ZeroUI/Industrial-Quark/Ziro-master/BoM/Motor Modules/Quark/Assembly Steps/Step 4 - Cover Top Lid.JPG

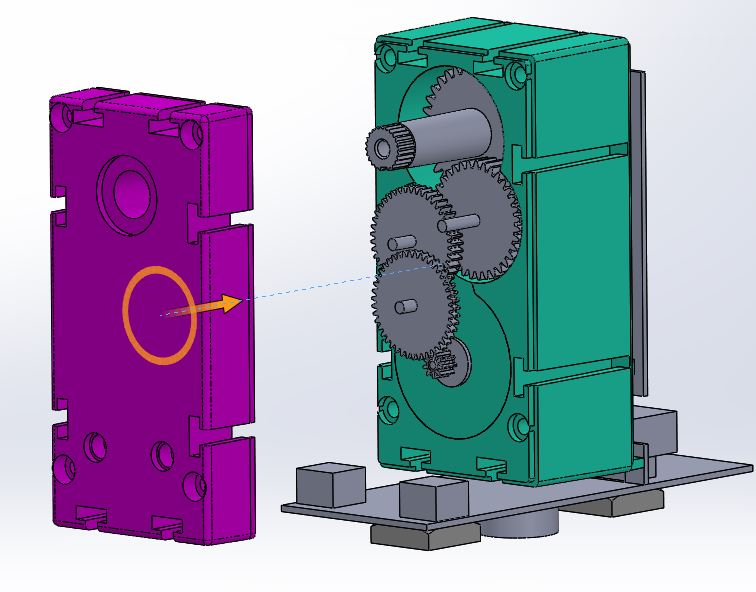
Ziro-master/BoM/Motor Modules/Quark/Assembly Steps/Step 4 - Cover Top Lid.JPG
