ZeroUI/Industrial-Quark/Ziro-master/Electronics/README.md

# Ziro
Contains Firmware and Design files for Ziro
