ZeroUI/Industrial-Quark/Ziro-master/Electronics/V1.0 Bluetooth/Hardware/PCB related req engg/Notes.txt

ADXL335 costs $3.2 analog +/-3G accelerometer
