ZeroUI/Industrial-Quark/Ziro-master/BoM/Glove Modules/Textile Design/3_Pattern Cutout(Size Small).pdf

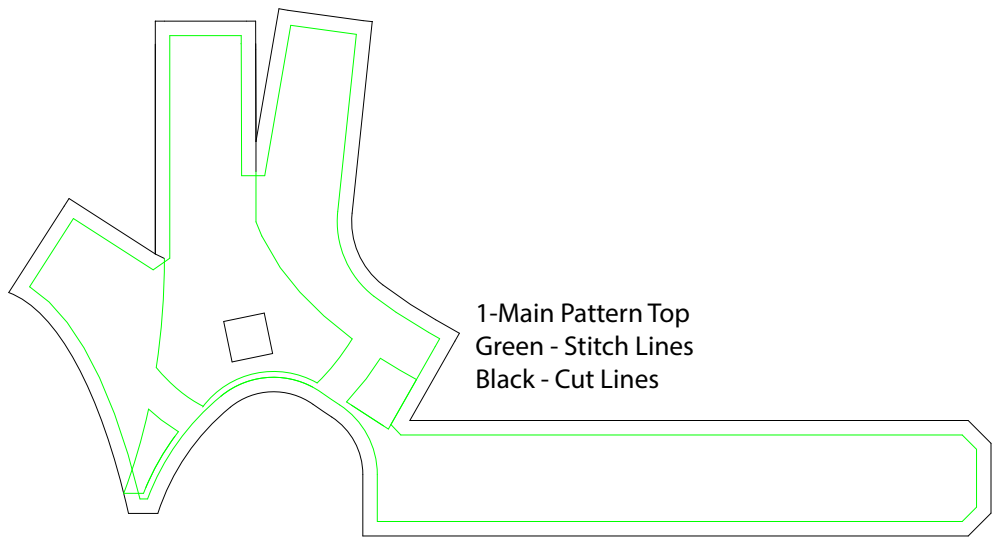
[picture p3: page 1]

1-Main Pattern Top
Green - Stitch Lines
Black - Cut Lines

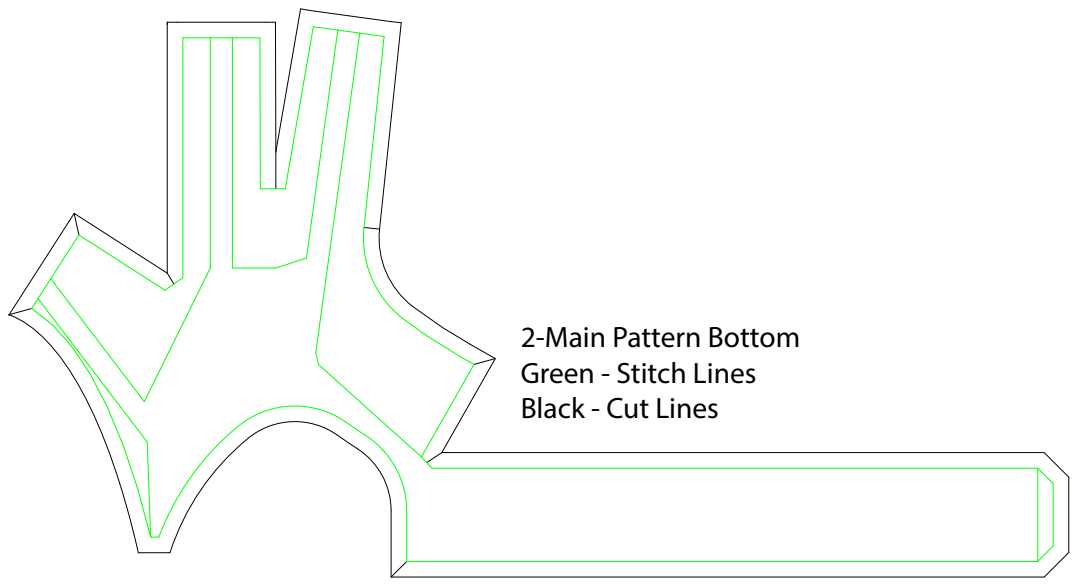
[picture p4: page 2]

2-Main Pattern Bottom
Green - Stitch Lines
Black - Cut Lines

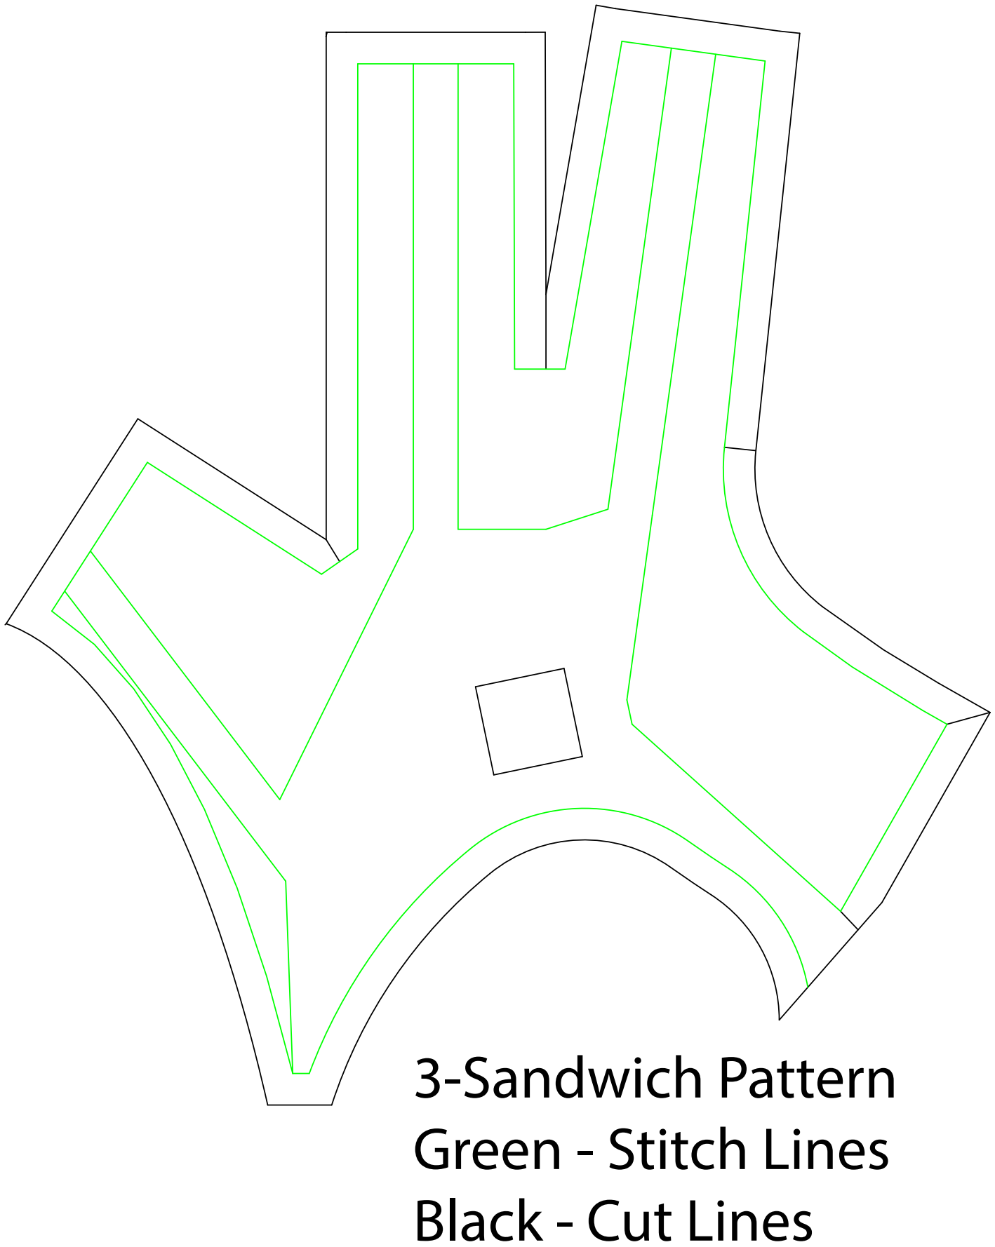
[picture p5: figure]
3-Sandwich Pattern Green - Stitch Lines Black - Cut Lines

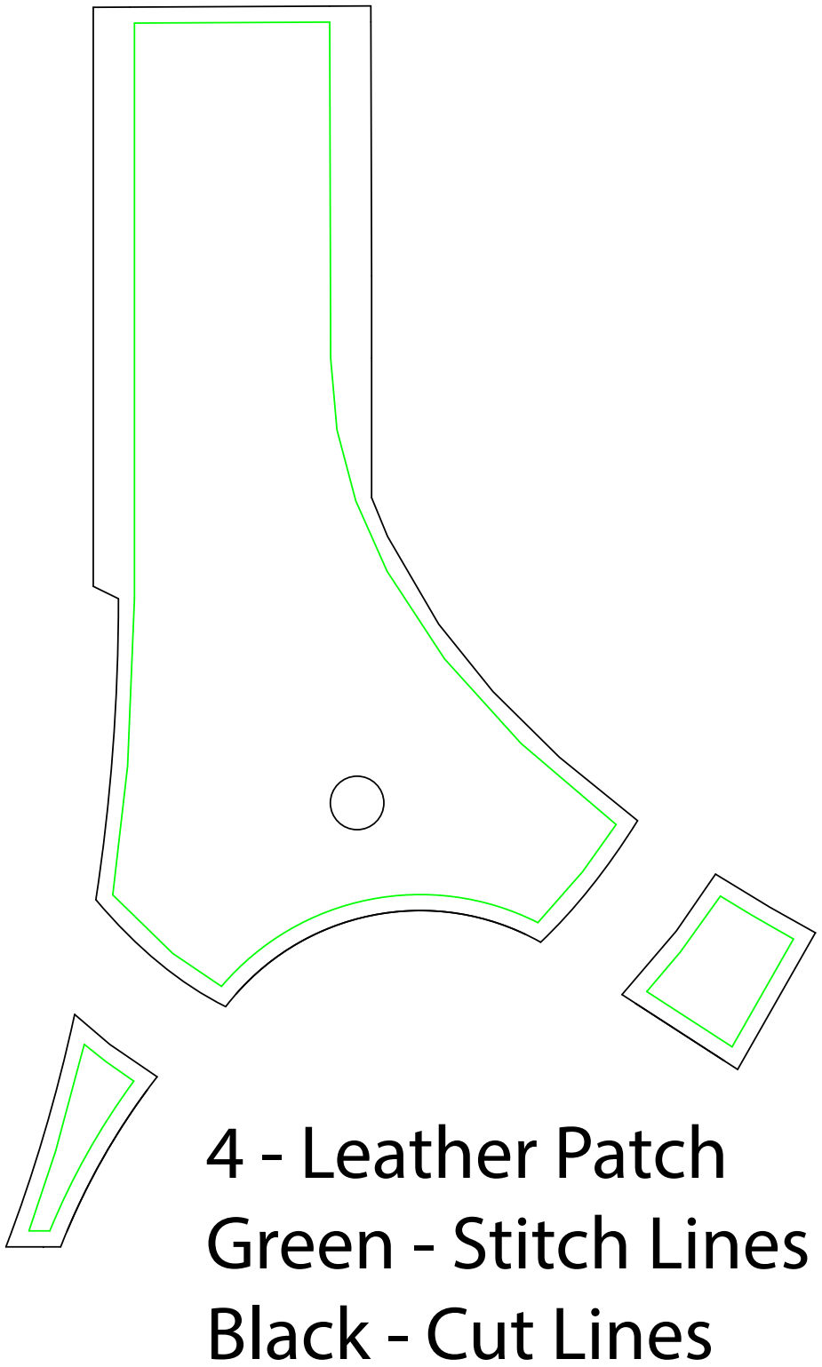
[picture p6: figure]
4 - Leather Patch Green - Stitch Lines Black - Cut Lines

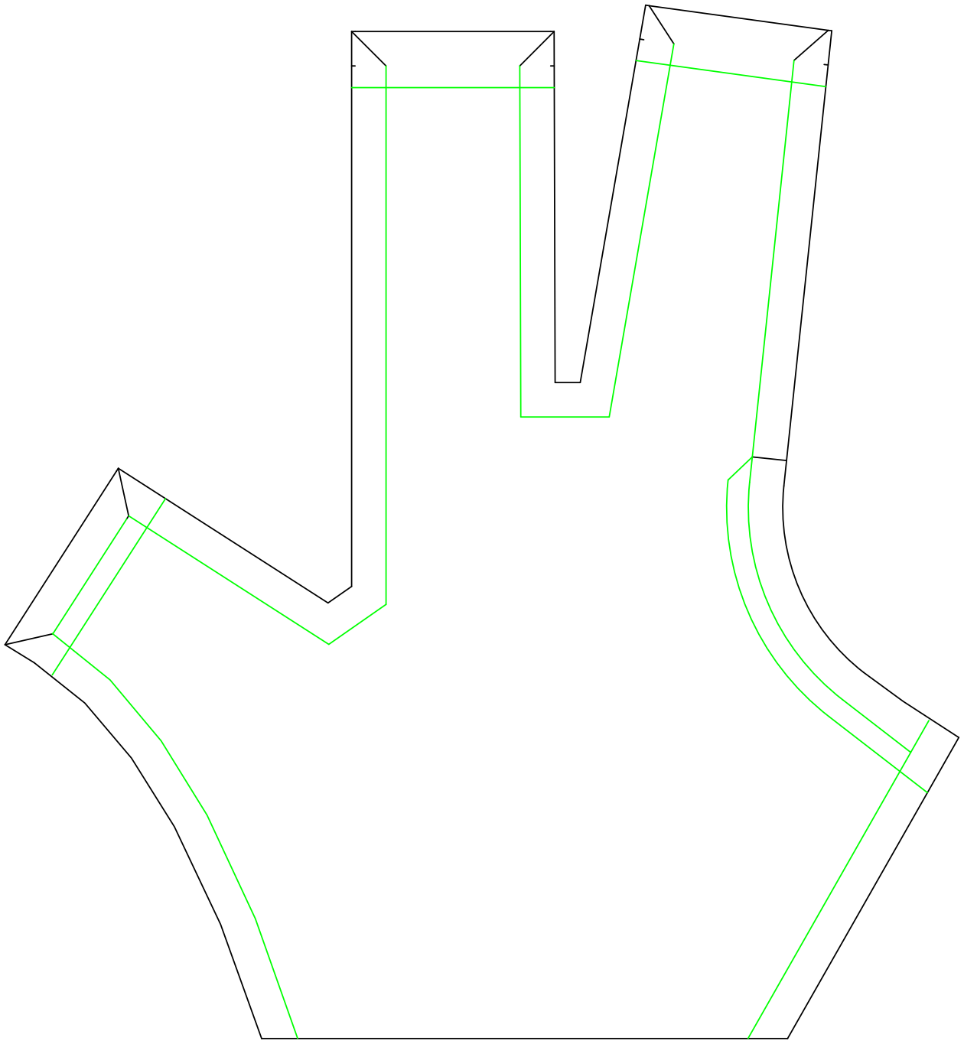
[picture p7: figure]

5- Palm Mesh
Green - Stitch Lines
Black - Cut Lines

6 - Wrist Patch
Green - Stitch Lines
Black - Cut Lines

7_Elastic band For Wrist
Black RIng is the Magnet
2” x 10 “ ELASTIC
