ZeroUI/Industrial-Quark/Ziro-master/Mechanical/Glove Design/Textiles/Small Size Pattern Cutouts.pdf

1-Main Pattern Top
Green - Stitch Lines
Black - Cut Lines


2-Main Pattern Bottom
Green - Stitch Lines
Black - Cut Lines

3-Sandwich Pattern Green - Stitch Lines Black - Cut Lines

4 - Leather Patch Green - Stitch Lines Black - Cut Lines


5- Palm Mesh
Green - Stitch Lines
Black - Cut Lines

6 - Wrist Patch
Green - Stitch Lines
Black - Cut Lines

7_Elastic band For Wrist
Black RIng is the Magnet
2” x 10 “ ELASTIC
