ZeroUI/Industrial-Quark/Ziro-master/Electronics/V1.0 Bluetooth/Hardware/Handimate_Backup/PCB Quote.pdf

PCB Quotation | Quote Number: 4128053

## Pricing and Leadtime:

Qty = Pieces, Not Arrays. Lot charge shown does not include $10 Handling Fee or NRE and ET charges.
Same Day | 1 Day | 2 Day | 3 Day | 4 Day | 5 Day | 10 Day | 15 Day | 20 Day | NRE ET*
Qty 5 Unit | $235.41 | $195.70 | $136.13 | $96.42 | $84.51 | $80.54 | $72.60 | $64.65 | $56.71
Qty 5 Lot | $1,177.05 | $978.50 | $680.65 | $482.10 | $422.55 | $402.70 | $363.00 | $323.25 | $283.55 | $169 | $140
Qty 10 Unit | $119.32 | $99.17 | $68.95 | $48.80 | $42.75 | $40.74 | $36.71 | $32.68 | $28.65
Qty 10 Lot | $1,193.20 | $991.70 | $689.50 | $488.00 | $427.50 | $407.40 | $367.10 | $326.80 | $286.50 | $169 | $140
Qty 50 Unit | $26.44 | $21.94 | $15.20 | $10.70 | $9.35 | $8.90 | $8.00 | $7.10 | $6.20
Qty 50 Lot | $1,322.00 | $1,097.00 | $760.00 | $535.00 | $467.50 | $445.00 | $400.00 | $355.00 | $310.00 | $169 | $140
Qty 150 Unit | $13.56 | $11.20 | $7.66 | $5.29 | $4.58 | $4.35 | $3.87 | $3.40 | $2.93
Qty 150 Lot | $2,034.00 | $1,680.00 | $1,149.00 | $793.50 | $687.00 | $652.50 | $580.50 | $510.00 | $439.50 | $169 | $140

* ET charges shown do not include Hi-Pot test charges unless included in the Comments section below.

## PCB Attributes:

## Comments:

Thank you for the opportunity to provide this quote. Please contact me with any questions.

Standard Advanced Circuits terms and conditions apply for all PCB quotes and orders. When required, we manufacture to MIL-PRF-55110 Revision G, Amendment 3. | 0
Date: | 5/27/2015

### Quoted To: Nikhil Jali Purdue University

Phone: | 765-476-3370 x
Email: | njali@purdue.edu

### Part Number: GloveMod1 Revision: 1 Quote Valid: 30 Days

### Fab Spec: IPC Class 2-A600

Material Type: FR4
Surface Finish: Leaded Solder Layer Count: 2
Board Size: | 2x2
Array Size: | 0x0
# Up Per Array: 0

Tab Route: | No
Score: | Yes

Finished Thickness: 0.062
Copper Wt.(Outer): 1
Soldermask: | 2
Soldermask Color: Green
Silkscreen: | 1
Silkscreen Color: | White
AS9100: | No
ITAR: | No
Trace/Space Min: | 0.012
Smallest Hole: | 0.02
Total # Holes: | 0
Blind Via: | None
Microvia: | None
VIP: | None
Controlled Impedance: No
