ZeroUI/Industrial-Quark/Ziro-master/Electronics/V2.0 Wifi/Hardware/Battery/Kokam_Cell_Requirement_Form_Rev.0.0.pdf

CONFIDENTIAL-KOKAM PROPRIETARY

Please fill in shaded area

## KOKAM CELL REQUIREMENT FORM

### General Customer Information

Date | Project Name
Company Name | Job Title
Contact Name | Cell Phone
Company Location
(Country / City) | E-mail
Final Customer (if any) | Telephone
Website

### Applications

### Select appropriate applications (multiple choices applicable)

Tram | EV, PHEV, HEV | Aviation | UPS | Marine | Defense
Industrial | ESS | Telecom | Medical
A. General Description of Usage
B. Cell Characteristics
- Rated Capacity | | | | Ah
- Energy Density | | | | Wh/kg
- Energy Density | | | | Wh/L
- Impedance | | | | mΩ
- Weight | | | | g
800mAh-1.2Ah Under 30g | Width | Less than 3mm 3.1 3.6 4.2 | 100mA 600mA 1000 | | 50 mm
| Length | | | | mm
| Thickness | | | | mm
| Lower | | | | V
- Voltage | | Nominal | | | | V
| | Upper | | | | V
- Cell Dimension
[Maximum]
- Current
Charge | Cont | A
Peak | A
Discharge | Cont | A
Peak | A
- Required # of Cycles | @ | % DOD

### SUPERIOR LITHIUM POLYMER BATTERY

KOKAM CELL | WWW.KOKAM.COM
16th April 2016 | Ziro ZeroUI | Chief Engineer- Electronics Nikhil Jali

San Jose,
United States

nikhil@zeroui.com

www.ziro.io

This would be used in a wearable application requiring daily recharging for a usable period of atleast 2 years i.e. 1000 charge cycles.

### KOKAM CELL REQUIREMENT FORM

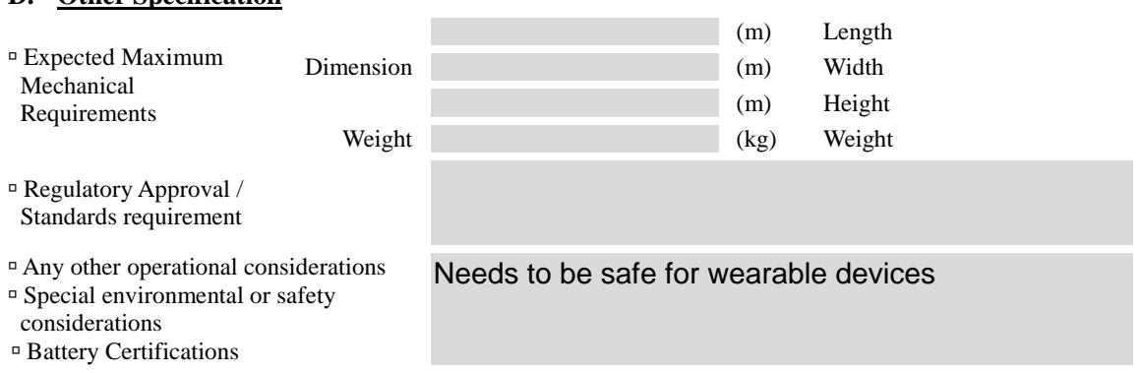
[picture p8: figure]
Expected Maximum Mechanical Requirements; Dimension; (m) Length (m) Width (m) Height; Weight; Regulatory Approval / Standards requirement; Any other operational considerations Special environmental or safety considerations Battery Certifications; Needs to be safe for wearable devices

Corporate Headquarters | Manufacturing Plant
30-78, Gyeongsu-daero, 1220beon-gil,
Jangan-gu, Suwon-si, Gyeonggi-Do
South Korea Zip. 440-851
Tel +82 31 3620 100
Email battery@kokam.com

483-42, Yachon-ri, Gayagok-Myun, Nonsan-Si, Chungnam
South Korea 320-840
Tel | +82 41 740 3800
Email | battery@kokam.com
CONFIDENTIAL-KOKAM PROPRIETARY
C. Environmental Characteristics
- Charging Temperature | | °C
- Discharging Temperature | 353527 | °C
- Storage Temperature | °C
D. Other Specification
E. Expected Amount of Orders Estimate Quantity
(EA)

Desired Delivery Date
(Sample Order) | (Y/M/D)
Estimated Annual Volume | Year 2016 | Year 2017 | Year 2018
| (EA) | (EA) | (EA)
60,000 | June, 2016 10,000 | 50,000 | Unknown
