ZeroUI/Industrial-Quark/Ziro-master/Mechanical/Ziro 2.0/Glove Design/Textiles/Brooks Pattern/3_Sandwich.pdf

3-Sandwich Pattern Green - Stitch Lines Black - Cut Lines
