ZeroUI/Industrial-Quark/Ziro-master/Mechanical/Ziro 2.0/Glove Design/Textiles/Brooks Pattern/4_Leather Patch.pdf

4 - Leather Patch Green - Stitch Lines Black - Cut Lines
