ZeroUI/Industrial-Quark/Ziro-master/Mechanical/Ziro 2.0/Glove Design/Textiles/Brooks Pattern/5_Mesh.pdf

5- Palm Mesh
Green - Stitch Lines
Black - Cut Lines
