ZeroUI/Industrial-Quark/Ziro-master/Mechanical/Ziro 2.0/Glove Design/Textiles/Brooks Pattern/6_Wrist Patches.pdf

6 - Wrist Patch
Green - Stitch Lines
Black - Cut Lines
