ZeroUI/Industrial-Quark/Ziro-master/Mechanical/Ziro 2.0/Glove Design/Textiles/Brooks Pattern/7_Wrist Elastic.pdf

7_Elastic band For Wrist
Black RIng is the Magnet
2” x 10 “ ELASTIC
