ZeroUI/Industrial-Quark/Ziro-master/Electronics/V2.0 Wifi/Documentation/Module Color Schemes.xlsm

 |  |  | LED PWM VALUES
Module # | Color Schemes | [R,G,B] | Red | Green | Blue
- |  | 255, 0, 0 | 1023 | 0 | 0 | This color is used for STOP Command
1 |  | 255, 255, 0 | 1023 | 1023 | 0
2 |  | 0, 176, 80 | 0 | 706.0705882 | 320.9411765 |  | NOTE: Final Color on Modules dependent on Plastic and PWM Frequency set in Quark
3 |  | 241, 39, 212 | 966.8352941 | 156.4588235 | 850.4941176
4 |  | 4, 97, 210 | 16.04705882 | 389.1411765 | 842.4705882
5 |  | 255, 192, 0 | 1023 | 770.2588235 | 0
6 |  | 0, 255, 0 | 0 | 1023 | 0
7 |  | 255, 255, 255 | 1023 | 1023 | 1023
8 |  | 0, 255, 255 | 0 | 1023 | 1023
Change above background colors and hit Recalculate Button
