ZeroUI/Industrial-Quark/Ziro-master/Electronics/V2.0 Wifi/Documentation/Websocket Packet Exchange Format.xlsx

Websocket Object Exchange Format between Glove and Computer
Name of variable | Description | Values | Description of Value | Low Limit | High Limit | Default | Data Type
pType | Indicates the type of packet being sent and lists out the data in it | 0 | Keep alive Packet | 0 | 13 | 0 | int
 |  | 1 | Gesture Map Packet Set
 |  | 2 | Gesture Map Packet Get
 |  | 3 | Sensor Calibration Request
 |  | 4 | Sensor Calibration Get
 |  | 5 | Sensor Calibration Set
 |  | 6 | Motor Command Get
 |  | 7 | Motor Command Set for (Scratch/Blockly)
 |  | 8 | KitID Get
 |  | 9 | KitID Set
 |  | 10 | Sensor Info
 |  | 11 | LED Set
 |  | 12 | Shutdown Modules* |  |  |  |  | *m_M and m_T must both be set to 0
 |  | 13 | Set Sensitivity of Gestures
gMap | Contains the [8 Module x 7 Gesture] Matrix | [8 x 7] Matrix | Motor Modes | 0 | 6 | 0 | int
 |  |  | -1 STOP
 |  |  | 0- Do Nothing
 |  |  | 1- CW Rotation
 |  |  | 2- CCW Rotation
 |  |  | 3- 90 CW Rotation
 |  |  | 4- 90 CCW Rotation
 |  |  | 5- 180 CW Rotation
 |  |  | 6- 180 CCW Rotation
CAL_L | Contains min for flex Sensor to read 0% | [1x7] Array | [Thumb, Index, Middle] | 0 | 999 | 90 | uint16_t
 | Contains min for IMU gestures to read 0% |  | [Front, Back, Left, Right] | 0 | 90 | 5
CAL_H | Contains max for flex Sensor to read 100% | [1x7] Array | [Thumb, Index, Middle] | 0 | 999 | 900 | uint16_t
 | Contains max for IMU gestures to read 100% |  | [Front, Back, Left, Right] | 0 | 90 | 70
m_M | Mode of Motor. [1x8 Motor Groups] | [1x8] Array | See Motor Modes above | 0 | 6 | 0 | int
m_T | Target Speed/Angle of Motor [1x8 Motor Groups] | [1x8] Array | See Motor Modes above | 0 | 6 | 0 | int
kID | Contains Kit ID | String | Contains a 4 character string | - | - | HEX String Assembly Time | String
allInf [all..Inf] | Contains all Gestures, Sensor Values from Glove | [1x9] Array | [0]- Thumb Finger Gesture Value | 0 | 99 | 0* | int
 |  |  | [1]- Index Finger Gesture Value | 0 | 99 | 0*
 |  |  | [2]- Middle Finger Gesture Value | 0 | 99 | 0*
 |  |  | [3]- Front Motion Gesture Value | 0 | 90 | 0*
 |  |  | [4]- Back Motion Gesture Value | 0 | 90 | 0*
 |  |  | [5]- Left Motion Gesture Value | 0 | 90 | 0*
 |  |  | [6]- Right Motion Gesture Value | 0 | 90 | 0*
 |  |  | [7]- Button Press Value | 0 | 1 | 0*
 |  |  | [8]- Battery SoC Value | 0 | 99 | 0*
 |  |  | [9]- Charge Status | 0 | 1 | 0*
 |  |  | [10]- LED Status. 0-OFF 1-GREEN 2-RED | 0 | 2 | 0*
sLED | Used to Set the LED Status Glove: If R>0, *Red*. If G>0, Green, else OFF. Module: Sets duty-cycle of RGB LED | [1x3] Array | [R, G, B] | 0 | 9 | 0 | int
snsty | Used to set the sensitivity of gestures | Int | 0- Not Sensitive 1- Very Sensitive | 0 | 10 | 0 | int
scratchMode | Used to Set/Disable Scratch Mode Analyzed when pType=7 | Int | 0-Scratch Inactive 1-Scratch Active | 0 | 1 | 0 | int
