ZeroUI/Industrial-Quark/Ziro-master/Electronics/V1.0 Bluetooth/Hardware/PCB related req engg/9V charger Interface.xlsx

Vcharge | Vref | R1(desired) | R2 (req) | R1(req) | R2(desired)
9 | 1.25 | 10 | 1.612903226 | 62 | 10
Page 10 of | https://www.sparkfun.com/datasheets/IC/MC34063A.pdf
 |  | Vcharge

 |  | R1
 | Vref-
 |  | R2

 |  | Gnd
