ZeroUI/Industrial-Quark/Ziro-master/Electronics/V1.0 Bluetooth/Hardware/PCB related req engg/Flex Sensor Resistor Divider.xlsx

R1 [kohm] | Vin [V] | Flex Sensor [kohm] | Vout [V]
150 | 3.3 | 9 | 0.1867924528
 |  | 8 | 0.1670886076
 |  | 10 | 0.20625
 |  | 12 | 0.2444444444
 |  | 14 | 0.2817073171
 |  | 16 | 0.3180722892
 |  | 18 | 0.3535714286
 |  | 20 | 0.3882352941
