ZeroUI/Industrial-Quark/Ziro-master/Electronics/V1.0 Bluetooth/Hardware/PCB related req engg/PCB requirements.xlsx

PCB Requirements
Thickness | 0.031-0.062
