ZeroUI/Industrial-Quark/Ziro-master/Electronics/V2.0 Wifi/Documentation/Hand Size Templates.docx

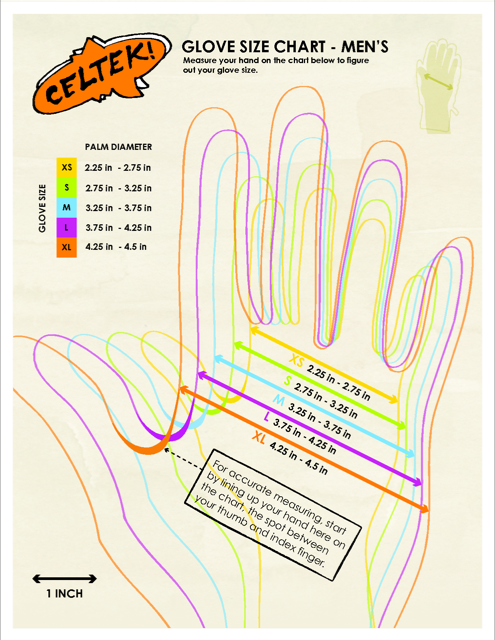
[picture p9: figure]
