ZeroUI/Industrial-Quark/Ziro-master/BoM/Glove Modules/Textile Design/1_Glove Overview.pdf

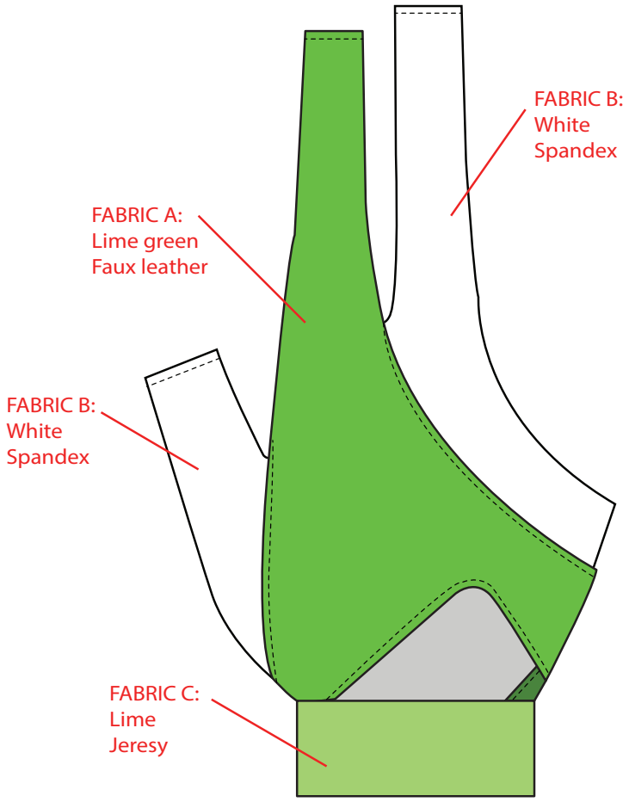
[picture p10: figure]
FABRIC A: Lime green Faux leather; FABRIC B: White Spandex; FABRIC C: Lime Jeresy
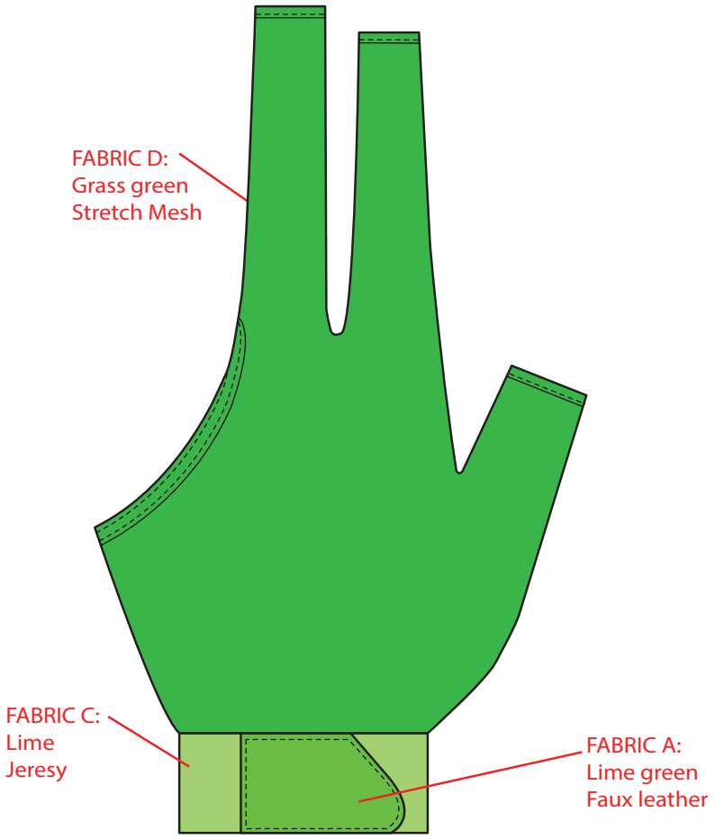
[picture p11: figure]
FABRIC A: Lime green Faux leather; FABRIC C: Lime Jeresy; FABRIC D: Grass green Stretch Mesh

# tech pack _ fabrics

top of hand | palm

# zeroUI
