ZeroUI/Industrial-Quark/Ziro-master/Electronics/V1.0 Bluetooth/Hardware/PCB related req engg/3dpcb.pdf

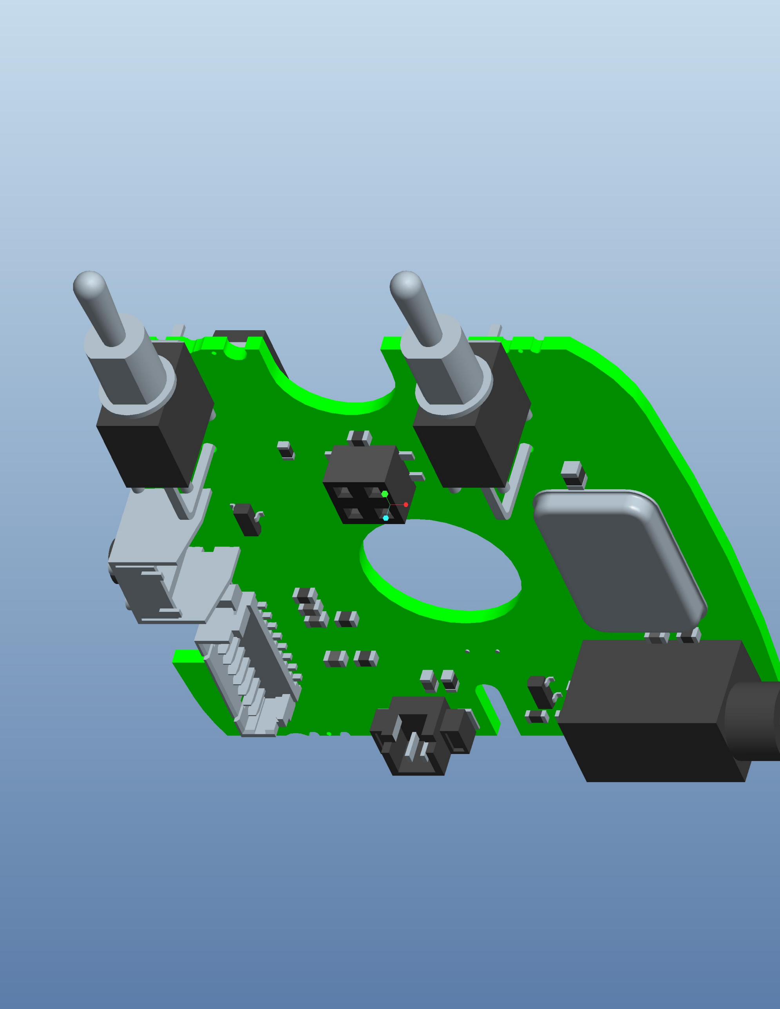
[picture p12: page 1]
