ZeroUI/Industrial-Quark/Ziro-master/Electronics/V1.0 Bluetooth/Hardware/Handimate_Backup/Glove Module/Rendered/3D view.pdf

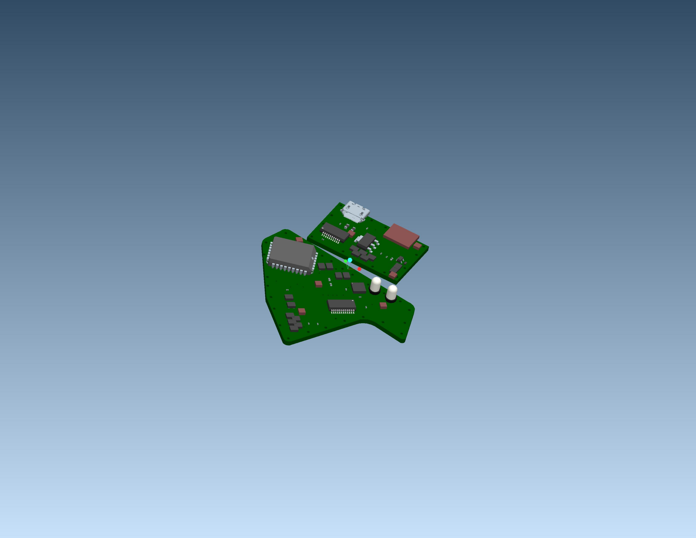
[picture p13: page 1]
