ZeroUI/Industrial-Quark/Ziro-master/BoM/Packaging/E1-PCB/Connector- Magnetic Circular-A.pdf

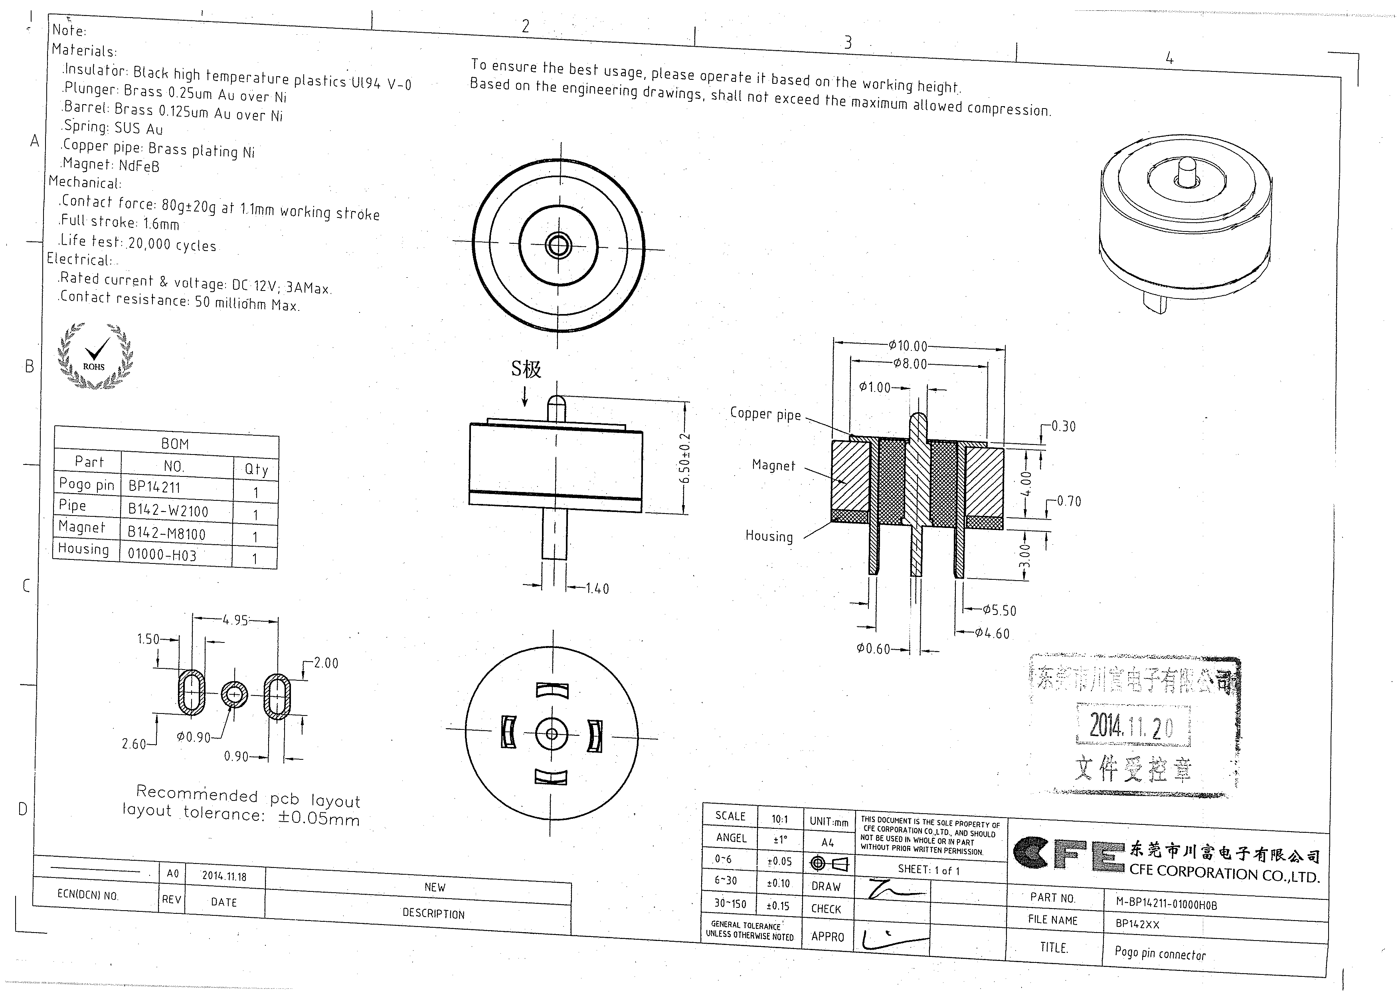
[picture p14: page 1]
