ZeroUI/Industrial-Quark/Ziro-master/BoM/Motor Modules/Quark/E2-PCB/Connector- Magnetic Circular-B.pdf

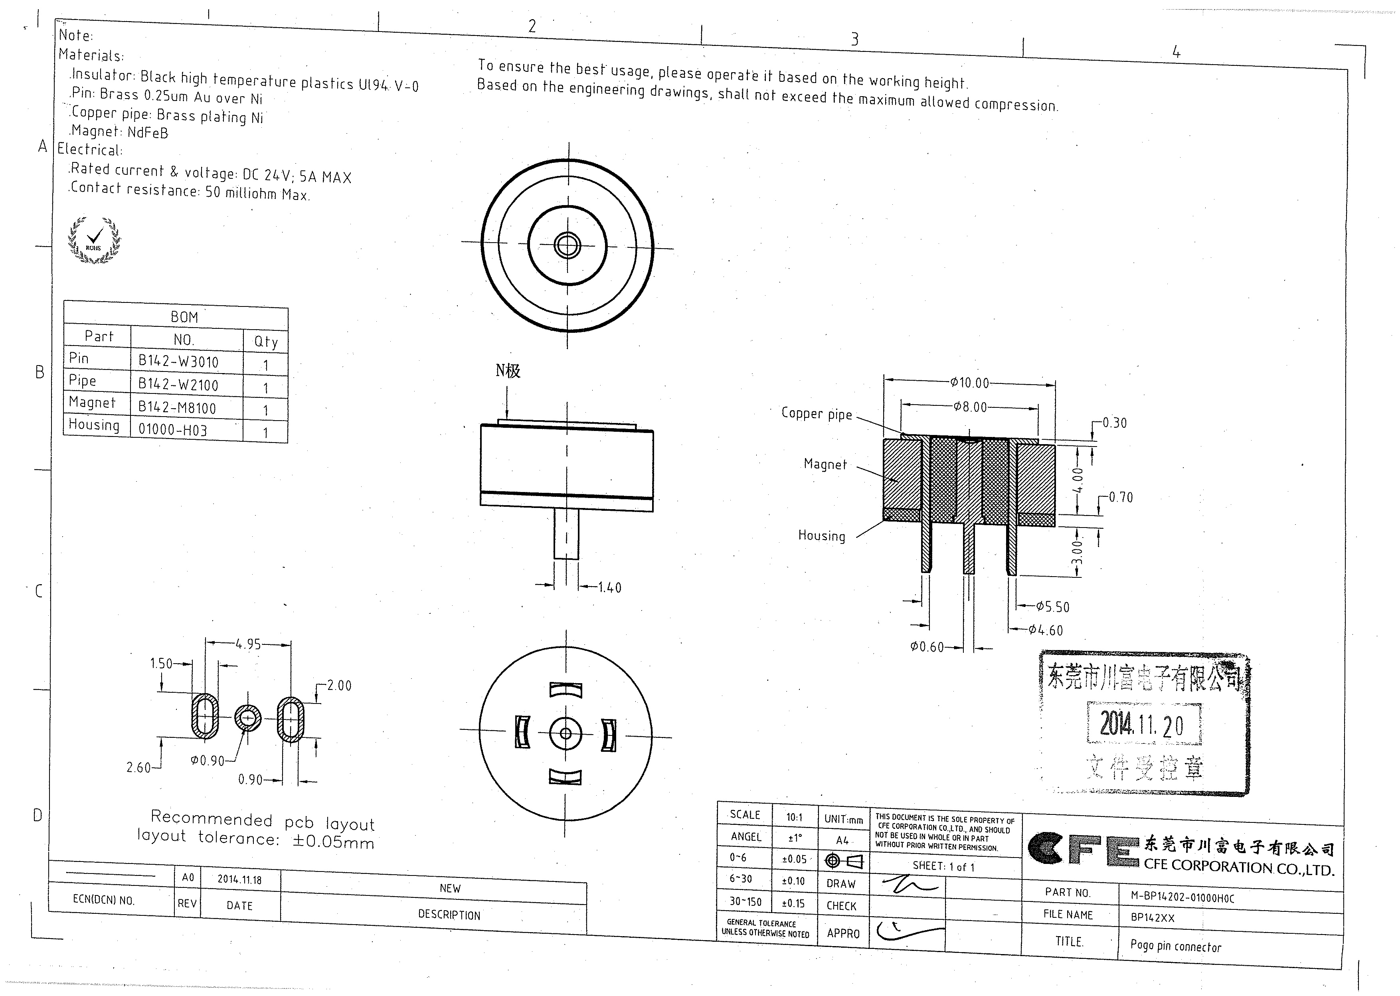
[picture p15: page 1]
