ZeroUI/Industrial-Quark/Ziro-master/Electronics/V2.0 Wifi/Documentation/Gesture Input Sensititivity Analysis.xlsx

Gesture Input | Function | Input a | Output Exponential Algorithm
0 | f(x)=ax^3 + (1-a)*x x=[0,1] | 0 | 0
0.1 |  |  | 0.001
0.2 |  |  | 0.008
0.3 |  |  | 0.027
0.4 |  |  | 0.064
0.5 |  |  | 0.125
0.6 |  |  | 0.216
0.7 |  |  | 0.343
0.8 |  |  | 0.512
0.9 |  |  | 0.729
1 |  |  | 1
