ZeroUI/Industrial-Quark/Ziro-master/BoM/Accessories/Smartphone_Mount.PNG

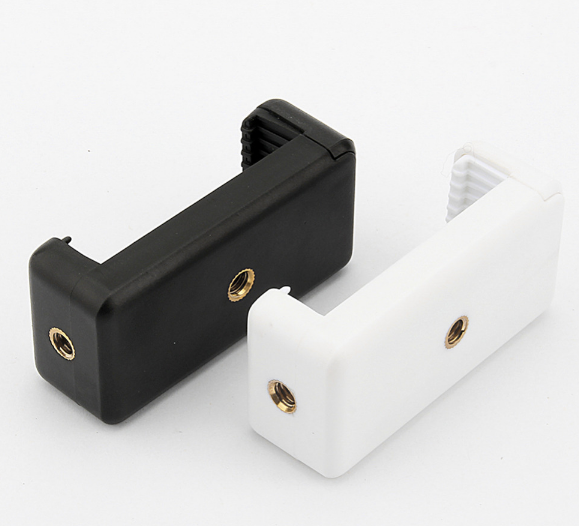
Ziro-master/BoM/Accessories/Smartphone_Mount.PNG
