ZeroUI/Industrial-Quark/Ziro-master/BoM/Accessories/SPM-ADAPT.png

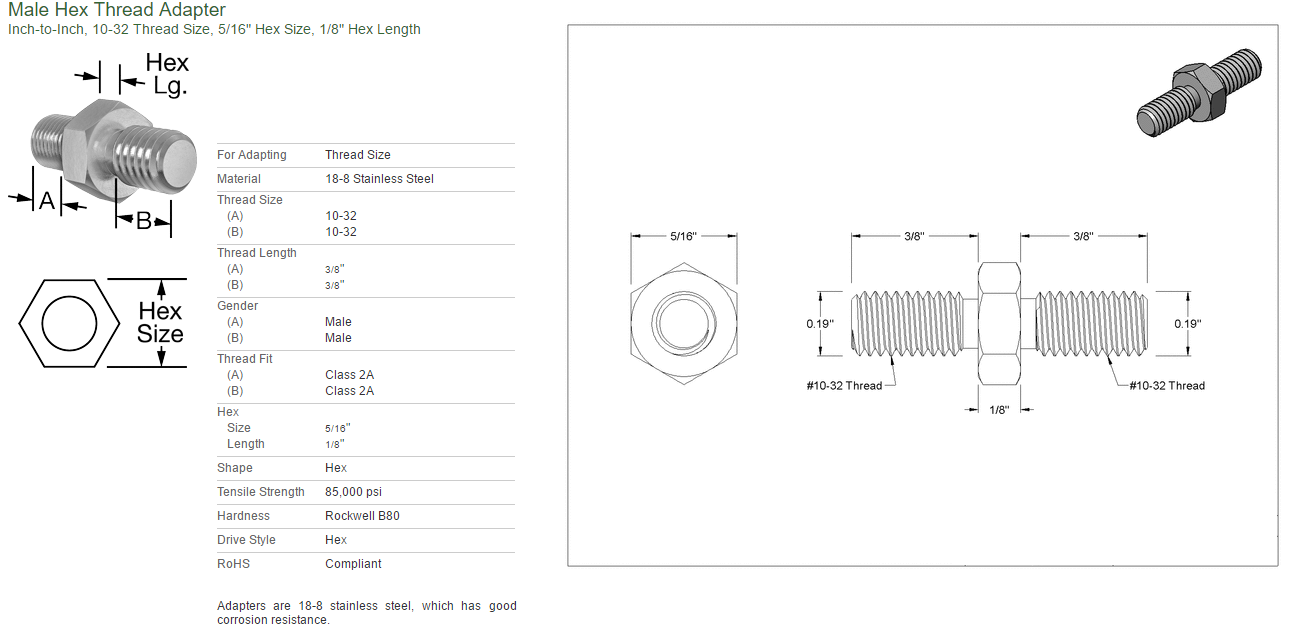
Ziro-master/BoM/Accessories/SPM-ADAPT.png
