ZeroUI/Industrial-Quark/Ziro-master/BoM/Accessories/Ziro_Keychain.png

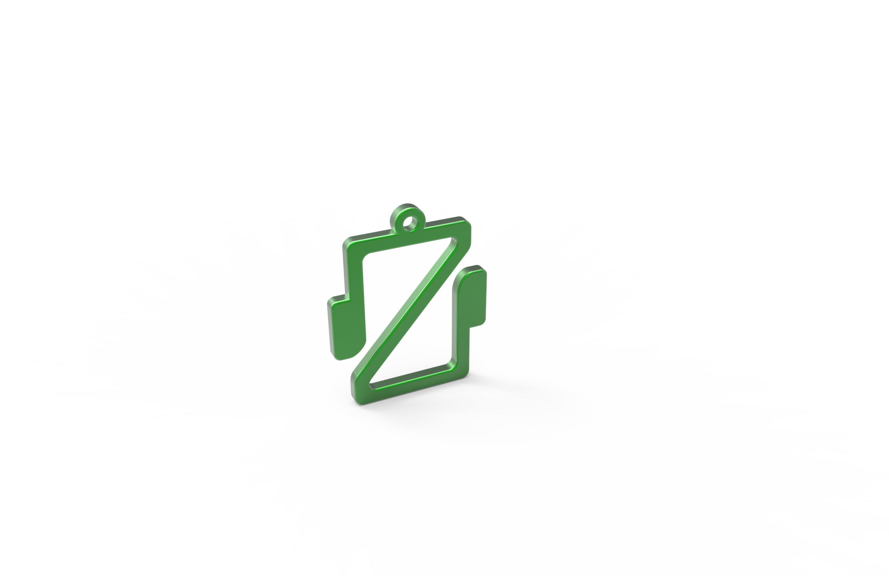
Ziro-master/BoM/Accessories/Ziro_Keychain.png
