ZeroUI/Industrial-Quark/Ziro-master/BoM/Connector Screw/Conector and Knurled Shaft.JPG

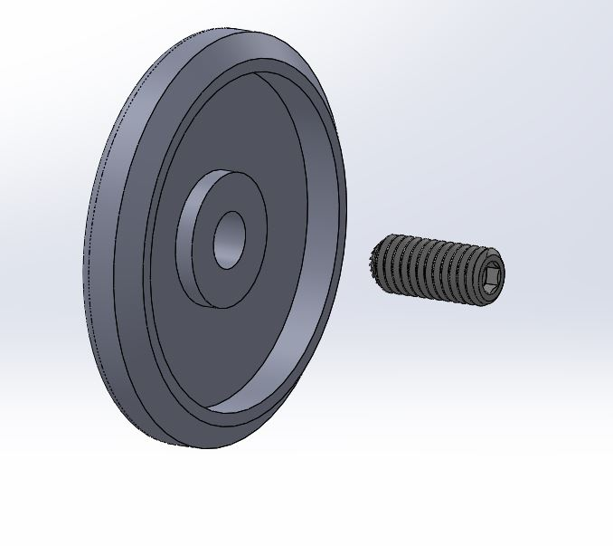
Ziro-master/BoM/Connector Screw/Conector and Knurled Shaft.JPG
