ZeroUI/Industrial-Quark/Ziro-master/BoM/Connector Screw/F1032.png

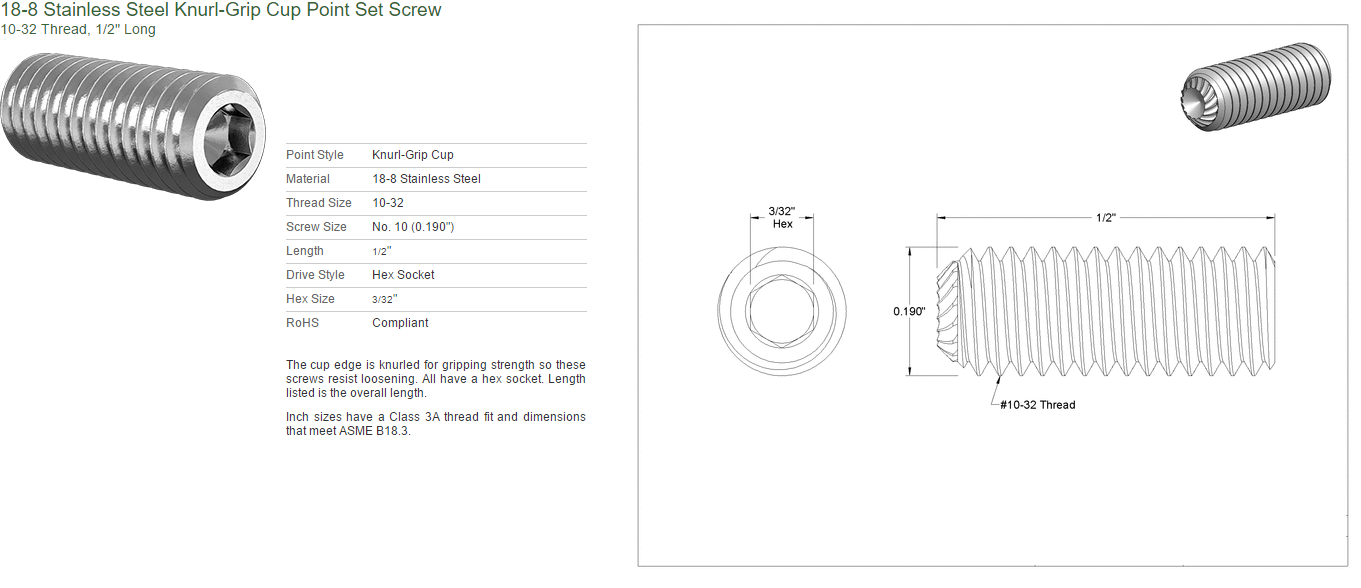
Ziro-master/BoM/Connector Screw/F1032.png
