ZeroUI/Industrial-Quark/Ziro-master/BoM/Motor Modules/Hinge/Hinge and Insert.JPG

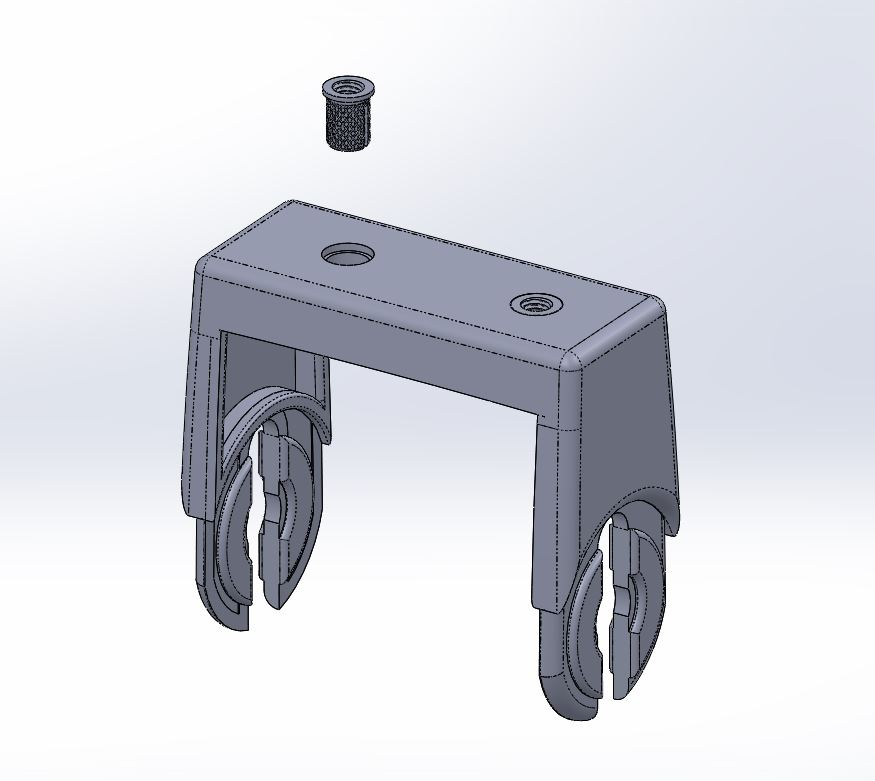
Ziro-master/BoM/Motor Modules/Hinge/Hinge and Insert.JPG
