ZeroUI/Industrial-Quark/Ziro-master/BoM/Motor Modules/Hinge/PR1032.PNG

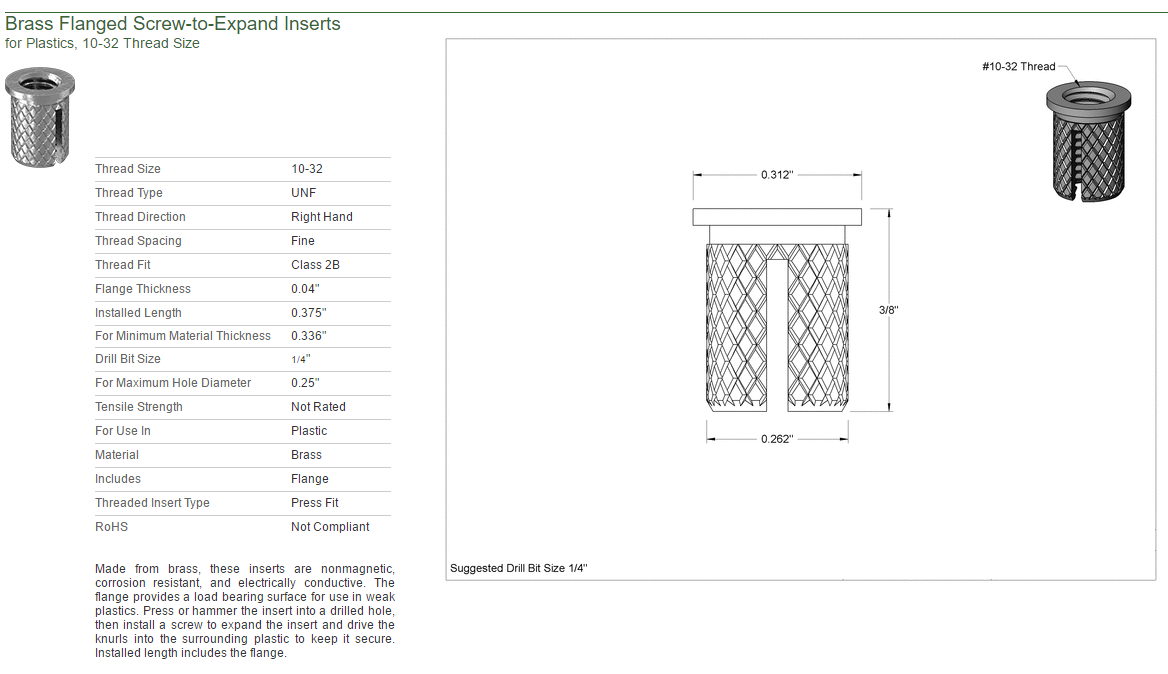
Ziro-master/BoM/Motor Modules/Hinge/PR1032.PNG
