ZeroUI/Industrial-Quark/Ziro-master/BoM/Motor Modules/Quark/SCR-18-8 Socket Head Cap Screw.png

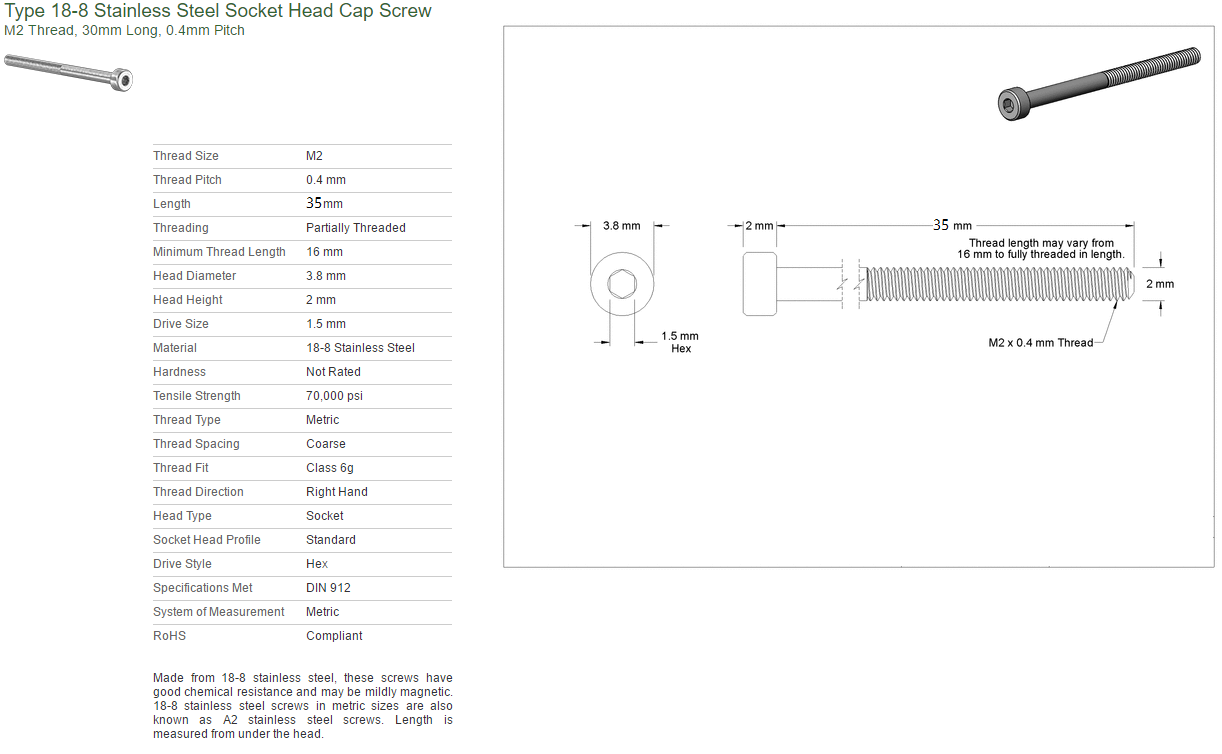
Ziro-master/BoM/Motor Modules/Quark/SCR-18-8 Socket Head Cap Screw.png
