ZeroUI/Industrial-Quark/Ziro-master/BoM/Motor Modules/Rotating Pin Screw/F1032.PNG

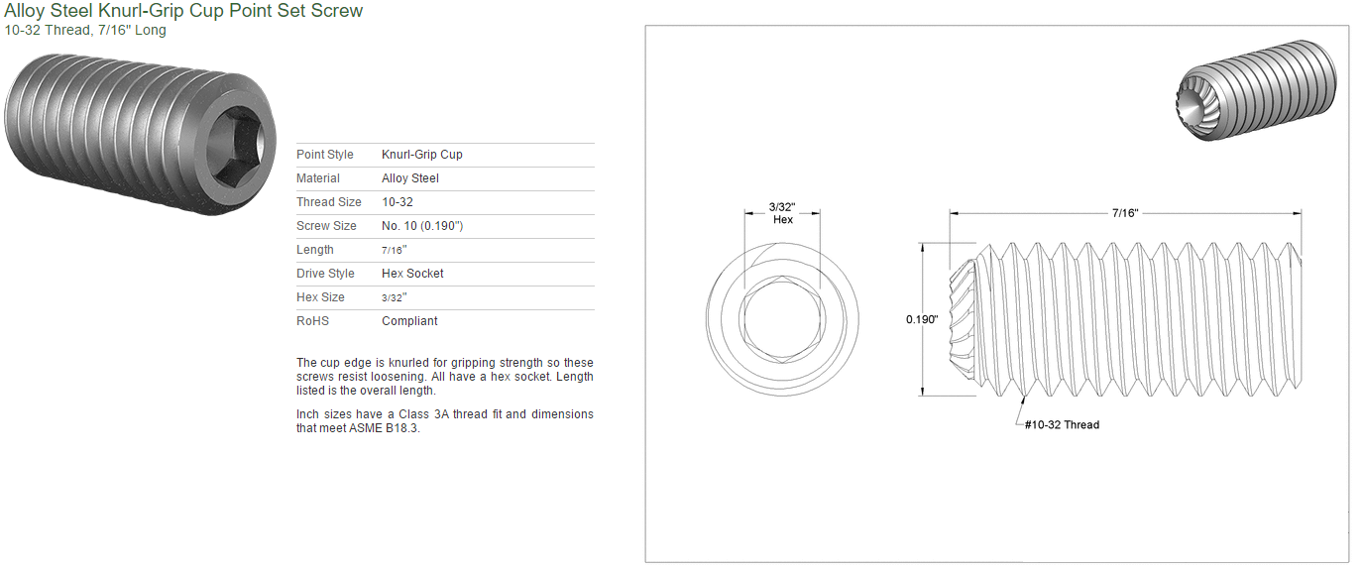
Ziro-master/BoM/Motor Modules/Rotating Pin Screw/F1032.PNG
