ZeroUI/Industrial-Quark/Ziro-master/BoM/Motor Modules/Shell/Brass Square Nut 10-32.png

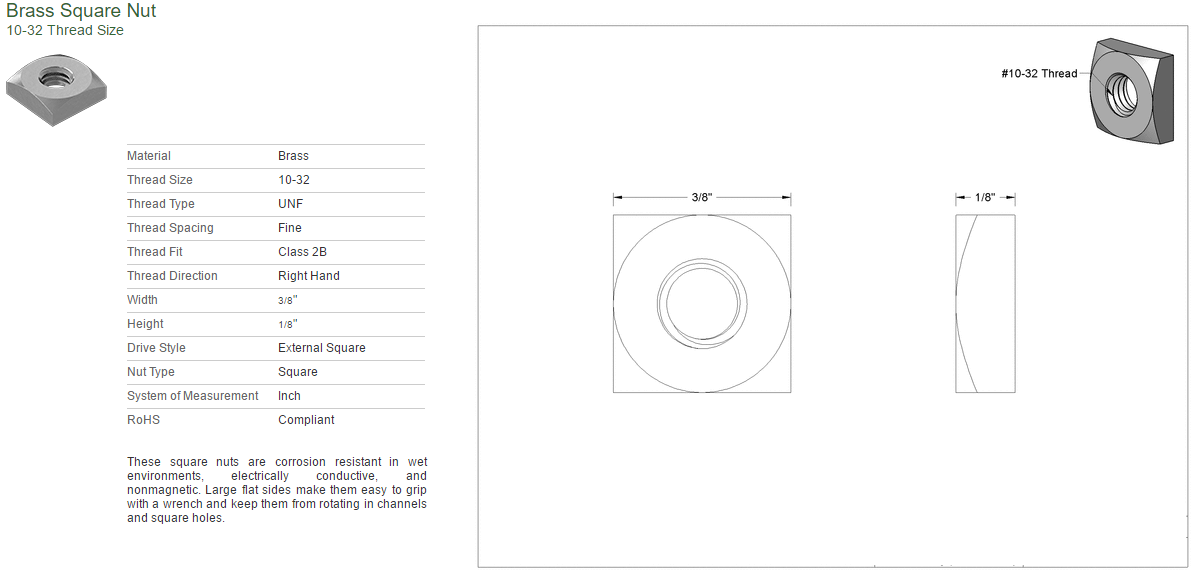
Ziro-master/BoM/Motor Modules/Shell/Brass Square Nut 10-32.png
