ZeroUI/Industrial-Quark/Ziro-master/BoM/Motor Modules/Shell/KNSHFT.png

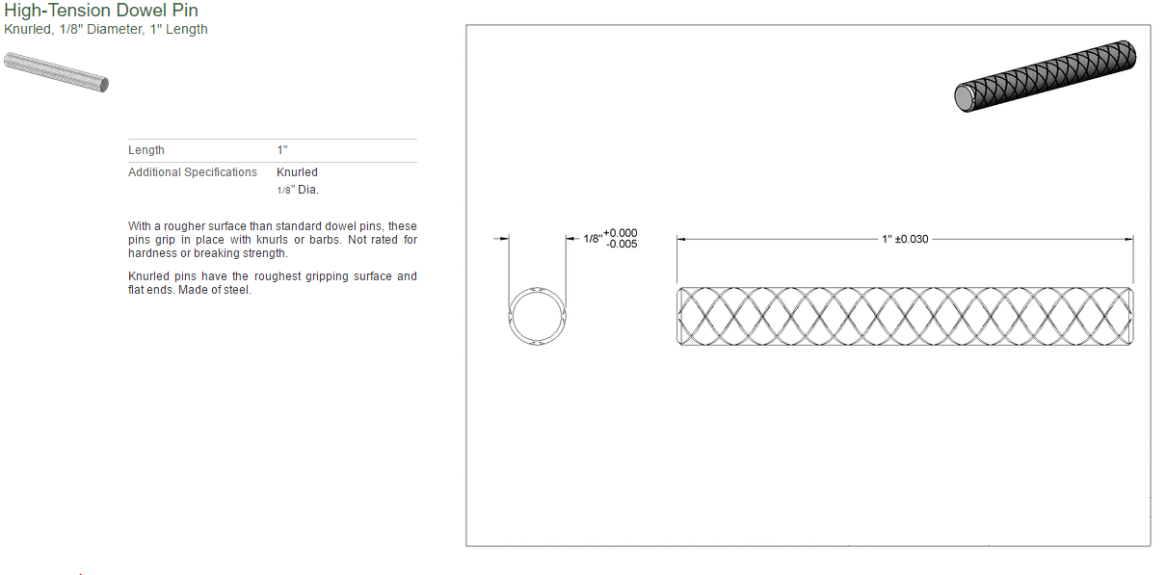
Ziro-master/BoM/Motor Modules/Shell/KNSHFT.png
