ZeroUI/Industrial-Quark/Ziro-master/BoM/Packaging/Box/Box DImensions.png

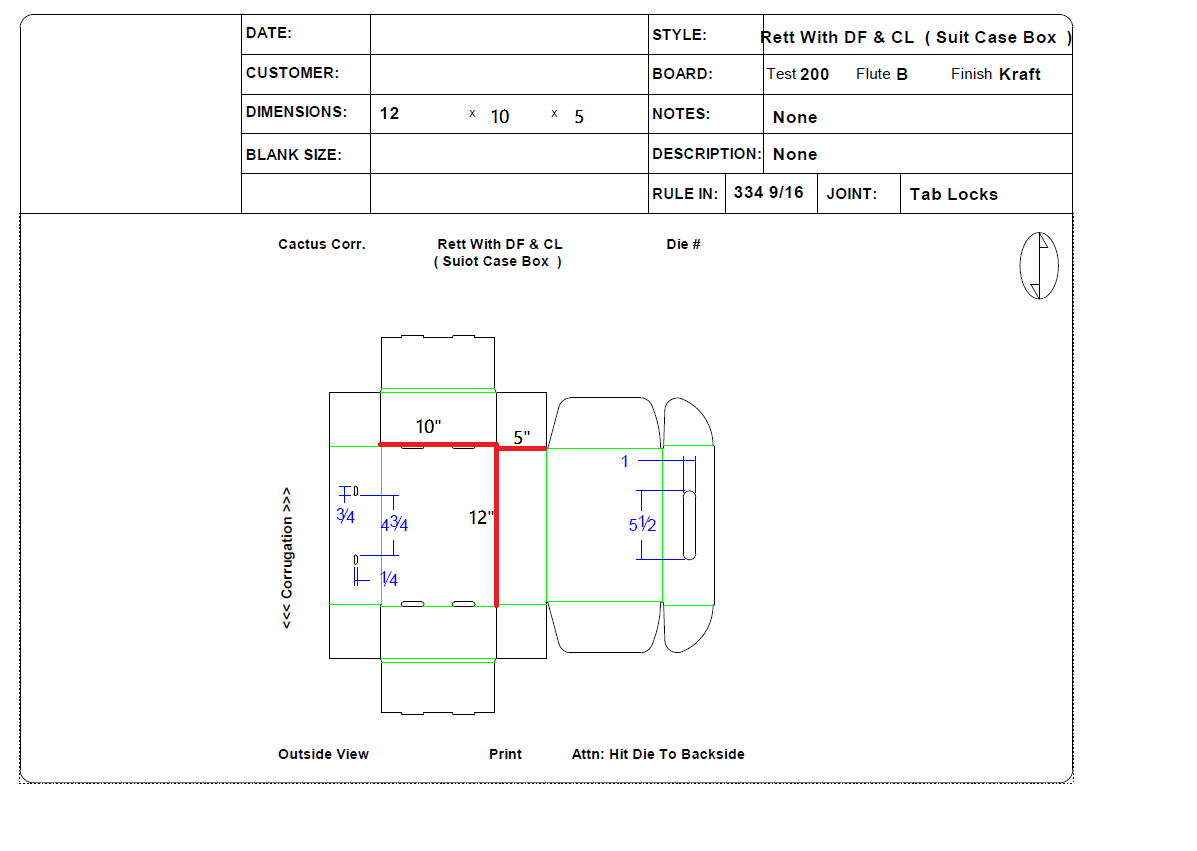
Ziro-master/BoM/Packaging/Box/Box DImensions.png
