ZeroUI/Industrial-Quark/Ziro-master/BoM/Packaging/Box/Foam Inserts/Lower Foam.JPG

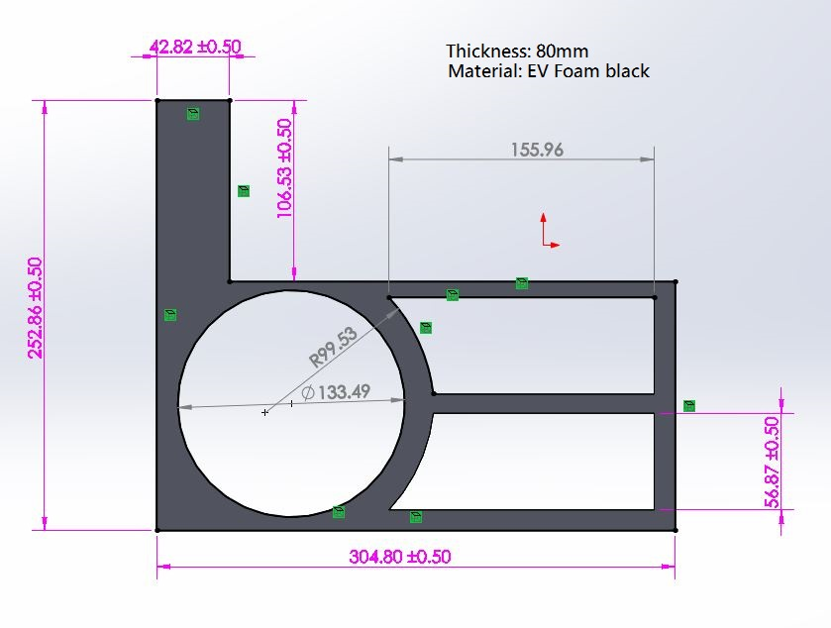
Ziro-master/BoM/Packaging/Box/Foam Inserts/Lower Foam.JPG
