ZeroUI/Industrial-Quark/Ziro-master/BoM/Packaging/Box/Foam Inserts/Upper Foam.JPG

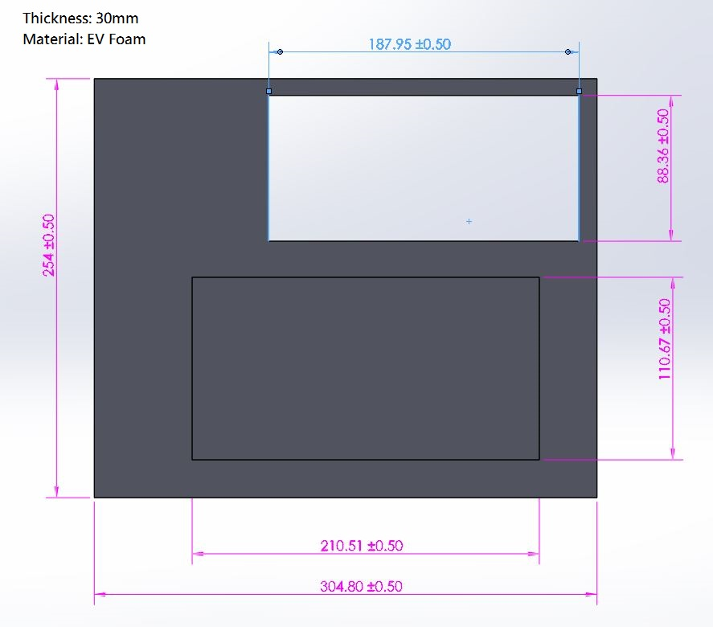
Ziro-master/BoM/Packaging/Box/Foam Inserts/Upper Foam.JPG
