ZeroUI/Industrial-Quark/Ziro-master/BoM/Packaging/Velvet Pouch.PNG

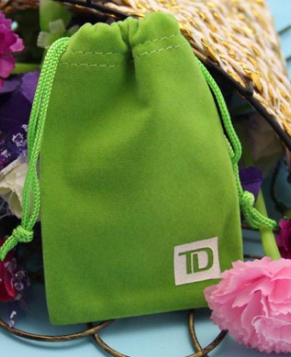
Ziro-master/BoM/Packaging/Velvet Pouch.PNG
