ZeroUI/Industrial-Quark/Ziro-master/BoM/Tile/Pod.JPG

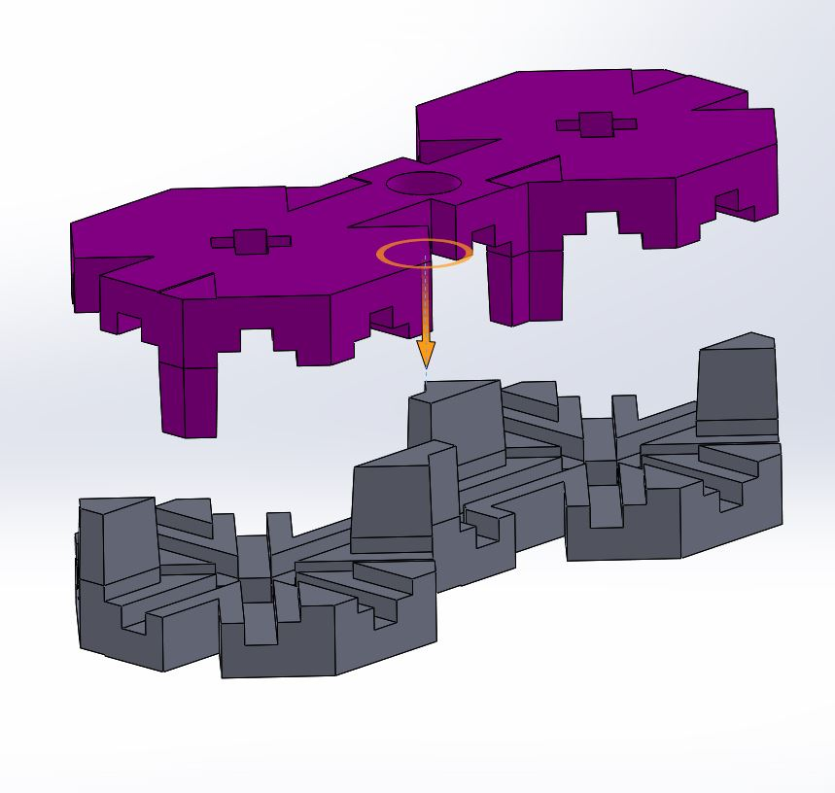
Ziro-master/BoM/Tile/Pod.JPG
