ZeroUI/Industrial-Quark/Ziro-master/BoM/Wheels/Wheel.JPG

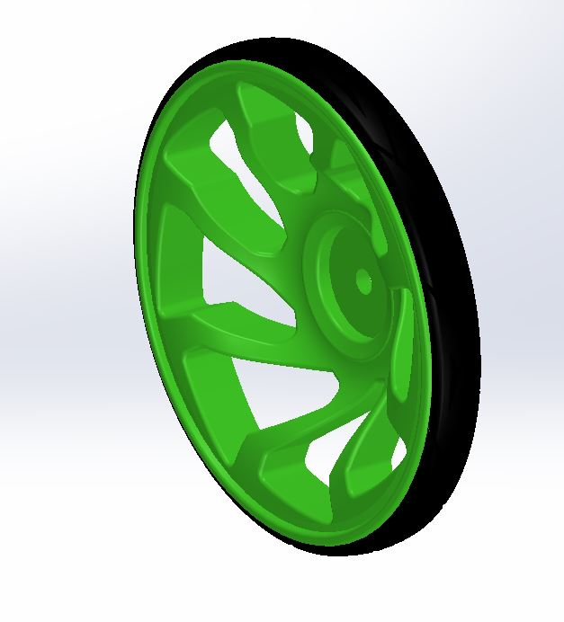
Ziro-master/BoM/Wheels/Wheel.JPG
