ZeroUI/Industrial-Quark/Ziro-master/Electronics/V1.0 Bluetooth/Hardware/Handimate_Backup/Glove Module/eagleUp/eagleUp_Glove Module- V1 Alle_board_bottom.png

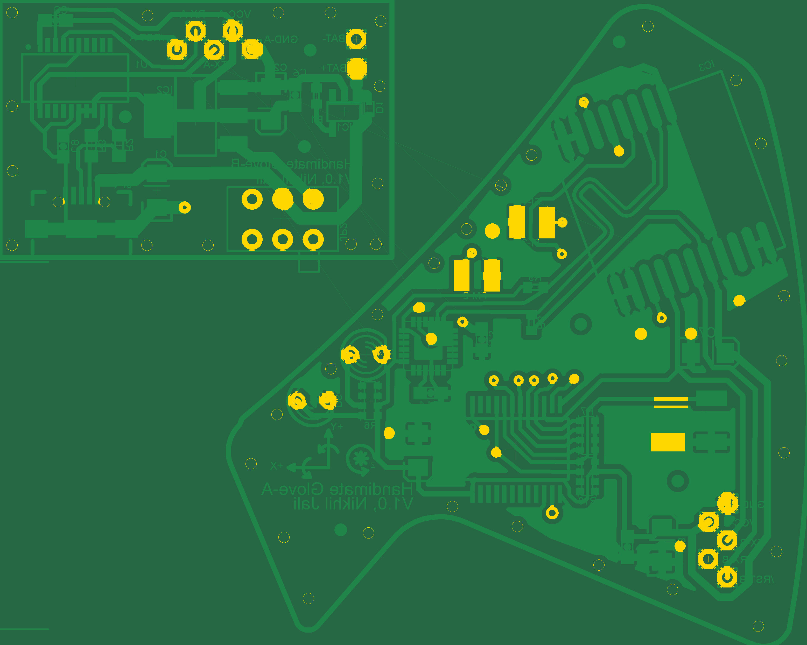
Ziro-master/Electronics/V1.0 Bluetooth/Hardware/Handimate_Backup/Glove Module/eagleUp/eagleUp_Glove Module- V1 Alle_board_bottom.png
