ZeroUI/Industrial-Quark/Ziro-master/Electronics/V1.0 Bluetooth/Hardware/Handimate_Backup/Motor Module/eagleUp/eagleUp_Motor Module V1-side mounting_bottom_silk.png

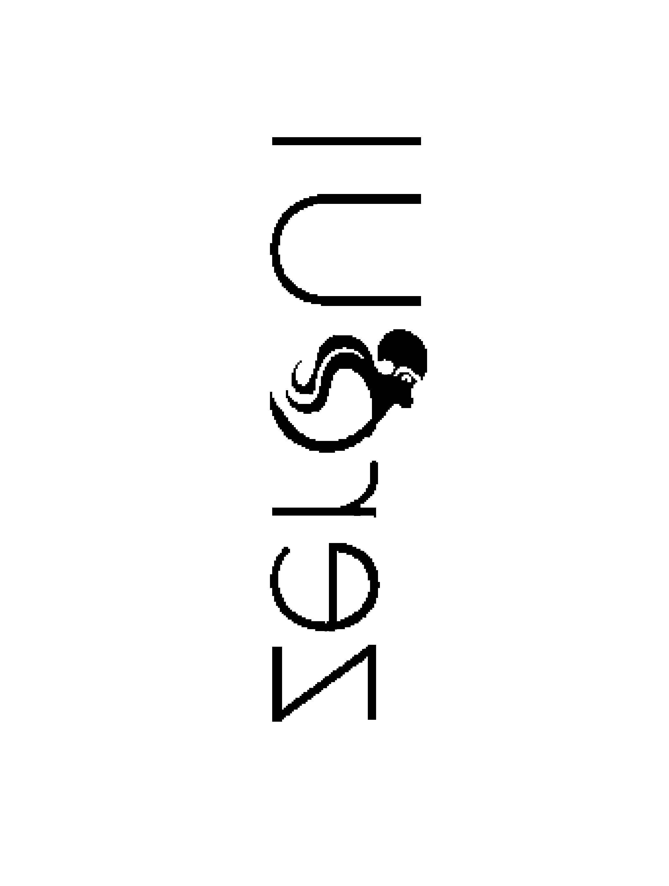
Ziro-master/Electronics/V1.0 Bluetooth/Hardware/Handimate_Backup/Motor Module/eagleUp/eagleUp_Motor Module V1-side mounting_bottom_silk.png
