ZeroUI/Industrial-Quark/Ziro-master/Electronics/V1.0 Bluetooth/Hardware/Handimate_Backup/Skethup/eagleU01.png

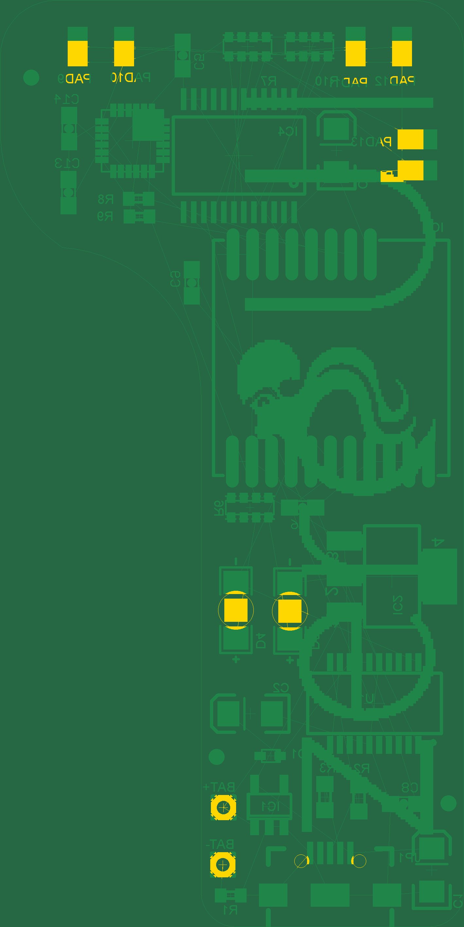
Ziro-master/Electronics/V1.0 Bluetooth/Hardware/Handimate_Backup/Skethup/eagleU01.png
