ZeroUI/Industrial-Quark/Ziro-master/Electronics/V1.0 Bluetooth/Hardware/Pictures of Bluetooth PCB/1A4D2060-61EE-4A69-B8E8-D9E75A81A350.JPG

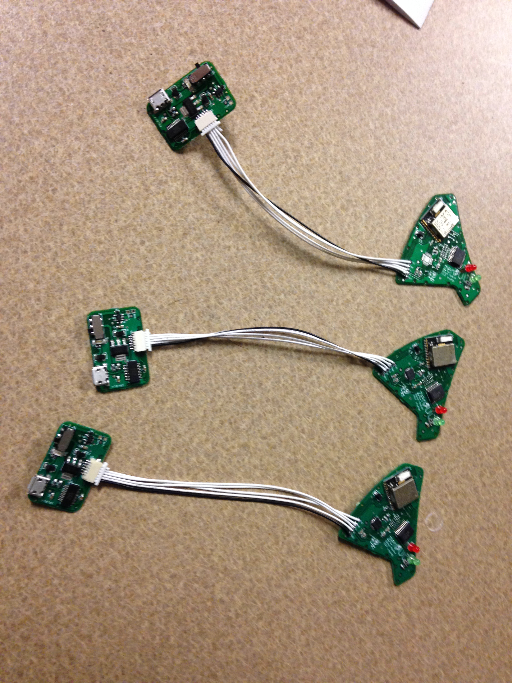
Ziro-master/Electronics/V1.0 Bluetooth/Hardware/Pictures of Bluetooth PCB/1A4D2060-61EE-4A69-B8E8-D9E75A81A350.JPG
