ZeroUI/Industrial-Quark/Ziro-master/Electronics/V1.0 Bluetooth/Hardware/Pictures of Bluetooth PCB/IMG_1973.JPG

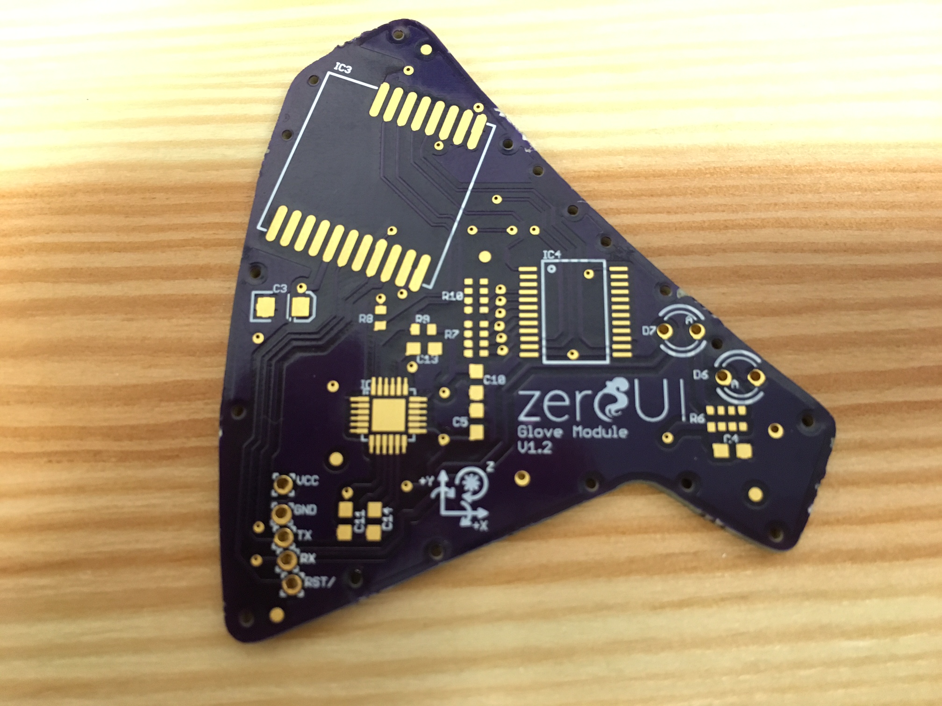
Ziro-master/Electronics/V1.0 Bluetooth/Hardware/Pictures of Bluetooth PCB/IMG_1973.JPG
