ZeroUI/Industrial-Quark/Ziro-master/Electronics/V2.0 Wifi/Documentation/ESP8266 Board Configuration.png

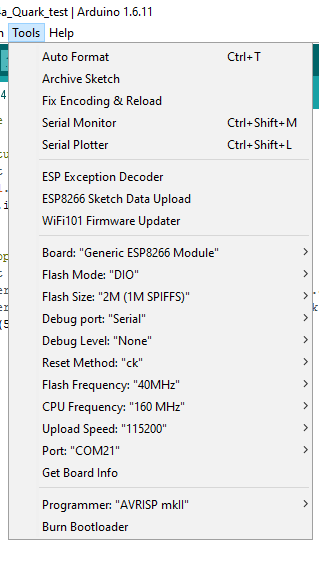
Ziro-master/Electronics/V2.0 Wifi/Documentation/ESP8266 Board Configuration.png
