ZeroUI/Industrial-Quark/Ziro-master/Electronics/V2.0 Wifi/Hardware/Flex Sensor/IMG_2048.JPG

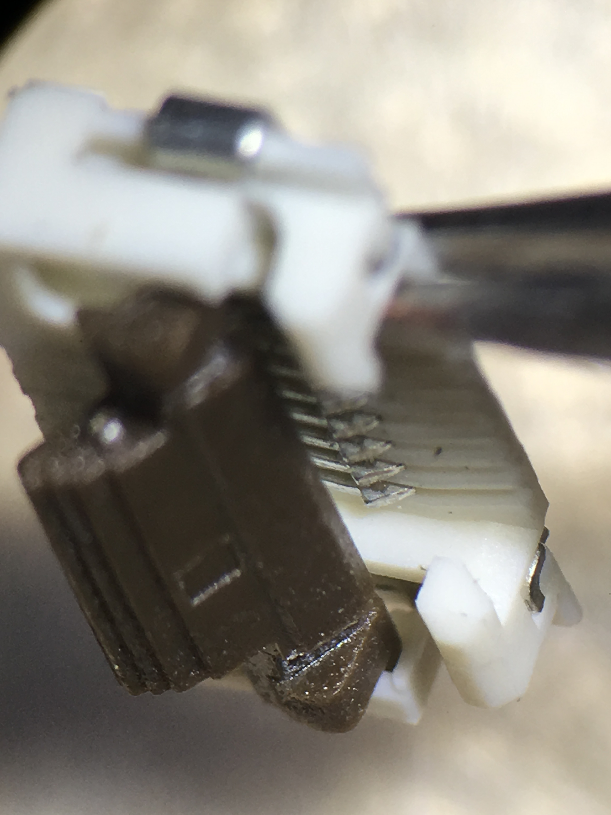
Ziro-master/Electronics/V2.0 Wifi/Hardware/Flex Sensor/IMG_2048.JPG
