ZeroUI/Industrial-Quark/Ziro-master/Electronics/V2.0 Wifi/Hardware/PCB/Module/Motor Dimension.jpg

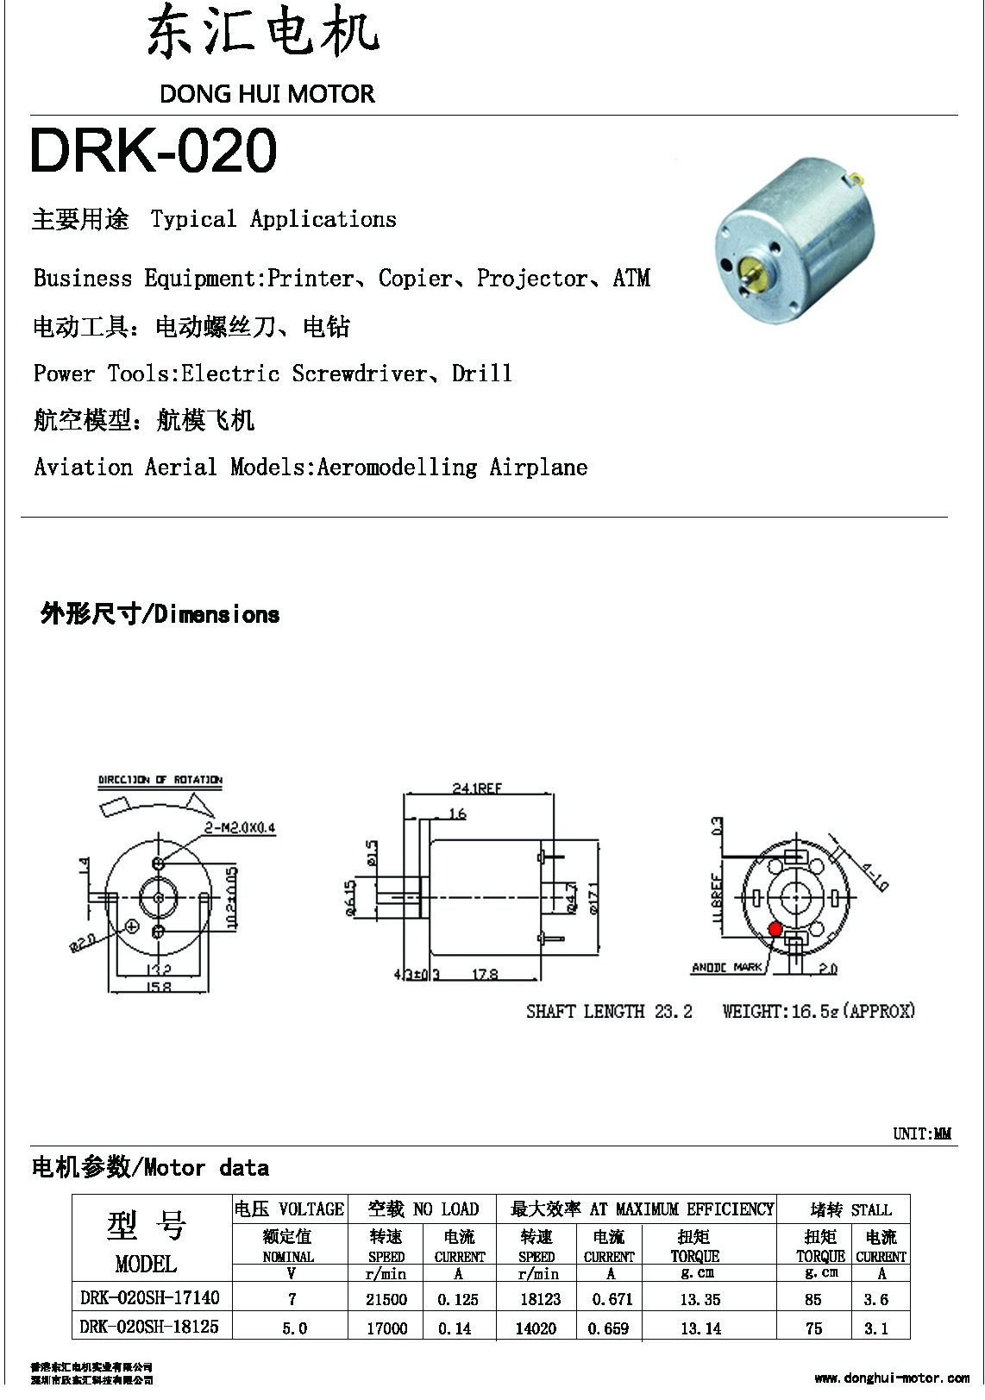
Ziro-master/Electronics/V2.0 Wifi/Hardware/PCB/Module/Motor Dimension.jpg
