ZeroUI/Industrial-Quark/Ziro-master/Electronics/V2.0 Wifi/Hardware/PCB/Production PCB/v0.4 NOD-PCBA/pics20161012_095901.jpg

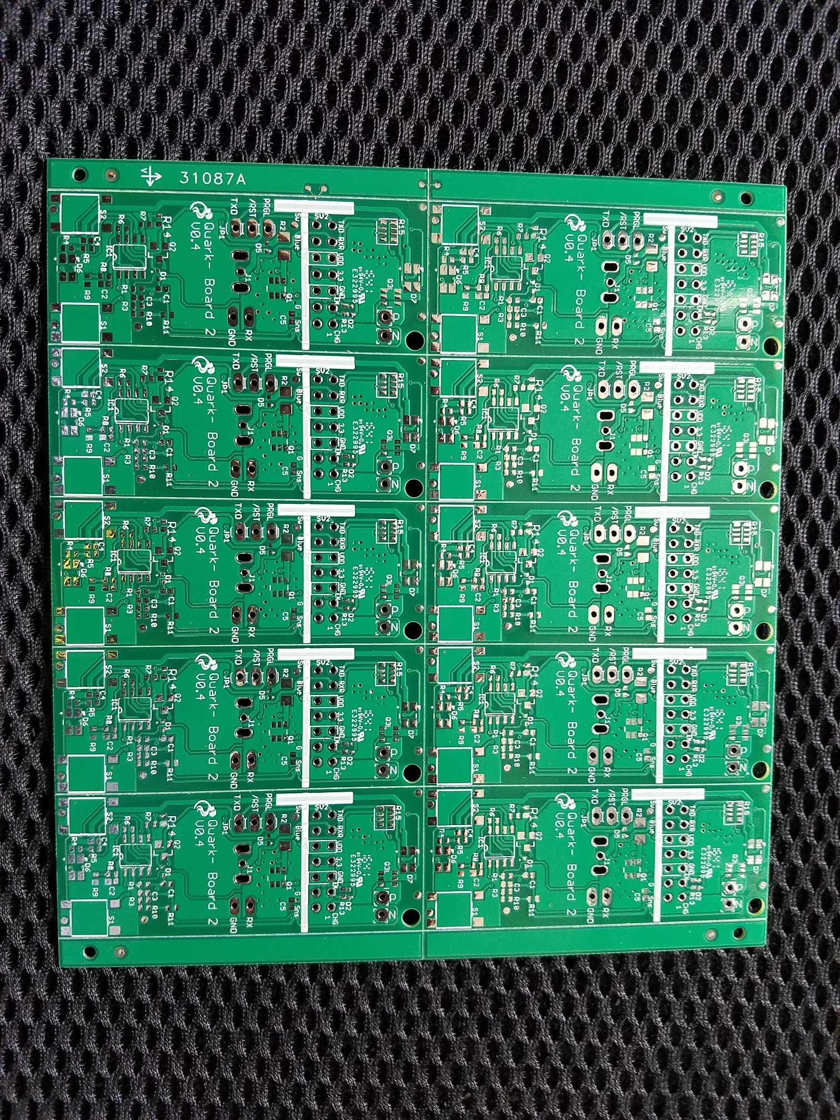
Ziro-master/Electronics/V2.0 Wifi/Hardware/PCB/Production PCB/v0.4 NOD-PCBA/pics20161012_095901.jpg
