ZeroUI/Industrial-Quark/Ziro-master/Electronics/V2.0 Wifi/Hardware/PCB/Thermal Imaging/FLIR0738.jpg

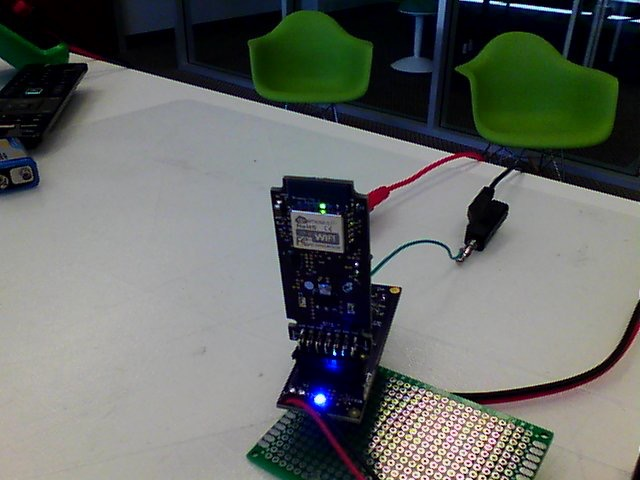
Ziro-master/Electronics/V2.0 Wifi/Hardware/PCB/Thermal Imaging/FLIR0738.jpg
