ZeroUI/Industrial-Quark/Ziro-master/Electronics/V1.0 Bluetooth/Hardware/Component Orders/BOM-1.pdf

Nikhil Jali | njali@purdue.edu
4/19/2015

Items Needed
Item | Use | Qty | Unit Price | Total Cost
Magnification Station | For soldering SMD components | 1 | 20.090 | $20.09
Soldering Tips | Soldering | 1 | 10.490 | $10.49
MPU6050 | Accelerometer | 2 | 10.830 | $21.66
150kohm Resistor | Resistor Array for flex sensor bias | 4 | 0.330 | $1.32
Slide Switch | Switch For Glove | 2 | 0.440 | $0.88
MCP73831 | Battery Mgmt IC | 6 | 0.670 | $4.02
10k Resistor | Resistors for Battery Mgmt IC | 20 | 0.013 | $0.26
Switch | Pushbutton | 5 | 6.130 | $30.65
USB micro | Connector | 6 | 1.060 | $6.36
100nF/0.1uF Capacitor | Capacito | 50 | 0.010 | $0.51
Switch | Pushbutton | 5 | 3.470 | $17.35
M2 Bolt | For holding module PCB | 1 | 4.760 | $4.76
Rfduino | Bluetooth module | 6 | 14.990 | $89.94
3.3V Regulator | Voltage Regulator | 15 | 0.479 | $7.19
10uF Capacitor | Harmonic Filtering | 2 | 11.950 | $23.90
16 Channel Multiplexer | ADC interface to sensors | 2 | 0.950 | $1.90
RGB LED | LED lights | 8 | 0.500 | $4.00
SMD LED - Green 1206 | LED lights | 1 | 4.950 | $4.95
Tall Push button | Button for motor module | 3 | 0.500 | $1.50
StepUp Down Charger | | 10 | 1.950 | $19.50
USB to Serial IC | USB-RS232 | 6 | 4.500 | $27.00
Total | | | | $298.23

Vendor | Part Number | Links
Amazon | | http://www.amazon.com/GadgetZone-Soldering-Illuminated-Magnifying-Adjustable/dp/B00GSEX8K6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
Amazon | | http://www.amazon.com/Baitaihem-12pcs-Solder-Soldering-Station/dp/B00KYVV9DM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
Digikey | 1428-1007-1-ND | http://www.digikey.com/product-detail/en/MPU-6050/1428-1007-1-ND/4038010
Digikey | 4608X-1-224LF-ND | http://www.digikey.com/product-detail/en/4608X-101-224LF/4608X-1-224LF-ND/1060603
Digikey | 401-2002-1-ND | http://www.digikey.com/product-detail/en/JS202011SCQN/401-2002-1-ND/1640098
Digikey | MCP73831T-2ACI/OTCT-ND | http://www.digikey.com/product-detail/en/MCP73831T-2ACI%2FOT/MCP73831T-2ACI%2FOTCT-ND/1979802
Digikey | MCP73831T-2ACI/OTCT-ND | http://www.digikey.com/product-detail/en/MCR01MRTF1002/RHM10.0KCDCT-ND/2796414
Digikey | | http://www.digikey.com/product-detail/en/ELUMEETHQ6C12/CKN9040-ND/806010
Digikey | | http://www.digikey.com/product-detail/en/1051330001/WM9734CT-ND/4037910
Digikey | | http://www.digikey.com/product-detail/en/GRM188R71C104KA01D/490-1532-6-ND/615587
Element14 | | http://www.newark.com/te-connectivity-alcoswitch/tp11cgra204/switch-pushbutton-spst-no-20v/dp/69K7044
McMaster-Carr | 92000A019 | http://www.mcmaster.com/#machine-screws/=x9m6i4
Mouser Electronics | 975-RFD22301 | http://www.mouser.com/ProductDetail/RF-Digital/RFD22301/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
Mouser Electronics | 595-UA78M33CDCYR | http://www.mouser.com/ProductDetail/Texas-Instruments/UA78M33CDCYR/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
Sparkfun | 1124 | https://www.sparkfun.com/products/11244
Sparkfun | CD74HC4067 | https://www.sparkfun.com/products/299
Sparkfun | 10866 | https://www.sparkfun.com/products/10866
Sparkfun | 12622 | https://www.sparkfun.com/products/12622
Sparkfun | 8605 | https://www.sparkfun.com/products/8605
Sparkfun | MC34063A | https://www.sparkfun.com/products/317
Sparkfun | FT232RL | https://www.sparkfun.com/products/650

http://www.amazon.com/GadgetZone-Soldering-Illuminated-Magnifying-Adjustable/dp/B00GSEX8K6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
http://www.digikey.com/product-detail/en/4608X-101-224LF/4608X-1-224LF-ND/1060603
http://www.digikey.com/product-detail/en/JS202011SCQN/401-2002-1-ND/1640098http://www.digikey.com/product-detail/en/MCP73831T-2ACI%2FOT/MCP73831T-2ACI%2FOTCT-ND/1979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
