ZeroUI/Industrial-Quark/Ziro-master/BoM/Packaging/E1-PCB/Charging v0.1 BOM.xlsx

Sub-Assembly | Assembly | Part | Value | Package | Position (mm) |  | Orientation | Part Number | Digikey Pricing | Manufacturer | Manufacturer Part Number | Description
 |  |  |  |  | x | y
Electronics |  | C1 | 0.1uF | 0402-CAP | 66.0362 | 22.0112 | R180 | 1276-1001-1-ND | $0.100000 | SAMSUNG ELECTRO-MECHANICS AMERICA, INC (VA) | CL05B104KO5NNNC | CAP CER 0.1UF 16V X7R 0402
 |  | C2 | 22u, 25V | C1206 | 4.5252 | 15.7500 | R90 | 490-10755-2-ND | $0.078000 | MURATA ELECTRONICS | GRM31CR61E226ME15L | CAP CER 22UF 25V X5R 1206
 |  | C3 | 22u, 35V | PANASONIC_D | 59.2000 | 25.7000 | R180 | 493-9805-2-ND | $0.044560 | NICHICON | UWJ1V220MCL1GB | CAP ALUM 22UF 20% 35V SMD
 |  | C9 | 22u, 35V | PANASONIC_D | 237.3000 | 6.3460 | R90 | 493-9805-2-ND | $0.044560 | NICHICON | UWJ1V220MCL1GB | CAP ALUM 22UF 20% 35V SMD
 |  | C10 | 22u, 35V | PANASONIC_D | 148.5000 | 20.0000 | R270 | 493-9805-2-ND | $0.044560 | NICHICON | UWJ1V220MCL1GB | CAP ALUM 22UF 20% 35V SMD
 |  | C11 | 22u, 35V | PANASONIC_D | 104.0000 | 20.0000 | R270 | 493-9805-2-ND | $0.044560 | NICHICON | UWJ1V220MCL1GB | CAP ALUM 22UF 20% 35V SMD
 |  | C12 | 22u, 35V | PANASONIC_D | 194.0000 | 20.0000 | R270 | 493-9805-2-ND | $0.044560 | NICHICON | UWJ1V220MCL1GB | CAP ALUM 22UF 20% 35V SMD
 |  | D1 | GREEN | LED-1206 | 43.0906 | 24.7444 | R180 | 1516-1170-1-ND | $0.116820 | QT BRIGHTEK (QTB) (VA) | QBLP651-IG | LED GREEN CLEAR 1206 SMD
 |  | D2 | GREEN | LED-1206 | 18.9578 | 19.4612 | R90 | 1516-1170-1-ND | $0.116820 | QT BRIGHTEK (QTB) (VA) | QBLP651-IG | LED GREEN CLEAR 1206 SMD
 |  | D3 | GREEN | LED-1206 | 32.7500 | 4.2800 | R180 | 1516-1170-1-ND | $0.116820 | QT BRIGHTEK (QTB) (VA) | QBLP651-IG | LED GREEN CLEAR 1206 SMD
 |  | D4 | GREEN | LED-1206 | 32.4800 | 26.5700 | R0 | 1516-1170-1-ND | $0.116820 | QT BRIGHTEK (QTB) (VA) | QBLP651-IG | LED GREEN CLEAR 1206 SMD
 |  | D5 | GREEN | LED-1206 | 47.6081 | 10.8276 | R90 | 1516-1170-1-ND | $0.116820 | QT BRIGHTEK (QTB) (VA) | QBLP651-IG | LED GREEN CLEAR 1206 SMD
 |  | D6 | GREEN | LED-1206 | 47.6761 | 19.4477 | R90 | 1516-1170-1-ND | $0.116820 | QT BRIGHTEK (QTB) (VA) | QBLP651-IG | LED GREEN CLEAR 1206 SMD
 |  | D7 | GREEN | LED-1206 | 42.3700 | 7.3200 | R135 | 1516-1170-1-ND | $0.116820 | QT BRIGHTEK (QTB) (VA) | QBLP651-IG | LED GREEN CLEAR 1206 SMD
 |  | D8 | GREEN | LED-1206 | 18.9578 | 10.8570 | R90 | 1516-1170-1-ND | $0.116820 | QT BRIGHTEK (QTB) (VA) | QBLP651-IG | LED GREEN CLEAR 1206 SMD
 |  | D9 | GREEN | LED-1206 | 29.9494 | 18.9532 | R138 | 1516-1170-1-ND | $0.116820 | QT BRIGHTEK (QTB) (VA) | QBLP651-IG | LED GREEN CLEAR 1206 SMD
 |  | D10 | GREEN | LED-1206 | 23.5298 | 6.5278 | R180 | 1516-1170-1-ND | $0.116820 | QT BRIGHTEK (QTB) (VA) | QBLP651-IG | LED GREEN CLEAR 1206 SMD
 |  | D11 | GREEN | LED-1206 | 35.9184 | 13.4668 | R135 | 1516-1170-1-ND | $0.116820 | QT BRIGHTEK (QTB) (VA) | QBLP651-IG | LED GREEN CLEAR 1206 SMD
 |  | D12 | GREEN | LED-1206 | 24.5900 | 23.8300 | R315 | 1516-1170-1-ND | $0.116820 | QT BRIGHTEK (QTB) (VA) | QBLP651-IG | LED GREEN CLEAR 1206 SMD
 |  | IC1 | TS30011 | QFN16G-0.5-3X3MM | 67.0362 | 18.3112 | R90 | TS30013-M050QFNRCT-ND | $0.519750 | SEMTECH CORPORATION (VA) | TS30013-M050QFNR | IC REG BUCK 5V 3A SYNC 16QFN
 |  | J1 | CONN-CIR_MAG | CONN-MAG | 215.7800 | 15.0000 | R90
 |  | J2 | CONN-CIR_MAG | CONN-MAG | 170.7800 | 15.0000 | R90
 |  | J3 | CONN-CIR_MAG | CONN-MAG | 125.7800 | 15.0000 | R90
 |  | J4 | CONN-CIR_MAG | CONN-MAG | 80.7800 | 15.0000 | R90
 |  | J5 | CP-102A-ND | CONN_JACK_THRU | 239.0000 | 14.6503 | R270 | CP-102A-ND | $0.270000 | CUI INC | PJ-102A | CONN JACK POWER 2.0MM PCB
 |  | J6 | Vertical USB-A | USB-A-VERTICAL_MOUNT | 10.5000 | 15.0000 | R90 | ED2987-ND | $0.295800 | ON SHORE TECHNOLOGY INC | USB-A1VSW6 | CONN USB TYPE A VERTICAL WHITE
 |  | L1 | 4.7UH,4.6A | INDUCTOR_47UH | 58.9266 | 17.3112 | R270 | SRU8043-4R7YTR-ND | $0.319200 | BOURNS INC | SRU8043-4R7Y | FIXED IND 4.7UH 4.6A 17 MOHM SMD
 |  | R1 | 15E, 5%, 1206 | R1206 | 43.3700 | 14.9400 | R90 | 311-15ERTR-ND | $0.002890 | Yageo | RC1206JR-0715RL | RES SMD 15 OHM 5% 1/4W 1206
 |  | PCB |  |  |  |  |  | PCB Cost | $0.37500 | NOD-PCBA - Assumed
 | PCB- Assembly |  |  |  |  |  |  |  | $0.10000 | NOD-PCBA - Assumed
