ZeroUI/Industrial-Quark/Ziro-master/Electronics/V2.0 Wifi/Documentation/Ziro v0.2 Electronics Component Freeze.xlsx

Sheet: Pin Connections
Pin Number | Pin Name | Pin Multiplexed Functionality | Pin Description | Ziro Glove | Ziro Module | Misc
1 | Vcc | Vdd | Supply Voltage
2 | IO4 | GPIO4 |  | Mux-S1 | Mux-S1
3 | IO0 | GPIO0 |  | LED-B | LED-B | Needs to be held LOW for Programming- Default High
4 | IO2 | GPIO2; UART1_TXD |  | I2C SDA |  | Needs to be held HIGH for Programming- Default High
5 | IO15 | GPIO15; MIDO; HSPICS;UART0_RTS |  | IMU-INT | Torque_INT | Needs to be held LOW for Programming & Normal Boot- Default Low
6 | GND | GND | Ground
7 | IO13 | GPIO13; HSPI_MOSI;UART0_CTS |  | LED-G | LED-G
8 | IO5 | GPIO5 |  | Mux-S0 | Mux-S0
9 | URXD | UART0_RXD; GPIO3 |  | ----------Prog---------- | ----------Prog----------
10 | GND | GND | Ground
11 | UTXD | UART0_TXD; GPIO1 |  | ----------Prog---------- | ----------Prog----------
12 | RST | Reset Module | Hold High through 4.7kOhm. Low to Reset
13 | TOUT | VDD3P3; TOUT | 10-Bit ADC | MUX-Input ADC | MUX-Input ADC
14 | EN | Chip Enable
15 | IO16 | GPIO16; DeepSleep | Deep sleep wakeup, by connecting to RST pin | Soft Latch | Soft Latch
16 | IO12 | GPIO12; HSPI_MISO |  | LED-R | LED-R
17 | IO14 | GPIO14; HSPI_CLK |  | I2C SCL
18 | GND | GND
MUX Requirement
Glove | 3 Flex | 1 Battery
Motor | 1 Battery | 1 Current Load | 1 Angle Sensor

Sheet: MOdule Current Sensor
ADC Count | Current (A) | ADC Count
10 | 0.05 | 10
20 | 0.10 | 20
32 | 0.15 | 32
43 | 0.20 | 43
54 | 0.25 | 54
65 | 0.30 | 65
76 | 0.35 | 76
87 | 0.40 | 87
98 | 0.45 | 98
109 | 0.50 | 109
121 | 0.55 | 121
135 | 0.60 | 135
146 | 0.65 | 146
156 | 0.70 | 156
167 | 0.75 | 167
179 | 0.80 | 179
190 | 0.85 | 190
200 | 0.90 | 200
210 | 0.95 | 210
222 | 1.00 | 222
233 | 1.05 | 233
244 | 1.10 | 244
256 | 1.15 | 256
267 | 1.20 | 267
278 | 1.25 | 278
290 | 1.30 | 290
300 | 1.35 | 300
311 | 1.40 | 311
321 | 1.45 | 321
333 | 1.50 | 333
344 | 1.55 | 344
355 | 1.60 | 355
366 | 1.65 | 366
378 | 1.70 | 378
392 | 1.75 | 392
403 | 1.80 | 403
413 | 1.85 | 413
424 | 1.90 | 424
436 | 1.95 | 436
447 | 2.00 | 447
458 | 2.05 | 458
468 | 2.10 | 468
480 | 2.15 | 480
490 | 2.20 | 490
501 | 2.25 | 501
512 | 2.30 | 512
523 | 2.35 | 523
534 | 2.40 | 534
546 | 2.45 | 546
556 | 2.50 | 556
567 | 2.55 | 567
578 | 2.60 | 578
590 | 2.65 | 590
600 | 2.70 | 600
611 | 2.75 | 611
623 | 2.80 | 623
634 | 2.85 | 634
648 | 2.90 | 648
658 | 2.95 | 658
669 | 3.00 | 669

Sheet: Angle Sensor Testing
ADC | Angle
150 | 90
296 | 0
440 | -90

Sheet: Module Connector
SV1- Board 1 | SV2 - Board 2 | Function
1 | 2 | Vdd
2 | 1 | Vdd
3 | 4 | Rx
4 | 3 | Tx
5 | 6 | GND
6 | 5 | GND
7 | 8 | 3V3
8 | 7 | L-Red
9 | 10 | CHG_ON
10 | 9 | L-Blue
11 | 12 | SW_INT
12 | 11 | PWR_EN
13 | 14 | Vbat-sns
14 | 13 | L-Green

Sheet: CHarging
Charging Method | USB-Step Up |  |  |  |  | Magnetic
 | Item | Cost | Qty | Total |  | Item | Cost | Qty | Total
Power SUpply | 5V, 4Amp | $2.00 | 1 | $2.00 |  | 12V 1.5A | $2.00 | 1 | $2.00
Connectors | Micro USB | $0.18 | 4 | $0.72 |  | Magnetic | $1.65 | 4 | $6.60
Peripherals | Step Up IC Regulator, TPS6734I | $2.03 | 4 | $8.12 |  |  |  |  | $0.00
 | Inductor, 18uH, 1.5A | $0.18 | 4 | $0.72 |  |  |  |  | $0.00
 | Diode, 500mA | $0.08 | 4 | $0.32 |  |  |  |  | $0.00
 | Capacitor 1nF | $0.01 | 4 | $0.04 |  |  |  |  | $0.00
 | Capacitor 33uF | $0.01 | 4 | $0.04 |  |  |  |  | $0.00
BMS | NA | Same | Same |  |  | NA | Same | Same
 |  |  | Total | $11.96 |  |  |  | Total | $8.60
 |  |  |  |  | Difference | -$3.36
Battery Mgmt System for Modules BQ2057WSNR
 |  |  |  |  | BQ2057WSNR (http://www.ti.com/lit/ds/symlink/bq2057c.pdf)
Sense Resistor Calculation
Sense Voltage Fixed [V] | Charging Current [A] | Sense Resistor [Ohm]
0.125 | 0.25 | 0.5
Thermistor Details |  |  |  |  |  |  |  |  |  | Safe Divider Ratios
Part Number | Resistance at 25degC | B- Constant at 25-50degC | B- Constant at 25-85degC | B- Constant at 25-100degC | Operating Current [mA] | Rated Power [mW] |  |  |  | 0.3-0.6
NCP15XV103p03RC | 10000 | 3900 | 3930 | 3944 | 0.31 | 100
Thermal Temperature Cut-off Resistances
Cold Temp Cut-off [degC] | Cold Resistance [Ohm] |  | Hot Temp Cut-off [degC] | Hot Resistance [Ohm]
10 | 21834.77366 |  | 60 | 2757.423708
BQ2057 Programmable Resistors for Cold/Hot Cut-Off for NTC
For Both UnderTemp/OverTemp Protection |  |  | For Only OverTemp Protection |  | Ratio Calculator Generator
RT1 [Ohm] | RT2 [Ohm] |  | RT1-Up [Ohm] |  |  |  | Over/UnderTemp Protection Resistors RT1 RT2 |  | Parallel Resistance of Therm and RT2 [Ohm] | Divider Ratio
5259.965588 | 12354.06207 |  | 6433.988652 |  |  |  | 5300 | 12400 | 1692.337366 | 0.2420274191
 |  |  |  |  | Define Temperature [degC] | Resultant Thermistor Resistance [Ohm]
 |  |  |  |  | 70 | 1959.80991
Parallel Resistance of Thermistor and RT2 |  |  |  |  |  |  | Only OverTemp Protection RT1 - |  |  | Divider Ratio
@Cold Temp Cutoff [Ohms] | @Hot Temp Cutoff [Ohms] |  |  |  |  |  | 6400 |  |  | 0.2344323532
7889.948382 | 2254.270966
 |  |  |  |  |  |  | Over/UnderTemp Protection Resistors RT1 RT2 |  | Parallel Resistance of Therm and RT2 [Ohm] | Divider Ratio
Divider Ratio @Cold Temp | Divider Ratio @Hot Temp |  | Divider Ratio with only RT1 for OverTemp |  |  |  | 3000 | 3000 | 1185.414328 | 0.2832250847
0.6 | 0.3 |  | 0.3
State | Divider Ratio
Fault | >0.6
Normal | 0.3-0.6
Fault | <0.3

Sheet: Glove Component Freeze
Module Components
Sl No | Component Name | Description | Manufacturer | Manufacturing Number | Digikey Number | Unit Price | Qty | Total | Ordering Link | Unit Price per 1k | Unit Price Per 5k | Unit Price per 10k | Unit Price Per Max
1 | WT8266 | Wireless Communication Chip | Wireless Tag | WT8266-S1 | NA | $3.00 | 1 | $3.00 | http://www.wireless-tag.com/index.php/Product/dis/33.html
2 | LD1117 | 3.3V Power Regulator | Diodes Incorporated | AZ1117CH-3.3TRG1 | AZ1117CH-3.3TRG1DITR-ND | $0.38 | 1 | $0.38 | http://www.digikey.com/product-detail/en/diodes-incorporated/AZ1117CH-3.3TRG1/AZ1117CH-3.3TRG1DITR-ND/4470985 | $0.095 | $0.119 | $0.110 | $0.094/125k
3 | 330E Ohm | 3 Resistor Array for RGB LEDs | Panasonic Electronic | EXB-38V331JV | Y9331CT-ND | $0.12 | 1 | $0.12 | http://www.digikey.com/product-detail/en/panasonic-electronic-components/EXB-38V331JV/Y9331TR-ND/256525 | $0.012 | $0.083 | $0.071 | $0.05763/200k
4 | 510k Ohm | 4 Resistory Array for Flex Sensors | Vishay Dale | CRA06S083510KJTA | CRA6S8510KTR-ND | $0.10 | 1 | $0.10 | http://www.digikey.com/product-detail/en/vishay-dale/CRA06S083510KJTA/CRA6S8510KTR-ND/1285483 | $0.015 | $0.010 | $0.009 | $0.00771/125k
5 | Diode | 1A Diode for Reverse Polarity Protection | Fairchild Semiconductors | S1A | S1AFSCT-ND | $0.24 | 1 | $0.24 | http://www.digikey.com/product-detail/en/fairchild-semiconductor/S1A/S1AFSTR-ND/965462 | $0.047 | $0.036 | $0.030 | $0.02327/187k
6 | Mux | 16 Channel Mux for Flex Sensor | Texas Instruments | CD74HC4067M96 | 296-29408-2-ND | $0.77 | 1 | $0.77 | http://www.digikey.com/product-detail/en/texas-instruments/CD74HC4067M96/296-29408-1-ND/2741760 | $0.330 | $0.277 | $0.260 | $0.250
8 | LED _RGB | For Indication | KingBright | APFA3010SEEZGQBDC | 754-1649-2-ND | $1.61 | 1 | $1.61 | http://www.digikey.com/product-detail/en/kingbright/APFA3010SEEZGQBDC/754-1649-2-ND/2514732 | $0.476 | $0.465 | $0.448
9 | MPU6050 | Accelerometer | Invense | MPU-6050 | 1428-1007-2-ND | $7.23 | 1 | $7.23 | http://www.digikey.com/product-detail/en/invensense/MPU-6050/1428-1007-2-ND/4038009 |  | $3.490 | $3.288
10 | MCP73831 | Battery Management | MicroChip Technologu | MCP73831T-2ACI/OT | MCP73831T-2ACI/OTTR-ND | $0.56 | 1 | $0.56 | http://www.digikey.com/product-detail/en/microchip-technology/MCP73831T-2ACI%2FOT/MCP73831T-2ACI%2FOTTR-ND/964301 | $0.42/3k
11 | 2200pF Capacitor | IMU Interface | Murata Electronics | GRM155R71H222JA01J | 490-1459-2-ND | $0.10 | 1 | $0.10 | https://www.digikey.com/product-detail/en/murata-electronics-north-america/GRM155R71H222JA01J/490-6359-2-ND/2610934 | $0.004 | $0.003 | $0.003 | $0.00179/100k
12 | 0.1uF Capacitor | Harmonic Filtering | Murata Electronics | GRM188R71C104KA01D | 490-1532-6-ND | $0.10 | 3 | $0.30 | http://www.digikey.com/product-detail/en/murata-electronics-north-america/GRM188R71C104KA01D/490-1532-2-ND/587060 | $0.005 | $0.004 | $0.003 | $0.00215/100k
13 | 10000pF Capacitor | IMU Interface | Murata Electronics | GRM155R71H103KA88D | 490-4516-2-ND | $0.10 | 1 | $0.10 | http://www.digikey.com/product-detail/en/murata-electronics-north-america/GRM155R71H103KA88D/490-4516-2-ND/1033252 | $0.003 |  | $0.002 | $0.00138/100k
14 | 10uF | Harmonic Filtering | Murata Electronics | GRM21BR61C106KE15L | 490-3886-2-ND | $0.20 | 2 | $0.40 | http://www.digikey.com/product-detail/en/murata-electronics-north-america/GRM21BR61C106KE15L/490-3886-2-ND/965900 | $0.042 | $0.033 | $0.030 | $0.02228/150k
15 | 100uF Capacitor | ESP8266 Power Supply | Murata Electronics | GRM31CD80J107ME39L | 490-10525-2-ND | $0.55 | 1 | $0.55 | http://www.digikey.com/product-detail/en/murata-electronics-north-america/GRM31CD80J107ME39L/490-10525-1-ND/5026461 | $0.176 | $0.117 | $0.110 | $0.09788/100k
 |  |  |  |  |  |  |  | $0.00
 |  |  |  |  |  |  |  | $0.00
Tentative |  |  |  |  |  |  |  | $0.00
NA | FPC Connector | Connecting Flex Sensors | Amphenol FCI | SFW6R-3STE1LF | 609-1891-2-ND | $0.66 | 1 | $0.66 | http://www.digikey.com/product-detail/en/omron-electronics-inc-emc-div/XF3M(1)-0415-1B/OR1210CT-ND/4695933 | $0.34 | $0.28 | $0.25 | $0.24505/50k
NA | FPC Connector | Connecting Flex Sensors | Hirose Electric Co Ltd | FH12-5S-1SH(55) | HFB105TR-ND | $1.30 | 1 | $1.30 | http://www.digikey.com/product-detail/en/hirose-electric-co-ltd/FH12-5S-1SH(55)/HFB105TR-ND/1110358 | $0.70 | $0.58 | $0.53 | $0.52/14k
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
 |  |  |  |  |  |  |  | $0.00
 |  |  |  |  |  |  |  | $0.00
 |  |  |  |  |  |  |  | $0.00
 |  |  |  |  |  |  |  | $0.00
 |  |  |  |  |  |  |  | $0.00
 |  |  |  |  |  |  |  | $0.00
 |  |  |  |  |  |  |  | $0.00
 |  |  |  |  |  |  |  | $0.00
 |  |  |  |  |  |  |  | $0.00

Sheet: Module Component Freeze
Module Components
Sl No | Component Name | Description | Manufacturer | Manufacturing Number | Digikey Number | Unit Price | Qty | Total | Ordering Link | Unit Price per 1k | Unit Price Per 5k | Unit Price per 10k | Unit Price Per Max
1 | WT8266 | Wireless Communication Chip | Wireless Tag | WT8266-S1 | NA | $3.00 | 1 | $3.00 | http://www.wireless-tag.com/index.php/Product/dis/33.html
2 | DRV8839 | Motor Driver with built-in protection | Texas Instruments | DRV8839DSSR | 296-35701-2-ND | $1.53 | 4 | $6.12 | http://www.digikey.com/product-detail/en/texas-instruments/DRV8839DSSR/296-35701-2-ND/3911198 | $0.560
3 | GP2S60 | Encoder Photointerrupter transistor | Sharp MicroElectronics | GP2S60B | 425-2670-2-ND | $0.79 | 1 | $0.79 | http://www.digikey.com/product-detail/en/sharp-microelectronics/GP2S60B/425-2670-2-ND/857215 | $0.290 | $0.250 | $0.230
4 | LD1117 | 3.3V Power Regulator | STMicroelectronics | LD1117S33CTR | 497-1241-2-ND | $0.37 | 1 | $0.37 | http://www.digikey.com/product-detail/en/stmicroelectronics/LD1117S33CTR/497-1241-2-ND/585765 | $0.270 | $0.119 | $0.110 | $0.094/125k
5 | Diode | 1A Diode for Reverse Polarity Protection | Fairchild Semiconductors | S1A | S1AFSCT-ND | $0.24 | 1 | $0.24 | http://www.digikey.com/product-detail/en/fairchild-semiconductor/S1A/S1AFSTR-ND/965462 | $0.047 | $0.036 | $0.030 | $0.02327/187k
6 | LM358 | Op-Amp for Signal Conditioning | STMicroelectronics | LM358DT | 497-1591-2-ND | $0.38 | 1 | $0.38 | http://www.digikey.com/product-detail/en/stmicroelectronics/LM358DT/497-1591-2-ND/591693 | $0.093 | $0.076 | $0.070 | $0.05625/125k
7 | Battery Strap | 9V Battery Connector | Keystone Electronics | 232 | 36-232-ND | $0.60 | 1 | $0.60 | http://www.digikey.com/product-detail/en/keystone-electronics/232/36-232-ND/303804 | $0.254 | $0.219
8 | RGB LED-Bottom | Bottom Facing RGB LED | Sun LED | XZMDKCBDDG45S-9 | 1497-1257-2-ND | $1.46 | 1 | $1.46 | http://www.digikey.com/product-detail/en/sunled/XZMDKCBDDG45S-9/1497-1257-2-ND/4902045 | $0.430 | $0.420 | $0.404 | $0.38808/50k
9 | RGB LED-Top | Top Facing RGB LED | Sun LED | XZM2CRKM2DGFBB45SCCB | 1497-1225-2-ND | $1.19 | 1 | $1.19 | http://www.digikey.com/product-detail/en/sunled/XZM2CRKM2DGFBB45SCCB/1497-1225-2-ND/5001325 | $0.352 | $0.344 | $0.331 | $0.318/50k
10 | IRLTS2242TRPBF | Power Control FETs, P-Channel FETs | Infineon Technologies | IRLTS2242TRPBF | IRLTS2242TRPBFCT-ND | $0.48 | 1 | $0.48 | http://www.digikey.com/product-detail/en/infineon-technologies-americas-corp/IRLTS2242TRPBF/IRLTS2242TRPBFTR-ND/3193500 | $0.150 | $0.126 | $0.117 | $0.09963/150k
11 | NPN 40V 0.2A | Transistor for Power Control | ON Semiconductor | MMBT3904LT3G | MMBT3904LT3GOSTR-ND | $0.12 | 2 | $0.24 | https://www.digikey.com/product-detail/en/on-semiconductor/MMBT3904LT3G/MMBT3904LT3GOSTR-ND/919602 | $0.023 |  | $0.014 | $0.00958/250k
12 | 0.02E Ohm | Motor Current Sense Resistor (1%) | Panasonic Electronic | ERJ-8CWFR020V | P0.02BVTR-ND | $0.69 | 1 | $0.69 | http://www.digikey.com/product-detail/en/panasonic-electronic-components/ERJ-8CWFR020V/P0.02BVTR-ND/4927004 | $0.123 | $0.094 | $0.092 | $0.08654/125k
13
14 | 1k Ohm |  | TE Connectivity AMP | CRG0402J1K0 | A106129TR-ND | $0.10 | 3 | $0.30 | https://www.digikey.com/product-detail/en/te-connectivity-amp-connectors/CRG0402J1K0/A106129TR-ND/2389662 | $0.002 | $0.002 | $0.001 | $0.00074/100k
15 | 10k Ohm |  | TE Connectivity AMP | CRG0402J10K/10 | A106045TR-ND | $0.10 | 3 | $0.30 | https://www.digikey.com/product-detail/en/te-connectivity-amp-connectors/CRG0402J10K%2F10/A106045TR-ND/2380703 | $0.002 | $0.001 | $0.001 | $0.00074/100k
16 | 68k Ohm |  | Yageo | RC0402JR-0768KL | 311-68KJRTR-ND | $0.10 | 3 | $0.30 | https://www.digikey.com/product-detail/en/yageo/RC0402JR-0768KL/311-68KJRTR-ND/726503 | $0.002 | $0.002 | $0.001 | $0.00095/100k
 | 100k Ohm |  | Yageo | RC0402JR-07100KL | 311-100KJRTR-ND | $0.10 | 3 | $0.30 | https://www.digikey.com/product-detail/en/yageo/RC0402JR-07100KL/311-100KJRTR-ND/726416 | $0.002 | $0.002 | $0.001 | $0.00095/100k
 | 1M Ohm |  | Yageo | RC0402JR-071ML | 311-1.0MJRTR-ND | $0.10 | 3 | $0.30 | https://www.digikey.com/product-detail/en/yageo/RC0402JR-071ML/311-1.0MJRTR-ND/726409 | $0.002 | $0.002 | $0.001 | $0.00095/100k
18 | 330E Ohm | 3 Resistor Array for RGB LEDs | Panasonic Electronic | EXB-38V331JV | Y9331CT-ND | $0.12 | 10 | $1.20 | http://www.digikey.com/product-detail/en/panasonic-electronic-components/EXB-38V331JV/Y9331TR-ND/256525 | $0.012 | $0.007 | $0.006 | $0.00508/125k
19 | 10k Ohm Potentiometer | Continuous Rotation Pot | Panasonic Electronic | EVW-AE4001B14 | P12426TR-ND | $1.50 | 10 | $15.00 | http://www.digikey.com/product-detail/en/panasonic-electronic-components/EVW-AE4001B14/P12426TR-ND/637161 | $0.750 | $0.675 | $0.642 | $0.61/125k
20 | 0.1uF Capacitor | Harmonic Filtering, ESP8266 Power Supply | Murata Electronics | GRM188R71C104KA01D | 490-1532-6-ND | $0.10 | 3 | $0.30 | http://www.digikey.com/product-detail/en/murata-electronics-north-america/GRM188R71C104KA01D/490-1532-2-ND/587060 | $0.005 | $0.004 | $0.003 | $0.00215/100k
21 | 10uF | Harmonic Filtering | Murata Electronics | GRM219R60J106KE19D | 490-3340-2-ND | $0.15 | 2 | $0.30 | http://www.digikey.com/product-detail/en/murata-electronics-north-america/GRM219R60J106KE19D/490-3340-2-ND/702604 | $0.029 | $0.023 | $0.200 | $0.01431/100k
22 | 470uF Capacitor | Motor Feed, Power On Functionality | Nichicon | UWT1C471MNL1GS | 493-2181-2-ND | $0.60 | 2 | $1.20 | http://www.digikey.com/product-detail/en/nichicon/UWT1C471MNL1GS/493-2181-2-ND/589922 | $0.159 | $0.140 | $0.129 | $0.12168/50k
 |  |  |  |  |  |  |  | $0.00
 |  |  |  |  |  |  |  | $0.00
 |  |  |  |  |  |  |  | $0.00
 |  |  |  |  |  |  |  | $0.00
 |  |  |  |  |  |  |  | $0.00
 |  |  |  |  |  |  |  | $0.00
 |  |  |  |  |  |  |  | $0.00
 |  |  |  |  |  |  |  | $0.00
 |  |  |  |  |  |  |  | $0.00
 |  |  |  |  |  |  |  | $0.00
 |  |  |  |  |  |  |  | $0.00
 |  |  |  |  |  |  |  | $0.00
 |  |  |  |  |  |  |  | $0.00
 |  |  |  |  |  |  |  | $0.00
 |  |  |  |  |  |  |  | $0.00
 |  |  |  |  |  |  |  | $0.00
 |  |  |  |  |  |  |  | $0.00
 |  |  |  |  |  |  |  | $0.00
 |  |  |  |  |  |  |  | $0.00
 |  |  |  |  |  |  |  | $0.00
 |  |  |  |  |  |  |  | $0.00
 |  |  |  |  |  |  |  | $0.00
 |  |  |  |  |  |  |  | $0.00
 |  |  |  |  |  |  |  | $0.00
 |  |  |  |  |  |  |  | $0.00
 |  |  |  |  |  |  |  | $0.00
 |  |  |  |  |  |  |  | $0.00
 |  |  |  |  |  |  |  | $0.00
 |  |  |  |  |  |  |  | $0.00
 |  |  |  |  |  |  |  | $0.00
 |  |  |  |  |  |  |  | $0.00
 |  |  |  |  |  |  |  | $0.00
 |  |  |  |  |  |  |  | $0.00
 |  |  |  |  |  |  |  | $0.00
 |  |  |  |  |  |  |  | $0.00
 |  |  |  |  |  |  |  | $0.00
 |  |  |  |  |  |  |  | $0.00
 |  |  |  |  |  |  |  | $0.00
 |  |  |  |  |  |  |  | $0.00
 |  |  |  |  |  |  |  | $0.00
 |  |  |  |  |  |  |  | $0.00
 |  |  |  |  |  |  |  | $0.00
 |  |  |  |  |  |  |  | $0.00
 |  |  |  |  |  |  |  | $0.00
 |  |  |  |  |  |  |  | $0.00
 |  |  |  |  |  |  |  | $0.00
 |  |  |  |  |  |  |  | $0.00
 |  |  |  |  |  |  |  | $0.00
 |  |  |  |  |  |  |  | $0.00
 |  |  |  |  |  |  |  | $0.00
 |  |  |  |  |  |  |  | $0.00
 |  |  |  |  |  |  |  | $0.00
 |  |  |  |  |  |  |  | $0.00
 |  |  |  |  |  |  |  | $0.00
 |  |  |  |  |  |  |  | $0.00
 |  |  |  |  |  |  |  | $0.00
 |  |  |  |  |  |  |  | $0.00
 |  |  |  |  |  |  |  | $0.00
 |  |  |  |  |  |  |  | $0.00
 |  |  |  |  |  |  |  | $0.00
 |  |  |  |  |  |  |  | $0.00
 |  |  |  |  |  |  |  | $0.00
 |  |  |  |  |  |  |  | $0.00
 |  |  |  |  |  |  |  | $0.00
 |  |  |  |  |  |  |  | $0.00
 |  |  |  |  |  |  |  | $0.00
 |  |  |  |  |  |  |  | $0.00
 |  |  |  |  |  |  |  | $0.00
 |  |  |  |  |  |  |  | $0.00
 |  |  |  |  |  |  |  | $0.00
 |  |  |  |  |  |  |  | $0.00
 |  |  |  |  |  |  |  | $0.00
 |  |  |  |  |  |  |  | $0.00
 |  |  |  |  |  |  |  | $0.00
 |  |  |  |  |  |  |  | $0.00
 |  |  |  |  |  |  |  | $0.00
 |  |  |  |  |  |  |  | $0.00
 |  |  |  |  |  |  |  | $0.00
 |  |  |  |  |  |  |  | $0.00
 |  |  |  |  |  |  |  | $0.00
 |  |  |  |  |  |  |  | $0.00
 |  |  |  |  |  |  |  | $0.00
 |  |  |  |  |  |  |  | $0.00
 |  |  |  |  |  |  |  | $0.00
 |  |  |  |  |  |  |  | $0.00
 |  |  |  |  |  |  |  | $0.00
 |  |  |  |  |  |  |  | $0.00
 |  |  |  |  |  |  |  | $0.00
 |  |  |  |  |  |  |  | $0.00
 |  |  |  |  |  |  |  | $0.00
 |  |  |  |  |  |  |  | $0.00
 |  |  |  |  |  |  |  | $0.00
 |  |  |  |  |  |  |  | $0.00
 |  |  |  |  |  |  |  | $0.00
 |  |  |  |  |  |  |  | $0.00
 |  |  |  |  |  |  |  | $0.00
 |  |  |  |  |  |  |  | $0.00
 |  |  |  |  |  |  |  | $0.00
 |  |  |  |  |  |  |  | $0.00
 |  |  |  |  |  |  |  | $0.00
 |  |  |  |  |  |  |  | $0.00
 |  |  |  |  |  |  |  | $0.00
 |  |  |  |  |  |  |  | $0.00
 |  |  |  |  |  |  |  | $0.00
 |  |  |  |  |  |  |  | $0.00
 |  |  |  |  |  |  |  | $0.00
 |  |  |  |  |  |  |  | $0.00
 |  |  |  |  |  |  |  | $0.00
 |  |  |  |  |  |  |  | $0.00
 |  |  |  |  |  |  |  | $0.00
 |  |  |  |  |  |  |  | $0.00
 |  |  |  |  |  |  |  | $0.00
 |  |  |  |  |  |  |  | $0.00
 |  |  |  |  |  |  |  | $0.00
 |  |  |  |  |  |  |  | $0.00
 |  |  |  |  |  |  |  | $0.00
 |  |  |  |  |  |  |  | $0.00
 |  |  |  |  |  |  |  | $0.00
 |  |  |  |  |  |  |  | $0.00

Sheet: flex sensor calc
Flex Sensor Min [kOhm] | Flex Sensor Max [kOhm] | Supply Voltage [V] | Pull Up Resistor [kOhm] | Min Voltage [V] | Max Voltage [V] | Current Draw [mA] | Pull Down Resistor [kOhm] | Min Voltage [V] | Max Voltage [V] | Current Draw [mA]
15 | 200 | 3.3 | 500 | 0.09611650485 | 0.9428571429 | 0.00640776699 | 7.68 | 1.117460317 | 0.1220338983 | 0.1455026455
 |  |  |  | Difference | 0.846740638 |  |  | Difference | 0.9954264192

Sheet: Soft Latch
Vbatt(High) | Vbatt(Low) | I_b(max) | I_b(min)

Sheet: LED
Bottom Facing LED |  |  |  | Top Facing LED
Pin | MDK/CBD/DG | Wavelength | Color | Pin | DG/CBD/ME | Wavelength | Color
1 | MDK | 630 | Red | 1 | ME | 630 | Red
2 | CA | - | - | 2 | CA | - | -
3 | CBD | 475 | Blue | 3 | CBD | 475 | Blue
4 | DG | 520 | Green | 4 | DG | 520 | Green
CA 2 |  |  | 1 Red | Blue 3 |  |  | 4 Green
Blue 3 |  |  | 4 Green | CA 2 |  |  | 1 Red
 | Bottom |  |  |  | Top

Sheet: Module Sensor
CURRENT SENSING | Current Sense Resistor [Ohm] | Max Current [A] | Max ADC Voltage [V] | Required Gain |  | Opamp-R1 [kOhm] | Non-Inverting Gain | Opamp-Rf Calculation [kOhm] |  | Opamp-R1 [kOhm] | Opamp-Rf [kOhm] | Non-Inverting Gain
 | 0.02 | 5 | 1 | 10 |  | 3 | 10 | 27 |  | 3 | 30 | 11
 |  | Test Current [A] | Gain | Output Voltage | ESP8266 Count |  | Resistor Divider R1 | Resistor Divider R2 | Voltage out
 |  | 1.5 | 11 | 0.33 |  |  | 30 | 3 | 0.3
Battery Voltage Sensing | Max Battery Voltage [V] | Max ADC Voltage [V] | Required Gain |  |  | Resistor Divider R1 | Resistor Divider R2 | Gain
 | 10 | 1 | 0.1 |  |  | 30 | 3 | 0.09090909091
Angle Sensing | Pot Max Resistance [kOhm] | Supply Voltage [V] | ADC Max Read [V] | Gain Required |  | Resistor Divider R1 [kOhm] | Resistor R2 Calculated [kOhm] | Resistor R2 Used [kOhm] | Total Resistance [kOhm] | Total Current [mA] | Power Dissipation [mW]
 | 10 | 3.3 | 1 | 0.303030303 |  | 20 | 66.66666667 | 68 | 28.71794872 | 0.1149107143 | 0.3792053571
 |  | ----------------Vdd------------- | R1 | R3 | ----------Gnd-------
 |  |  |  | R2 || Rpot=10k
Angle Sensing | Pot Max Resistance [kOhm] | Supply Voltage [V] | ADC Max Read [V] | Gain Required |  |  | Resistor R1 Calculated [kOhm] | Resistor R1 Used [kOhm] | Total Resistance [kOhm] | Total Current [mA] | Power Dissipation [mW] | Max Voltage [V]
 | 10 | 3.3 | 1 | 0.303030303 |  |  | 23 | 30 | 40 | 0.0825 | 0.27225 | 0.825
 |  | ---------------Vdd------------- | R1 | Rpot | -----------Gnd-----
Power On Functionality | Resistor [kOhm] | Capacitor [uF] | Supply Voltage [V] | Transistor Bias Voltage Vbe=[V] | Off Time [msec]
 | 500 | 47 | 7 | 0.8 | 2851.98014
Expected cycles | Test RPM | Hours of Play per day | Factor of Safety | Application Life (days)
1000000 | 50 | 2 | 1.2 | 138.8888889
