ZeroUI/Industrial-Quark/Ziro-master/Electronics/V1.0 Bluetooth/Hardware/Component Orders/AC BOM-Assembly.xls

Part | Description | Device | Ordering Info
 |  |  | Vendor | Part Number | Link | MFG | MFG PN
C1, C2, C3 | CAP, 10uF-25V-10%(EIA3216) | 10UF-16V-10%(TANT) | Sparkfun | 1124 | https://www.sparkfun.com/products/11244 | Sparkfun | 1124
C4, C5, C6, C8, C9, C10, C14 | CAP 0.1UF-25V-10%(0603) | 0.1UF-25V-10%(0603) | Digikey | 490-1532-6-ND | http://www.digikey.com/product-detail/en/GRM188R71C104KA01D/490-1532-6-ND/615587 | Murata Electronics North America | GRM188R71C104KA01D
C11 | CAP 10NF-25V-5%(0603) | 0.1UF-25V-5%(0603) | Digikey | 490-7213-2-ND | http://www.digikey.com/product-detail/en/GRM188R71H103KA01J/490-7213-2-ND/2612525 | Murata Electronics North America | GRM188R71H103KA01J
C13 | CAP 2.2NF-50V-5%(0603) | 0.1UF-25V-5%(0603) | Digikey | 490-1459-1-ND | http://www.digikey.com/product-detail/en/GRM1885C1H222JA01D/490-1459-1-ND/587663 | Murata Electronics North America | GRM1885C1H222JA01D
D1 | DIODE-SOD523 | PMEG3005EB | Digikey | 568-7397-6-ND | http://www.digikey.com/product-detail/en/PMEG3005EB,115/568-7397-6-ND/2697626 | NXP Semiconductors | PMEG3005EB,115
D2 | LED, SMD1206, Green | LED1206-BOTTOM | Sparkfun | 12622 | https://www.sparkfun.com/products/12622 | Sparkfun | 12622
D6 | LED, 3mm thro hole, Green | LED3MM | Digikey | P607-ND | http://www.digikey.com/product-detail/en/LN38GCPX/P607-ND/644227 | Panasonic Electronic Components (http://digikey.com/Suppliers/us/Panasonic-Electronic-Components.page?lang=en) | LN38GCPX
D7 | LED, 3mm thro hole, Red | LED3MM | Digikey | P563-ND | http://www.digikey.com/product-detail/en/LN28RPX/P563-ND/410780 | Panasonic Electronic Components (http://digikey.com/Suppliers/us/Panasonic-Electronic-Components.page?lang=en) | LN28RPX
IC1 | SOT23-5 | MCP73831 | Digikey | MCP73831T-2ACI/OTCT-ND | http://www.digikey.com/product-detail/en/MCP73831T-2ACI%2FOT/MCP73831T-2ACI%2FOTCT-ND/1979802 | Microchip Technology | MCP73831T-2ACI/OT
IC2 | SOT223 | AZ1117CH-3.3TRG1 | Digikey | AZ1117CH-3.3TRG1DICT-ND | http://www.digikey.com/product-detail/en/AZ1117CH-3.3TRG1/AZ1117CH-3.3TRG1DICT-ND/4505206 | Diodes Incorporated | AZ1117CH-3.3TRG1
IC3 |  | RF22301 | Mouser Electronics | 975-RFD22301 | http://www.mouser.com/ProductDetail/RF-Digital/RFD22301/ | RF Digital Wireless | RFD22301
IC4 | SSOP24 | MUX-74HC4067SMD | Sparkfun | CD74HC4067 | https://www.sparkfun.com/products/299 | Sparkfun | CD74HC4067
IC5 | QFN24-4x4 | MPU-6050 | Digikey | 1428-1007-1-ND | http://www.digikey.com/product-detail/en/MPU-6050/1428-1007-1-ND/4038010 | InvenSense | MPU-6050
JP3 | USB-MICRO-MOLEX-105017-0001 | UCB-MICRO-5pin | Digikey | 609-4616-1-ND | http://www.digikey.com/product-detail/en/10118193-0001LF/609-4616-1-ND/2785380 | FCI | 10118193-0001LF
R1, R4, R8, R9 | RES 10K, 0402, 2% | R-EU_R0402 | Digikey | RHM10.0KCDCT-ND | http://www.digikey.com/product-detail/en/MCR01MRTF1002/RHM10.0KCDCT-ND/2796414 | Rohm Semiconductor | MCR01MRTF1002
R2, R3 | RES 27E, 0603, 2% | R-EU_R0603 | Digikey | 1276-4517-1-ND | http://www.digikey.com/product-detail/en/RC1608F270CS/1276-4517-1-ND/3967489 | Samsung Electro-Mechanics America, Inc | RC1608F270CS
R6 | 4 RES Array, 330E, 1206, 2% | RESISTOR-ARRAY0603-ARV | Digikey | Y9331CT-ND | http://www.digikey.com/product-detail/en/EXB-38V331JV/Y9331CT-ND/256586 | Panasonic Electronic Components | EXB-38V331JV
R7, R10 | 4 RES Array, 150K, 0603, 2% | RESISTOR-ARRAY0603-ARV | Digikey | Y4154CT-ND | http://www.digikey.com/product-detail/en/EXB-V8V154JV/Y4154CT-ND/155185 | Panasonic Electronic Components | EXB-V8V154JV
S1 | SPDT | SWITCH-SLIDE | Digikey | 401-2000-ND | http://www.digikey.com/product-detail/en/JS202011AQN/401-2000-ND/1640096 | C&K Components | JS202011AQN
U1 | SSOP20_L | FT231XS | Digikey | 768-1129-1-ND | http://www.digikey.com/product-detail/en/FT231XS-R/768-1129-1-ND/3029151 | FTDI, Future Technology Devices International Ltd | FT231XS-R
X1 | SM06B-SRSS-TB | SM06B-SRSS-TB | Sparkfun | PRT-10210 | https://www.sparkfun.com/products/10210 | Sparkfun | PRT-10210
