ZeroUI/Industrial-Quark/Ziro-master/Electronics/V1.0 Bluetooth/Hardware/Component Orders/BOM-1.xlsx

Nikhil Jali | njali@purdue.edu
2015-04-19
Items Needed
Item | Use | Qty | Unit Price | Total Cost | Vendor | Part Number | Links
Magnification Station | For soldering SMD components | 1 | 20.090 | $20.09 | Amazon |  | http://www.amazon.com/GadgetZone-Soldering-Illuminated-Magnifying-Adjustable/dp/B00GSEX8K6?s=industrial
Soldering Tips | Soldering | 1 | 10.490 | $10.49 | Amazon |  | http://www.amazon.com/Baitaihem-12pcs-Solder-Soldering-Station/dp/B00KYVV9DM?s=industrial
MPU6050 | Accelerometer | 2 | 10.830 | $21.66 | Digikey | 1428-1007-1-ND | http://www.digikey.com/product-detail/en/MPU-6050/1428-1007-1-ND/4038010
150kohm Resistor | Resistor Array for flex sensor bias | 4 | 0.330 | $1.32 | Digikey | 4608X-1-224LF-ND | http://www.digikey.com/product-detail/en/4608X-101-224LF/4608X-1-224LF-ND/1060603
Slide Switch | Switch For Glove | 2 | 0.440 | $0.88 | Digikey | 401-2002-1-ND | http://www.digikey.com/product-detail/en/JS202011SCQN/401-2002-1-ND/1640098 | Slide Switch | Glove Power On/Off | 3 | 0.950 | $2.85 | Sparkfun | COM-10860 | https://www.sparkfun.com/products/10860
MCP73831 | Battery Mgmt IC | 6 | 0.670 | $4.02 | Digikey | MCP73831T-2ACI/OTCT-ND | http://www.digikey.com/product-detail/en/MCP73831T-2ACI%2FOT/MCP73831T-2ACI%2FOTCT-ND/1979802
10k Resistor | Resistors for Battery Mgmt IC | 20 | 0.013 | $0.26 | Digikey | MCP73831T-2ACI/OTCT-ND | http://www.digikey.com/product-detail/en/MCR01MRTF1002/RHM10.0KCDCT-ND/2796414
Switch | Pushbutton | 5 | 6.130 | $30.65 | Digikey |  | http://www.digikey.com/product-detail/en/ELUMEETHQ6C12/CKN9040-ND/806010
USB micro | Connector | 6 | 1.060 | $6.36 | Digikey |  | http://www.digikey.com/product-detail/en/1051330001/WM9734CT-ND/4037910 | USB Micro Connector | USB connector | 6 | 0.433 | $2.60 | Digikey | 609-4616-1-ND | http://www.digikey.com/product-detail/en/10118193-0001LF/609-4616-1-ND/2785380
100nF/0.1uF Capacitor | Capacitor | 50 | 0.010 | $0.51 | Digikey |  | http://www.digikey.com/product-detail/en/GRM188R71C104KA01D/490-1532-6-ND/615587
Switch | Pushbutton | 5 | 3.470 | $17.35 | Element14 |  | http://www.newark.com/te-connectivity-alcoswitch/tp11cgra204/switch-pushbutton-spst-no-20v/dp/69K7044
M2 Bolt | For holding module PCB | 1 | 4.760 | $4.76 | McMaster-Carr | 92000A019 | http://www.mcmaster.com/#machine-screws/=x9m6i4
Rfduino | Bluetooth module | 6 | 14.990 | $89.94 | Mouser Electronics | 975-RFD22301 | http://www.mouser.com/ProductDetail/RF-Digital/RFD22301/
3.3V Regulator | Voltage Regulator | 15 | 0.479 | $7.18 | Mouser Electronics | 595-UA78M33CDCYR | http://www.mouser.com/ProductDetail/Texas-Instruments/UA78M33CDCYR/
10uF Capacitor | Harmonic Filtering | 2 | 11.950 | $23.90 | Sparkfun | 1124 | https://www.sparkfun.com/products/11244
16 Channel Multiplexer | ADC interface to sensors | 2 | 0.950 | $1.90 | Sparkfun | CD74HC4067 | https://www.sparkfun.com/products/299
RGB LED | LED lights | 8 | 0.500 | $4.00 | Sparkfun | 10866 | https://www.sparkfun.com/products/10866
SMD LED - Green 1206 | LED lights | 1 | 4.950 | $4.95 | Sparkfun | 12622 | https://www.sparkfun.com/products/12622
Tall Push button | Button for motor module | 3 | 0.500 | $1.50 | Sparkfun | 8605 | https://www.sparkfun.com/products/8605
StepUp Down Charger |  | 10 | 1.950 | $19.50 | Sparkfun | MC34063A | https://www.sparkfun.com/products/317
USB to Serial IC | USB-RS232 | 6 | 4.500 | $27.00 | Sparkfun | FT232RL | https://www.sparkfun.com/products/650 | FT231XS-R | USB-RS232 Converter | 6 | 2.120 | $12.72 | Digikey | 768-1129-1-ND | http://www.digikey.com/product-detail/en/FT231XS-R/768-1129-1-ND/3029151
Total |  |  |  | $298.23
