ZeroUI/Industrial-Quark/Ziro-master/Electronics/V1.0 Bluetooth/Hardware/Component Orders/BOM-2.xlsx

Nikhil Jali | njali@purdue.edu
2015-05-25
Items Needed
Item | Use | Qty | Unit Price | Total Cost | Vendor | Part Number | Links
Slide Switch | Glove Power On/Off | 3 | 0.950 | $2.85 | Sparkfun | COM-10860 | https://www.sparkfun.com/products/10860
FT231XS-R | USB-RS232 Converter | 6 | 2.120 | $12.72 | Digikey | 768-1129-1-ND | http://www.digikey.com/product-detail/en/FT231XS-R/768-1129-1-ND/3029151
330E Resistor | for LED interface | 3 | 0.120 | $0.36 | Digikey | Y9331CT-ND | http://www.digikey.com/product-detail/en/EXB-38V331JV/Y9331CT-ND/256586
27ohm Resistor | for USB interface | 10 | 0.130 | $1.30 | Digikey | 1276-4517-1-ND | http://www.digikey.com/product-detail/en/RC1608F270CS/1276-4517-1-ND/3967489
150k Resistor Array | for LED interface | 4 | 0.200 | $0.80 | Digikey | Y4154CT-ND | http://www.digikey.com/product-detail/en/EXB-V8V154JV/Y4154CT-ND/155185
Diode | for USB interface | 6 | 0.510 | $3.06 | Digikey | 568-7397-6-ND | http://www.digikey.com/product-detail/en/PMEG3005EB,115/568-7397-6-ND/2697626
2200pF Capacitor | I2C interface | 4 | 0.120 | $0.48 | Digikey | 490-1459-1-ND | http://www.digikey.com/product-detail/en/GRM1885C1H222JA01D/490-1459-1-ND/587663
USB Micro Connector | USB connector | 6 | 0.433 | $2.60 | Digikey | 609-4616-1-ND | http://www.digikey.com/product-detail/en/10118193-0001LF/609-4616-1-ND/2785380
Total |  |  |  | $24.17
