ZeroUI/Industrial-Quark/Ziro-master/Electronics/V1.0 Bluetooth/Hardware/Component Orders/BOM-3.xlsx

Nikhil Jali | njali@purdue.edu
2015-05-25
Items Needed
Item | Use | Qty | Unit Price | Total Cost | Vendor | Part Number | Links
3.3V Regulator | Voltage Regulation | 10 | 0.310 | $3.10 | Digikey | AZ1117CH-3.3TRG1DICT-ND | http://www.digikey.com/product-detail/en/AZ1117CH-3.3TRG1/AZ1117CH-3.3TRG1DICT-ND/4505206
Diode | for USB interface | 25 | 0.296 | $7.40 | Digikey | 568-7397-6-ND | http://www.digikey.com/product-detail/en/PMEG3005EB,115/568-7397-6-ND/2697626
75ohm Resistor Array | for LED interface | 4 | 0.150 | $0.60 | Digikey | Y10750CT-ND | http://www.digikey.com/product-detail/en/EXB-N8V750JX/Y10750CT-ND/671793
Switch | For Glove | 4 | 0.390 | $1.56 | Digikey | 401-2000-ND | http://www.digikey.com/product-detail/en/JS202011AQN/401-2000-ND/1640096
Total |  |  |  | $12.66
