ZeroUI/Industrial-Quark/Ziro-master/Electronics/V1.0 Bluetooth/Hardware/Component Orders/BOM-4.xlsx

Nikhil Jali | njali@purdue.edu
2015-05-25
FT231XS-R | USB-RS232 Converter | 15 | 2.120 | $31.80 | Digikey | 768-1129-1-ND | http://www.digikey.com/product-detail/en/FT231XS-R/768-1129-1-ND/3029151
2200pF Capacitor | I2C interface | 20 | 0.120 | $2.40 | Digikey | 490-1459-1-ND | http://www.digikey.com/product-detail/en/GRM1885C1H222JA01D/490-1459-1-ND/587663
USB Micro Connector | USB connector | 10 | 0.433 | $4.33 | Digikey | 609-4616-1-ND | http://www.digikey.com/product-detail/en/10118193-0001LF/609-4616-1-ND/2785380
100nF/0.1uF Capacitor | Capacito | 50 | 0.010 | $0.51 | Digikey | 490-1532-6-ND | http://www.digikey.com/product-detail/en/GRM188R71C104KA01D/490-1532-6-ND/615587
75ohm Resistor Array | for LED interface | 10 | 0.150 | $1.50 | Digikey | Y9820CT-ND | http://www.digikey.com/product-detail/en/EXB-38V820JV/Y9820CT-ND/256579
10uF Capacitor | Harmonic Filtering | 2 | 11.950 | $23.90 | Sparkfun | 1124 | https://www.sparkfun.com/products/11244
3.3V Regulator | Voltage Regulation | 15 | 0.310 | $4.65 | Digikey | AZ1117CH-3.3TRG1DICT-ND | http://www.digikey.com/product-detail/en/AZ1117CH-3.3TRG1/AZ1117CH-3.3TRG1DICT-ND/4505206
Diode | for USB interface | 25 | 0.296 | $7.40 | Digikey | 568-7397-6-ND | http://www.digikey.com/product-detail/en/PMEG3005EB,115/568-7397-6-ND/2697626
330E Resistor | for LED interface | 20 | 0.120 | $2.40 | Digikey | Y9331CT-ND | http://www.digikey.com/product-detail/en/EXB-38V331JV/Y9331CT-ND/256586
