ZeroUI/Industrial-Quark/Ziro-master/Electronics/V1.0 Bluetooth/Hardware/Component Orders/BOM-5.xlsx

Nikhil Jali | njali@purdue.edu
2015-05-25
Items Needed
Item | Use | Qty | Unit Price | Total Cost | Vendor | Part Number | Links
LiPo Battery | Glove PCB | 2 | 32.680 | $65.36 | Amazon | ZX-6000 | http://www.amazon.com/Exell-Battery-Microsoft-LifeChat-X808059-003/dp/B00TUCDI6W
6pin wires | Module/Glove Interface | 20 | 1.500 | $30.00 | Sparkfun | PRT-10361 | https://www.sparkfun.com/products/10361
6pin Connector | Module/Glove Interface | 20 | 0.950 | $19.00 | Sparkfun | PRT-10210 | https://www.sparkfun.com/products/10210
27ohm Resistor | for USB interface | 80 | 0.130 | $10.40 | Digikey | 1276-4517-1-ND | http://www.digikey.com/product-detail/en/RC1608F270CS/1276-4517-1-ND/3967489
MPU6050 | Accelerometer | 2 | 10.830 | $21.66 | Digikey | 1428-1007-1-ND | http://www.digikey.com/product-detail/en/MPU-6050/1428-1007-1-ND/4038010
Rfduino | Bluetooth module | 6 | 14.990 | $89.94 | Mouser Electronics | 975-RFD22301 | http://www.mouser.com/ProductDetail/RF-Digital/RFD22301/
Total |  |  |  | $124.76
