ZeroUI/Industrial-Quark/Ziro-master/Electronics/V1.0 Bluetooth/Hardware/Component Orders/BOM-6 (RFduino_MPU) - Copy.xlsx

Nikhil Jali | njali@purdue.edu
2015-05-25
Items Needed
Item | Use | Qty | Unit Price | Total Cost | Vendor | Part Number | Links
27ohm Resistor | for USB interface | 20 | 0.130 | $2.60 | Digikey | 1276-4517-1-ND | http://www.digikey.com/product-detail/en/RC1608F270CS/1276-4517-1-ND/3967489
MPU6050 | Accelerometer | 3 | 12.950 | $38.85 | Sparkfun | 1428-1007-1-ND | https://www.sparkfun.com/products/10937
Rfduino | Bluetooth module | 3 | 14.990 | $44.97 | Mouser Electronics | 975-RFD22301 | http://www.mouser.com/ProductDetail/RF-Digital/RFD22301/
Total |  |  |  | $86.42
