ZeroUI/Industrial-Quark/Ziro-master/Electronics/V1.0 Bluetooth/Hardware/Component Orders/BOM-7.xlsx

Nikhil Jali | njali@purdue.edu
2015-06-22
Items Needed
Item | Use | Qty | Unit Price | Total Cost | Vendor | Part Number | Links
6 pin connector | For Glove Module | 6 | 0.950 | $5.70 | Sparkfun | PRT-10210 | https://www.sparkfun.com/products/10210
6 pin wire jumper assemble | For Glove MOdule | 6 | 1.500 | $9.00 | Sparkfun | PRT-10361 | https://www.sparkfun.com/products/10361
Analog Multiplexer | For Glove Module | 3 | 0.950 | $2.85 | Sparkfun | PRT-00299 | https://www.sparkfun.com/products/299
MPU6050 | For Glove Module | 2 | 12.950 | $25.90 | Sparkfun | PRT-10937 | https://www.sparkfun.com/products/10937
150kohm Resistor | Resistor Array for flex sensor bias | 4 | 0.330 | $1.32 | Digikey | 4608X-1-224LF-ND | http://www.digikey.com/product-detail/en/4608X-101-224LF/4608X-1-224LF-ND/1060603
Total |  |  |  | $43.45
 |  |  |  |  |  |  | https://www.sparkfun.com/products/10361
