ZeroUI/Industrial-Quark/Ziro-master/Electronics/V1.0 Bluetooth/Hardware/Component Orders/Main-BOM.xlsx

Sheet: Glove Module
Handimate BOM
Glove Module
Item | Use | Qty | Unit Price | Total Cost | Vendor | Part Number | Links | Unit Cost for 500pieces | Sub-Cost
PCB |  | 1 |  | $0.00 | Advanced Circuits |  | www.4pcb.com
Rfduino | Bluetooth Module | 1 | 14.99 | $14.99 | Mouser Electronics | 975-RFD22301 | http://www.mouser.com/ProductDetail/RF-Digital/RFD22301/ | $12.7900 | $12.7900
MPU6050 | Accelerometer | 1 | 10.830 | $10.83 | Digikey | 1428-1007-1-ND | http://www.digikey.com/product-detail/en/MPU-6050/1428-1007-1-ND/4038010 | $5.6990 | $5.6990
150k Resistor Array | for LED interface | 2 | 0.200 | $0.40 | Digikey | Y4154CT-ND | http://www.digikey.com/product-detail/en/EXB-V8V154JV/Y4154CT-ND/155185 | $0.0317 | $0.0634
MCP73831 | Battery Mgmt IC | 1 | 0.670 | $0.67 | Digikey | MCP73831T-2ACI/ | http://www.digikey.com/product-detail/en/MCP73831T-2ACI%2FOT/MCP73831T-2ACI%2FOTCT-ND/1979802 | $0.4200 | $0.4200
100nF/0.1uF Capacitor | Capacitor | 8 | 0.010 | $0.08 | Digikey | 490-1532-6-ND | http://www.digikey.com/product-detail/en/GRM188R71C104KA01D/490-1532-6-ND/615587 | $0.0060 | $0.0480
10uF Capacitor | Harmonic Filtering | 5 | 0.150 | $0.75 | Digikey | 490-3340-1-ND | http://www.digikey.com/product-detail/en/GRM219R60J106KE19D/490-3340-1-ND/702881 | $0.0352 | $0.1759
16 Channel Multiplexer | ADC interface to sensors | 1 | 0.95 | $0.95 | Sparkfun | CD74HC4067 | https://www.sparkfun.com/products/299 | $0.8600 | $0.8600
FT231XS-R | USB-RS232 Converter | 1 | 2.12 | $2.12 | Digikey | 768-1129-1-ND | http://www.digikey.com/product-detail/en/FT231XS-R/768-1129-1-ND/3029151 | $1.6000 | $1.6000
27ohm Resistor | for USB interface | 2 | 0.13 | $0.26 | Digikey | 1276-4517-1-ND | http://www.digikey.com/product-detail/en/RC1608F270CS/1276-4517-1-ND/3967489 | $0.0029 | $0.0057
2200pF Capacitor | I2C interface | 1 | 0.120 | $0.12 | Digikey | 490-1459-1-ND | http://www.digikey.com/product-detail/en/GRM1885C1H222JA01D/490-1459-1-ND/587663 | $0.0281 | $0.0281
USB Micro Connector | USB connector | 1 | 0.460 | $0.46 | Digikey | 609-4616-1-ND | http://www.digikey.com/product-detail/en/10118193-0001LF/609-4616-1-ND/2785380 | $0.2599 | $0.2599
Slide Switch | Glove Power On/Off | 1 | 0.950 | $0.95 | Sparkfun | COM-10860 | https://www.sparkfun.com/products/10860 | $0.8600 | $0.8600
330E Resistor | for LED interface | 2 | 0.120 | $0.24 | Digikey | Y9331CT-ND | http://www.digikey.com/product-detail/en/EXB-38V331JV/Y9331CT-ND/256586 | $0.0187 | $0.0374
3.3V Regulator | Voltage Regulation | 1 | 0.450 | $0.45 | Digikey | AZ1117CH-3.3TRIG | http://www.digikey.com/product-detail/en/AZ1117CH-3.3TRG1/AZ1117CH-3.3TRG1DICT-ND/4505206 | $0.1235 | $0.1235
Diode | for USB interface | 1 | 0.296 | $0.30 | Digikey | 568-7397-6-ND | http://www.digikey.com/product-detail/en/PMEG3005EB,115/568-7397-6-ND/2697626 | $0.1399 | $0.1399
Switch | Power Turn-On | 1 | 0.410 | $0.41 | Digikey | 401-2000-ND | http://www.digikey.com/product-detail/en/JS202011AQN/401-2000-ND/1640096 | $0.2723 | $0.2723
Red LED | Gesture Indication | 1 | 0.410 | $0.41 | Digikey | 516-1291-ND | http://www.digikey.com/product-detail/en/HLMP-1301/516-1291-ND/637555 | $0.1380 | $0.1380
Green LED | Power Indication | 1 | 0.540 | $0.42 | Digikey | 516-1293-ND | http://www.digikey.com/product-detail/en/HLMP-1503/516-1293-ND/637557 | $0.1476 | $0.1476
 |  |  | Total | $34.81 |  |  |  | Total per unit for 500 pieces | $23.6687

Sheet: Motor Module
Motor Module
Item | Use | Qty | Unit Price | Total Cost | Vendor | Part Number | Links | Unit cost for 500pieces | Sub-total for 500pieces
PCB |  | 1 |  | $0.00 | Advanced Circuits |  | www.4pcb.com | 0 | 0
100nF/0.1uF Capacitor | Capacitor | 5 | 0.019 | $0.10 | Digikey | 490-1532-6-ND | http://www.digikey.com/product-detail/en/GRM188R71C104KA01D/490-1532-6-ND/615587 | 0.006 | 0.03
10uF Capacitor | Harmonic Filtering | 3 | 0.150 | $0.45 | Digikey | 490-3340-1-ND | http://www.digikey.com/product-detail/en/GRM219R60J106KE19D/490-3340-1-ND/702881 | 0.03518 | 0.10554
FT231XS-R | USB-RS232 Converter | 1 | 2.12 | $2.12 | Digikey | 768-1129-1-ND | http://www.digikey.com/product-detail/en/FT231XS-R/768-1129-1-ND/3029151 | 1.6 | 1.6
27ohm Resistor | for USB interface | 2 | 0.1 | $0.20 | Digikey | 1276-4517-1-ND | http://www.digikey.com/product-detail/en/RC1608F270CS/1276-4517-1-ND/3967489 | 0.00286 | 0.00572
USB Micro Connector | USB connector | 1 | 0.460 | $0.46 | Digikey | 609-4616-1-ND | http://www.digikey.com/product-detail/en/10118193-0001LF/609-4616-1-ND/2785380 | 0.25988 | 0.25988
Switch | Pushbutton | 1 | 6.130 | $6.13 | Digikey | CKN9040-ND | http://www.digikey.com/product-detail/en/ELUMEETHQ6C12/CKN9040-ND/806010 | 4.6736 | 4.6736
Rfduino | Bluetooth Module | 1 | 14.99 | $14.99 | Mouser Electronics | 975-RFD22301 | http://www.mouser.com/ProductDetail/RF-Digital/RFD22301/ | 12.79 | 12.79
RGB LED | LED lights | 1 | 0.500 | $0.50 | Sparkfun | 10866 | https://www.sparkfun.com/products/10866 | 0.45 | 0.45
330E Resistor | for LED interface | 1 | 0.120 | $0.12 | Digikey | Y9331CT-ND | http://www.digikey.com/product-detail/en/EXB-38V331JV/Y9331CT-ND/256586 | 0.01872 | 0.01872
Diode | for USB interface | 1 | 0.296 | $0.30 | Digikey | 568-7397-6-ND | http://www.digikey.com/product-detail/en/PMEG3005EB,115/568-7397-6-ND/2697626 | $0.1399 | $0.1399
3.3V Regulator | Voltage Regulation | 1 | 0.450 | $0.45 | Digikey | AZ1117CH-3.3TRIG | http://www.digikey.com/product-detail/en/AZ1117CH-3.3TRG1/AZ1117CH-3.3TRG1DICT-ND/4505206 | $0.1235 | $0.1235
 |  |  | Total | $24.45 |  |  |  | Sub-Total for 500 Components | 19.93346
 |  | Cost for 4 Modules |  | $97.78 |  |  |  | Cost for 4 Modules | 79.73384
