ZeroUI/Industrial-Quark/Ziro-master/Electronics/V2.0 Wifi/Hardware/PCB/Component Library/seeed/Seeed-OPL-for-customer-20151021.xlsx

OPL list
Seeed SKU | MPN | Description | Category | Package | Manufacturer | Datasheet | Price（$）/pcs | Pieces/set | Solder points Qty | Assem.Cost/pcs（$） | Image URL | Distributor-URL
306010055 | FC-135 | SMD Crystal ABS07-32.768KHZ-7pF-20ppm-70K; | Crystal Oscillator | 2P-L3.2*W1.5mm | Xinhunjing | http://www.seeedstudio.com/wiki/images/7/78/306010055.pdf | 0.350 | 5 | 4 | 0.40 |  | http://www.seeedstudio.com/depot/OPLopen-parts-library-catalog-c-136_138/#306010055
306010005 | 49S | DIP Crystal 25MHz-20pF-20ppm;HC49US | Crystal Oscillator | HC49US | Xinhunjing | http://www.seeedstudio.com/wiki/images/5/5e/306010005.pdf | 0.150 | 10 | 2 | 0.20 |  | http://www.seeedstudio.com/depot/OPLopen-parts-library-catalog-c-136_138/#306010005
306010037 | 49S/18PF | DIP Crystal 16MHz-18pF-30ppm-50R; | Crystal Oscillator | HC49/US | Xinhunjing | http://www.seeedstudio.com/wiki/images/5/57/306010037.pdf | 0.150 | 10 | 2 | 0.20 |  | http://www.seeedstudio.com/depot/OPLopen-parts-library-catalog-c-136_138/#306010037
306010054 | X053201602002 | SMD 16MHz-8pF-20ppm-40R | Crystal Oscillator | 2P-SMD-5.0X3.2 | JINGPENGYUAN | http://www.seeedstudio.com/wiki/images/9/9f/0500290P1.pdf | 0.350 | 5 | 2 | 0.20 |  | http://www.seeedstudio.com/depot/OPLopen-parts-library-catalog-c-136_138/#0500290P1
306010047 | 5032/2P | SMD Crystal 12Mhz-20pF-20ppm-40R; | Crystal Oscillator | 2P-L5.0*W3.2mm | Xinhunjing | http://www.seeedstudio.com/wiki/images/c/c7/306010047.pdf | 0.450 | 5 | 2 | 0.20 |  | http://www.seeedstudio.com/depot/OPLopen-parts-library-catalog-c-136_138/#306010047
306010004 | 5032/4P | SMD Crystal 8MHz-20pF-20ppm; | Crystal Oscillator | 2P-L5.0*W3.2mm | Xinhunjing | http://www.seeedstudio.com/wiki/images/9/91/306010004.pdf | 0.450 | 5 | 2 | 0.20 |  | http://www.seeedstudio.com/depot/OPLopen-parts-library-catalog-c-136_138/#306010004
306010033 | 49S8M | DIP Crystal 8MHz-20pF-20ppm-60R; | Crystal Oscillator | HC49S | Xinhunjing | http://www.seeedstudio.com/wiki/images/c/ca/306010033.pdf | 0.150 | 10 | 2 | 0.20 |  | http://www.seeedstudio.com/depot/OPLopen-parts-library-catalog-c-136_138/#306010033
305030028 | 2N7002,215 | SMD MOSFET N-CH 60V-300mA Logic Level FET; | Transistor | SOT-23 | NXP | http://www.seeedstudio.com/wiki/images/c/c6/305030028.pdf | 0.050 | 30 | 3 | 0.30 |  | http://www.seeedstudio.com/depot/OPLopen-parts-library-catalog-c-136_138/#305030028
305030015 | CJ2302 | SMD MOSFET N-CH 20V 2.1A | Transistor | SOT23 | JCET | http://www.seeedstudio.com/wiki/images/e/e7/0440200P1.pdf | 0.100 | 10 | 3 | 0.30 |  | http://www.seeedstudio.com/depot/OPLopen-parts-library-catalog-c-136_138/#0440200P1
305030018 | Si2343CDS | SMD MOSFET P-CH 30V-5.9A | Transistor | SOT-23 | Vishay Siliconix |  | 0.700 | 5 | 3 | 0.30 |  | http://www.seeedstudio.com/depot/OPLopen-parts-library-catalog-c-136_138/#305030018
305030014 | CJ2305 | SMD MOSFET P-CH -8V -4.1A | Transistor | SOT-23 | JCET | http://www.seeedstudio.com/wiki/images/a/ac/0440210P1.pdf | 0.100 | 10 | 3 | 0.30 |  | http://www.seeedstudio.com/depot/OPLopen-parts-library-catalog-c-136_138/#0440210P1
305010018 | S9013 | SMD Transistors NPN 25V-500mA | Transistor | SOT-23 | JCET | http://www.seeedstudio.com/wiki/images/6/67/0400000P1.pdf | 0.040 | 50 | 3 | 0.30 |  | http://www.seeedstudio.com/depot/OPLopen-parts-library-catalog-c-136_138/#0400000P1
305020006 | S8550 | SMD Transistors PNP 25V-500mA | Transistor | SOT-23 |  | http://www.seeedstudio.com/wiki/images/e/e5/0410030P1.pdf | 0.040 | 50 | 3 | 0.30 |  | http://www.seeedstudio.com/depot/OPLopen-parts-library-catalog-c-136_138/#0410030P1
305010017 | S8050 | SMD Transistors NPN 25V-500mW; | Transistor | SOT-23 | JCET | http://www.seeedstudio.com/wiki/images/b/ba/305010017.pdf | 0.040 | 50 | 3 | 0.30 |  | http://www.seeedstudio.com/depot/OPLopen-parts-library-catalog-c-136_138/#305010017
305010022 | S9014J6 | SMD Transistor NPN 50V-100mA; | Transistor | SOT-23 | Changjiang | http://www.seeedstudio.com/wiki/images/2/2c/305010022.pdf | 0.050 | 30 | 3 | 0.30 |  | http://www.seeedstudio.com/depot/OPLopen-parts-library-catalog-c-136_138/#305010022
312010004 | KS-12065D03YA | DIP Buzzer 3V,30mA, 2700±300Hz | Audio product | 2P-7.6-D12*H6.5mm | Guangjixing | http://www.seeedstudio.com/wiki/images/c/cb/312020003.pdf | 0.500 | 5 | 2 | 0.20 |  | http://www.seeedstudio.com/depot/OPLopen-parts-library-catalog-c-136_138/#312010004
302020027 | TAJD477M006RNJ | SMD CAP Tantalum 470uF-6.3V;D | Capacitor | AVX-D | AVX |  | 0.500 | 5 | 2 | 0.20 |  | http://www.seeedstudio.com/depot/OPLopen-parts-library-catalog-c-136_138/#302020027
302030031 |  | DIP CAP Aluminum 100uF-16V | Capacitor | Radial-D5.0*H7.0mm | JWCO | http://www.seeedstudio.com/wiki/images/1/14/302030031.pdf | 0.030 | 50 | 2 | 0.20 |  | http://www.seeedstudio.com/depot/OPLopen-parts-library-catalog-c-136_138/#302030031
302020025 | TAJC107K010RNJ | SMD CAP Tantalum 100uF-10V 10% | Capacitor | AVX-C | AVX | http://www.seeedstudio.com/wiki/images/a/ae/0130170P1.pdf | 0.200 | 10 | 2 | 0.20 |  | http://www.seeedstudio.com/depot/OPLopen-parts-library-catalog-c-136_138/#0130170P1
302020022 | TAJC476K016RNJ | SMD CAP Tantalum 47uF-16V | Capacitor | AVX-C | AVX | http://www.seeedstudio.com/wiki/images/c/c7/302020022.pdf | 0.200 | 10 | 2 | 0.20 |  | http://www.seeedstudio.com/depot/OPLopen-parts-library-catalog-c-136_138/#302020022
302020020 | TAJB476K010RNJ | SMD CAP Tantalum 47uF-10V 10% | Capacitor | AVX-B | AVX | http://www.seeedstudio.com/wiki/images/f/fb/0130180P1.pdf | 0.200 | 10 | 2 | 0.20 |  | http://www.seeedstudio.com/depot/OPLopen-parts-library-catalog-c-136_138/#0130180P1
302020005 | TAJC476K006RNJ | SMD CAP Tantalum 47uF-6.3V | Capacitor | AVX-A | AVX |  | 0.150 | 20 | 2 | 0.20 |  | http://www.seeedstudio.com/depot/OPLopen-parts-library-catalog-c-136_138/#302020005
302020026 | TAJC226K025RNJ | SMD CAP Tantalum 22uF-25V 10% 2312 | Capacitor | AVX-C | AVX | http://www.seeedstudio.com/wiki/images/f/fd/0130360P1.pdf | 0.370 | 10 | 2 | 0.20 |  | http://www.seeedstudio.com/depot/OPLopen-parts-library-catalog-c-136_138/#0130360P1
302020021 | TAJB226K010RNJ | SMD CAP Tantalum 22uF-10V 10% | Capacitor | AVX-B | AVX | http://www.seeedstudio.com/wiki/images/8/82/0130240P1.pdf | 0.130 | 20 | 2 | 0.20 |  | http://www.seeedstudio.com/depot/OPLopen-parts-library-catalog-c-136_138/#0130240P1
302010171 | CC0805MKX5R5BB226 | SMD CAP Ceramic 22uF-6.3V-20%-X5R; | Capacitor | 0805 | YAGEO |  | 0.050 | 50 | 2 | 0.20 |  | http://www.seeedstudio.com/depot/OPLopen-parts-library-catalog-c-136_138/#302010171
302010181 | CC1206KKX5R8BB106 | SMD CAP Ceramic 10uF-25V-10%-X5R | Capacitor | 1206 | YAGEO |  | 0.130 | 20 | 2 | 0.20 |  | http://www.seeedstudio.com/depot/OPLopen-parts-library-catalog-c-136_138/#302010181
302010178 | CC0805KKX5R8BB106 | SMD CAP Ceramic 10uF-25V-10%-X5R | Capacitor | 0805 | YAGEO | http://www.seeedstudio.com/wiki/images/2/20/0100080P1.pdf | 0.050 | 50 | 2 | 0.20 |  | http://www.seeedstudio.com/depot/OPLopen-parts-library-catalog-c-136_138/#0100080P1
302020019 | TAJB106K016RNJ | SMD CAP Tantalum 10uF-16V 10% | Capacitor | AVX-B | AVX | http://www.seeedstudio.com/wiki/images/f/f6/0130120P1.pdf | 0.150 | 20 | 2 | 0.20 |  | http://www.seeedstudio.com/depot/OPLopen-parts-library-catalog-c-136_138/#0130120P1
302020002 | TAJA106K016RNJ | SMD CAP Tantalum 10uF-16V 10% | Capacitor | AVX-A | AVX | http://www.seeedstudio.com/wiki/images/1/1b/0130050P1.pdf | 0.130 | 20 | 2 | 0.20 |  | http://www.seeedstudio.com/depot/OPLopen-parts-library-catalog-c-136_138/#0130050P1
302020011 | TAJA106K010RNJ | SMD CAP Tantalum 10uF-10V 10% | Capacitor | AVX-A | AVX | http://www.seeedstudio.com/wiki/images/5/59/0130040P1.pdf (http://www.seeedstudio.com/wiki/images/0/0d/302010146.pdf) | 0.130 | 20 | 2 | 0.20 |  | http://www.seeedstudio.com/depot/OPLopen-parts-library-catalog-c-136_138/#0130040P1
302010243 | CC1206KKX5R9BB475 | SMD CAP Ceramic 4.7uF-50V-10%-X5R; | Capacitor | 1206 | YAGEO |  | 0.250 | 10 | 2 | 0.20 |  | http://www.seeedstudio.com/depot/OPLopen-parts-library-catalog-c-136_138/#302010243
302010146 | CC0805KKX5R8BB475 | SMD CAP Ceramic 4.7uF-25V-10%-X5R;0805 | Capacitor | C0805 | YAGEO | http://www.seeedstudio.com/wiki/images/0/0d/302010146.pdf | 0.040 | 50 | 2 | 0.20 |  | http://www.seeedstudio.com/depot/OPLopen-parts-library-catalog-c-136_138/#302010146
302010111 | CC0603KRX5R6BB475 | SMD CAP Ceramic 4.7uF-10V-10%-X5R; | Capacitor | 0603 | YAGEO |  | 0.040 | 50 | 2 | 0.20 |  | http://www.seeedstudio.com/depot/OPLopen-parts-library-catalog-c-136_138/#302010111
302010019 | CC0402MRX5R5BB475 | SMD CAP Ceramic 4.7uF-6.3V-20%-X5R | Capacitor | 0402 | YAGEO |  | 0.200 | 10 | 2 | 0.20 |  | http://www.seeedstudio.com/depot/OPLopen-parts-library-catalog-c-136_138/#302010019
302010148 | CC0805KKX7R8BB225 | SMD CAP Ceramic 2.2uF-25V-10%-X7R;0805 | Capacitor | C0805 | YAGEO | http://www.seeedstudio.com/wiki/images/a/ac/302010056.pdf | 0.050 | 50 | 2 | 0.20 |  | http://www.seeedstudio.com/depot/OPLopen-parts-library-catalog-c-136_138/#302010148
302010179 | CC0805KKX7R8BB105 | SMD CAP Ceramic 1uF-25V-10%-X7R | Capacitor | 0805 | YAGEO | http://www.seeedstudio.com/wiki/images/8/89/0100440P1.pdf (http://www.seeedstudio.com/wiki/images/a/ac/302010056.pdf) | 0.030 | 50 | 2 | 0.20 |  | http://www.seeedstudio.com/depot/OPLopen-parts-library-catalog-c-136_138/#0100440P1
302010139 | CC0603KRX7R8BB105 | SMD CAP Ceramic 1uF-25V-10%-X7R | Capacitor | 0603 | YAGEO | http://www.seeedstudio.com/wiki/images/a/af/0100340P1.pdf (http://www.seeedstudio.com/wiki/File:302010056.pdf) | 0.015 | 100 | 2 | 0.20 |  | http://www.seeedstudio.com/depot/OPLopen-parts-library-catalog-c-136_138/#0100340P1
302010040 | CC0402KRX5R6BB105 | SMD CAP Ceramic 1uF-10V-10%-X5R | Capacitor | 0402 | YAGEO |  | 0.015 | 100 | 2 | 0.20 |  | http://www.seeedstudio.com/depot/OPLopen-parts-library-catalog-c-136_138/#302010040
302010073 | CC0603KRX7R8BB224 | SMD CAP Ceramic 220nF-25V-10%-X7R;0603 | Capacitor | 0603 | YAGEO | http://www.seeedstudio.com/wiki/images/a/ac/302010056.pdf | 0.015 | 100 | 2 | 0.20 |  | http://www.seeedstudio.com/depot/OPLopen-parts-library-catalog-c-136_138/#302010073
302010165 | CC0805KRX7R9BB104 | SMD CAP Ceramic 100nF-50V-10%-X7R; | Capacitor | 0805 | YAGEO | http://www.seeedstudio.com/wiki/File:302010056.pdf (http://www.seeedstudio.com/wiki/images/a/ac/302010056.pdf) | 0.015 | 100 | 2 | 0.20 |  | http://www.seeedstudio.com/depot/OPLopen-parts-library-catalog-c-136_138/#302010165
302010138 | CC0603KRX7R9BB104 | SMD CAP Ceramic 100nF-50V-10%-X7R | Capacitor | 0603 | YAGEO | http://www.seeedstudio.com/wiki/images/3/35/0100020P1.pdf | 0.015 | 100 | 2 | 0.20 |  | http://www.seeedstudio.com/depot/OPLopen-parts-library-catalog-c-136_138/#0100020P1
302010024 | CC0402KRX7R8BB104 | SMD CAP Ceramic 100nF-25V-10%-X7R | Capacitor | 0402 | YAGEO | http://www.seeedstudio.com/wiki/images/a/ac/302010056.pdf | 0.015 | 100 | 2 | 0.20 |  | http://www.seeedstudio.com/depot/OPLopen-parts-library-catalog-c-136_138/#302010024
302010002 | CC0402KRX7R8BB473 | SMD CAP Ceramic 47nF-25V-10%-X7R; | Capacitor | 0402 | YAGEO |  | 0.010 | 100 | 2 | 0.20 |  | http://www.seeedstudio.com/depot/OPLopen-parts-library-catalog-c-136_138/#302010002
302010088 | CC0603KRX7R9BB333 | SMD CAP Ceramic 33nF-50V-10%-X7R;0603 | Capacitor | 0603 | YAGEO | http://www.seeedstudio.com/wiki/images/a/ac/302010056.pdf | 0.015 | 100 | 2 | 0.20 |  | http://www.seeedstudio.com/depot/OPLopen-parts-library-catalog-c-136_138/#302010088
302010095 | CC0603KRX7R9BB223 | SMD CAP Ceramic 22nF-50V-10%-X7R;0603 | Capacitor | C0603 | YAGEO | http://www.seeedstudio.com/wiki/images/a/ac/302010056.pdf | 0.010 | 100 | 2 | 0.20 |  | http://www.seeedstudio.com/depot/OPLopen-parts-library-catalog-c-136_138/#302010095
302010202 |  | DIP CAP Ceramic Disc 10nF-50V-Y5V | Capacitor | Radial-Disc-2.5-D4.0mm |  |  | 0.015 | 100 | 2 | 0.20 |  | http://www.seeedstudio.com/depot/OPLopen-parts-library-catalog-c-136_138/#302010202
302010140 | CC0603KRX7R9BB103 | SMD CAP Ceramic 10nF-50V-10%-X7R | Capacitor | 0603 | YAGEO | http://www.seeedstudio.com/wiki/images/e/eb/0100350P1.pdf (http://www.seeedstudio.com/wiki/images/f/f0/302010067.pdf%20302010094) | 0.010 | 100 | 2 | 0.20 |  | http://www.seeedstudio.com/depot/OPLopen-parts-library-catalog-c-136_138/#0100350P1
302010006 | CC0402KRX7R9BB103 | SMD CAP Ceramic 10nF-50V-10%-X7R | Capacitor | 0402 | YAGEO | http://www.seeedstudio.com/wiki/images/f/f0/302010067.pdf | 0.010 | 100 | 2 | 0.20 |  | http://www.seeedstudio.com/depot/OPLopen-parts-library-catalog-c-136_138/#302010006
302010144 | CC0603KRX7R9BB472 | SMD CAP Ceramic 4.7nF-50V-10%-X7R | Capacitor | 0603 | YAGEO | http://www.seeedstudio.com/wiki/images/f/fd/0130360P1.pdf | 0.010 | 100 | 2 | 0.20 |  | http://www.seeedstudio.com/depot/OPLopen-parts-library-catalog-c-136_138/#0100850P1
302010056 | CC0603KRX7R9BB222 | SMD CAP Ceramic 2.2nF-50V-10%-X7R | Capacitor | 0603 | YAGEO | http://www.seeedstudio.com/wiki/images/a/ac/302010056.pdf | 0.010 | 100 | 2 | 0.20 |  | http://www.seeedstudio.com/depot/OPLopen-parts-library-catalog-c-136_138/#302010056
302010141 | CC0603KRX7R9BB102 | SMD CAP Ceramic 1nF-50V-10%-X7R | Capacitor | 0603 | YAGEO | http://www.seeedstudio.com/wiki/images/c/cf/0100370P1.pdf | 0.010 | 100 | 2 | 0.20 |  | http://www.seeedstudio.com/depot/OPLopen-parts-library-catalog-c-136_138/#0100370P1
302010005 | CC0402KRX7R9BB102 | SMD CAP Ceramic 1nF-50V-10%-X7R; | Capacitor | 0402 | YAGEO |  | 0.050 | 50 | 2 | 0.20 |  | http://www.seeedstudio.com/depot/OPLopen-parts-library-catalog-c-136_138/#302010005
302010094 | CC0603JRNPO9BN221 | SMD CAP Ceramic 220pF-50V-5%-NPO; | Capacitor | C0603 | YAGEO | http://www.seeedstudio.com/wiki/images/f/f0/302010067.pdf 302010094 (http://www.seeedstudio.com/wiki/File:302010067.pdf) | 0.020 | 100 | 2 | 0.20 |  | http://www.seeedstudio.com/depot/OPLopen-parts-library-catalog-c-136_138/#302010094
302010013 | CC0402JRNPO9BN221 | SMD CAP Ceramic 220pF-50V-5%-NPO | Capacitor | 0402 | YAGEO | http://www.seeedstudio.com/wiki/images/f/f0/302010067.pdf | 0.030 | 50 | 2 | 0.20 |  | http://www.seeedstudio.com/depot/OPLopen-parts-library-catalog-c-136_138/#302010013
302010076 | CC0603JRNPO9BN101 | SMD CAP Ceramic 100pF-50V-5%-NPO;0603 | Capacitor | 0603 | YAGEO | http://www.seeedstudio.com/wiki/images/f/f0/302010067.pdf | 0.010 | 100 | 2 | 0.20 |  | http://www.seeedstudio.com/depot/OPLopen-parts-library-catalog-c-136_138/#302010076
302010126 | CC0603JRNPO9BN390 | SMD CAP Ceramic 39pF-50V-5%-NPO;0603 | Capacitor | C0603 | YAGEO | http://www.seeedstudio.com/wiki/images/f/f0/302010067.pdf (http://www.seeedstudio.com/wiki/images/0/03/0100230P1.pdf) | 0.010 | 100 | 2 | 0.20 |  | http://www.seeedstudio.com/depot/OPLopen-parts-library-catalog-c-136_138/#302010126
302010150 | CC0805JRNPO9BN270 | SMD CAP Ceramic 27pF-50V-5%-NPO | Capacitor | 0805 | YAGEO | http://www.seeedstudio.com/wiki/images/b/be/320020004.png | 0.030 | 50 | 2 | 0.20 |  | http://www.seeedstudio.com/depot/OPLopen-parts-library-catalog-c-136_138/#302010150
302010142 | CC0603JRNPO9BN270 | SMD CAP Ceramic 27pF-50V-5%-NPO | Capacitor | 0603 | YAGEO | http://www.seeedstudio.com/wiki/images/0/01/0100410P1.pdf (http://www.seeedstudio.com/wiki/images/b/be/320020004.png) | 0.010 | 100 | 2 | 0.20 |  | http://www.seeedstudio.com/depot/OPLopen-parts-library-catalog-c-136_138/#0100410P1
302010027 | CC0402JRNPO9BN270 | SMD CAP Ceramic 27pF-50V-5%-NPO | Capacitor | 0402 | YAGEO | http://www.seeedstudio.com/wiki/images/b/be/320020004.png | 0.010 | 100 | 2 | 0.20 |  | http://www.seeedstudio.com/depot/OPLopen-parts-library-catalog-c-136_138/#302010027
302010143 | CC0603JRNPO9BN220 | SMD CAP Ceramic 22pF-50V-5%-NPO | Capacitor | 0603 | YAGEO | http://www.seeedstudio.com/wiki/images/7/73/0100620P1.pdf | 0.010 | 100 | 2 | 0.20 |  | http://www.seeedstudio.com/depot/OPLopen-parts-library-catalog-c-136_138/#0100620P1
302010018 | CC0402JRNPO9BN220 | SMD CAP Ceramic 22pF-50V-5%-NPO | Capacitor | 0402 | YAGEO | http://www.seeedstudio.com/wiki/File:302010067.pdf (http://www.seeedstudio.com/wiki/images/b/be/320020004.png) | 0.010 | 100 | 2 | 0.20 |  | http://www.seeedstudio.com/depot/OPLopen-parts-library-catalog-c-136_138/#302010018
302010162 | CC0805JRNPO9BN180 | SMD CAP Ceramic 18pF-50V-5%-NPO | Capacitor | 0805 | YAGEO |  | 0.010 | 100 | 2 | 0.20 |  | http://www.seeedstudio.com/depot/OPLopen-parts-library-catalog-c-136_138/#302010162
302010016 | CC0402JRNPO9BN180 | SMD CAP Ceramic 18pF-50V-5%-NPO | Capacitor | 0402 | YAGEO |  | 0.010 | 100 | 2 | 0.20 |  | http://www.seeedstudio.com/depot/OPLopen-parts-library-catalog-c-136_138/#302010016
302010083 | CC0603JRNPO9BN180 | SMD CAP Ceramic 18pF-50V-5%-NPO; | Capacitor | 0603 | YAGEO | http://www.seeedstudio.com/wiki/images/7/77/320020027.png | 0.010 | 100 | 2 | 0.20 |  | http://www.seeedstudio.com/depot/OPLopen-parts-library-catalog-c-136_138/#302010083
302010082 | CC0603JRNPO9BN150 | SMD CAP Ceramic 15pF-50V-5%-NPO;0603 | Capacitor | 0603 | YAGEO | http://www.seeedstudio.com/wiki/images/f/f0/302010067.pdf (http://www.seeedstudio.com/wiki/images/e/ef/320020003.png) | 0.010 | 100 | 2 | 0.20 |  | http://www.seeedstudio.com/depot/OPLopen-parts-library-catalog-c-136_138/#302010082
302010067 | CC0603JRNPO9BN120 | SMD CAP Ceramic 12pF-50V-5%-NP0 | Capacitor | 0603 | YAGEO | http://www.seeedstudio.com/wiki/images/f/f0/302010067.pdf | 0.010 | 100 | 2 | 0.20 |  | http://www.seeedstudio.com/depot/OPLopen-parts-library-catalog-c-136_138/#302010067
302010097 | CC0603JRNPO9BN100 | SMD CAP Ceramic 10pF-50V-5%-NPO | Capacitor | 0603 | YAGEO | http://www.seeedstudio.com/wiki/images/b/be/320020004.png | 0.010 | 100 | 2 | 0.20 |  | http://www.seeedstudio.com/depot/OPLopen-parts-library-catalog-c-136_138/#302010097
302010001 | CC0402JRNPO9BN100 | SMD CAP Ceramic 10pF-50V-5%-NPO | Capacitor | 0402 | YAGEO |  | 0.010 | 100 | 2 | 0.20 |  | http://www.seeedstudio.com/depot/OPLopen-parts-library-catalog-c-136_138/#302010001
302010223 | CC0402CRNPO9BN2R2 | SMD CAP Ceramic 2.2pF-50V-0.25PF-NPO | Capacitor | 0402 | YAGEO | http://www.seeedstudio.com/wiki/images/b/be/320020004.png | 0.010 | 100 | 2 | 0.20 |  | http://www.seeedstudio.com/depot/OPLopen-parts-library-catalog-c-136_138/#302010223
302010102 | CC0603CRNPO9BN2R2 | SMD CAP Ceramic 2.2pF-50V-0.25pF-NPO | Capacitor | 0603 | YAGEO |  | 0.010 | 100 | 2 | 0.20 |  | http://www.seeedstudio.com/depot/OPLopen-parts-library-catalog-c-136_138/#302010102
302010046 | GRM1555C1H1R8BA01D | SMD CAP Ceramic 1.8pF-50V-0.1pF-NPO | Capacitor | 0402 | Murata |  | 0.010 | 100 | 2 | 0.20 |  | http://www.seeedstudio.com/depot/OPLopen-parts-library-catalog-c-136_138/#302010046
320020037 | P125-1102A0BS116A3 | DIP White Male Header VERT; | Connector | 1*2P-2.54-2.54-11.6/3.0mm | YXCON | http://www.seeedstudio.com/wiki/images/b/be/320020004.png (http://www.seeedstudio.com/wiki/images/c/cb/320020019.png) | 0.100 | 20 | 2 | 0.20 |  | http://www.seeedstudio.com/depot/OPLopen-parts-library-catalog-c-136_138/#320020037
320020015 | P125-1102A0BS116A2 | DIP Blue Male Header VERT | Connector | 1*2P-2.54-2.54-11.6/3.0mm | YXCON | http://www.seeedstudio.com/wiki/images/b/be/320020004.png | 0.100 | 20 | 2 | 0.20 |  | http://www.seeedstudio.com/depot/OPLopen-parts-library-catalog-c-136_138/#320020015
320020016 | P125-1102A0BS116A1 | DIP Black Male Header VERT | Connector | 1*2P-2.54-2.54-11.6/3.0mm | YXCON | http://www.seeedstudio.com/wiki/images/b/be/320020004.png | 0.100 | 20 | 2 | 0.20 |  | http://www.seeedstudio.com/depot/OPLopen-parts-library-catalog-c-136_138/#320020016
320020079 |  | DIP-Black-Male-Header-VERT-3P | Connector | 1X3P-2.54-2.54-11.6/3.0 | YXCON | http://www.seeedstudio.com/wiki/images/0/02/3460810P1.pdf (http://www.seeedstudio.com/wiki/images/b/be/320020004.png) | 0.100 | 20 | 3 | 0.30 |  | http://www.seeedstudio.com/depot/OPLopen-parts-library-catalog-c-136_138/#3460810P1
320020038 | P125-1103A0BS116A1 | DIP White Male Header VERT; | Connector | 1*3P-2.54-2.54-11.6/3.0mm | YXCON | http://www.seeedstudio.com/wiki/images/b/be/320020004.png | 0.120 | 20 | 3 | 0.30 |  | http://www.seeedstudio.com/depot/OPLopen-parts-library-catalog-c-136_138/#320020038
320020061 | P125-1103A0BR138A1 | DIP Black Male Header R/A; | Connector | 1*3P-2.54-2.54-6.0mm-90D-1 | YXCON |  | 0.120 | 20 | 3 | 0.30 |  | http://www.seeedstudio.com/depot/OPLopen-parts-library-catalog-c-136_138/#320020061
320020077 | P125-12A1BS116A1 | DIP Black Male Header | Connector | 2X3P-2.54-2.54-11.6/3.0 | YXCON | http://www.seeedstudio.com/wiki/images/7/72/3460180P1.pdf (http://www.seeedstudio.com/wiki/images/8/8b/320020018.png) | 0.060 | 20 | 6 | 0.60 |  | http://www.seeedstudio.com/depot/OPLopen-parts-library-catalog-c-136_138/#3460180P1
320020027 | P125-1203A0BS116A2 | DIP Yellow Male Header VERT; | Connector | 2*3P-2.54-2.54-11.6/3.0mm | YXCON | http://www.seeedstudio.com/wiki/images/7/77/320020027.png | 0.100 | 20 | 6 | 0.60 |  | http://www.seeedstudio.com/depot/OPLopen-parts-library-catalog-c-136_138/#320020027
320020003 | P125-1203A0BS116A1 | DIP Blue Male Header VERT; | Connector | 2*3P-2.54-2.54-11.6/3.0mm | YXCON | http://www.seeedstudio.com/wiki/images/e/ef/320020003.png (http://www.seeedstudio.com/wiki/images/2/25/320020010.pdf) | 0.150 | 20 | 6 | 0.60 |  | http://www.seeedstudio.com/depot/OPLopen-parts-library-catalog-c-136_138/#320020003
320020017 | P125-1104A0BS116A1 | DIP Black Male Header VERT | Connector | 1*4P-2.54-2.54-11.6/3.0mm | YXCON | http://www.seeedstudio.com/wiki/images/f/fb/320020089.png | 0.100 | 20 | 4 | 0.40 |  | http://www.seeedstudio.com/depot/OPLopen-parts-library-catalog-c-136_138/#320020017
320020005 | P125-1106A0BS116A1 | DIP Blue Male Header VERT | Connector | 1*6P-2.54-2.54-11.6/3.0mm | YXCON | http://www.seeedstudio.com/wiki/images/b/be/320020004.png | 0.100 | 20 | 6 | 0.60 |  | http://www.seeedstudio.com/depot/OPLopen-parts-library-catalog-c-136_138/#320020005
320020078 | P125-1106A1BS116A1 | DIP Black Male Header | Connector | 1X6P-2.54-2.54-11.6/3.0mm | YXCON | http://www.seeedstudio.com/wiki/images/2/2d/3460650P1.pdf | 0.100 | 20 | 6 | 0.60 |  | http://www.seeedstudio.com/depot/OPLopen-parts-library-catalog-c-136_138/#3460650P1
320020022 | P125-1106A0BS116A2 | DIP White Male Header VERT; | Connector | 1*6P-2.54-2.54-11.6/3.0mm | YXCON | http://www.seeedstudio.com/wiki/images/b/be/320020004.png (http://www.seeedstudio.com/wiki/images/0/0d/320030039.pdf) | 0.100 | 20 | 6 | 0.60 |  | http://www.seeedstudio.com/depot/OPLopen-parts-library-catalog-c-136_138/#320020022
320020024 | P125-1106B0BA2 | SMD Blue Male Header R/A; | Connector | 1*6P-2.54-2.54-9.3/6.0mm-2 | YXCON | http://www.seeedstudio.com/wiki/images/e/ef/320120007.pdf | 0.100 | 20 | 6 | 0.60 |  | http://www.seeedstudio.com/depot/OPLopen-parts-library-catalog-c-136_138/#320020024
320020031 | P125-1106B0BA1 | SMD Black Male Header R/A; | Connector | 1*6P-2.54-2.54-9.3/6.0mm-2 | YXCON | http://www.seeedstudio.com/wiki/images/d/d3/320030100.png | 0.100 | 20 | 6 | 0.60 |  | http://www.seeedstudio.com/depot/OPLopen-parts-library-catalog-c-136_138/#320020031
320020019 | P125-1106A0BR138A1 | DIP Black Short Male Header R/A; | Connector | 1X6P-2.54-2.54-6.0mm-90D-1 | YXCON | http://www.seeedstudio.com/wiki/images/c/cb/320020019.png (http://www.seeedstudio.com/wiki/images/a/a7/320030035.png) | 0.100 | 20 | 6 | 0.60 |  | http://www.seeedstudio.com/depot/OPLopen-parts-library-catalog-c-136_138/#320020019
320020070 | P125-1106A0BR138A2 | DIP Black Male Header R/A; | Connector | 1*6P-2.54-2.54-6.0mm-90D-2 | YXCON | http://www.seeedstudio.com/wiki/images/1/11/320030011.png | 0.100 | 20 | 6 | 0.60 |  | http://www.seeedstudio.com/depot/OPLopen-parts-library-catalog-c-136_138/#320020070
320020004 | P125-1108A0BS116A1 | DIP Blue Male Header VERT | Connector | 1*8P-2.54-2.54-11.6/3.0mm | YXCON | http://www.seeedstudio.com/wiki/images/b/be/320020004.png (http://www.seeedstudio.com/wiki/images/0/0d/320030039.pdf) | 0.100 | 20 | 8 | 0.80 |  | http://www.seeedstudio.com/depot/OPLopen-parts-library-catalog-c-136_138/#320020004
320020021 | P125-1108A0BS116A2 | DIP White Male Header VERT; | Connector | 1*8P-2.54-2.54-11.6/3.0mm | YXCON | http://www.seeedstudio.com/wiki/images/b/be/320020004.png | 0.100 | 20 | 8 | 0.80 |  | http://www.seeedstudio.com/depot/OPLopen-parts-library-catalog-c-136_138/#320020021
320020080 | P125-1108A1BS116A1 | DIP-Black-Male-Header-VERT-8P | Connector | 1X8P-2.54-2.54-11.6/3.0 | YXCON | http://www.seeedstudio.com/wiki/images/b/b5/3461050P1.pdf (http://www.seeedstudio.com/wiki/images/0/0d/320030039.pdf) | 0.100 | 20 | 8 | 0.80 |  | http://www.seeedstudio.com/depot/OPLopen-parts-library-catalog-c-136_138/#3461050P1
320020023 | P125-1108B0BA2 | SMD Blue Male Header R/A; | Connector | 1*8P-2.54-2.54-9.3/6.0mm-2 | YXCON | http://www.seeedstudio.com/wiki/images/0/0d/320030039.pdf | 0.120 | 20 | 8 | 0.80 |  | http://www.seeedstudio.com/depot/OPLopen-parts-library-catalog-c-136_138/#320020023
320020018 | P220-1110A0BS087A1 | DIP White Male Header VERT; | Connector | 1*10P-2.0-2.0-8.7/2.8mm | YXCON | http://www.seeedstudio.com/wiki/images/8/8b/320020018.png (http://www.seeedstudio.com/wiki/images/0/0d/320030039.pdf) | 0.200 | 10 | 10 | 1.00 |  | http://www.seeedstudio.com/depot/OPLopen-parts-library-catalog-c-136_138/#320020018
320020074 | P125-1110A0BR138A1 | DIP Black Male Header R/A; | Connector | 1*10P-2.54-2.54-6.0mm-90D-1 | YXCON | http://www.seeedstudio.com/wiki/images/e/e3/3460540P1.pdf | 0.120 | 20 | 10 | 1.00 |  | http://www.seeedstudio.com/depot/OPLopen-parts-library-catalog-c-136_138/#320020074
320020010 |  | DIP Black Male Header VERT; | Connector | 1*40P-2.54-2.54-11.6/3.0mm | YXCON | http://www.seeedstudio.com/wiki/images/2/25/320020010.pdf | 0.200 | 5 | 40 | 4.00 |  | http://www.seeedstudio.com/depot/OPLopen-parts-library-catalog-c-136_138/#320020010
320020089 | P220-1140A0BS087A1 | DIP White Male Header VERT; | Connector | 1*40P-2.0-2.0-8.7-2.8mm | YXCON | http://www.seeedstudio.com/wiki/images/f/fb/320020089.png | 0.250 | 5 | 40 | 4.00 |  | http://www.seeedstudio.com/depot/OPLopen-parts-library-catalog-c-136_138/#320020089
320020032 | P125-1140B0BA1 | SMD Black Male Header R/A; | Connector | 1*40P-2.0-2.0-4.0mm-2 | YXCON | http://www.seeedstudio.com/wiki/images/8/87/320030014.png | 0.400 | 5 | 40 | 4.00 |  | http://www.seeedstudio.com/depot/OPLopen-parts-library-catalog-c-136_138/#320020032
320020013 | P125-1140A0BR138A2 | DIP Black Short Male Header R/A; | Connector | 1*40P-2.54-2.54-6.0mm-90D-1 | YXCON |  | 0.400 | 5 | 40 | 4.00 |  | http://www.seeedstudio.com/depot/OPLopen-parts-library-catalog-c-136_138/#320020013
320030023 | F185-1102A1BSYA1 | DIP Black Female Header VERT; | Connector | 1*2P-2.54-8.5mm | YXCON | http://www.seeedstudio.com/wiki/images/0/0d/320030039.pdf | 0.150 | 10 | 2 | 0.20 |  | http://www.seeedstudio.com/depot/OPLopen-parts-library-catalog-c-136_138/#320030023
320120007 | GSL009-5.0-02P-12 | DIP Female Blue; | Connector | 2P-5.0 | SENGER | http://www.seeedstudio.com/wiki/images/e/ef/320120007.pdf (http://www.seeedstudio.com/wiki/images/0/0d/320030039.pdf) | 0.500 | 10 | 2 | 0.20 |  | http://www.seeedstudio.com/depot/OPLopen-parts-library-catalog-c-136_138/#320120007
320030100 | F185-1103A1BRYA1 | DIP Black Female Header; | Connector | 1*3P-2.54-8.5-90D | YXCON | http://www.seeedstudio.com/wiki/images/d/d3/320030100.png | 0.100 | 20 | 3 | 0.30 |  | http://www.seeedstudio.com/depot/OPLopen-parts-library-catalog-c-136_138/#320030100
320030035 | F185-1203A1BMYA1 | SMD Blue Female Header VERT | Connector | 2*3P-2.54-8.5mm | YXCON | http://www.seeedstudio.com/wiki/images/a/a7/320030035.png | 0.270 | 10 | 6 | 0.60 |  | http://www.seeedstudio.com/depot/OPLopen-parts-library-catalog-c-136_138/#320030035
320030011 | F185-1203A1BSYA1 | DIP Black Female Header VERT | Connector | 2*3P-2.54-8.5mm | YXCON | http://www.seeedstudio.com/wiki/images/1/11/320030011.png (http://www.seeedstudio.com/wiki/images/2/2d/320030013.png) | 0.200 | 10 | 6 | 0.60 |  | http://www.seeedstudio.com/depot/OPLopen-parts-library-catalog-c-136_138/#320030011
320030017 | F185-1104A1BSYA1 | DIP Black Female Header VERT | Connector | 1*4P-2.54-8.5mm | YXCON | http://www.seeedstudio.com/wiki/images/0/0d/320030039.pdf (http://www.seeedstudio.com/wiki/images/c/c9/320030076.png) | 0.150 | 10 | 4 | 0.40 |  | http://www.seeedstudio.com/depot/OPLopen-parts-library-catalog-c-136_138/#320030017
320030066 |  | DIP Long Blue Female Header | Connector | 2X3P-2.54-8.5+1.5-12.3 | YXCON | http://www.seeedstudio.com/wiki/images/0/01/3461240P1.pdf (http://www.seeedstudio.com/wiki/images/7/70/320030001.pdf) | 0.250 | 10 | 6 | 0.60 |  | http://www.seeedstudio.com/depot/OPLopen-parts-library-catalog-c-136_138/#3461240P1
320030019 | F185-1106A1BSYA3 | DIP Yellow Female Header VERT; | Connector | 1*6P-2.54-8.5mm | YXCON | http://www.seeedstudio.com/wiki/images/0/0d/320030039.pdf | 0.200 | 10 | 6 | 0.60 |  | http://www.seeedstudio.com/depot/OPLopen-parts-library-catalog-c-136_138/#320030019
320030012 | F185-1106A1BSYA2 | DIP Long Black Female Header VERT | Connector | 1*6P-2.54-8.5mm | YXCON | http://www.seeedstudio.com/wiki/images/0/0d/320030039.pdf (http://www.seeedstudio.com/wiki/images/f/f2/3460170P1.pdf) | 0.250 | 10 | 6 | 0.60 |  | http://www.seeedstudio.com/depot/OPLopen-parts-library-catalog-c-136_138/#320030012
320030004 | F185-1106A1BSYA1 | DIP Blue Female Header VERT | Connector | 1*6P-2.54-8.5mm | YXCON | http://www.seeedstudio.com/wiki/images/0/0d/320030039.pdf (http://www.seeedstudio.com/wiki/images/c/c5/320030020.png) | 0.200 | 10 | 6 | 0.60 |  | http://www.seeedstudio.com/depot/OPLopen-parts-library-catalog-c-136_138/#320030004
320030063 | F185-1106A1BSYA4 | DIP White Female Header | Connector | 1X6P-2.54-8.5 | YXCON | http://www.seeedstudio.com/wiki/images/e/e3/3460540P1.pdf | 0.200 | 10 | 6 | 0.60 |  | http://www.seeedstudio.com/depot/OPLopen-parts-library-catalog-c-136_138/#3460540P1
320030060 | F185-1106A1BSYC1 | DIP-Black-Female-Header-VERT(6P) | Connector | 1X6P-2.54-8.5 | YXCON | http://www.seeedstudio.com/wiki/images/b/b1/3460270P1.pdf (http://www.seeedstudio.com/wiki/images/6/6e/320030009.png) | 0.120 | 20 | 6 | 0.60 |  | http://www.seeedstudio.com/depot/OPLopen-parts-library-catalog-c-136_138/#3460270P1
320030067 |  | DIP Long Blue Female Header | Connector | 1X6P-2.54-8.5+2.5-12.3 | YXCON | http://www.seeedstudio.com/wiki/images/0/0d/3461250P1.pdf | 0.200 | 10 | 6 | 0.60 |  | http://www.seeedstudio.com/depot/OPLopen-parts-library-catalog-c-136_138/#3461250P1
320030014 | F185-1106A1BRYA1 | DIP Black Female Header R/A; | Connector | 1*6P-2.54-8.5mm-90D | YXCON | http://www.seeedstudio.com/wiki/images/8/87/320030014.png (http://www.seeedstudio.com/wiki/images/e/ee/3460440P1.pdf) | 0.150 | 10 | 6 | 0.60 |  | http://www.seeedstudio.com/depot/OPLopen-parts-library-catalog-c-136_138/#320030014
320030068 |  | DIP Long Blue Female Header | Connector | 1X8P-2.54-8.5+2.5-12.3 | YXCON | http://www.seeedstudio.com/wiki/images/4/49/3461260P1.pdf (http://www.seeedstudio.com/wiki/images/5/5d/320070002%26320070007.pdf) | 0.250 | 10 | 8 | 0.80 |  | http://www.seeedstudio.com/depot/OPLopen-parts-library-catalog-c-136_138/#3461260P1
320030065 | F185-1108A1BSYC1 | DIP Yellow Female Header | Connector | 1X8P-2.54-8.5 | YXCON | http://www.seeedstudio.com/wiki/images/1/18/3460590P1.pdf (http://www.seeedstudio.com/wiki/images/5/5d/320070002%26320070007.pdf) | 0.200 | 10 | 8 | 0.80 |  | http://www.seeedstudio.com/depot/OPLopen-parts-library-catalog-c-136_138/#3460590P1
320030003 | F185-1108A1BSYA1 | DIP Blue Female Header VERT | Connector | 1*8P-2.54-8.5mm | YXCON | http://www.seeedstudio.com/wiki/images/0/0d/320030039.pdf (http://www.seeedstudio.com/wiki/images/d/d3/320170000.pdf) | 0.250 | 10 | 8 | 0.80 |  | http://www.seeedstudio.com/depot/OPLopen-parts-library-catalog-c-136_138/#320030003
320030064 | F185-1108A1BSYC1 | DIP White Female Header | Connector | 1X8P-2.54-8.5 | YXCON | http://www.seeedstudio.com/wiki/images/f/f1/3460550P1.pdf (http://www.seeedstudio.com/wiki/images/b/b6/320110017.pdf) | 0.240 | 10 | 8 | 0.80 |  | http://www.seeedstudio.com/depot/OPLopen-parts-library-catalog-c-136_138/#3460550P1
320030061 | F185-1108A1BSYC1 | DIP-Black-Female-Header-VERT(8P) | Connector | 1X8P-2.54-8.5 | YXCON | http://www.seeedstudio.com/wiki/images/2/27/3460290P1.pdf | 0.200 | 10 | 8 | 0.80 |  | http://www.seeedstudio.com/depot/OPLopen-parts-library-catalog-c-136_138/#3460290P1
320030013 | F185-2108A1BSYA1 | DIP Long Black Female Header VERT | Connector | 1*8P-2.54-(8.5+1.5)mm-10.5 | YXCON | http://www.seeedstudio.com/wiki/images/2/2d/320030013.png | 0.300 | 10 | 8 | 0.80 |  | http://www.seeedstudio.com/depot/OPLopen-parts-library-catalog-c-136_138/#320030013
320030076 | F185-AA08A2BRYA1 | DIP Black Female Header R/A; | Connector | 1*8P-2.54-8.5mm-90D | YXCON | http://www.seeedstudio.com/wiki/images/c/c9/320030076.png (http://www.seeedstudio.com/wiki/images/6/62/320090002.pdf) | 0.200 | 10 | 8 | 0.80 |  | http://www.seeedstudio.com/depot/OPLopen-parts-library-catalog-c-136_138/#320030076
320030001 | F185-2110A0ASYA1 | DIP Long Blue Female Header; | Connector | 1*10P-2.54-8.5+2.5-12.3mm | YAGEO | http://www.seeedstudio.com/wiki/images/7/70/320030001.pdf | 0.280 | 10 | 10 | 1.00 |  | http://www.seeedstudio.com/depot/OPLopen-parts-library-catalog-c-136_138/#320030001
320030039 | F185-1110A1BSYA1 | DIP Long Black Female Header VERT; | Connector | 1*10P-2.54-8.5mm | YAGEO | http://www.seeedstudio.com/wiki/images/0/0d/320030039.pdf | 0.360 | 10 | 10 | 1.00 |  | http://www.seeedstudio.com/depot/OPLopen-parts-library-catalog-c-136_138/#320030039
320030059 | F185-1110A1BSYC1 | DIP Yellow Female Header VERT | Connector | 1*10P-2.54-8.5mm | YXCON | http://www.seeedstudio.com/wiki/images/f/f2/3460170P1.pdf | 0.250 | 10 | 10 | 1.00 |  | http://www.seeedstudio.com/depot/OPLopen-parts-library-catalog-c-136_138/#320030059
320030020 | F243-1110A1BSUA2 | DIP White Female Header VERT; | Connector | 1*10P-2.0-4.3mm | YXCON | http://www.seeedstudio.com/wiki/images/c/c5/320030020.png | 0.270 | 10 | 10 | 1.00 |  | http://www.seeedstudio.com/depot/OPLopen-parts-library-catalog-c-136_138/#320030020
320030062 | F243-1110A1BSUC1 | DIP Blue Female Header | Connector | 1X10P-2.0-4.3 | YXCON | http://www.seeedstudio.com/wiki/images/2/27/3460510P1.pdf | 0.250 | 10 | 10 | 1.00 |  | http://www.seeedstudio.com/depot/OPLopen-parts-library-catalog-c-136_138/#3460510P1
320030009 | F243-1110A1BSUA1 | DIP Black Female Header VERT; | Connector | 1*10P-2.0-4.3mm | YXCON | http://www.seeedstudio.com/wiki/images/6/6e/320030009.png | 0.300 | 10 | 10 | 1.00 |  | http://www.seeedstudio.com/depot/OPLopen-parts-library-catalog-c-136_138/#320030009
320030053 | F185-1110A1BRYA1 | DIP Black Female Header R/A | Connector | 1*10P-2.54-8.5mm-90D | YXCON |  | 0.200 | 10 | 10 | 1.00 |  | http://www.seeedstudio.com/depot/OPLopen-parts-library-catalog-c-136_138/#320030053
320190003 |  | CONN JUMPER SHORTING | Connector | 2P-2.54 | TAIFENG | http://www.seeedstudio.com/wiki/images/e/ee/3460440P1.pdf | 0.030 | 50 | 0 | 0.00 |  | http://www.seeedstudio.com/depot/OPLopen-parts-library-catalog-c-136_138/#3460440P1
320070014 |  | DIP IC Socket; | Connector | 2*8P-2.54mm | NSTECH | http://www.seeedstudio.com/wiki/images/5/5d/320070002%26320070007.pdf | 0.100 | 20 | 16 | 1.60 |  | http://www.seeedstudio.com/depot/OPLopen-parts-library-catalog-c-136_138/#320070014
320070007 |  | DIP IC Socket; | Connector | 2*9P-2.54mm | NSTECH | http://www.seeedstudio.com/wiki/images/5/5d/320070002%26320070007.pdf | 0.150 | 10 | 18 | 1.80 |  | http://www.seeedstudio.com/depot/OPLopen-parts-library-catalog-c-136_138/#320070007
320170000 |  | SMD Battery Cell Holder Plastic | Connector | CR1220-15.06*13.00*H4.1mm |  | http://www.seeedstudio.com/wiki/images/d/d3/320170000.pdf | 0.350 | 10 | 4 | 0.40 |  | http://www.seeedstudio.com/depot/OPLopen-parts-library-catalog-c-136_138/#320170000
320110017 |  | SMD Male DB9 Connector; | Connector | DSUB9+2P-2.77-90D-MALE | Baisite | http://www.seeedstudio.com/wiki/images/b/b6/320110017.pdf | 0.200 | 10 | 11 | 1.10 |  | http://www.seeedstudio.com/depot/OPLopen-parts-library-catalog-c-136_138/#320110017
320090000 | ST-TF-003A | Micro SD Card Socket | Connector | 9P-SMD-W/-RING | SUNTECH | http://www.seeedstudio.com/wiki/images/3/3e/3300060P1.PDF | 0.500 | 10 | 13 | 1.30 |  | http://www.seeedstudio.com/depot/OPLopen-parts-library-catalog-c-136_138/#3300060P1
320090008 |  | Micro SD Card Holder; | Connector | TF-01 | BEST | http://www.seeedstudio.com/wiki/images/2/22/320090008.pdf | 0.260 | 10 | 10 | 1.00 |  | http://www.seeedstudio.com/depot/OPLopen-parts-library-catalog-c-136_138/#320090008
320090002 | VSHO-TF08-5501 | SMD SD Card Holder; | Connector | 8P-SMD-COVER | VSHOTECH | http://www.seeedstudio.com/wiki/images/6/62/320090002.pdf | 0.250 | 10 | 8 | 0.80 |  | http://www.seeedstudio.com/depot/OPLopen-parts-library-catalog-c-136_138/#320090002
320170003 |  | DIP Battery Cell Holder; | Connector | Metal CR2032-D20*H6.3mm | KEYUE |  | 0.060 | 20 | 4 | 0.40 |  | http://www.seeedstudio.com/depot/OPLopen-parts-library-catalog-c-136_138/#320170003
320010007 | ST-USB-003A | DIP USB A TYPE Famale; | Connector | 4P-2.0-90D | suntech |  | 0.250 | 10 | 4 | 0.40 |  | http://www.seeedstudio.com/depot/OPLopen-parts-library-catalog-c-136_138/#320010007
320010000 | ST-USB-001G | SMD Micro USB-B-without POST-W/P; | Connector | 5+4-0.65-L7.4*W5.0*H2.35mm | SUNTECH |  | 0.300 | 10 | 8 | 0.80 |  | http://www.seeedstudio.com/depot/OPLopen-parts-library-catalog-c-136_138/#320010000
320010014 | ST-USB-013A | CONN RECEPT MINI USB2.0 5POS 4 legs shielded | Connector | MINI-B-5P-SMD | SUNTECH | http://www.seeedstudio.com/wiki/images/6/68/3400030P1.pdf | 0.200 | 10 | 9 | 0.90 |  | http://www.seeedstudio.com/depot/OPLopen-parts-library-catalog-c-136_138/#3400030P1
320110031 |  | Screw Terminal | Connector | 2P-5.0 | GOOSVN | http://www.seeedstudio.com/wiki/images/e/ee/3470110P1.pdf (http://www.seeedstudio.com/wiki/images/c/c0/320140010.pdf) | 0.200 | 10 | 2 | 0.20 |  | http://www.seeedstudio.com/depot/OPLopen-parts-library-catalog-c-136_138/#3470110P1
320110028 |  | Screw Terminal | Connector | 2P-3.5 | GOOSVN | http://www.seeedstudio.com/wiki/images/4/49/3470070P1.pdf | 0.200 | 10 | 2 | 0.20 |  | http://www.seeedstudio.com/depot/OPLopen-parts-library-catalog-c-136_138/#3470070P1
320110029 |  | Screw Terminal | Connector | 3P-5.0 | GOOSVN | http://www.seeedstudio.com/wiki/images/f/f0/3470080P1.pdf | 0.250 | 10 | 3 | 0.30 |  | http://www.seeedstudio.com/depot/OPLopen-parts-library-catalog-c-136_138/#3470080P1
320120003 | DC-005 | CONN DC POWER JACK 2.1MM | Connector | PW-3P-2.1 | BEST | http://www.seeedstudio.com/wiki/images/1/15/3410020P1.pdf | 0.150 | 10 | 3 | 0.30 |  | http://www.seeedstudio.com/depot/OPLopen-parts-library-catalog-c-136_138/#3410020P1
320120002 |  | Jack DC-044-A | Connector | PW-3P-2.1 | BEST | http://www.seeedstudio.com/wiki/images/c/c0/3410010P1.pdf (http://www.seeedstudio.com/wiki/images/5/5a/304090041.pdf) | 0.200 | 10 | 3 | 0.30 |  | http://www.seeedstudio.com/depot/OPLopen-parts-library-catalog-c-136_138/#3410010P1
320110027 |  | CONN HEADER PH SIDE 2POS 2MM | Connector | 2P-2.0-90D |  | http://www.seeedstudio.com/wiki/images/e/e8/3410070P1.pdf (http://www.seeedstudio.com/wiki/images/5/5d/304090059.pdf) | 0.030 | 50 | 2 | 0.20 |  | http://www.seeedstudio.com/depot/OPLopen-parts-library-catalog-c-136_138/#3410070P1
320110026 |  | CONN HEADER PH SIDE 2POS 2MM SMD | Connector | 2P-SMD-2.0-90D |  | http://www.seeedstudio.com/wiki/images/f/f3/3410050P1.pdf (http://www.seeedstudio.com/wiki/images/5/56/304090057.pdf) | 0.100 | 20 | 2 | 0.20 |  | http://www.seeedstudio.com/depot/OPLopen-parts-library-catalog-c-136_138/#3410050P1
320110030 | 1125S-SMT-4P | SMD Grove | Connector | 4P-SMD-2.0 | TAIFENG | http://www.seeedstudio.com/wiki/images/d/d5/3470090P1.pdf | 0.150 | 10 | 4 | 0.40 |  | http://www.seeedstudio.com/depot/OPLopen-parts-library-catalog-c-136_138/#3470090P1
320110032 | 1125R-SMT-4P | SMD Grove | Connector | 4P-SMD-2.0-90D | TAIFENG | http://www.seeedstudio.com/wiki/images/e/e0/3470120P1.pdf (http://www.seeedstudio.com/wiki/images/d/d1/304090040.pdf) | 0.150 | 10 | 4 | 0.40 |  | http://www.seeedstudio.com/depot/OPLopen-parts-library-catalog-c-136_138/#3470120P1
320110034 | 1125R-4P | DIP Grove | Connector | 4P-2.0-90D | TAIFENG | http://www.seeedstudio.com/wiki/images/4/40/3470140P1.pdf (http://www.seeedstudio.com/wiki/images/8/87/304090038.pdf) | 0.050 | 30 | 4 | 0.40 |  | http://www.seeedstudio.com/depot/OPLopen-parts-library-catalog-c-136_138/#3470140P1
320110033 | 1125S-4P | DIP Grove | Connector | 4P-2.0 | TAIFENG | http://www.seeedstudio.com/wiki/images/6/69/3470130P1.pdf (http://www.seeedstudio.com/wiki/images/5/53/304090039.pdf) | 0.050 | 30 | 4 | 0.40 |  | http://www.seeedstudio.com/depot/OPLopen-parts-library-catalog-c-136_138/#3470130P1
320110048 |  | CONN RECPT ULTRA-MINI COAX SMD | Connector | U-FL | I-PEX | http://www.seeedstudio.com/wiki/images/e/ee/3450020P1.pdf | 0.500 | 10 | 4 | 0.40 |  | http://www.seeedstudio.com/depot/OPLopen-parts-library-catalog-c-136_138/#3450020P1
320100001 | ST-SIM-004B | SMD SIM Holder | Connector | 6P-L16.4*W16.3*H1.8mm | suntech | http://www.seeedstudio.com/wiki/images/9/9b/304090071.pdf | 0.270 | 10 | 6 | 0.60 |  | http://www.seeedstudio.com/depot/OPLopen-parts-library-catalog-c-136_138/#320100001
320010029 | VSHO-21-3301 | SMD TF+SIM-VSHO-21-3301; | Connector | 16P-L17.4*W16.5*H2.7mm | KQWI | http://www.seeedstudio.com/wiki/images/3/3a/304090065.pdf | 0.700 | 5 | 16 | 1.60 |  | http://www.seeedstudio.com/depot/OPLopen-parts-library-catalog-c-136_138/#320010029
320990008 | ST-HD-010G | Bare HDMI Male Connector; | Connector | White-3P | SUNTECH |  | 0.400 | 5 | 3 | 0.30 |  | http://www.seeedstudio.com/depot/OPLopen-parts-library-catalog-c-136_138/#320990008
320140010 | RJ45-MJ6-BX11-RVS1T073 | RJ45-MJ6-BX11-RVS1T073 | Connector | 6P-18.15*22.5*11.35 | HELING | http://www.seeedstudio.com/wiki/images/c/c0/320140010.pdf (http://www.seeedstudio.com/wiki/images/a/a0/304090075.pdf) | 1.500 | 2 | 6 | 0.60 |  | http://www.seeedstudio.com/depot/OPLopen-parts-library-catalog-c-136_138/#320140010
320140004 | MJ88-BX11-RVSL2 | DIP RJ45 JACK;8P-R/A-With LED | Connector | 8P-R/A | Heling Electronic | http://www.seeedstudio.com/wiki/images/f/f7/3420050P1.pdf | 1.000 | 3 | 14 | 1.40 |  | http://www.seeedstudio.com/depot/OPLopen-parts-library-catalog-c-136_138/#3420050P1
304090042 | 19-217-R6C-AL1M2VY-3T | LED-SMD Red Diffused | LED | 0603 | Everlight | http://www.seeedstudio.com/wiki/images/e/ef/0330020P1.pdf (http://www.seeedstudio.com/wiki/images/1/15/304090054.pdf) | 0.030 | 50 | 2 | 0.20 |  | http://www.seeedstudio.com/depot/OPLopen-parts-library-catalog-c-136_138/#0330020P1
304090046 | 17-215SURC/S530-A2/TR8 | SMD LED Clear-Red; | LED | 0805 | Everlight | http://www.seeedstudio.com/wiki/images/1/13/304090046.pdf (http://www.seeedstudio.com/wiki/images/7/72/304090016.pdf) | 0.050 | 25 | 2 | 0.20 |  | http://www.seeedstudio.com/depot/OPLopen-parts-library-catalog-c-136_138/#304090046
304090041 |  | DIP LED Red-Red; | LED | Radial-2P-2.54-3mm | Chengguangxing | http://www.seeedstudio.com/wiki/images/5/5a/304090041.pdf (http://www.seeedstudio.com/wiki/File:304090051.pdf) | 0.035 | 50 | 2 | 0.20 |  | http://www.seeedstudio.com/depot/OPLopen-parts-library-catalog-c-136_138/#304090041
304090059 | UR502DC | DIP LED Vaporous-Red-Red | LED | Radial-2P-2.54-5mm | Chengguangxing | http://www.seeedstudio.com/wiki/images/5/5d/304090059.pdf | 0.050 | 30 | 2 | 0.20 |  | http://www.seeedstudio.com/depot/OPLopen-parts-library-catalog-c-136_138/#304090059
304090057 | 17-215SYGC/S530-E2/TR8 | SMD LED Clear-Green | LED | 0805 | Everlight | http://www.seeedstudio.com/wiki/images/5/56/304090057.pdf (http://www.seeedstudio.com/wiki/images/0/05/304090053.pdf) | 0.060 | 25 | 2 | 0.20 |  | http://www.seeedstudio.com/depot/OPLopen-parts-library-catalog-c-136_138/#304090057
304090043 | 19-217-G7C-AN1P2-3T | SMD LED Clear-Green | LED | 0603 | Everlight | http://www.seeedstudio.com/wiki/images/f/f9/0330010P1.pdf | 0.030 | 50 | 2 | 0.20 |  | http://www.seeedstudio.com/depot/OPLopen-parts-library-catalog-c-136_138/#0330010P1
304090040 |  | DIP LED Green-Green; | LED | Radial-2P-2.54-3.0mm | Chengguangxing | http://www.seeedstudio.com/wiki/images/d/d1/304090040.pdf | 0.040 | 50 | 3 | 0.30 |  | http://www.seeedstudio.com/depot/OPLopen-parts-library-catalog-c-136_138/#304090040
304090038 | G502DC | DIP LED Green-Green | LED | Radial-2P-2.54-5mm | Chengguangxing | http://www.seeedstudio.com/wiki/images/8/87/304090038.pdf (http://www.seeedstudio.com/wiki/images/4/4d/304060001.pdf) | 0.050 | 30 | 4 | 0.40 |  | http://www.seeedstudio.com/depot/OPLopen-parts-library-catalog-c-136_138/#304090038
304090039 | 17-215UYC/S530-A3/TR8 | SMD LED Clear-Yellow | LED | 0805 | Everlight | http://www.seeedstudio.com/wiki/images/5/53/304090039.pdf (http://www.seeedstudio.com/wiki/images/0/06/304060003.pdf) | 0.065 | 25 | 2 | 0.20 |  | http://www.seeedstudio.com/depot/OPLopen-parts-library-catalog-c-136_138/#304090039
304090044 | 19-217-Y5C-AM1N1VY-3T | SMD LED Clear-Yellow | LED | 0603 | Everlight | http://www.seeedstudio.com/wiki/File:0330050P1.PDF | 0.040 | 50 | 2 | 0.20 |  | http://www.seeedstudio.com/depot/OPLopen-parts-library-catalog-c-136_138/#0330050P1
304090071 | ADL-0603W | SMD LED Yellow-White | LED | 0603 | Chengguangxing | http://www.seeedstudio.com/wiki/images/9/9b/304090071.pdf | 0.100 | 25 | 2 | 0.20 |  | http://www.seeedstudio.com/depot/OPLopen-parts-library-catalog-c-136_138/#304090071
304090065 | CZXR-80RGB03-A | DIP LED RGB Common Anode;Radial-4P-2.0-8mm | LED | Radial-4P-2.0-8mm | Chengguangxing | http://www.seeedstudio.com/wiki/images/3/3a/304090065.pdf (http://www.seeedstudio.com/wiki/images/0/08/304050003.pdf) | 0.350 | 10 | 4 | 0.40 |  | http://www.seeedstudio.com/depot/OPLopen-parts-library-catalog-c-136_138/#304090065
304090045 | 19-217-BHC-ZL1M2RY-3T | SMD LED Clear-Blue | LED | 0603 | Everlight | http://www.seeedstudio.com/wiki/images/1/1b/0330060P1.pdf (http://www.seeedstudio.com/wiki/images/2/20/304020016.pdf) | 0.040 | 50 | 2 | 0.20 |  | http://www.seeedstudio.com/depot/OPLopen-parts-library-catalog-c-136_138/#0330060P1
304090075 | BL-HB337A-AV-TRB | SMD LED Clear-Blue | LED | 0402 | Bright | http://www.seeedstudio.com/wiki/images/a/a0/304090075.pdf (http://www.seeedstudio.com/wiki/images/e/ed/304020028.pdf) | 0.060 | 25 | 2 | 0.20 |  | http://www.seeedstudio.com/depot/OPLopen-parts-library-catalog-c-136_138/#304090075
304090062 | 504BW | DIP LED Blue-Blue | LED | Radial-2P-2.54-5mm |  | http://www.seeedstudio.com/wiki/images/b/ba/304020034.pdf | 0.068 | 30 | 2 | 0.20 |  | http://www.seeedstudio.com/depot/OPLopen-parts-library-catalog-c-136_138/#304090062
304090054 | 504BC | DIP LED Transparent-Blue; | LED | Radial-2P-2.54-5mm | Chengguangxing | http://www.seeedstudio.com/wiki/images/1/15/304090054.pdf | 0.068 | 30 | 2 | 0.20 |  | http://www.seeedstudio.com/depot/OPLopen-parts-library-catalog-c-136_138/#304090054
304090016 | 16-219A/T2D-AR2T1QY/3T | SMD LED Yellow-Diffused-Pure White | LED | 0402 | Everlight | http://www.seeedstudio.com/wiki/images/7/72/304090016.pdf (http://www.seeedstudio.com/wiki/File:0310130P1.pdf) | 0.100 | 25 | 2 | 0.20 |  | http://www.seeedstudio.com/depot/OPLopen-parts-library-catalog-c-136_138/#304090016
304090051 | UO504WC | DIP LED Transparent-Orange; | LED | Radial-2P-2.54-5mm | Chengguangxing | http://www.seeedstudio.com/wiki/File:304090051.pdf | 0.068 | 30 | 2 | 0.20 |  | http://www.seeedstudio.com/depot/OPLopen-parts-library-catalog-c-136_138/#304090051
304090058 | 504WC | DIP LED Transparent-White; | LED | Radial-2P-2.54-5mm | Chengguangxing | http://www.seeedstudio.com/wiki/images/5/55/304090058.pdf | 0.068 | 30 | 2 | 0.20 |  | http://www.seeedstudio.com/depot/OPLopen-parts-library-catalog-c-136_138/#304090058
304090053 | 30SVC4A | DIP LED Clear-Purple; | LED | Radial-2P-2.54-3mm | Chengguangxing | http://www.seeedstudio.com/wiki/images/0/05/304090053.pdf | 0.068 | 30 | 2 | 0.20 |  | http://www.seeedstudio.com/depot/OPLopen-parts-library-catalog-c-136_138/#304090053
304090056 | FZR50RGB00T-C | DIP LED RGB Common Anode; | LED | Radial-4P-2.0-5.0mm | CHENGGUANGXING |  | 0.350 | 10 | 2 | 0.20 |  | http://www.seeedstudio.com/depot/OPLopen-parts-library-catalog-c-136_138/#304090056
304090049 | 5050RGB | SMD RGB Hi-Light | Diode | 6P-L5.0*W5.0*H1.5mm | CHENGGUANGXING | http://www.seeedstudio.com/wiki/images/3/30/307010013.pdf | 0.280 | 10 | 6 | 0.60 |  | http://www.seeedstudio.com/depot/OPLopen-parts-library-catalog-c-136_138/#304090049
304060001 | CESD5V0D1 | SMD Diode ESD 6.2V-250mW; | Diode | SOD-123 | JCET | http://www.seeedstudio.com/wiki/images/4/4d/304060001.pdf (http://www.seeedstudio.com/wiki/images/f/ff/307010010.pdf) | 0.050 | 50 | 2 | 0.20 |  | http://www.seeedstudio.com/depot/OPLopen-parts-library-catalog-c-136_138/#304060001
304060003 | CESD3V3AP | SMD Diode ESD 3.3V-225mW; | Diode | SOT-23 | JCET | http://www.seeedstudio.com/wiki/images/0/06/304060003.pdf | 0.080 | 25 | 2 | 0.20 |  | http://www.seeedstudio.com/depot/OPLopen-parts-library-catalog-c-136_138/#304060003
304010008 | 1N4004 | DIP Diode 400V-1A;DO-41 | Diode | DO-41 | MIC |  | 0.015 | 100 | 2 | 0.20 |  | http://www.seeedstudio.com/depot/OPLopen-parts-library-catalog-c-136_138/#304010008
304040011 | LL4148ST | SMD Diode Switching 75V-200mA;LL-34 | Diode | LL-34 | ST | http://www.seeedstudio.com/wiki/images/7/7f/1030060P1.pdf | 0.010 | 100 | 2 | 0.20 |  | http://www.seeedstudio.com/depot/OPLopen-parts-library-catalog-c-136_138/#304040011
304050003 | CESD5V0AP | SMD Diode TVS 5V-225mW | Diode | SOT-23 | JCET | http://www.seeedstudio.com/wiki/images/0/08/304050003.pdf | 0.070 | 25 | 3 | 0.30 |  | http://www.seeedstudio.com/depot/OPLopen-parts-library-catalog-c-136_138/#304050003
304020016 | BAT54C-215 | SMD Diode Schottky 30V-200mA | Diode | SOT-23 | NXP | http://www.seeedstudio.com/wiki/images/2/20/304020016.pdf (http://www.seeedstudio.com/wiki/images/f/f7/310010010.pdf) | 0.020 | 50 | 3 | 0.30 |  | http://www.seeedstudio.com/depot/OPLopen-parts-library-catalog-c-136_138/#304020016
304020028 | MBR0520LT1G | SMD Diode Schottky 20V-500mA | Diode | SOD-123 | ON Semiconductor | http://www.seeedstudio.com/wiki/images/e/ed/304020028.pdf | 0.080 | 25 | 2 | 0.20 |  | http://www.seeedstudio.com/depot/OPLopen-parts-library-catalog-c-136_138/#304020028
304020034 | B5819W | SMD Diode Schottky 20V-1A;SOD-123 | Diode | SOD-123 | Micro Commercial Components | http://www.seeedstudio.com/wiki/images/b/ba/304020034.pdf (http://www.seeedstudio.com/wiki/images/4/42/310010023.pdf) | 0.060 | 25 | 2 | 0.20 |  | http://www.seeedstudio.com/depot/OPLopen-parts-library-catalog-c-136_138/#304020034
304020027 | 1N5819 | SMD Diode Schottky 40V-1A | Diode | DO-214AC |  | http://www.seeedstudio.com/wiki/images/4/45/0300070P1.pdf (http://www.seeedstudio.com/wiki/images/c/c1/310010053.pdf) | 0.030 | 50 | 2 | 0.20 |  | http://www.seeedstudio.com/depot/OPLopen-parts-library-catalog-c-136_138/#0300070P1
304020021 | SS54B | SMD Diode Schottky 28V-5A | Diode | SMB | JCET | http://www.seeedstudio.com/wiki/File:0310130P1.pdf (http://www.seeedstudio.com/wiki/images/0/0b/310030121.pdf) | 0.250 | 10 | 2 | 0.20 |  | http://www.seeedstudio.com/depot/OPLopen-parts-library-catalog-c-136_138/#0310130P1
304010013 | 1N4007 | DIODE GEN PURPOSE 1KV 1A | Diode | DO-214AC | JCET | http://www.seeedstudio.com/wiki/images/2/24/0300040P1.PDF (http://www.seeedstudio.com/wiki/images/6/69/310030009.pdf) | 0.020 | 100 | 2 | 0.20 |  | http://www.seeedstudio.com/depot/OPLopen-parts-library-catalog-c-136_138/#0300040P1
304040016 | 1N4148 | SMD Diode Switch 1N4148; | Diode | LL-34 | JCET | http://www.seeedstudio.com/wiki/images/6/67/0300060P1.pdf | 0.015 | 100 | 2 | 0.20 |  | http://www.seeedstudio.com/depot/OPLopen-parts-library-catalog-c-136_138/#0300060P1
304020032 | SS0520-7-F | SMD Diode Schottky 20V-500mA; | Diode | SOD-123 |  | http://www.seeedstudio.com/wiki/images/b/bb/0390030P1.pdf | 0.130 | 20 | 2 | 0.20 |  | http://www.seeedstudio.com/depot/OPLopen-parts-library-catalog-c-136_138/#0390030P1
307010001 | KT8-1000SMD1206 | SMD PPTC 1000mA-8V | Fuse | 1206 | TIANRUI | http://www.seeedstudio.com/wiki/images/0/0c/0900020P1.pdf (http://www.seeedstudio.com/wiki/images/d/d3/1310480P1.pdf) | 0.160 | 20 | 2 | 0.20 |  | http://www.seeedstudio.com/depot/OPLopen-parts-library-catalog-c-136_138/#0900020P1
307010013 | KT13-0750SMD | SMD PPTC 750mA-13.2V | Fuse | 1206 | Bourns | http://www.seeedstudio.com/wiki/images/3/30/307010013.pdf (http://www.seeedstudio.com/wiki/images/a/a7/310030006.pdf) | 0.250 | 10 | 2 | 0.20 |  | http://www.seeedstudio.com/depot/OPLopen-parts-library-catalog-c-136_138/#307010013
307010010 | SMD1210R075SF | SMD PPTC 750mA-6V | Fuse | 1210 | Darong | http://www.seeedstudio.com/wiki/images/f/ff/307010010.pdf (http://www.seeedstudio.com/wiki/images/4/4f/310030148.pdf) | 0.150 | 20 | 2 | 0.20 |  | http://www.seeedstudio.com/depot/OPLopen-parts-library-catalog-c-136_138/#307010010
307010007 |  | SMD PPTC-500mA-15V | Fuse | 1812 | TIANRUI | http://www.seeedstudio.com/wiki/images/d/df/0900390P1.pdf | 0.120 | 20 | 2 | 0.20 |  | http://www.seeedstudio.com/depot/OPLopen-parts-library-catalog-c-136_138/#0900390P1
307010002 |  | PPTC-500mA | Fuse | 1206 | TIANRUI | http://www.seeedstudio.com/wiki/images/5/51/0900030P1.pdf (http://www.seeedstudio.com/wiki/images/9/99/1310170P1.pdf) | 0.120 | 20 | 2 | 0.20 |  | http://www.seeedstudio.com/depot/OPLopen-parts-library-catalog-c-136_138/#0900030P1
310010049 | ATMEGA328P-AU | IC MCU 8Bit 32KB ISP flash 20MHz 1.8v-5.5v | IC | 32-TQFP | Atmel | http://www.seeedstudio.com/wiki/images/7/7f/1030060P1.pdf | 2.500 | 1 | 32 | 3.20 |  | http://www.seeedstudio.com/depot/OPLopen-parts-library-catalog-c-136_138/#1030060P1
310010051 | ATMEGA328P-PU | IC MCU 8Bit 32KB ISP flash 20MHz 1.8v-5.5v | IC | 28-DIP | Atmel | http://www.seeedstudio.com/wiki/images/0/0e/1030050P1.pdf | 3.000 | 1 | 28 | 2.80 |  | http://www.seeedstudio.com/depot/OPLopen-parts-library-catalog-c-136_138/#1030050P1
310010010 | ATMEGA32U4-AU | IC MCU 8Bit 32KB ISP flash&USB controller 16MHz 2.7v-5.5v | IC | TQFP-44 | Atmel | http://www.seeedstudio.com/wiki/images/f/f7/310010010.pdf (http://www.seeedstudio.com/wiki/File:1320040P1.pdf) | 5.400 | 1 | 10 | 1.00 |  | http://www.seeedstudio.com/depot/OPLopen-parts-library-catalog-c-136_138/#310010010
310010006 | ATMEGA2560-16AU | IC MCU 8Bit 256kB ISP Flash 4kB EEPROM 86 I/O Pin 16MHz 4.5v-5.5v | IC | TQFP-100 | Atmel | http://www.seeedstudio.com/wiki/images/e/e3/310010006.pdf | 12.000 | 1 | 25 | 2.50 |  | http://www.seeedstudio.com/depot/OPLopen-parts-library-catalog-c-136_138/#310010006
310010023 | ATMEGA8A-AU | IC MCU 8Bit 8KB ISP Flash 512B EEPROM 1KB SRAM 16MHz 2.7v-5.5v | IC | TQFP-32 | Atmel | http://www.seeedstudio.com/wiki/images/4/42/310010023.pdf (http://www.seeedstudio.com/wiki/images/a/ae/310050019.pdf) | 1.800 | 2 | 8 | 0.80 |  | http://www.seeedstudio.com/depot/OPLopen-parts-library-catalog-c-136_138/#310010023
310010053 | LPC11U35FHI33/501 | ARM MCU 32Bit Cortex-M0 64KB Flash 12KB SRAM 3.3v | IC | HVQFN-32 | NXP | http://www.seeedstudio.com/wiki/images/c/c1/310010053.pdf (http://www.seeedstudio.com/wiki/images/0/04/310050042.pdf) | 5.000 | 1 | 10 | 1.00 |  | http://www.seeedstudio.com/depot/OPLopen-parts-library-catalog-c-136_138/#310010053
310030121 | MP1496DJ | SMD PMIC;DC-DC;Vin 4.5-16V;Adj;2A;500K;N-Sync;Buck;1-Ch | IC | TSOT23-8 | Monolithic Power Systems | http://www.seeedstudio.com/wiki/images/0/0b/310030121.pdf (http://www.seeedstudio.com/wiki/images/9/93/310040002.pdf) | 0.500 | 5 | 8 | 0.80 |  | http://www.seeedstudio.com/depot/OPLopen-parts-library-catalog-c-136_138/#310030121
310030009 | XC6206P302MR | SMD PMIC;LDO;Vin 6V;3.0V;200mA;Without En;1-Ch | IC | SOT-23 | Torex | http://www.seeedstudio.com/wiki/images/6/69/310030009.pdf (http://www.seeedstudio.com/wiki/images/4/4d/310040021.pdf) | 0.150 | 10 | 3 | 0.30 |  | http://www.seeedstudio.com/depot/OPLopen-parts-library-catalog-c-136_138/#310030009
310030014 | XC6206P252MR-G | SMD PMIC;LDO;Vin 6V;2.5V;200mA;Without En;1-Ch | IC | SOT-23 | Torex | http://www.seeedstudio.com/wiki/images/6/69/310030009.pdf | 0.150 | 10 | 3 | 0.30 |  | http://www.seeedstudio.com/depot/OPLopen-parts-library-catalog-c-136_138/#310030014
310030099 | XC6206P332MR-G | SMD PMIC;LDO;Vin 6V;3.3V;200mA;Without En;1-Ch | IC | SOT-23 | TOREX | http://www.seeedstudio.com/wiki/images/7/71/1300260P1.pdf | 0.120 | 20 | 3 | 0.30 |  | http://www.seeedstudio.com/depot/OPLopen-parts-library-catalog-c-136_138/#1300260P1
310030046 | XC6204B332MR | SMD PMIC;LDO;Vin 10V;3.3V;150mA;With En;1-Ch | IC | SOT-25 | Torex Semiconductor Ltd | http://www.seeedstudio.com/wiki/images/d/d3/1310480P1.pdf | 0.160 | 10 | 5 | 0.50 |  | http://www.seeedstudio.com/depot/OPLopen-parts-library-catalog-c-136_138/#131048001
310030006 | LM317EMP | SMD PMIC;LDO;Vin 40V;Adj;1A;Without En;1-Ch | IC | SOT-223 | TI | http://www.seeedstudio.com/wiki/images/a/a7/310030006.pdf (http://www.seeedstudio.com/wiki/images/e/e3/310020002.pdf) | 1.000 | 2 | 5 | 0.50 |  | http://www.seeedstudio.com/depot/OPLopen-parts-library-catalog-c-136_138/#310030006
310030148 | ETA3406S2F-T | SMD PMIC;DC-DC;Vin 2.6-6V;Adj;1.2A;1.5M;Sync;Buck;1-Ch | IC | SOT23-5 | ETA solution | http://www.seeedstudio.com/wiki/images/4/4f/310030148.pdf (http://www.seeedstudio.com/wiki/images/f/f4/310020016.pdf) | 0.150 | 10 | 5 | 0.50 |  | http://www.seeedstudio.com/depot/OPLopen-parts-library-catalog-c-136_138/#310030148
310030104 | AIC1896GG | SMD PMIC;DC-DC;Vin 2.5-10V;Adj;200mA;1.4M;Boost;1-Ch | IC | SOT23-6 | AIC | http://www.seeedstudio.com/wiki/images/c/ca/310020015.pdf | 0.500 | 3 | 3 | 0.30 |  | http://www.seeedstudio.com/depot/OPLopen-parts-library-catalog-c-136_138/#310030104
310030096 | CJT1117-5.0 | SMD PMIC; LDO;Vin 7V;5V;1A;Without En;1-Ch | IC | SOT-223 | JCET | http://www.seeedstudio.com/wiki/images/9/99/1310170P1.pdf (http://www.seeedstudio.com/wiki/images/1/15/310070024.pdf) | 0.150 | 10 | 4 | 0.40 |  | http://www.seeedstudio.com/depot/OPLopen-parts-library-catalog-c-136_138/#1310170P1
310030097 | CJT1117-3.3 | SMD PMIC; LDO;Vin 5V;3.3V;1A;Without En;1-Ch | IC | SOT-223 | JCET | http://www.seeedstudio.com/wiki/images/a/a5/1310190P1.pdf (http://www.seeedstudio.com/wiki/images/c/ca/310070025.pdf) | 0.150 | 10 | 4 | 0.40 |  | http://www.seeedstudio.com/depot/OPLopen-parts-library-catalog-c-136_138/#1310190P1
310030095 | CJA1117B-3.3 | SMD PMIC; LDO;Vin 5.3V;3.3V;1A;Without En;1-Ch | IC | SOT-89 | JCET | http://www.seeedstudio.com/wiki/images/b/b9/1310120P1.pdf (http://www.seeedstudio.com/wiki/images/4/46/1720010P1.pdf) | 0.150 | 10 | 4 | 0.40 |  | http://www.seeedstudio.com/depot/OPLopen-parts-library-catalog-c-136_138/#1310120P1
310030101 | CN3065 | SMD PMIC;Liner;Li-Ion/Pol;Charge;4.2V;1-cell | IC | 8-DFN | CONSONANCE | http://www.seeedstudio.com/wiki/File:1320040P1.pdf | 0.700 | 3 | 16 | 1.60 |  | http://www.seeedstudio.com/depot/OPLopen-parts-library-catalog-c-136_138/#1320040P1
310030100 | CJ78M05 | SMD PMIC;LDO;Vin 25V;5V;0.5A;Without En;1-Ch | IC | TO-252 | JCET | http://www.seeedstudio.com/wiki/images/a/a7/1300040P1.pdf (http://www.seeedstudio.com/wiki/images/1/1d/310110008.pdf) | 0.150 | 10 | 3 | 0.30 |  | http://www.seeedstudio.com/depot/OPLopen-parts-library-catalog-c-136_138/#1300040P1
310050019 | SN74LVC1G125DCKR | SMD IC Logic | IC | SC-70-5 | TI | http://www.seeedstudio.com/wiki/images/a/ae/310050019.pdf (http://www.seeedstudio.com/wiki/images/8/81/303010016.pdf) | 0.100 | 20 | 2 | 0.20 |  | http://www.seeedstudio.com/depot/OPLopen-parts-library-catalog-c-136_138/#310050019
310050042 | 74VHC125MTCX | SMD IC Logic; | IC | TSSOP-14 | Fairchild | http://www.seeedstudio.com/wiki/images/0/04/310050042.pdf | 0.200 | 10 | 5 | 0.50 |  | http://www.seeedstudio.com/depot/OPLopen-parts-library-catalog-c-136_138/#310050042
310040002 | TM1636 | DIP IC Driver; | IC | DIP-18 | TITAN | http://www.seeedstudio.com/wiki/images/9/93/310040002.pdf | 0.250 | 10 | 18 | 1.80 |  | http://www.seeedstudio.com/depot/OPLopen-parts-library-catalog-c-136_138/#310040002
310040021 | RT9167A-33PB | SMD IC Driver; | IC | SOT23-5 | RichTek | http://www.seeedstudio.com/wiki/images/4/4d/310040021.pdf (http://www.seeedstudio.com/wiki/images/2/23/308020000.pdf) | 0.250 | 10 | 4 | 0.40 |  | http://www.seeedstudio.com/depot/OPLopen-parts-library-catalog-c-136_138/#310040021
310040018 | L298P | SMD IC Driver; | IC | PowerSO-20 | ST | http://www.seeedstudio.com/wiki/images/6/66/310040018.pdf (http://www.seeedstudio.com/wiki/images/d/d4/315030000.pdf) | 5.000 | 1 | 10 | 1.00 |  | http://www.seeedstudio.com/depot/OPLopen-parts-library-catalog-c-136_138/#310040018
310020019 | LMV324IDR | SMD IC Amplifier; IC OPAMP GP R-R 1MHZ QUAD | IC | 14-SOIC | Texas Instruments | http://www.seeedstudio.com/wiki/images/4/44/1100030P1.pdf | 0.220 | 10 | 14 | 1.40 |  | http://www.seeedstudio.com/depot/OPLopen-parts-library-catalog-c-136_138/#1100030P1
310020021 | LM358DR | SMD IC Amplifier;IC OPAMP GP 700KHZ DUAL | IC | 8-SOIC | Texas Instruments | http://www.seeedstudio.com/wiki/images/1/1a/1110010P1.pdf (http://www.seeedstudio.com/wiki/images/0/06/301010000.pdf) | 0.100 | 20 | 8 | 0.80 |  | http://www.seeedstudio.com/depot/OPLopen-parts-library-catalog-c-136_138/#1110010P1
310020002 | LMV358ID | SMD IC Amplifier;DUAL, 1MHz, 2.7 V ~ 5.5 V,140uA | IC | SOIC-8 | TI | http://www.seeedstudio.com/wiki/images/e/e3/310020002.pdf (http://www.seeedstudio.com/wiki/images/0/06/301010000.pdf) | 0.200 | 10 | 3 | 0.30 |  | http://www.seeedstudio.com/depot/OPLopen-parts-library-catalog-c-136_138/#310020002
310020016 | LM293D | SMD IC Amplifier; DAUL diff COMPARATOR, 2-36V | IC | SOIC-8 | TI | http://www.seeedstudio.com/wiki/images/f/f4/310020016.pdf (http://www.seeedstudio.com/wiki/images/2/28/301010113.pdf) | 0.150 | 10 | 3 | 0.30 |  | http://www.seeedstudio.com/depot/OPLopen-parts-library-catalog-c-136_138/#310020016
310020015 | LM2904DR | SMD IC Amplifier;OPAMP GP 700KHZ,1mA,3 V ~ 26 V, ±1.5 V ~ 13 V | IC | SOIC-8 | TI | http://www.seeedstudio.com/wiki/images/c/ca/310020015.pdf (http://www.seeedstudio.com/wiki/images/2/28/301010113.pdf) | 0.150 | 10 | 3 | 0.30 |  | http://www.seeedstudio.com/depot/OPLopen-parts-library-catalog-c-136_138/#310020015
310070024 | MCP2551-I/SN | SMD IC Interface | IC | 8-SOIC | Microchip | http://www.seeedstudio.com/wiki/images/1/15/310070024.pdf (http://www.seeedstudio.com/wiki/images/6/67/301010405.pdf) | 0.800 | 3 | 3 | 0.30 |  | http://www.seeedstudio.com/depot/OPLopen-parts-library-catalog-c-136_138/#310070024
310070025 | MCP2515T-I/SO | SMD IC Interface; | IC | 18-SOIC | Microchip | http://www.seeedstudio.com/wiki/images/c/ca/310070025.pdf (http://www.seeedstudio.com/wiki/images/2/28/301010113.pdf) | 1.000 | 3 | 6 | 0.60 |  | http://www.seeedstudio.com/depot/OPLopen-parts-library-catalog-c-136_138/#310070025
310070022 | FT232RL | IC USB FS SERIAL UART | IC | 28-SSOP | FTDI | http://www.seeedstudio.com/wiki/images/4/46/1720010P1.pdf | 3.500 | 1 | 28 | 2.80 |  | http://www.seeedstudio.com/depot/OPLopen-parts-library-catalog-c-136_138/#1720010P1
310110010 | DS1307ZN | IC RTC SERIAL 512K IND | IC | 8-SOIC | Maxim Integrated | http://www.seeedstudio.com/wiki/images/3/38/1900100P1.pdf (http://www.seeedstudio.com/wiki/images/6/63/PYu-RC0805_51_RoHS_L_v5.pdf) | 1.300 | 2 | 8 | 0.80 |  | http://www.seeedstudio.com/depot/OPLopen-parts-library-catalog-c-136_138/#1900100P1
310110008 | DS1337S+ | SMD IC Clock/Timing | IC | SOIC-8 | Maxim Integrated | http://www.seeedstudio.com/wiki/images/1/1d/310110008.pdf | 1.000 | 3 | 8 | 0.80 |  | http://www.seeedstudio.com/depot/OPLopen-parts-library-catalog-c-136_138/#310110008
303010016 | CSAB0630-100M | SMD Inductor 10uH-20%;SMD-2P-L6.0*W6.0*H3.0mm | Inductor | SMD-2P-L6.0*W6.0*H3.0mm | CODACA | http://www.seeedstudio.com/wiki/images/8/81/303010016.pdf (http://www.seeedstudio.com/wiki/images/6/63/PYu-RC0805_51_RoHS_L_v5.pdf) | 0.500 | 5 | 2 | 0.20 |  | http://www.seeedstudio.com/depot/OPLopen-parts-library-catalog-c-136_138/#303010016
303010015 | SPD3D16-4R7M | SMD Power Inductor 4.7uH-20%-750mA | Inductor | SMD-2P-3.9X3.9X2.0H | CODACA | http://www.seeedstudio.com/wiki/images/5/5d/0210410P1.PDF (http://www.seeedstudio.com/wiki/images/2/28/301010113.pdf) | 0.400 | 5 | 2 | 0.20 |  | http://www.seeedstudio.com/depot/OPLopen-parts-library-catalog-c-136_138/#0210410P1
303030001 | BLM18AG121SN1D | SMD FERRITE CHIP 120 OHM 500MA | Inductor | 0603 | Murata | http://www.seeedstudio.com/wiki/images/e/ea/0900120P1.pdf | 0.015 | 100 | 2 | 0.20 |  | http://www.seeedstudio.com/depot/OPLopen-parts-library-catalog-c-136_138/#0900120P1
308020000 | LY190-128064 | OLED-128*64;27P-0.6-L26.7*W19.26*H1.3mm | Display | 128*64;27P-0.6-L26.7*W19.26*H1.3mm | Liyuan | http://www.seeedstudio.com/wiki/images/2/23/308020000.pdf | 5.000 | 1 | 0 | 0.00 |  | http://www.seeedstudio.com/depot/OPLopen-parts-library-catalog-c-136_138/#308020000
315030000 | HLS8L-DC5V-S-C | DIP Power Relay 5V-7A; | Relay | 5P-L19.0*W15.0*H15.0mm | HELISHUN | http://www.seeedstudio.com/wiki/images/d/d4/315030000.pdf (http://www.seeedstudio.com/wiki/images/6/63/PYu-RC0805_51_RoHS_L_v5.pdf) | 0.500 | 5 | 8 | 0.80 |  | http://www.seeedstudio.com/depot/OPLopen-parts-library-catalog-c-136_138/#315030000
301010292 | RC0603JR-070RL | SMD RES 0R-5%-1/10W | Resistor | 0603 | YAGEO | http://www.seeedstudio.com/wiki/images/0/01/0010070P1.pdf | 0.010 | 100 | 2 | 0.20 |  | http://www.seeedstudio.com/depot/OPLopen-parts-library-catalog-c-136_138/#0010070P1
301010000 | RC0402JR-070RL | SMD RES 0R-5%-1/16W | Resistor | 0402 | YAGEO | http://www.seeedstudio.com/wiki/images/0/06/301010000.pdf | 0.010 | 100 | 2 | 0.20 |  | http://www.seeedstudio.com/depot/OPLopen-parts-library-catalog-c-136_138/#301010000
301010076 | RC0402JR-071R5L | SMD RES 1.5R-5%-1/16W | Resistor | 0402 | YAGEO | http://www.seeedstudio.com/wiki/images/0/06/301010000.pdf (http://www.seeedstudio.com/wiki/images/6/63/PYu-RC0805_51_RoHS_L_v5.pdf) | 0.010 | 100 | 2 | 0.20 |  | http://www.seeedstudio.com/depot/OPLopen-parts-library-catalog-c-136_138/#301010076
301010096 | RC0603JR-0710RL | SMD RES 10R-5%-1/10W | Resistor | 0603 | YAGEO | http://www.seeedstudio.com/wiki/images/2/28/301010113.pdf (http://www.seeedstudio.com/wiki/images/6/63/PYu-RC0805_51_RoHS_L_v5.pdf) | 0.030 | 50 | 2 | 0.20 |  | http://www.seeedstudio.com/depot/OPLopen-parts-library-catalog-c-136_138/#301010096
301010185 | RC0603FR-0710RL | SMD RES 10R-1%-1/10W | Resistor | 0603 | YAGEO | http://www.seeedstudio.com/wiki/images/2/28/301010113.pdf | 0.010 | 100 | 2 | 0.20 |  | http://www.seeedstudio.com/depot/OPLopen-parts-library-catalog-c-136_138/#301010185
301010405 | RC1206JR-0713RL | SMD RES 13R-5%-1/4W | Resistor | 1206 | YAGEO | http://www.seeedstudio.com/wiki/images/6/67/301010405.pdf | 0.015 | 100 | 2 | 0.20 |  | http://www.seeedstudio.com/depot/OPLopen-parts-library-catalog-c-136_138/#301010405
301010231 | RC0603JR-0715RL | SMD RES 15R-5%-1/10W;0603 | Resistor | 0603 | YAGEO | http://www.seeedstudio.com/wiki/images/2/28/301010113.pdf (http://www.seeedstudio.com/wiki/images/6/63/PYu-RC0805_51_RoHS_L_v5.pdf) | 0.010 | 100 | 2 | 0.20 |  | http://www.seeedstudio.com/depot/OPLopen-parts-library-catalog-c-136_138/#301010231
301010289 | RC0603JR-0722RL | SMD RES 22R-5%-1/10W | Resistor | 0603 | YAGEO | http://www.seeedstudio.com/wiki/images/9/99/0010010P1.pdf | 0.010 | 100 | 2 | 0.20 |  | http://www.seeedstudio.com/depot/OPLopen-parts-library-catalog-c-136_138/#0010010P1
301010329 | RC0805JR-0722RL | SMD RES 22R-5%-1/8W | Resistor | 0805 | YAGEO | http://www.seeedstudio.com/wiki/images/6/63/PYu-RC0805_51_RoHS_L_v5.pdf | 0.010 | 100 | 2 | 0.20 |  | http://www.seeedstudio.com/depot/OPLopen-parts-library-catalog-c-136_138/#301010329
301010296 | RC0603FR-0749R9L | SMD RES 49.9R-1%-1/10W | Resistor | 0603 | YAGEO | http://www.seeedstudio.com/wiki/images/5/56/001057001.pdf (http://www.seeedstudio.com/wiki/images/2/28/301010113.pdf) | 0.010 | 100 | 2 | 0.20 |  | http://www.seeedstudio.com/depot/OPLopen-parts-library-catalog-c-136_138/#0010570P1
301010326 | RC0805JR-0768RL | SMD RES 68R-5%-1/8W | Resistor | 0805 | YAGEO | http://www.seeedstudio.com/wiki/images/6/63/PYu-RC0805_51_RoHS_L_v5.pdf (http://www.seeedstudio.com/wiki/images/2/28/301010113.pdf) | 0.010 | 100 | 2 | 0.20 |  | http://www.seeedstudio.com/depot/OPLopen-parts-library-catalog-c-136_138/#301010326
301010085 | RC0603JR-0768RL | SMD RES 68R-5%-1/10W | Resistor | 0603 | YAGEO | http://www.seeedstudio.com/wiki/images/2/28/301010113.pdf (http://www.seeedstudio.com/wiki/images/6/63/PYu-RC0805_51_RoHS_L_v5.pdf) | 0.025 | 50 | 2 | 0.20 |  | http://www.seeedstudio.com/depot/OPLopen-parts-library-catalog-c-136_138/#301010085
301010294 | RC0603JR-0775RL | SMD RES 75R-5%-1/10W | Resistor | 0603 | YAGEO | http://www.seeedstudio.com/wiki/images/f/f2/001022001.pdf | 0.010 | 100 | 2 | 0.20 |  | http://www.seeedstudio.com/depot/OPLopen-parts-library-catalog-c-136_138/#0010220P1
301010412 | RC1206JR-07100RL | SMD RES 100R-5%-1/4W | Resistor | 1206 | YAGEO | http://www.seeedstudio.com/wiki/images/f/f8/0030110P1.pdf (http://www.seeedstudio.com/wiki/images/0/06/301010000.pdf) | 0.010 | 100 | 2 | 0.20 |  | http://www.seeedstudio.com/depot/OPLopen-parts-library-catalog-c-136_138/#0030110P1
301010319 | RC0805JR-07100RL | SMD RES 100R-5%-1/8W | Resistor | 0805 | YAGEO | http://www.seeedstudio.com/wiki/images/6/63/PYu-RC0805_51_RoHS_L_v5.pdf (http://www.seeedstudio.com/wiki/images/3/38/301030012.pdf) | 0.010 | 100 | 2 | 0.20 |  | http://www.seeedstudio.com/depot/OPLopen-parts-library-catalog-c-136_138/#301010319
301010090 | RC0603JR-07100RL | SMD RES 100R-5%-1/10W | Resistor | 0603 | YAGEO | http://www.seeedstudio.com/wiki/images/a/a6/301040009.pdf | 0.010 | 100 | 2 | 0.20 |  | http://www.seeedstudio.com/depot/OPLopen-parts-library-catalog-c-136_138/#301010090
301010028 | RC0402JR-07100RL | SMD RES 100R-5%-1/16W | Resistor | 0402 | YAGEO | http://www.seeedstudio.com/wiki/images/0/06/301010000.pdf (http://www.seeedstudio.com/wiki/images/2/28/301010113.pdf) | 0.010 | 100 | 2 | 0.20 |  | http://www.seeedstudio.com/depot/OPLopen-parts-library-catalog-c-136_138/#301010028
301010351 | RC0805JR-07120RL | SMD RES 120R-5%-1/8W | Resistor | 0805 | YAGEO | http://www.seeedstudio.com/wiki/images/6/63/PYu-RC0805_51_RoHS_L_v5.pdf (http://www.seeedstudio.com/wiki/images/2/28/301010113.pdf) | 0.010 | 100 | 2 | 0.20 |  | http://www.seeedstudio.com/depot/OPLopen-parts-library-catalog-c-136_138/#301010351
301010315 | RC0805JR-07220RL | SMD RES 220R-5%-1/8W | Resistor | 0805 | YAGEO | http://www.seeedstudio.com/wiki/images/6/63/PYu-RC0805_51_RoHS_L_v5.pdf | 0.010 | 100 | 2 | 0.20 |  | http://www.seeedstudio.com/depot/OPLopen-parts-library-catalog-c-136_138/#301010315
301010163 | RC0603JR-07220RL | SMD RES 220R-5%-1/10W | Resistor | 0603 | YAGEO | http://www.seeedstudio.com/wiki/images/2/28/301010113.pdf | 0.010 | 100 | 2 | 0.20 |  | http://www.seeedstudio.com/depot/OPLopen-parts-library-catalog-c-136_138/#301010163
301010300 | RC0603FR-07330RL | SMD RES 330R-1%-1/10W | Resistor | 0603 | YAGEO | http://www.seeedstudio.com/wiki/images/0/03/001133001.pdf (http://www.seeedstudio.com/wiki/images/6/63/PYu-RC0805_51_RoHS_L_v5.pdf) | 0.010 | 100 | 2 | 0.20 |  | http://www.seeedstudio.com/depot/OPLopen-parts-library-catalog-c-136_138/#0011330P1
301010320 | RC0805JR-07390RL | SMD RES 390R-5%-1/8W | Resistor | 0805 | YAGEO | http://www.seeedstudio.com/wiki/images/6/63/PYu-RC0805_51_RoHS_L_v5.pdf (http://www.seeedstudio.com/wiki/images/2/28/301010113.pdf) | 0.010 | 100 | 2 | 0.20 |  | http://www.seeedstudio.com/depot/OPLopen-parts-library-catalog-c-136_138/#301010320
301010297 | RC0603JR-07390RL | SMD RES 390R-5%-1/10W | Resistor | 0603 | YAGEO | http://www.seeedstudio.com/wiki/images/2/23/001060001.pdf (http://www.seeedstudio.com/wiki/images/6/63/PYu-RC0805_51_RoHS_L_v5.pdf) | 0.010 | 100 | 2 | 0.20 |  | http://www.seeedstudio.com/depot/OPLopen-parts-library-catalog-c-136_138/#0010600P1
301010088 | RC0603JR-07470RL | SMD RES 470R-5%-1/10W;0603 | Resistor | 0603 | YAGEO | http://www.seeedstudio.com/wiki/images/6/63/PYu-RC0805_51_RoHS_L_v5.pdf | 0.010 | 100 | 2 | 0.20 |  | http://www.seeedstudio.com/depot/OPLopen-parts-library-catalog-c-136_138/#301010088
301010157 | RC0603JR-07510RL | SMD RES 510R-5%-1/10W | Resistor | 0603 | YAGEO | http://www.seeedstudio.com/wiki/images/2/28/301010113.pdf | 0.025 | 50 | 2 | 0.20 |  | http://www.seeedstudio.com/depot/OPLopen-parts-library-catalog-c-136_138/#301010157
301010210 | RC0603JR-07620RL | SMD RES 620R-5%-1/10W | Resistor | 0603 | YAGEO | http://www.seeedstudio.com/wiki/images/2/28/301010113.pdf (http://www.seeedstudio.com/wiki/images/6/63/PYu-RC0805_51_RoHS_L_v5.pdf) | 0.025 | 50 | 2 | 0.20 |  | http://www.seeedstudio.com/depot/OPLopen-parts-library-catalog-c-136_138/#301010210
301010311 | RC0805JR-071KL | SMD RES 1K-5%-1/8W | Resistor | 0805 | YAGEO | http://www.seeedstudio.com/wiki/images/6/63/PYu-RC0805_51_RoHS_L_v5.pdf (http://www.seeedstudio.com/wiki/images/2/28/301010113.pdf) | 0.010 | 100 | 2 | 0.20 |  | http://www.seeedstudio.com/depot/OPLopen-parts-library-catalog-c-136_138/#301010311
301010298 | RC0603FR-071KL | SMD RES 1K-1%-1/10W | Resistor | 0603 | YAGEO | http://www.seeedstudio.com/wiki/images/c/c7/001109001.pdf (http://www.seeedstudio.com/wiki/images/0/06/301010000.pdf) | 0.010 | 100 | 2 | 0.20 |  | http://www.seeedstudio.com/depot/OPLopen-parts-library-catalog-c-136_138/#0011090P1
301010006 | RC0402JR-071KL | SMD RES 1K-5%-1/16W | Resistor | 0402 | YAGEO | http://www.seeedstudio.com/wiki/images/0/06/301010000.pdf | 0.010 | 100 | 2 | 0.20 |  | http://www.seeedstudio.com/depot/OPLopen-parts-library-catalog-c-136_138/#301010006
301030012 | Chip Array Series 1%,5% | SMD RES Array 1k-4R | Resistor | 1206-8 | Royalohm | http://www.seeedstudio.com/wiki/images/3/38/301030012.pdf | 0.020 | 100 | 2 | 0.20 |  | http://www.seeedstudio.com/depot/OPLopen-parts-library-catalog-c-136_138/#301030012
301040014 | SX3362P | DIP VR Top Adj 1K-3362P | Resistor | 3P-L7.0*W7.0*H5.0mm | BEST | http://www.seeedstudio.com/wiki/images/a/a6/301040009.pdf (http://www.seeedstudio.com/wiki/images/6/63/PYu-RC0805_51_RoHS_L_v5.pdf) | 0.400 | 5 | 3 | 0.30 |  | http://www.seeedstudio.com/depot/OPLopen-parts-library-catalog-c-136_138/#301040014
301010115 | RC0603JR-071K1L | SMD RES 1.1K-5%-1/10W | Resistor | 0603 | YAGEO | http://www.seeedstudio.com/wiki/images/2/28/301010113.pdf | 0.025 | 50 | 2 | 0.20 |  | http://www.seeedstudio.com/depot/OPLopen-parts-library-catalog-c-136_138/#301010115
301010206 | RC0603FR-071K2L | SMD RES 1.2K-1%-1/10W | Resistor | 0603 | YAGEO | http://www.seeedstudio.com/wiki/images/2/28/301010113.pdf | 0.010 | 100 | 2 | 0.20 |  | http://www.seeedstudio.com/depot/OPLopen-parts-library-catalog-c-136_138/#301010206
301010394 | RC0805FR-071K5L | SMD RES 1.5K-1%-1/8W | Resistor | 0805 | YAGEO | http://www.seeedstudio.com/wiki/images/6/63/PYu-RC0805_51_RoHS_L_v5.pdf | 0.010 | 100 | 2 | 0.20 |  | http://www.seeedstudio.com/depot/OPLopen-parts-library-catalog-c-136_138/#301010394
301010189 | RC0603FR-071K5L | SMD RES 1.5K-1%-1/10W | Resistor | 0603 | YAGEO | http://www.seeedstudio.com/wiki/images/2/28/301010113.pdf (http://www.seeedstudio.com/wiki/images/6/63/PYu-RC0805_51_RoHS_L_v5.pdf) | 0.010 | 100 | 2 | 0.20 |  | http://www.seeedstudio.com/depot/OPLopen-parts-library-catalog-c-136_138/#301010189
301010342 | RC0805JR-071K8L | SMD RES 1.8K-5%-1/8W | Resistor | 0805 | YAGEO | http://www.seeedstudio.com/wiki/images/6/63/PYu-RC0805_51_RoHS_L_v5.pdf | 0.010 | 100 | 2 | 0.20 |  | http://www.seeedstudio.com/depot/OPLopen-parts-library-catalog-c-136_138/#301010342
301010254 | RC0603FR-071K8L | SMD RES 1.8K-1%-1/10W | Resistor | 0603 | YAGEO | http://www.seeedstudio.com/wiki/images/2/28/301010113.pdf (http://www.seeedstudio.com/wiki/images/0/06/301010000.pdf) | 0.010 | 100 | 2 | 0.20 |  | http://www.seeedstudio.com/depot/OPLopen-parts-library-catalog-c-136_138/#301010254
301010318 | RC0805JR-072KL | SMD RES 2K-5%-1/8W | Resistor | 0805 | YAGEO | http://www.seeedstudio.com/wiki/images/6/63/PYu-RC0805_51_RoHS_L_v5.pdf | 0.010 | 100 | 2 | 0.20 |  | http://www.seeedstudio.com/depot/OPLopen-parts-library-catalog-c-136_138/#301010318
301010333 | RC0805JR-072K2L | SMD RES 2.2K-5%-1/8W | Resistor | 0805 | YAGEO | http://www.seeedstudio.com/wiki/images/6/63/PYu-RC0805_51_RoHS_L_v5.pdf (http://www.seeedstudio.com/wiki/images/a/a6/301040009.pdf) | 0.010 | 100 | 2 | 0.20 |  | http://www.seeedstudio.com/depot/OPLopen-parts-library-catalog-c-136_138/#301010333
301010170 | RC0603FR-073KL | SMD RES 3K-1%-1/10W | Resistor | 0603 | YAGEO | http://www.seeedstudio.com/wiki/images/2/28/301010113.pdf | 0.010 | 100 | 2 | 0.20 |  | http://www.seeedstudio.com/depot/OPLopen-parts-library-catalog-c-136_138/#301010170
301010331 | RC0805JR-073K3L | SMD RES 3.3K-5%-1/8W | Resistor | 0805 | YAGEO | http://www.seeedstudio.com/wiki/images/6/63/PYu-RC0805_51_RoHS_L_v5.pdf (http://www.seeedstudio.com/wiki/images/0/06/301010000.pdf) | 0.010 | 100 | 2 | 0.20 |  | http://www.seeedstudio.com/depot/OPLopen-parts-library-catalog-c-136_138/#301010331
301010251 | RC0603FR-073K3L | SMD RES 3.3K-1%-1/10W;0603 | Resistor | 0603 | YAGEO | http://www.seeedstudio.com/wiki/images/2/28/301010113.pdf (http://www.seeedstudio.com/wiki/images/6/63/PYu-RC0805_51_RoHS_L_v5.pdf) | 0.010 | 100 | 2 | 0.20 |  | http://www.seeedstudio.com/depot/OPLopen-parts-library-catalog-c-136_138/#301010251
301010035 | RC0402JR-073K3L | SMD RES 3.3K-5%-1/16W | Resistor | 0402 | YAGEO | http://www.seeedstudio.com/wiki/images/0/06/301010000.pdf (http://www.seeedstudio.com/wiki/images/2/28/301010113.pdf) | 0.010 | 100 | 2 | 0.20 |  | http://www.seeedstudio.com/depot/OPLopen-parts-library-catalog-c-136_138/#301010035
301010101 | RC0603JR-073K9L | SMD RES 3.9K-5%-1/10W; | Resistor | 0603 | YAGEO | http://www.seeedstudio.com/wiki/images/2/28/301010113.pdf | 0.010 | 100 | 2 | 0.20 |  | http://www.seeedstudio.com/depot/OPLopen-parts-library-catalog-c-136_138/#301010101
301010290 | RC0603JR-074K7L | SMD RES 4.7K-5%-1/10W | Resistor | 0603 | YAGEO | http://www.seeedstudio.com/wiki/images/c/ce/0010030P1.pdf (http://www.seeedstudio.com/wiki/images/2/28/301010113.pdf) | 0.010 | 100 | 2 | 0.20 |  | http://www.seeedstudio.com/depot/OPLopen-parts-library-catalog-c-136_138/#0010030P1
301010306 | RC0805JR-074K7L | SMD RES 4.7K-5%-1/8W | Resistor | 0805 | YAGEO | http://www.seeedstudio.com/wiki/images/6/63/PYu-RC0805_51_RoHS_L_v5.pdf | 0.010 | 100 | 2 | 0.20 |  | http://www.seeedstudio.com/depot/OPLopen-parts-library-catalog-c-136_138/#301010306
301030003 |  | SMD RES ARRAY 4.7K OHM 4 RES 1206 | Resistor | 1206-8-3.2X1.6 |  | http://www.seeedstudio.com/wiki/images/3/35/0040040P1.pdf (http://www.seeedstudio.com/wiki/images/2/28/301010113.pdf) | 0.020 | 100 | 8 | 0.80 |  | http://www.seeedstudio.com/depot/OPLopen-parts-library-catalog-c-136_138/#0040040P1
301010166 | RC0603JR-075K6L | SMD RES 5.6K-5%-1/10W | Resistor | 0603 | YAGEO | http://www.seeedstudio.com/wiki/images/2/28/301010113.pdf | 0.025 | 50 | 2 | 0.20 |  | http://www.seeedstudio.com/depot/OPLopen-parts-library-catalog-c-136_138/#301010166
301010400 | RC0805JR-078K2L | SMD RES 8.2K-5%-1/8W | Resistor | 0805 | YAGEO | http://www.seeedstudio.com/wiki/images/6/63/PYu-RC0805_51_RoHS_L_v5.pdf (http://www.seeedstudio.com/wiki/images/2/28/301010113.pdf) | 0.010 | 100 | 2 | 0.20 |  | http://www.seeedstudio.com/depot/OPLopen-parts-library-catalog-c-136_138/#301010400
301010361 | RC0805FR-0710KL | SMD RES 10K-1%-1/8W | Resistor | 0805 | YAGEO | http://www.seeedstudio.com/wiki/images/6/63/PYu-RC0805_51_RoHS_L_v5.pdf | 0.020 | 100 | 2 | 0.20 |  | http://www.seeedstudio.com/depot/OPLopen-parts-library-catalog-c-136_138/#301010361
301010299 | RC0603FR-0710KL | SMD RES 10K-1%-1/10W | Resistor | 0603 | YAGEO | http://www.seeedstudio.com/wiki/images/a/ad/001124001.pdf | 0.010 | 100 | 2 | 0.20 |  | http://www.seeedstudio.com/depot/OPLopen-parts-library-catalog-c-136_138/#0011240P1
301010004 | RC0402JR-0710KL | SMD RES 10K-5%-1/16W | Resistor | 0402 | YAGEO | http://www.seeedstudio.com/wiki/images/0/06/301010000.pdf (http://www.seeedstudio.com/wiki/images/2/28/301010113.pdf) | 0.010 | 100 | 2 | 0.20 |  | http://www.seeedstudio.com/depot/OPLopen-parts-library-catalog-c-136_138/#301010004
301030002 |  | SMD RES ARRAY 10K OHM 4 RES 1206 | Resistor | 1206-8 | Royalohm | http://www.seeedstudio.com/wiki/images/a/a1/0040070P1.pdf (http://www.seeedstudio.com/wiki/images/6/63/PYu-RC0805_51_RoHS_L_v5.pdf) | 0.020 | 100 | 8 | 0.80 |  | http://www.seeedstudio.com/depot/OPLopen-parts-library-catalog-c-136_138/#0040070P1
301040009 | SX3362P | DIP VR Top Adj 10K-3362P | Resistor | 3P-L7.0*W7.0*H5.0mm | BEST | http://www.seeedstudio.com/wiki/images/a/a6/301040009.pdf (http://www.seeedstudio.com/wiki/images/2/28/301010113.pdf) | 0.400 | 5 | 3 | 0.30 |  | http://www.seeedstudio.com/depot/OPLopen-parts-library-catalog-c-136_138/#301040009
301010102 | RC0603FR-0712KL | SMD RES 12K-1%-1/10W | Resistor | 0603 | YAGEO | http://www.seeedstudio.com/wiki/images/2/28/301010113.pdf | 0.010 | 100 | 2 | 0.20 |  | http://www.seeedstudio.com/depot/OPLopen-parts-library-catalog-c-136_138/#301010102
301010045 | RC0402JR-0712KL | SMD RES 12K-5%-1/16W | Resistor | 0402 | YAGEO | http://www.seeedstudio.com/wiki/images/0/06/301010000.pdf (http://www.seeedstudio.com/wiki/images/6/63/PYu-RC0805_51_RoHS_L_v5.pdf) | 0.010 | 100 | 2 | 0.20 |  | http://www.seeedstudio.com/depot/OPLopen-parts-library-catalog-c-136_138/#301010045
301010328 | RC0805JR-0715KL | SMD RES 15K-5%-1/8W | Resistor | 0805 | YAGEO | http://www.seeedstudio.com/wiki/images/6/63/PYu-RC0805_51_RoHS_L_v5.pdf (http://www.seeedstudio.com/wiki/images/2/28/301010113.pdf) | 0.010 | 100 | 2 | 0.20 |  | http://www.seeedstudio.com/depot/OPLopen-parts-library-catalog-c-136_138/#301010328
301010103 | RC0603JR-0715KL | SMD RES 15K-5%-1/10W | Resistor | 0603 | YAGEO | http://www.seeedstudio.com/wiki/images/2/28/301010113.pdf (http://www.seeedstudio.com/wiki/images/a/a6/301040009.pdf) | 0.025 | 50 | 2 | 0.20 |  | http://www.seeedstudio.com/depot/OPLopen-parts-library-catalog-c-136_138/#301010103
301010288 | RC0603FR-0720KL | SMD RES 20K-1%-1/10W | Resistor | 0603 | YAGEO | http://www.seeedstudio.com/wiki/images/2/28/301010113.pdf | 0.010 | 100 | 2 | 0.20 |  | http://www.seeedstudio.com/depot/OPLopen-parts-library-catalog-c-136_138/#301010288
301010105 | RC0603JR-0720KL | SMD RES 20K-5%-1/10W | Resistor | 0603 | YAGEO | http://www.seeedstudio.com/wiki/images/2/28/301010113.pdf | 0.025 | 50 | 2 | 0.20 |  | http://www.seeedstudio.com/depot/OPLopen-parts-library-catalog-c-136_138/#301010105
301010341 | RC0805JR-0722KL | SMD RES 22K-5%-1/8W | Resistor | 0805 | YAGEO | http://www.seeedstudio.com/wiki/images/6/63/PYu-RC0805_51_RoHS_L_v5.pdf (http://www.seeedstudio.com/wiki/images/2/28/301010113.pdf) | 0.010 | 100 | 2 | 0.20 |  | http://www.seeedstudio.com/depot/OPLopen-parts-library-catalog-c-136_138/#301010341
301010132 | RC0603JR-0722KL | SMD RES 22K-5%-1/10W | Resistor | 0603 | YAGEO | http://www.seeedstudio.com/wiki/images/2/28/301010113.pdf (http://www.seeedstudio.com/wiki/images/f/f5/301040037.pdf) | 0.025 | 50 | 2 | 0.20 |  | http://www.seeedstudio.com/depot/OPLopen-parts-library-catalog-c-136_138/#301010132
301010232 | RC0603FR-0724KL | SMD RES 24K-1%-1/10W;0603 | Resistor | 0603 | YAGEO | http://www.seeedstudio.com/wiki/images/2/28/301010113.pdf | 0.010 | 100 | 2 | 0.20 |  | http://www.seeedstudio.com/depot/OPLopen-parts-library-catalog-c-136_138/#301010232
301010202 | RC0603FR-0730KL | SMD RES 30K-1%-1/10W | Resistor | 0603 | YAGEO | http://www.seeedstudio.com/wiki/images/2/28/301010113.pdf | 0.010 | 100 | 2 | 0.20 |  | http://www.seeedstudio.com/depot/OPLopen-parts-library-catalog-c-136_138/#301010202
301010388 | RC0805FR-0747KL | SMD RES 47K-1%-1/8W | Resistor | 0805 | YAGEO | http://www.seeedstudio.com/wiki/images/6/63/PYu-RC0805_51_RoHS_L_v5.pdf (http://www.seeedstudio.com/wiki/images/2/28/301010113.pdf) | 0.010 | 100 | 2 | 0.20 |  | http://www.seeedstudio.com/depot/OPLopen-parts-library-catalog-c-136_138/#301010388
301010084 | RC0603JR-0747KL | SMD RES 47K-5%-1/10W | Resistor | 0603 | YAGEO | http://www.seeedstudio.com/wiki/images/2/28/301010113.pdf | 0.010 | 100 | 2 | 0.20 |  | http://www.seeedstudio.com/depot/OPLopen-parts-library-catalog-c-136_138/#301010084
301010145 | RC0603JR-0751KL | SMD RES 51K-5%-1/10W | Resistor | 0603 | YAGEO | http://www.seeedstudio.com/wiki/images/2/28/301010113.pdf | 0.025 | 50 | 2 | 0.20 |  | http://www.seeedstudio.com/depot/OPLopen-parts-library-catalog-c-136_138/#301010145
301010327 | RC0805JR-0756KL | SMD RES 56K-5%-1/8W | Resistor | 0805 | YAGEO | http://www.seeedstudio.com/wiki/images/6/63/PYu-RC0805_51_RoHS_L_v5.pdf (http://www.seeedstudio.com/wiki/images/2/28/301010113.pdf) | 0.010 | 100 | 2 | 0.20 |  | http://www.seeedstudio.com/depot/OPLopen-parts-library-catalog-c-136_138/#301010327
301010169 | RC0603FR-0768KL | SMD RES 68K-1%-1/10W | Resistor | 0603 | YAGEO | http://www.seeedstudio.com/wiki/images/2/28/301010113.pdf | 0.010 | 100 | 2 | 0.20 |  | http://www.seeedstudio.com/depot/OPLopen-parts-library-catalog-c-136_138/#301010169
301010222 | RC0603FR-0782KL | SMD RES 82K-1%-1/10W | Resistor | 0603 | YAGEO | http://www.seeedstudio.com/wiki/images/2/28/301010113.pdf | 0.010 | 100 | 2 | 0.20 |  | http://www.seeedstudio.com/depot/OPLopen-parts-library-catalog-c-136_138/#301010222
301010396 | RC0805FR-07100KL | SMD RES 100K-1%-1/8W | Resistor | 0805 | YAGEO | http://www.seeedstudio.com/wiki/images/6/63/PYu-RC0805_51_RoHS_L_v5.pdf | 0.020 | 100 | 2 | 0.20 |  | http://www.seeedstudio.com/depot/OPLopen-parts-library-catalog-c-136_138/#301010396
301010196 | RC0603FR-07100KL | SMD RES 100K-1%-1/10W;0603 | Resistor | 0603 | YAGEO | http://www.seeedstudio.com/wiki/images/2/28/301010113.pdf | 0.010 | 100 | 2 | 0.20 |  | http://www.seeedstudio.com/depot/OPLopen-parts-library-catalog-c-136_138/#301010196
301040026 | SX3362P | DIP VR Top Adj 100K-3362P | Resistor | 3P-L7.0*W7.0*H5.0mm | BEST | http://www.seeedstudio.com/wiki/images/a/a6/301040009.pdf (http://www.seeedstudio.com/wiki/images/2/2a/314020002.pdf) | 0.400 | 5 | 3 | 0.30 |  | http://www.seeedstudio.com/depot/OPLopen-parts-library-catalog-c-136_138/#301040026
301010133 | RC0603JR-07150KL | SMD RES 150K-5%-1/10W | Resistor | 0603 | YAGEO | http://www.seeedstudio.com/wiki/images/2/28/301010113.pdf (http://www.seeedstudio.com/wiki/images/b/b4/314020024.pdf) | 0.025 | 50 | 2 | 0.20 |  | http://www.seeedstudio.com/depot/OPLopen-parts-library-catalog-c-136_138/#301010133
301010205 | RC0603FR-07150KL | SMD RES 150K-1%-1/10W;0603 | Resistor | 0603 | YAGEO | http://www.seeedstudio.com/wiki/images/2/28/301010113.pdf (http://www.seeedstudio.com/wiki/images/a/a8/314020023.pdf) | 0.010 | 100 | 2 | 0.20 |  | http://www.seeedstudio.com/depot/OPLopen-parts-library-catalog-c-136_138/#301010205
301010212 | RC0603JR-07200KL | SMD RES 200K-5%-1/10W;0603 | Resistor | 0603 | YAGEO | http://www.seeedstudio.com/wiki/images/2/28/301010113.pdf | 0.010 | 100 | 2 | 0.20 |  | http://www.seeedstudio.com/depot/OPLopen-parts-library-catalog-c-136_138/#301010212
301040037 | JML3266W-200K | DIP Side Adj 200K-10%-0.5w | Resistor | 3P-L6.8*W4.7*H7.3mm | BEST | http://www.seeedstudio.com/wiki/images/f/f5/301040037.pdf (http://www.seeedstudio.com/wiki/images/6/66/314990002.pdf) | 0.600 | 5 | 2 | 0.20 |  | http://www.seeedstudio.com/depot/OPLopen-parts-library-catalog-c-136_138/#301040037
301010246 | RC0603FR-07680KL | SMD RES 680K-1%-1/16W;0603 | Resistor | 0603 | YAGEO | http://www.seeedstudio.com/wiki/images/2/28/301010113.pdf | 0.010 | 100 | 2 | 0.20 |  | http://www.seeedstudio.com/depot/OPLopen-parts-library-catalog-c-136_138/#301010246
301010151 | RC0603FR-071ML | SMD RES 1M-1%-1/10W;0603 | Resistor | 0603 | YAGEO | http://www.seeedstudio.com/wiki/images/2/28/301010113.pdf | 0.010 | 100 | 2 | 0.20 |  | http://www.seeedstudio.com/depot/OPLopen-parts-library-catalog-c-136_138/#301010151
301010154 | RC0603FR-072ML | SMD RES 2M-1%-1/10W;0603 | Resistor | 0603 | YAGEO | http://www.seeedstudio.com/wiki/images/2/28/301010113.pdf | 0.010 | 100 | 2 | 0.20 |  | http://www.seeedstudio.com/depot/OPLopen-parts-library-catalog-c-136_138/#301010154
301010213 | RC0603JR-074M7L | SMD RES 4.7M-5%-1/10W;0603 | Resistor | 0603 | YAGEO | http://www.seeedstudio.com/wiki/images/2/28/301010113.pdf | 0.010 | 100 | 2 | 0.20 |  | http://www.seeedstudio.com/depot/OPLopen-parts-library-catalog-c-136_138/#301010213
301010121 | RC0603JR-0710ML | SMD RES 10M-5%-1/10W | Resistor | 0603 | YAGEO | http://www.seeedstudio.com/wiki/images/2/28/301010113.pdf | 0.025 | 50 | 2 | 0.20 |  | http://www.seeedstudio.com/depot/OPLopen-parts-library-catalog-c-136_138/#301010121
301010153 | RC0603FR-0710ML | SMD RES 10M-1%-1/10W;0603 | Resistor | 0603 | YAGEO | http://www.seeedstudio.com/wiki/images/2/28/301010113.pdf | 0.010 | 100 | 2 | 0.20 |  | http://www.seeedstudio.com/depot/OPLopen-parts-library-catalog-c-136_138/#301010153
314020017 | Photoresistor-5528 | DIP RES Photoresistor 10K;2P-3.0 | Sensor | 2P-3.0 | Keyue |  | 0.060 | 20 | 3 | 0.30 |  | http://www.seeedstudio.com/depot/OPLopen-parts-library-catalog-c-136_138/#314020017
314010001 | AM2302 | DIP Tem-Hum Sensor; | Sensor | 4P-2.54 |  |  | 7.000 | 1 | 6 | 0.60 |  | http://www.seeedstudio.com/depot/OPLopen-parts-library-catalog-c-136_138/#314010001
314010000 | DHT11 | DIP Tem-Hum Sensor | Sensor | 4P-2.54-L15.5*W12.0*H5.5mm |  |  | 1.600 | 2 | 4 | 0.40 |  | http://www.seeedstudio.com/depot/OPLopen-parts-library-catalog-c-136_138/#314010000
314020022 | LTH1550-01 | DIP Optical Sensor; | Sensor | 4P-L8.7*W4.5*H5.8mm | Lite-On Technology Corporation | http://www.seeedstudio.com/wiki/images/8/89/305010013.pdf | 0.700 | 3 | 6 | 0.60 |  | http://www.seeedstudio.com/depot/OPLopen-parts-library-catalog-c-136_138/#314020022
314020002 | RPR-220 | DIP Optical Sensor | Sensor | 4P-L6.4*W4.9*H6.5mm | ROHM | http://www.seeedstudio.com/wiki/images/2/2a/314020002.pdf (http://www.seeedstudio.com/wiki/images/6/61/310030064.pdf) | 0.800 | 3 | 6 | 0.60 |  | http://www.seeedstudio.com/depot/OPLopen-parts-library-catalog-c-136_138/#314020002
314020024 | YG1006 | DIP Optical Sensor | Sensor | 2P-2.54-5mm | Xinde | http://www.seeedstudio.com/wiki/images/b/b4/314020024.pdf (http://www.seeedstudio.com/wiki/images/5/5e/310010045.pdf) | 0.200 | 10 | 3 | 0.30 |  | http://www.seeedstudio.com/depot/OPLopen-parts-library-catalog-c-136_138/#314020024
314020023 | TSAL6200 | DIP Optical Sensor | Sensor | 2P-2.54-5mm | Vishay | http://www.seeedstudio.com/wiki/images/a/a8/314020023.pdf (http://www.seeedstudio.com/wiki/images/8/8e/310010024.pdf) | 0.150 | 10 | 2 | 0.20 |  | http://www.seeedstudio.com/depot/OPLopen-parts-library-catalog-c-136_138/#314020023
314020020 | TM2291 | SMD Optical Sensor;SOP-16 | Sensor | SOP-16 | Titanmec | datasheet 是中文 (http://www.seeedstudio.com/wiki/images/1/1f/314080008.pdf) | 0.250 | 10 | 4 | 0.40 |  | http://www.seeedstudio.com/depot/OPLopen-parts-library-catalog-c-136_138/#314020020
314990002 | LHI778 | Dual Element Detector Sensor | Sensor | 3P-D8.1X4.2Hmm | PreKinElmer | http://www.seeedstudio.com/wiki/images/6/66/314990002.pdf (http://www.seeedstudio.com/wiki/images/7/7f/310010001.pdf) | 1.300 | 2 | 3 | 0.30 |  | http://www.seeedstudio.com/depot/OPLopen-parts-library-catalog-c-136_138/#314990002
311090001 | FR2259 | SMD Reed Switch-200V;2P-SMD-L15.24*W2.29*H2.03mm | Sensor | 2P-SMD-L15.24*W2.29*H2.03mm | Coto Technology | http://www.seeedstudio.com/wiki/images/9/99/MAX232D.pdf | 0.600 | 5 | 2 | 0.20 |  | http://www.seeedstudio.com/depot/OPLopen-parts-library-catalog-c-136_138/#311090001
314110002 |  | DIP Thermistor-503;2P-2.54 | Resistor | 2P-2.54 | Shuoye |  | 0.060 | 20 | 3 | 0.30 |  | http://www.seeedstudio.com/depot/OPLopen-parts-library-catalog-c-136_138/#314110002
311030004 |  | DIP Toggle Switch;6P-2.54-L9.0*W3.5*H3.2mm | Switch | 6P-2.54-L9.0*W3.5*H3.2mm |  |  | 0.150 | 20 | 6 | 0.60 |  | http://www.seeedstudio.com/depot/OPLopen-parts-library-catalog-c-136_138/#311030004
311030005 |  | SMD Toggle Switch;6P-2.54-L7.0*W3.5*H1.5mm | Switch | 6P-2.54-L7.0*W3.5*H1.5mm |  |  | 0.200 | 20 | 6 | 0.60 |  | http://www.seeedstudio.com/depot/OPLopen-parts-library-catalog-c-136_138/#311030005
311020025 | TS-1101F | DIP Button Front -white;2P-L6.0*W3.0*H4.3mm-90D | Switch | 2P-L6.0*W3.0*H4.3mm-90D | Baisite | http://www.seeedstudio.com/wiki/images/2/2c/311020025.pdf | 0.060 | 30 | 3 | 0.30 |  | http://www.seeedstudio.com/depot/OPLopen-parts-library-catalog-c-136_138/#311020025
311020023 | TS-1188E | SMD Button | Switch | 4P-SMD-7.0X3.5X3.5H-90D | BEST | http://www.seeedstudio.com/wiki/images/0/08/3100060P1.pdf | 0.150 | 20 | 4 | 0.40 |  | http://www.seeedstudio.com/depot/OPLopen-parts-library-catalog-c-136_138/#3100060P1
311020004 | DTSM-62K-S-V-T/R(SN431) | SWITCH TACTILE SPST-NO 0.05A 12V | Switch | 4P-SMD-6.0X6.0X5.0H | DIPTRONICS | http://www.seeedstudio.com/wiki/images/d/d3/3100010P1.pdf | 0.120 | 20 | 4 | 0.40 |  | http://www.seeedstudio.com/depot/OPLopen-parts-library-catalog-c-136_138/#3100010P1
311020024 | TS-1109 | SWITCH TACTILE SPST-NO 0.05A 12V | Switch | 4P-6.0X6.0X5.0H | BEST | http://www.seeedstudio.com/wiki/images/2/20/3110040P1.pdf | 0.050 | 30 | 4 | 0.40 |  | http://www.seeedstudio.com/depot/OPLopen-parts-library-catalog-c-136_138/#3110040P1
311010004 | MS-22D18 G2 ROHS | SW SLIDE DPDT 6VDC 0.3A PCMNT | Switch | 6P-2CH-2.54-9.1X3.5X3.2+2H | Deyilong | http://www.seeedstudio.com/wiki/images/0/03/3010010P1.pdf | 0.120 | 20 | 6 | 0.60 |  | http://www.seeedstudio.com/depot/OPLopen-parts-library-catalog-c-136_138/#3010010P1
305010013 | MMBT3904LT1G | SMD Transistors NPN 40V-200mA | Transistor | SOT-23 | ON Semiconductor | http://www.seeedstudio.com/wiki/images/8/89/305010013.pdf | 0.040 | 50 | 2 | 0.20 |  | http://www.seeedstudio.com/depot/OPLopen-parts-library-catalog-c-136_138/#305010013
310030064 | MAX1555EZK+T | SMD PMIC;Liner;Li-Ion/Pol;Charge;100mA;1-cell | IC | SOT-23-5 | Maxim | http://www.seeedstudio.com/wiki/images/6/61/310030064.pdf | 3.500 | 1 | 4 | 0.40 |  | http://www.seeedstudio.com/depot/OPLopen-parts-library-catalog-c-136_138/#310030064
310010045 | LPC11U24FBD64/401 | ARM MCU 32Bit Cortex-M0 32KB Flash 12KB SRAM 3.3v | IC | LQFP-64 | NXP | http://www.seeedstudio.com/wiki/images/5/5e/310010045.pdf | 5.000 | 1 | 16 | 1.60 |  | http://www.seeedstudio.com/depot/OPLopen-parts-library-catalog-c-136_138/#310010045
310010024 | LPC1114FN28 | DIP IC MCU; ARM Cortex-M0 based 32-bit MCU (DIP) | IC | DIP-28 | NXP | http://www.seeedstudio.com/wiki/images/8/8e/310010024.pdf | 4.700 | 1 | 28 | 2.80 |  | http://www.seeedstudio.com/depot/OPLopen-parts-library-catalog-c-136_138/#310010024
314080008 | ADXL345BCCZ-RL | SMD Accelerometers Sensor | Sensor | 14-LGA | Analog Devices Inc | http://www.seeedstudio.com/wiki/images/1/1f/314080008.pdf | 2.200 | 2 | 14 | 1.40 |  | http://www.seeedstudio.com/depot/OPLopen-parts-library-catalog-c-136_138/#314080008
310010001 | LPC1768FBD100 | SMD IC MCU; | IC | LQFP-100 | NXP | http://www.seeedstudio.com/wiki/images/7/7f/310010001.pdf | 11.200 | 1 | 25 | 2.50 |  | http://www.seeedstudio.com/depot/OPLopen-parts-library-catalog-c-136_138/#310010001
310060023 | MAX232D | SMD Receiver Module;MAX232 (SOIC - RS232 to TTL level translator) | IC | SOIC-16 | Texas Instruments | http://www.seeedstudio.com/wiki/images/9/99/MAX232D.pdf | 0.400 | 5 | 4 | 0.40 |  | http://www.seeedstudio.com/depot/OPLopen-parts-library-catalog-c-136_138/#310060023
315030009 | HLS8L-DC3V-S-C | DIP Power Relay 3V-7A | Relay | 5P-L19.0*W15.0*H15.0mm | HELISHUN |  | 0.500 | 5 | 5 | 0.50 |  | http://www.seeedstudio.com/depot/OPLopen-parts-library-catalog-c-136_138/#315030009
311080003 | LSM7-629C | SMD Switches Top-4bit; | Switch | 8P-L11.8*W6.8*H3.3mm | BEST |  | 0.700 | 3 | 8 | 0.80 |  | http://www.seeedstudio.com/depot/OPLopen-parts-library-catalog-c-136_138/#311080003
317070006 | ANT8030-2R4-01A | SMD Receiver/Transmitter Module;2.4GHz | Antenna | 8*3*1mm | TDK |  | 8.000 | 1 | 0 | 0.00 |  | http://www.seeedstudio.com/depot/OPLopen-parts-library-catalog-c-136_138/#317070006
318010004 | AN9520 | SMD Built-in Antenna 2.4GHz Wlan | Antenna | 2P-L9.5*W2.1*H1.0mm | RainSun |  | 1.200 | 3 | 2 | 0.20 |  | http://www.seeedstudio.com/depot/OPLopen-parts-library-catalog-c-136_138/#318010004
318020019 | 3020-1766 | External Antenna 2.4G WiFi; | Antenna | L40.5*W5.0*H1.2mm | FEIYUXIN |  | 0.700 | 3 | 8 | 0.80 |  | http://www.seeedstudio.com/depot/OPLopen-parts-library-catalog-c-136_138/#318020019
318020014 | IPEX-PCB-113-L42 | PCB External Antenna 850-900MHZ; | Antenna | 18*40*42mm | FEIYUXIN |  | 0.900 | 3 | 0 | 0.00 |  | http://www.seeedstudio.com/depot/OPLopen-parts-library-catalog-c-136_138/#318020014
310030145 | BQ500211RGZR | SMD PMIC;WPC;Transmitter;5V; | IC | VQFN-48 | TEXAS |  | 5.000 | 1 | 12 | 1.20 |  | http://www.seeedstudio.com/depot/OPLopen-parts-library-catalog-c-136_138/#310030145
314110001 | NCP18WF104F03RC | SMD RES Thermistor NTC 100K-1%; | Resistor | 0603 | Murata |  | 0.060 | 20 | 2 | 0.20 |  | http://www.seeedstudio.com/depot/OPLopen-parts-library-catalog-c-136_138/#314110001
310090035 | CAT24C256WI-GT3 | EEPROM 256Kb, 400KHZ | IC | 8-SOIC | ON Semiconductor |  | 0.800 | 3 | 4 | 0.40 |  | http://www.seeedstudio.com/depot/OPLopen-parts-library-catalog-c-136_138/#310090035
317040001 | SIM800H | SMD GPRS Module; | Module | 88P-L17.8*W15.8*H2.4mm | Simcom |  | 13.000 | 1 | 22 | 2.20 |  | http://www.seeedstudio.com/depot/OPLopen-parts-library-catalog-c-136_138/#317040001
317040000 | SIM900 | SMD GPRS Module; | Module | 68P-1.0-L24.0*W24.0*H3.0mm | Simcom |  | 20.000 | 1 | 18 | 1.80 |  | http://www.seeedstudio.com/depot/OPLopen-parts-library-catalog-c-136_138/#317040000
315990002 | HLS-14F3L-DC12V-C | Relay-12V-5A/240VAC; | Relay | 8P-29.2*12.4*20.4mm | HELISHUN |  | 1.000 | 3 | 8 | 0.80 |  | http://www.seeedstudio.com/depot/OPLopen-parts-library-catalog-c-136_138/#315990002
310030140 | MC33932VW | SMD Motor Driver;28V Vin;5A;H-Bridge;2-Ch | IC | HSOP-44 | Freescale |  | 12.000 | 1 | 11 | 1.10 |  | http://www.seeedstudio.com/depot/OPLopen-parts-library-catalog-c-136_138/#310030140
310070026 | CH340T | SMD IC Interface | IC | SSOP-20 | WCH |  | 0.600 | 5 | 8 | 0.80 |  | http://www.seeedstudio.com/depot/OPLopen-parts-library-catalog-c-136_138/#310070026
310060026 | nRF51822; | SMD IC RF;QFAA 256KB Flash, 16KB RAM | IC | QFN-48 | Nordic Semiconductor |  | 3.000 | 1 | 12 | 1.20 |  | http://www.seeedstudio.com/depot/OPLopen-parts-library-catalog-c-136_138/#310060026
310070032 | W5500 | SMD IC Interface; | IC | LQFP-48 | WIZnet |  | 4.000 | 1 | 12 | 1.20 |  | http://www.seeedstudio.com/depot/OPLopen-parts-library-catalog-c-136_138/#310070032
301010198 | RC0603FR-076K8L | SMD RES 6.8K-1%-1/10W | Resistor | 0603 | YAGEO |  | 0.010 | 100 | 2 | 0.20 |  | http://www.seeedstudio.com/depot/OPLopen-parts-library-catalog-c-136_138/#301010198
301010335 | RC0805JR-076K8L | SMD RES 6.8K-5%-1/8W | Resistor | 0805 | YAGEO |  | 0.010 | 100 | 2 | 0.20 |  | http://www.seeedstudio.com/depot/OPLopen-parts-library-catalog-c-136_138/#301010335
301010504 | RC0402JR-07220KL | SMD RES;220K-1/16W-5% | Resistor | 0402 | YAGEO |  | 0.010 | 100 | 2 | 0.20 |  | http://www.seeedstudio.com/depot/OPLopen-parts-library-catalog-c-136_138/#301010504
301010534 | RC0805JR-07220KL | SMD RES 220K-5%-1/10W | Resistor | 0603 | YAGEO |  | 0.010 | 100 | 2 | 0.20 |  | http://www.seeedstudio.com/depot/OPLopen-parts-library-catalog-c-136_138/#301010534
301010499 | RC0603JR-07220KL | SMD RES 220K-5%-1/8W; | Resistor | 0805 | YAGEO |  | 0.010 | 100 | 2 | 0.20 |  | http://www.seeedstudio.com/depot/OPLopen-parts-library-catalog-c-136_138/#301010499
303010002 | LQP15MN3N9B02D | SMD Inductor 3.9nH-0.1nH-170mA | Inductor | 0402 | Murata |  | 0.010 | 100 | 2 | 0.20 |  | http://www.seeedstudio.com/depot/OPLopen-parts-library-catalog-c-136_138/#303010002
303010035 | LQG15HS8N2J02 | SMD Inductor 8.2nH-5%-300mA | Inductor | 0402 | Murata |  | 0.010 | 100 | 2 | 0.20 |  | http://www.seeedstudio.com/depot/OPLopen-parts-library-catalog-c-136_138/#303010035
301010199 | RC0603FR-0722KL | SMD RES 22K-1%-1/10W | Resistor | 0603 | YAGEO |  | 0.010 | 100 | 2 | 0.20 |  | http://www.seeedstudio.com/depot/OPLopen-parts-library-catalog-c-136_138/#301010199
301010063 | RC0402FR-0722KL | SMD RES 22K-1%-1/16W | Resistor | 0402 | YAGEO |  | 0.010 | 100 | 2 | 0.20 |  | http://www.seeedstudio.com/depot/OPLopen-parts-library-catalog-c-136_138/#301010063
301010456 | RC0402FR-07100KL | SMD RES 100K-1%-1/16W | Resistor | 0402 | YAGEO |  | 0.010 | 100 | 2 | 0.20 |  | http://www.seeedstudio.com/depot/OPLopen-parts-library-catalog-c-136_138/#301010456
320070002 | ICS-8P | DIP IC Socket; | Connector | 2*4P-2.54mm | NSTECH |  | 0.080 | 30 | 8 | 0.80 |  | http://www.seeedstudio.com/depot/OPLopen-parts-library-catalog-c-136_138/#320070002
301010091 | RC0603JR-0747RL | SMD RES 47R-5%-1/10W | Resistor | 0603 | YAGEO |  | 0.010 | 100 | 2 | 0.20 |  | http://www.seeedstudio.com/depot/OPLopen-parts-library-catalog-c-136_138/#301010091
301010380 | RC0805JR-0747RL | SMD RES 47R-5%-1/8W | Resistor | 0805 | YAGEO |  | 0.010 | 100 | 2 | 0.20 |  | http://www.seeedstudio.com/depot/OPLopen-parts-library-catalog-c-136_138/#301010380
301010046 | RC0402JR-07820RL | SMD RES 820R-5%-1/16W | Resistor | 0402 | YAGEO |  | 0.010 | 100 | 2 | 0.20 |  | http://www.seeedstudio.com/depot/OPLopen-parts-library-catalog-c-136_138/#301010046
301010257 | RC0603FR-07820RL | SMD RES 820R-1%-1/10W | Resistor | 0603 | YAGEO |  | 0.010 | 100 | 2 | 0.20 |  | http://www.seeedstudio.com/depot/OPLopen-parts-library-catalog-c-136_138/#301010257
301010190 | RC0603FR-07470KL | SMD RES 470K-1%-1/10W | Resistor | 0603 | YAGEO |  | 0.010 | 100 | 2 | 0.20 |  | http://www.seeedstudio.com/depot/OPLopen-parts-library-catalog-c-136_138/#301010190
301010069 | RC0402FR-07470KL | SMD RES 470K-1%-1/16W | Resistor | 0402 | YAGEO |  | 0.010 | 100 | 2 | 0.20 |  | http://www.seeedstudio.com/depot/OPLopen-parts-library-catalog-c-136_138/#301010069
304090073 | Y502DC | DIP LED Yellow-Yellow | LED | Radial-2P-2.54-5mm | CHENGGUNAGXING |  | 0.050 | 30 | 1.5 | 0.20 |  | http://www.seeedstudio.com/depot/OPLopen-parts-library-catalog-c-136_138/#304090073
310010067 | STM32F407VET6 | SMD IC MCU; | IC | LQFP-100 | STMicroelectronics |  | 11.000 | 1 | 100 | 10.00 |  | http://www.seeedstudio.com/depot/OPLopen-parts-library-catalog-c-136_138/#310010067
310070030 | FT230XS-R | SMD IC Interface | IC | SSOP-16 | FTDI |  | 3.500 | 1 | 16 | 1.60 |  | http://www.seeedstudio.com/depot/OPLopen-parts-library-catalog-c-136_138/#310070030
104990054 | EM027AS011 | 2.7'' e-Paper Panel; | Display | 2.7" | PDI |  | 25.900 | 1 | 0 | 0.00 |  | http://www.seeedstudio.com/depot/OPLopen-parts-library-catalog-c-136_138/#104990054
104990080 | EG020BS011 | 2.0''e-Paper Panel | Display | 2.0" | PDI |  | 19.900 | 1 | 0 | 0.00 |  | http://www.seeedstudio.com/depot/OPLopen-parts-library-catalog-c-136_138/#104990080
312030029 | EAO-9745-PFA-C1033-28-008 | Mini Microphone | Microphones | 2P-ROUND-9.7*4.5mm | Guangjixing |  | 0.300 | 5 | 2 | 0.20 |  | http://www.seeedstudio.com/depot/OPLopen-parts-library-catalog-c-136_138/#312030029
304030011 | 1N5227B | DIP Diode Zener 3.6V-500MW; | Diode | DO-35 | Micro Commercial Co |  | 0.100 | 20 | 2 | 0.20 |  | http://www.seeedstudio.com/depot/OPLopen-parts-library-catalog-c-136_138/#304030011
314090000 | TA12-200 | DIP Current Sensor; | Sensor | 2P-L16.8*W9.0*H32.0mm | YH |  | 3.000 | 1 | 2 | 0.20 |  | http://www.seeedstudio.com/depot/OPLopen-parts-library-catalog-c-136_138/#314090000
314100003 | MQ-2 | DIP Gas Sensor；Combustible Gas、Smoke | Sensor | 6P-Round | winsensor |  | 2.000 | 1 | 6 | 0.60 |  | http://www.seeedstudio.com/depot/OPLopen-parts-library-catalog-c-136_138/#314100003
314100007 | MQ-3 | DIP Gas Sensor;Alcohol and Benzine | Sensor | 6P-Round | winsensor |  | 3.500 | 1 | 6 | 0.60 |  | http://www.seeedstudio.com/depot/OPLopen-parts-library-catalog-c-136_138/#314100007
314100000 | MQ-5 | DIP Gas Sensor;LPG, Natural Gas, Town Gas | Sensor | 6P-Round | winsensor |  | 1.600 | 1 | 6 | 0.60 |  | http://www.seeedstudio.com/depot/OPLopen-parts-library-catalog-c-136_138/#314100000
314100008 | MQ-9 | DIP Gas Sensor;LPG, CO, CH4 | Sensor | 6P-Round | winsensor |  | 4.000 | 1 | 6 | 0.60 |  | http://www.seeedstudio.com/depot/OPLopen-parts-library-catalog-c-136_138/#314100008
314100011 | ME2-O2 | DIP Gas Sensor;oxygen | Sensor | 2P-D20.2*H16.5mm | winsensor |  | 35.000 | 1 | 2 | 0.20 |  | http://www.seeedstudio.com/depot/OPLopen-parts-library-catalog-c-136_138/#314100011
314100005 | WSP2110 | DIP Gas Sensor;toluene, formaldehyde, benzene, alcohol and acetone | Sensor | 4P-D9.4*H7.5mm | winsensor |  | 10.000 | 1 | 4 | 0.40 |  | http://www.seeedstudio.com/depot/OPLopen-parts-library-catalog-c-136_138/#314100005
314100006 | MQ303B | DIP Gas Sensor; Alcohol | Sensor | 6P-Round-D8.0*H7.0mm | winsensor |  | 3.500 | 1 | 6 | 0.60 |  | http://www.seeedstudio.com/depot/OPLopen-parts-library-catalog-c-136_138/#314100006
304080005 | SYD3642ASR | LED-4-BETY-7-SEG | Display | 7-4-BYTE-SEG-2.54-30*14*7.3H | FANGZHOU |  | 1.000 | 3 | 12 | 1.20 |  | http://www.seeedstudio.com/depot/OPLopen-parts-library-catalog-c-136_138/#304080005
301040022 | WH09-2-103 | DIP VR Top Adj 10k; | Resistor | 3P-2.5-L20 | BAISITE |  | 0.250 | 10 | 2 | 0.20 |  | http://www.seeedstudio.com/depot/OPLopen-parts-library-catalog-c-136_138/#301040022
303010022 | VLF5010ST-2R2M2R0 | SMD Inductor 2.2uH-20%-2A; | Inductor | 2P-SMD-L4.8*W4.6*H1.0mm | TDK |  | 0.450 | 5 | 2 | 0.20 |  | http://www.seeedstudio.com/depot/OPLopen-parts-library-catalog-c-136_138/#303010022
303010058 | MLZ1005M2R2WT000 | SMD Inductor 2.2uH-20%-350mA; | Inductor | 0402 | TDK |  | 0.450 | 5 | 2 | 0.20 |  | http://www.seeedstudio.com/depot/OPLopen-parts-library-catalog-c-136_138/#303010058
303010086 | LQM2MPN2R2MG0 | SMD Inductor;2.2uH-20%-1.2A | Inductor | 0805 | AVX |  | 0.150 | 10 | 2 | 0.20 |  | http://www.seeedstudio.com/depot/OPLopen-parts-library-catalog-c-136_138/#303010086
303010005 | LQM21NN1R0K10D | SMD Inductor 1uH-10%-50mA; | Inductor | 0805 | AVX |  | 0.100 | 20 | 2 | 0.20 |  | http://www.seeedstudio.com/depot/OPLopen-parts-library-catalog-c-136_138/#303010005
320030090 | F185-1210A0BA1 | DIP Black Female Header | Connector | 2*10P-2.54-8.5 | YCONN |  | 0.360 | 5 | 20 | 2.00 |  | http://www.seeedstudio.com/depot/OPLopen-parts-library-catalog-c-136_138/#320030090
301010197 | RC0603FR-07270RL | SMD RES 270R-1%-1/10W | Resistor | 0603 | YAGEO |  | 0.010 | 100 | 2 | 0.20 |  | http://www.seeedstudio.com/depot/OPLopen-parts-library-catalog-c-136_138/#301010197
301010360 | RC0805JR-07270RL | SMD RES 270R-5%-1/8W | Resistor | 0805 | YAGEO |  | 0.010 | 100 | 2 | 0.20 |  | http://www.seeedstudio.com/depot/OPLopen-parts-library-catalog-c-136_138/#301010360
301010418 | RC1206JR-07270RL | SMD RES 270R-5%-1/4W | Resistor | 1206 | YAGEO |  | 0.010 | 100 | 2 | 0.20 |  | http://www.seeedstudio.com/depot/OPLopen-parts-library-catalog-c-136_138/#301010418
301010078 | RC0402JR-072K7L | SMD RES 2.7K-5%-1/16W | Resistor | 0402 | YAGEO |  | 0.010 | 100 | 2 | 0.20 |  | http://www.seeedstudio.com/depot/OPLopen-parts-library-catalog-c-136_138/#301010078
301010193 | RC0603FR-072K7L | SMD RES 2.7K-1%-1/10W | Resistor | 0603 | YAGEO |  | 0.010 | 100 | 2 | 0.20 |  | http://www.seeedstudio.com/depot/OPLopen-parts-library-catalog-c-136_138/#301010193
301010395 | RC0805FR-072K7L | SMD RES 2.7K-1%-1/8W | Resistor | 0805 | YAGEO |  | 0.010 | 100 | 2 | 0.20 |  | http://www.seeedstudio.com/depot/OPLopen-parts-library-catalog-c-136_138/#301010395
301010001 | RC0402JR-071K5L | SMD RES 1.5K-5%-1/16W | Resistor | 0402 | YAGEO |  | 0.010 | 100 | 2 | 0.20 |  | http://www.seeedstudio.com/depot/OPLopen-parts-library-catalog-c-136_138/#301010001
306010044 | HC49/US | DIP Crystal 6MHz-32pF-30ppm-100R; | Crystal Oscillator | 49/US 11.05*4.65*3.5+12.7mm | XINHUIJING |  | 0.150 | 10 | 2 | 0.20 |  | http://www.seeedstudio.com/depot/OPLopen-parts-library-catalog-c-136_138/#306010044
301010012 | RC0402FR-07470RL | SMD RES 470R-1%-1/16W | Resistor | 0402 | YAGEO |  | 0.010 | 100 | 2 | 0.20 |  | http://www.seeedstudio.com/depot/OPLopen-parts-library-catalog-c-136_138/#301010012
301010367 | RC0805FR-07470RL | SMD RES 470R-1%-1/8W | Resistor | 0805 | YAGEO |  | 0.010 | 100 | 2 | 0.20 |  | http://www.seeedstudio.com/depot/OPLopen-parts-library-catalog-c-136_138/#301010367
301010262 | RC0603FR-0733RL | SMD RES 33R-1%-1/10W | Resistor | 0603 | YAGEO |  | 0.010 | 100 | 2 | 0.20 |  | http://www.seeedstudio.com/depot/OPLopen-parts-library-catalog-c-136_138/#301010262
301010264 | RL0805JR-070R1L | SMD RES 0.1R-5%-1/8W | Resistor | 0805 | YAGEO |  | 0.050 | 50 | 2 | 0.20 |  | http://www.seeedstudio.com/depot/OPLopen-parts-library-catalog-c-136_138/#301010264
320030032 |  | DIP Black Female Header VERT | Connector | 1*10P-2.54-8.5mm | YXCON | http://www.seeedstudio.com/wiki/images/0/0d/320030039.pdf | 0.200 | 10 | 10 | 1.00 |  | http://www.seeedstudio.com/depot/OPLopen-parts-library-catalog-c-136_138/#320030032
304090086 | 504RGBW-K | DIP LED Vaporous-RGB; | LED | Radial-2P-2.54-5mm | chengguangxing |  | 0.110 | 20 | 2 | 0.20 |  | http://www.seeedstudio.com/depot/OPLopen-parts-library-catalog-c-136_138/#304090086
320170002 |  | DIP Battery Cell Holder; | Connector | Metal CR1220-D13.5*H5.0mm |  |  | 0.030 | 50 | 2 | 0.20 |  | http://www.seeedstudio.com/depot/OPLopen-parts-library-catalog-c-136_138/#320170002
323050000 |  | Folding Clasps | Connector | D11.5*H6.0mm | JJWJ |  | 0.030 | 50 | 1 | 0.10 |  | http://www.seeedstudio.com/depot/OPLopen-parts-library-catalog-c-136_138/#323050000
313010036 | CR1220 | Lithium-ion Battery 3V-40mAh | Battery | CR1220 | TMMQ |  | 0.300 | 5 | 0 | 0.00 |  | http://www.seeedstudio.com/depot/OPLopen-parts-library-catalog-c-136_138/#313010013
304080004 | SP400561N | 10 segment LED gauge bar red | Display | 33.02*15.24mm | SP400561N |  | 1.500 | 1 | 20 | 2.00 |  | http://www.seeedstudio.com/depot/OPLopen-parts-library-catalog-c-136_138/#304080004
320030097 | FBM1211-1001A01B1AF | SMD Black Female Header | Connector | 1*10P-2.0-L20.5*W2.5*H2.4-R/A | YXCON |  | 0.250 | 10 | 10 | 1.00 |  | http://www.seeedstudio.com/depot/OPLopen-parts-library-catalog-c-136_138/#320030097
320020120 |  | DIP Long Black Male Header VERT; | Connector | 1*10P-2.54 | YXCON |  | 0.150 | 10 | 10 | 1.00 |  | http://www.seeedstudio.com/depot/OPLopen-parts-library-catalog-c-136_138/#320020120
320020121 |  | DIP Black Male Header VERT; | Connector | 1*10P-2.0-2.0-12/2.0mm | YXCON |  | 0.150 | 10 | 10 | 1.00 |  | http://www.seeedstudio.com/depot/OPLopen-parts-library-catalog-c-136_138/#320020121
310010016 | ATMEGA32U4-MUR | SMD IC MCU; | IC | VQFN-44 | Atmel |  | 6.700 | 1 | 44 | 4.40 |  | http://www.seeedstudio.com/depot/OPLopen-parts-library-catalog-c-136_138/#310010016
310070003 | CP2102-GMR | SMD IC Interface | IC | QFN-28 | Silicon |  | 2.750 | 1 | 28 | 2.80 |  | http://www.seeedstudio.com/depot/OPLopen-parts-library-catalog-c-136_138/#310070003
303030006 | BLM21PG331SN1D | SMD Ferrite Bead 330R-1500mA | Inductor | 0805 | Murata |  | 0.040 | 50 | 2 | 0.20 |  | http://www.seeedstudio.com/depot/OPLopen-parts-library-catalog-c-136_138/#303030006
310030105 | TD1410 | SMD IC PMIC Buck | IC | SOP8 | Techcode |  | 0.400 | 5 | 8 | 0.80 |  | http://www.seeedstudio.com/depot/OPLopen-parts-library-catalog-c-136_138/#310030105
310030161 | ETA3410D2I-T | SMD PMIC;DC-DC;Vin 2.6-5.5V,Adj;2A;3MHz;Sync;Buck;1-Ch | IC | DFN(2*2)-8 | ETA |  | 0.300 | 5 | 8 | 0.80 |  | http://www.seeedstudio.com/depot/OPLopen-parts-library-catalog-c-136_138/#310030161
310030153 | ETA1036-50S2F-T | SMD PMIC;DC-DC;Vin 0.6-4.5V;3W;2MHz;Boost;1-Ch | IC | SOT23-5 | ETA |  | 0.350 | 5 | 5 | 0.50 |  | http://www.seeedstudio.com/depot/OPLopen-parts-library-catalog-c-136_138/#310030153
310990023 | ETA6003Q3Q | SMD IC PMIC Buck;Charger with Dynamic Power Path Management; | IC | QFN3*3-16 | ETA |  | 0.500 | 5 | 16 | 1.60 |  | http://www.seeedstudio.com/depot/OPLopen-parts-library-catalog-c-136_138/#310990023
310990024 | ETA6020D2G-T/U | SMD IC PMIC Buck;Precision Load Switch with Adjustable Current IC | IC | DFN2*2-6 | ETA |  | 0.400 | 5 | 6 | 0.60 |  | http://www.seeedstudio.com/depot/OPLopen-parts-library-catalog-c-136_138/#310990024
310030129 | TPS62132RGTR | SMD PMIC;DC-DC; Vin 3-17V;Adj;3A;2.5MHz;Buck;1-Ch | IC | QFN-16(3*3) | TI |  | 5.000 | 3 | 16 | 1.60 |  | http://www.seeedstudio.com/depot/OPLopen-parts-library-catalog-c-136_138/#310030129
302010066 | CC0603DRNPO9BN8R2 | SMD CAP Ceramic 8.2pF-50V-0.5pF-NPO | Capacitor | 0603 | YAGEO | http://www.seeedstudio.com/wiki/images/0/03/0100230P1.pdf | 0.010 | 100 | 2 | 0.20 |  | http://www.seeedstudio.com/depot/OPLopen-parts-library-catalog-c-136_138/#010023001
301020003 | FHCFR-1/4W-331J | DIP RES 330R-5%-1/4W;Axial-D2.3*L6.5mm | Resistor | Axial-D2.3*L6.5mm | Fenghua |  | 0.010 | 100 | 2 | 0.20 |  | http://www.seeedstudio.com/depot/OPLopen-parts-library-catalog-c-136_138/#301020003
301020029 | FHCFR-1/4W-471J | DIP RES 470R-5%-1/4W;Axial-D2.3*L6.5mm | Resistor | Axial-D2.3*L6.5mm | Fenghua |  | 0.010 | 100 | 2 | 0.20 |  | http://www.seeedstudio.com/depot/OPLopen-parts-library-catalog-c-136_138/#301020029
301020000 | FHCFR-1/4W-102J | DIP RES 1K-5%-1/4W;Axial-D2.3*L6.5mm | Resistor | Axial-D2.3*L6.5mm | Fenghua |  | 0.010 | 100 | 2 | 0.20 |  | http://www.seeedstudio.com/depot/OPLopen-parts-library-catalog-c-136_138/#301020000
301020001 | FHCFR-1/4W-103J | DIP RES 10K-5%-1/4W;Axial-D2.3*L6.5mm | Resistor | Axial-D2.3*L6.5mm | Fenghua |  | 0.010 | 100 | 2 | 0.20 |  | http://www.seeedstudio.com/depot/OPLopen-parts-library-catalog-c-136_138/#301020001
310030073 | L7805CV-DG | DIP PMIC;LDO;Vin 35V;5V;1.5A;Without En;1-Ch | IC | TO-220 | STMicroelectronics |  | 0.700 | 3 | 3 | 0.30 |  | http://www.seeedstudio.com/depot/OPLopen-parts-library-catalog-c-136_138/#310030073
302010072 | CC0603KRX7R9BB681 | SMD CAP Ceramic 680pF-50V-10%-X7R | Capacitor | 0603 | YAGEO |  | 0.010 | 100 | 2 | 0.20 |  | http://www.seeedstudio.com/depot/OPLopen-parts-library-catalog-c-136_138/#302010072
302010009 | CC0402KRX7R9BB681 | SMD CAP Ceramic 680pF-50V-10%-X7R | Capacitor | 0402 | YAGEO |  | 0.010 | 100 | 2 | 0.20 |  | http://www.seeedstudio.com/depot/OPLopen-parts-library-catalog-c-136_138/#302010009
302010163 | CC0805KRX7R9BB681 | SMD CAP Ceramic 680pF-50V-10%-X7R | Capacitor | 0805 | YAGEO |  | 0.025 | 50 | 2 | 0.20 |  | http://www.seeedstudio.com/depot/OPLopen-parts-library-catalog-c-136_138/#302010163
302010022 | CC0402KRX7R9BB222 | SMD CAP Ceramic 2.2nF-50V-10%-X7R | Capacitor | 0402 | YAGEO |  | 0.010 | 100 | 2 | 0.20 |  | http://www.seeedstudio.com/depot/OPLopen-parts-library-catalog-c-136_138/#302010022
302010092 | CC0603KRX7R8BB474 | SMD CAP Ceramic 470nF-25V-10%-X7R; | Capacitor | 0603 | YAGEO |  | 0.040 | 50 | 2 | 0.20 |  | http://www.seeedstudio.com/depot/OPLopen-parts-library-catalog-c-136_138/#302010092
302010232 | CC0402KRX5R6BB474 | SMD CAP Ceramic 470nF-10V-10%-X5R; | Capacitor | 0402 | YAGEO |  | 0.015 | 100 | 2 | 0.20 |  | http://www.seeedstudio.com/depot/OPLopen-parts-library-catalog-c-136_138/#302010232
302020010 | TAJA225K016RNJ | SMD CAP Tantalum 2.2uF-16V | Capacitor | AVX-A | AVX |  | 1.000 | 3 | 2 | 0.20 |  | http://www.seeedstudio.com/depot/OPLopen-parts-library-catalog-c-136_138/#302020010
302020032 | TAJE227K016RNJ | SMD CAP Tantalum 220uF-16V | Capacitor | AVX-E | AVX |  | 1.000 | 3 | 2 | 0.20 |  | http://www.seeedstudio.com/depot/OPLopen-parts-library-catalog-c-136_138/#302020032
301010080 | RC0402JR-0751RL | SMD RES 51R-5%-1/16W; | Resistor | 0402 | YAGEO |  | 0.010 | 100 | 2 | 0.20 |  | http://www.seeedstudio.com/depot/OPLopen-parts-library-catalog-c-136_138/#301010080
301010225 | RC0603FR-0751RL | SMD RES 51R-1%-1/10W | Resistor | 0603 | YAGEO |  | 0.010 | 100 | 2 | 0.20 |  | http://www.seeedstudio.com/depot/OPLopen-parts-library-catalog-c-136_138/#301010225
301010466 | RC0402FR-07330RL | SMD RES 330R-1%-1/16W;0402 | Resistor | 0402 | YAGEO |  | 0.010 | 100 | 2 | 0.20 |  | http://www.seeedstudio.com/depot/OPLopen-parts-library-catalog-c-136_138/#301010466
301010052 | RC0402FR-0722RL | SMD RES 22R-1%-1/16W | Resistor | 0402 | YAGEO |  | 0.010 | 100 | 2 | 0.20 |  | http://www.seeedstudio.com/depot/OPLopen-parts-library-catalog-c-136_138/#301010052
301010498 | RC0402JR-073K9L | SMD RES;3.9K-1/16W-5% | Resistor | 0402 | YAGEO |  | 0.010 | 100 | 2 | 0.20 |  | http://www.seeedstudio.com/depot/OPLopen-parts-library-catalog-c-136_138/#301010498
301010010 | RC0402JR-074K7L | SMD RES 4.7K-5%-1/16W | Resistor | 0402 | YAGEO |  | 0.010 | 100 | 2 | 0.20 |  | http://www.seeedstudio.com/depot/OPLopen-parts-library-catalog-c-136_138/#301010010
301010027 | RC0402JR-0751KL | SMD RES 51K-5%-1/16W | Resistor | 0402 | YAGEO |  | 0.010 | 100 | 2 | 0.20 |  | http://www.seeedstudio.com/depot/OPLopen-parts-library-catalog-c-136_138/#301010027
301010042 | RC0402JR-0715KL | SMD RES 15K-5%-1/16W | Resistor | 0402 | YAGEO |  | 0.010 | 100 | 2 | 0.20 |  | http://www.seeedstudio.com/depot/OPLopen-parts-library-catalog-c-136_138/#301010042
301010614 | RC0402JR-0782RL | SMD RES;82R-5%-1/16W | Resistor | 0402 | YAGEO |  | 0.010 | 100 | 2 | 0.20 |  | http://www.seeedstudio.com/depot/OPLopen-parts-library-catalog-c-136_138/#301010614
301010005 | RC0402JR-0747KL | SMD RES 47K-5%-1/16W | Resistor | 0402 | YAGEO |  | 0.010 | 100 | 2 | 0.20 |  | http://www.seeedstudio.com/depot/OPLopen-parts-library-catalog-c-136_138/#301010005
305040005 | SI5902DC-T1-E3 | SMD MOSFET Dual N-CH 30V-2.9A | Transistor | 1206-8 | Vishay; |  | 0.500 | 5 | 4 | 0.40 |  | http://www.seeedstudio.com/depot/OPLopen-parts-library-catalog-c-136_138/#305040005
305040004 | IRF5850 | SMD MOSFET Dual P-CH 20V-2.2A; | Transistor | TSOP-6 | International Rectifier |  | 0.500 | 5 | 3 | 0.30 |  | http://www.seeedstudio.com/depot/OPLopen-parts-library-catalog-c-136_138/#305040004
314020026 | GUVA-S12SD | UV sensor | Sensor | SMD3528 | GENICOM |  | 3.315 | 1 | 4 | 0.40 |  | http://www.seeedstudio.com/depot/OPLopen-parts-library-catalog-c-136_138/#314020026
314020025 | TSL2561T | SMD Optical Sensor | Sensor | SMD-6 | AMS-TAOS USA Inc |  | 4.000 | 1 | 2 | 0.20 |  | http://www.seeedstudio.com/depot/OPLopen-parts-library-catalog-c-136_138/#314020025
310070017 | 74HC4051PW | SMD IC Interface | IC | TSSOP-16 | NXP; |  | 0.500 | 5 | 2 | 0.20 |  | http://www.seeedstudio.com/depot/OPLopen-parts-library-catalog-c-136_138/#310070017
310050009 | 74HC595D | SMD IC Logic | IC | SOIC-16 | NXP; |  | 0.500 | 5 | 2 | 0.20 |  | http://www.seeedstudio.com/depot/OPLopen-parts-library-catalog-c-136_138/#310050009
310050012 | 74HC595N | DIP IC Logic; | IC | DIP-16 | NXP; |  | 0.600 | 5 | 16 | 1.60 |  | http://www.seeedstudio.com/depot/OPLopen-parts-library-catalog-c-136_138/#310050012
104990023 |  | 5mm Triple Output LED RGB - Common cathode(20pcs) | LED | 4P-5mm | Chengguangxing |  | 0.300 | 10 | 4 | 0.40 |  | http://www.seeedstudio.com/depot/OPLopen-parts-library-catalog-c-136_138/#104990023
301040003 | T93YA103KT20 | DIP TRIMMER 10K-10%-1/2W; | Resistor | 3P-L9.70*W5.00*H9.80mm | Vishay Sfernice |  | 1.700 | 2 | 3 | 0.30 |  | http://www.seeedstudio.com/depot/OPLopen-parts-library-catalog-c-136_138/#301040003
301010002 | RC0402JR-0722RL | SMD RES 22R-5%-1/16W | Resistor | 0402 | YAGEO |  | 0.010 | 100 | 2 | 0.20 |  | http://www.seeedstudio.com/depot/OPLopen-parts-library-catalog-c-136_138/#301010002
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
