ZeroUI/Industrial-Quark/Ziro-master/BoM/Main BoM.xlsm

Sheet: Summary
 |  |  | Quote Summary
 |  |  | Product Name: | Ziro |  | Est. Production Timeline: |  | Dec, 2016
 |  |  | Version: | 2.0
Contract Manufacturer Summary
Contract Manufacturer(CM): | >Enter Name of CM
CM Quote Reference: | >Enter Quote reference Number (Internal to CM)
Contact Person: | >Enter Name, email and contact info
Terms and Conditions: | >Enter Terms and Conditions in "Terms & Conditions" Tab
Date: | >Enter Date of Quote Generation
CoGs Summary
Product | Volume |  | Material and Assembly | Manufacturing Overhead(if any) | Direct Labor | Profit | SG&A | Logistics FOB Oakland | Selling Price
Ziro Starter Kit | Indiegogo | 500 | $0.00 | $0.00 | $0.00 | $0.00 | $0.00 | $0.00 | $0.00
 |  | 1000 | $0.00 | $0.00 | $0.00 | $0.00 | $0.00 | $0.00 | $0.00
 | Retail | 20000 | $0.00 | $0.00 | $0.00 | $0.00 | $0.00 | $0.00 | $0.00
Ziro Pro Kit | Indiegogo | 500 | $0.00 | $0.00 | $0.00 | $0.00 | $0.00 | $0.00 | $0.00
 |  | 1000 | $0.00 | $0.00 | $0.00 | $0.00 | $0.00 | $0.00 | $0.00
 | Retail | 20000 | $0.00 | $0.00 | $0.00 | $0.00 | $0.00 | $0.00 | $0.00
NRE Tooling Summary |  |  |  |  |  |  | Lead Times
Volume | Mechanical NRE |  | Electrical NRE | Other NRE | Total NRE Costs |  | Item | Max Lead Time [Wks]
Indiegogo 500 | $0.000 |  | $0.000 | $0.000 | 0 |  | Electrical NRE
Indiegogo 1000 | $0.000 |  | $0.000 | $0.000 | 0 |  | Mechanical NRE
Retail 20,000 | $0.000 |  | $0.000 | $0.000 | 0 |  | Production

Sheet: Assembly Overview
Ziro v2.0 Assembly-Component Tree [ZR2]
Motor Module [MMD] |  | Glove Module [GMD] |  |  | Accessories [ACC] | Packaging [PCK] |  | Wheels [WHL] | Tiles [TLE] | Connector Screw [CSC]
Hinge [HNG] |  | Textile [TXT] |  |  | SmartPhone Mount [SPM] | Packaging Box [BOX] | Other [DOC,LFM,UFM,CBD] | Other [BODY, TYRE] | POD [POD] | Other [BODY, F1032]
Rotating Pin [RTP] |  | PCB Shell [PSL] | Electronics [E1] |  | Other Peripherals [DCA, KYC, USB] | Charging Tray [TRA] | Mechanical [M] |  | Other [Lbracket, CAXLE (UNI/BI) ]
Rotating Pin Screw [RPS] |  |  | Mechanical [M] |  |  |  | Electronics-I [E1]
Shell [SHL] |  | Battery Shell [BSL] |  |  |  | Other- Pouch [POUCH]
Quark [QRK] | Electronics [E1]
 | Electronics [E2]
 | Mechanical [M] |  |  | Click Individual Blocks to go to respective BoM Entry

Sheet: Kit- MaterialAssembly
Material/Assembly Cost of Kit
Product | Volumes | Motor Module [ZR2-MMD] |  |  | Glove Module [ZR2-GMD] |  |  | Accessories [ZR2-ACC] |  |  | Packaging [ZR2-PCK] |  |  | Wheels [ZR2-WHL] |  |  | Tile [ZR2-TLE] |  |  | Connector Screw [ZR2-CSC] |  |  | Final Assembly Cost | Total
 |  | Unit Cost (Refer BoM) | Qty | Sub-Total | Unit Cost (Refer BoM) | Qty | Sub-Total | Unit Cost (Refer BoM) | Qty | Sub-Total | Unit Cost (Refer BoM) | Qty | Sub-Total | Unit Cost (Refer BoM) | Qty | Sub-Total | Unit Cost (Refer BoM) | Qty | Sub-Total | Unit Cost (Refer BoM) | Qty | Sub-Total
Ziro Starter Kit | 500 | $0.0000 | 2 | $0.0000 | $0.0000 | 1 | $0.0000 | $0.0000 | 1 | $0.0000 | $0.0000 | 1 | $0.0000 | $0.0000 | 2 | $0.0000 | $0.0000 | 1 | $0.0000 | $0.0000 | 1 | $0.0000 | $0.000 | $0.000000
 | 1000 | $0.00 | 2 | $0.0000 | $0.00 | 1 | $0.0000 | $0.00 | 1 | $0.0000 | $0.00 | 1 | $0.0000 | $0.00 | 2 | $0.0000 | $0.00 |  | $0.0000 | $0.00 |  | $0.0000 | $0.000 | $0.000000
 | 20000 | $0.00 | 2 | $0.0000 | $0.00 | 1 | $0.0000 | $0.00 | 1 | $0.0000 | $0.00 | 1 | $0.0000 | $0.00 | 2 | $0.0000 | $0.00 |  | $0.0000 | $0.00 |  | $0.0000 | $0.000 | $0.000000
Ziro Pro Kit | 500 | $0.0000 | 4 | $0.0000 | $0.0000 | 1 | $0.0000 | $0.0000 | 1 | $0.0000 | $0.0000 | 1 | $0.0000 | $0.0000 | 4 | $0.0000 | $0.0000 | 1 | $0.0000 | $0.0000 | 1 | $0.0000 | $0.000 | $0.000000
 | 1000 | $0.00 | 4 | $0.0000 | $0.00 | 1 | $0.0000 | $0.00 | 1 | $0.0000 | $0.00 | 1 | $0.0000 | $0.00 | 4 | $0.0000 | $0.00 | 1 | $0.0000 | $0.00 | 1 | $0.0000 | $0.000 | $0.000000
 | 20000 | $0.00 | 4 | $0.0000 | $0.00 | 1 | $0.0000 | $0.00 | 1 | $0.0000 | $0.00 | 1 | $0.0000 | $0.00 | 4 | $0.0000 | $0.00 | 1 | $0.0000 | $0.00 | 1 | $0.0000 | $0.000 | $0.000000
Note: The BoM sheet is used to populate the 500 volume row

Sheet: BOM
 |  | Bill of Materials
 |  | Product Name: | Ziro
 |  | Version: | 2
Assembly Number | Sub-Assembly Part Number | Part Number / Assembly Process | Component / Material / Assembly Process | Manufacturing Process | Conventional Naming & Description | Vendor | Vendor Part Number | Qty | Unit Price | Total Cost | Link
Motor Modules
[ZR2-MMD] Motor Modules | ZR2-MMD-HNG [Hinge] | ZR2-MMD-HNG-BODY | PQ-354C Patone ABS Plastic | Injection Molded | Hinge plastic part |  |  | 1 | $0.00000 | $0.00000
 |  | ZR2-MMD-GND-PR1032 | 10-32 Press Fits | Procured | 10-32 screw size, Screw to Expand inserts. Refer Link for more info-> |  |  | 2 | $0.00000 | $0.00000 | PR10-32 Link
 |  | ZR2-MMD-HNG-ASSM1 | Push Fit: ZR2-MMD-HNG-PR1032 into ZR2-MMD-HNG-BODY |  |  |  |  | 1 | $0.00000 | $0.00000
 | ZR2-MMD-RTP [Rotating Pin] | ZR2-MMD-RTP-BODY | PQ-374C Pantone Acetal Plastic | Injection Molded | Rotating Pin Plastic Body |  |  | 2 | $0.00000 | $0.00000
 |  | ZR2-MMD-RTP-PR1032 | 10-32 Press Fits | Procured | 10-32 screw size, Screw to Expand inserts. Refer Link for more info-> |  |  | 2 | $0.00000 | $0.00000 | PR10-32 Link
 |  | ZR2-MMD-RTP-ASSM1 | Push Fit: ZR2-MMD-RTP-PR1032 into ZR2-MMD-RTP-BODY |  |  |  |  | 2 | $0.00000 | $0.00000
 | ZR2-MMD-RPS [Rotating Pin Screw] | ZR2-MMD-RPS-BODY | PQ-374C Pantone Acetal Plastic | Injection Molded | Rotating Pin plastic part |  |  | 2 | $0.00000 | $0.00000
 |  | ZR2-MMD-RPS-F1032 | 10-32 Set Screw | Procured | 10-32 Knurl-Grip Cup Point Set Screw. Refer Link-> |  |  | 2 | $0.00000 | $0.00000 | F1032
 |  | ZR2-MMD-RPS-ASSM1 | Push Fit: ZR2-MMD-RPS-F1032 into ZR2-MMD-RPS-BODY |  |  |  |  | 2 | $0.00000 | $0.00000
 | ZR2-MMD-QRK Quark | ZR2-MMD-QRK-E1-R7 | Resistor |  | RES SMD 0.02 OHM 1% 1W 1206 | Panasonic Electronics Components | ERJ-8CWFR020V | 1 | $0.00000 | $0.00000
 |  | ZR2-MMD-QRK-E1-C2 | Capacitor |  | CAP CER 0.1UF 16V X7R 0402 | Samsun Electro-Mech America | CL05B104KO5NNNC | 1 | $0.00000 | $0.00000
 |  | ZR2-MMD-QRK-E1-C3 | Capacitor |  | CAP CER 0.1UF 16V X7R 0402 | Samsun Electro-Mech America | CL05B104KO5NNNC | 1 | $0.00000 | $0.00000
 |  | ZR2-MMD-QRK-E1-C5 | Capacitor |  | CAP CER 0.1UF 16V X7R 0402 | Samsun Electro-Mech America | CL05B104KO5NNNC | 1 | $0.00000 | $0.00000
 |  | ZR2-MMD-QRK-E1-C4 | Capacitor |  | 100µF 6.3V Ceramic Capacitor X5R 1206 | Murata Electronics | GRM31CR60J107ME39K | 1 | $0.00000 | $0.00000
 |  | ZR2-MMD-QRK-E1-C1 | Capacitor |  | 100µF 25V Aluminum Capacitors Radial, Can 2000 Hrs @ 85°C | Nichicon | UVR1E101MED1TA | 1 | $0.00000 | $0.00000
 |  | ZR2-MMD-QRK-E1-R11 | Resistor |  | Resistive Sensor Rotary Position Hole for Shaft SMD | Murata Electronics | SV01A103AEA01B00 | 1 | $0.00000 | $0.00000
 |  | ZR2-MMD-QRK-E1-C6 | Capacitor |  | 1µF 16V Ceramic Capacitor X5R 0603 (1608 Metric) 0.063" | Murata Electronics | GRM188R61C105KA93D | 1 | $0.00000 | $0.00000
 |  | ZR2-MMD-QRK-E1-C7 | Capacitor |  | 1µF 16V Ceramic Capacitor X5R 0603 (1608 Metric) 0.063" | Murata Electronics | GRM188R61C105KA93D | 1 | $0.00000 | $0.00000
 |  | ZR2-MMD-QRK-E1-C8 | Capacitor |  | 1µF 16V Ceramic Capacitor X5R 0603 (1608 Metric) 0.063" | Murata Electronics | GRM188R61C105KA93D | 1 | $0.00000 | $0.00000
 |  | ZR2-MMD-QRK-E1-C9 | Capacitor |  | 1µF 16V Ceramic Capacitor X5R 0603 (1608 Metric) 0.063" | Murata Electronics | GRM188R61C105KA93D | 1 | $0.00000 | $0.00000
 |  | ZR2-MMD-QRK-E1-C11 | Capacitor |  | 1µF 16V Ceramic Capacitor X5R 0603 (1608 Metric) 0.063" | Murata Electronics | GRM188R61C105KA93D | 1 | $0.00000 | $0.00000
 |  | ZR2-MMD-QRK-E1-R1 | Resistor |  | RES SMD 30K OHM 5% 1/16W 0402 | Yageo | RC0402JR-0730KL | 1 | $0.00000 | $0.00000
 |  | ZR2-MMD-QRK-E1-R3 | Resistor |  | RES SMD 30K OHM 5% 1/16W 0402 | Yageo | RC0402JR-0730KL | 1 | $0.00000 | $0.00000
 |  | ZR2-MMD-QRK-E1-R6 | Resistor |  | RES SMD 30K OHM 5% 1/16W 0402 | Yageo | RC0402JR-0730KL | 1 | $0.00000 | $0.00000
 |  | ZR2-MMD-QRK-E1-R9 | Resistor |  | RES SMD 30K OHM 5% 1/16W 0402 | Yageo | RC0402JR-0730KL | 1 | $0.00000 | $0.00000
 |  | ZR2-MMD-QRK-E1-R10 | Resistor |  | RES SMD 30K OHM 5% 1/16W 0402 | Yageo | RC0402JR-0730KL | 1 | $0.00000 | $0.00000
 |  | ZR2-MMD-QRK-E1-R2 | Resistor |  | RES SMD 3K OHM 5% 1/16W 0402 | Yageo | RC0402JR-073KL | 1 | $0.00000 | $0.00000
 |  | ZR2-MMD-QRK-E1-R5 | Resistor |  | RES SMD 3K OHM 5% 1/16W 0402 | Yageo | RC0402JR-073KL | 1 | $0.00000 | $0.00000
 |  | ZR2-MMD-QRK-E1-R8 | Resistor |  | RES SMD 3K OHM 5% 1/16W 0402 | Yageo | RC0402JR-073KL | 1 | $0.00000 | $0.00000
 |  | ZR2-MMD-QRK-E1-R12 | Resistor |  | RES SMD 3K OHM 5% 1/16W 0402 | Yageo | RC0402JR-073KL | 1 | $0.00000 | $0.00000
 |  | ZR2-MMD-QRK-E1-IC2 | Integrated Chip |  | 1 Circuit IC Switch 8:1 120 Ohm 16-DHVQFN | NXP Semiconductors | 74HC4051BQ,115 | 1 | $0.00000 | $0.00000
 |  | ZR2-MMD-QRK-E1-IC4 | Integrated Chip |  | Bipolar Motor Driver Power MOSFET Parallel 12-WSON (3x2) | Texas Instruments | DRV8835DSSR | 1 | $0.00000 | $0.00000
 |  | ZR2-MMD-QRK-E1-D1 | Diode |  | TVS DIODE 5VWM 12.3VC SOD923 | ON Semiconductor | ESD9X5.0ST5G | 1 | $0.00000 | $0.00000
 |  | ZR2-MMD-QRK-E1-SV1 | Connector |  | 14 POS, Thru Hole, 90deg, Header Connector Gold 0.079" (2.54mm) | TE Connectivity AMP Connector | 5176837-6 | 1 | $0.00000 | $0.00000
 |  | ZR2-MMD-QRK-E1-IC1 | Integrated Chip |  | Linear Voltage Regulator IC, Fixed Output 3.3V 800mA SOT-223 | Diodes Inc | AZ1117CH-3.3TRG1 | 1 | $0.00000 | $0.00000
 |  | ZR2-MMD-QRK-E1-IC5 | Integrated Chip |  | General Purpose Amplifier 2 Circuit 8-DFN (2x2) | STMicroelectronics | LM358QT | 1 | $0.00000 | $0.00000
 |  | ZR2-MMD-QRK-E1-D2 | Diode |  | Diode Schottky 30V 500mA DC Surface Mount SOD-523 | NXP Semiconductors | PMEG3005EB,115 | 1 | $0.00000 | $0.00000
 |  | ZR2-MMD-QRK-E1-IC3 | Integrated Chip |  | WT8266-S1 Wi-Fi Module: | Wireless-Tag | WT8266-S1 | 1 | $0.00000 | $0.00000 | sky@wireless-tag.com
 |  | ZR2-MMD-QRK-E1-BAT | Battery | Procured | 8.4V, 600mAh Li-ion battery pack. EBL SZLE 6F22 | SZLEPower |  |  | $0.00000 | $0.00000 | bluce@szlepower.com
 |  | ZR2-MMD-QRK-E1-MOT | Brushed DC Motor |  | Carbon Brush Motor, 3.5V-7V, 0-21300rpm, 0-60gcm Stall Torque with Brass Pinion Gear- 9 teeth, 0.3 modulus | Dong Hui Motor | DRK-02OSH-17125 | 1 | $0.00000 | $0.00000 | dylan_wang@donghui-motor.com
 |  | ZR2-MMD-QRK-E1-PCB | PCB I, Green FR4, 0.031", 1oz, White Silkscreen | PCB Mft. |  |  |  | 1 | $0.00000 | $0.00000
 |  | ZR2-MMD-QRK-E1-ASSM1 | PCB Assembly ZR2-MMD-QRK-E1-xxx into ZR2-MMD-QRK-E1-PCB | PCBA with 100% AOI Testing |  |  |  | 1 | $0.00000 | $0.00000
 |  | ZR2-MMD-QRK-E1-ASSM2 | Insert and Solder Insert Motor(ZR2-MMD-QRK-E1-MOT) and solder into PCB-I (ZR2-MMD-QRK-E1-PCB) |  |  |  |  | 1 | $0.00000 | $0.00000
 |  | ZR2-MMD-QRK-E2-C1 | Capacitor |  | CAP CER 0.1UF 16V X7R 0402 | Samsun Electro-Mech America | CL05B104KO5NNNC | 1 | $0.00000 | $0.00000
 |  | ZR2-MMD-QRK-E2-C2 | Capacitor |  | CAP CER 0.1UF 16V X7R 0402 | Samsun Electro-Mech America | CL05B104KO5NNNC | 1 | $0.00000 | $0.00000
 |  | ZR2-MMD-QRK-E2-C3 | Capacitor |  | CAP CER 0.1UF 16V X7R 0402 | Samsun Electro-Mech America | CL05B104KO5NNNC | 1 | $0.00000 | $0.00000
 |  | ZR2-MMD-QRK-E2-C4 | Capacitor |  | CAP CER 0.1UF 16V X7R 0402 | Samsun Electro-Mech America | CL05B104KO5NNNC | 1 | $0.00000 | $0.00000
 |  | ZR2-MMD-QRK-E2-C5 | Capacitor |  | CAP CER 0.1UF 16V X7R 0402 | Samsun Electro-Mech America | CL05B104KO5NNNC | 1 | $0.00000 | $0.00000
 |  | ZR2-MMD-QRK-E2-D1 | Diode |  | Diode Schottky 30V 500mA DC Surface Mount SOD-523 | NXP Semiconductors | PMEG3005EB,115 | 1 | $0.00000 | $0.00000
 |  | ZR2-MMD-QRK-E2-D2 | Diode |  | Diode Schottky 30V 500mA DC Surface Mount SOD-523 | NXP Semiconductors | PMEG3005EB,115 | 1 | $0.00000 | $0.00000
 |  | ZR2-MMD-QRK-E2-D5 | Diode |  | Diode Schottky 30V 500mA DC Surface Mount SOD-523 | NXP Semiconductors | PMEG3005EB,115 | 1 | $0.00000 | $0.00000
 |  | ZR2-MMD-QRK-E2-D6 | Diode |  | RGB LED | Broadcom Limited | ASMB-MTB1-0A3A2 | 1 | $0.00000 | $0.00000
 |  | ZR2-MMD-QRK-E2-D7 | Diode |  | RGB LED | Broadcom Limited | ASMB-MTB1-0A3A2 | 1 | $0.00000 | $0.00000
 |  | ZR2-MMD-QRK-E2-IC1 | Integrated Circuit |  | IC LI-ION LDO CHRG MGMT 8-SOIC | Texas Instruments | BQ2057WSNTR | 1 | $0.00000 | $0.00000
 |  | ZR2-MMD-QRK-E2-J1 | Magnetic Connector. See Link <--- |  | Female magnetic connector (Hand solder From Back). See Link <- | CFE Corporation Co. Ltd | M-BP14202-01000H0CE12 L14B12:L14AG12:L14 | 1 | $0.00000 | $0.00000 | sales04@cfconn.com
 |  | ZR2-MMD-QRK-E2-N & P | 9V Battery Strap |  | STRAP BATT ECON 9V I STYLE 6"LD (Hand solder From Front | Keystone Electronics | 233 | 1 | $0.00000 | $0.00000
 |  | ZR2-MMD-QRK-E2-Q1 | Mosfets |  | MOSFET P-CH 20V 6.9A 6TSOP | Infineon Technologies | IRLTS2242TRPBF | 1 | $0.00000 | $0.00000
 |  | ZR2-MMD-QRK-E2-Q2 | Mosfets |  | MOSFET N-CH 60V 0.36A SOT-23 | NXP Semiconductors | 2N7002P,215 | 1 | $0.00000 | $0.00000
 |  | ZR2-MMD-QRK-E2-Q3 | Mosfets |  | MOSFET P-CH 20V 6.9A 6TSOP | Infineon Technologies | IRLTS2242TRPBF | 1 | $0.00000 | $0.00000
 |  | ZR2-MMD-QRK-E2-R1 | Resistor |  | RES SMD 30K OHM 5% 1/16W 0402 | Yageo | RC0402JR-0730KL | 1 | $0.00000 | $0.00000
 |  | ZR2-MMD-QRK-E2-R10 | Resistor |  | RES SMD 30K OHM 5% 1/16W 0402 | Yageo | RC0402JR-0730KL | 1 | $0.00000 | $0.00000
 |  | ZR2-MMD-QRK-E2-R11 | Resistor |  | RES SMD 3K OHM 5% 1/16W 0402 | Yageo | RC0402JR-073KL | 1 | $0.00000 | $0.00000
 |  | ZR2-MMD-QRK-E2-R13 | Resistor |  | RES SMD 3K OHM 5% 1/16W 0402 | Yageo | RC0402JR-073KL | 1 | $0.00000 | $0.00000
 |  | ZR2-MMD-QRK-E2-R15 | Resistor |  | RES ARRAY 4 RES 75 OHM 1206 | Yageo | YC164-JR-0775RL | 1 | $0.00000 | $0.00000
 |  | ZR2-MMD-QRK-E2-R2 | Resistor |  | RES SMD 0.62 OHM 5% 1/2W 1206 | TE Connectivity AMP Connectors | RLP73K2BR62JTD | 1 | $0.00000 | $0.00000
 |  | ZR2-MMD-QRK-E2-R3 | Resistor |  | RES SMD 300K OHM 5% 1/16W 0402 | Yageo | RC0402JR-07300KL | 1 | $0.00000 | $0.00000
 |  | ZR2-MMD-QRK-E2-R4 | Resistor |  | RES SMD 300K OHM 5% 1/16W 0402 | Yageo | RC0402JR-07300KL | 1 | $0.00000 | $0.00000
 |  | ZR2-MMD-QRK-E2-R5 | Resistor |  | RES SMD 300K OHM 5% 1/16W 0402 | Yageo | RC0402JR-07300KL | 1 | $0.00000 | $0.00000
 |  | ZR2-MMD-QRK-E2-R6 | Resistor |  | RES SMD 3K OHM 5% 1/16W 0402 | Yageo | RC0402JR-073KL | 1 | $0.00000 | $0.00000
 |  | ZR2-MMD-QRK-E2-R7 | Resistor |  | RES SMD 3K OHM 5% 1/16W 0402 | Yageo | RC0402JR-073KL | 1 | $0.00000 | $0.00000
 |  | ZR2-MMD-QRK-E2-R8 | Resistor |  | RES SMD 3K OHM 5% 1/16W 0402 | Yageo | RC0402JR-073KL | 1 | $0.00000 | $0.00000
 |  | ZR2-MMD-QRK-E2-R9 | Resistor |  | RES SMD 3K OHM 5% 1/16W 0402 | Yageo | RC0402JR-073KL | 1 | $0.00000 | $0.00000
 |  | ZR2-MMD-QRK-E2-S1 | Switch |  | Tactile Switch SPST-NO Top Actuated Surface Mount | C&K Components | PTS645SM43SMTR92 LFS | 1 | $0.00000 | $0.00000
 |  | ZR2-MMD-QRK-E2-S2 | Switch |  | Tactile Switch SPST-NO Top Actuated Surface Mount | C&K Components | PTS645SM43SMTR92 LFS | 1 | $0.00000 | $0.00000
 |  | ZR2-MMD-QRK-E2-PCB | PCB II, Green FR4, 0.031", 1oz, White Silkscreen |  |  |  |  | 1 | $0.00000 | $0.00000
 |  | ZR2-MMD-QRK-E2-ASSM1 | PCB Assembly Solder all components to PCB i.e. ZR2-MMD-QRK-E2-xxx into ZR2-MMD-QRK-E2-PCB | PCBA with 100% AOI Testing |  |  |  | 1 | $0.00000 | $0.00000
 |  | ZR2-MMD-QRK-E2-ASSM2 | Solder Assemble magnetic connector to PCB i.e. ZR2-MMD-QRK-E2-J1 to ZR2-MMD-QRK-E2-PCB |  |  |  |  | 1 | $0.00000 | $0.00000
 |  | ZR2-MMD-QRK-E1-ASSM3 | Solder Solder male header of PCB1 to PCB2 i.e. ZR2-MMD-QRK-E1-SV1 to ZR2-MMD-QRK-E2 |  |  |  |  | 1 | $0.00000 | $0.00000
 |  | ZR2-MMD-QRK-M-CTP | White Opaque ABS Plastic | Injection Molded | Quark Housing- Top Lid |  |  | 1 | $0.00000 | $0.00000
 |  | ZR2-MMD-QRK-M-CMD | White Opaque ABS Plastic | Injection Molded | Quark Housing- Gear Housing |  |  | 1 | $0.00000 | $0.00000
 |  | ZR2-MMD-QRK-M-CBM | White Opaque ABS Plastic | Injection Molded | Quark Housing- Bottom Lid |  |  | 1 | $0.00000 | $0.00000
 |  | ZR2-MMD-QRK-M-SFT150-725-G2 | Steel |  | Gear 2 Shaft: 1.5X7.25mm Steel Shaft |  |  | 1 | $0.00000 | $0.00000
 |  | ZR2-MMD-QRK-M-SFT150-1300-G3 | Steel |  | Gear 3 Shaft: 1.5X13.00mm Steel Shaft |  |  | 1 | $0.00000 | $0.00000
 |  | ZR2-MMD-QRK-M-SFT150-1900-G4 | Steel |  | Gear 4 Shaft: 1.5X19.00mm Steel Shaft |  |  | 1 | $0.00000 | $0.00000
 |  | ZR2-MMD-QRK-M-G2 | Nylon/Acetal- White Opaque | Injection Molded | Gear 2- Large ( 43Teeth, 0.3Modulus) Small ( 9 Teeth, 0.3 Modulus) |  |  | 1 | $0.00000 | $0.00000
 |  | ZR2-MMD-QRK-M-G3 | Nylon/Acetal- White Opaque' | Injection Molded | Gear 3- Large (43Teeth, 0.3Modulus) Small (9Teeth, 0.4Modulus) |  |  | 1 | $0.00000 | $0.00000
 |  | ZR2-MMD-QRK-M-G4 | Nylon/Acetal- White Opaque | Injection Molded | Gear 4- Large (35Teeth, 0.4 Modulus) Small (11Teeth, 0.5 Modulus) |  |  | 1 | $0.00000 | $0.00000
 |  | ZR2-MMD-QRK-M-G5 | ABS Plastic- White Opaque | Injection Molded | Gear 5- Output Gear (32Teeth, 0.5Modulus) |  |  | 1 | $0.00000 | $0.00000
 |  | ZR2-MMD-QRK-M-GPC | Nylon/Acetal- White Opaque | Injection Molded | Potentiometer to output shaft connector |  |  | 1 | $0.00000 | $0.00000
 |  | ZR2-MMD-QRK-M-SCR-18-8 | M2 x 35mm, 0.4mm Pitch Screw | Procured | M2x35mm 18-8 Socket Head Bolt. Refer Link -> |  |  | 4 | $0.00000 | $0.00000 | SCR-18-8
 |  | ZR2-MMD-QRK-ASSM1 | Insert: Slide Motor and PCB assembly into Quark housing i.e. ZR2-MMD-QRK-E1-ASSM3 into ZR2-MMD-QRK-M-CMD |  |  |  |  | 1 | $0.00000 | $0.00000
 |  | ZR2-MMD-QRK-ASSM2 | Insert: Put 3 shafts ZR2-MMD-QRK-M-(SFT150-725-G2, SFT150-1300-G3, SFT150-1900-G4), into ZR2-MMD-QRK-M-CMD |  |  |  |  | 1 | $0.00000 | $0.00000
 |  | ZR2-MMD-QRK-ASSM3 | Insert: Five Plastic Gears ZR2-MMD-QRK-M-(GPC,G5,G4,G3,G2) onto above placed shafts. Order: (GPC,G5,G4,G3,G2) |  |  |  |  | 1 | $0.00000 | $0.00000
 |  | ZR2-MMD-QRK-ASSM4 | Cover: Put the lid ZR2-MMD-QRK-M-CTP |  |  |  |  | 1 | $0.00000 | $0.00000
 |  | ZR2-MMD-QRK-ASSM5 | Cover: Put the lid ZR2-MMD-QRK-M-CBM |  |  |  |  | 1 | $0.00000 | $0.00000
 |  | ZR2-MMD-QRK-ASSM6 | Screw: Screw 4 ZR2-MMD-QRK-M-SCR-18-8 into top lid
 |  | ZR2-MMD-QRK-ASSM7 | Insert: ZR2-MMD-RTP-ASSM1 over ZR2-MMD-QRK-M-G5 |  |  |  |  | 1 | $0.00000 | $0.00000
 | ZR2-MMD-SHL [Shell] | ZR2-MMD-SHL-BODY | White Opaque ABS Plastic | Injection Molded | Plastic Chassis of Motor Module. Houses Quark and the rest. |  |  | 2 | $0.00000 | $0.00000
 |  | ZR2-MMD-SHL-BLID | White Opaque ABS Plastic | Injection Molded | Battery cover- plastic |  |  | 1 | $0.00000 | $0.00000
 |  | ZR2-MMD-SHL-SQN | Brass Square Nut 10-32 | Procured | Square Brass Nuts (10-32) . Refer Link-> |  |  | 2 | $0.00000 | $0.00000 | SHL-SQN
 |  | ZR2-MMD-SHL-KNSHFT | Knurled Steel Dowel Pin | Procured | Dia 1/8", Length 1" Knurled Steel Dowel Pin |  |  | 4 | $0.00000 | $0.00000 | KNSHFT
 | MMD Final Assembly Operations | ZR2-MMD-ASSM1 | Insert : Insert ZR2-MMD-SHL-KNSHFT to the holes of the knurled shafts in the shell ZR2-MMD-SHL-BODY |  |  |  |  | 1 | $0.00000 | $0.00000
 |  | ZR2-MMD-ASSM2 | Insert: ZR2-MMD-RTP-ASSM1 in ZR2-MMD-ASSM1 on the opposite side of the quark. |  |  |  |  | 1 | $0.00000 | $0.00000
 |  | ZR2-MMD-ASSM3 | Insert: Insert Quark with PCB (finished in the process ZR2-MMD-QRK-ASSM6) into ZR2-MMD-SHL-BODY |  |  |  |  | 1 | $0.00000 | $0.00000
 |  | ZR2-MMD-ASSM4 | Insert: Square Nuts ZR2-MMD-SHL-SQN into the ZR2-MMD-SHL-BODY |  |  |  |  | 1 | $0.00000 | $0.00000
 |  | ZR2-MMD-ASSM5 | Push Fit: Push shell (ZR2-MMD-SHL-BODY) onto above assembly making sure battery connector is in position |  |  |  |  | 1 | $0.00000 | $0.00000
 |  |  |  |  |  |  |  | MMD Total |  | $0.00000
Glove Modules
ZR2-GMD [Glove Modules] | ZR2-GMD-TXT [Glove Textile] | ZR2-GMD-TXT-BODY | Various Textile Materials. Refer Link <----- for glove textile and assembly | Sourced | Fabric construction of the fully assembled glove | Find Suitable Vendor |  | 1 | $0.00000 | $0.00000
 | ZR2-GMD-PSL [PCB Shell] | ZR2-GMD-PSL-M-UPR-BODY | PQ-354C Patone ABS Plastic | Injection Molded | Upper plastic casing for the PCB of the glove. |  |  | 1 | $0.00000 | $0.00000
 |  | ZR2-GMD-PSL-M-LOW-BODY | PQ-354C Patone ABS Plastic | Injection Molded | Lower plastic casing for the PCB of the glove. |  |  | 1 | $0.00000 | $0.00000
 |  | ZR2-GMD-PSL-E1-C11 | Capacitor |  | CAP CER 0.1UF 16V X7R 0402 | Samsun Electro-Mech America | 1276-1001-1-ND | 1 | $0.00000 | $0.00000
 |  | ZR2-GMD-PSL-E1-C3 | Capacitor |  | CAP CER 0.1UF 16V X7R 0402 | Samsun Electro-Mech America | 1276-1001-1-ND | 1 | $0.00000 | $0.00000
 |  | ZR2-GMD-PSL-E1-C4 | Capacitor |  | CAP CER 0.1UF 16V X7R 0402 | Samsun Electro-Mech America | 1276-1001-1-ND | 1 | $0.00000 | $0.00000
 |  | ZR2-GMD-PSL-E1-C6 | Capacitor |  | CAP CER 0.1UF 16V X7R 0402 | Samsun Electro-Mech America | 1276-1001-1-ND | 1 | $0.00000 | $0.00000
 |  | ZR2-GMD-PSL-E1-C7 | Capacitor |  | 100µF 6.3V Ceramic Capacitor X5R 1206 | Murata Electronics | 490-7217-1-ND | 1 | $0.00000 | $0.00000
 |  | ZR2-GMD-PSL-E1-R8 | Resistor |  | RES SMD 10K OHM 5% 1/16W 0402 | TE Connectivity AMP Connectors | A106045CT-ND | 1 | $0.00000 | $0.00000
 |  | ZR2-GMD-PSL-E1-C9 | Capacitor |  | CAP CER 10000PF 50V X7R 0402 | Murata Electronics | 490-4516-2-ND | 1 | $0.00000 | $0.00000
 |  | ZR2-GMD-PSL-E1-C1 | Capacitor |  | CAP CER 10UF 10V X5R 0402 | Samsun Electro-Mech America | 1276-6830-1-ND | 1 | $0.00000 | $0.00000
 |  | ZR2-GMD-PSL-E1-C2 | Capacitor |  | CAP CER 10UF 10V X5R 0402 | Samsun Electro-Mech America | 1276-6830-1-ND | 1 | $0.00000 | $0.00000
 |  | ZR2-GMD-PSL-E1-C5 | Capacitor |  | CAP CER 10UF 10V X5R 0402 | Samsun Electro-Mech America | 1276-6830-1-ND | 1 | $0.00000 | $0.00000
 |  | ZR2-GMD-PSL-E1-C10 | Capacitor |  | CAP CER 2200PF 50V X7R 0402 | Murata Electronics | 490-6359-1-ND | 1 | $0.00000 | $0.00000
 |  | ZR2-GMD-PSL-E1-Q1 | Mosfet |  | MOSFET N-CH 60V 0.36A SOT-23 | NXP Semiconductors | 568-5818-1-ND | 1 | $0.00000 | $0.00000
 |  | ZR2-GMD-PSL-E1-R2 | Resistor |  | RES SMD 300K OHM 5% 1/16W 0402 | Yageo | 311-300KJRCT-ND | 1 | $0.00000 | $0.00000
 |  | ZR2-GMD-PSL-E1-R3 | Resistor |  | RES SMD 300K OHM 5% 1/16W 0402 | Yageo | 311-300KJRCT-ND | 1 | $0.00000 | $0.00000
 |  | ZR2-GMD-PSL-E1-R4 | Resistor |  | RES SMD 300K OHM 5% 1/16W 0402 | Yageo | 311-300KJRCT-ND | 1 | $0.00000 | $0.00000
 |  | ZR2-GMD-PSL-E1-R6 | Resistor |  | RES SMD 300K OHM 5% 1/16W 0402 | Yageo | 311-300KJRCT-ND | 1 | $0.00000 | $0.00000
 |  | ZR2-GMD-PSL-E1-R7 | Resistor |  | RES SMD 30K OHM 5% 1/16W 0402 | Yageo | 311-30KJRCT-ND | 1 | $0.00000 | $0.00000
 |  | ZR2-GMD-PSL-E1-R13 | Resistor |  | RES SMD 300 OHM 5% 1/16W 0402 | Yageo | 311-300JRTR-ND | 1 | $0.00000 | $0.00000
 |  | ZR2-GMD-PSL-E1-R1 | Resistor |  | RES SMD 3K OHM 5% 1/16W 0402 | Yageo | 311-3.0KJRCT-ND | 1 | $0.00000 | $0.00000
 |  | ZR2-GMD-PSL-E1-R10 | Resistor |  | RES SMD 3K OHM 5% 1/16W 0402 | Yageo | 311-3.0KJRCT-ND | 1 | $0.00000 | $0.00000
 |  | ZR2-GMD-PSL-E1-R11 | Resistor |  | RES SMD 3K OHM 5% 1/16W 0402 | Yageo | 311-3.0KJRCT-ND | 1 | $0.00000 | $0.00000
 |  | ZR2-GMD-PSL-E1-R12 | Resistor |  | RES SMD 3K OHM 5% 1/16W 0402 | Yageo | 311-3.0KJRCT-ND | 1 | $0.00000 | $0.00000
 |  | ZR2-GMD-PSL-E1-R14 | Resistor |  | RES SMD 3K OHM 5% 1/16W 0402 | Yageo | 311-3.0KJRCT-ND | 1 | $0.00000 | $0.00000
 |  | ZR2-GMD-PSL-E1-R16 | Resistor |  | RES SMD 3K OHM 5% 1/16W 0402 | Yageo | 311-3.0KJRCT-ND | 1 | $0.00000 | $0.00000
 |  | ZR2-GMD-PSL-E1-R5 | Resistor |  | RES SMD 3K OHM 5% 1/16W 0402 | Yageo | 311-3.0KJRCT-ND | 1 | $0.00000 | $0.00000
 |  | ZR2-GMD-PSL-E1-R9 | Resistor |  | RES SMD 3K OHM 5% 1/16W 0402 | Yageo | 311-3.0KJRCT-ND | 1 | $0.00000 | $0.00000
 |  | ZR2-GMD-PSL-E1-R15 | Resistor |  | RES ARRAY 4 RES 510K OHM 1206 | Vishay Dale | CRA6S8510KCT-ND | 1 | $0.00000 | $0.00000
 |  | ZR2-GMD-PSL-E1-IC4 | Integrated Circuit |  | 1 Circuit IC Switch 8:1 120 Ohm 16-DHVQFN | NXP Semiconductors | 568-7741-1-ND | 1 | $0.00000 | $0.00000
 |  | ZR2-GMD-PSL-E1-IC1 | Integrated Circuit |  | Linear Voltage Regulator IC, Fixed 1 Output 3.3V 600mA SOT-23-5 | Diodes Inc | AP2112K-3.3TRG1DICT-ND | 1 | $0.00000 | $0.00000
 |  | ZR2-GMD-PSL-E1-IC2 | Integrated Circuit |  | IC BATT CHG LI-ION 1 CELL 10SON | Texas Instruments | 296-37142-1-ND | 1 | $0.00000 | $0.00000
 |  | ZR2-GMD-PSL-E1-X1 | Connector |  | 6 Position FFC, FPC Connector Contacts, Bottom 0.039" 1.00mm Surface Mount, Right Angle | Amphenol FCI | 609-1891-1-ND | 1 | $0.00000 | $0.00000
 |  | ZR2-GMD-PSL-E1-J2 | Connector |  | 2 Positions Header, Shrouded Connector 0.039" 1.00mm Surface Mount, Right Angle Tin | JST Sales America Inc. | 455-1802-1-ND | 1 | $0.00000 | $0.00000
 |  | ZR2-GMD-PSL-E1-D2 | Diode |  | TVS DIODE 5VWM 12.3VC SOD923 | ON Semiconductor | ESD9X5.0ST5GOSTR-ND | 1 | $0.00000 | $0.00000
 |  | ZR2-GMD-PSL-E1-J1 | USB Connector |  | USB - micro B USB 2.0 Receptacle Connector 5 Position Surface Mount, Right Angle, Horizontal | Amphenol FCI | 609-4616-1-ND | 1 | $0.00000 | $0.00000
 |  | ZR2-GMD-PSL-E1-IC5 | Integrated Circuit |  | 6-axis Accel/Gyro 24QFN, ±2G, I2C interface, 3.3V | Invensense | 1428-1007-2-ND | 1 | $0.00000 | $0.00000
 |  | ZR2-GMD-PSL-E1-D1 | Diode |  | Diode Schottky 30V 500mA DC Surface Mount SOD-523 | NXP Semiconductors | 568-7397-2-ND | 1 | $0.00000 | $0.00000
 |  | ZR2-GMD-PSL-E1-SW1 | Switch with Bi-Color LED indicator |  | Momentary Switch with Bi-ColorRed/Green LED. | Filshu Electronics or similar | PB03-1010L-16C-20 | 1 | $0.00000 | $0.00000 | sales@filshu.com
 |  | ZR2-GMD-PSL-E1-IC3 | Integrated Circuit |  | WT8266-S1 Wi-Fi Module: http://www.wireless-tag.com/index.php/product/dis/33.html | Wireless-Tag | WT8266-S1 | 1 | $0.00000 | $0.00000 | sky@wireless-tag.com
 |  | ZR2-GMD-PSL-E1-PCB | PCB, Green FR4, 0.031", 1oz, White Silkscreen | PCB Mft. |  |  |  | 1 | $0.00000 | $0.00000
 |  | ZR2-GMD-PSL-E1-FLX | Polyamide substrate with resistive ink-> Flex Sensor | Ext. Sourced | 3 Finger Custom Flex Sensors | Flexpoint |  | 1 | $0.00000 | $0.00000
 |  | ZR2-GMD-PSL-E1-ASSM1 | PCB Assembly: Assemble ZR2-GMD-PSL-E1 into ZR2-GMD-PSL-E1-PCB | PCBA with 100% AOI Testing |  |  |  | 1 | $0.00000 | $0.00000
 |  | ZR2-GMD-PSL-E1-ASSM2 | Insert: Put ZR2-GMD-E1-FLX into ZR2-GMD-PSL-E1-PCB |  |  |  |  | 1 | $0.00000 | $0.00000
 | ZR2-GMD-BSL [Battery Shell] | ZR2-GMD-BSL-BODY | PQ-354C Patone ABS Plastic | Injection Molded | The upper plastic casing for the Battery. |  |  | 1 | $0.00000 | $0.00000
 |  | ZR2-GMD-BSL-MAG | Magnetic Clasp, | Procured | Circular small magnet to clasp glove flap. Check Link-> | Find Suitable Vendor |  | 2 | $0.00000 | $0.00000 | https://www.amazon.com/New-Magnetic-Button-Clasp-Snaps/dp/B005T7OC7Q
 |  | ZR2-GMD-BSL-BAT | Battery | Procured | 3.7V 400mAh 2C rate, Li-Ion Battery, Pouch cell with in-built protection circuit. Terminated in a UL3302 AWG28 wire of length L=5’’ and end connector JST-SHR-02. Max Dimension: 5.2 x 20.5 x 42mm | Kayo Battery or similar supplier | KPL502040 | 1 | $0.00000 | $0.00000 | zwj@kayobattery.com
 | GMD Final Assembly Operations | ZR2-GMD-ASSM1 | Insert: Insert PCB with Flex sensor into enclosure i.e. ZR2-GMD-PSL-E1-ASSM2 into ZR2-GMD-PSL-M-LOW-BODY and cover it with ZR2-GMD-PSL-M-UPR-BODY |  |  |  |  | 1 | $0.00000 | $0.00000
 |  | ZR2-GMD-ASSM2 | Insert: Put Battery into Battery Shell i.e. ZR2-GMD-BSL-BAT into ZR2-GMD-BSL-BODY |  |  |  |  | 1 | $0.00000 | $0.00000
 |  | ZR2-GMD-ASSM3 | Connect Insert Battery connector into ZR2-GMD-PSL-E1-J2 on PCB |  |  |  |  | 1 | $0.00000 | $0.00000
 |  | ZR2-GMD-ASSM4 | Insert Put above assembly (ZR2-GMD-ASSM3) into Glove(ZR2-GMD-TXT) ensuring sensor location in slots |  |  |  |  | 1 | $0.00000 | $0.00000
 |  | ZR2-GMD-ASSM5 | Insert Put electronics into the Glove i.e. ZR2-GMD-ASSM1 into ZR2-GMD-TXT |  |  |  |  | 1 | $0.00000 | $0.00000
 |  | ZR2-GMD-ASSM6 | Insert Push the Switch Cap of (ZR2-GMD-PSL-E1-SW1) to holder |  |  |  |  | 1 | $0.00000 | $0.00000
 |  | ZR2-GMD-ASSM7 | Glue Put glue on the zipper and seal the glove |  |  |  |  | 1 | $0.00000 | $0.00000
 |  |  |  |  |  |  |  | GMD Total |  | $0.00000
Accessories
ZR2-ACC [Accessories] | ZR2-ACC-SPM | ZR2-ACC-SPM-BODY | White Smartphone Mount | Procured |  |  |  | 1 | $0.00000 | $0.00000
 |  | ZR2-ACC-SPM-ADAPT | Male Hex Thread Adapter: Smartphone Mount-Tile Adapter | Procured | 10-32 Thread Size, 5/16" Hex Size, 1/8" Hex Length. Refer Link-> |  |  | 1 | $0.00000 | $0.00000 | SPM-ADAPT
 |  | ZR2-ACC-SPM-ASSM1 | Screw: Screw adapter into body i.e. ZR2-ACC-SPM-(ADAPT to BODY) |  |  |  |  | 1 | $0.00000 | $0.00000
 |  | ZR2-ACC-DCA | 9V, 25W DC Adapter | Procured | 110-220VAC, 50-60Hz to 9VDC, 2.7A OUTPUT, barrell connector 2.0mm for ZR2-PCK-E1-J5. UL rated, FCC certified. Over current and short protection |  |  | 1 | $0.00000 | $0.00000
 |  | ZR2-ACC-KYC | Keychain (DNQ) | Externally Sourced | Sourcing the keychain for smaller pledges |  |  | 1 | $0.00000 | $0.00000
 |  | ZR2-ACC-USB | Micro USB Cable | Procured | Green USB to microUSB cable, L=30" i.e. RoHS compliant, TPE and non-toxic |  |  | 1 | $0.00000 | $0.00000
 |  |  |  |  |  |  |  | ACC Total |  | $0.00000
Packaging
ZR2-PCK [Packaging] | ZR2-PCK-BOX [Packaging Box] | ZR2-PCK-BOX-DOC | Information Document and Booklet | Printed | DNQ |  |  | 1 | $0.00000 | $0.00000
 |  | ZR2-PCK-BOX-LFM | EV Foam, black. Refer Link <------ | Die Cut | Lower layer of foam for housing components |  |  | 1 | $0.00000 | $0.00000
 |  | ZR2-PCK-BOX-UFM | EV Foam, black | Die Cut | Upper layer of foam |  |  | 1 | $0.00000 | $0.00000
 |  | ZR2-PCK-BOX-CBD | 12" X 10" X 5" corrugated E-flute box w laminated artwork. Refer Link <--- | Procured | Corrugated box with artwork. Refer Link----> |  |  | 1 | $0.00000 | $0.00000 | BOX ArtWork
 |  | ZR2-PCK-BOX-ASSM1 | Fold Fold cardboard into final shape i.e. ZR2-PCK-BOX-CBD into box shape |  |  |  |  | 1 | $0.00000 | $0.00000
 |  | ZR2-PCK-BOX-ASSM2 | Place Place Foam into box: ZR2-PCK-LFM and UFM into ZR2-PCK-BOX |  |  |  |  | 1 | $0.00000 | $0.00000
 | ZR2-PCK-TRA [Charging Tray] | ZR2-PCK-TRA-M-TOP | Polystyrene Sheet (White) | Vaccum Formed | Charging station tray-Top |  |  | 1 | $0.00000 | $0.00000
 |  | ZR2-PCK-TRA-M-BOT | Polystyrene Sheet (White) | Vaccum Formed | Charging station tray- Lid |  |  | 1 | $0.00000 | $0.00000
 |  | ZR2-PCK-TRA-E1-C1 | Capacitor |  | CAP CER 0.1UF 16V X7R 0402 | Samsun Electro-Mech America | CL05B104KO5NNNC | 1 | $0.00000 | $0.00000
 |  | ZR2-PCK-TRA-E1-C2 | Capacitor |  | CAP CER 22UF 25V X5R 1206 | MURATA ELECTRONICS | GRM31CR61E226ME15L | 1 | $0.00000 | $0.00000 |  | CAP CER 0.1UF 16V X7R 0402
 |  | ZR2-PCK-TRA-E1-C3 | Capacitor |  | CAP ALUM 22UF 20% 35V SMD | NICHICON | UWJ1V220MCL1GB | 1 | $0.00000 | $0.00000 |  | CAP CER 22UF 25V X5R 1206
 |  | ZR2-PCK-TRA-E1-C9 | Capacitor |  | CAP ALUM 22UF 20% 35V SMD | NICHICON | UWJ1V220MCL1GB | 1 | $0.00000 | $0.00000 |  | CAP ALUM 22UF 20% 35V SMD
 |  | ZR2-PCK-TRA-E1-C10 | Capacitor |  | CAP ALUM 22UF 20% 35V SMD | NICHICON | UWJ1V220MCL1GB | 1 | $0.00000 | $0.00000 |  | CAP ALUM 22UF 20% 35V SMD
 |  | ZR2-PCK-TRA-E1-C11 | Capacitor |  | CAP ALUM 22UF 20% 35V SMD | NICHICON | UWJ1V220MCL1GB | 1 | $0.00000 | $0.00000 |  | CAP ALUM 22UF 20% 35V SMD
 |  | ZR2-PCK-TRA-E1-C12 | Capacitor |  | CAP ALUM 22UF 20% 35V SMD | NICHICON | UWJ1V220MCL1GB | 1 | $0.00000 | $0.00000 |  | CAP ALUM 22UF 20% 35V SMD
 |  | ZR2-PCK-TRA-E1-D1 | Diode |  | LED GREEN CLEAR 1206 SMD | QT BRIGHTEK (QTB) (VA) | QBLP651-IG | 1 | $0.00000 | $0.00000 |  | CAP ALUM 22UF 20% 35V SMD
 |  | ZR2-PCK-TRA-E1-D2 | Diode |  | LED GREEN CLEAR 1206 SMD | QT BRIGHTEK (QTB) (VA) | QBLP651-IG | 1 | $0.00000 | $0.00000 |  | LED GREEN CLEAR 1206 SMD
 |  | ZR2-PCK-TRA-E1-D3 | Diode |  | LED GREEN CLEAR 1206 SMD | QT BRIGHTEK (QTB) (VA) | QBLP651-IG | 1 | $0.00000 | $0.00000 |  | LED GREEN CLEAR 1206 SMD
 |  | ZR2-PCK-TRA-E1-D4 | Diode |  | LED GREEN CLEAR 1206 SMD | QT BRIGHTEK (QTB) (VA) | QBLP651-IG | 1 | $0.00000 | $0.00000 |  | LED GREEN CLEAR 1206 SMD
 |  | ZR2-PCK-TRA-E1-D5 | Diode |  | LED GREEN CLEAR 1206 SMD | QT BRIGHTEK (QTB) (VA) | QBLP651-IG | 1 | $0.00000 | $0.00000 |  | LED GREEN CLEAR 1206 SMD
 |  | ZR2-PCK-TRA-E1-D6 | Diode |  | LED GREEN CLEAR 1206 SMD | QT BRIGHTEK (QTB) (VA) | QBLP651-IG | 1 | $0.00000 | $0.00000 |  | LED GREEN CLEAR 1206 SMD
 |  | ZR2-PCK-TRA-E1-D7 | Diode |  | LED GREEN CLEAR 1206 SMD | QT BRIGHTEK (QTB) (VA) | QBLP651-IG | 1 | $0.00000 | $0.00000 |  | LED GREEN CLEAR 1206 SMD
 |  | ZR2-PCK-TRA-E1-D8 | Diode |  | LED GREEN CLEAR 1206 SMD | QT BRIGHTEK (QTB) (VA) | QBLP651-IG | 1 | $0.00000 | $0.00000 |  | LED GREEN CLEAR 1206 SMD
 |  | ZR2-PCK-TRA-E1-D9 | Diode |  | LED GREEN CLEAR 1206 SMD | QT BRIGHTEK (QTB) (VA) | QBLP651-IG | 1 | $0.00000 | $0.00000 |  | LED GREEN CLEAR 1206 SMD
 |  | ZR2-PCK-TRA-E1-D10 | Diode |  | LED GREEN CLEAR 1206 SMD | QT BRIGHTEK (QTB) (VA) | QBLP651-IG | 1 | $0.00000 | $0.00000 |  | LED GREEN CLEAR 1206 SMD
 |  | ZR2-PCK-TRA-E1-D11 | Diode |  | LED GREEN CLEAR 1206 SMD | QT BRIGHTEK (QTB) (VA) | QBLP651-IG | 1 | $0.00000 | $0.00000 |  | LED GREEN CLEAR 1206 SMD
 |  | ZR2-PCK-TRA-E1-D12 | Diode |  | LED GREEN CLEAR 1206 SMD | QT BRIGHTEK (QTB) (VA) | QBLP651-IG | 1 | $0.00000 | $0.00000 |  | LED GREEN CLEAR 1206 SMD
 |  | ZR2-PCK-TRA-E1-IC1 | IC |  | IC REG BUCK 5V 3A SYNC 16QFN | SEMTECH CORPORATION (VA) | TS30013-M050QFNR | 1 | $0.00000 | $0.00000 |  | LED GREEN CLEAR 1206 SMD
 |  | ZR2-PCK-TRA-E1-J1 | Connector |  | Female magnetic connector | CFE Corporation Co. Ltd | M-BP14202-01000H0CE12: L14B12:L14AG12:L14 | 1 | $0.00000 | $0.00000
 |  | ZR2-PCK-TRA-E1-J2 | Connector |  | Female magnetic connector | CFE Corporation Co. Ltd | M-BP14202-01000H0CE12: L14B12:L14AG12:L15 | 1 | $0.00000 | $0.00000
 |  | ZR2-PCK-TRA-E1-J3 | Connector |  | Female magnetic connector | CFE Corporation Co. Ltd | M-BP14202-01000H0CE12: L14B12:L14AG12:L16 | 1 | $0.00000 | $0.00000
 |  | ZR2-PCK-TRA-E1-J4 | Connector |  | Female magnetic connector | CFE Corporation Co. Ltd | M-BP14202-01000H0CE12: L14B12:L14AG12:L17 | 1 | $0.00000 | $0.00000
 |  | ZR2-PCK-TRA-E1-J5 | Connector |  | CONN JACK POWER 2.0MM PCB | CUI INC | PJ-102A | 1 | $0.00000 | $0.00000
 |  | ZR2-PCK-TRA-E1-J6 | Connector |  | CONN USB TYPE A VERTICAL WHITE | ON SHORE TECHNOLOGY INC | USB-A1VSW6 | 1 | $0.00000 | $0.00000
 |  | ZR2-PCK-TRA-E1-L1 | Inductor |  | FIXED IND 4.7UH 4.6A 17 MOHM SMD | BOURNS INC | SRU8043-4R7Y | 1 | $0.00000 | $0.00000
 |  | ZR2-PCK-TRA-E1-R1 | Resistor |  | RES SMD 15 OHM 5% 1/4W 1206 | Yageo | RC1206JR-0715RL | 1 | $0.00000 | $0.00000
 |  | ZR2-PCK-TRA-E1-PCB | PCB, Green FR4, 0.031", 1oz, White Silkscreen |  | Green FR4 with white SolderMask, 0.031" Thickness with 1oz Copper Pour, 30mm x 270 mm, |  |  | 1 | $0.00000 | $0.00000
 |  | ZR2-PCK-TRA-E1-ASSM1 | PCB Assembly Assemble ZR2-PCK-E1-xxx into ZR2-PCK-E1-PCB | PCBA with 100% AOI Testing |  |  |  | 1 | $0.00000 | $0.00000
 |  | ZR2-PCK-TRA-E1-ASSM2 | Solder Insert and solder ZR2-PCK-E1-(J1:J6) into ZR2-PCB-E1-PCB |  |  |  |  | 1 | $0.00000 | $0.00000
 |  | ZR2-PCK-TRA-E1-ASSM3 | Insert Put PCB into bottom tray i.e. ZR2-PCK-E1-PCB into ZR2-PCK-TRA-BOT |  |  |  |  | 1 | $0.00000 | $0.00000
 |  | ZR2-PCK-TRA-E1-ASSM4 | Insert Insert Tray 1 onto previous assembly i.e. ZR2-PCK-TRA-TOP onto ZR2-PCK-E1-ASSM3 |  |  |  |  | 1 | $0.00000 | $0.00000
 |  | ZR2-PCK-POUCH | Green Velvet Pouch with Ziro logo | Procured | 6" x 2.5" x 1.5" (l,b,d). See Link for holding tiles |  |  | 1 | $0.00000 | $0.00000
 |  |  |  |  |  |  |  | PCK Total |  | $0.00000
Wheels
ZR2-WHL [Wheels] |  | ZR2-WHL-BODY | PQ-374C ABS Plastic | Injection Molded | The wheel would be used by the users to create land based toys |  |  | 1 | $0.00000 | $0.00000
 |  | ZR2-WHL-TYRE | PQ-19-4008 Black Nitrile Rubber, NRB | Injection Molded | The outer rubber on the tyre |  |  | 1 | $0.00000 | $0.00000
 |  | ZR2-WHL-ASSM1 | Insert Put tyre over wheel rim i.e. ZR2-WHL-TYRE onto ZR2-WHL-BODY |  |  |  |  | 1 | $0.00000 | $0.00000
 |  |  |  |  |  |  |  | WHL Total |  | $0.00000
Tile
ZR2-TLE [Tiles] | ZR2-TLE-POD | ZR2-TLE-POD-BODY | PQ-374C ABS plastic | Injection Molded | These 2 Sided plastic parts would aid in building toys (Split) |  |  | 5 | $0.00000 | $0.00000
 |  | ZR2-TLE-POD-ASSM1 | Snap On: Snap two ZR2-TLE-POD-BODY together |  |  |  |  | 2 | $0.00000 | $0.00000
 |  | ZR2-TLE-LBRACKET | PQ-354C ABS plastic | Injection Molded | Bracket used to connect modules to materials |  |  | 2 | $0.00000 | $0.00000
 |  | ZR2-TLE-CAXLE-BI-45OFF | PQ-374C ABS plastic | Injection Molded | The Offset Cross Axle To connect two tiles at angle |  |  | 2 | $0.00000 | $0.00000
 |  | ZR2-TLE-CAXLE-UNI-330 | PQ-374C ABS plastic | Injection Molded | The Cross Axle used to connect two tile to each other |  |  | 2 | $0.00000 | $0.00000
 |  |  |  |  |  |  |  | TLE Total |  | $0.00000
Connector Screw
ZR2-CSC [Connector Screw] |  | ZR2-CSC-BODY | PQ-374C Pantone Acetal Plastic | Injection Molded | The plastic part |  |  | 1 | $0.00000 | $0.00000
 |  | ZR2-CSC-F1032 | 10-32 Screws | Procured | 18-8 SS Knurl-Grip Cup Point Set Screw, 10-32 Thread, 1/2" |  |  | 1 | $0.00000 | $0.00000
 |  | ZR2-MMD-RPS-ASSM1 | Push Fit: ZR2-CSC-F1032 into ZR2-CSC-BODY |  |  |  |  | 1 | $0.00000 | $0.00000
 |  |  |  |  |  |  |  | CSC Total |  | $0.00000 | `
Final Assembly Operations |  | ZR2-ASSM1 | Download Firmware and Pair the Kit (2 minutes per kit) |  |  |  |  | 1 | $0.00000 | $0.00000
 |  | ZR2-ASSM2 | Place 2 or 4** ZR2-MMD into the tray within Box* |  |  |  |  | 1 | $0.00000 | $0.00000
 |  | ZR2-ASSM3 | Place 2 or 4** ZR2-MMD into the tray within Box* |  |  |  |  | 1 | $0.00000 | $0.00000
 |  | ZR2-ASSM4 | Place 1 ZR2-GMD into Box* |  |  |  |  | 1 | $0.00000 | $0.00000
 |  | ZR2-ASSM5 | Place 2 or 4** ZR2-TLE into ZR2-PCK-POUCH and place in Box* |  |  |  |  | 1 | $0.00000 | $0.00000
 |  | ZR2-ASSM6 | Place ZR2-ACC into Box*. |  | Note: Not all have keychaing( ZR2-ACC-KYC) |  |  | 1 | $0.00000 | $0.00000
 |  | ZR2-ASSM7 | Place 2 or 4 ZR2-WHL into Box* |  |  |  |  | 1 | $0.00000 | $0.00000
 |  | ZR2-ASSM8 | Place ZR2-PCK-BOX-DOC into Box* and close it |  |  |  |  | 1 | $0.00000 | $0.00000
 |  |  | Note: * Box refers to ZR2-PCK-ASSM5 in above ** For Starter Kit= 2 units, For Pro Kit= 4 units |  |  |  | Final Assembly Total |  |  | $0.00000

Sheet: NRE
NRE and Tooling Costs
 |  | Product Name: | Ziro
 |  | Version: | 2.0
Mechanical Tooling Costs
Item | Part Number | Part Description | Part Number | Qty | Plastic Material | Weight [Grams] | # of Cavities | Tooling Finishing |  | Steel Material |  | Hot Runner System Type | Currency | Unit Cost | T1 Lead Time [Wks] | Tooling Life
 |  |  |  |  |  |  |  | Cavity | Core | Cavity | Core
1 | ZR2-TOOL-M-INJ-MMD-HNG | Hinge | ZR2-MMD-HNG-BODY | 1 | PQ-354C Pantone ABS Plastic |  |  |  |  |  |  |  | USD | $0.00 |  | 250k/500k*
 | ZR2-TOOL-M-INJ-TLE-LBRACKET | L-Bracket | ZR2-TLE-LBRACKET | 2 |  |  |  |  |  |  |  |  | USD | $0.00 |  | 250k/500k*
2 | ZR2-TOOL-M-INJ-GMD-PSL-U | Glove Upper Casing | ZR2-GMD-PSL-M-UPR-BODY | 1 | PQ-354C Pantone ABS Plastic |  |  |  |  |  |  |  | USD | $0.00 |  | 250k/500k*
 | ZR2-TOOL-M-INJ-GMD-PSL-L | Glove Lower Casing | ZR2-GMD-PSL-M-LOW-BODY | 1 |  |  |  |  |  |  |  |  | USD | $0.00 |  | 250k/500k*
 | ZR2-TOOL-M-INJ-GMD-BSL | Glove Battery Casing | ZR2-GMD-BSL-BODY | 1 |  |  |  |  |  |  |  |  | USD | $0.00 |  | 250k/500k*
3 | ZR2-TOOL-M-INJ-MMD-RTP | Rotating Pin | ZR2-MMD-RTP-BODY | 1 | PQ-374C Pantone ABS Plastic |  |  |  |  |  |  |  | USD | $0.00 |  | 250k/500k*
 | ZR2-TOOL-M-INJ-MMD-RPS | Rotating Pin Screw | ZR2-MMD-RPS-BODY | 1 |  |  |  |  |  |  |  |  | USD | $0.00 |  | 250k/500k*
 | ZR2-TOOL-M-INJ-CSC | Rotating Pin Connector | ZR2-CSC-BODY | 1 |  |  |  |  |  |  |  |  | USD | $0.00 |  | 250k/500k*
4 | ZR2-TOOL-M-INJ-WHL | Wheel Body | ZR2-WHL-BODY | 1 | PQ-374C Pantone ABS Plastic |  |  |  |  |  |  |  | USD | $0.00 |  | 250k/500k*
5 | ZR2-TOOL-M-INJ-WHL-TYRE | Wheel Rubber Insert | ZR2-WHL-TYRE | 1 | Black Nitrile Rubber |  |  |  |  |  |  |  | USD | $0.00 |  | 250k/500k*
6 | ZR2-TOOL-M-INJ-TLE-POD | POD Body | ZR2-TLE-POD-BODY | 1 | PQ-374C Pantone ABS Plastic |  |  |  |  |  |  |  | USD | $0.00 |  | 250k/500k*
7 | ZR2-TOOL-M-INJ-TLE-CAXLE-BI | Bi Axle | ZR2-TLE-CAXLE-BI-45OFF | 1 | PQ-374C Pantone ABS Plastic |  |  |  |  |  |  |  | USD | $0.00 |  | 250k/500k*
 | ZR2-TOOL-M-INJ-TLE-CAXLE-UNI | Uni Axle | ZR2-TLE-CAXLE-UNI-330 | 1 |  |  |  |  |  |  |  |  | USD | $0.00 |  | 250k/500k*
8 | ZR2-TOOL-M-INJ-MMD-SHL | Module Shell | ZR2-MMD-SHL-BODY | 1 | Opaque White ABS Plastic |  |  |  |  |  |  |  | USD | $0.00 |  | 250k/500k*
 | ZR2-TOOL-M-INJ-MMD-BSL | Battery Holder Lid | ZR2-MMD-SHL-BLID | 1 |  |  |  |  |  |  |  |  | USD | $0.00 |  | 250k/500k*
9 | ZR2-TOOL-M-INJ-QRK-TOP | Quark Shell- Top | ZR2-MMD-QRK-M-CTP | 1 |  |  |  |  |  |  |  |  | USD | $0.00 |  | 250k/500k*
 | ZR2-TOOL-M-INJ-QRK-MID | Quark Shell- Mid | ZR2-MMD-QRK-M-CMD | 1 |  |  |  |  |  |  |  |  | USD | $0.00 |  | 250k/500k*
 | ZR2-TOOL-M-INJ-QRK-BOT | Quark Shell- Bottom | ZR2-MMD-QRK-M-CBM | 1 |  |  |  |  |  |  |  |  | USD | $0.00 |  | 250k/500k*
10 | ZR2-TOOL-M-INJ-QRK-G2 | Quark Gear 2 | ZR2-MMD-QRK-M-G2 | 1 | White Acetylene |  |  |  |  |  |  |  | USD | $0.00 |  | 250k/500k*
 | ZR2-TOOL-M-INJ-QRK-G3 | Quark Gear 3 | ZR2-MMD-QRK-M-G3 | 1 |  |  |  |  |  |  |  |  | USD | $0.00 |  | 250k/500k*
 | ZR2-TOOL-M-INJ-QRK-G4 | Quark Gear 4 | ZR2-MMD-QRK-M-G4 | 1 |  |  |  |  |  |  |  |  | USD | $0.00 |  | 250k/500k*
 | ZR2-TOOL-M-INJ-QRK-G5 | Quark Gear 5 | ZR2-MMD-QRK-M-G5 | 1 |  |  |  |  |  |  |  |  | USD | $0.00 |  | 250k/500k*
 | ZR2-TOOL-M-INJ-QRK-GPC | Quark Potentiometer Insert | ZR2-MMD-QRK-M-GPC | 1 |  |  |  |  |  |  |  |  | USD | $0.00 |  | 250k/500k*
11 | ZR2-TOOL-M-VAC-PCK-TRAY-TOP | Charging Tray - Top | ZR2-PCK-TRA-M-TOP | 1 | Polystyrene White Sheet |  |  |  |  |  |  |  | USD | $0.00 |  | 250k/500k*
 | ZR2-TOOL-M-VAC-PCK-TRAY-BOT | Charging Tray - Bottom | ZR2-PCK-TRA-M-BOT | 1 | Polystyrene White Sheet |  |  |  |  |  |  |  | USD | $0.00 |  | 250k/500k*
12 | ZR2-TOOL-M-CUT-PCK-FOAM-TOP | Foam Insert- Top | ZR2-PCK-BOX-LFM | 1 | EV Foam Black |  |  |  |  |  |  |  | USD | $0.00 |  | 250k/500k*
 | ZR2-TOOL-M-CUT-PCK-FOAM-BOT | Foam Insert- Bottom | ZR2-PCK-BOX-UFM | 1 | EV Foam Black |  |  |  |  |  |  |  | USD | $0.00 |  | 250k/500k*
 |  |  |  |  |  |  |  |  |  | Total Mechanical Tooling Cost |  |  |  | $0.00
Electronics Tooling Costs
Item | Part Number | Part Description |  | Qty | Material | Weight [grams] | More Info |  |  |  |  |  | Currency | Unit Cost | Ext. Cost
1 | ZR2-TOOL-E-SOLDER_PASTE_STENCIL | Stencil For Solder Paste Application |  | 1 | - |  | - |  |  |  |  |  | USD | $0.00 | $0.00
2 | ZR2-TOOL-E-SOLDER_WAVE_STENCIL | Stencil For Wave Soldering |  | 1 | - |  | - |  |  |  |  |  | USD | $0.00 | $0.00
3 | ZR2_TOOL-E-AOI-Setup | Automatic Optical Inspection Setup |  | 1 | - |  | - |  |  |  |  |  | USD | $0.00 | $0.00
4 | ZR2-TOOL-E-ASSM_FIXTURE | Fixture for assembly(if any) |  | 1 | - |  | - |  |  |  |  |  | USD | $0.00 | $0.00
 |  |  |  |  |  |  |  |  |  | Electronics Tooling Cost: |  |  |  |  | $0.00
 |  |  | Total Tooling And NRE Cost: |  |  |  | $0.00

Sheet: Terms & Conditions
Paste Terms and Conditions Here
