ZeroUI/Industrial-Quark/Ziro-master/Electronics/V2.0 Wifi/Software/1 Arduino/Glove/Documentation/Glove- Software Related Calcuations.xlsx

Clock Speed [MHz] | Task Scheduler Instr [# of Instr] | Task Scheduler Single Pass Overhead [usec] | Priority Layer | Number of Tasks in each layer | Overhead in each Layer [usec] | Total Overhead [usec]
80 | 288 | 3.6 | 0-Base | 3 | 10.8 | 75.6
 |  |  | 1 | 2 | 21.6
 |  |  | 2 | 2 | 43.2
 |  |  | 3 |  | 0
 |  |  | 4 |  | 0
 |  |  | 5 |  | 0
 |  |  | 6 |  | 0
 |  |  | 7 |  | 0
 |  |  | 7-Highest Priority
