ZeroUI/Industrial-Quark/Ziro-master/Electronics/V2.0 Wifi/Hardware/PCB/Component Library/_Archive/ZeroUI Library/MUX/readme.txt

 

**********************************************************
*************  Important Instructions Follow  ************
**********************************************************
 
All files exported to: C:\ul_temp\2c95aa1232c74e55c8e954cfd2789dea-1397031\inner\Eagle\Eagle\Eagle.xml

To import your new library into Eagle:
1. Start Eagle.
2. Select File -> New -> Library from the menu.
3. In the blank library window, select File -> Execute Script from the menu.
5. Browse to your newly exported Eagle Script file (".scr" file extension)
6. After opening the file, the script will populate the new library.
7. Use File -> Save (or Save As..) to save the library to the desired location in Eagle native format.

For additional information, please visit this site:
http://www.accelerated-designs.com/help/Eagle_import.html

You may also find this video helpful:
http://youtu.be/5jGuWY-Yy3Q

Padstack "RX80p71Y100p39D0T" renamed to "RX80p71Y100p39D0"
Component "SN74LV4051ARGYR" renamed to "SN74LV4051ARGYR"

Ultra Librarian Gold 8.1.108 Process Report

Message - Padstack "RX80p71Y100p39D0" Shape(4) is a CIRCLE with no diameter.
Message - Padstack "RX11p02Y33p46D0T" Shape(4) is a CIRCLE with no diameter.

TextStyle count:  25
Padstack count:   2
Pattern count:    1
Symbol count:     1
Component count:  1

Export
