ZeroUI/Industrial-Quark/Ziro-master/Mechanical/Ziro 2.0/Module/Quark/Assembly/Quark Assembly.SLDASM

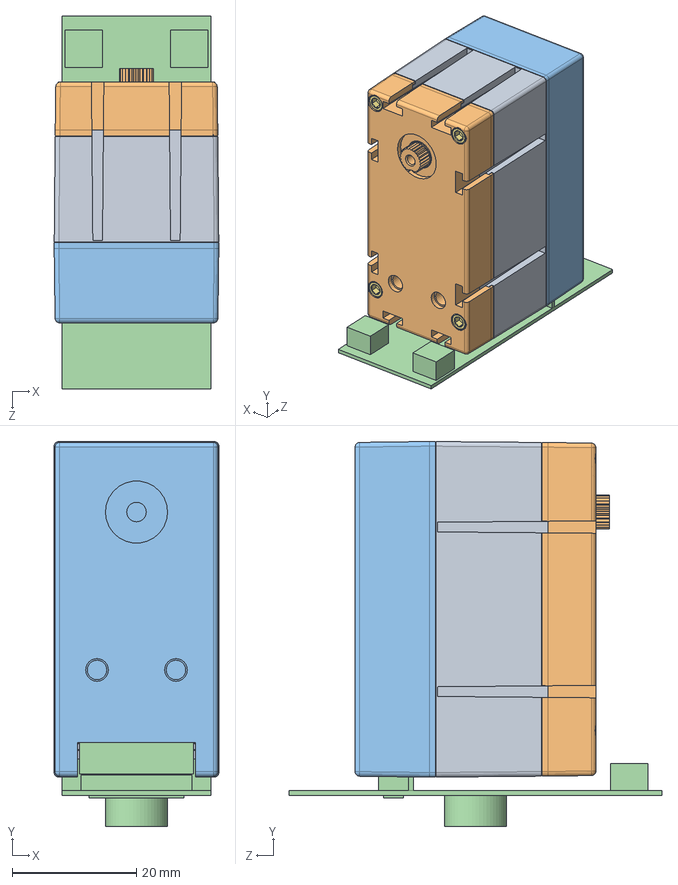
[picture p130: CAD file, 2017-09-05]
Ziro-master/Mechanical/Ziro 2.0/Module/Quark/Assembly/Quark Assembly.SLDASM
26.5 x 61.9 x 60.0 mm
Middle Shell
1_Top_Lid_V4
3_Back_Lid_V4
Quark Electronics Mockup
17 mm Motor_Quark
Gear_1 Motor Pinion_9Teeth_0.3 Modulus
Gear_2__Large_43Teeth_0.3Modulus__Small_9Teeth_0.3Modulus
Gear 3___Large_43Teeth_0.3Modulus__Small_9Teeth_0.4Modulus
Gear_4___ Large_35Teeth_0.4 Modulus___Small_11Teeth_0.5Modulus
Gear_5__Output Gear_32Teeth_0.5Modulus
Gear_6 Potentiometer Connector
Gear_2_D1.5_L7.25mm Shaft
Gear_3_D1.5_L13mm Shaft
Gear_4_D1.5_L19.5mm Shaft
18-8 STAINLESS STEEL SOCKET HEAD CAP SCREW_2 56_1_3BY8 x 4
