ZeroUI/Industrial-Quark/Ziro-master/Electronics/V1.0 Bluetooth/Hardware/Handimate_Backup/Skethup/Handimate Electronics Assembly.stl

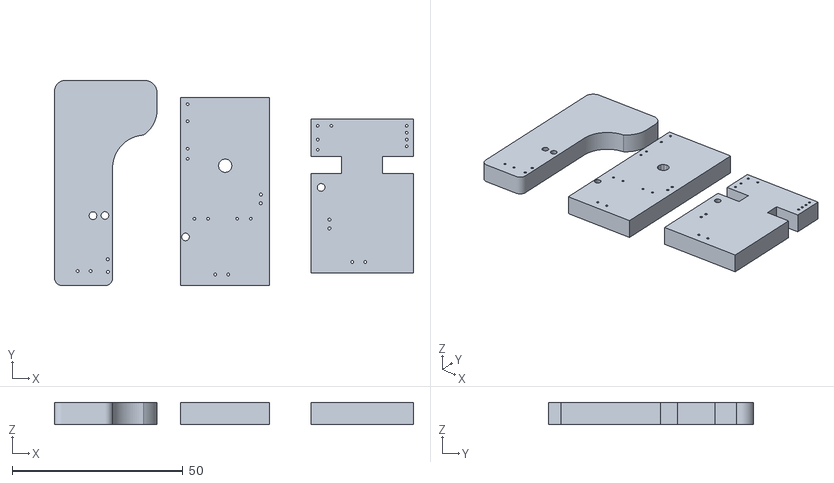
[picture p132: CAD file, 2017-09-05]
Ziro-master/Electronics/V1.0 Bluetooth/Hardware/Handimate_Backup/Skethup/Handimate Electronics Assembly.stl
105.0 x 60.0 x 6.50
