ZeroUI/Industrial-Quark/Ziro-master/BoM/Accessories/ConnectorRot_Small.STEP

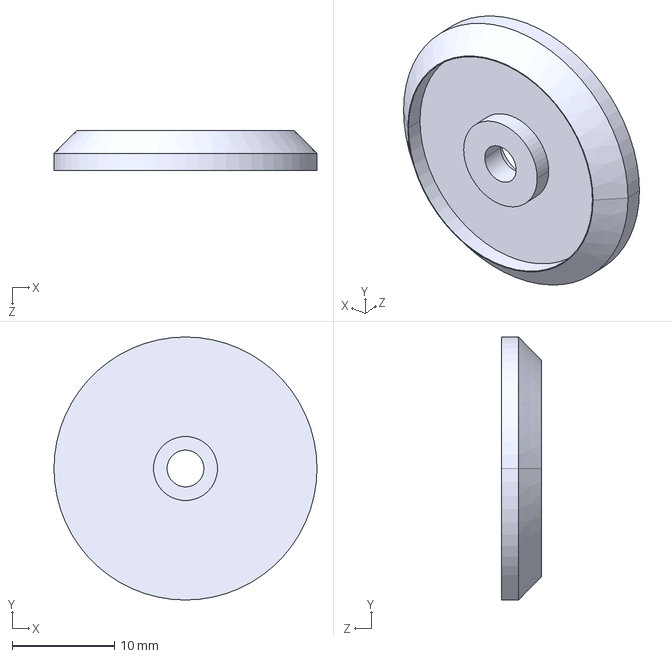
[picture p133: CAD file, 2017-09-05]
Ziro-master/BoM/Accessories/ConnectorRot_Small.STEP
25.8 x 25.8 x 3.94 mm
