ZeroUI/Industrial-Quark/Ziro-master/BoM/Glove Modules/Battery Shell/Magnets.STEP

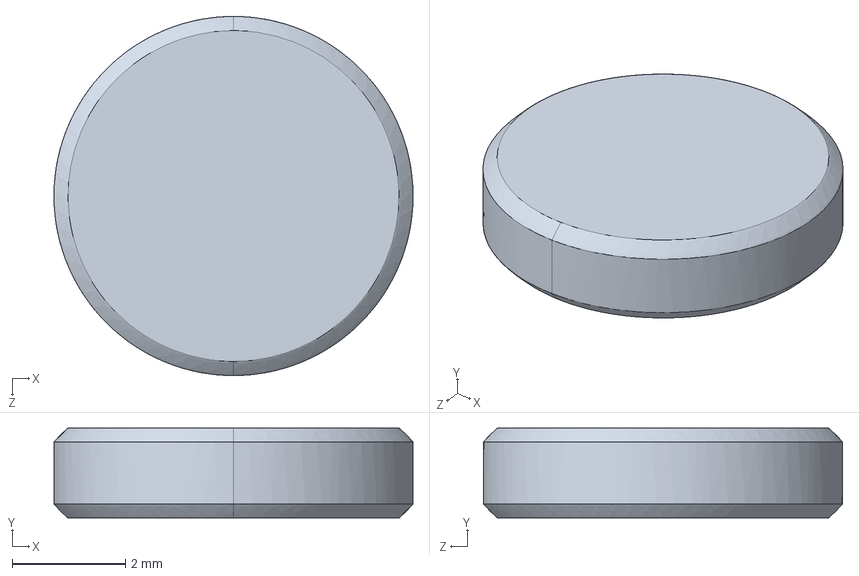
[picture p134: CAD file, 2017-09-05]
Ziro-master/BoM/Glove Modules/Battery Shell/Magnets.STEP
6.35 x 1.59 x 6.35 mm
