ZeroUI/Industrial-Quark/Ziro-master/BoM/Glove Modules/PCB Shell/PCB_Shell_Mechanical_Lower Enclosure.STEP

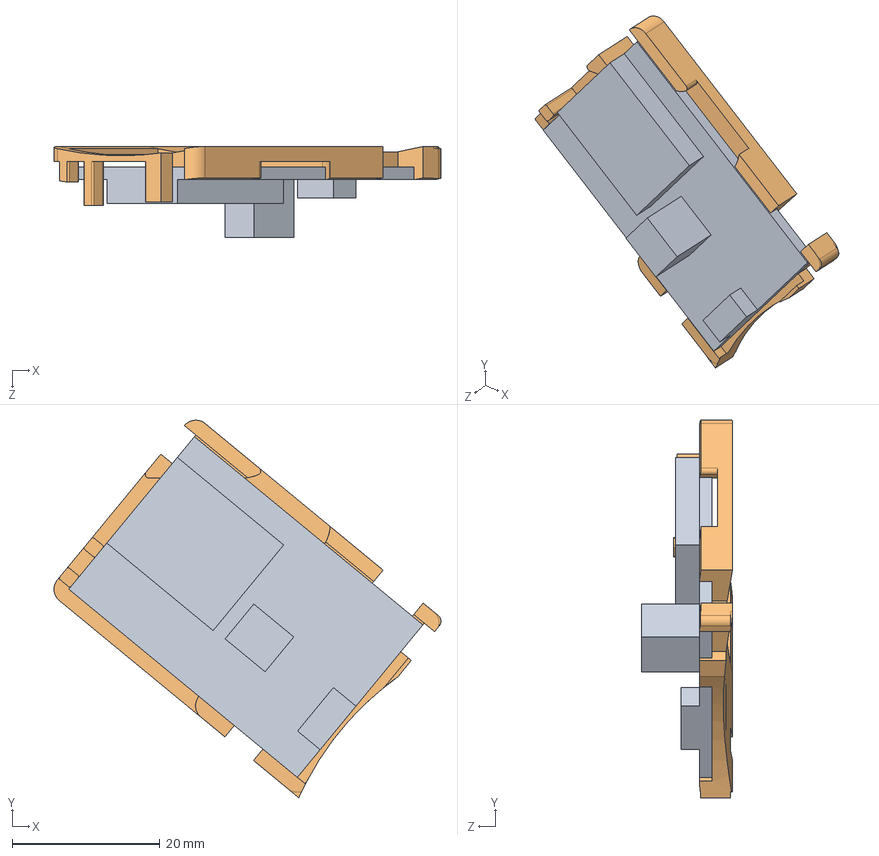
[picture p135: CAD file, 2017-09-05]
Ziro-master/BoM/Glove Modules/PCB Shell/PCB_Shell_Mechanical_Lower Enclosure.STEP
52.3 x 51.0 x 12.3 mm
