ZeroUI/Industrial-Quark/Ziro-master/BoM/Motor Modules/Battery Holder.STEP

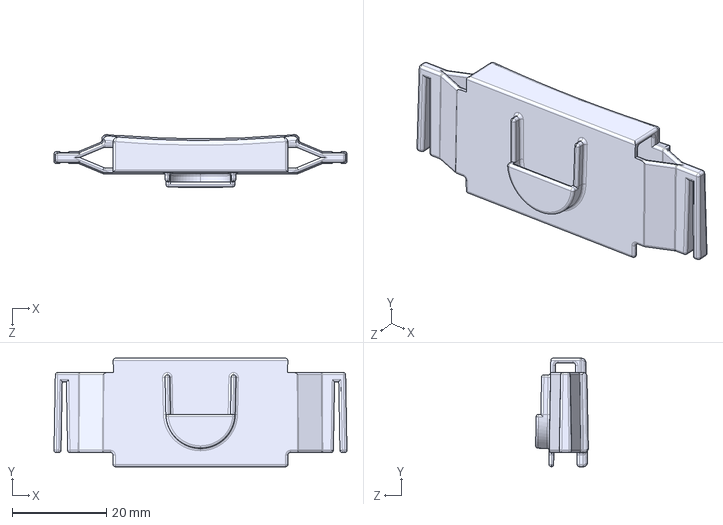
[picture p136: CAD file, 2017-09-05]
Ziro-master/BoM/Motor Modules/Battery Holder.STEP
62.1 x 23.0 x 11.2 mm
