ZeroUI/Industrial-Quark/Ziro-master/BoM/Motor Modules/Hinge/Hinge_Body.STEP

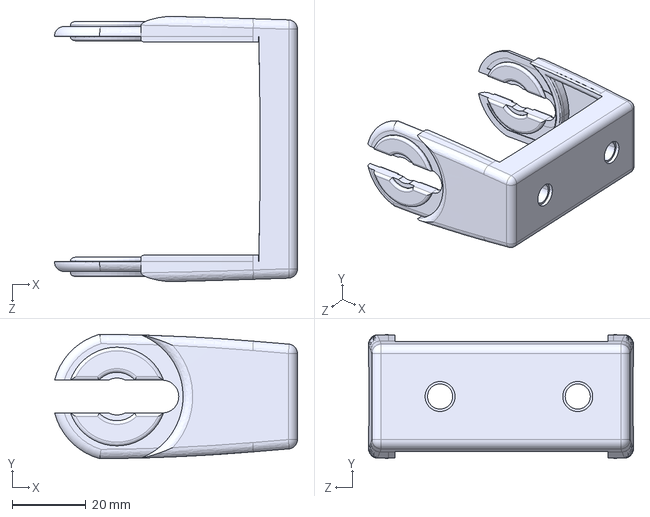
[picture p137: CAD file, 2017-09-05]
Ziro-master/BoM/Motor Modules/Hinge/Hinge_Body.STEP
65.8 x 33.7 x 71.8 mm
