ZeroUI/Industrial-Quark/Ziro-master/BoM/Motor Modules/Quark/Quark_Mechanical_Cover_Bottom.STEP

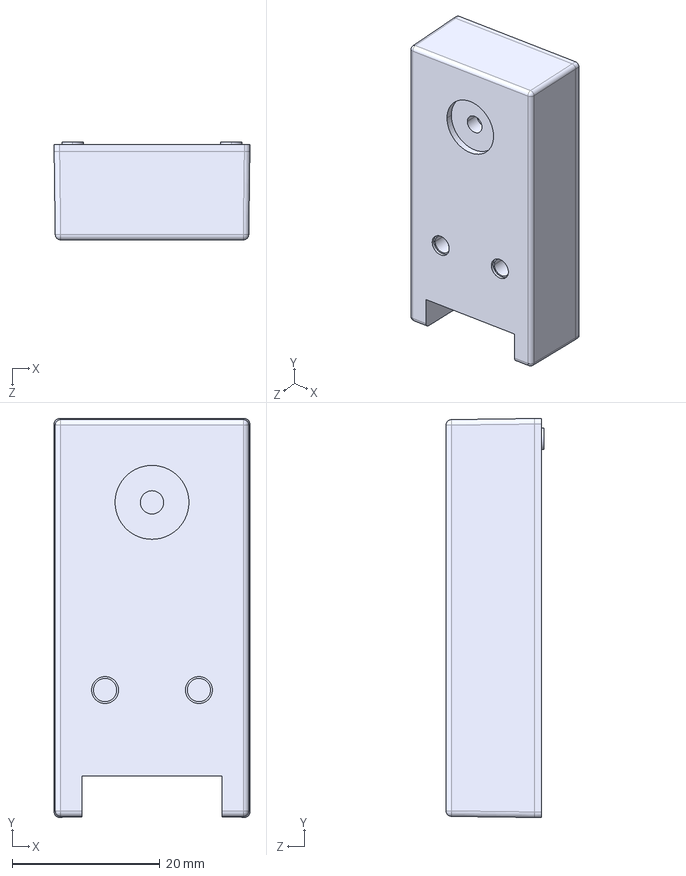
[picture p138: CAD file, 2017-09-05]
Ziro-master/BoM/Motor Modules/Quark/Quark_Mechanical_Cover_Bottom.STEP
26.5 x 54.0 x 13.3 mm
