ZeroUI/Industrial-Quark/Ziro-master/BoM/Motor Modules/Rotating Pin/Rotating Pin_Body.STEP

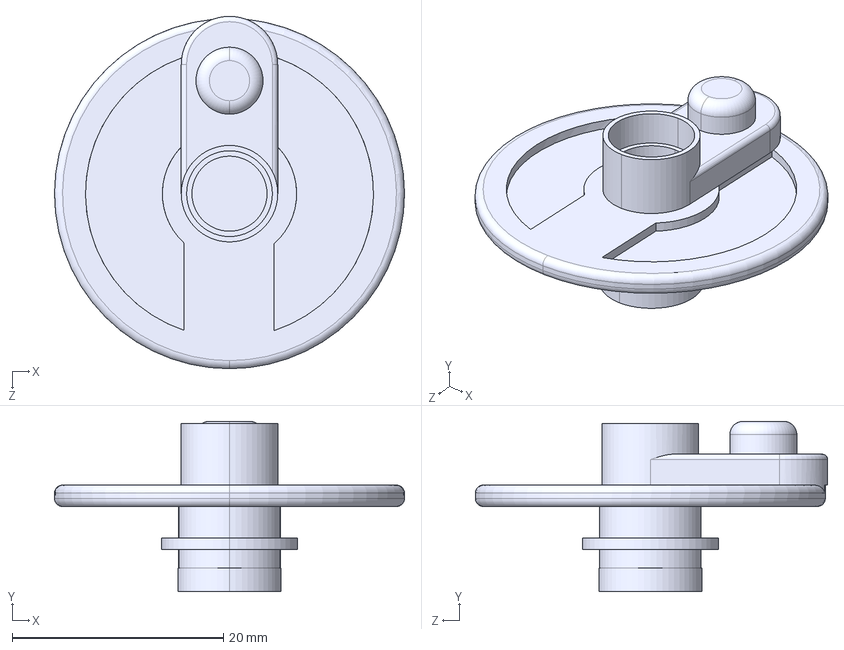
[picture p139: CAD file, 2017-09-05]
Ziro-master/BoM/Motor Modules/Rotating Pin/Rotating Pin_Body.STEP
33.2 x 16.1 x 33.4 mm
