ZeroUI/Industrial-Quark/Ziro-master/BoM/Motor Modules/Shell/Shell_Battery_Lid.STEP

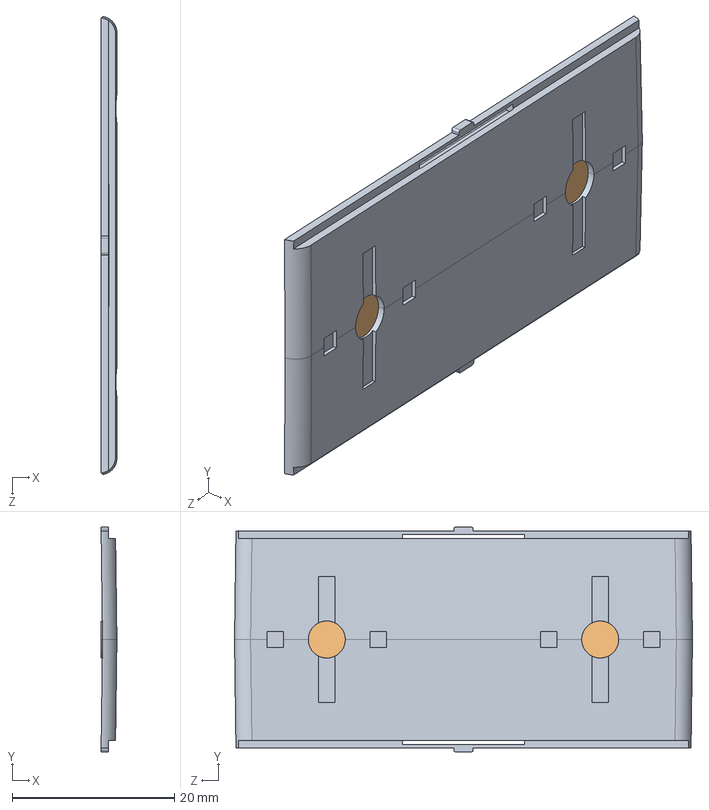
[picture p140: CAD file, 2017-09-05]
Ziro-master/BoM/Motor Modules/Shell/Shell_Battery_Lid.STEP
1.95 x 27.8 x 56.5 mm
