ZeroUI/Industrial-Quark/Ziro-master/BoM/Packaging/Packaging_Tray_Lid.STEP

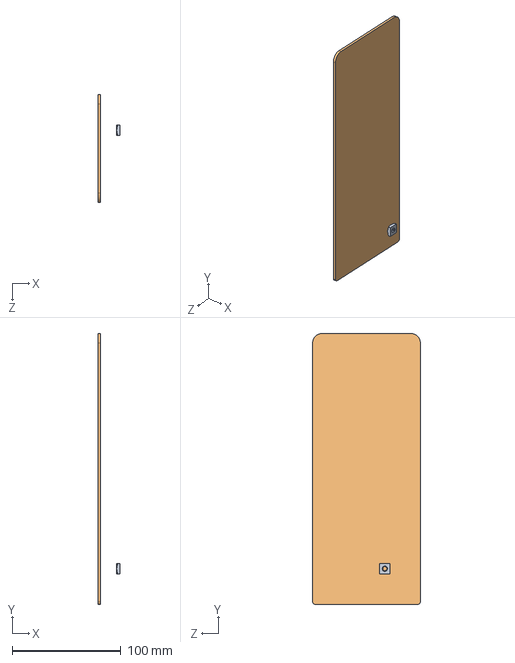
[picture p141: CAD file, 2017-09-05]
Ziro-master/BoM/Packaging/Packaging_Tray_Lid.STEP
20.5 x 249.1 x 99.0 mm
