ZeroUI/Industrial-Quark/Ziro-master/BoM/Tile/Tile_L Bracket.STEP

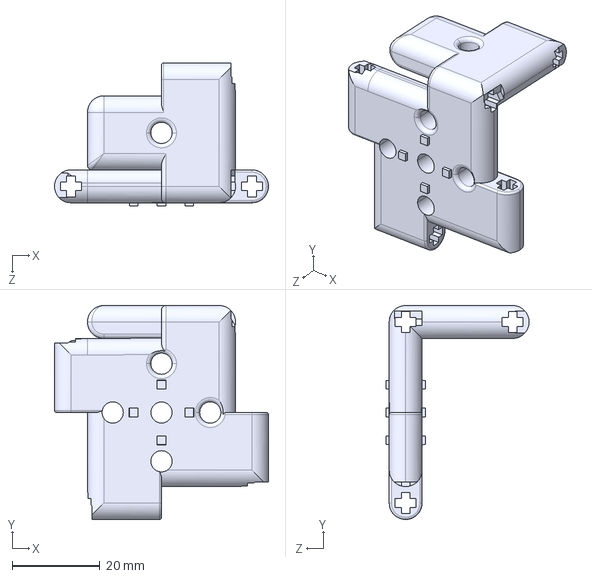
[picture p142: CAD file, 2017-09-05]
Ziro-master/BoM/Tile/Tile_L Bracket.STEP
48.7 x 48.7 x 32.6 mm
