ZeroUI/Industrial-Quark/Ziro-master/BoM/Wheels/Wheel.STEP

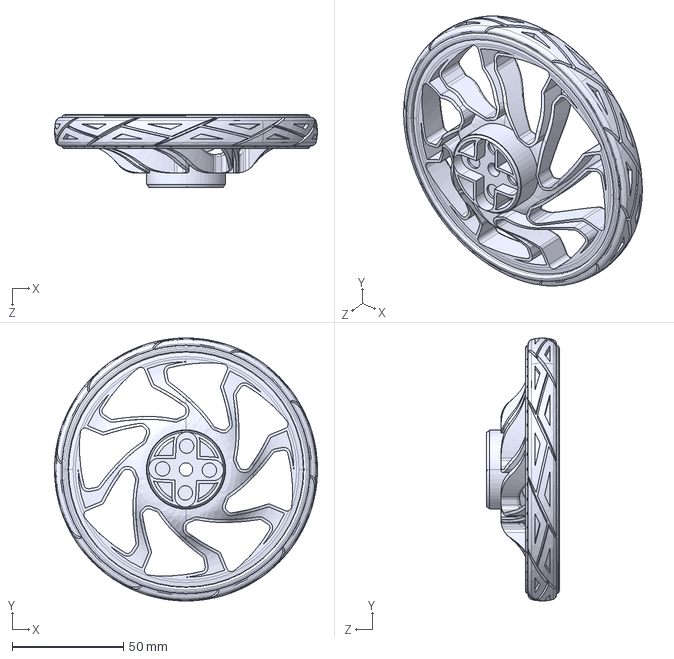
[picture p143: CAD file, 2017-09-05]
Ziro-master/BoM/Wheels/Wheel.STEP
118.3 x 118.3 x 32.8 mm
