ZeroUI/Industrial-Quark/Ziro-master/Electronics/V1.0 Bluetooth/Hardware/Handimate_Backup/Glove Module/eagleUp/Glove Export.stl

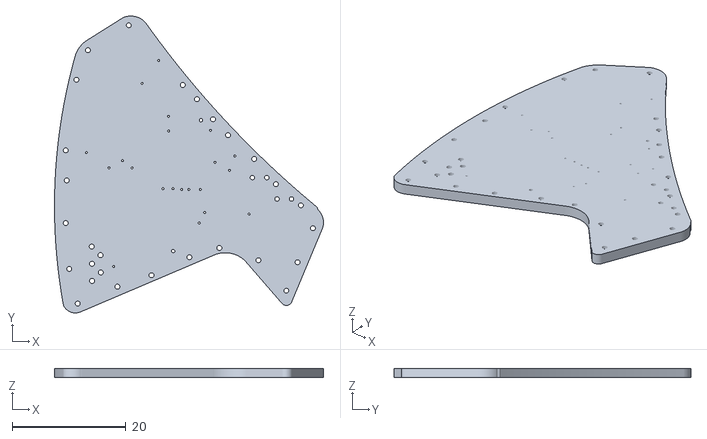
[picture p144: CAD file, 2017-09-05]
Ziro-master/Electronics/V1.0 Bluetooth/Hardware/Handimate_Backup/Glove Module/eagleUp/Glove Export.stl
47.4 x 52.3 x 1.67
