ZeroUI/Industrial-Quark/Ziro-master/Electronics/V1.0 Bluetooth/Hardware/Handimate_Backup/Skethup/Handimate Electronicsuntitled.stl

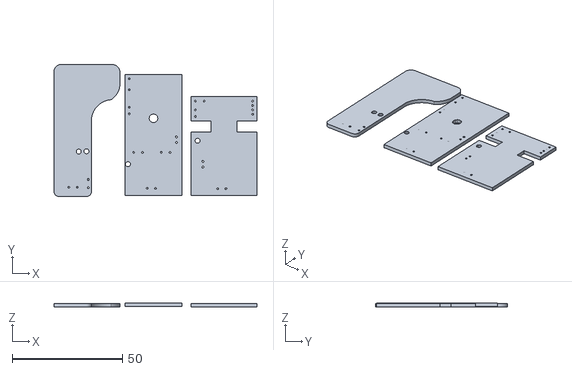
[picture p145: CAD file, 2017-09-05]
Ziro-master/Electronics/V1.0 Bluetooth/Hardware/Handimate_Backup/Skethup/Handimate Electronicsuntitled.stl
92.2 x 60.0 x 1.95
