ZeroUI/Industrial-Quark/Ziro-master/Mechanical/Ziro 2.0/Accessories/Keychain/Ziro Keychain.SLDPRT

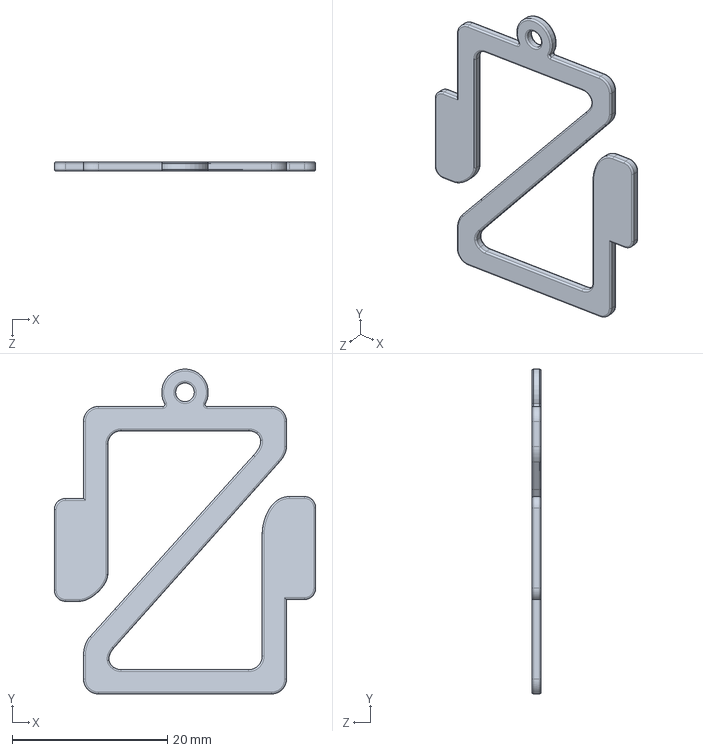
[picture p146: CAD file, 2017-09-05]
Ziro-master/Mechanical/Ziro 2.0/Accessories/Keychain/Ziro Keychain.SLDPRT
33.6 x 41.8 x 1.20 mm
