ZeroUI/Industrial-Quark/Ziro-master/Mechanical/Ziro 2.0/Module/Quark/Electronics/Quark Electronics Mockup.SLDPRT

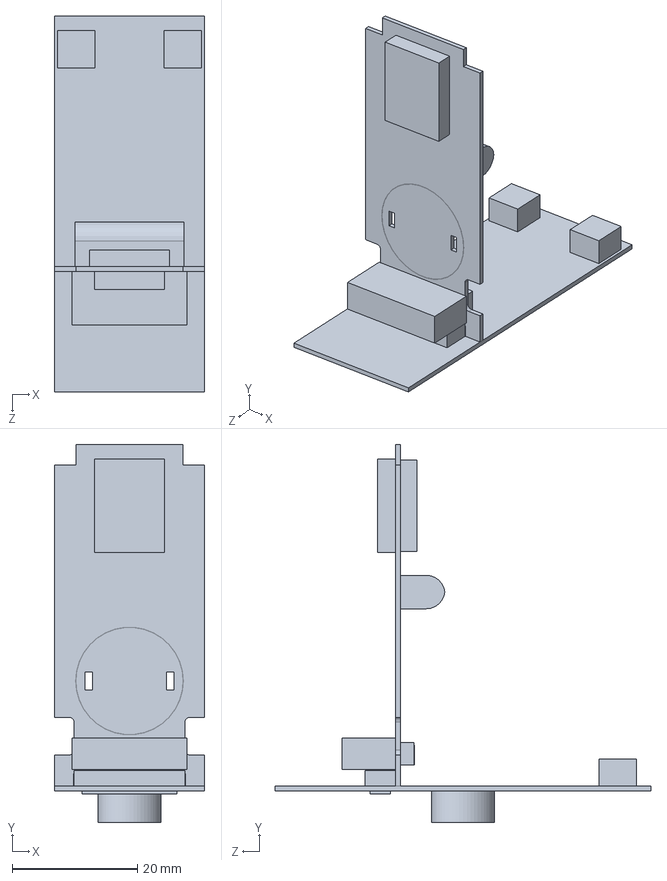
[picture p147: CAD file, 2017-09-05]
Ziro-master/Mechanical/Ziro 2.0/Module/Quark/Electronics/Quark Electronics Mockup.SLDPRT
24.0 x 60.3 x 60.0 mm
