ZeroUI/Industrial-Quark/Ziro-master/Mechanical/Ziro 2.0/Module/Quark/Gears/Calculation Test.SLDPRT

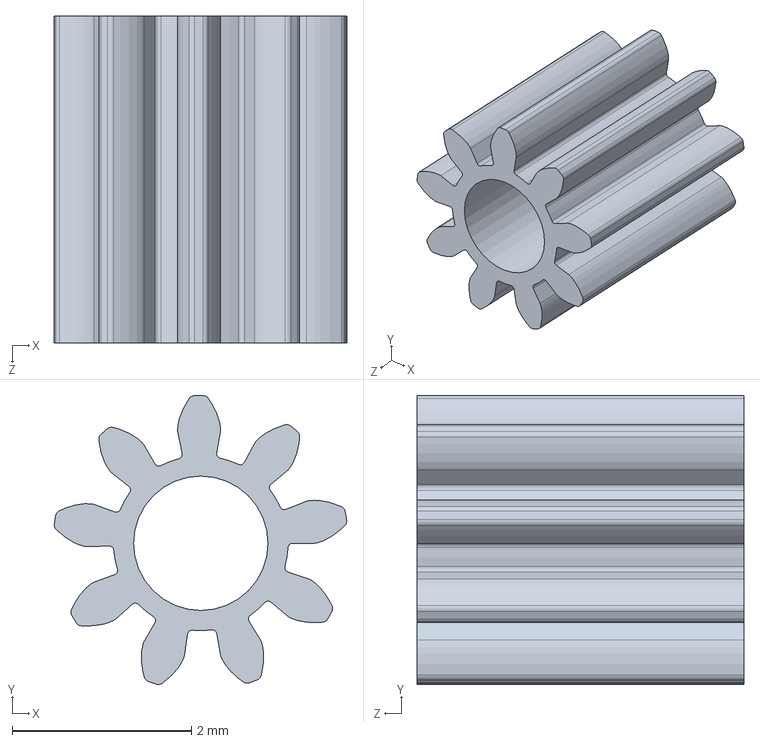
[picture p148: CAD file, 2017-09-05]
Ziro-master/Mechanical/Ziro 2.0/Module/Quark/Gears/Calculation Test.SLDPRT
3.27 x 3.23 x 3.65 mm
