ZeroUI/Industrial-Quark/Ziro-master/Mechanical/Ziro 2.0/Module/Quark/Gears/Intermediate Pinions/Gear three Small.SLDPRT

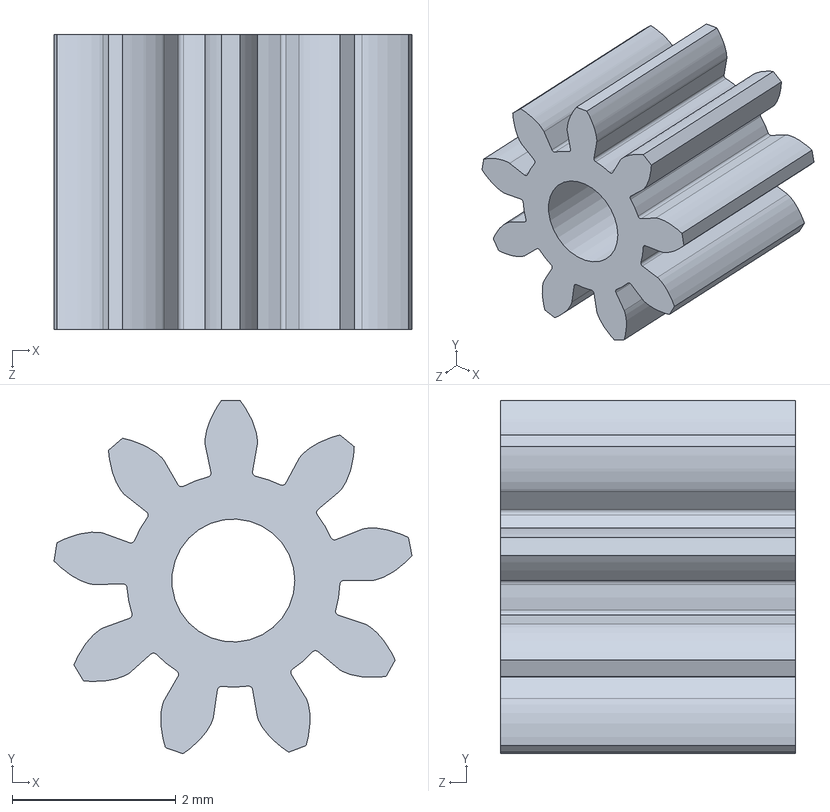
[picture p149: CAD file, 2017-09-05]
Ziro-master/Mechanical/Ziro 2.0/Module/Quark/Gears/Intermediate Pinions/Gear three Small.SLDPRT
4.37 x 4.31 x 3.60 mm
