ZeroUI/Industrial-Quark/Ziro-master/Mechanical/Ziro 2.0/Module/Quark/Gears/STEP files/Gear_6 Potentiometer Connector.STEP

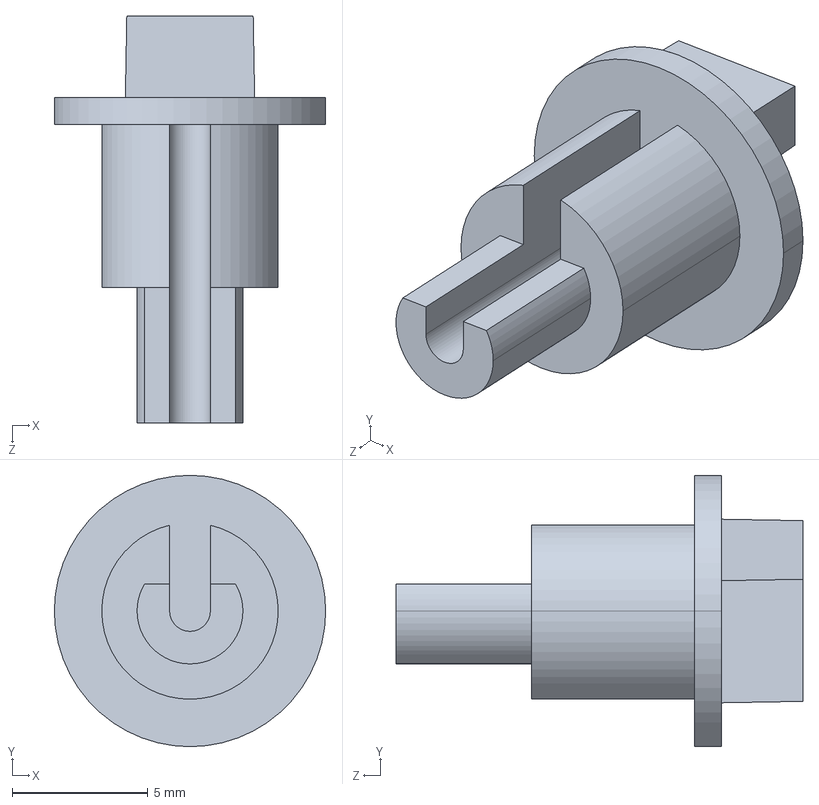
[picture p150: CAD file, 2017-09-05]
Ziro-master/Mechanical/Ziro 2.0/Module/Quark/Gears/STEP files/Gear_6 Potentiometer Connector.STEP
10.0 x 10.0 x 15.0 mm
