ZeroUI/Industrial-Quark/Ziro-master/Mechanical/Ziro 2.0/Module/Quark/Gears/STLs/Gear_5__Output Gear_40Teeth_0.4Modulus.STL

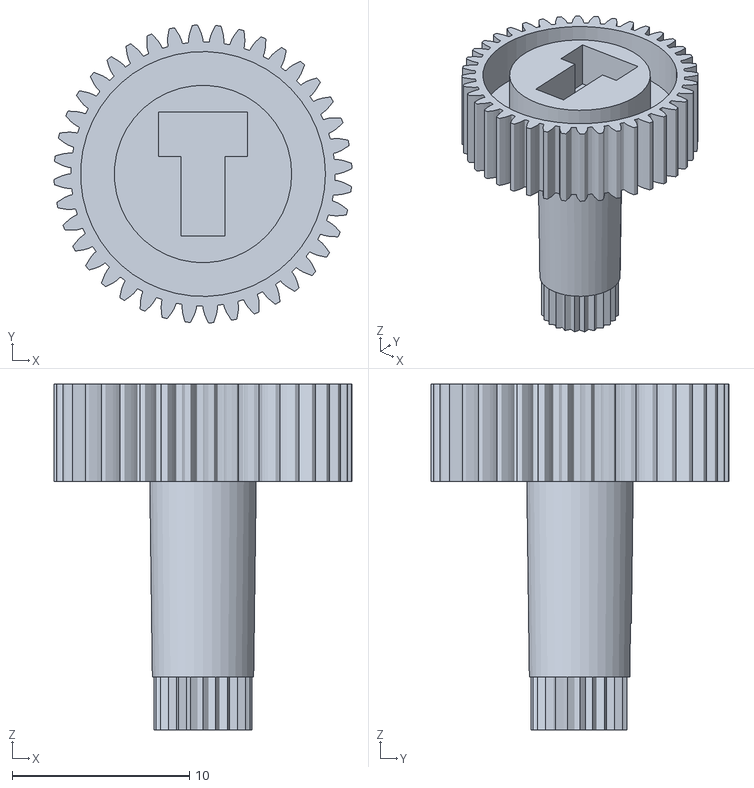
[picture p151: CAD file, 2017-09-05]
Ziro-master/Mechanical/Ziro 2.0/Module/Quark/Gears/STLs/Gear_5__Output Gear_40Teeth_0.4Modulus.STL
16.8 x 16.8 x 19.5
