ZeroUI/Industrial-Quark/Ziro-master/Mechanical/Ziro 2.0/Module/Quark/Gears/WireEDM/Mold Inserts/Step Files/Gear_4_Large_EDM_Inserts.STEP

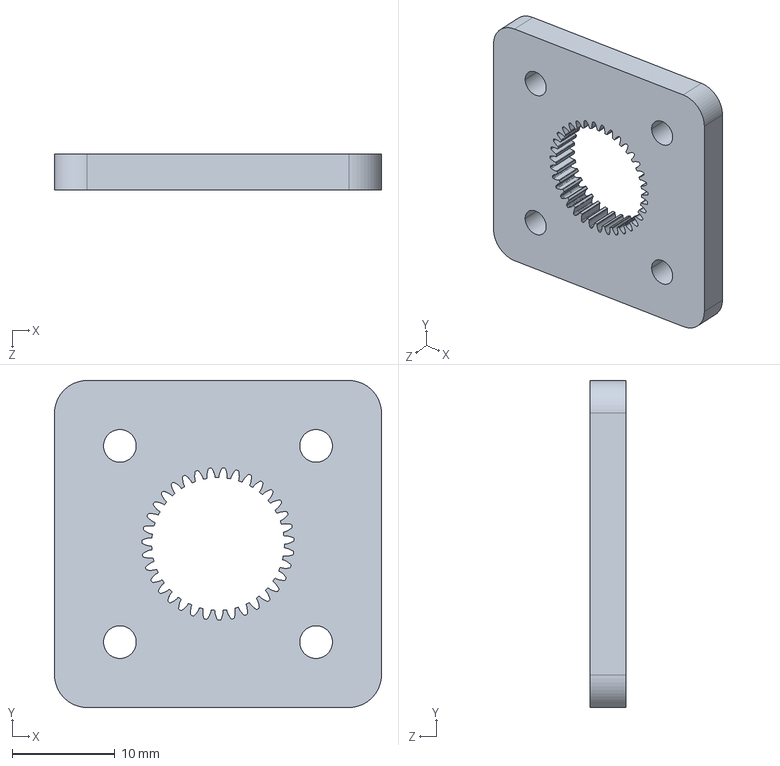
[picture p152: CAD file, 2017-09-05]
Ziro-master/Mechanical/Ziro 2.0/Module/Quark/Gears/WireEDM/Mold Inserts/Step Files/Gear_4_Large_EDM_Inserts.STEP
31.8 x 31.8 x 3.50 mm
