ZeroUI/Industrial-Quark/Ziro-master/Mechanical/Ziro 2.0/Module/Quark/Gears/WireEDM/Wire EDM Gear 3___Large_43Teeth_0.3Modulus__Small_9Teeth_0.4Modulus.SLDPRT

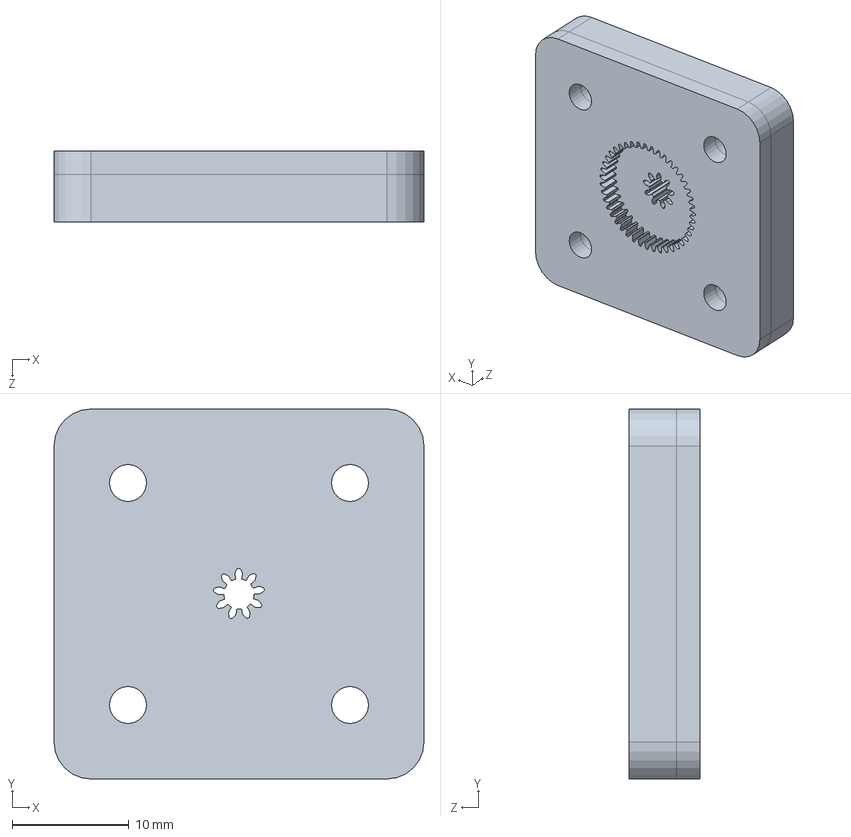
[picture p153: CAD file, 2017-09-05]
Ziro-master/Mechanical/Ziro 2.0/Module/Quark/Gears/WireEDM/Wire EDM Gear 3___Large_43Teeth_0.3Modulus__Small_9Teeth_0.4Modulus.SLDPRT
31.8 x 31.8 x 6.10 mm
