ZeroUI/Industrial-Quark/Ziro-master/Mechanical/Ziro 2.0/Module/Quark/Shafts/Gear_2_D1.5_L7.25mm Shaft.SLDPRT

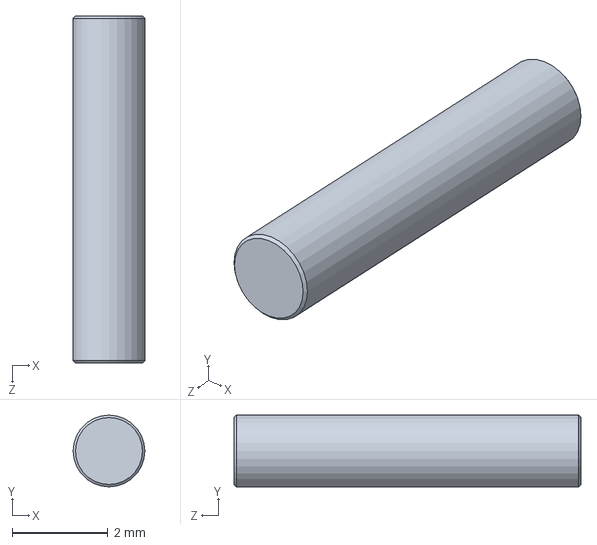
[picture p154: CAD file, 2017-09-05]
Ziro-master/Mechanical/Ziro 2.0/Module/Quark/Shafts/Gear_2_D1.5_L7.25mm Shaft.SLDPRT
1.50 x 1.50 x 7.25 mm
