ZeroUI/Industrial-Quark/Ziro-master/Mechanical/Ziro 2.0/Module/Quark/Shells/Herkulex/Gear_6 Potentiometer Connector_Herkulex.SLDPRT

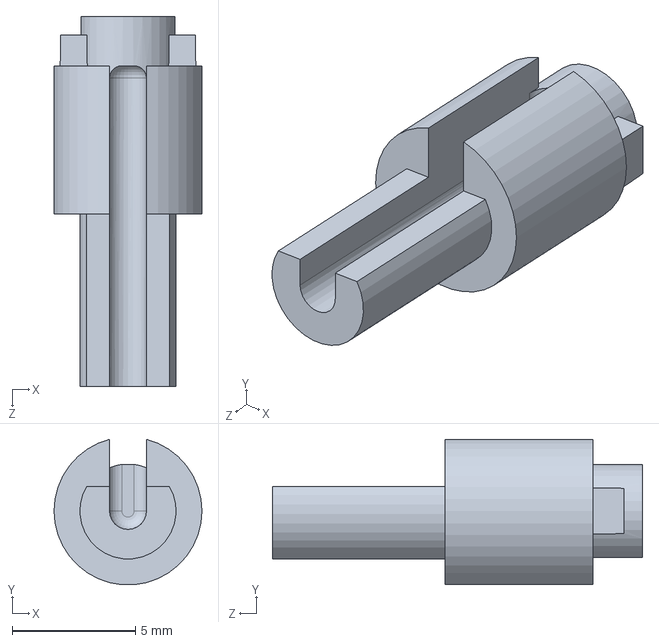
[picture p155: CAD file, 2017-09-05]
Ziro-master/Mechanical/Ziro 2.0/Module/Quark/Shells/Herkulex/Gear_6 Potentiometer Connector_Herkulex.SLDPRT
6.00 x 5.89 x 15.0 mm
