ZeroUI/Industrial-Quark/Ziro-master/Mechanical/Ziro 2.0/Module/Quark/Shells/Herkulex/Print Version 2/Middle Shell_Herkulex.STL

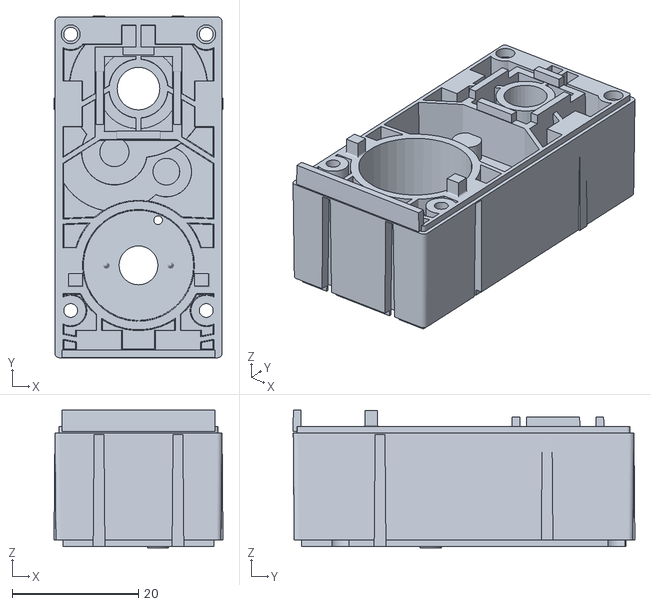
[picture p156: CAD file, 2017-09-05]
Ziro-master/Mechanical/Ziro 2.0/Module/Quark/Shells/Herkulex/Print Version 2/Middle Shell_Herkulex.STL
26.8 x 54.1 x 21.8
