ZeroUI/Industrial-Quark/Ziro-master/Mechanical/Ziro 2.0/Module/Quark/Shells/Print/Top Lid_Herkulex.STL

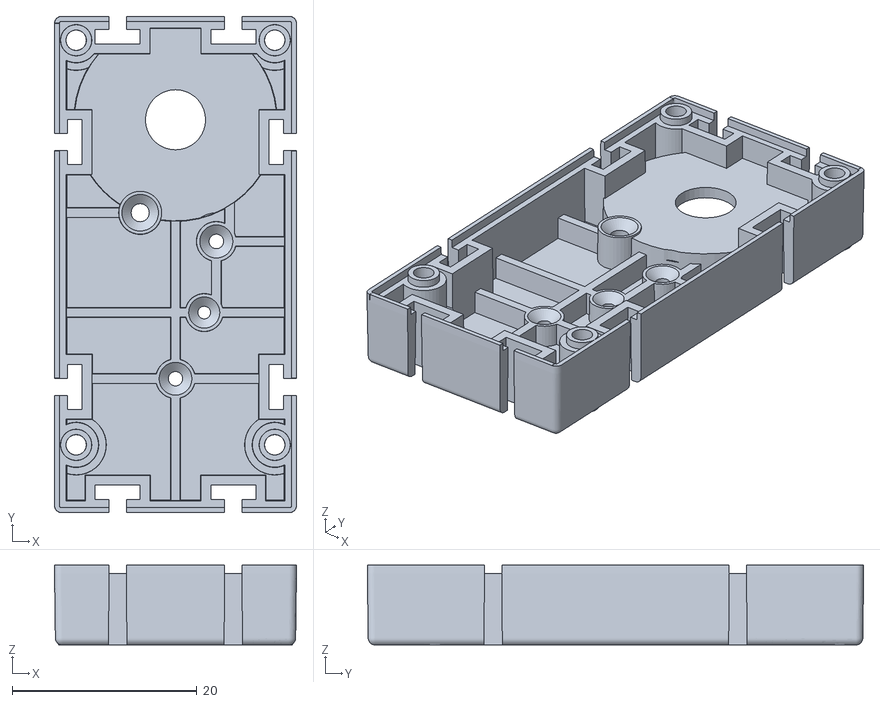
[picture p157: CAD file, 2017-09-05]
Ziro-master/Mechanical/Ziro 2.0/Module/Quark/Shells/Print/Top Lid_Herkulex.STL
26.2 x 53.7 x 8.65
