ZeroUI/Industrial-Quark/Ziro-master/Mechanical/Ziro 2.0/Module/Shells/Shell Components/Shell.SLDPRT

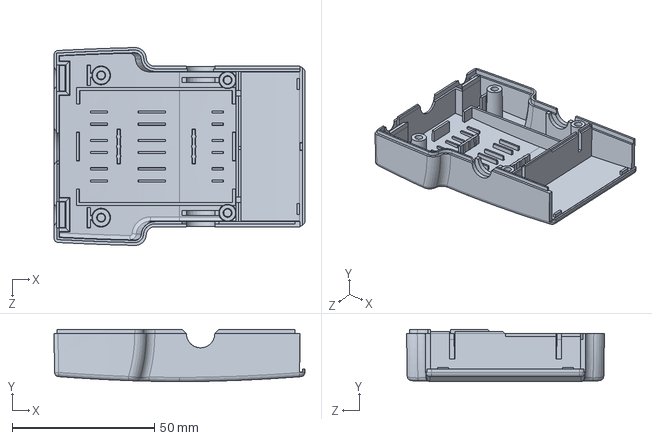
[picture p158: CAD file, 2017-09-05]
Ziro-master/Mechanical/Ziro 2.0/Module/Shells/Shell Components/Shell.SLDPRT
88.3 x 18.4 x 69.6 mm
