ZeroUI/Industrial-Quark/Ziro-master/BoM/Glove Modules/PCB Shell/PCB_Shell_Mechanical_Upper Enclosure.STEP

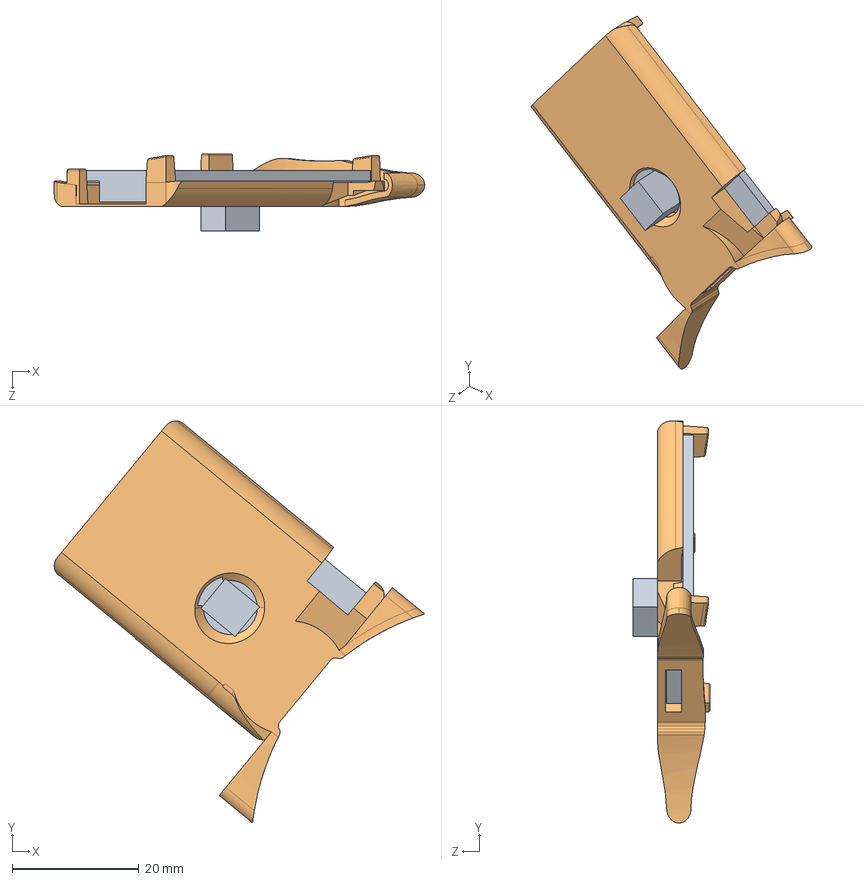
[picture p159: CAD file, 2017-09-05]
Ziro-master/BoM/Glove Modules/PCB Shell/PCB_Shell_Mechanical_Upper Enclosure.STEP
58.4 x 63.4 x 12.2 mm
