ZeroUI/Industrial-Quark/Ziro-master/BoM/Motor Modules/Quark/Quark_Mechanical_Cover_Top.STEP

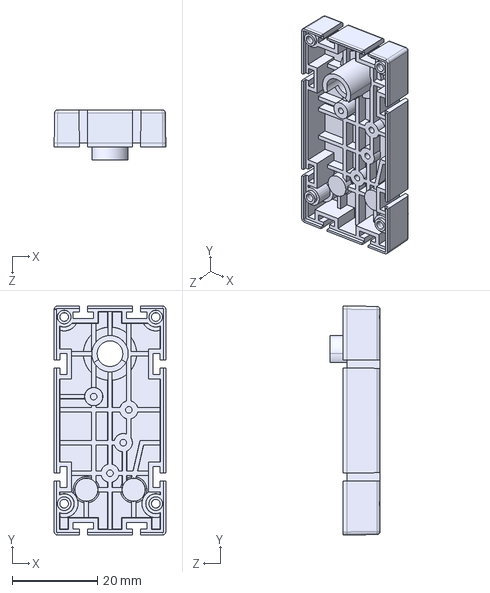
[picture p160: CAD file, 2017-09-05]
Ziro-master/BoM/Motor Modules/Quark/Quark_Mechanical_Cover_Top.STEP
26.2 x 53.7 x 11.8 mm
