ZeroUI/Industrial-Quark/Ziro-master/BoM/Tile/Tile_Cross_Axle Pin_Bi-directional_45_deg_Offset.STEP

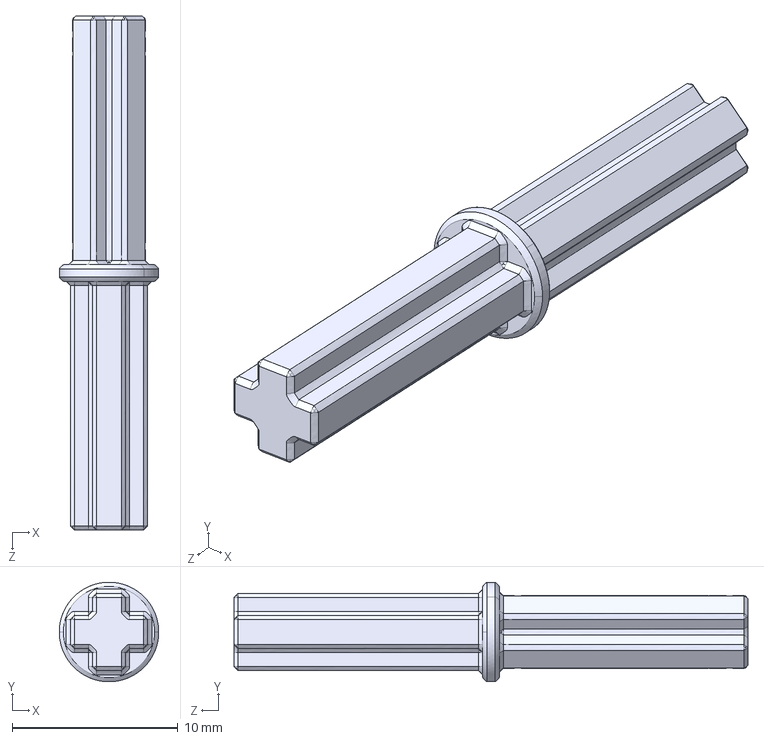
[picture p161: CAD file, 2017-09-05]
Ziro-master/BoM/Tile/Tile_Cross_Axle Pin_Bi-directional_45_deg_Offset.STEP
6.00 x 6.00 x 31.0 mm
