ZeroUI/Industrial-Quark/Ziro-master/Mechanical/Ziro 2.0/Module/Quark/Electronics/17 mm Motor_Quark.SLDPRT

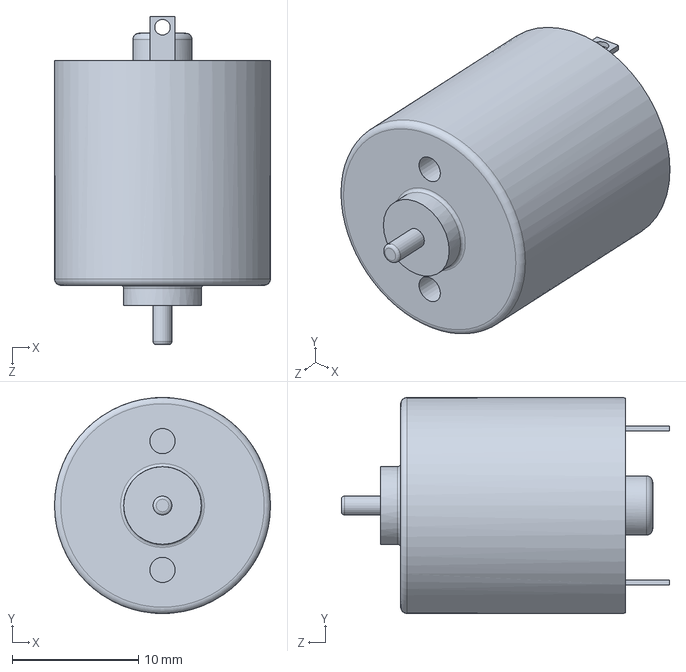
[picture p162: CAD file, 2017-09-05]
Ziro-master/Mechanical/Ziro 2.0/Module/Quark/Electronics/17 mm Motor_Quark.SLDPRT
17.1 x 17.1 x 26.0 mm
