ZeroUI/Industrial-Quark/Ziro-master/Mechanical/Ziro 2.0/Module/Quark/Gears/Gear_1 Motor Pinion_9Teeth_0.3 Modulus.SLDPRT

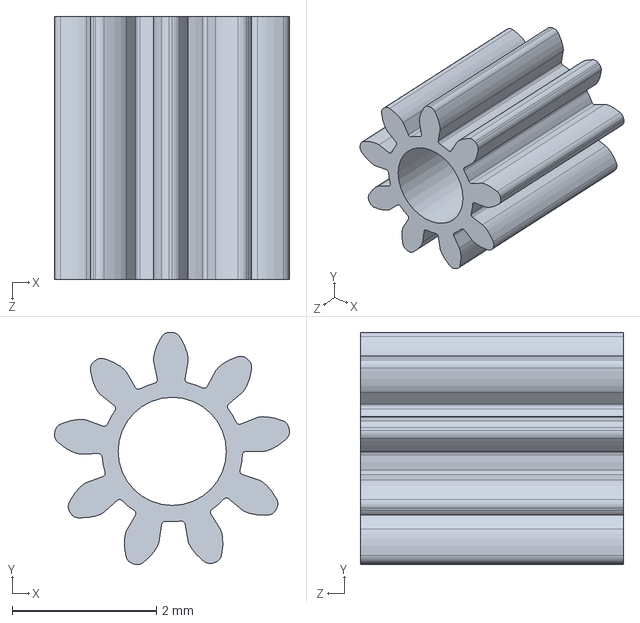
[picture p163: CAD file, 2017-09-05]
Ziro-master/Mechanical/Ziro 2.0/Module/Quark/Gears/Gear_1 Motor Pinion_9Teeth_0.3 Modulus.SLDPRT
3.26 x 3.22 x 3.65 mm
