ZeroUI/Industrial-Quark/Ziro-master/Mechanical/Ziro 2.0/Module/Quark/Gears/Intermediate Pinions/Gear 4 - Small.SLDPRT

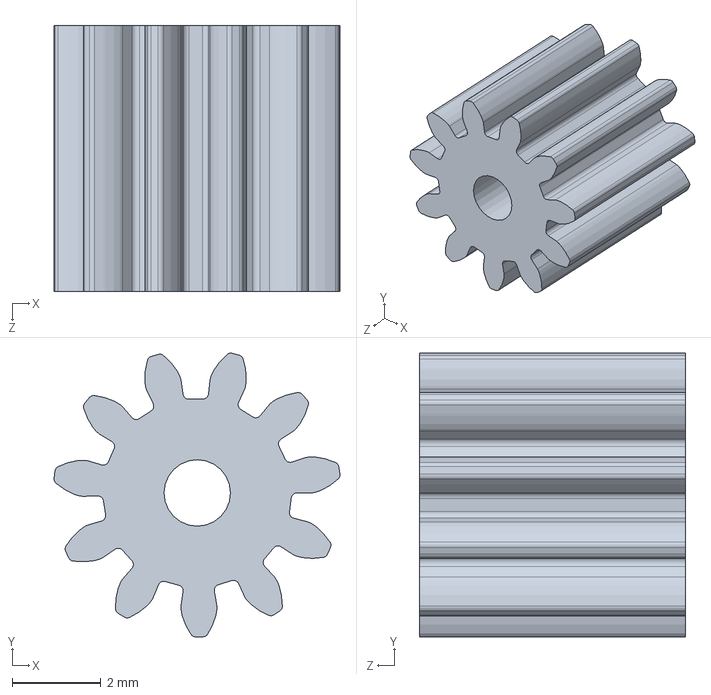
[picture p164: CAD file, 2017-09-05]
Ziro-master/Mechanical/Ziro 2.0/Module/Quark/Gears/Intermediate Pinions/Gear 4 - Small.SLDPRT
6.46 x 6.41 x 6.00 mm
