ZeroUI/Industrial-Quark/Ziro-master/Mechanical/Ziro 2.0/Module/Quark/Gears/STEP files/Gear_4___ Large_35Teeth_0.4 Modulus___Small_11Teeth_0.5Modulus.STEP

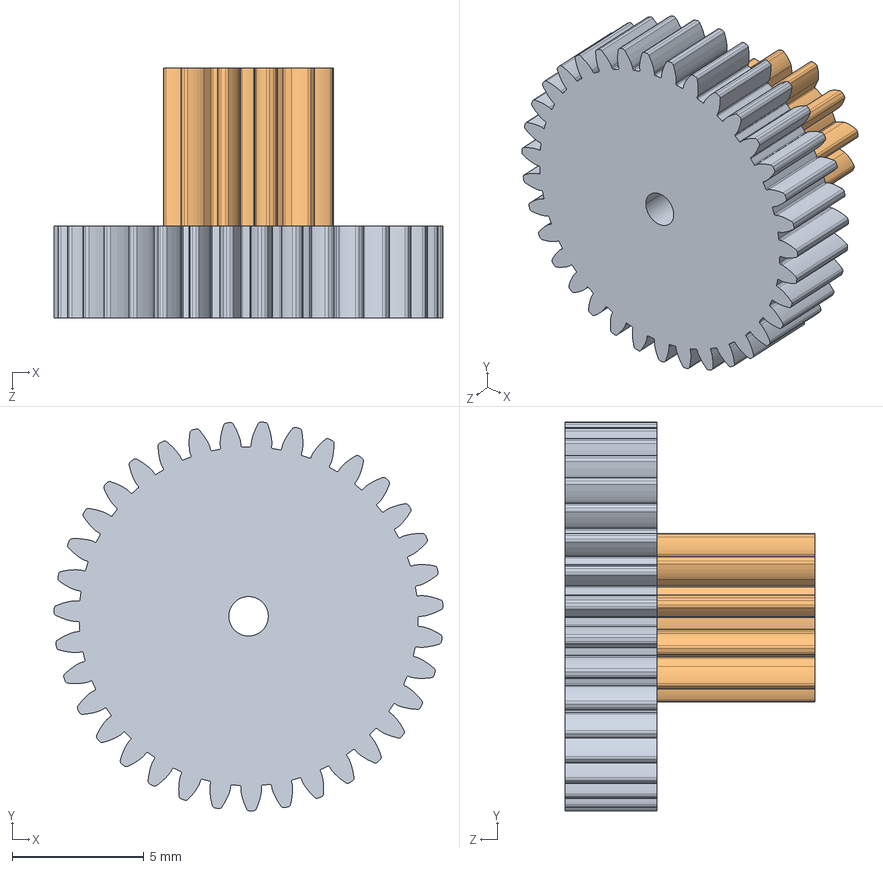
[picture p165: CAD file, 2017-09-05]
Ziro-master/Mechanical/Ziro 2.0/Module/Quark/Gears/STEP files/Gear_4___ Large_35Teeth_0.4 Modulus___Small_11Teeth_0.5Modulus.STEP
14.8 x 14.8 x 9.50 mm
