ZeroUI/Industrial-Quark/Ziro-master/Mechanical/Ziro 2.0/Module/Quark/Gears/WireEDM/Wire EDM Gear_4___ Large_35Teeth_0.4 Modulus___Small_11Teeth_0.5Modulus.SLDPRT

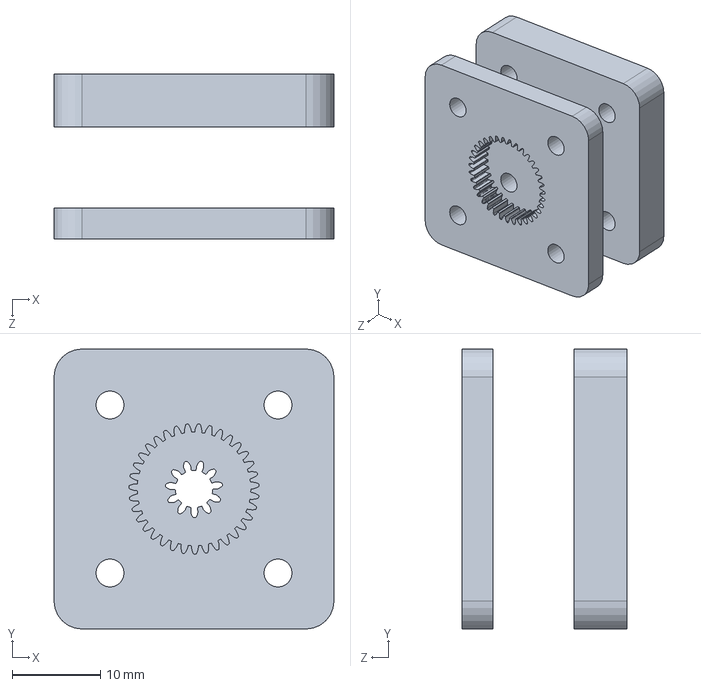
[picture p167: CAD file, 2017-09-05]
Ziro-master/Mechanical/Ziro 2.0/Module/Quark/Gears/WireEDM/Wire EDM Gear_4___ Large_35Teeth_0.4 Modulus___Small_11Teeth_0.5Modulus.SLDPRT
31.8 x 31.8 x 18.7 mm
