ZeroUI/Industrial-Quark/Ziro-master/Mechanical/Ziro 2.0/Module/Quark/Shafts/Gear_3_D1.5_L13mm Shaft.SLDPRT

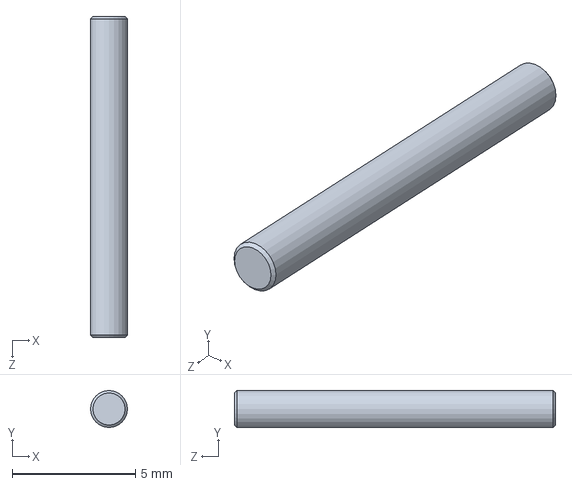
[picture p168: CAD file, 2017-09-05]
Ziro-master/Mechanical/Ziro 2.0/Module/Quark/Shafts/Gear_3_D1.5_L13mm Shaft.SLDPRT
1.50 x 1.50 x 13.0 mm
