ZeroUI/Industrial-Quark/Ziro-master/Mechanical/Ziro 2.0/Module/Quark/Shells/Herkulex/Print Version 2/Top Lid_Herkulex.STL

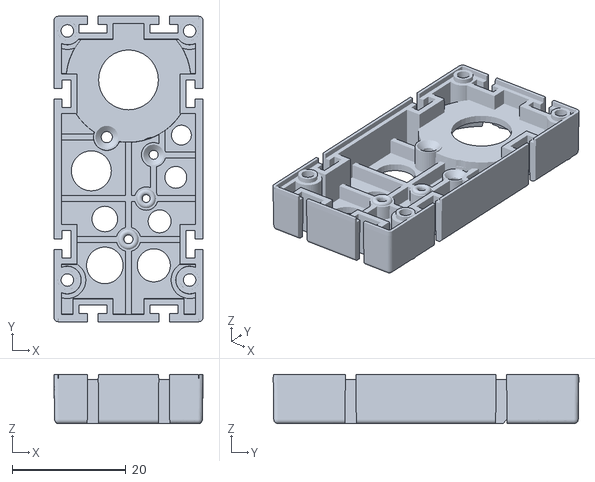
[picture p169: CAD file, 2017-09-05]
Ziro-master/Mechanical/Ziro 2.0/Module/Quark/Shells/Herkulex/Print Version 2/Top Lid_Herkulex.STL
26.2 x 53.7 x 8.65
