ZeroUI/Industrial-Quark/Ziro-master/Mechanical/Ziro 2.0/Module/Quark/Shells/Herkulex/Top Lid_Herkulex.SLDPRT

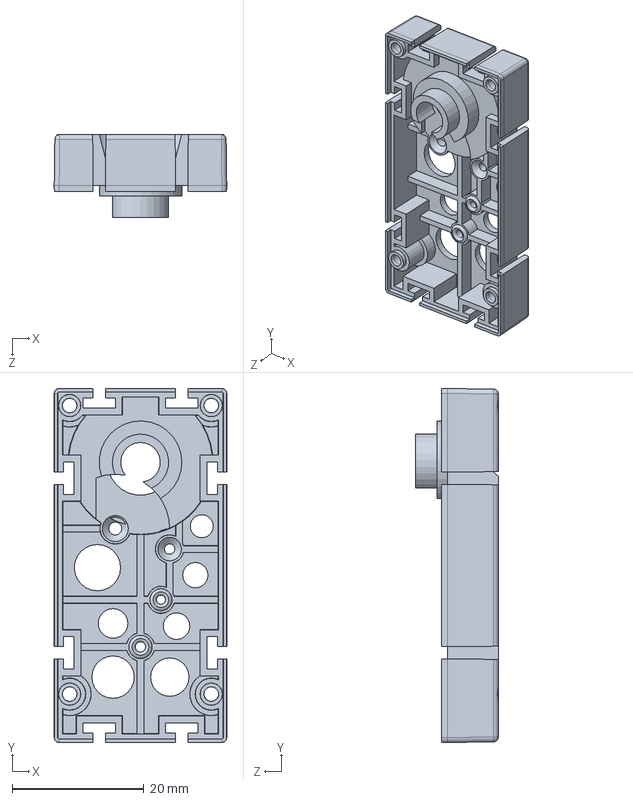
[picture p170: CAD file, 2017-09-05]
Ziro-master/Mechanical/Ziro 2.0/Module/Quark/Shells/Herkulex/Top Lid_Herkulex.SLDPRT
26.2 x 53.7 x 12.6 mm
