ZeroUI/Industrial-Quark/Ziro-master/Mechanical/Ziro 2.0/Module/Quark/Shells/Middle Shell.SLDPRT

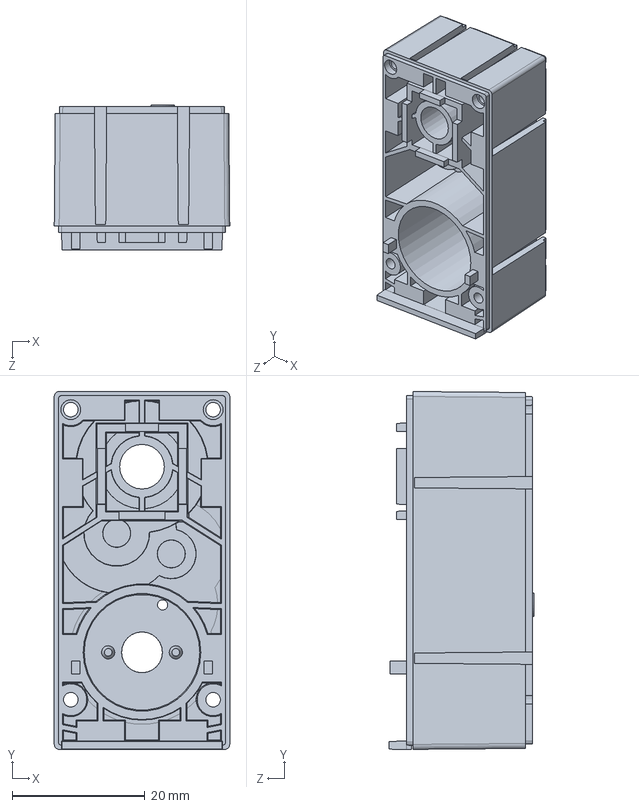
[picture p171: CAD file, 2017-09-05]
Ziro-master/Mechanical/Ziro 2.0/Module/Quark/Shells/Middle Shell.SLDPRT
26.5 x 54.0 x 21.8 mm
