ZeroUI/Industrial-Quark/Ziro-master/Mechanical/Ziro 2.0/Module/Quark/Shells/Print/Gear_6 Potentiometer Connector_Herkulex.STL

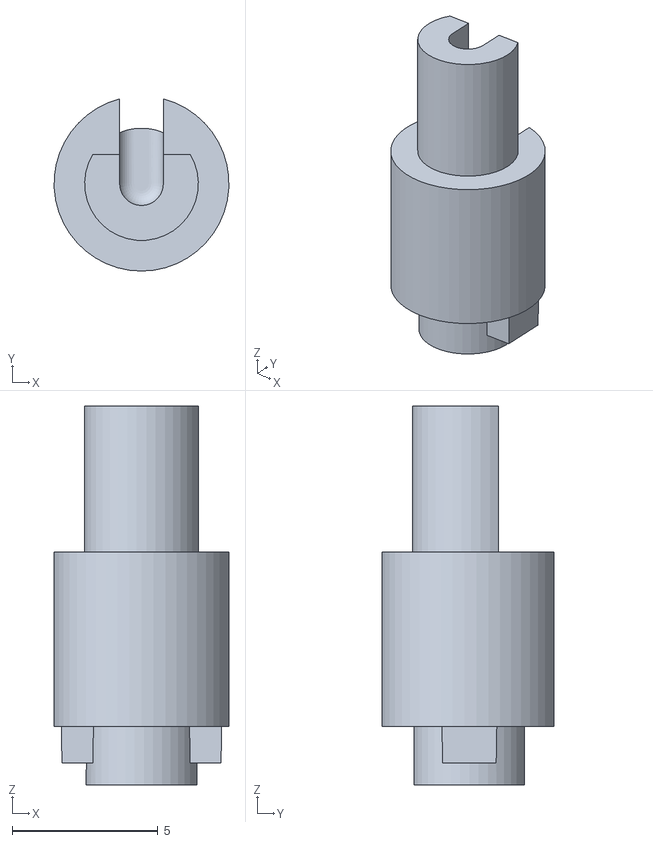
[picture p172: CAD file, 2017-09-05]
Ziro-master/Mechanical/Ziro 2.0/Module/Quark/Shells/Print/Gear_6 Potentiometer Connector_Herkulex.STL
5.99 x 5.90 x 13.0
