ZeroUI/Industrial-Quark/Ziro-master/Mechanical/Ziro 2.0/Module/Shells/Shell Components/Slider Lid.SLDPRT

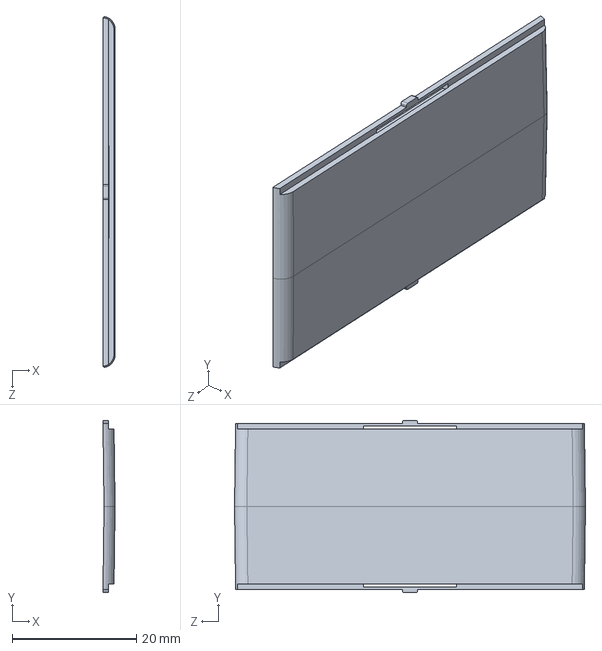
[picture p173: CAD file, 2017-09-05]
Ziro-master/Mechanical/Ziro 2.0/Module/Shells/Shell Components/Slider Lid.SLDPRT
1.95 x 27.8 x 56.5 mm
