ZeroUI/Industrial-Quark/Ziro-master/BoM/Motor Modules/Shell/Shell_Body.STEP

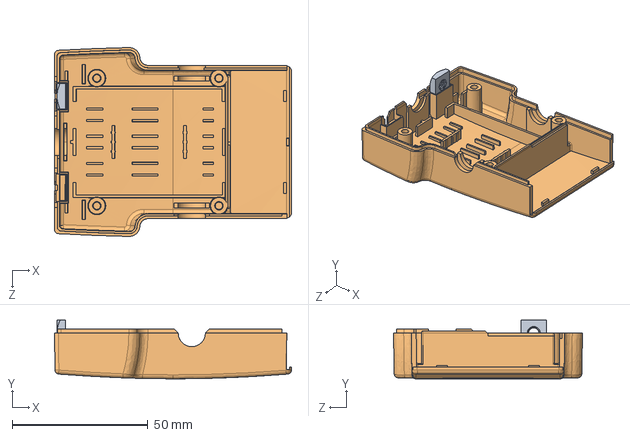
[picture p175: CAD file, 2017-09-05]
Ziro-master/BoM/Motor Modules/Shell/Shell_Body.STEP
87.3 x 21.6 x 69.6 mm
