ZeroUI/Industrial-Quark/Ziro-master/BoM/Tile/Tile_Cross_Axle_Pin_Unidirectional_33.0mm.STEP

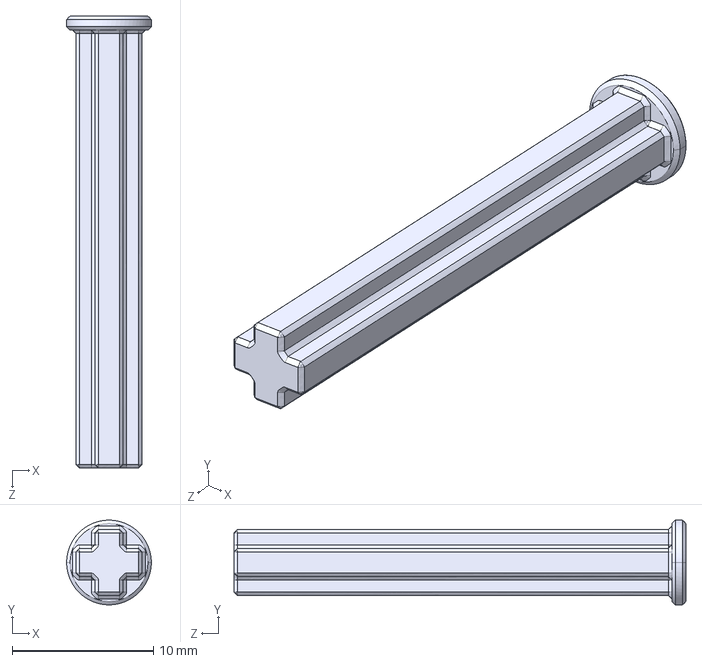
[picture p176: CAD file, 2017-09-05]
Ziro-master/BoM/Tile/Tile_Cross_Axle_Pin_Unidirectional_33.0mm.STEP
6.00 x 6.00 x 32.0 mm
