ZeroUI/Industrial-Quark/Ziro-master/Mechanical/Ziro 2.0/Module/Quark/Gears/STEP files/Gear_2__Large_43Teeth_0.3Modulus__Small_9Teeth_0.3Modulus.STEP

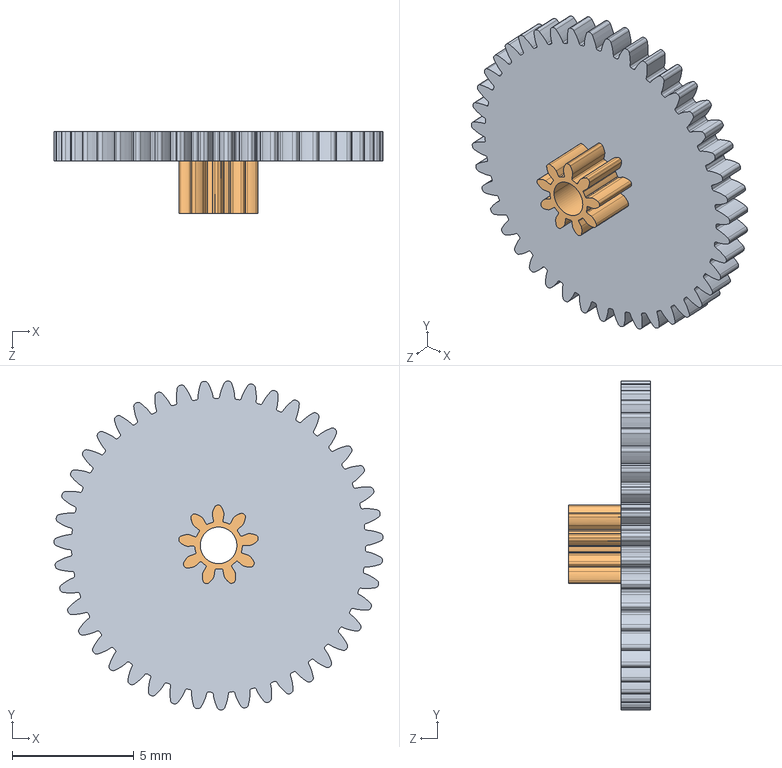
[picture p177: CAD file, 2017-09-05]
Ziro-master/Mechanical/Ziro 2.0/Module/Quark/Gears/STEP files/Gear_2__Large_43Teeth_0.3Modulus__Small_9Teeth_0.3Modulus.STEP
13.5 x 13.5 x 3.35 mm
