ZeroUI/Industrial-Quark/Ziro-master/Mechanical/Ziro 2.0/Module/Quark/Gears/WireEDM/Wire EDMGear_2__Large_43Teeth_0.3Modulus__Small_9Teeth_0.3Modulus.SLDPRT

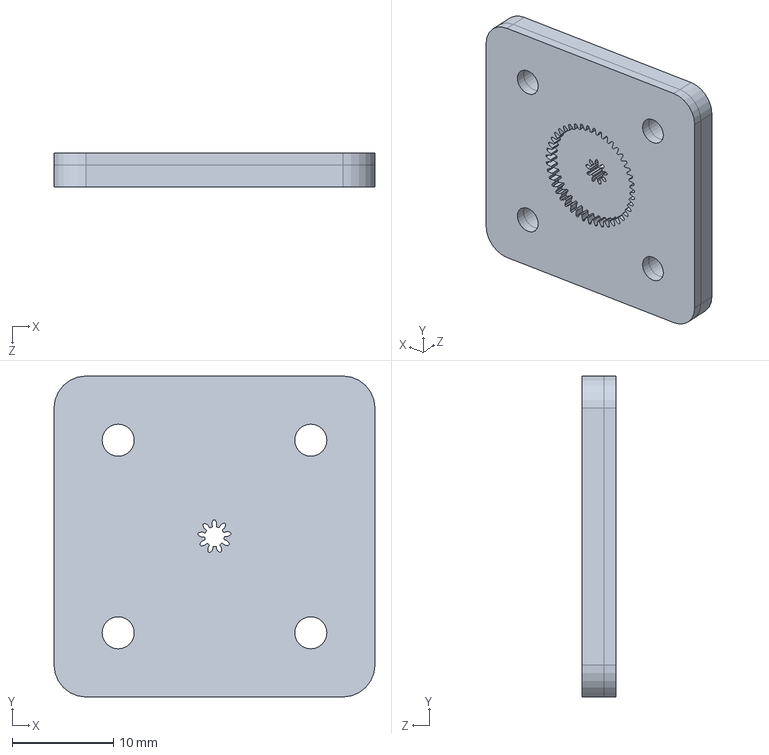
[picture p179: CAD file, 2017-09-05]
Ziro-master/Mechanical/Ziro 2.0/Module/Quark/Gears/WireEDM/Wire EDMGear_2__Large_43Teeth_0.3Modulus__Small_9Teeth_0.3Modulus.SLDPRT
31.8 x 31.8 x 3.35 mm
