ZeroUI/Industrial-Quark/Ziro-master/Mechanical/Ziro 2.0/Module/Quark/Shafts/Gear_4_D1.5_L19.5mm Shaft.SLDPRT

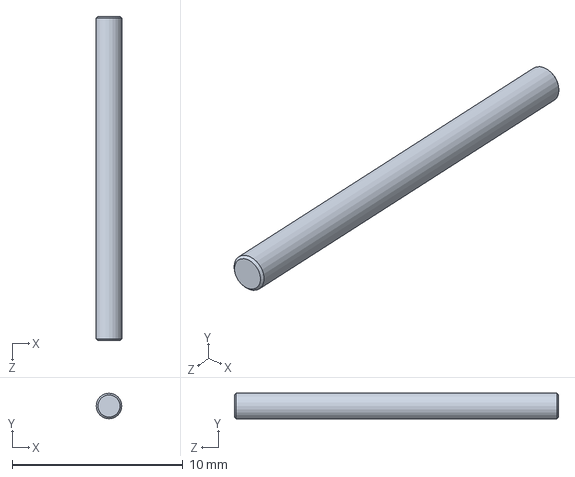
[picture p180: CAD file, 2017-09-05]
Ziro-master/Mechanical/Ziro 2.0/Module/Quark/Shafts/Gear_4_D1.5_L19.5mm Shaft.SLDPRT
1.50 x 1.50 x 19.0 mm
