ZeroUI/Industrial-Quark/Ziro-master/BoM/Tile/Tile_2Side_Body_Half.STEP

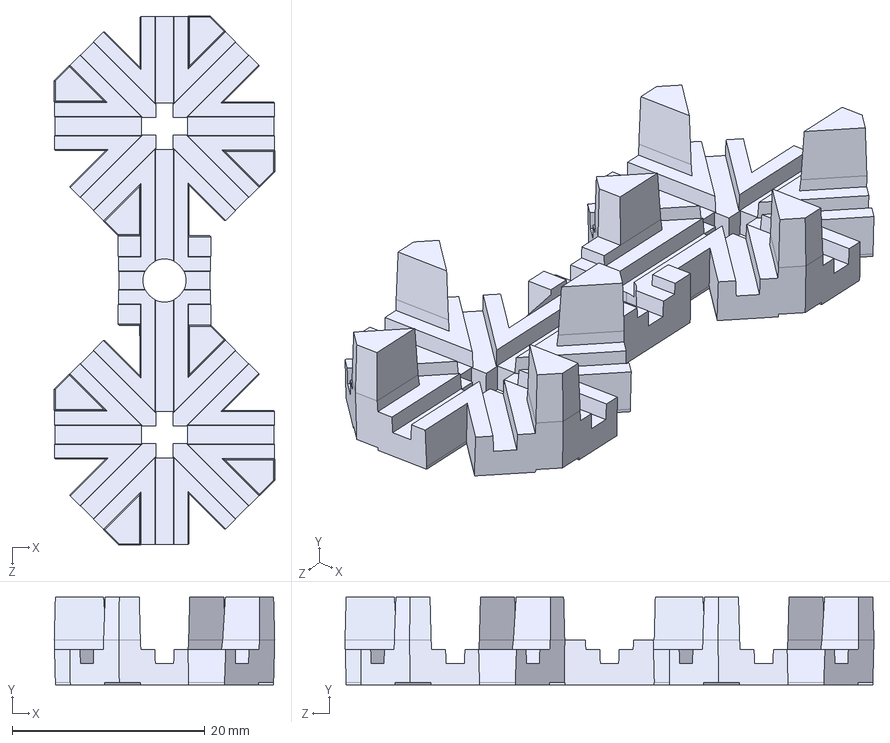
[picture p181: CAD file, 2017-09-05]
Ziro-master/BoM/Tile/Tile_2Side_Body_Half.STEP
22.9 x 9.12 x 54.9 mm
