ZeroUI/Industrial-Quark/Ziro-master/Mechanical/Ziro 2.0/Module/Quark/Gears/STEP files/Gear 3___Large_43Teeth_0.3Modulus__Small_9Teeth_0.4Modulus.STEP

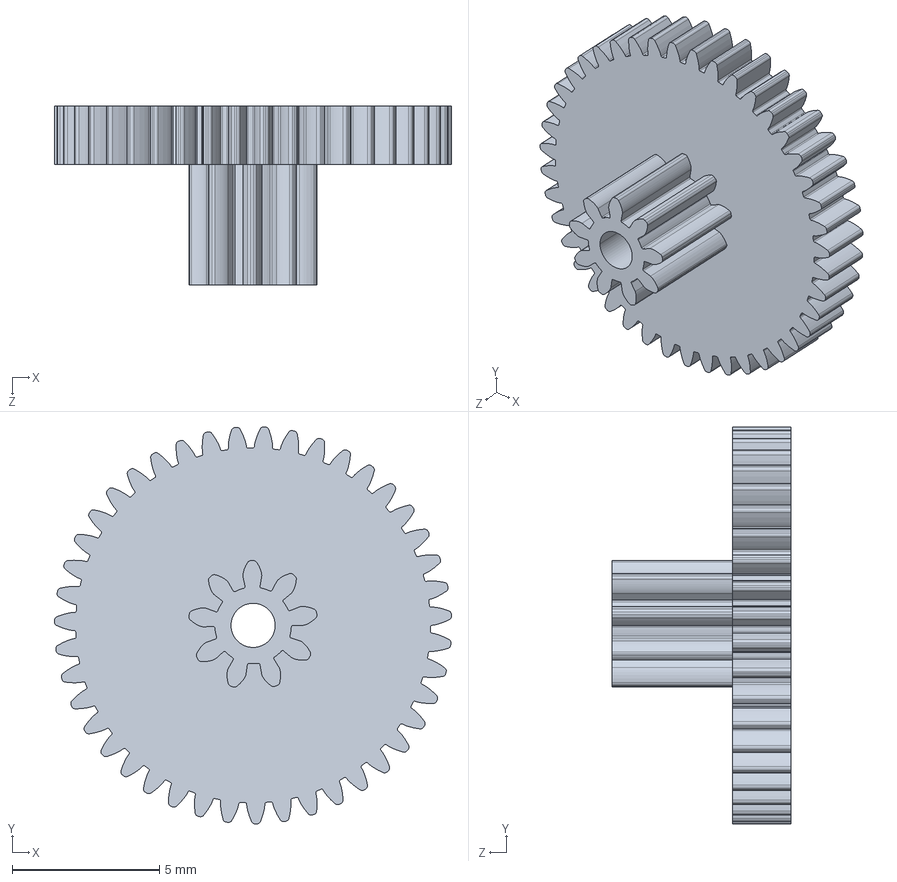
[picture p182: CAD file, 2017-09-05]
Ziro-master/Mechanical/Ziro 2.0/Module/Quark/Gears/STEP files/Gear 3___Large_43Teeth_0.3Modulus__Small_9Teeth_0.4Modulus.STEP
13.5 x 13.5 x 6.10 mm
