ZeroUI/Industrial-Quark/Ziro-master/Mechanical/Ziro 2.0/Module/Quark/Shells/Middle Shell_Herkulex.SLDPRT

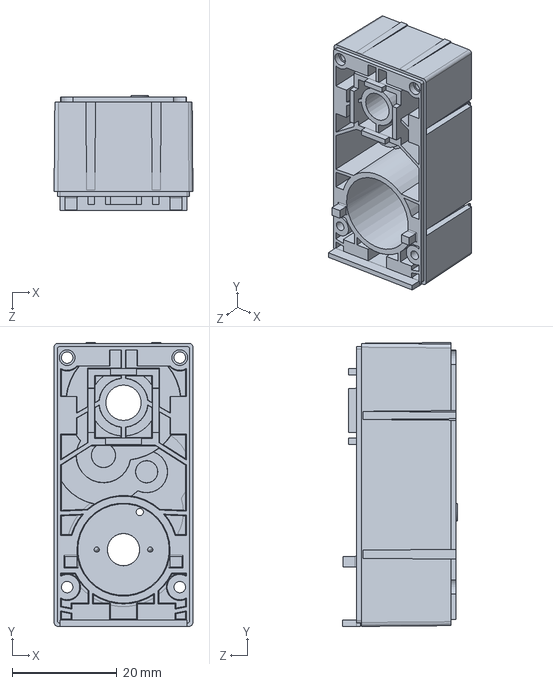
[picture p184: CAD file, 2017-09-05]
Ziro-master/Mechanical/Ziro 2.0/Module/Quark/Shells/Middle Shell_Herkulex.SLDPRT
26.5 x 54.1 x 21.8 mm
