ZeroUI/Industrial-Quark/Ziro-master/BoM/Motor Modules/Quark/Quark_Mechanical_Gear_2__Large_43Teeth_0.3Modulus__Small_9Teeth_0.3Modulus.STEP

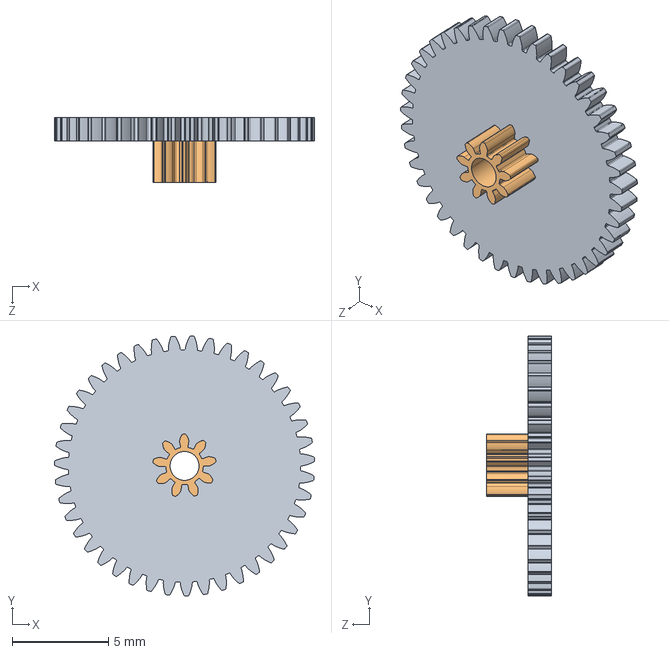
[picture p185: CAD file, 2017-09-05]
Ziro-master/BoM/Motor Modules/Quark/Quark_Mechanical_Gear_2__Large_43Teeth_0.3Modulus__Small_9Teeth_0.3Modulus.STEP
13.5 x 13.5 x 3.35 mm
