ZeroUI/Industrial-Quark/Ziro-master/Mechanical/Ziro 2.0/Module/Quark/Gears/WireEDM/Mold Inserts/Step Files/Gear_2_Small_EDM Inserts.STEP

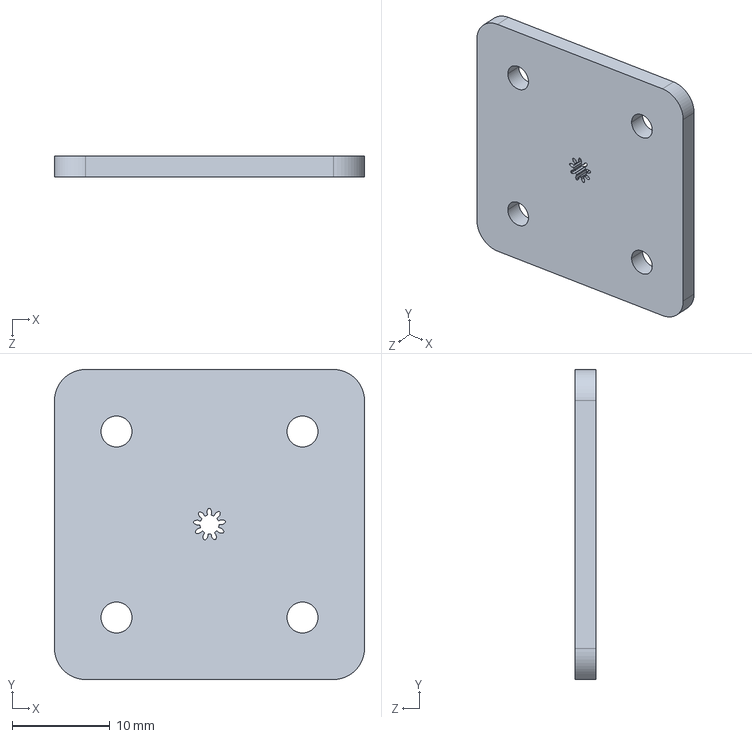
[picture p186: CAD file, 2017-09-05]
Ziro-master/Mechanical/Ziro 2.0/Module/Quark/Gears/WireEDM/Mold Inserts/Step Files/Gear_2_Small_EDM Inserts.STEP
31.8 x 31.8 x 2.15 mm
