ZeroUI/Industrial-Quark/Ziro-master/Mechanical/Ziro 2.0/Module/Quark/Shells/Stock Solid For Shell Parts.SLDPRT

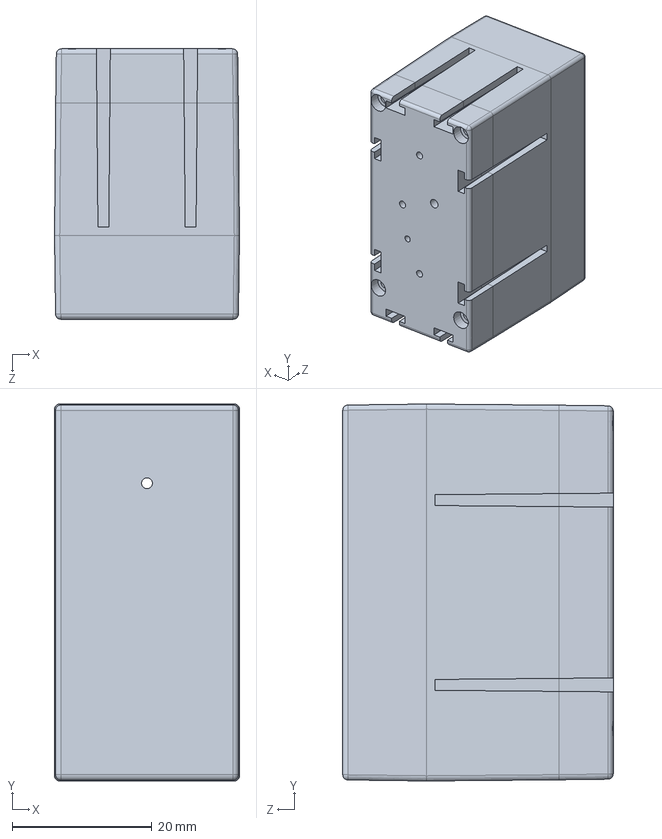
[picture p187: CAD file, 2017-09-05]
Ziro-master/Mechanical/Ziro 2.0/Module/Quark/Shells/Stock Solid For Shell Parts.SLDPRT
26.5 x 54.0 x 38.8 mm
