ZeroUI/Industrial-Quark/Ziro-master/BoM/Motor Modules/Quark/Quark_Mechanical_Gear_1_Brass_Pinion_On_Motor.STEP

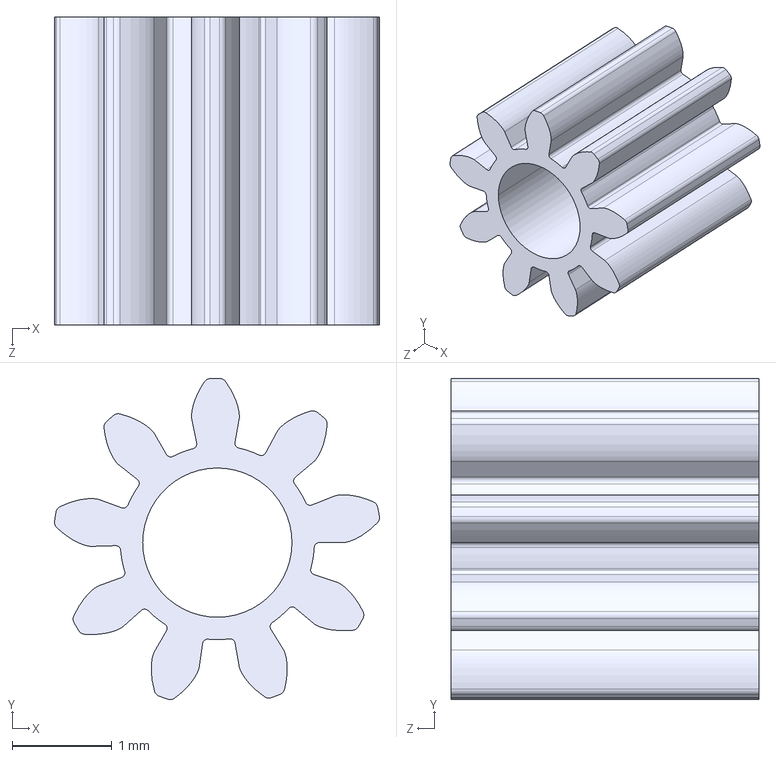
[picture p188: CAD file, 2017-09-05]
Ziro-master/BoM/Motor Modules/Quark/Quark_Mechanical_Gear_1_Brass_Pinion_On_Motor.STEP
3.27 x 3.23 x 3.10 mm
