ZeroUI/Industrial-Quark/Ziro-master/BoM/Motor Modules/Quark/Quark_Mechanical_Shaft_1.5X13mm.STEP

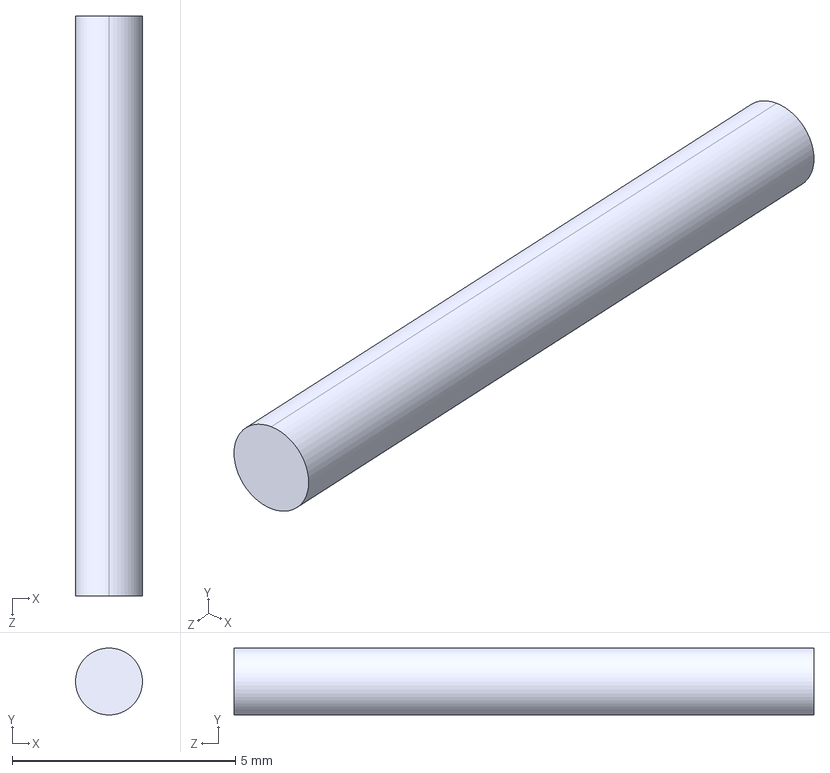
[picture p190: CAD file, 2017-09-05]
Ziro-master/BoM/Motor Modules/Quark/Quark_Mechanical_Shaft_1.5X13mm.STEP
1.50 x 1.50 x 13.0 mm
