ZeroUI/Industrial-Quark/Ziro-master/BoM/Motor Modules/Quark/Quark_Mechanical_Gear_4_Large_35Teeth_0.4 Modulus___Small_11Teeth_0.5Modulus.STEP

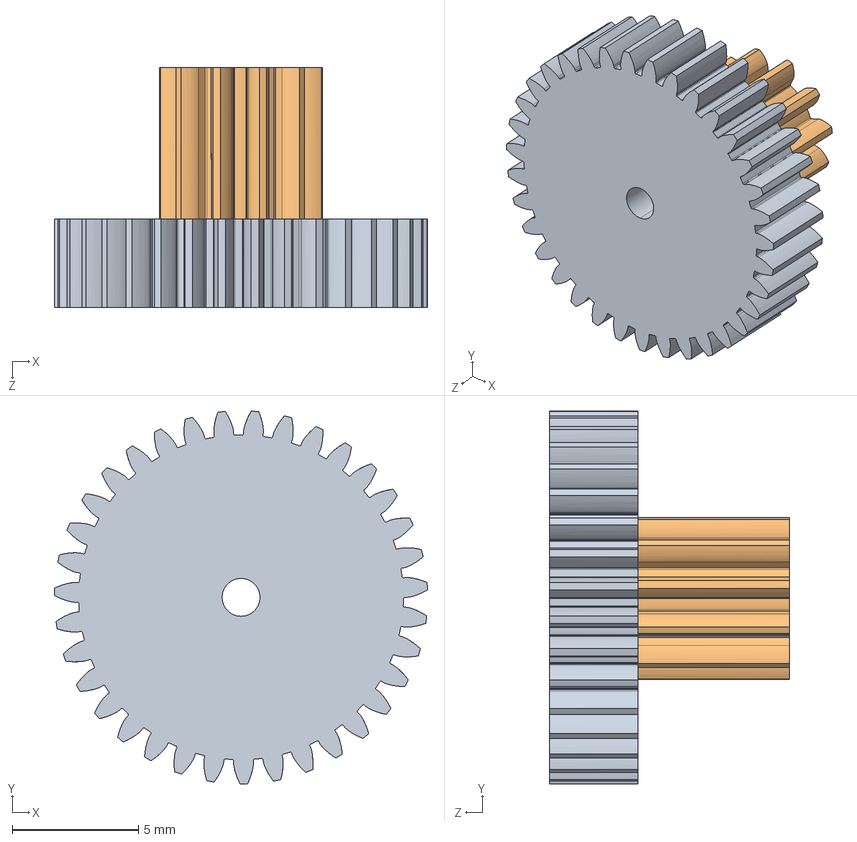
[picture p191: CAD file, 2017-09-05]
Ziro-master/BoM/Motor Modules/Quark/Quark_Mechanical_Gear_4_Large_35Teeth_0.4 Modulus___Small_11Teeth_0.5Modulus.STEP
14.8 x 14.8 x 9.50 mm
