ZeroUI/Industrial-Quark/Ziro-master/BoM/Motor Modules/Quark/Quark_Mechanical_Gear_3_Large_43Teeth_0.3Modulus__Small_9Teeth_0.4Modulus.STEP

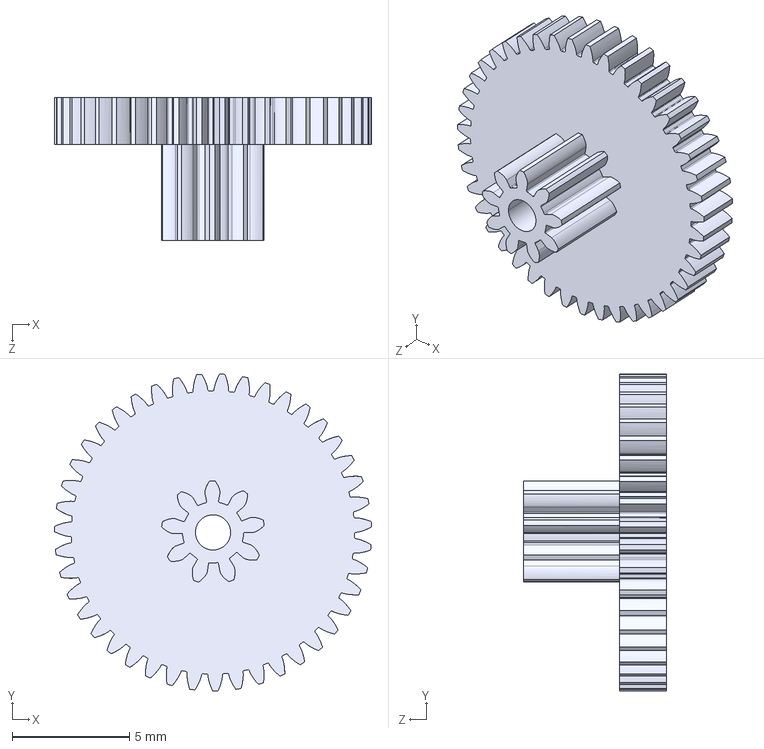
[picture p192: CAD file, 2017-09-05]
Ziro-master/BoM/Motor Modules/Quark/Quark_Mechanical_Gear_3_Large_43Teeth_0.3Modulus__Small_9Teeth_0.4Modulus.STEP
13.5 x 13.5 x 6.10 mm
