ZeroUI/Industrial-Quark/Ziro-master/BoM/Motor Modules/Quark/Quark_Mechanical_Shaft_1.5X7.25mm.STEP

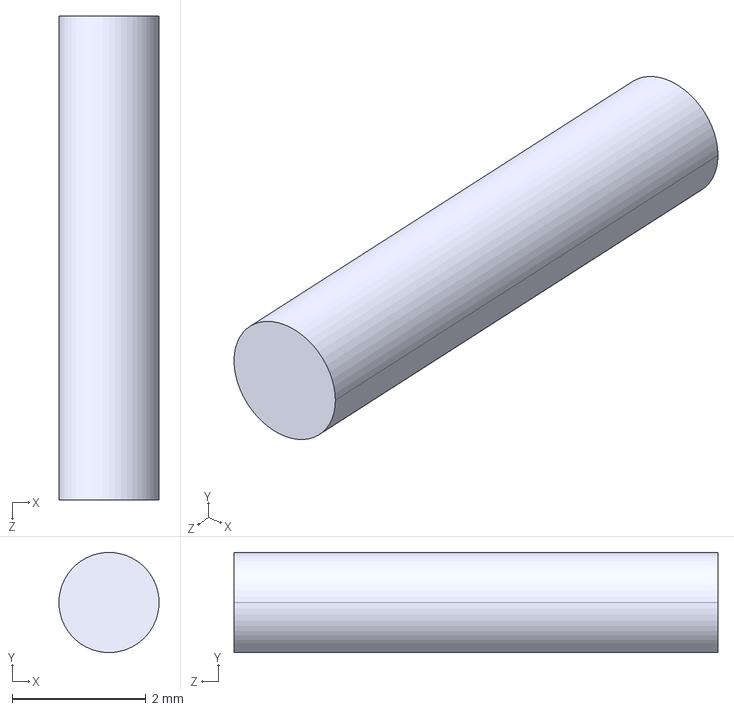
[picture p193: CAD file, 2017-09-05]
Ziro-master/BoM/Motor Modules/Quark/Quark_Mechanical_Shaft_1.5X7.25mm.STEP
1.50 x 1.50 x 7.25 mm
