ZeroUI/Industrial-Quark/Ziro-master/BoM/Motor Modules/Quark/Quark_Mechanical_Shaft_1.5X19mm.STEP

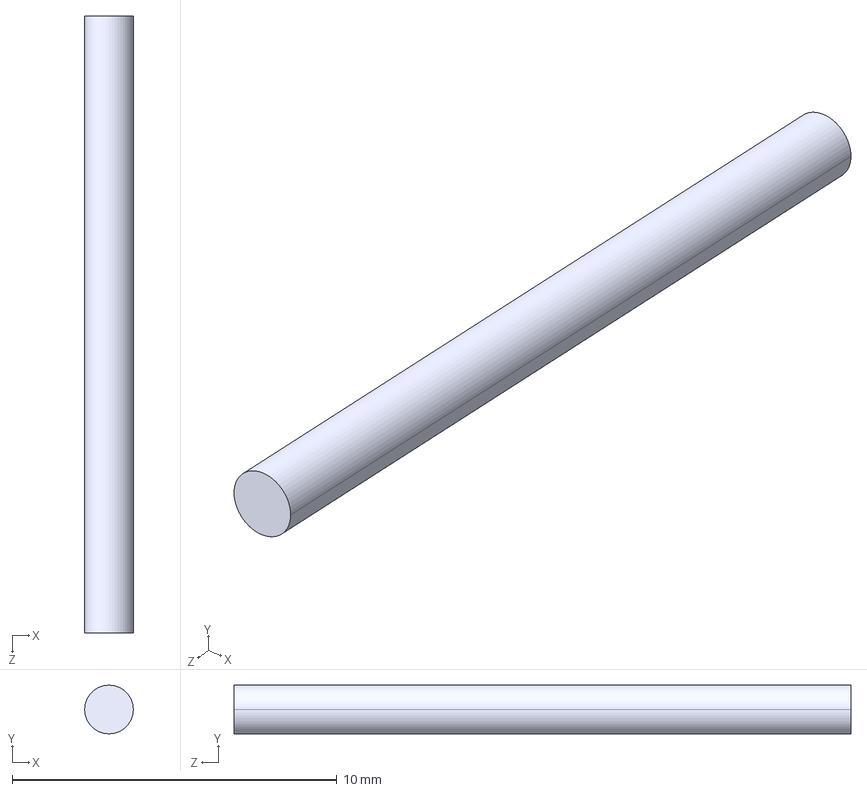
[picture p194: CAD file, 2017-09-05]
Ziro-master/BoM/Motor Modules/Quark/Quark_Mechanical_Shaft_1.5X19mm.STEP
1.50 x 1.50 x 19.0 mm
