ZeroUI/Industrial-Quark/(list of files, cad)

Other CAD files:
Ziro-master/BoM/Glove Modules/PCB Shell/Glove-E1-PCB/Flex Sensor Pattern.dxf
Ziro-master/Electronics/V2.0 Wifi/Hardware/Flex Sensor/Flex Pattern Flex Point_2.dxf
Ziro-master/Mechanical/Ziro 2.0/Accessories/Wheels/Wheel_Rubber_Combined.STEP
Ziro-master/Mechanical/Ziro 2.0/Module/Quark/Shells/Back Lid.SLDPRT
Ziro-master/Mechanical/Ziro 2.0/Module/Shells/STLs/Shell.STL
Ziro-master/BoM/Glove Modules/Battery Shell/Battery_Shell_Holder_Body.STEP
Ziro-master/Electronics/V1.0 Bluetooth/Hardware/Handimate_Backup/Skethup/Handimate Electronics.stl
Ziro-master/Mechanical/Ziro 2.0/Module/Shells/STLs/Slider Lid.STL
Ziro-master/Mechanical/Ziro 2.0/Module/Quark/Shells/Herkulex/Print Version 2/Top Lid_Herkulex_v2.STL
Ziro-master/Mechanical/Ziro 2.0/Module/Quark/Shells/Top Lid.SLDPRT
Ziro-master/BoM/Motor Modules/Quark/Quark_Mechanical_Cover_Middle.STEP
Ziro-master/Mechanical/Ziro 2.0/Module/Quark/Gears/STEP files/Gear_5__Output Gear_32Teeth_0.5Modulus.STEP
Ziro-master/BoM/Motor Modules/Quark/Quark_Mechanical_GearPotentiometerConnector.STEP
Ziro-master/BoM/Connector Screw/Connector Screw_Body.STEP
Ziro-master/BoM/Connector Screw/Connector Screw_TYPE 18-8 SS LOW PROFILE SOCKET CAP SCREW(10-32X0.625in).STEP
Ziro-master/BoM/Connector Screw/ConnectorRot_Small.SLDPRT
Ziro-master/BoM/Motor Modules/Quark/Quark_Mechanical_TYPE 18-8 SS SOCKET HEAD CAP SCREW_M2 X 30mm.STEP
Ziro-master/BoM/Motor Modules/Rotating Pin Screw/90289A341_ALLOY STEEL KNURL-GRIP CUP POINT SET SCREW.STEP
Ziro-master/BoM/Motor Modules/Rotating Pin Screw/Rotating Pin Screw_Body.STEP
Ziro-master/BoM/Motor Modules/Shell/Shell_BRASS SQUARE NUT_10-32_(.375inX0.375inX0.125in).STEP
Ziro-master/Electronics/V1.0 Bluetooth/Hardware/Handimate_Backup/Glove Module/eagleUp/Glove Export.dwg
Ziro-master/Electronics/V1.0 Bluetooth/Hardware/Handimate_Backup/Skethup/Glove Module.skp
Ziro-master/Electronics/V1.0 Bluetooth/Hardware/Handimate_Backup/Skethup/Handimate Electronics Assembly.skp
Ziro-master/Electronics/V1.0 Bluetooth/Hardware/Handimate_Backup/Skethup/Handimate Electronics.dwg
Ziro-master/Electronics/V1.0 Bluetooth/Hardware/Handimate_Backup/Skethup/Handimate Electronics.obj
Ziro-master/Electronics/V1.0 Bluetooth/Hardware/Handimate_Backup/Skethup/Handimate Electronicsuntitled.dxf
Ziro-master/Electronics/V1.0 Bluetooth/Hardware/Handimate_Backup/Skethup/Motor Module-Connector Mount.skp
Ziro-master/Electronics/V1.0 Bluetooth/Hardware/Handimate_Backup/Skethup/Motor Module-Side Mount.skp
Ziro-master/Mechanical/Ziro 2.0/Accessories/Keychain/Drawings/Ziro Keychain.SLDDRW
Ziro-master/Mechanical/Ziro 2.0/Module/Quark/Fasterners/18-8 STAINLESS STEEL SOCKET HEAD CAP SCREW_2 56_1_3BY8.SLDPRT
Ziro-master/Mechanical/Ziro 2.0/Module/Quark/Fasterners/18-8 STAINLESS STEEL SOCKET HEAD CAP SCREW_2-56PartiallyThreaded_1.25in.SLDPRT
Ziro-master/Mechanical/Ziro 2.0/Module/Quark/Gears/Drawings/Gear 3___Large_43Teeth_0.3Modulus__Small_9Teeth_0.4Modulus.SLDDRW
Ziro-master/Mechanical/Ziro 2.0/Module/Quark/Gears/Drawings/Gear_1 Motor Pinion_9Teeth_0.3 Modulus.SLDDRW
Ziro-master/Mechanical/Ziro 2.0/Module/Quark/Gears/Drawings/Gear_2__Large_43Teeth_0.3Modulus__Small_9Teeth_0.3Modulus.SLDDRW
Ziro-master/Mechanical/Ziro 2.0/Module/Quark/Gears/Drawings/Gear_4___ Large_35Teeth_0.4 Modulus___Small_11Teeth_0.5Modulus.SLDDRW
Ziro-master/Mechanical/Ziro 2.0/Module/Quark/Gears/Drawings/Gear_5__Output Gear_32Teeth_0.5Modulus.SLDDRW
Ziro-master/Mechanical/Ziro 2.0/Module/Quark/Gears/Drawings/Gear_6 Potentiometer Connector.SLDDRW
Ziro-master/Mechanical/Ziro 2.0/Module/Quark/Gears/Gear 3___Large_43Teeth_0.3Modulus__Small_9Teeth_0.4Modulus.SLDPRT
Ziro-master/Mechanical/Ziro 2.0/Module/Quark/Gears/Gear_2__Large_43Teeth_0.3Modulus__Small_9Teeth_0.3Modulus.SLDPRT
Ziro-master/Mechanical/Ziro 2.0/Module/Quark/Gears/Gear_4___ Large_35Teeth_0.4 Modulus___Small_11Teeth_0.5Modulus.SLDPRT
Ziro-master/Mechanical/Ziro 2.0/Module/Quark/Gears/Gear_5__Output Gear_32Teeth_0.5Modulus.SLDPRT
Ziro-master/Mechanical/Ziro 2.0/Module/Quark/Gears/Gear_6 Potentiometer Connector.SLDPRT
Ziro-master/Mechanical/Ziro 2.0/Module/Quark/Gears/Intermediate Pinions/Gear_4___ Large_35Teeth_0.4 Modulus___Small_11Teeth_0.5Modulus.SLDDRW
Ziro-master/Mechanical/Ziro 2.0/Module/Quark/Gears/STLs/Gear 3___Large_43Teeth_0.3Modulus__Small_9Teeth_0.4Modulus.STL
Ziro-master/Mechanical/Ziro 2.0/Module/Quark/Gears/STLs/Gear_2__Large_43Teeth_0.3Modulus__Small_9Teeth_0.3Modulus.STL
Ziro-master/Mechanical/Ziro 2.0/Module/Quark/Gears/STLs/Gear_4___ Large_35Teeth_0.4 Modulus___Small_11Teeth_0.5Modulus.STL
Ziro-master/Mechanical/Ziro 2.0/Module/Quark/Gears/STLs/Gear_6 Potentiometer Connector.STL
Ziro-master/Mechanical/Ziro 2.0/Module/Quark/Gears/WireEDM/Mold Inserts/Drawings/Gear_2_Large_EDM_Inserts.SLDDRW
Ziro-master/Mechanical/Ziro 2.0/Module/Quark/Gears/WireEDM/Mold Inserts/Drawings/Gear_2_Small_EDM Inserts.SLDDRW
Ziro-master/Mechanical/Ziro 2.0/Module/Quark/Gears/WireEDM/Mold Inserts/Drawings/Gear_3_Large_EDM_Inserts.SLDDRW
Ziro-master/Mechanical/Ziro 2.0/Module/Quark/Gears/WireEDM/Mold Inserts/Drawings/Gear_3_Small_EDM_Inserts.SLDDRW
Ziro-master/Mechanical/Ziro 2.0/Module/Quark/Gears/WireEDM/Mold Inserts/Drawings/Gear_4_Large_EDM_Inserts.SLDDRW
Ziro-master/Mechanical/Ziro 2.0/Module/Quark/Gears/WireEDM/Mold Inserts/Drawings/Gear_4_Small_EDM_Inserts.SLDDRW
Ziro-master/Mechanical/Ziro 2.0/Module/Quark/Gears/WireEDM/Mold Inserts/Gear_2_Large_EDM_Inserts.sldprt
Ziro-master/Mechanical/Ziro 2.0/Module/Quark/Gears/WireEDM/Mold Inserts/Gear_2_Small_EDM Inserts.sldprt
Ziro-master/Mechanical/Ziro 2.0/Module/Quark/Gears/WireEDM/Mold Inserts/Gear_3_Large_EDM_Inserts.sldprt
Ziro-master/Mechanical/Ziro 2.0/Module/Quark/Gears/WireEDM/Mold Inserts/Gear_3_Small_EDM_Inserts.sldprt
Ziro-master/Mechanical/Ziro 2.0/Module/Quark/Gears/WireEDM/Mold Inserts/Gear_4_Large_EDM_Inserts.sldprt
Ziro-master/Mechanical/Ziro 2.0/Module/Quark/Gears/WireEDM/Mold Inserts/Gear_4_Small_EDM_Inserts.sldprt
Ziro-master/Mechanical/Ziro 2.0/Module/Quark/Shafts/Drawings/Gear_2_D1.5_L7.25mm Shaft.SLDDRW
Ziro-master/Mechanical/Ziro 2.0/Module/Quark/Shafts/Drawings/Gear_3_D1.5_L13mm Shaft.SLDDRW
Ziro-master/Mechanical/Ziro 2.0/Module/Quark/Shafts/Drawings/Gear_4_D1.5_L19.5mm Shaft.SLDDRW
Ziro-master/Mechanical/Ziro 2.0/Module/Quark/Shells/Print/Back Lid.STL
Ziro-master/Mechanical/Ziro 2.0/Module/Quark/Shells/Print/Middle Shell.STL
Ziro-master/Mechanical/Ziro 2.0/Module/Quark/Shells/Print/Middle Shell_Herkulex.STL
Ziro-master/Mechanical/Ziro 2.0/Module/Quark/Shells/Print/Top Lid.STL
Ziro-master/Mechanical/Ziro 2.0/Module/Shells/Fasteners/10-32 Square Nut.SLDPRT
