ZeroUI/Industrial-Quark/Ziro-master/BoM/_Assembly Process/Ziro Assembly Data.pdf

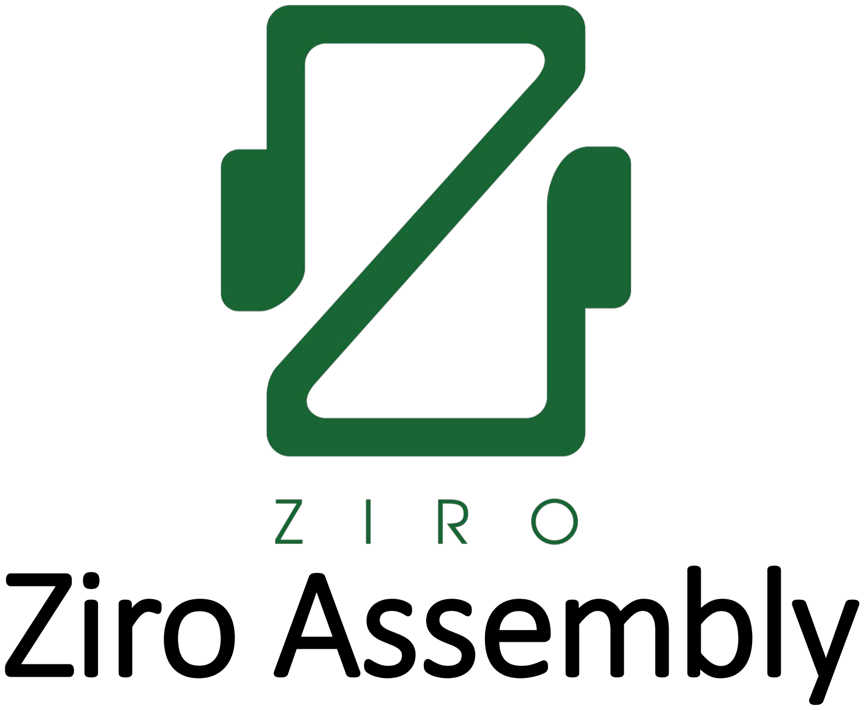
[picture p195: figure]
Ziro Assembly

# Document

## Prepared by Tanuj Siddharth tanuj@zeroui.com

# ZR2-MMD-HNG

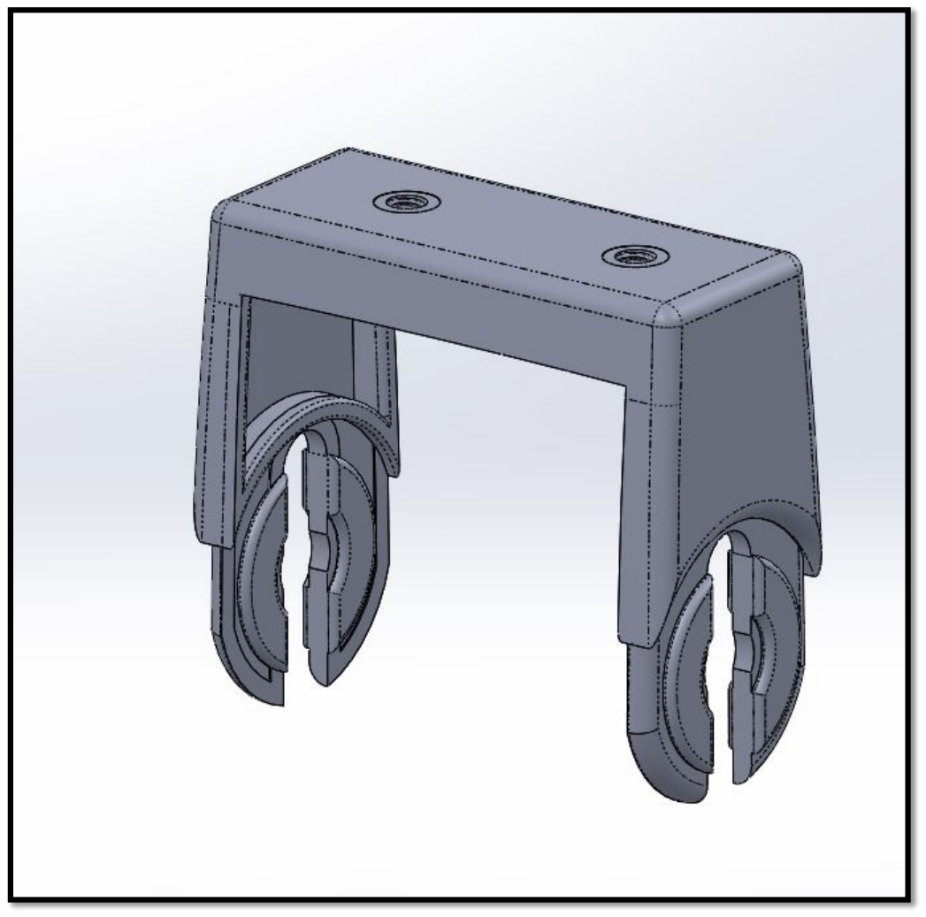
[picture p196: figure]

## External Finish SPI C2 – 400 Grit Internal Finish SPI C1/Non Expensive

## Push Fit: ZR2-MMD-HNG-PR1032 into ZR2-MMD-HNG-BODY

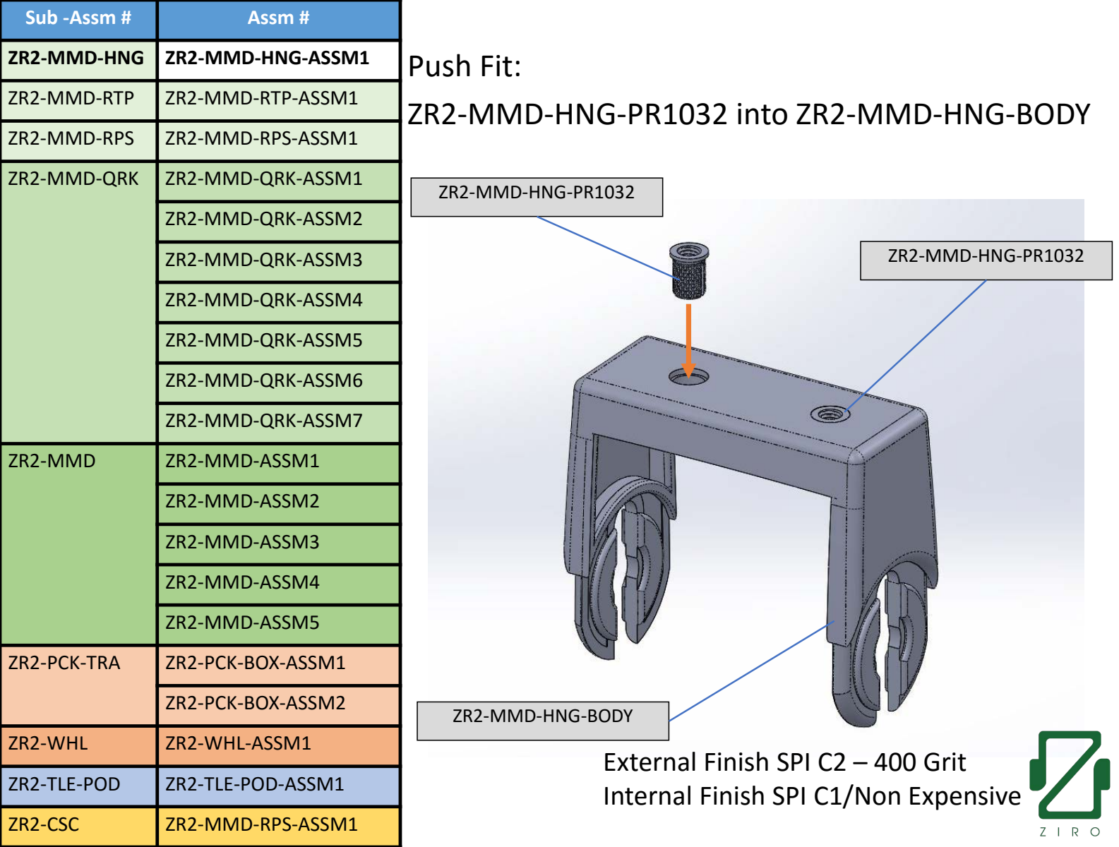
[picture p197: page 3]

ZR2-MMD-HNG-BODY

ZR2-MMD-HNG-PR1032

Sub -Assm # | Assm #
ZR2-MMD-HNG | ZR2-MMD-HNG-ASSM1
ZR2-MMD-RTP | ZR2-MMD-RTP-ASSM1
ZR2-MMD-RPS | ZR2-MMD-RPS-ASSM1
ZR2-MMD-QRK | ZR2-MMD-QRK-ASSM1
| ZR2-MMD-QRK-ASSM2
| ZR2-MMD-QRK-ASSM3
| ZR2-MMD-QRK-ASSM4
| ZR2-MMD-QRK-ASSM5
| ZR2-MMD-QRK-ASSM6
| ZR2-MMD-QRK-ASSM7
ZR2-MMD | ZR2-MMD-ASSM1
| ZR2-MMD-ASSM2
| ZR2-MMD-ASSM3
| ZR2-MMD-ASSM4
| ZR2-MMD-ASSM5
ZR2-PCK-TRA | ZR2-PCK-BOX-ASSM1
| ZR2-PCK-BOX-ASSM2
ZR2-WHL | ZR2-WHL-ASSM1
ZR2-TLE-POD | ZR2-TLE-POD-ASSM1
ZR2-CSC | ZR2-MMD-RPS-ASSM1

ZR2-MMD-HNG-PR1032

## External Finish SPI C2 – 400 Grit Internal Finish SPI C1/Non Expensive

# ZR2-MMD-RTP

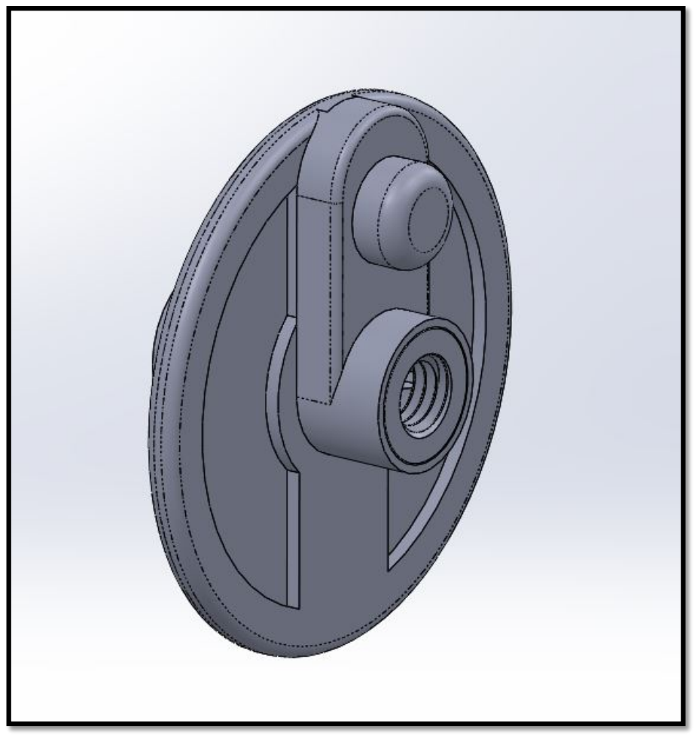
[picture p198: figure]

## Overall Finish: SPI C2 – 400 Grit

## Push Fit: ZR2-MMD-RTP-PR1032 into ZR2-MMD-RTP-BODY

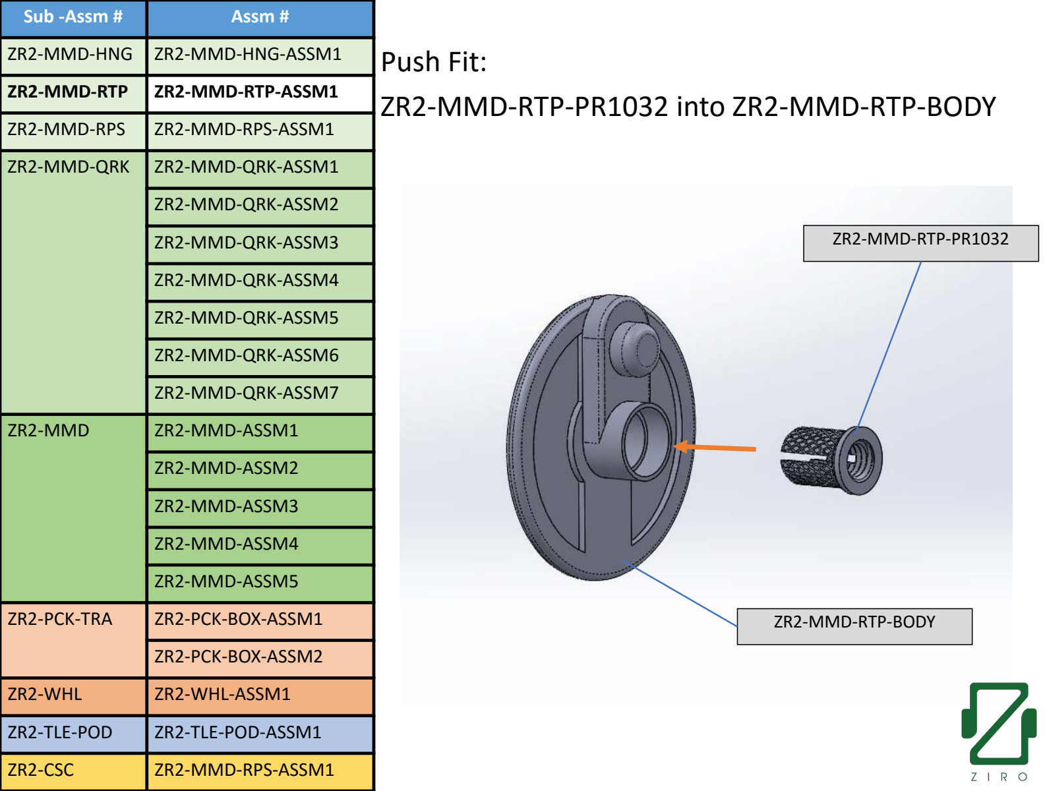
[picture p199: page 5]

ZR2-MMD-RTP-BODY

ZR2-MMD-HNG | ZR2-MMD-HNG-ASSM1
ZR2-MMD-RTP | ZR2-MMD-RTP-ASSM1
ZR2-MMD-RPS | ZR2-MMD-RPS-ASSM1
ZR2-MMD-QRK | ZR2-MMD-QRK-ASSM1
| ZR2-MMD-QRK-ASSM2
| ZR2-MMD-QRK-ASSM3
| ZR2-MMD-QRK-ASSM4
| ZR2-MMD-QRK-ASSM5
| ZR2-MMD-QRK-ASSM6
| ZR2-MMD-QRK-ASSM7
ZR2-MMD | ZR2-MMD-ASSM1
| ZR2-MMD-ASSM2
| ZR2-MMD-ASSM3
| ZR2-MMD-ASSM4
| ZR2-MMD-ASSM5
ZR2-PCK-TRA | ZR2-PCK-BOX-ASSM1
| ZR2-PCK-BOX-ASSM2
ZR2-WHL | ZR2-WHL-ASSM1
ZR2-TLE-POD | ZR2-TLE-POD-ASSM1

ZR2-MMD-RTP-PR1032

# ZR2-MMD-RPS

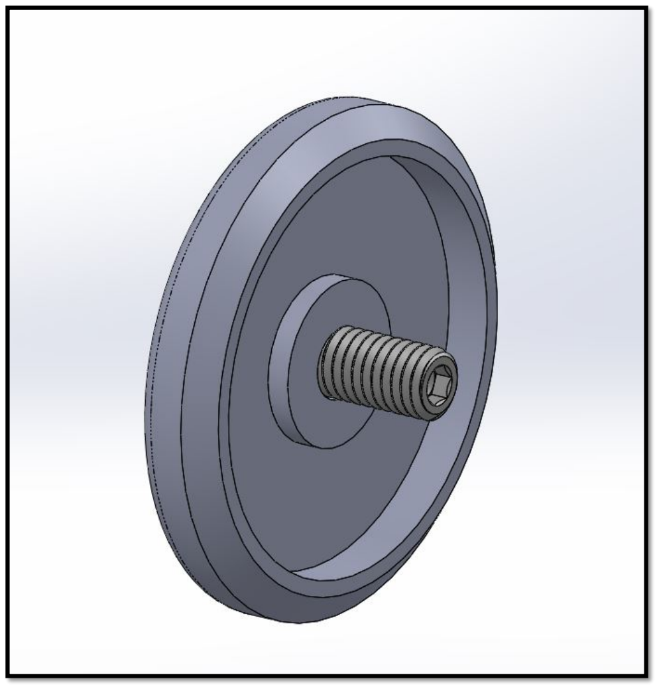
[picture p200: figure]

## Overall Finish: SPI C2 – 400 Grit

## Screw Fit: ZR2-MMD-RPS-F1032 into ZR2-MMD-RPS-BODY

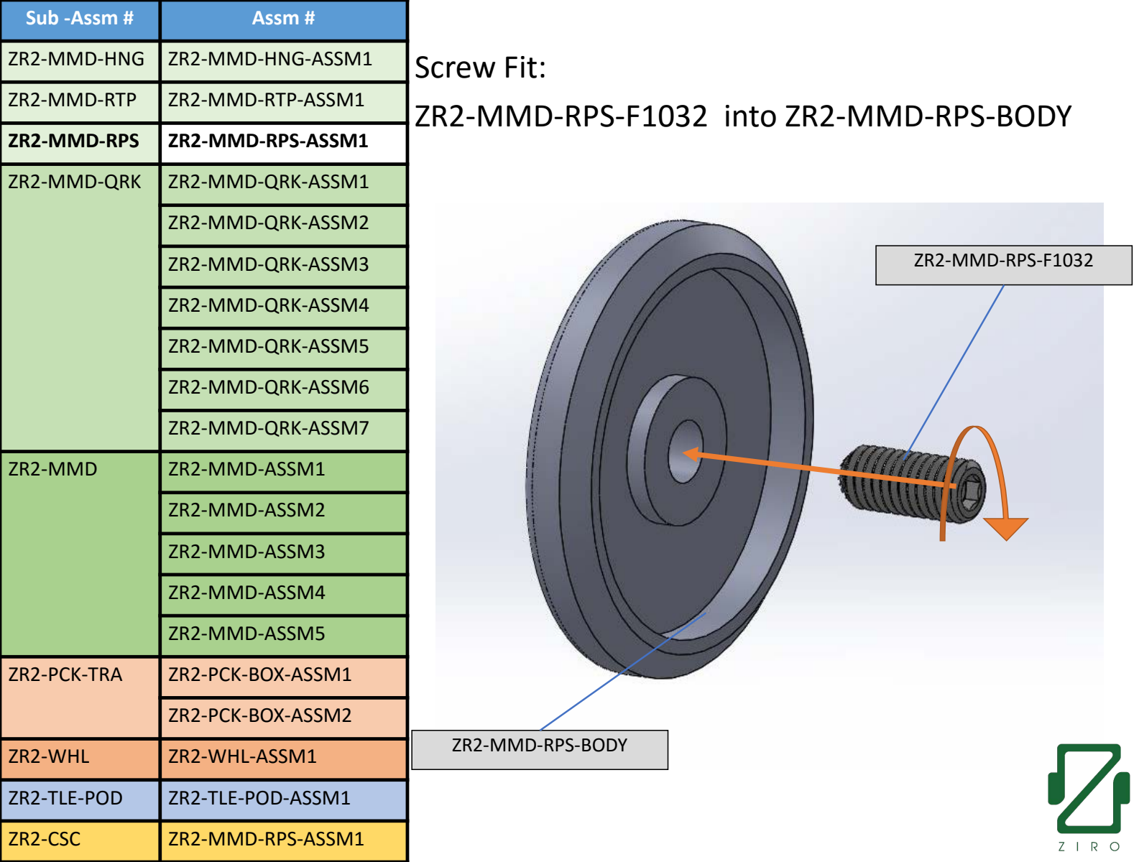
[picture p201: page 7]

ZR2-MMD-RPS-BODY

ZR2-MMD-RTP | ZR2-MMD-RTP-ASSM1
ZR2-MMD-RPS | ZR2-MMD-RPS-ASSM1
ZR2-MMD-QRK | ZR2-MMD-QRK-ASSM1
| ZR2-MMD-QRK-ASSM2
| ZR2-MMD-QRK-ASSM3
| ZR2-MMD-QRK-ASSM4
| ZR2-MMD-QRK-ASSM5
| ZR2-MMD-QRK-ASSM6
| ZR2-MMD-QRK-ASSM7
ZR2-MMD | ZR2-MMD-ASSM1
| ZR2-MMD-ASSM2
| ZR2-MMD-ASSM3
| ZR2-MMD-ASSM4
| ZR2-MMD-ASSM5
ZR2-PCK-TRA | ZR2-PCK-BOX-ASSM1
| ZR2-PCK-BOX-ASSM2
ZR2-WHL | ZR2-WHL-ASSM1
ZR2-TLE-POD | ZR2-TLE-POD-ASSM1

ZR2-MMD-RPS-F1032

# ZR2-MMD-QRK

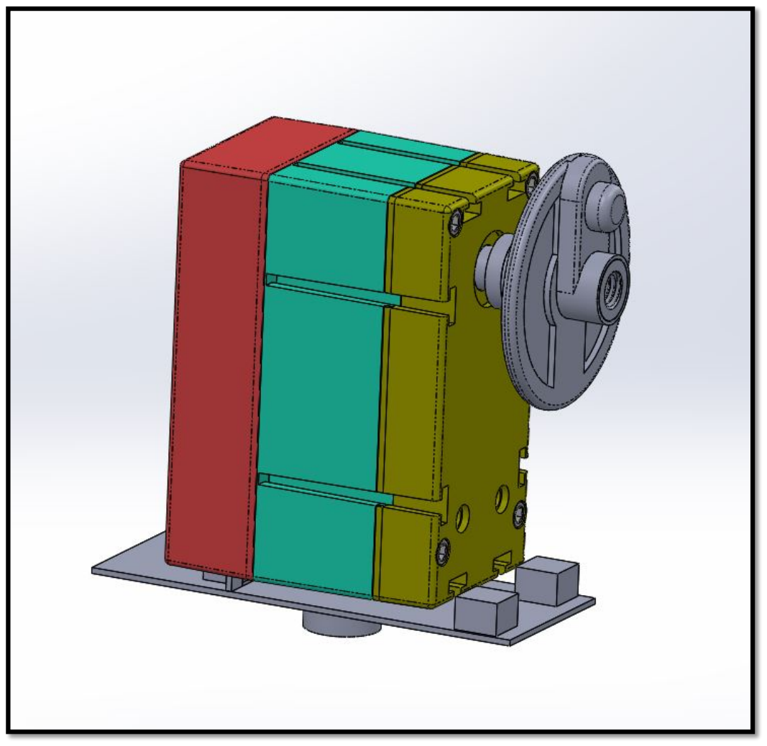
[picture p202: figure]

## Overall Finish: SPI C3 OR LOWER FOR CASINGS

## Insert: Slide Motor and PCB assembly into Quark housing

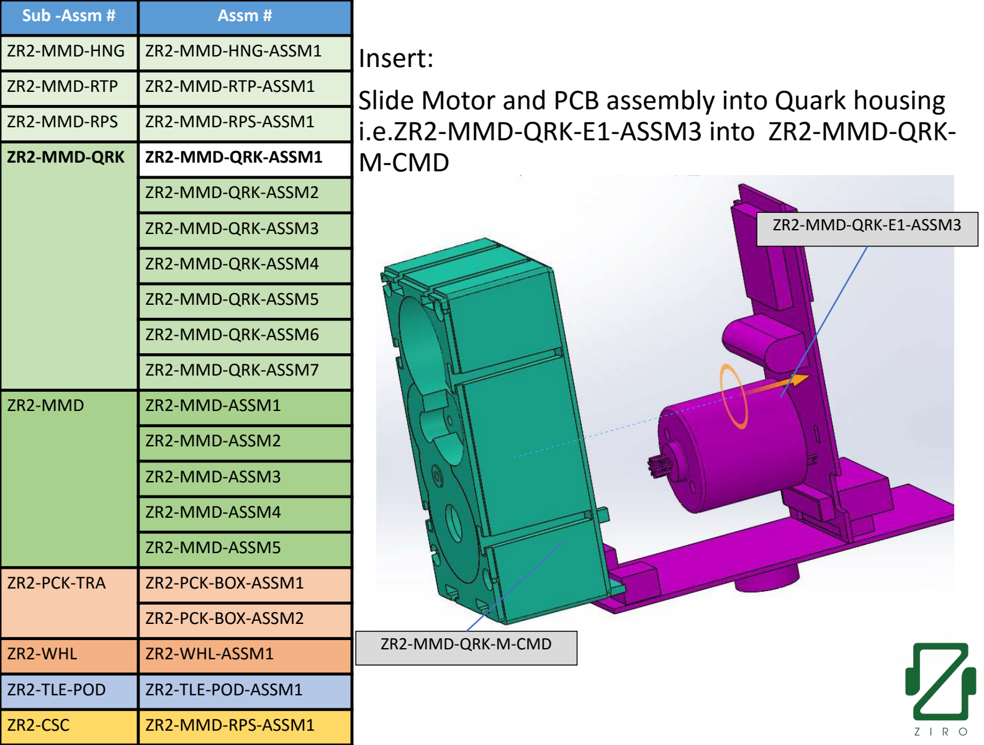
[picture p203: page 9]

## i.e.ZR2-MMD-QRK-E1-ASSM3 into ZR2-MMD-QRK-M-CMD

ZR2-MMD-QRK-M-CMD

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

ZR2-MMD-QRK-E1-ASSM3

## Insert:

Put 3 shafts ZR2-MMD-QRK-M-(SFT150-725-G2,

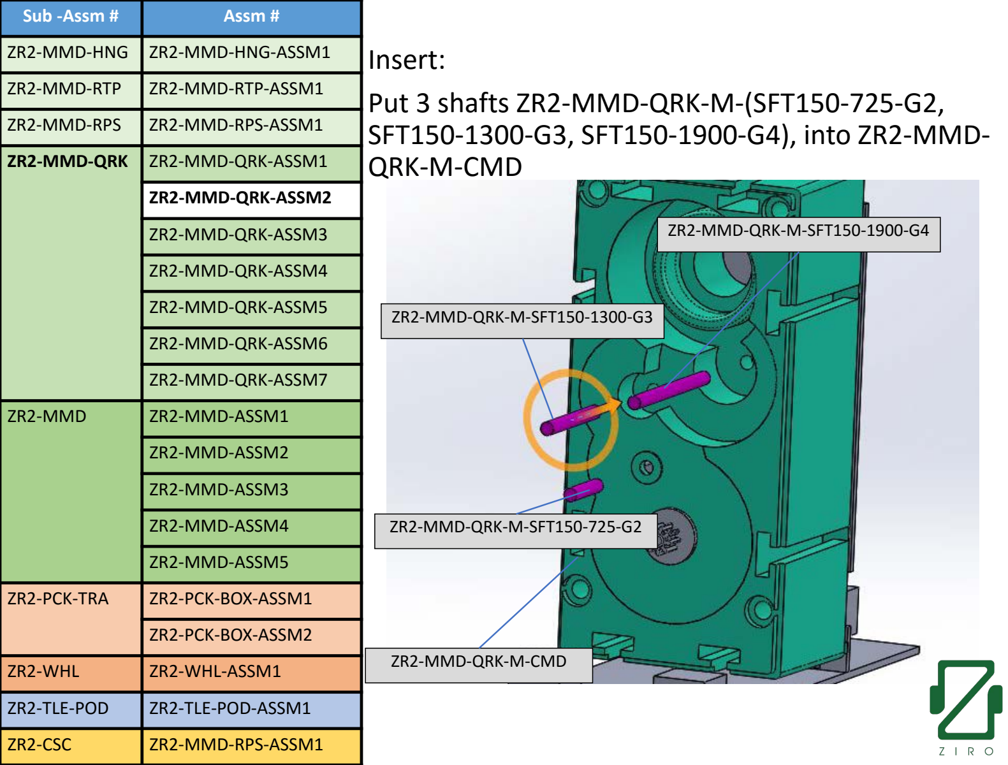
[picture p204: page 10]

## SFT150-1300-G3, SFT150-1900-G4), into ZR2-MMD-QRK-M-CMD

ZR2-MMD-QRK-M-CMD

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

ZR2-MMD-QRK-M-SFT150-725-G2

ZR2-MMD-QRK-M-SFT150-1300-G3

ZR2-MMD-QRK-M-SFT150-1900-G4

## Insert: Five Plastic Gears ZR2-MMD-QRK-M-(GPC,G5,G4,G3,G2) onto above placed shafts. Order:

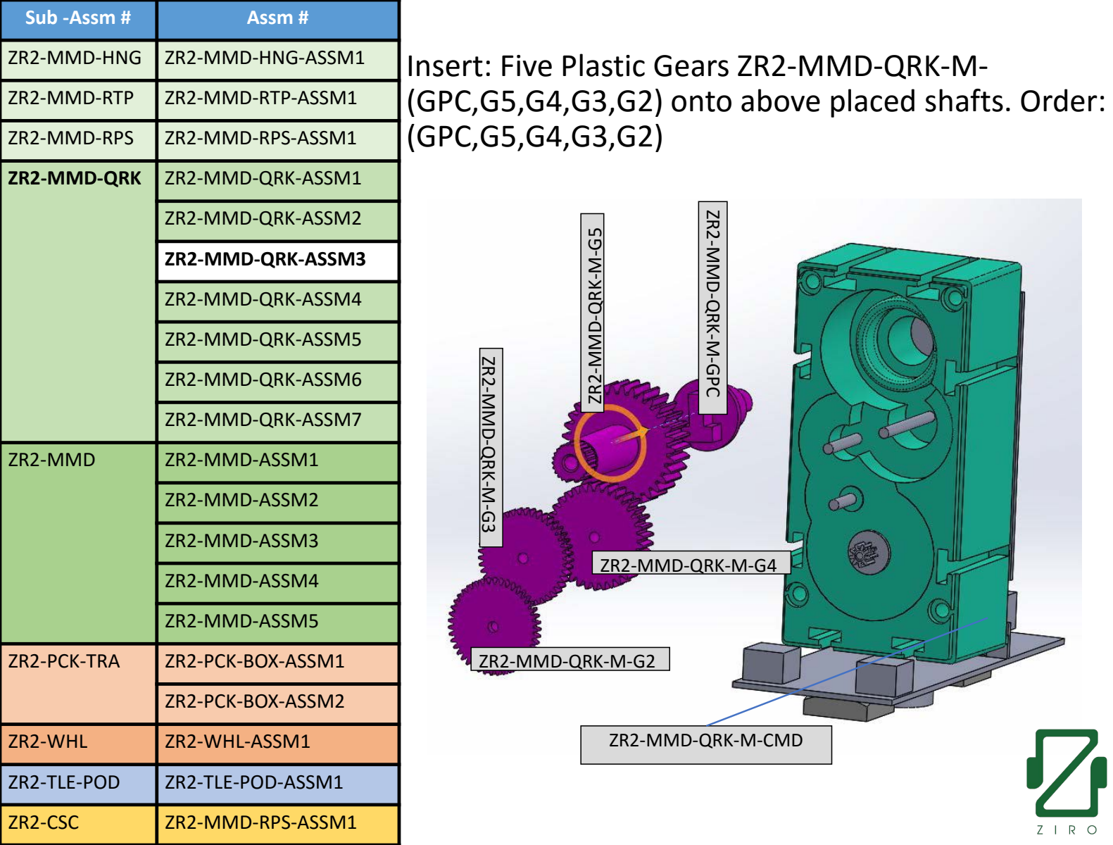
[picture p205: page 11]

## (GPC,G5,G4,G3,G2)

ZR2-MMD-QRK-M-CMD

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

ZR2-MMD-QRK-M-G2 ZR2-MMD-QRK-M-G3

ZR2-MMD-QRK-M-G4 ZR2⁻MMD⁻QRK⁻M⁻G⁵ | ZR2-MMD-QRK-M-GPC

## Cover: Put the lid ZR2-MMD-QRK-M-CTP

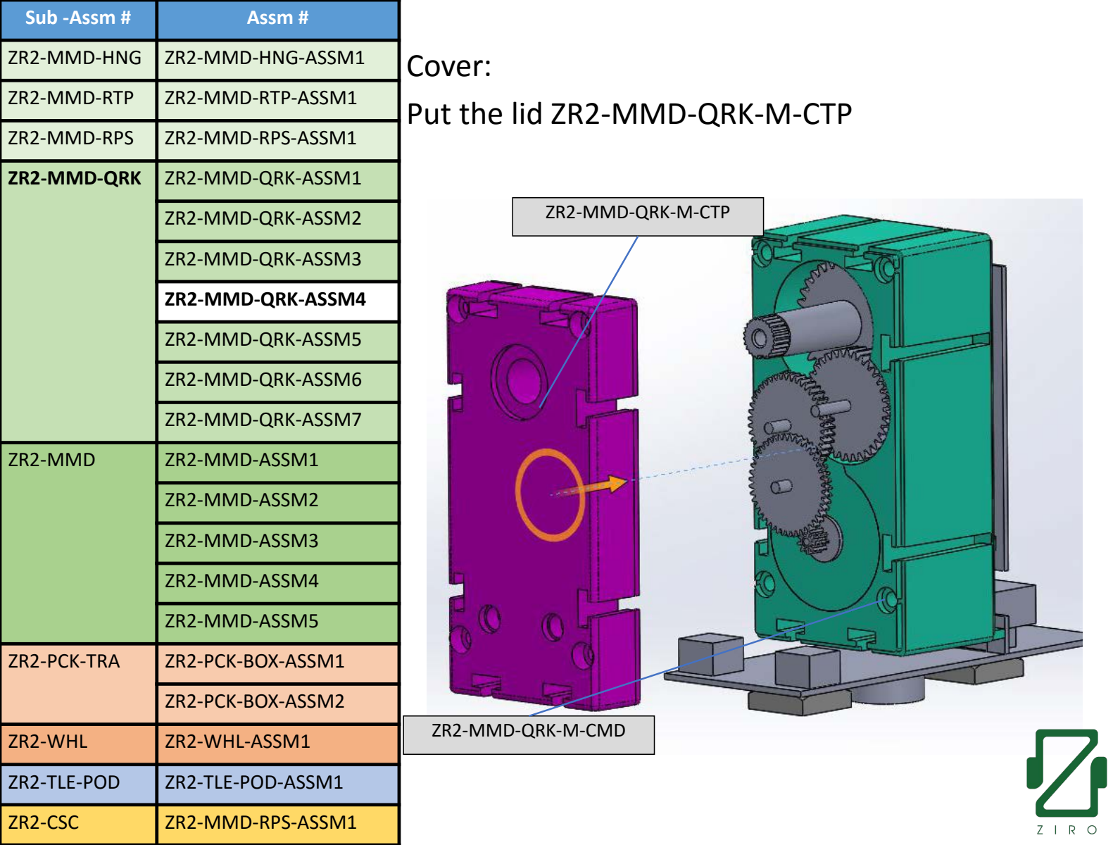
[picture p206: page 12]

ZR2-MMD-QRK-M-CMD

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

ZR2-MMD-QRK-M-CTP

## Cover: Put the lid ZR2-MMD-QRK-M-CBM

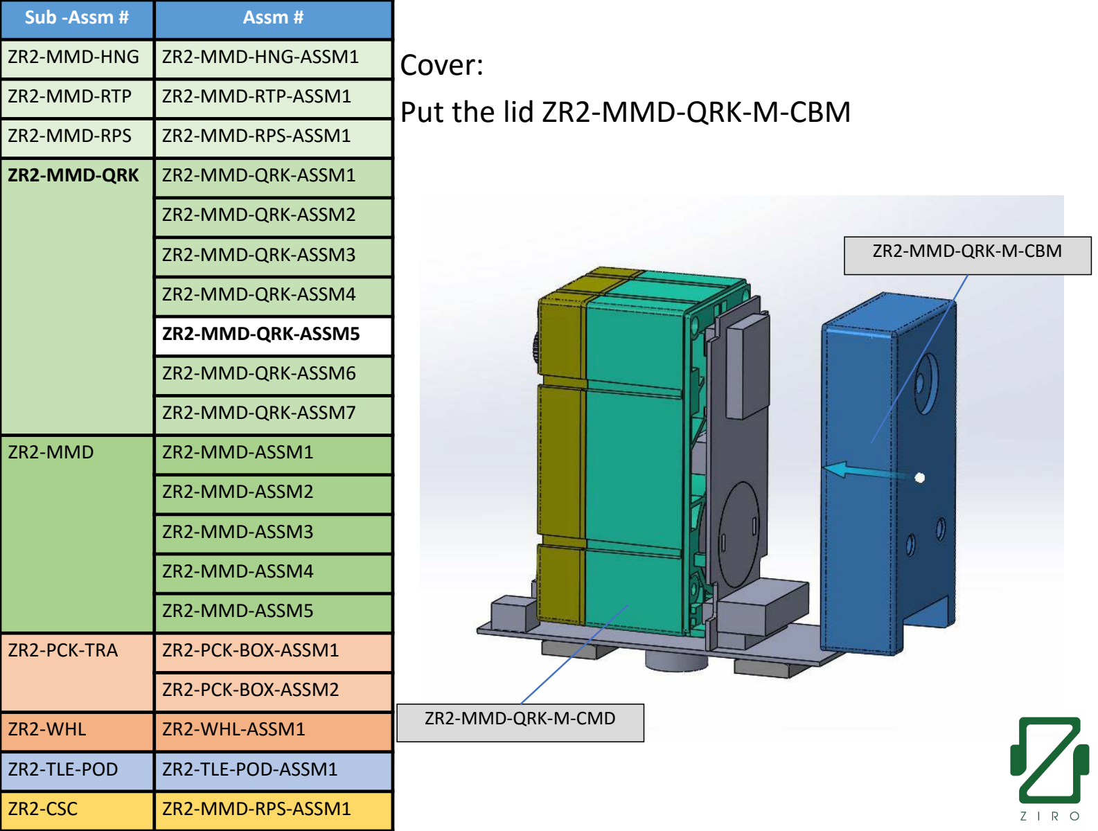
[picture p207: page 13]

ZR2-MMD-QRK-M-CMD

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

ZR2-MMD-QRK-M-CBM

## Screw: Screw 4 ZR2-MMD-QRK-M-SCR-18-8 into top lid

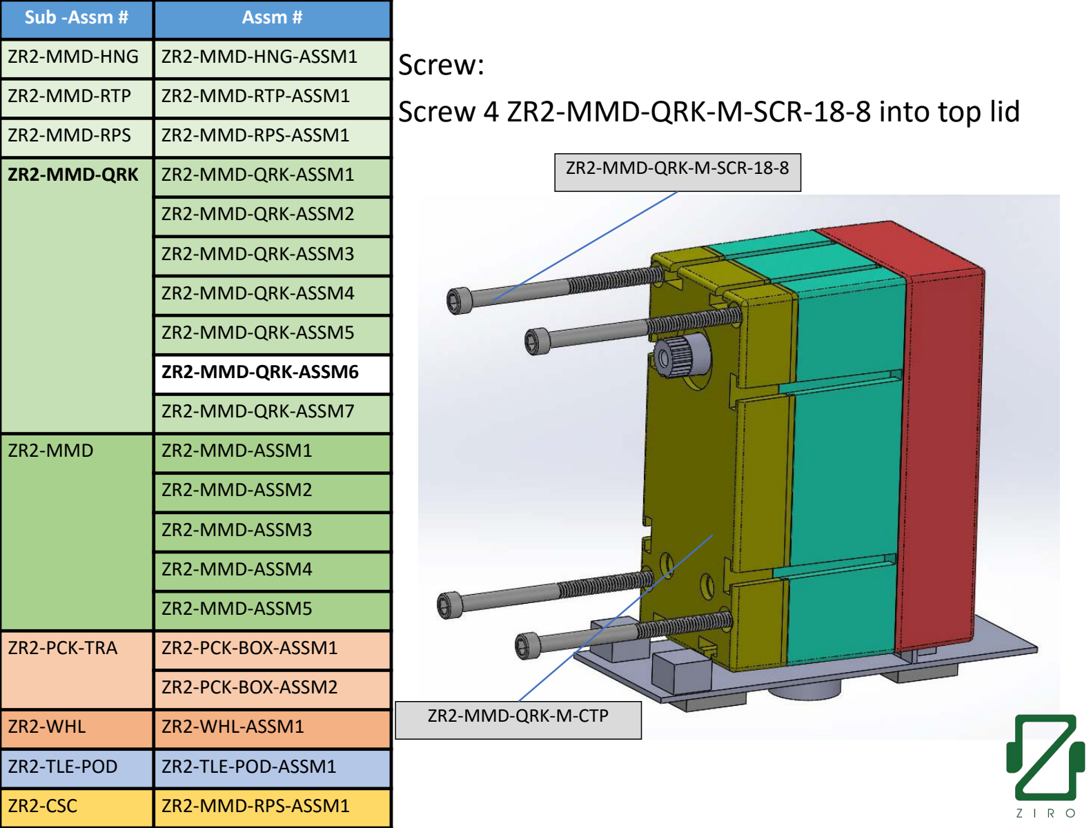
[picture p208: page 14]

ZR2-MMD-QRK-M-CTP

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

ZR2-MMD-QRK-M-SCR-18-8

## Insert: Align the spline and insert ZR2-MMD-RTP-ASSM1 over ZR2-MMD-QRK-M-G5 and screw using

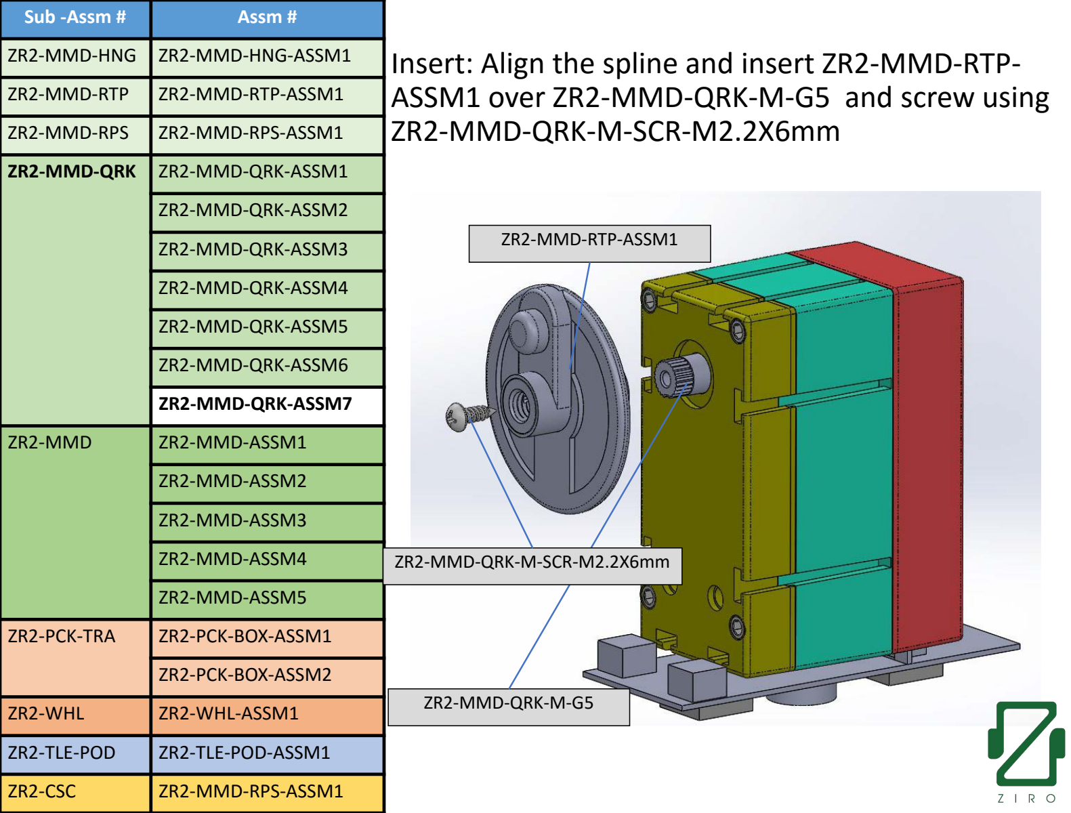
[picture p209: page 15]

## ZR2-MMD-QRK-M-SCR-M2.2X6mm

ZR2-MMD-QRK-M-G5

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

ZR2-MMD-RTP-ASSM1

ZR2-MMD-QRK-M-SCR-M2.2X6mm

# ZR2-MMD

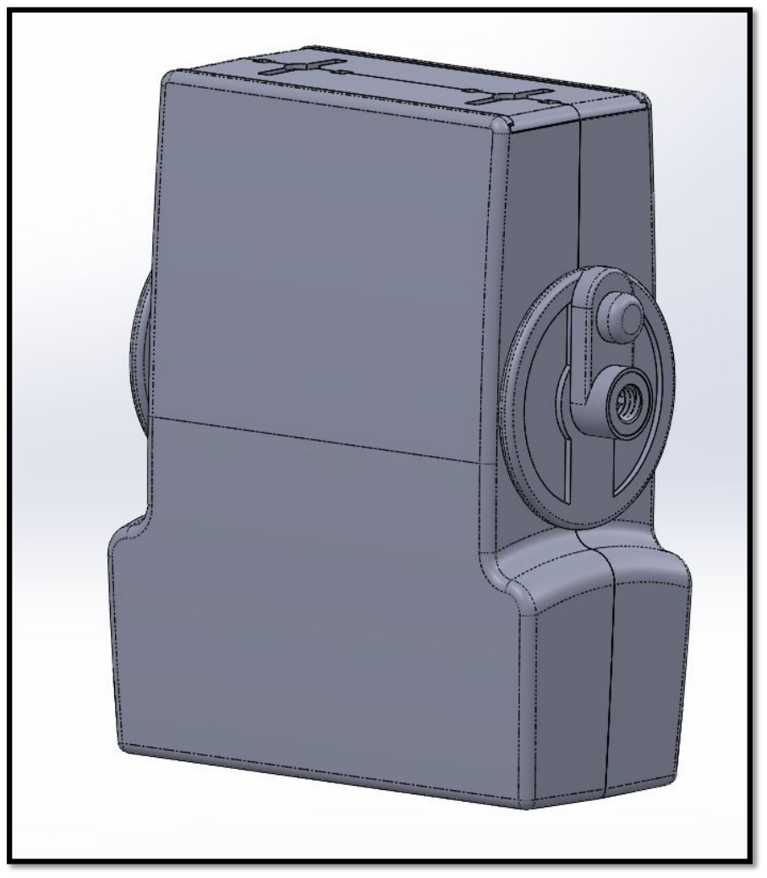
[picture p210: figure]

## External Finish SPI C2 – 400 Grit Internal Finish SPI C1/Non Expensive

## Insert : Insert ZR2-MMD-SHL-KNSHFT to the holes of the

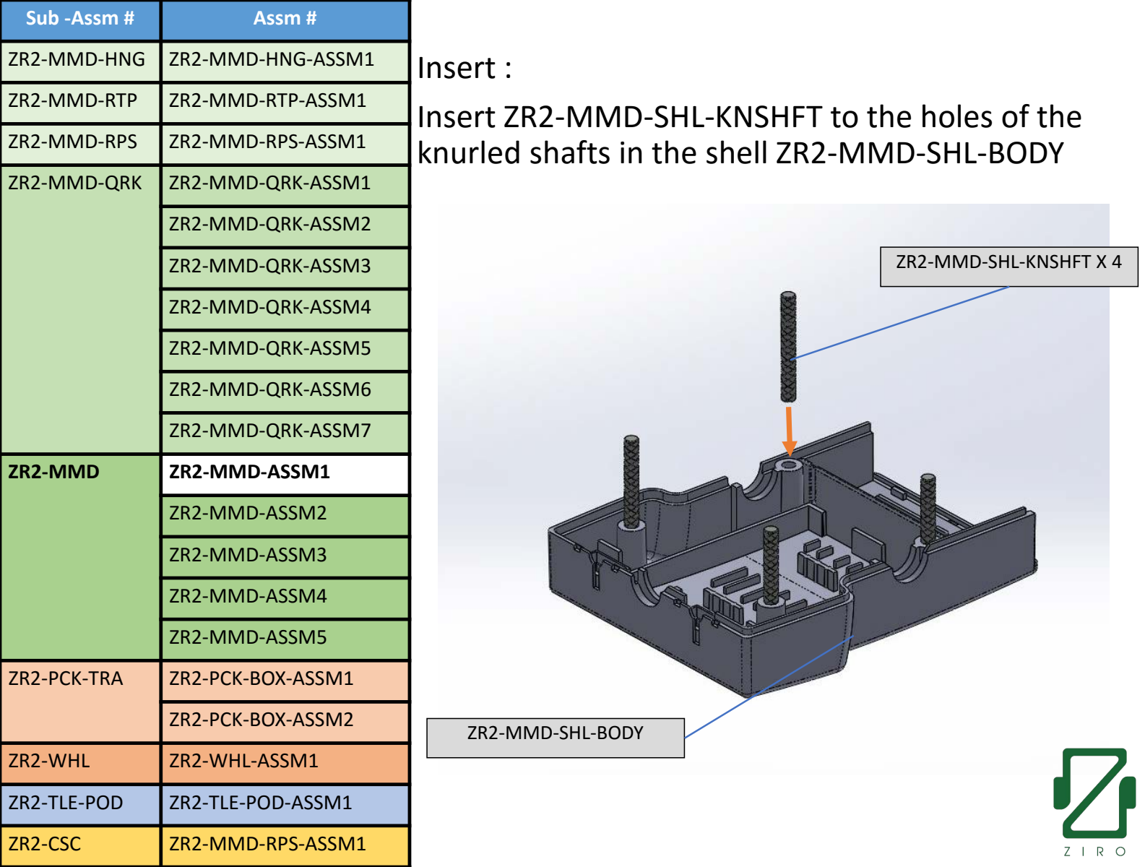
[picture p211: page 17]

## knurled shafts in the shell ZR2-MMD-SHL-BODY

ZR2-MMD-SHL-BODY

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

ZR2-MMD-SHL-KNSHFT X 4

## Insert: ZR2-MMD-RTP-ASSM1 in ZR2-MMD-ASSM1 on the

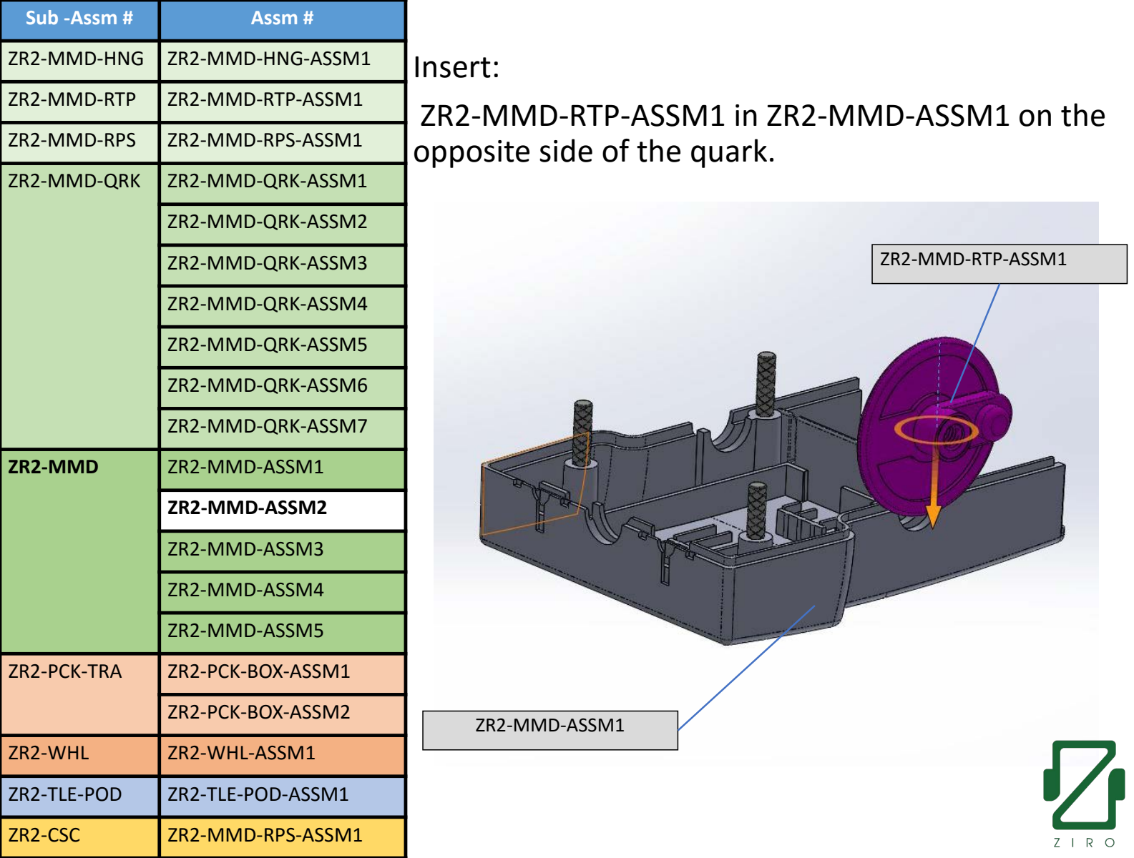
[picture p212: page 18]

opposite side of the quark.

ZR2-MMD-ASSM1

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

ZR2-MMD-RTP-ASSM1

## Insert: Insert Quark with PCB (finished in the process

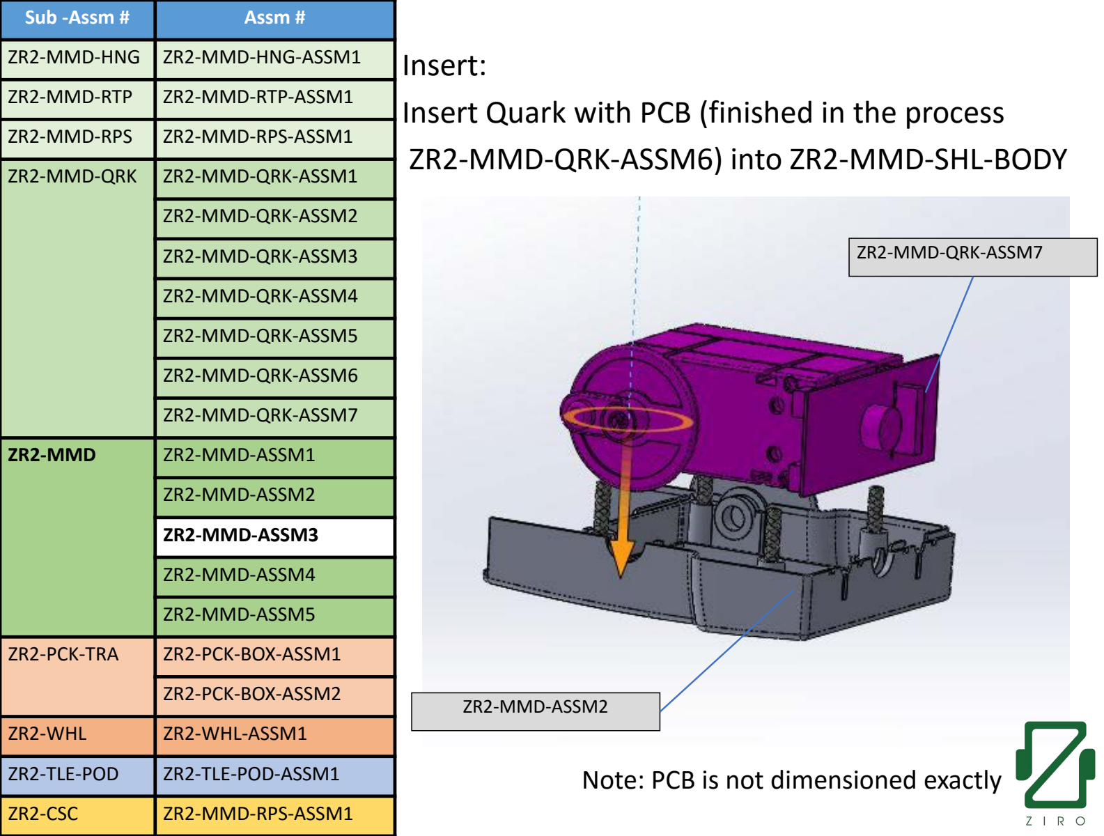
[picture p213: page 19]

## ZR2-MMD-QRK-ASSM6) into ZR2-MMD-SHL-BODY

ZR2-MMD-ASSM2

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

ZR2-MMD-QRK-ASSM7

## Note: PCB is not dimensioned exactly

## Insert: Square Nuts ZR2-MMD-SHL-SQN into the

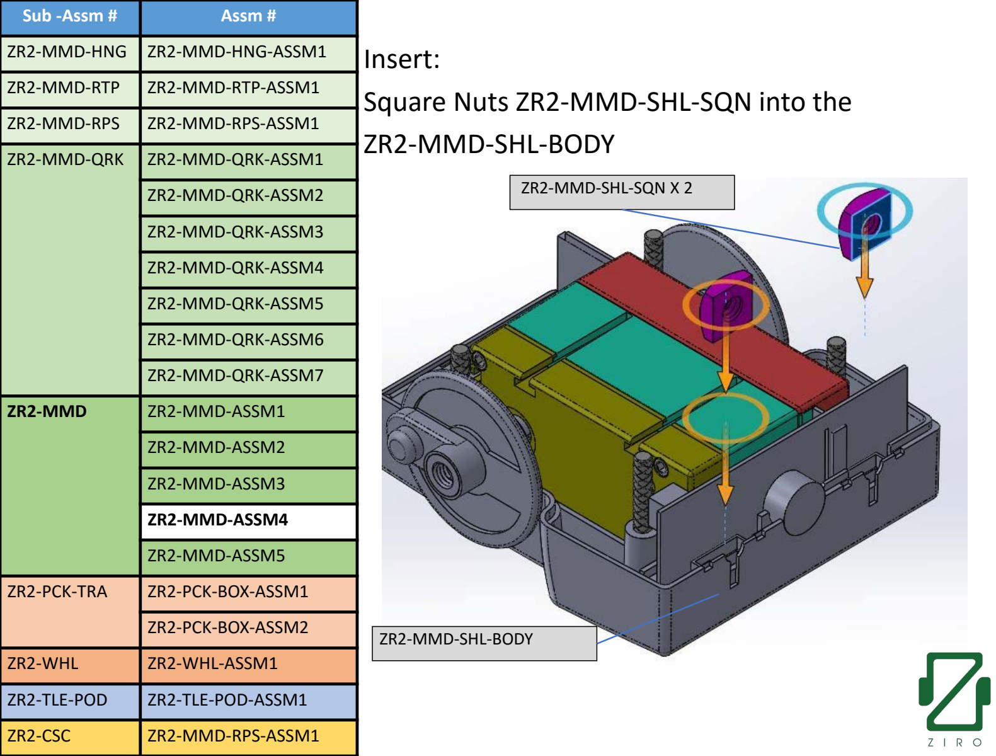
[picture p214: page 20]

## ZR2-MMD-SHL-BODY

ZR2-MMD-SHL-BODY

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

ZR2-MMD-SHL-SQN X 2

## Push Fit: Push shell (ZR2-MMD-SHL-BODY) onto above

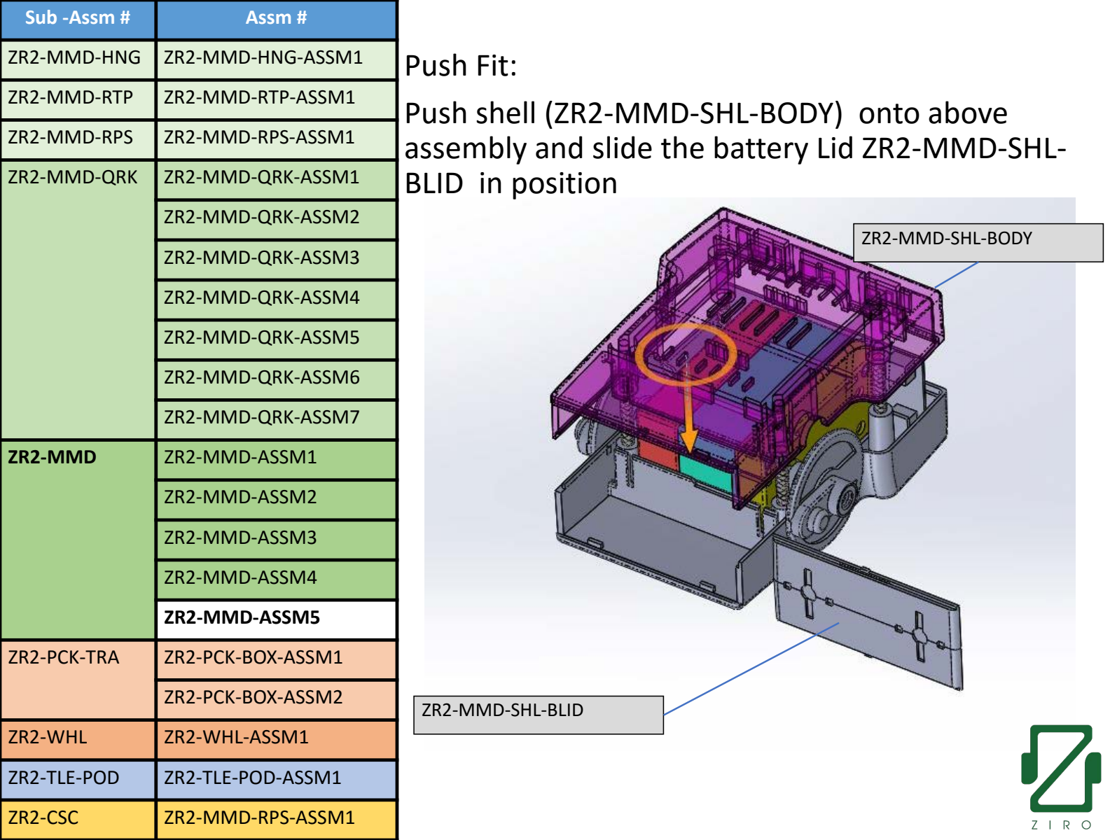
[picture p215: page 21]

## assembly and slide the battery Lid ZR2-MMD-SHL-BLID in position

ZR2-MMD-SHL-BLID

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

ZR2-MMD-SHL-BODY

## Fold

Fold cardboard into final shape i.e.

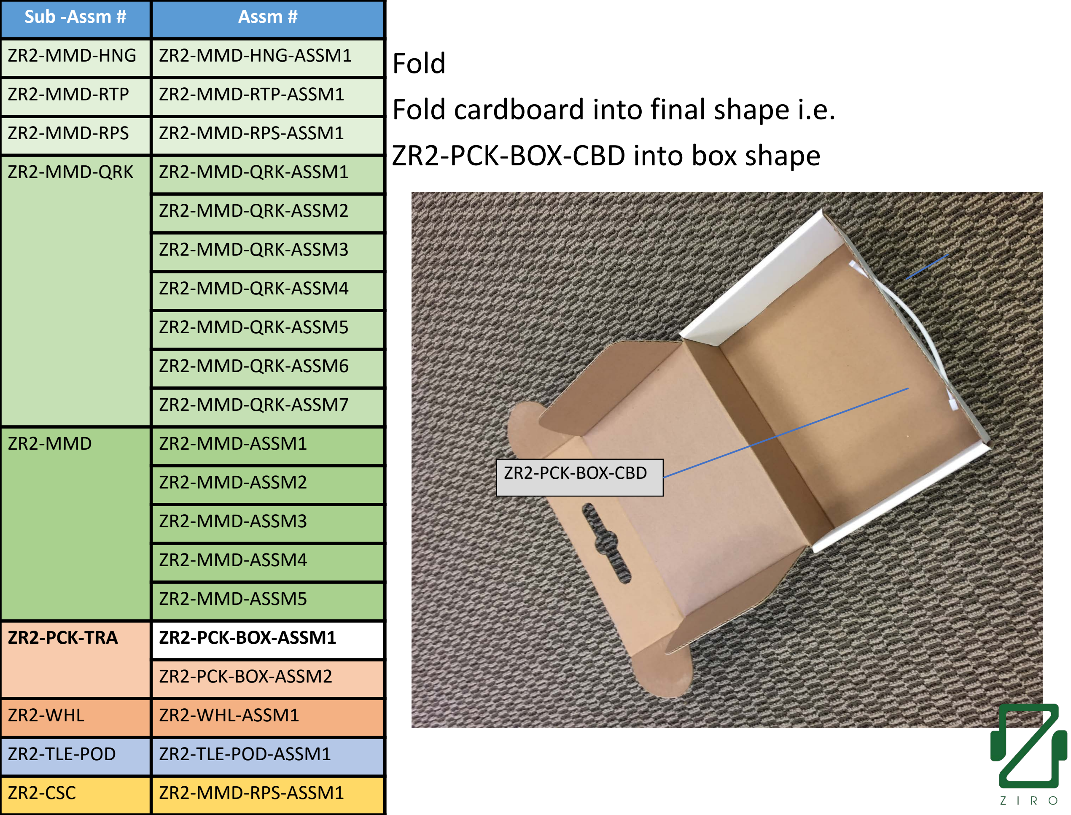
[picture p216: page 22]

## ZR2-PCK-BOX-CBD into box shape

ZR2-PCK-BOX-CBD

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

## Place Place Foam into box:

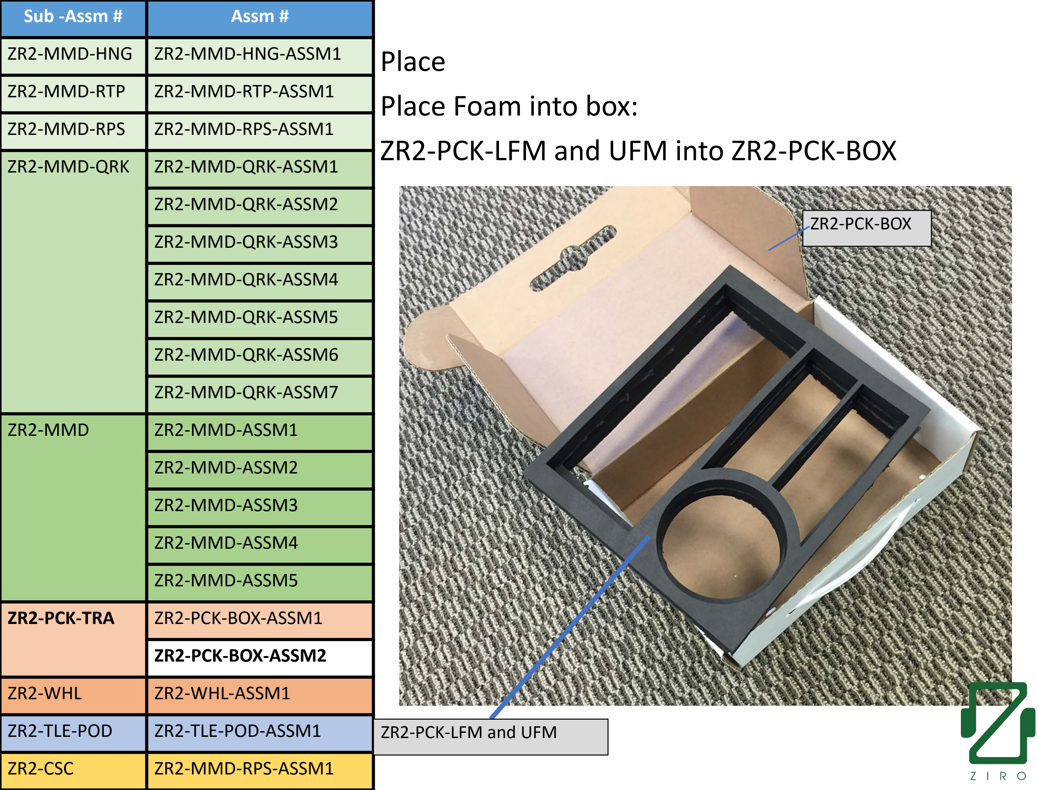
[picture p217: page 23]

## ZR2-PCK-LFM and UFM into ZR2-PCK-BOX

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

ZR2-PCK-BOX

ZR2-PCK-LFM and UFM

# ZR2-WHL

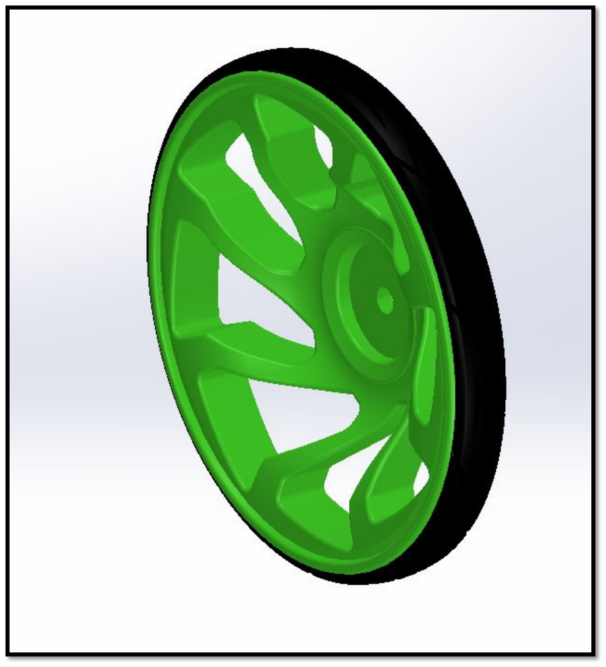
[picture p218: figure]

## Overall Finish: SPI C1

## Insert

Put tire over wheel rim i.e.

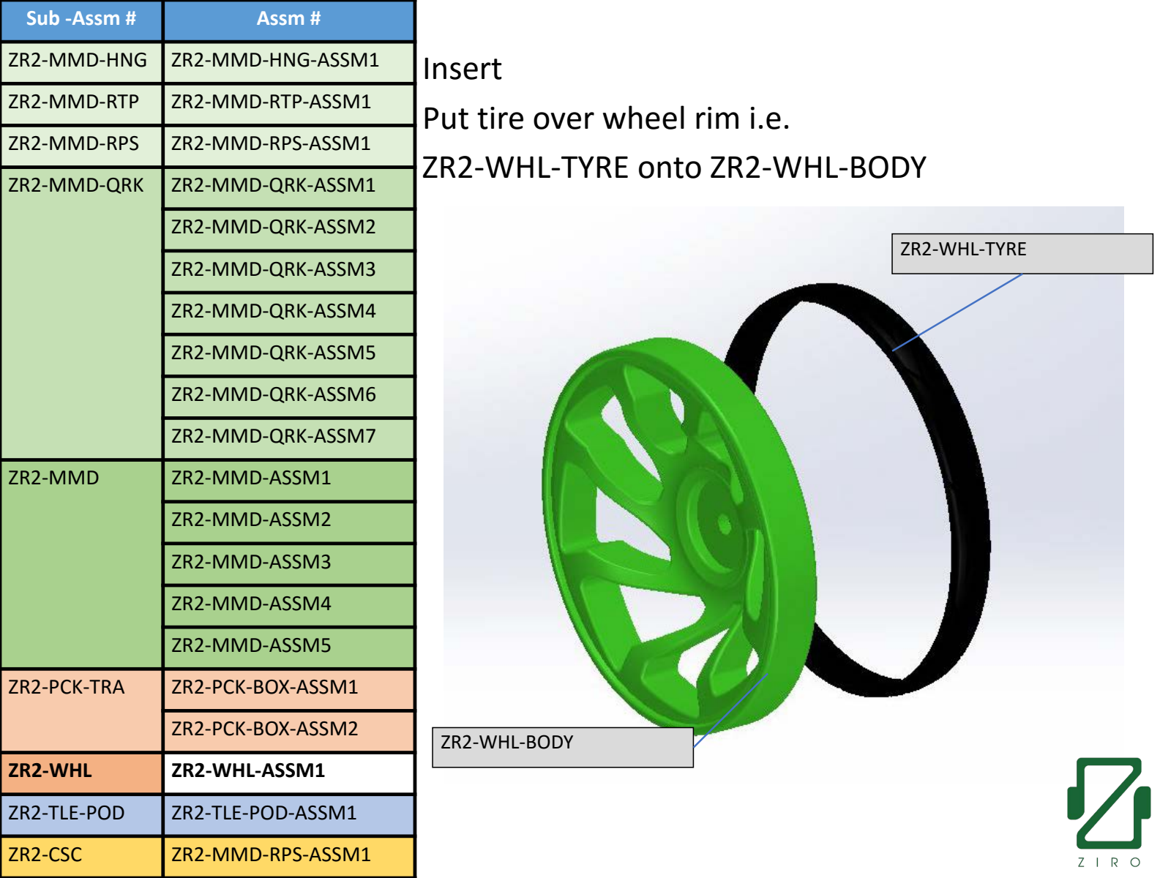
[picture p219: page 25]

## ZR2-WHL-TYRE onto ZR2-WHL-BODY

ZR2-WHL-BODY

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

ZR2-WHL-TYRE

# ZR2-TLE-POD

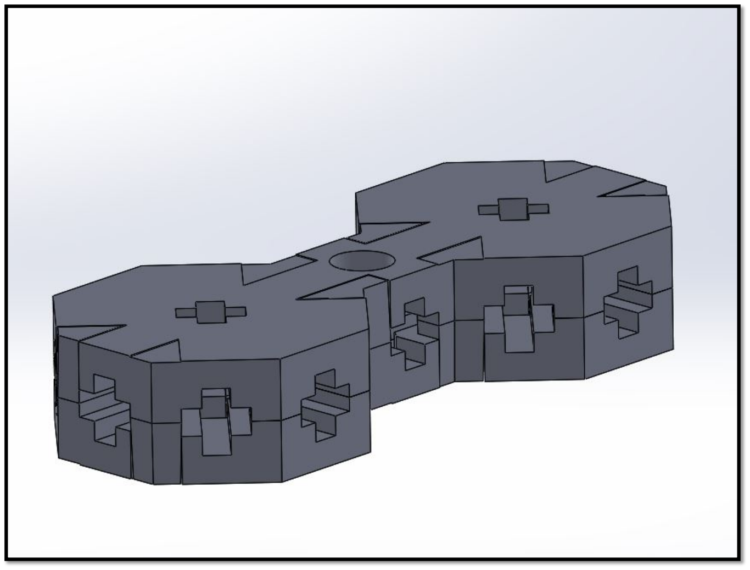
[picture p220: figure]

## Overall Finish: SPI C2 – 400 Grit

## Snap On: Snap two ZR2-TLE-POD-BODY together

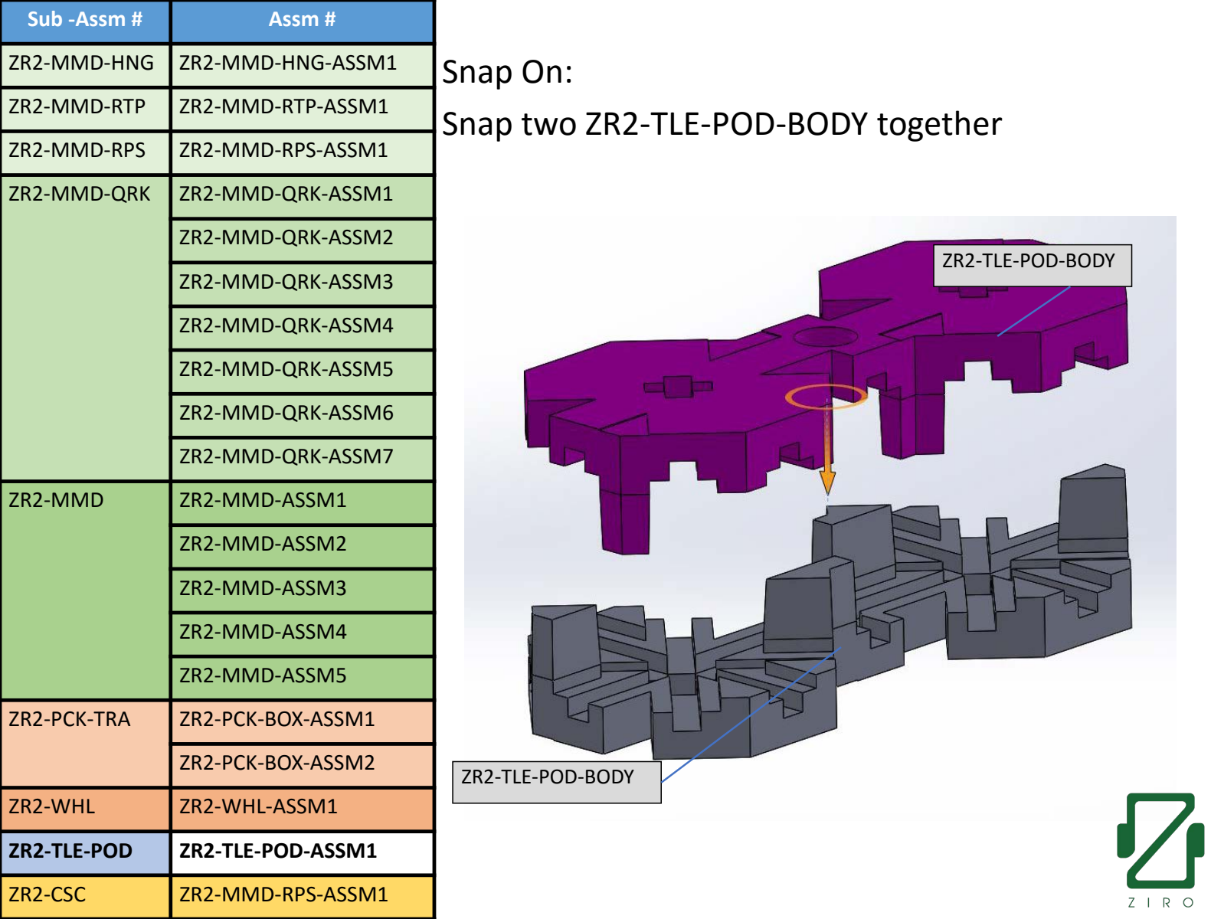
[picture p221: page 27]

ZR2-TLE-POD-BODY

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

ZR2-TLE-POD-BODY

# ZR2-CSC

## Overall Finish: SPI C2 – 400 Grit

## ZR2-CSC-F1032 into ZR2-CSC-BODY

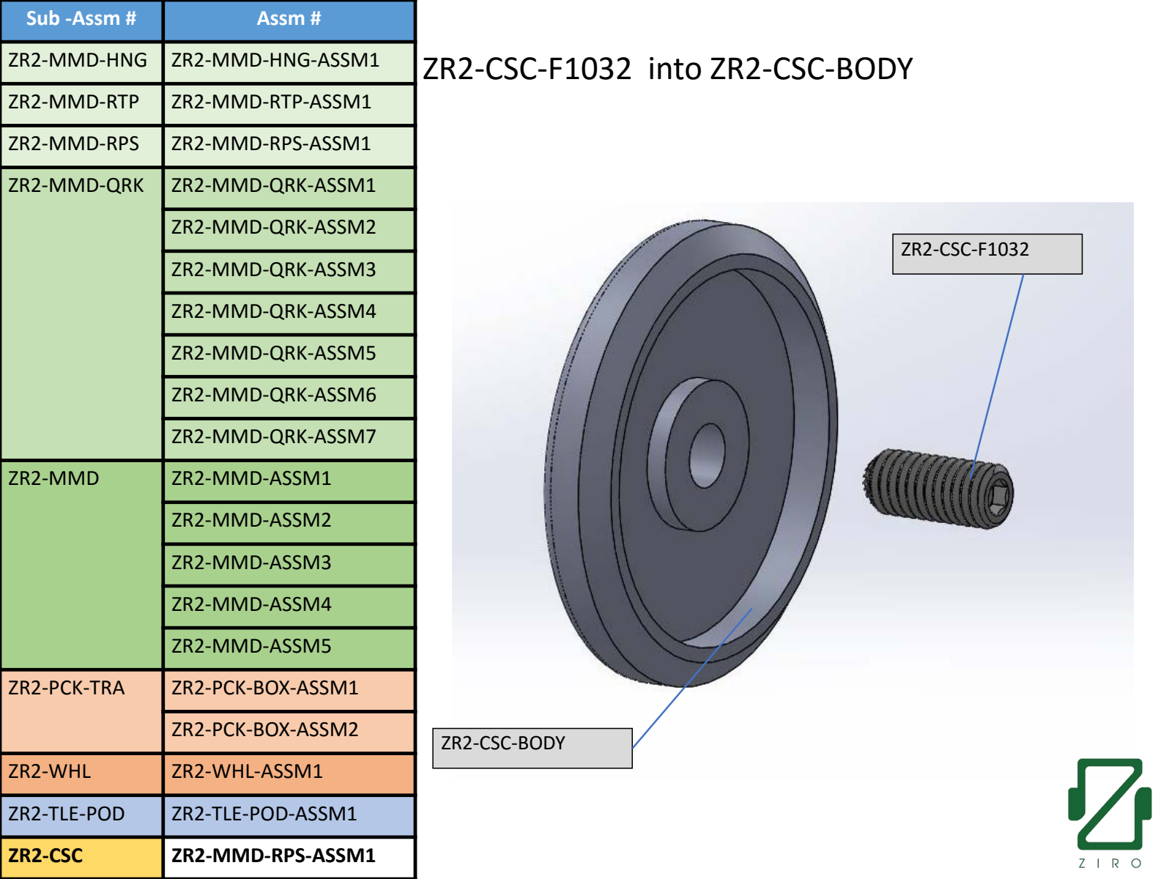
[picture p222: page 29]

ZR2-CSC-BODY

ZR2-MMD-RTP | ZR2-MMD-RTP-ASSM1
ZR2-MMD-RPS | ZR2-MMD-RPS-ASSM1
ZR2-MMD-QRK | ZR2-MMD-QRK-ASSM1
| ZR2-MMD-QRK-ASSM2
| ZR2-MMD-QRK-ASSM3
| ZR2-MMD-QRK-ASSM4
| ZR2-MMD-QRK-ASSM5
| ZR2-MMD-QRK-ASSM6
| ZR2-MMD-QRK-ASSM7
ZR2-MMD | ZR2-MMD-ASSM1
| ZR2-MMD-ASSM2
| ZR2-MMD-ASSM3
| ZR2-MMD-ASSM4
| ZR2-MMD-ASSM5
ZR2-PCK-TRA | ZR2-PCK-BOX-ASSM1
| ZR2-PCK-BOX-ASSM2
ZR2-WHL | ZR2-WHL-ASSM1
ZR2-TLE-POD | ZR2-TLE-POD-ASSM1
ZR2-CSC | ZR2-MMD-RPS-ASSM1

ZR2-CSC-F1032

# ZR2-PCK-TRA

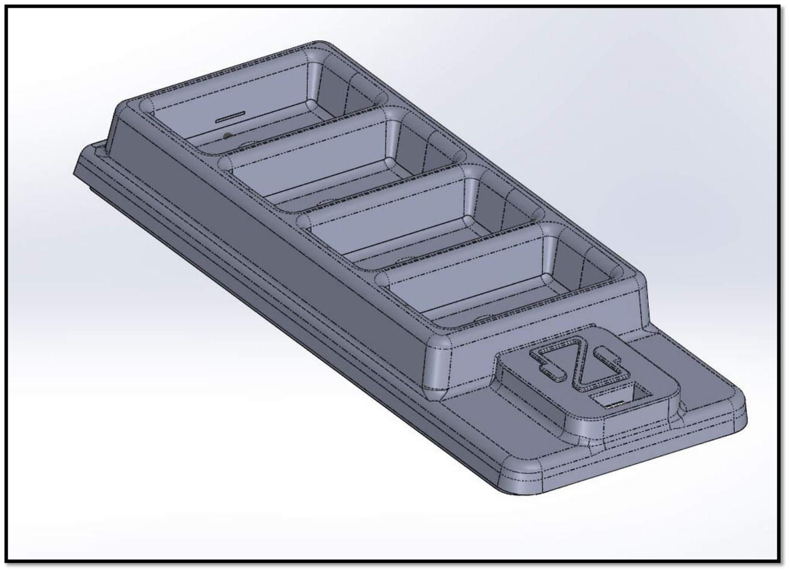
[picture p223: figure]

## Overall Finish: Based On Polystyrene

## Insert

Insert Tray 1 onto previous assembly i.e.

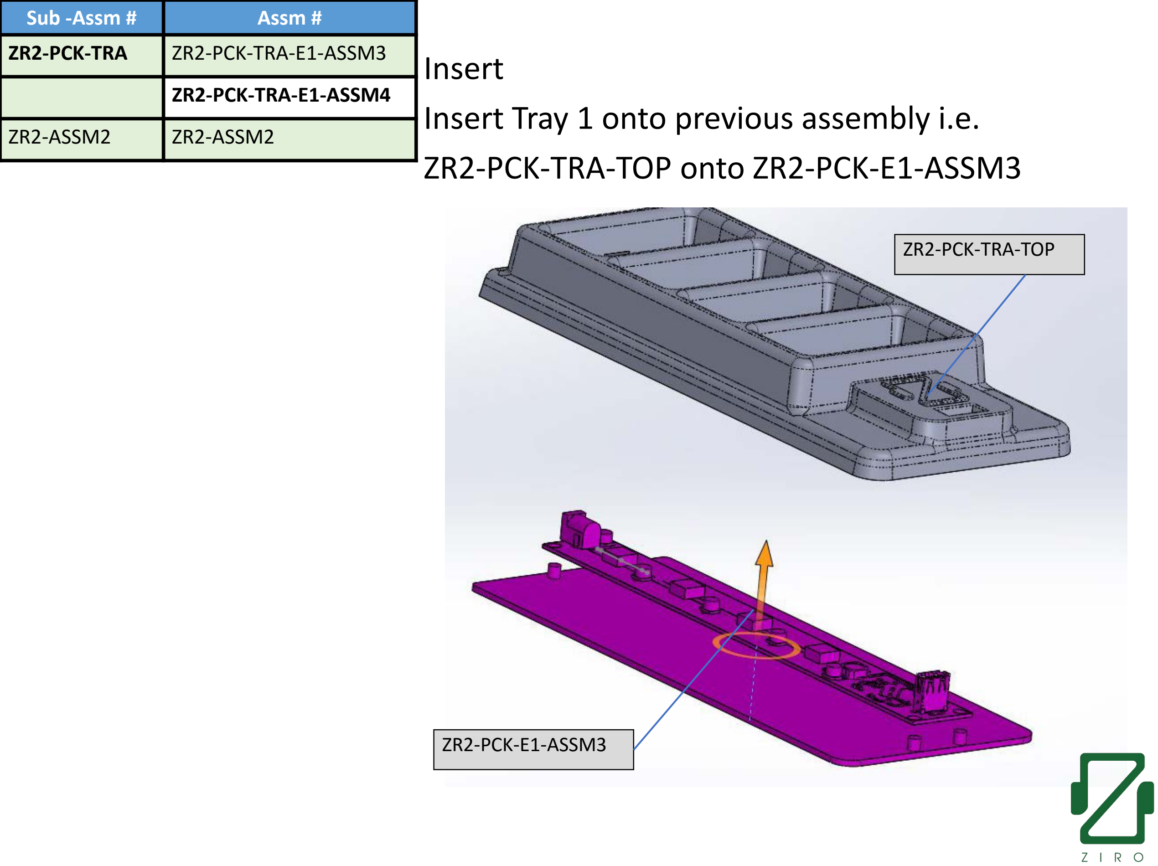
[picture p224: page 31]

## ZR2-PCK-TRA-TOP onto ZR2-PCK-E1-ASSM3

ZR2-PCK-E1-ASSM3

ZR2-PCK-TRA | ZR2-PCK-TRA-E1-ASSM3
| ZR2-PCK-TRA-E1-ASSM4
ZR2-ASSM2 | ZR2-ASSM2

ZR2-PCK-TRA-TOP

## Insert

Put PCB into bottom tray i.e.

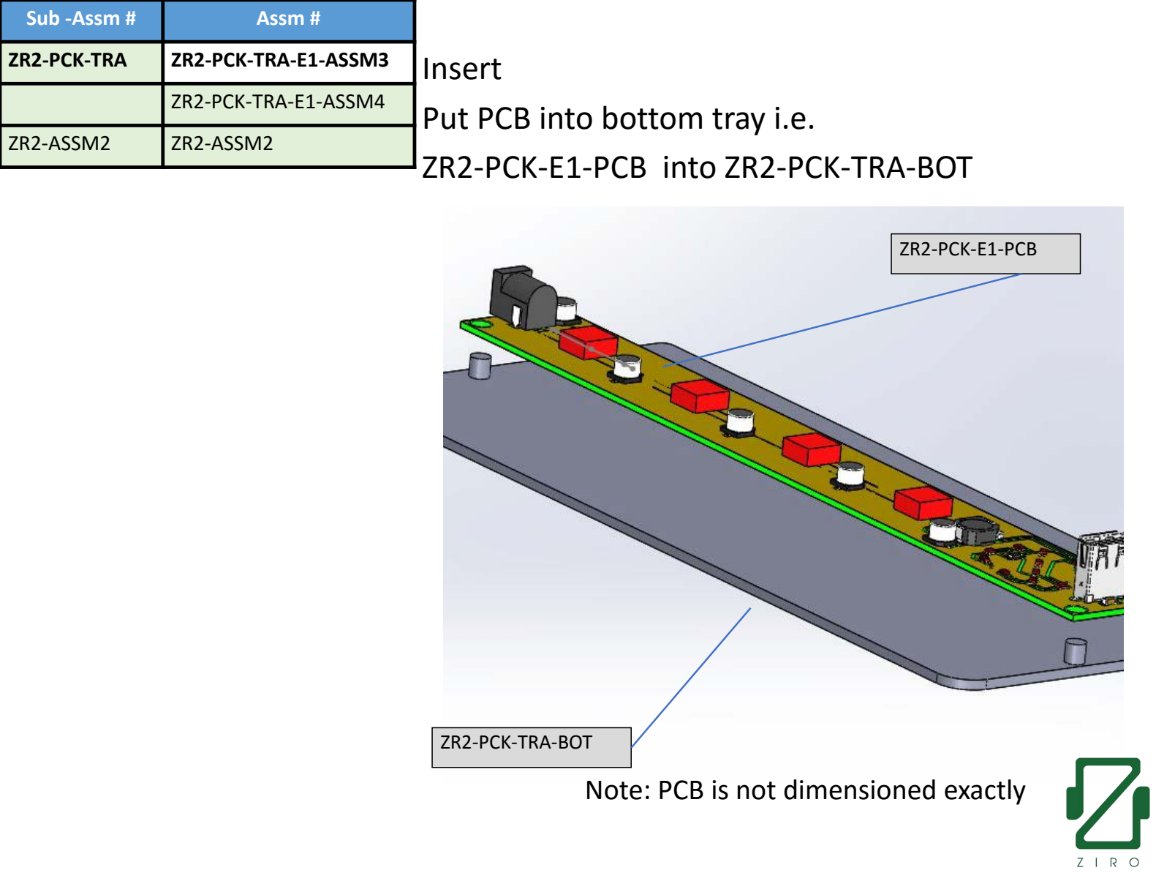
[picture p225: page 32]

## ZR2-PCK-E1-PCB into ZR2-PCK-TRA-BOT

ZR2-PCK-TRA-BOT

ZR2-PCK-TRA | ZR2-PCK-TRA-E1-ASSM3
| ZR2-PCK-TRA-E1-ASSM4
ZR2-ASSM2 | ZR2-ASSM2

ZR2-PCK-E1-PCB

## Note: PCB is not dimensioned exactly

# ZR2-ASSM2

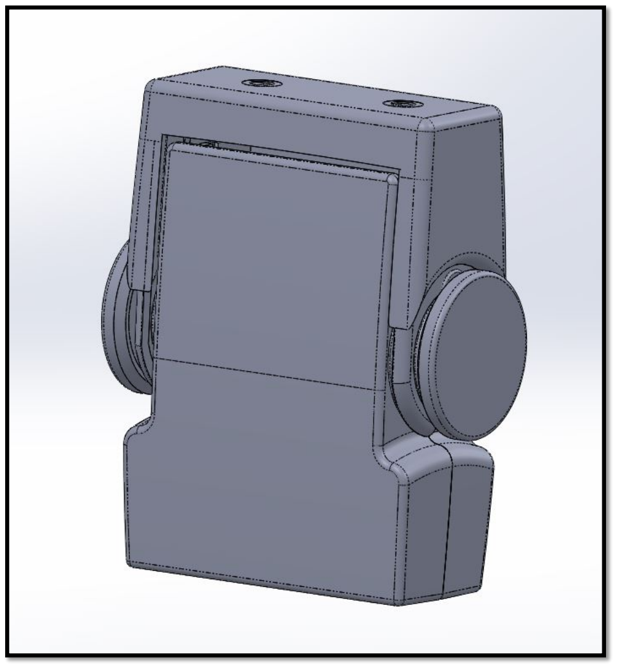
[picture p226: figure]

## Slide ZR2-MMD-HNG-ASSM1 to position as shown and screw 2 ZR2-MMD-RPS-ASSM1 to Module

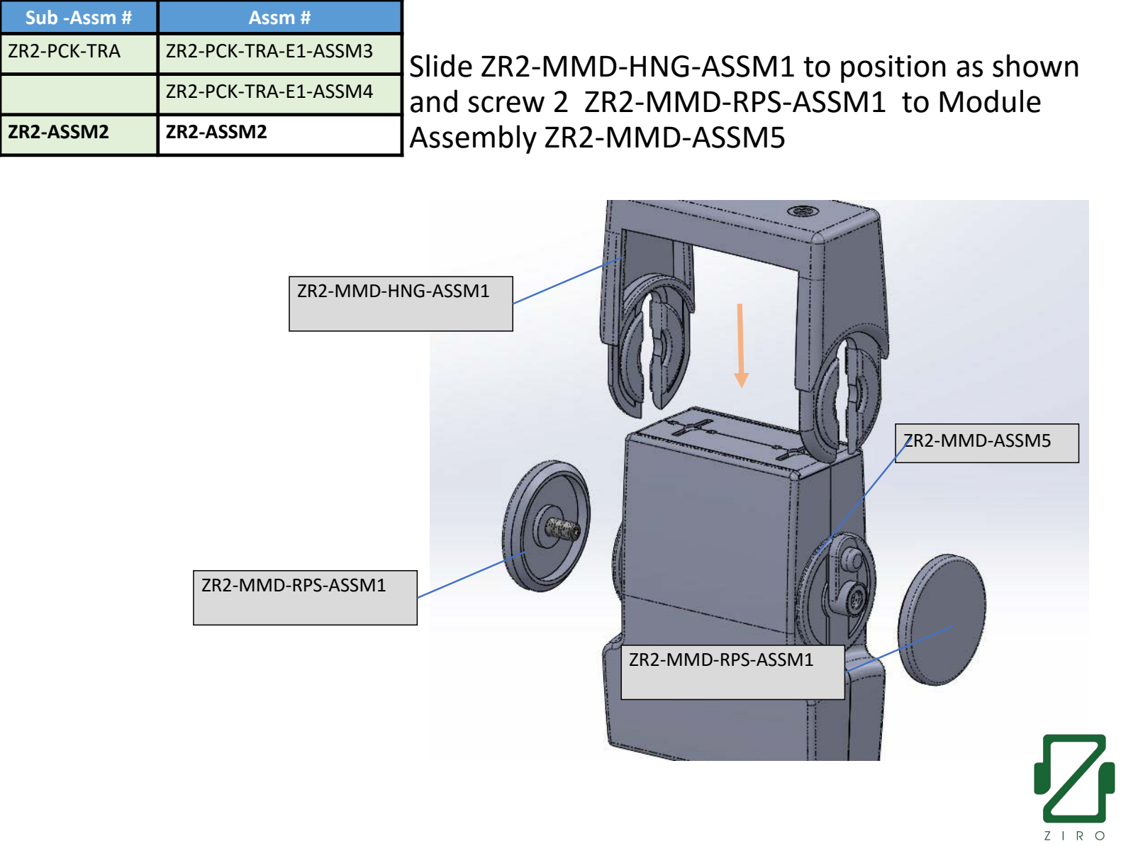
[picture p227: page 34]

## Assembly ZR2-MMD-ASSM5

ZR2-MMD-HNG-ASSM1

ZR2-PCK-TRA | ZR2-PCK-TRA-E1-ASSM3
| ZR2-PCK-TRA-E1-ASSM4
ZR2-ASSM2 | ZR2-ASSM2

ZR2-MMD-ASSM5

ZR2-MMD-RPS-ASSM1

ZR2-MMD-RPS-ASSM1
