ZeroUI/Industrial-Quark/Ziro-master/BoM/_Assembly Process/Assembly Process Images/Connector Screw/Conector and Knurled Shaft_done.JPG

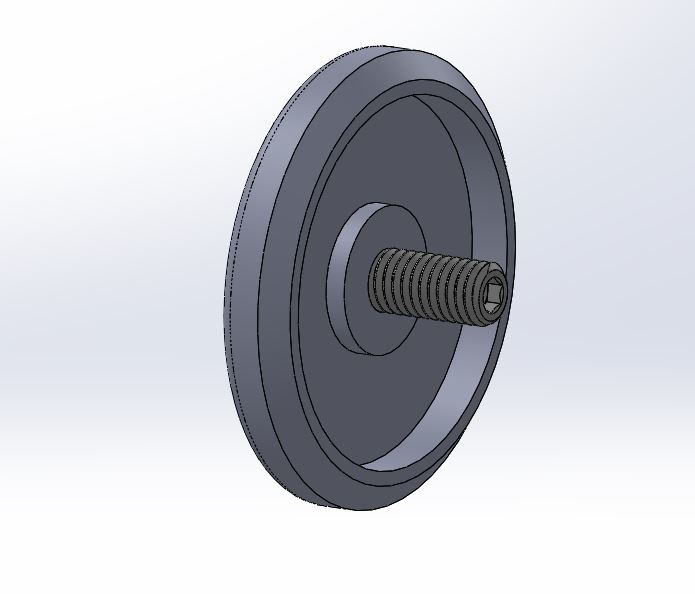
Ziro-master/BoM/_Assembly Process/Assembly Process Images/Connector Screw/Conector and Knurled Shaft_done.JPG
