ZeroUI/Industrial-Quark/Ziro-master/BoM/_Assembly Process/Assembly Process Images/Motor Module/Other Shell in Position.JPG

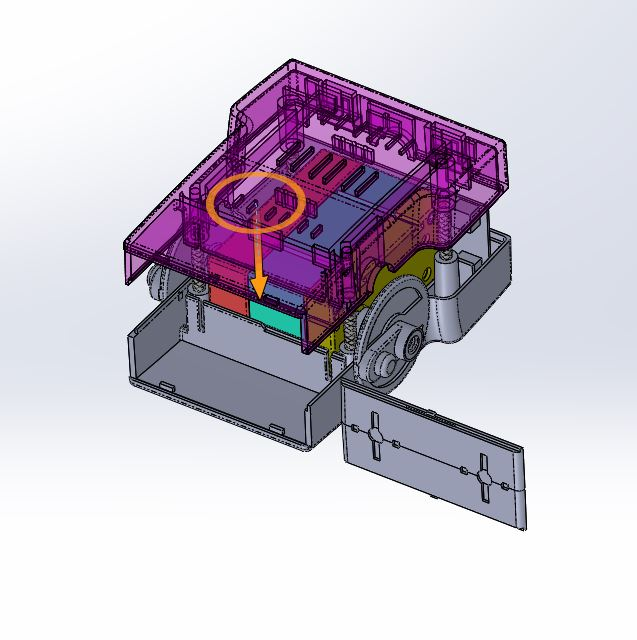
Ziro-master/BoM/_Assembly Process/Assembly Process Images/Motor Module/Other Shell in Position.JPG
