ZeroUI/Industrial-Quark/Ziro-master/BoM/_Assembly Process/Assembly Process Images/Motor Module/Quark in Shell.JPG

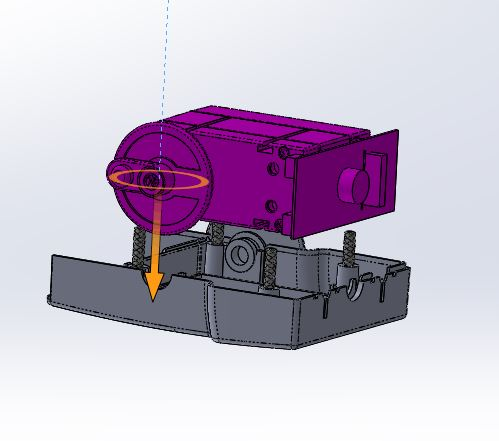
Ziro-master/BoM/_Assembly Process/Assembly Process Images/Motor Module/Quark in Shell.JPG
