ZeroUI/Industrial-Quark/Ziro-master/BoM/_Assembly Process/Assembly Process Images/Motor Module/RTP Opposite Side to Shell.JPG

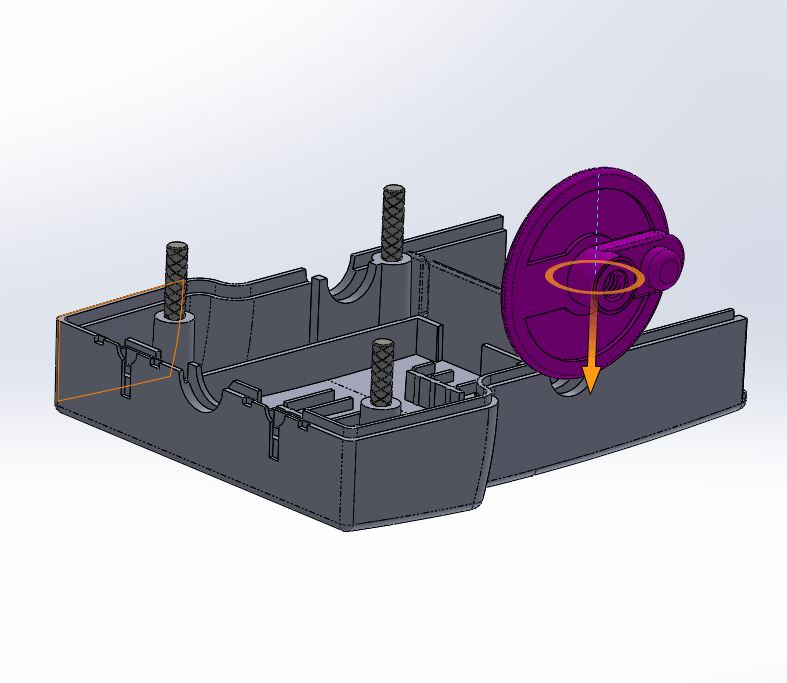
Ziro-master/BoM/_Assembly Process/Assembly Process Images/Motor Module/RTP Opposite Side to Shell.JPG
