ZeroUI/Industrial-Quark/Ziro-master/BoM/_Assembly Process/Assembly Process Images/Motor Module/Shell and Knurled.JPG

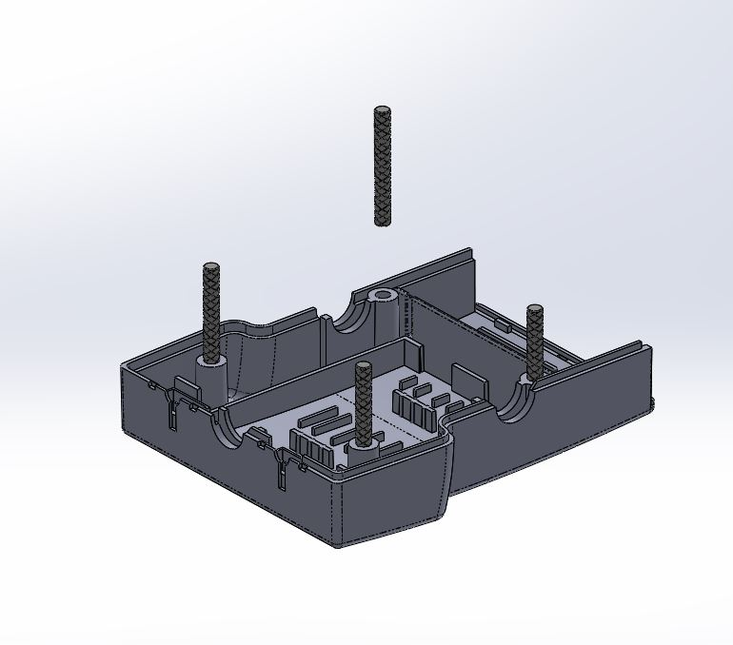
Ziro-master/BoM/_Assembly Process/Assembly Process Images/Motor Module/Shell and Knurled.JPG
