ZeroUI/Industrial-Quark/Ziro-master/BoM/_Assembly Process/Assembly Process Images/Overall Assembly/Module.JPG

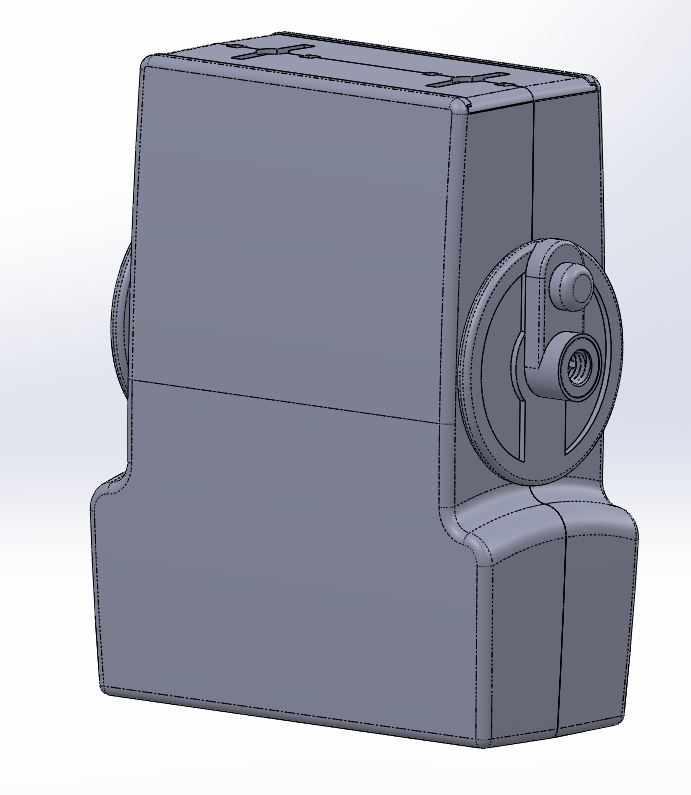
Ziro-master/BoM/_Assembly Process/Assembly Process Images/Overall Assembly/Module.JPG
