ZeroUI/Industrial-Quark/Ziro-master/BoM/_Assembly Process/Assembly Process Images/Overall Assembly/Overall Module Assembly.JPG

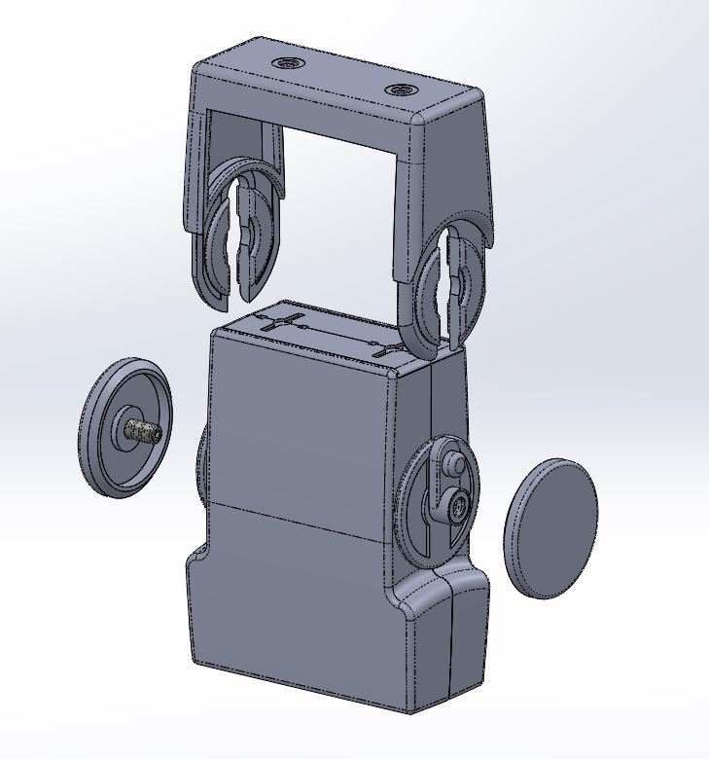
Ziro-master/BoM/_Assembly Process/Assembly Process Images/Overall Assembly/Overall Module Assembly.JPG
