ZeroUI/Industrial-Quark/Ziro-master/BoM/_Assembly Process/Assembly Process Images/Overall Assembly/Rotating Pin.JPG

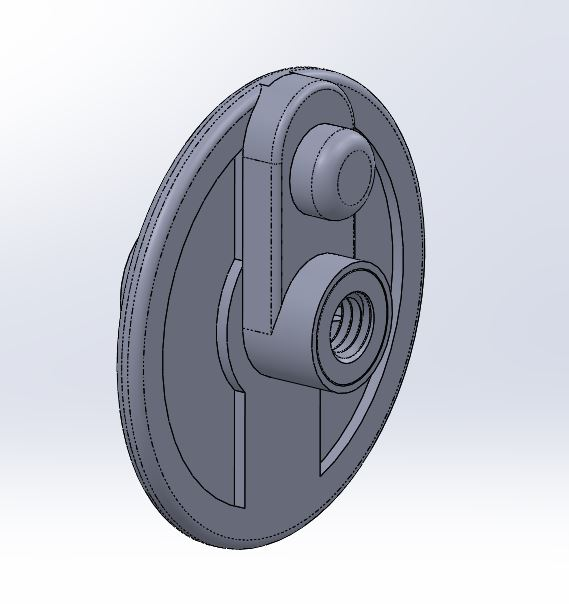
Ziro-master/BoM/_Assembly Process/Assembly Process Images/Overall Assembly/Rotating Pin.JPG
