ZeroUI/Industrial-Quark/Ziro-master/BoM/_Assembly Process/Assembly Process Images/Packaging/BOT to TOp.JPG

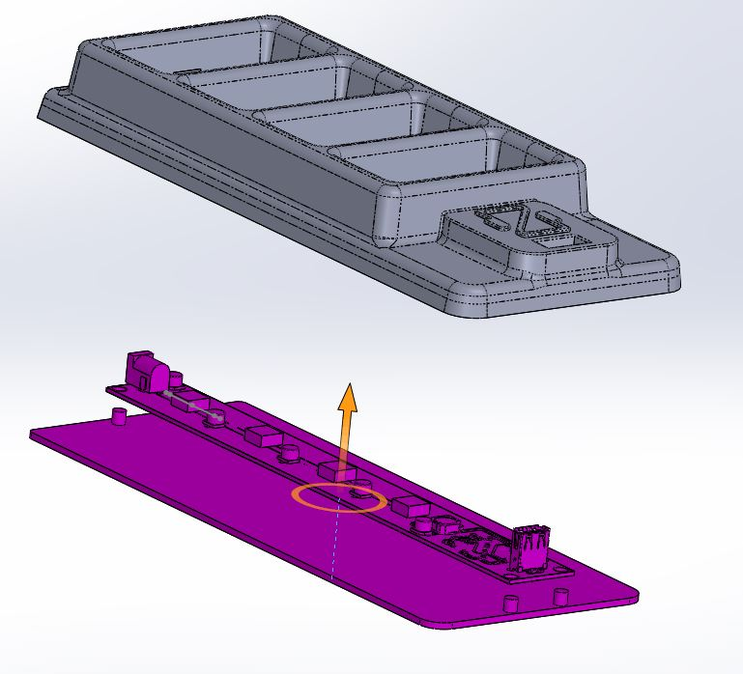
Ziro-master/BoM/_Assembly Process/Assembly Process Images/Packaging/BOT to TOp.JPG
