ZeroUI/Industrial-Quark/Ziro-master/BoM/_Assembly Process/Assembly Process Images/Packaging/Packaging Tray.JPG

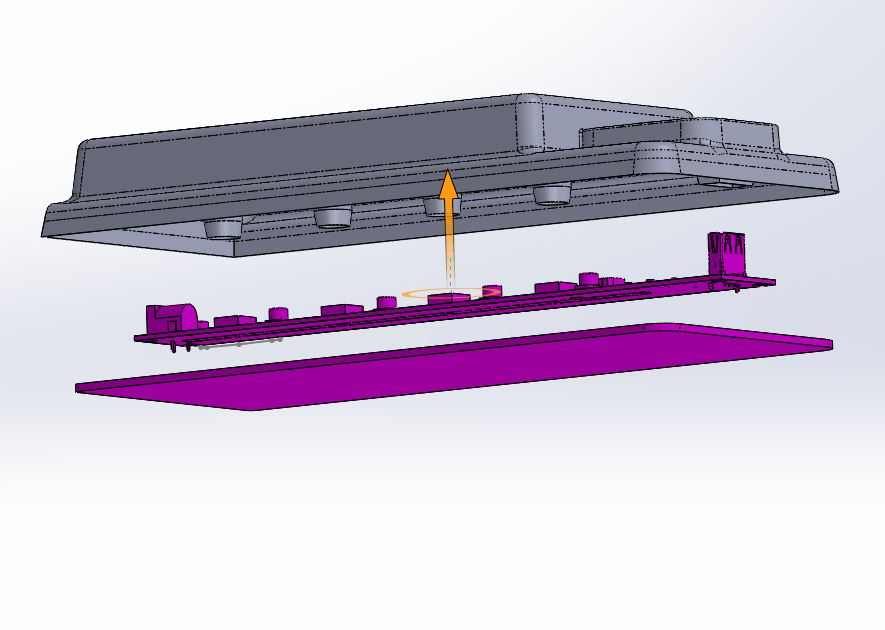
Ziro-master/BoM/_Assembly Process/Assembly Process Images/Packaging/Packaging Tray.JPG
