ZeroUI/Industrial-Quark/Ziro-master/BoM/_Assembly Process/Assembly Process Images/Packaging/PCB to Bottom Lid.JPG

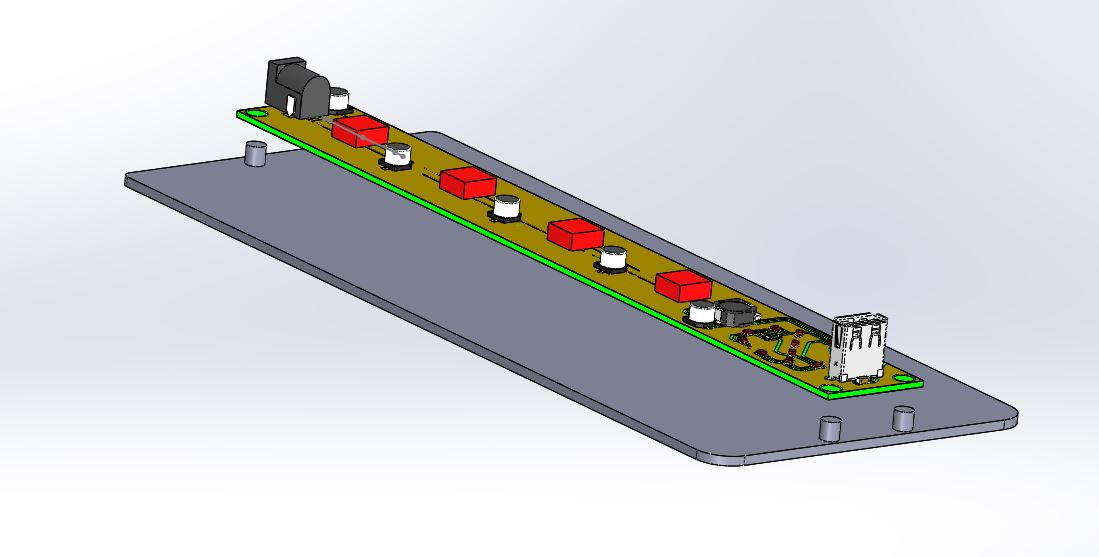
Ziro-master/BoM/_Assembly Process/Assembly Process Images/Packaging/PCB to Bottom Lid.JPG
