ZeroUI/Industrial-Quark/Ziro-master/BoM/_Assembly Process/Assembly Process Images/Pod/Pod Snapped.JPG

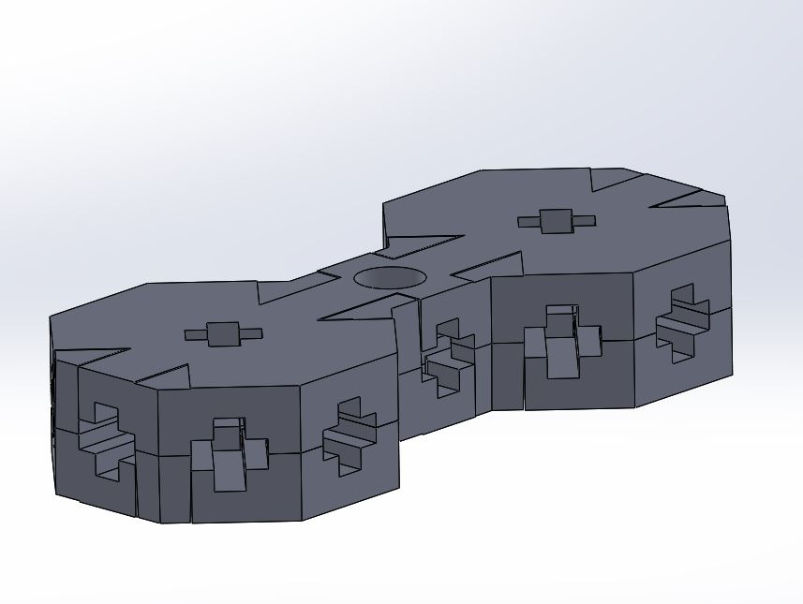
Ziro-master/BoM/_Assembly Process/Assembly Process Images/Pod/Pod Snapped.JPG
