ZeroUI/Industrial-Quark/Ziro-master/BoM/_Assembly Process/Assembly Process Images/Quark Assembly/Step 1 - Pcb in middle shell.JPG

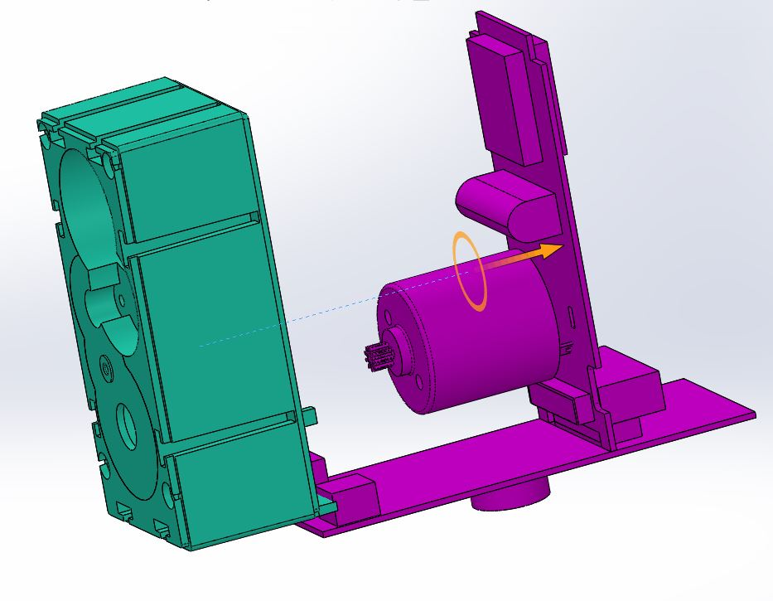
Ziro-master/BoM/_Assembly Process/Assembly Process Images/Quark Assembly/Step 1 - Pcb in middle shell.JPG
