ZeroUI/Industrial-Quark/Ziro-master/BoM/_Assembly Process/Assembly Process Images/Quark Assembly/Step 2 - Insert Shafts.JPG

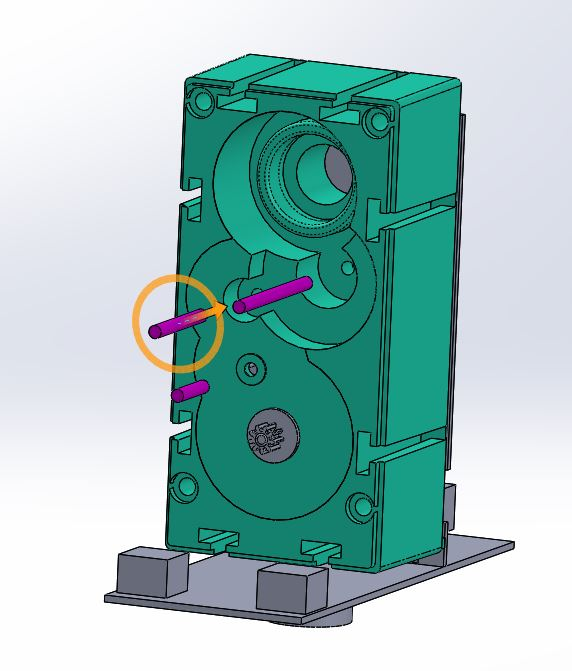
Ziro-master/BoM/_Assembly Process/Assembly Process Images/Quark Assembly/Step 2 - Insert Shafts.JPG
