ZeroUI/Industrial-Quark/Ziro-master/BoM/_Assembly Process/Assembly Process Images/Quark Assembly/Step 3 - Gears Insertion.JPG

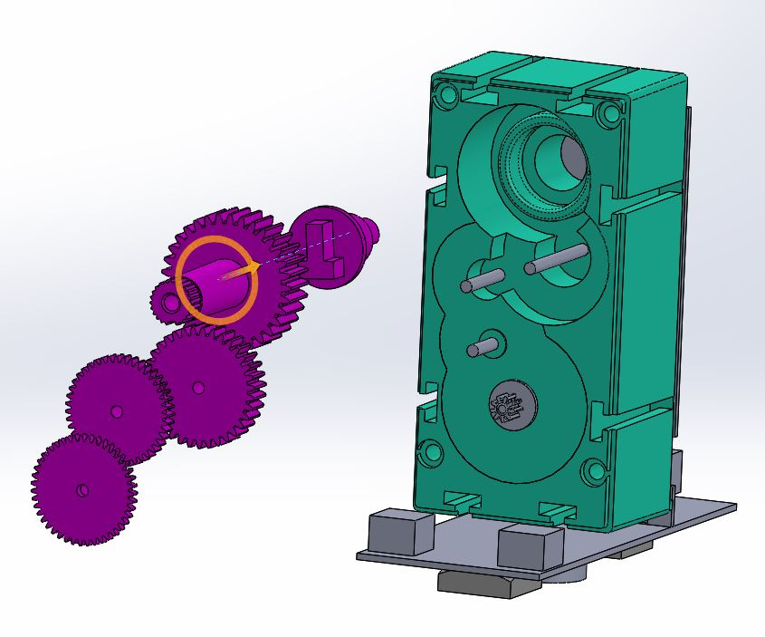
Ziro-master/BoM/_Assembly Process/Assembly Process Images/Quark Assembly/Step 3 - Gears Insertion.JPG
