ZeroUI/Industrial-Quark/Ziro-master/BoM/_Assembly Process/Assembly Process Images/Quark Assembly/Step 5 - Cover Bottom Lid.JPG

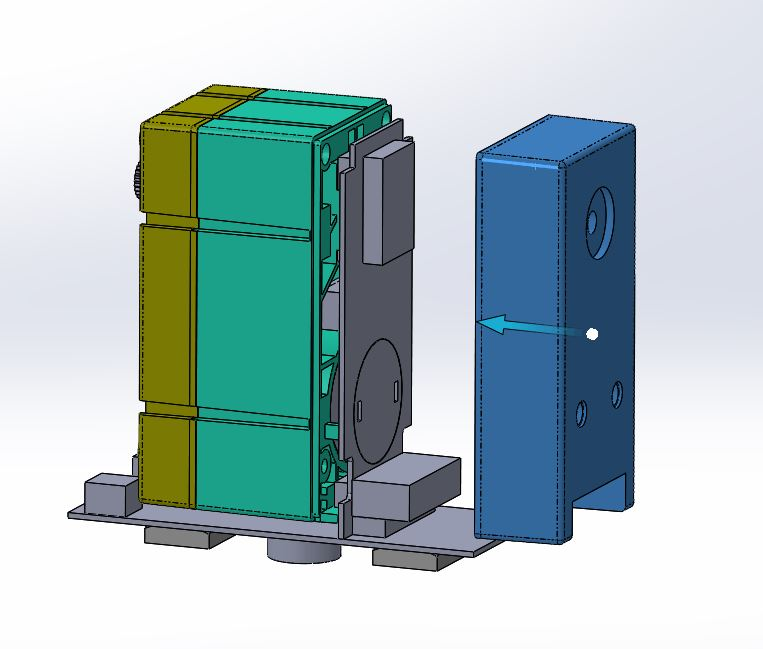
Ziro-master/BoM/_Assembly Process/Assembly Process Images/Quark Assembly/Step 5 - Cover Bottom Lid.JPG
