ZeroUI/Industrial-Quark/Ziro-master/BoM/_Assembly Process/Assembly Process Images/Quark Assembly/Step 6 - Screw Down.JPG

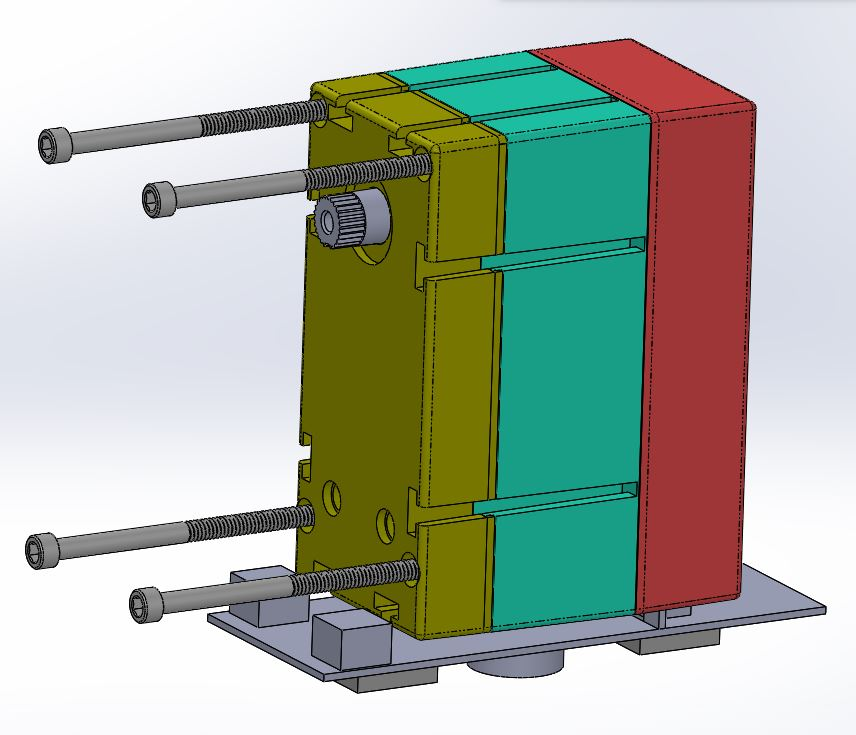
Ziro-master/BoM/_Assembly Process/Assembly Process Images/Quark Assembly/Step 6 - Screw Down.JPG
