ZeroUI/Industrial-Quark/Ziro-master/BoM/_Assembly Process/Assembly Process Images/Rotating Pin/RP and Insert.JPG

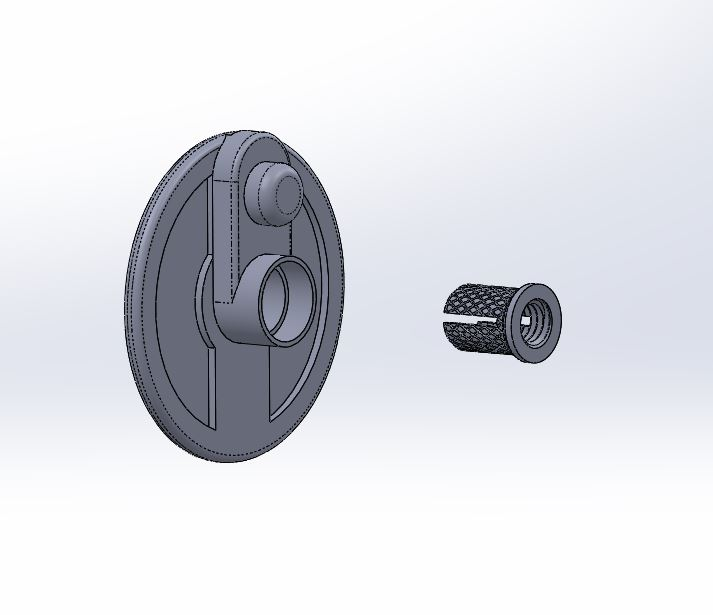
Ziro-master/BoM/_Assembly Process/Assembly Process Images/Rotating Pin/RP and Insert.JPG
