ZeroUI/Industrial-Quark/Ziro-master/BoM/_Assembly Process/Assembly Process Images/Rotating Pin/RP and Insert_DOne.JPG

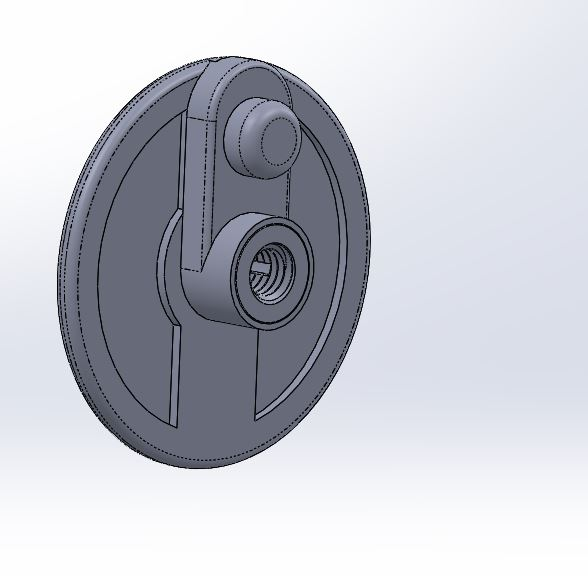
Ziro-master/BoM/_Assembly Process/Assembly Process Images/Rotating Pin/RP and Insert_DOne.JPG
