ZeroUI/Industrial-Quark/Ziro-master/BoM/_Assembly Process/Assembly Process Images/Wheel/Wheel Split.JPG

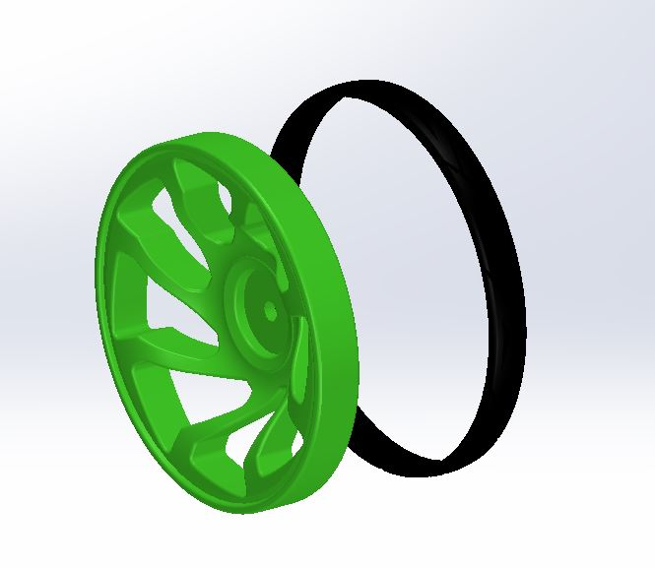
Ziro-master/BoM/_Assembly Process/Assembly Process Images/Wheel/Wheel Split.JPG
