ZeroUI/Industrial-Quark/Ziro-master/BoM/Motor Modules/Quark/E1-PCB/PCB Assembly Tests.txt

Automated Optical Inspection
Firmware Download
In-Circuit Test (for NPI only)
