ZeroUI/Industrial-Quark/Ziro-master/Electronics/V2.0 Wifi/Documentation/Battery Management Testing Batter-1.pdf

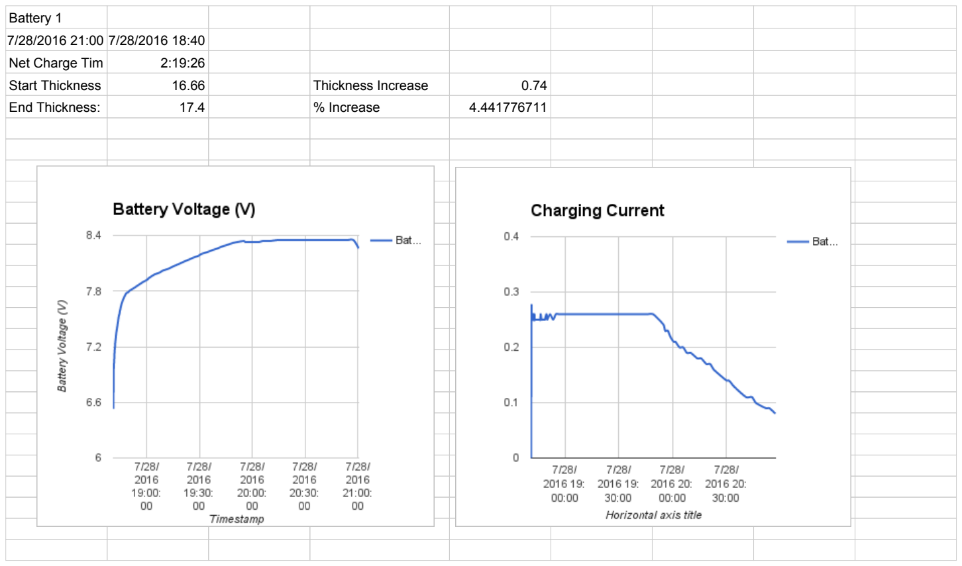
[picture p290: page 1]

Battery 1

7/28/2016 21:00 | 7/28/2016 18:40
Net Charge Tim | 2:19:26
Start Thickness | 16.66 | Thickness Increase | 0.74
End Thickness: | 17.4 | % Increase | 4.441776711
