ZeroUI/Industrial-Quark/Ziro-master/Electronics/V2.0 Wifi/Documentation/Battery Management Testing Batter-2.pdf

Battery 2

7/30/2016 16:35 | 7/30/2016 14:51
Net Charge Tim | 1:43:03
Start Thickness | 16.66 | Thickness Incre | 0.22
End Thickness: | 16.88 | % Increase | 1.320528211

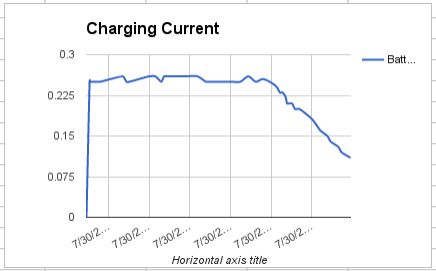
[picture p291: figure]
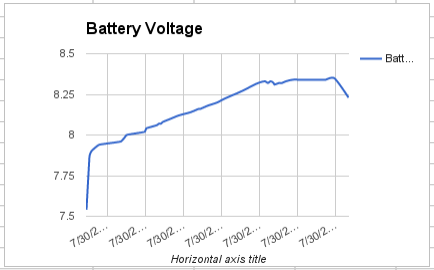
[picture p292: figure]
