ZeroUI/Industrial-Quark/Ziro-master/Electronics/V2.0 Wifi/Software/3 End Of Line Test/GloveEOL/Glove EOL/EOL Glove Test Procedure.pdf

# End of Line (EOL) Test for Glove Procedure

## Insert 9V DC

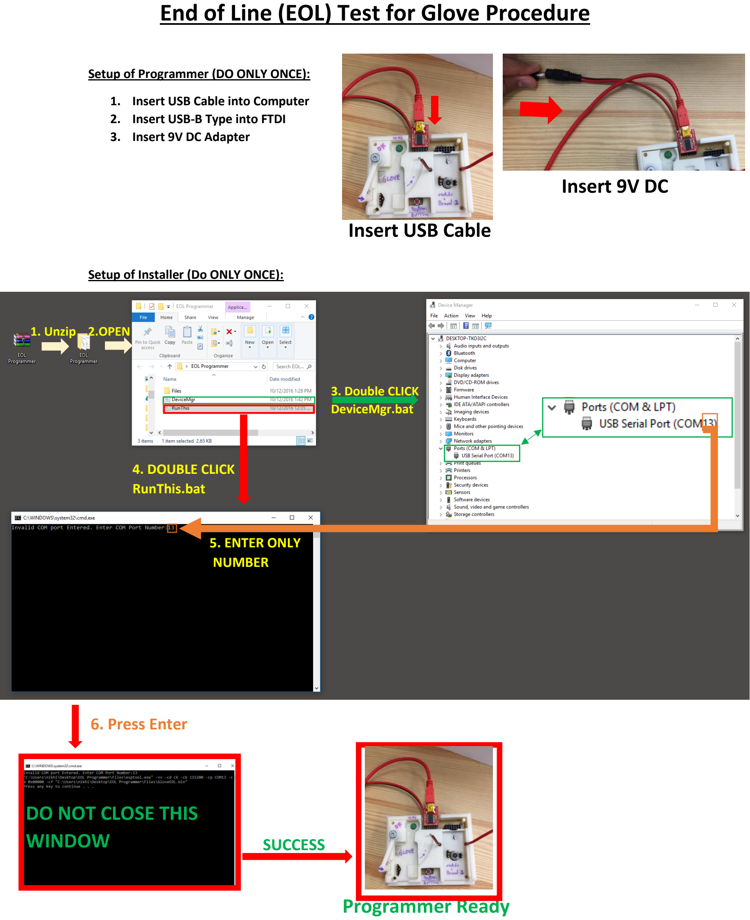
[picture p293: page 1]

Setup of Programmer (DO ONLY ONCE):

### 1. Insert USB Cable into Computer 2. Insert USB-B Type into FTDI 3. Insert 9V DC Adapter

Setup of Installer (Do ONLY ONCE):

### 3. Double CLICK

DeviceMgr.bat

### 1. Unzip 2.OPEN

### 4. DOUBLE CLICK

RunThis.bat

### 5. ENTER ONLY

NUMBER

### 6. Press Enter

### SUCCESS

## Programmer Ready

## Insert USB Cable

## DO NOT CLOSE THIS WINDOW

Setup of Installer (Once More):

### 1. Unzip and Extract the compressed folder for the Glove: 2. Open the Folder 3. Double-Click the DeviceMgr.bat and find the Ports (COM & LPT) 4. Double-Click RunThis.bat

5. Enter Number from Step 3.
6. Press Enter.

PROGRAMMING STEPS:

### Step # 1: Insert USB into Glove PCB

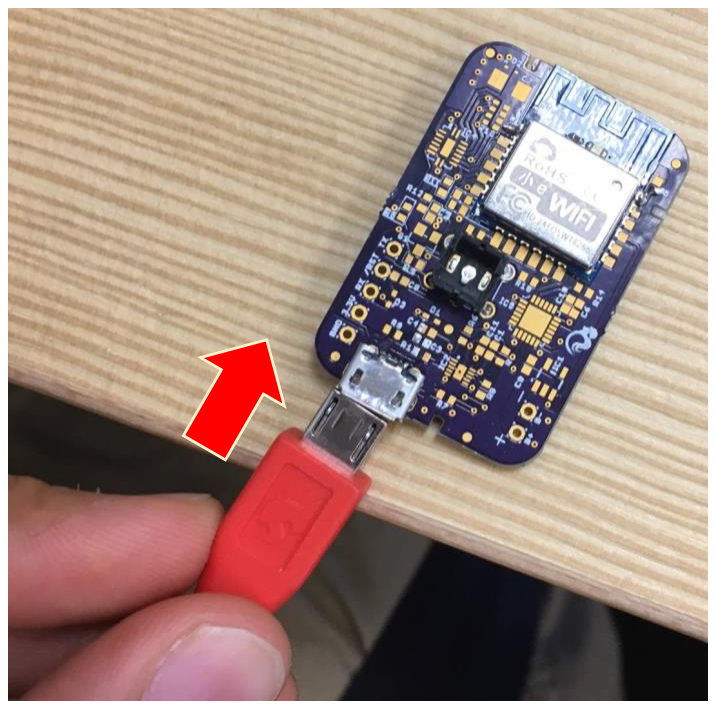
[picture p294: figure]
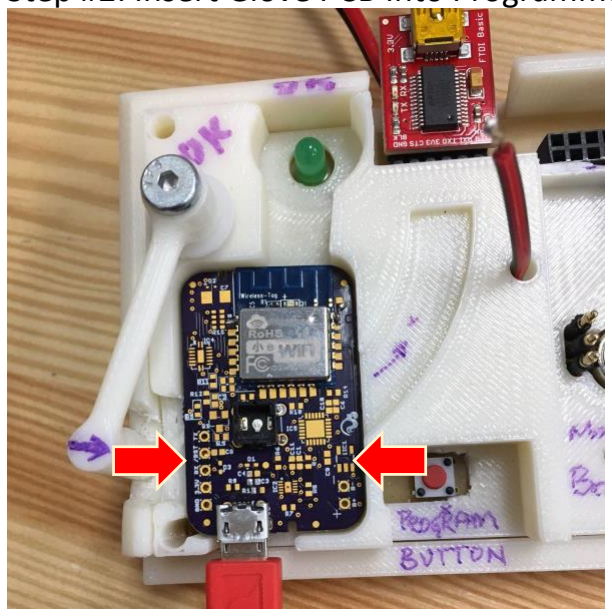
[picture p295: figure]
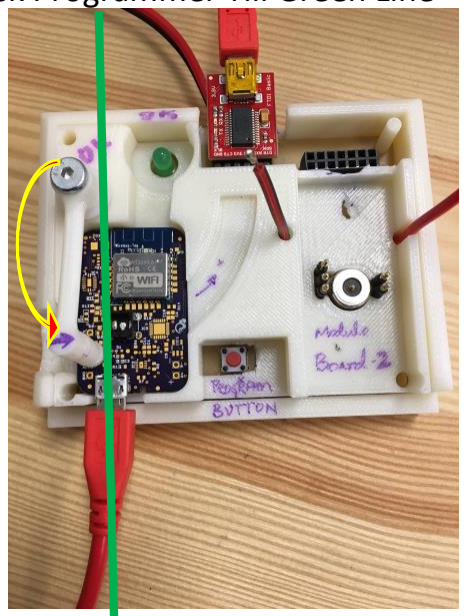
[picture p296: figure]

### Step #2: Insert Glove PCB Into Programmer & Lock Programmer Till Green Line

### Step 3: Push Button On Programmer for 5sec => Download Begins

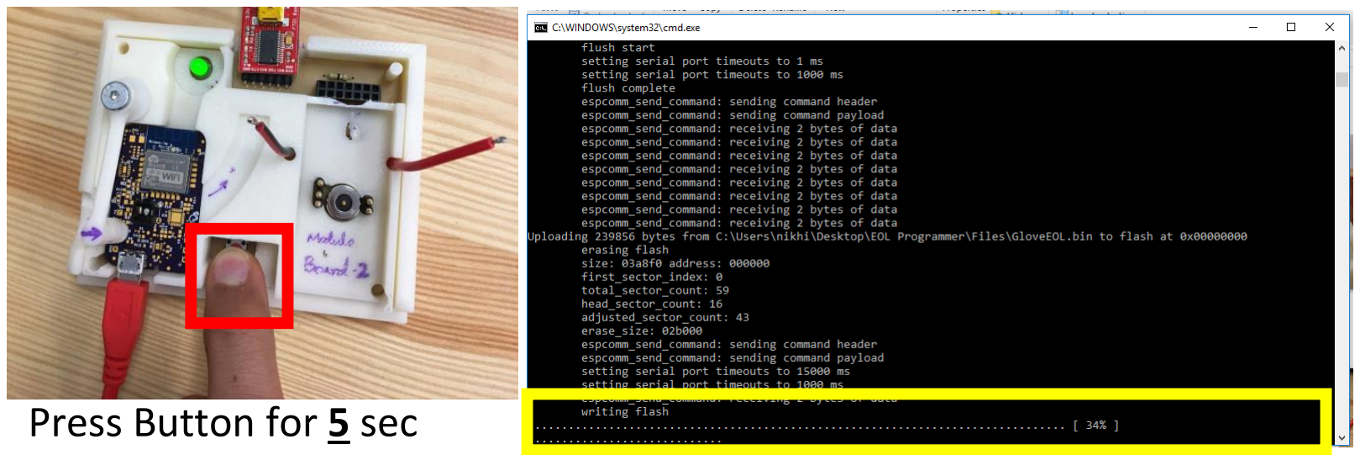
[picture p297: figure]
Press Button for 5 sec
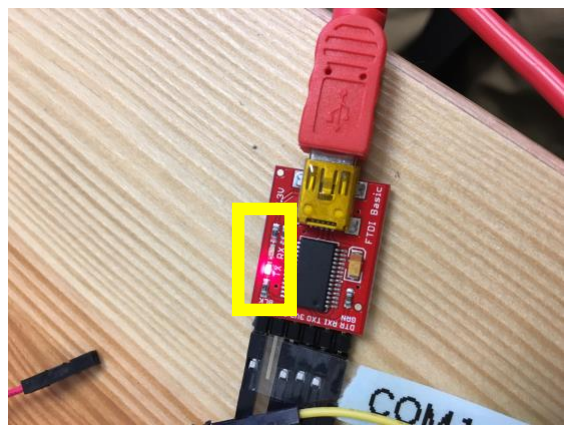
[picture p298: figure]

## Light Blink during Download

## Download Begins. Status shown on Screen

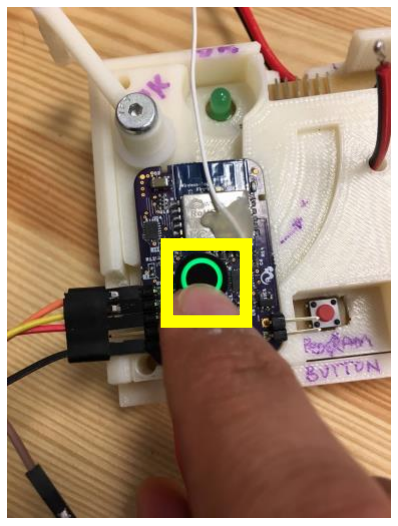
[picture p299: figure]
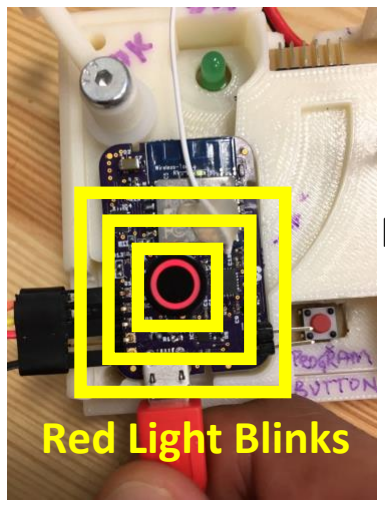
[picture p300: figure]
Debug Info: Red Light Blinks

## Press Red Light

## Press Red Light

Step 4: After Download, Red button on Glove PCB will begin blinking. Press it.

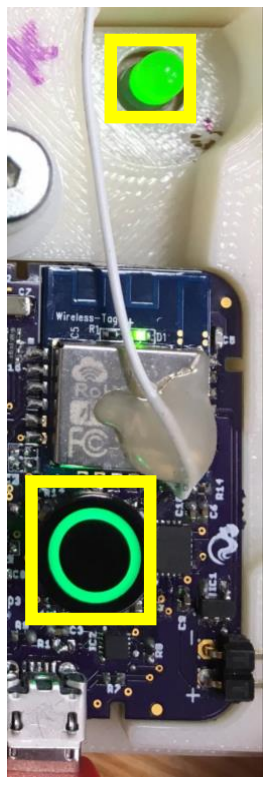
[picture p301: figure]

IF BOTH LIGHTS TURN GREEN=> SUCCESS

Repeat Steps 1 to 4

For any other questions call +1-765-476-3370 or email nikhil@zeroui.com
