ZeroUI/Industrial-Quark/Ziro-master/Electronics/V2.0 Wifi/Documentation/ADC_Testing.xlsx

ADC Reading | Glove Battery Voltage
378 | 4.3 | Test was performed on Glove PCB by varying input voltage on glove and recording corresponding voltage from ADC Function
369 | 4.2
360 | 4.1
351 | 4
343 | 3.9
334 | 3.8
326 | 3.7
315 | 3.6
308 | 3.5
295 | 3.4
289 | 3.3
281 | 3.2
273 | 3.1
264 | 3
245 | 2.8
218 | 2.5
209 | 2.4
219 | 2.5
228 | 2.6
237 | 2.7
245 | 2.8
254 | 2.9
264 | 3
273 | 3.1
281 | 3.2
290 | 3.3
300 | 3.4
310 | 3.5
312 | 3.6
318 | 3.7
334 | 3.8
343 | 3.9
352 | 4
361 | 4.1
369 | 4.2
378 | 4.3
388 | 4.4
