ZeroUI/Industrial-Quark/Ziro-master/Electronics/V2.0 Wifi/Documentation/Battery Management Testing.xlsx

Sheet: Form Responses 2
Timestamp | Battery Voltage (V) | Battery Charging Current (A)
2016-07-30 14:51 | 7.54 | 0 |  |  | Downloaded from Google Sheets
2016-07-30 14:53 | 7.86 | 0.25 | Battery 2
2016-07-30 14:53 | 7.88 | 0.25 | 2016-07-30 16:35 | 2016-07-30 14:51
2016-07-30 14:53 | 7.9 | 0.25 | Net Charge Time | 1:43:03
2016-07-30 14:55 | 7.92 | 0.25 | Start Thickness | 16.66 |  | Thickness Increase | 0.22
2016-07-30 14:56 | 7.94 | 0.25 | End Thickness: | 16.88 |  | % Increase | 1.320528211
2016-07-30 15:05 | 7.96 | 0.26
2016-07-30 15:06 | 7.98 | 0.25
2016-07-30 15:07 | 8 | 0.25
2016-07-30 15:14 | 8.02 | 0.26
2016-07-30 15:15 | 8.04 | 0.26
2016-07-30 15:17 | 8.05 | 0.26
2016-07-30 15:19 | 8.06 | 0.25
2016-07-30 15:20 | 8.07 | 0.26
2016-07-30 15:21 | 8.07 | 0.26
2016-07-30 15:21 | 8.08 | 0.26
2016-07-30 15:25 | 8.1 | 0.26
2016-07-30 15:28 | 8.12 | 0.26
2016-07-30 15:32 | 8.14 | 0.26
2016-07-30 15:35 | 8.16 | 0.25
2016-07-30 15:36 | 8.16 | 0.25
2016-07-30 15:39 | 8.18 | 0.25
2016-07-30 15:43 | 8.2 | 0.25
2016-07-30 15:45 | 8.22 | 0.25
2016-07-30 15:48 | 8.24 | 0.25
2016-07-30 15:51 | 8.26 | 0.26 | Second Run
2016-07-30 15:54 | 8.28 | 0.25 | Initial Thickness | 16.16
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
