ZeroUI/Industrial-Quark/Ziro-master/Electronics/V2.0 Wifi/Documentation/Module Sensor Calibration.xlsx

Sheet: Current Calibration
ADC Current Channel [Count] | Current Value Measured [Amp] | Module Current Sensor Tabulation
1.22 | 280
2 | 450
1.75 | 396
1.63 | 360
1.53 | 336
1.43 | 312
1.3 | 282
1.2 | 258
1.06 | 226
0.96 | 200
0.84 | 172
0.62 | 118
0.51 | 90
0.24 | 32
0.37 | 60
0.46 | 80
0.59 | 109
0.74 | 148
0.84 | 173
1 | 212
1.2 | 262
1.37 | 300
1.5 | 329
1.62 | 359
1.72 | 388
1.84 | 419
1.95 | 446
1.96 | 446
2.07 | 474
1.62 | 365
2.48 | 604
0.33 | 53
0.16 | 24
0.3 | 54
0.44 | 86.5
0.53 | 98
0.61 | 129
0.84 | 184
0.93 | 205
1.12 | 249
1.19 | 269
1.29 | 290
1.36 | 309
1.44 | 327
1.53 | 350
1.54 | 353
1.03 | 240
0.93 | 213
0.81 | 184
0.66 | 149
0.6 | 133
0.5 | 108
0.41 | 88
0.37 | 76
0.26 | 51
0.2 | 39
0.14 | 25
0 | 5
0.95 | 218
0.37 | 54
0.54 | 93
0.77 | 149
1.03 | 210
1.29 | 273
1.55 | 335
1.72 | 375
1.85 | 411
1.97 | 442
2.09 | 469
2.2 | 496
2.32 | 529
2.46 | 565
2.2 | 491
2.01 | 448
1.72 | 378
1.53 | 328
1.11 | 231
0.96 | 196
0.84 | 168
0.7 | 130
0.44 | 69
0.28 | 36
2.48 | 563
2.07 | 464
0.81 | 159
0.62 | 109
0.45 | 71
0.37 | 55
2.5 | 568
2.5 | 574
2.4 | 550
2.23 | 503
1.96 | 440
1.67 | 365
1.43 | 307
0.73 | 161
2.51 | 571
2.32 | 526
1.81 | 401
2.27 | 514
2.37 | 548
2.49 | 574
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
