ZeroUI/Industrial-Quark/Ziro-master/Electronics/V2.0 Wifi/Documentation/v0.4 Pre-Production Issues.pptx

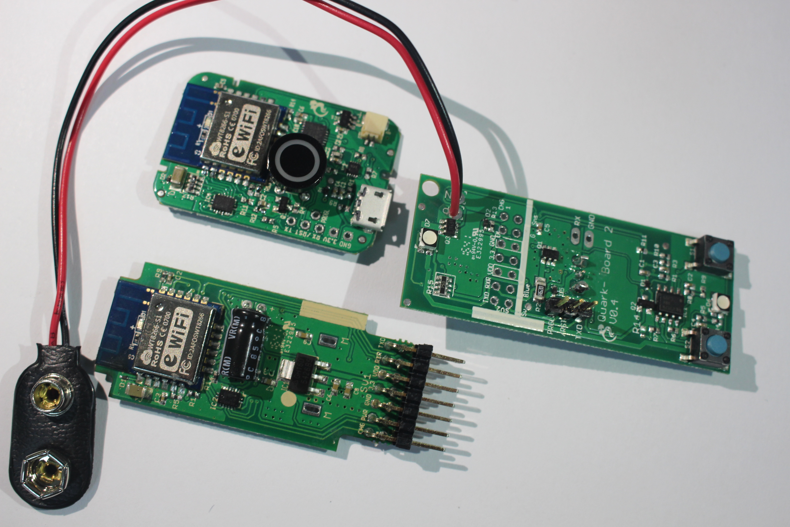
[picture p302: figure]

Switch Cap Should be sent separately

Do Not Install

Should be assembled from back

## Slide 2

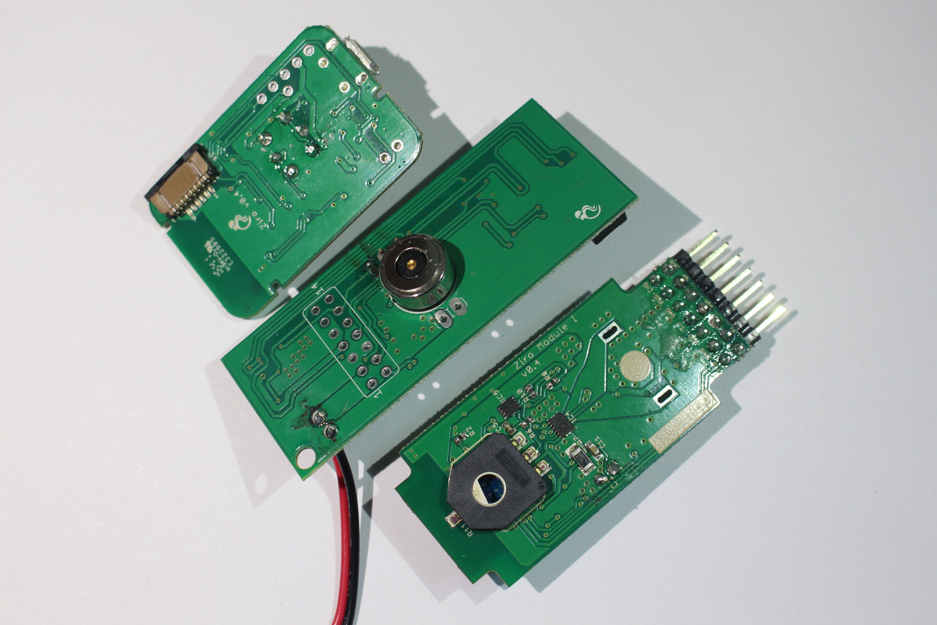
[picture p303: figure]

Could you make this flush to the board?

Kindly send mating connector
separately

Flux Residue Cleaning
