ZeroUI/Industrial-Quark/Ziro-master/Electronics/V2.0 Wifi/Documentation/Flex Sensor Pattern Layer.pdf

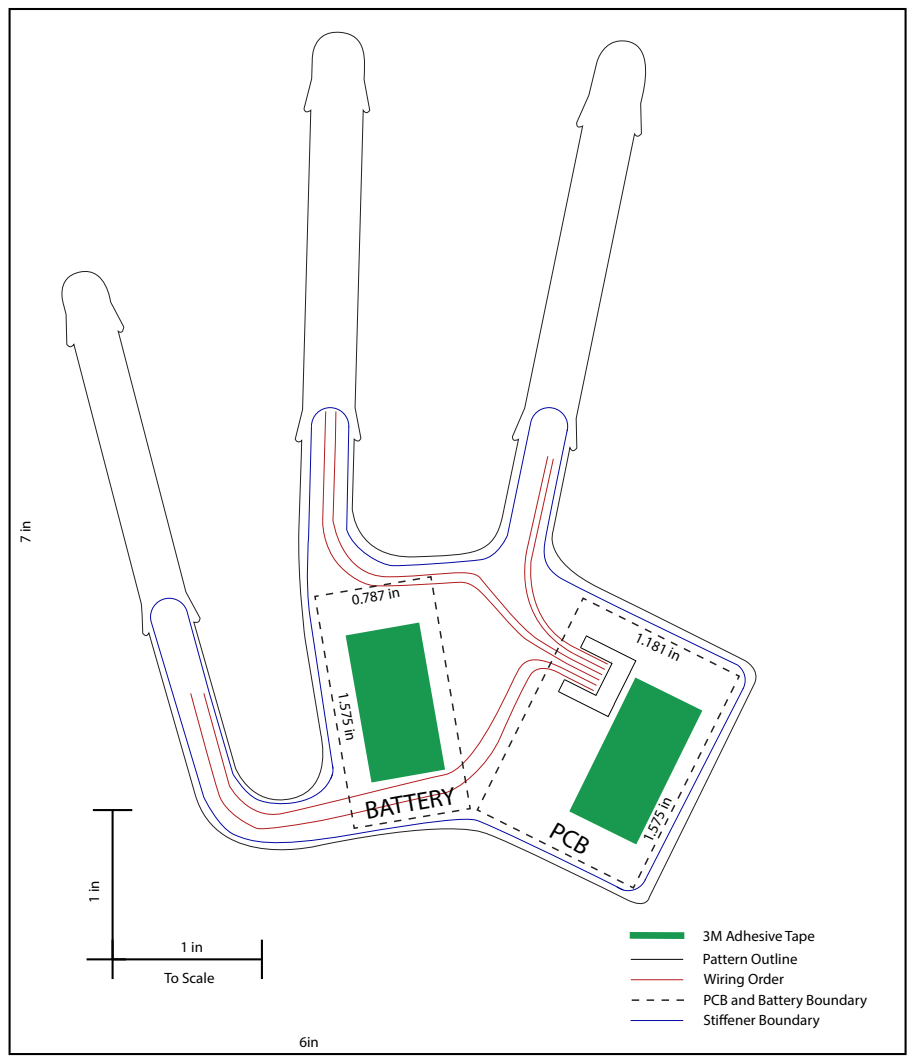
[picture p304: page 1]
To Scale; PCB; BATTERY

3M Adhesive Tape
Pattern Outline
Wiring Order
PCB and Battery Boundary
Stiener Boundary
