ZeroUI/Industrial-Quark/Ziro-master/Electronics/V1.0 Bluetooth/Hardware/PCB related req engg/Handimate Module.pdf

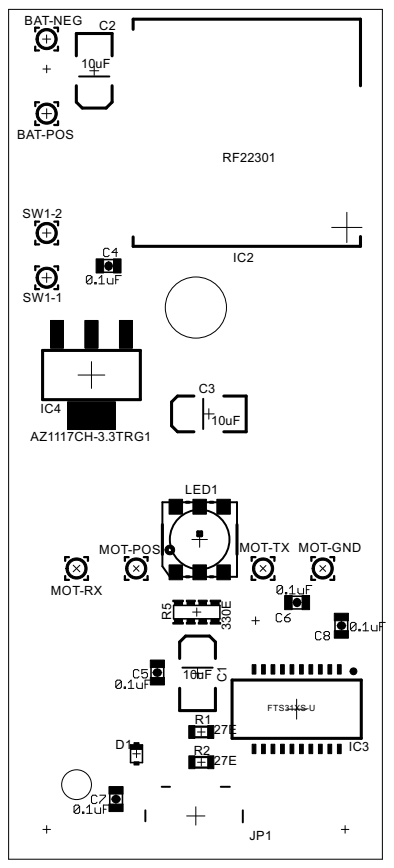
[picture p305: page 1]

MOT-TX MOT-GND
