ZeroUI/Industrial-Quark/Ziro-master/Electronics/V1.0 Bluetooth/Hardware/Handimate_Backup/Glove Module/Glove Module Schematics v1.pdf

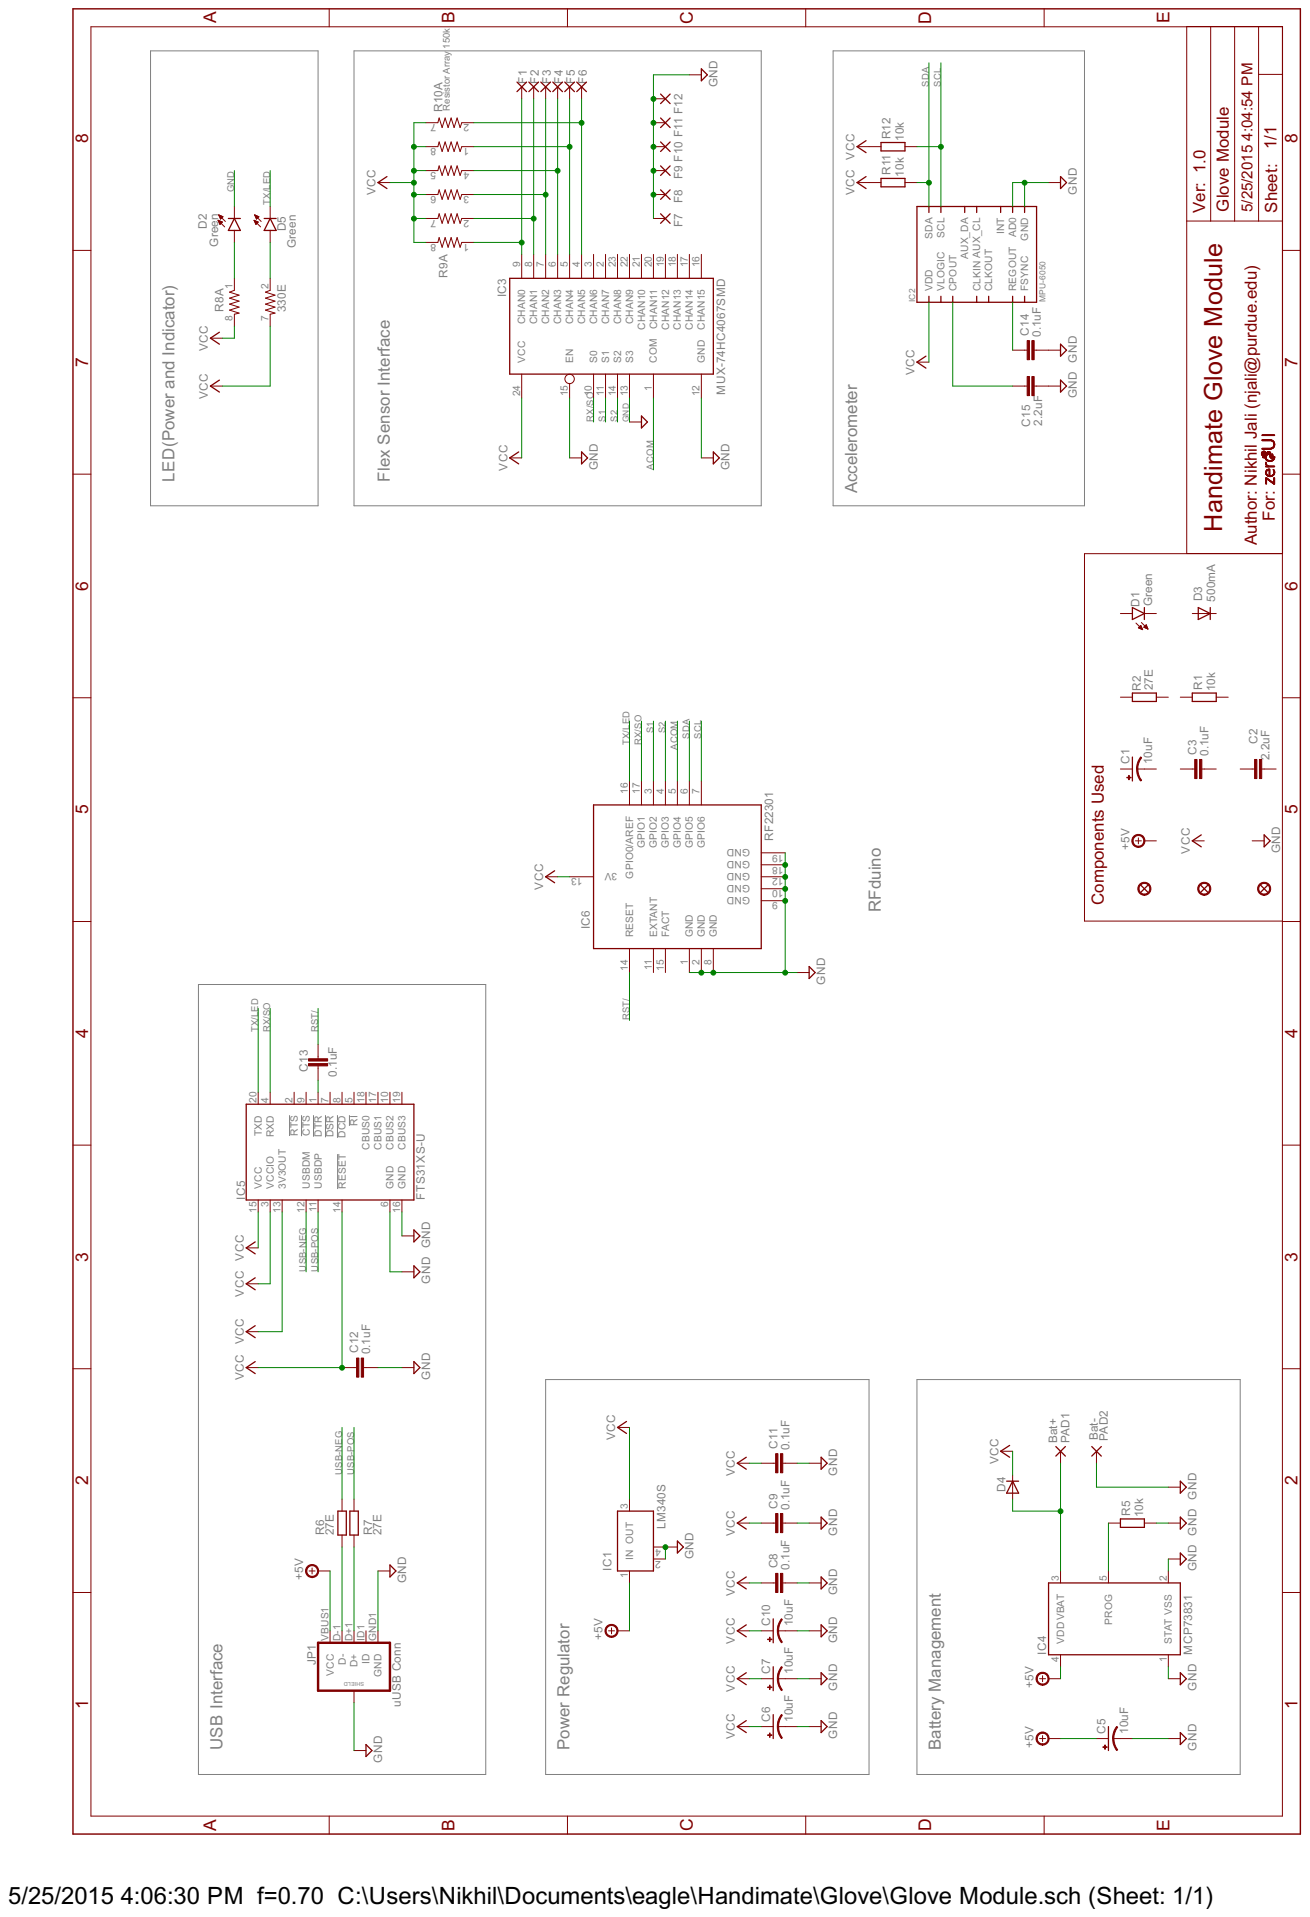
[picture p306: page 1]

Components Used Glove Module

Ver: Author: Nikhil Jali (njali@purdue.edu) For:

LED(Power and Indicator)

USB-POS USB-POS RST/

VCC VCC

5/25/2015 4:06:30 PM f=0.70 C:\Users\Nikhil\Documents\eagle\Handimate\Glove\Glove Module.sch (Sheet: 1/1)
