ZeroUI/Industrial-Quark/Ziro-master/Electronics/V1.0 Bluetooth/Hardware/Handimate_Backup/Glove Module/Glove Module- V1_2.pdf

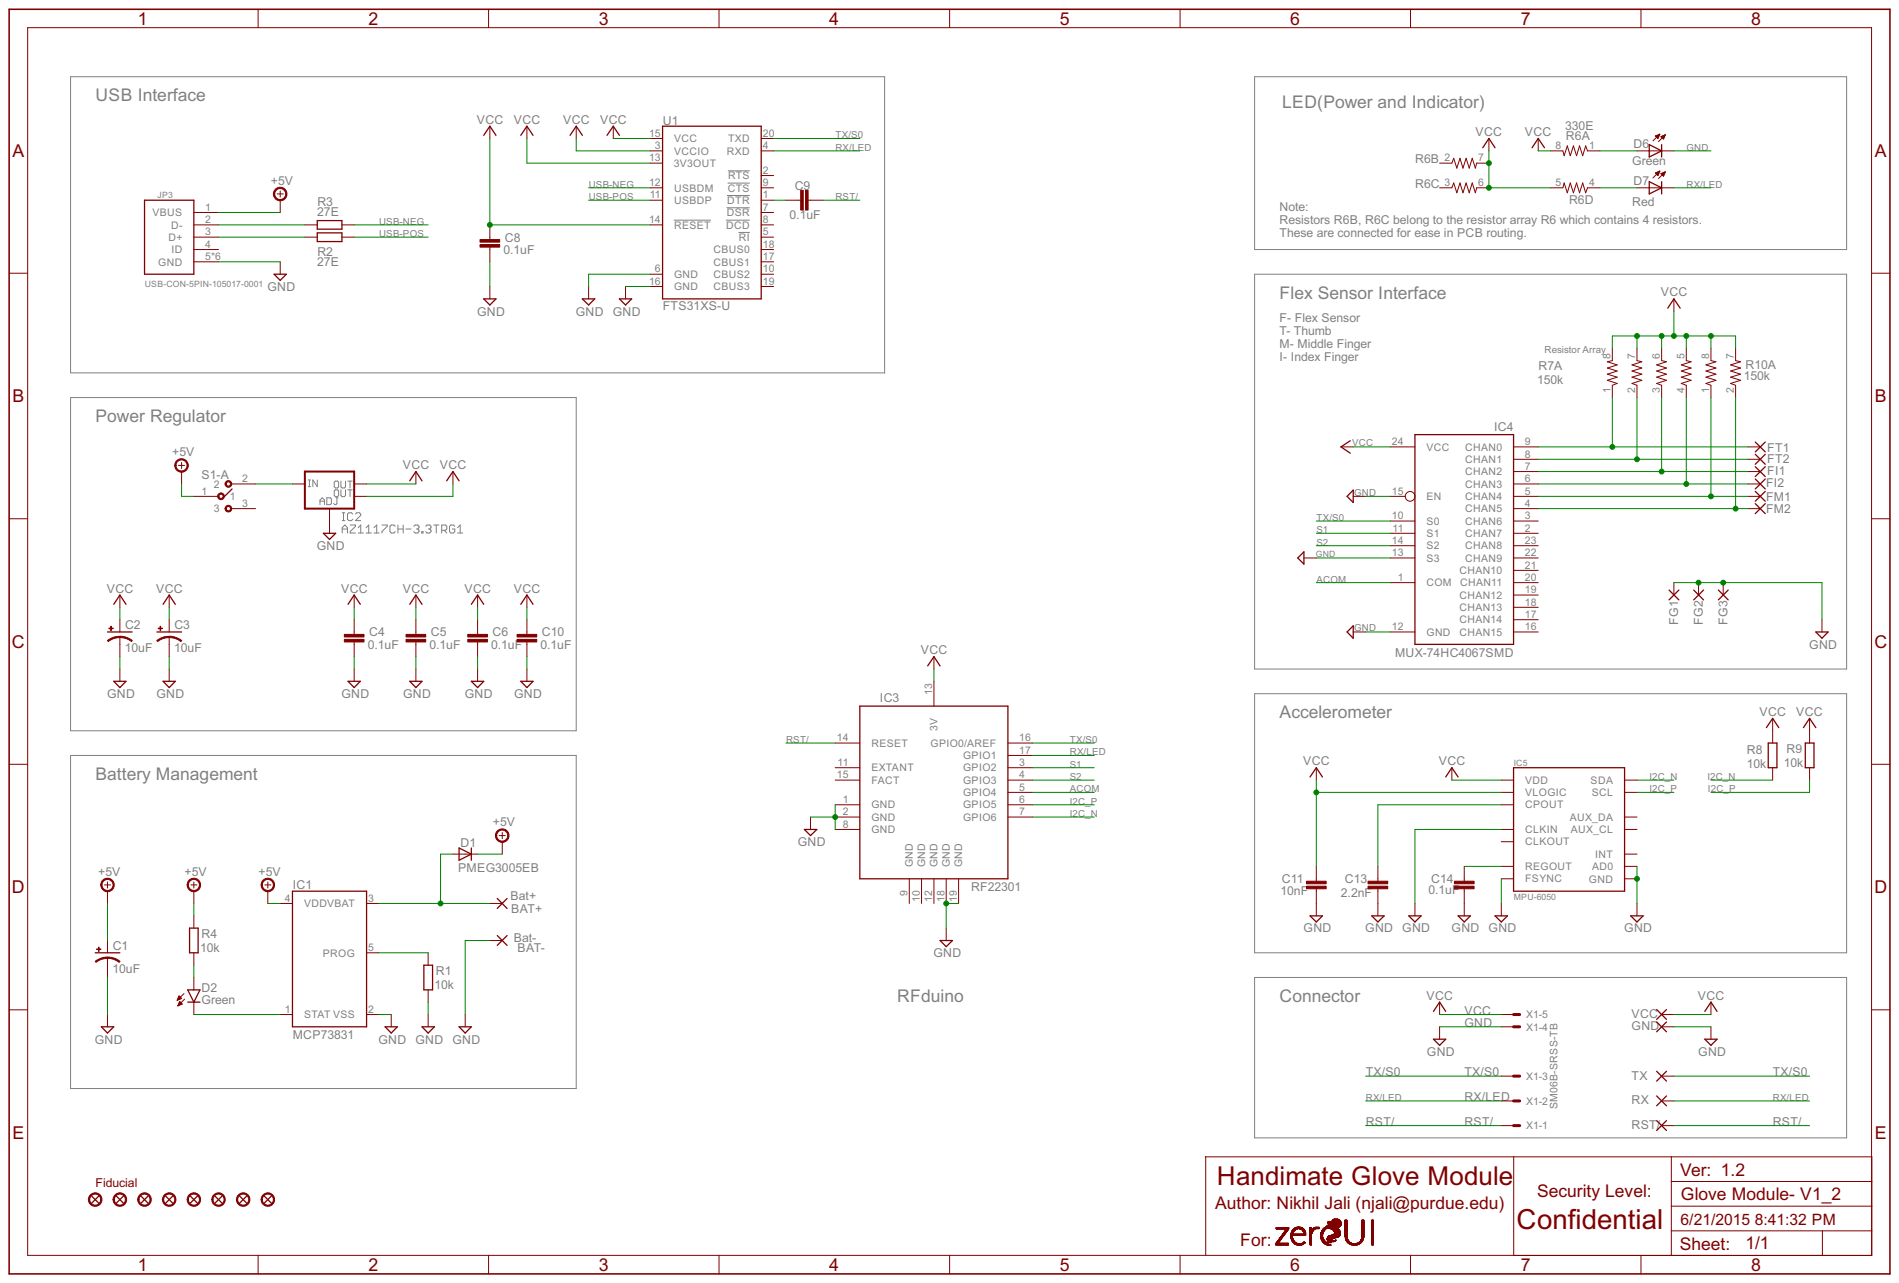
[picture p307: page 1]

LED(Power and Indicator)

Note: Resistors R6B, R6C belong to the resistor array R6 which contains 4 resistors. These are connected for ease in PCB routing.

F- Flex Sensor T- Thumb M- Middle Finger

Ver: Author: Nikhil Jali (njali@purdue.edu)
