ZeroUI/Industrial-Quark/Ziro-master/Electronics/V1.0 Bluetooth/Hardware/Handimate_Backup/Motor Module/Motor Module PCB- v1 design 0.pdf

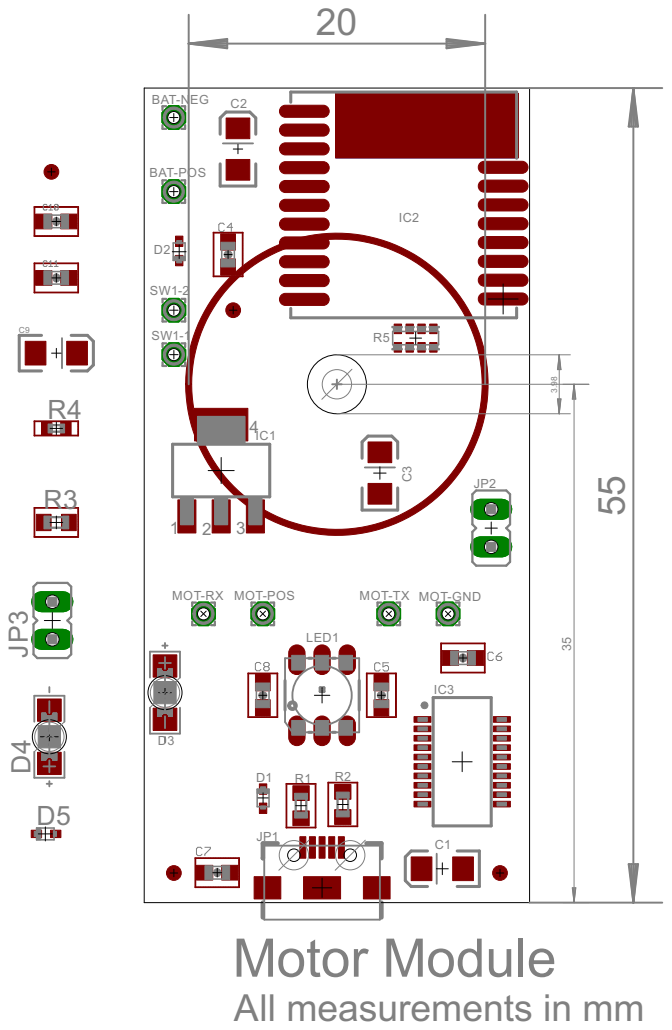
[picture p308: page 1]

Motor Module
All measurements in mm
