ZeroUI/Industrial-Quark/Ziro-master/Electronics/V1.0 Bluetooth/Hardware/Handimate_Backup/Motor Module/Motor Module PCB- v1 design 1.pdf

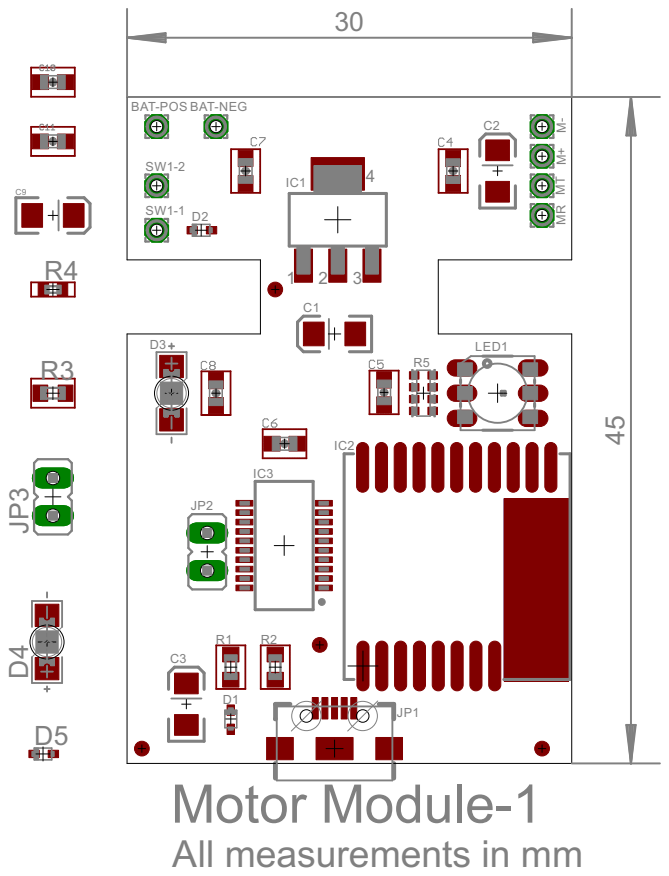
[picture p309: page 1]

BAT-POS BAT-NEG

Motor Module-1
All measurements in mm
