ZeroUI/Industrial-Quark/Ziro-master/Electronics/V1.0 Bluetooth/Hardware/Handimate_Backup/Motor Module/Motor Module Schematics- v1.pdf

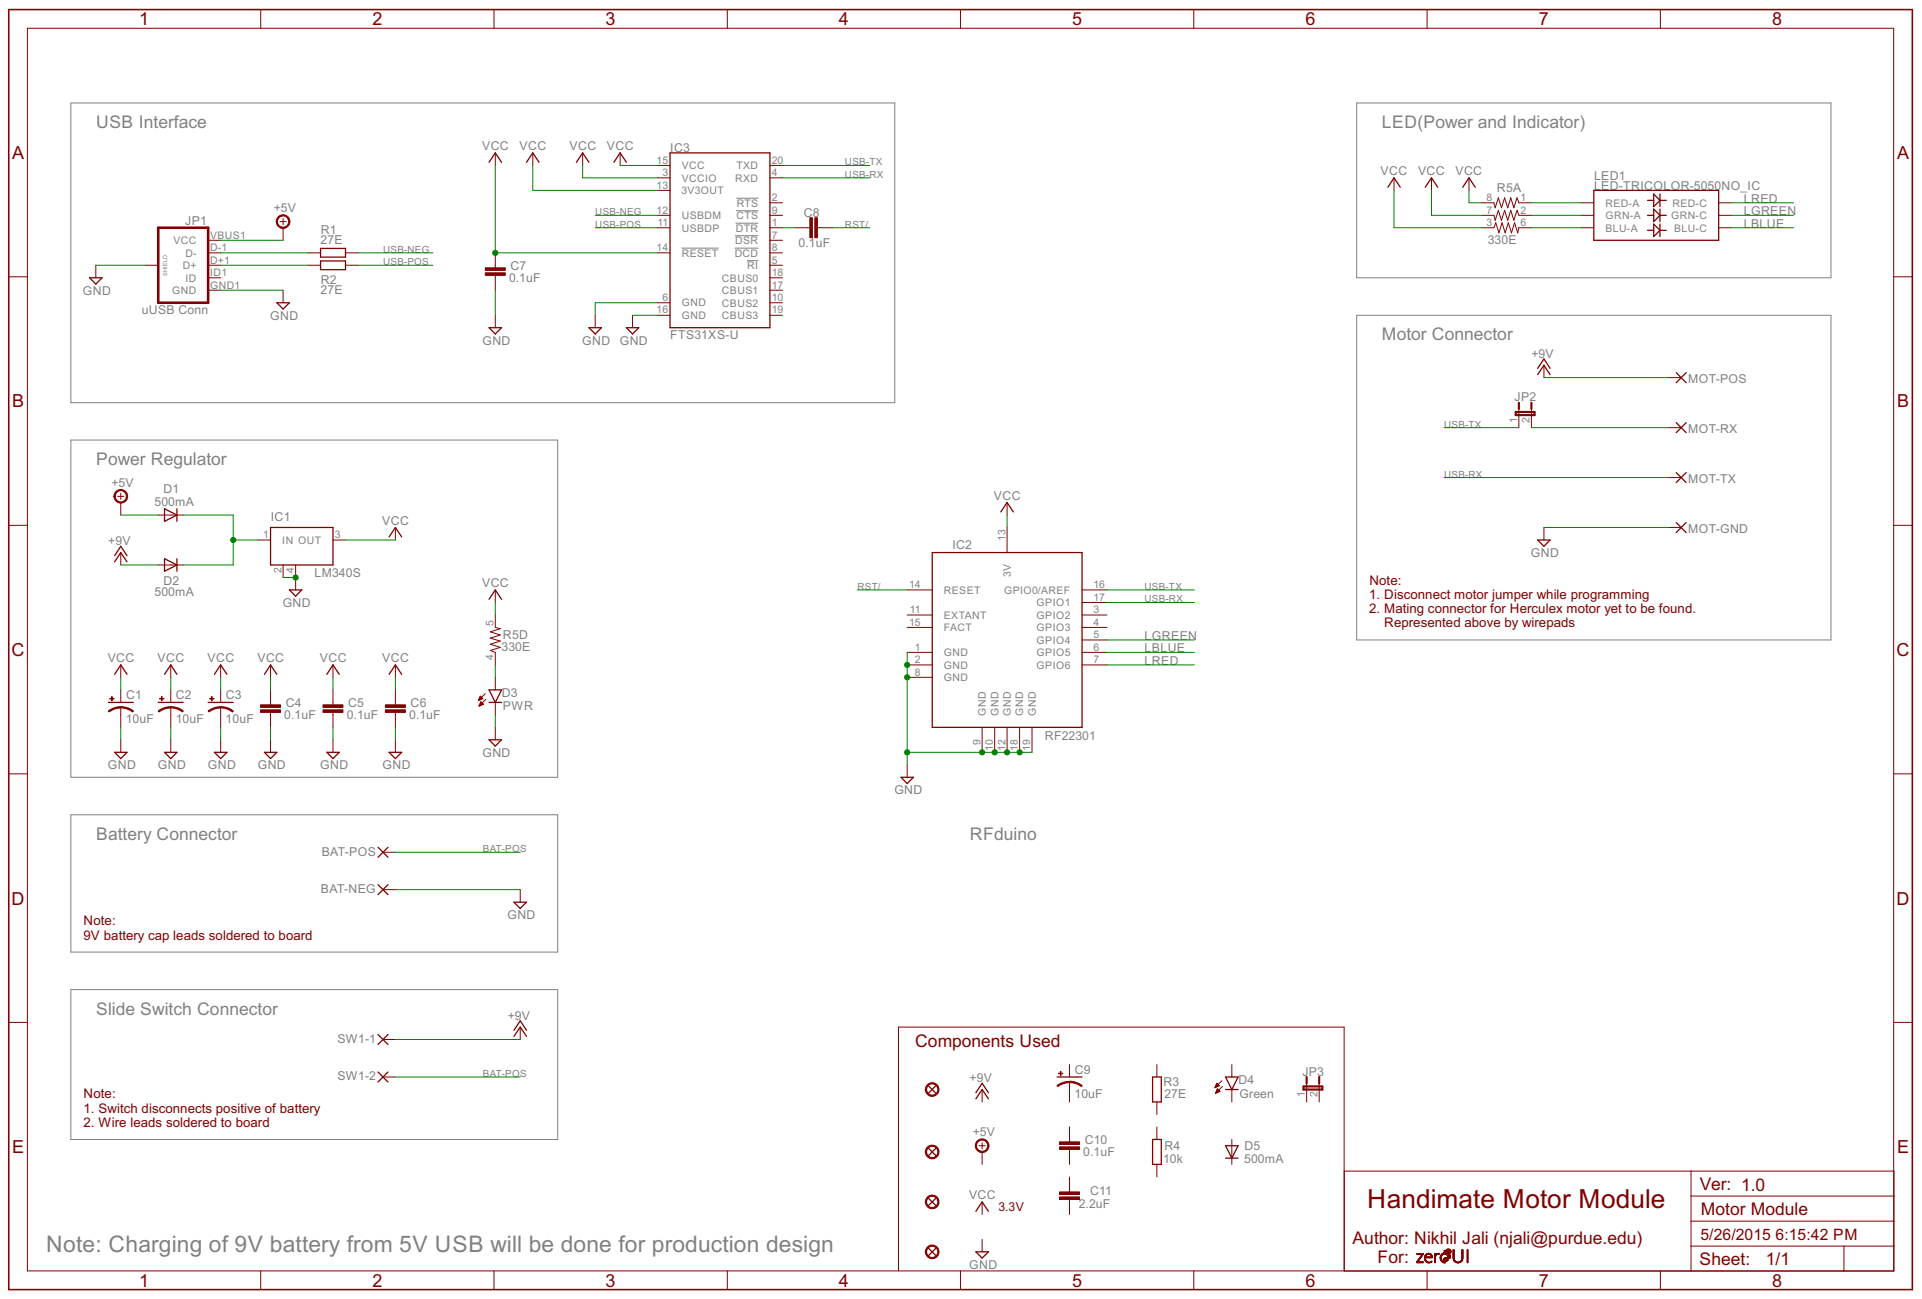
[picture p310: page 1]

MOT-POS MOT-RX MOT-TX MOT-GND

Note: 1. Disconnect motor jumper while programming

2. Mating connector for Herculex motor yet to be found. Represented above by wirepads

Note: 9V battery cap leads soldered to board

Components Used VCC

Ver: Author: Nikhil Jali (njali@purdue.edu)
1.0 Handimate Motor Module

Note: Charging of 9V battery from 5V USB will be done for production design

Sheet: 1/1
