ZeroUI/Industrial-Quark/Ziro-master/Mechanical/Ziro 2.0/Glove Design/Textiles/Brooks Pattern/1_Main Pattern Top.pdf

1-Main Pattern Top
Green - Stitch Lines
Black - Cut Lines
