ZeroUI/Industrial-Quark/Ziro-master/Mechanical/Ziro 2.0/Glove Design/Textiles/Brooks Pattern/2_Main Pattern Bottom.pdf

2-Main Pattern Bottom
Green - Stitch Lines
Black - Cut Lines
