ZeroUI/Industrial-Quark/Ziro-master/Mechanical/Ziro 2.0/Module/Quark/Gears/Drawings/PDFs/Gear 3___Large_43Teeth_0.3Modulus__Small_9Teeth_0.4Modulus.PDF

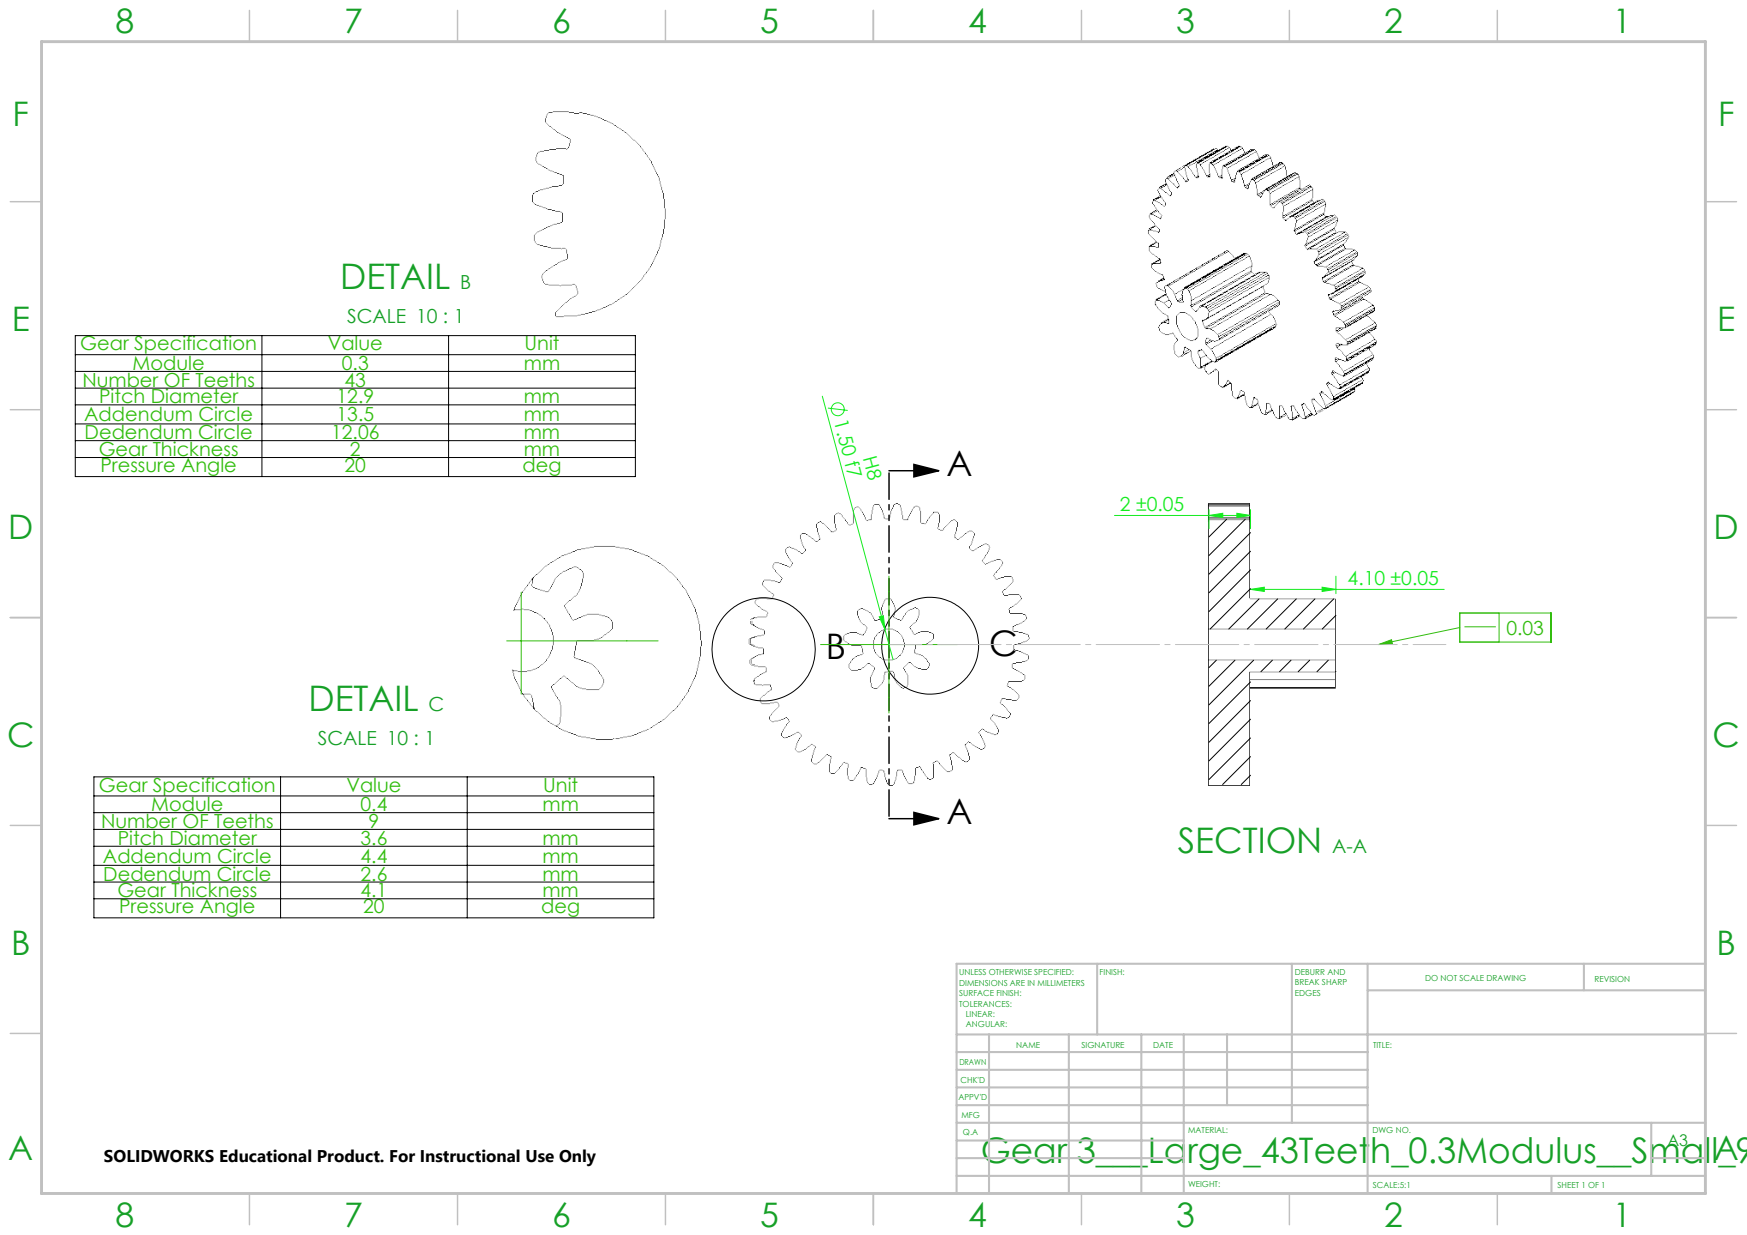
[picture p312: page 1]
SECTION A-A; DETAIL B; SCALE 10 : 1; DETAIL C; FINISH:; DEBURR AND; BREAK SHARP; DO NOT SCALE DRAWING; REVISION; SCALE:5:1; SHEET 1 OF 1; SOLIDWORKS Educational Product. For Instructional Use Only; Gear 3___Large_43Teeth_0.3Modulus__Small_9Teeth_0.4Modulus

Gear Specification | Value | Unit
Module | 0.3 | mm
Number OF Teeths | 43
Pitch Diameter | 12.9 | mm
Addendum Circle | 13.5 | mm
Dedendum Circle | 12.06 | mm
Gear Thickness | 2 | mm
Pressure Angle | 20 | deg

Module | 0.4 | mm
Number OF Teeths | 9
Pitch Diameter | 3.6 | mm
Addendum Circle | 4.4 | mm
Dedendum Circle | 2.6 | mm
Gear Thickness | 4.1 | mm

UNLESS OTHERWISE SPECIFIED:
DIMENSIONS ARE IN MILLIMETERS
SURFACE FINISH:
TOLERANCES:
LINEAR:
ANGULAR:

NAME | SIGNATURE | DATE | | | | TITLE:

DRAWN
CHK'D
APPV'D
MFG
Q.A | | | | MATERIAL: | DWG NO. | A3
