ZeroUI/Industrial-Quark/Ziro-master/Mechanical/Ziro 2.0/Module/Quark/Gears/Drawings/PDFs/Gear Drawings.pdf

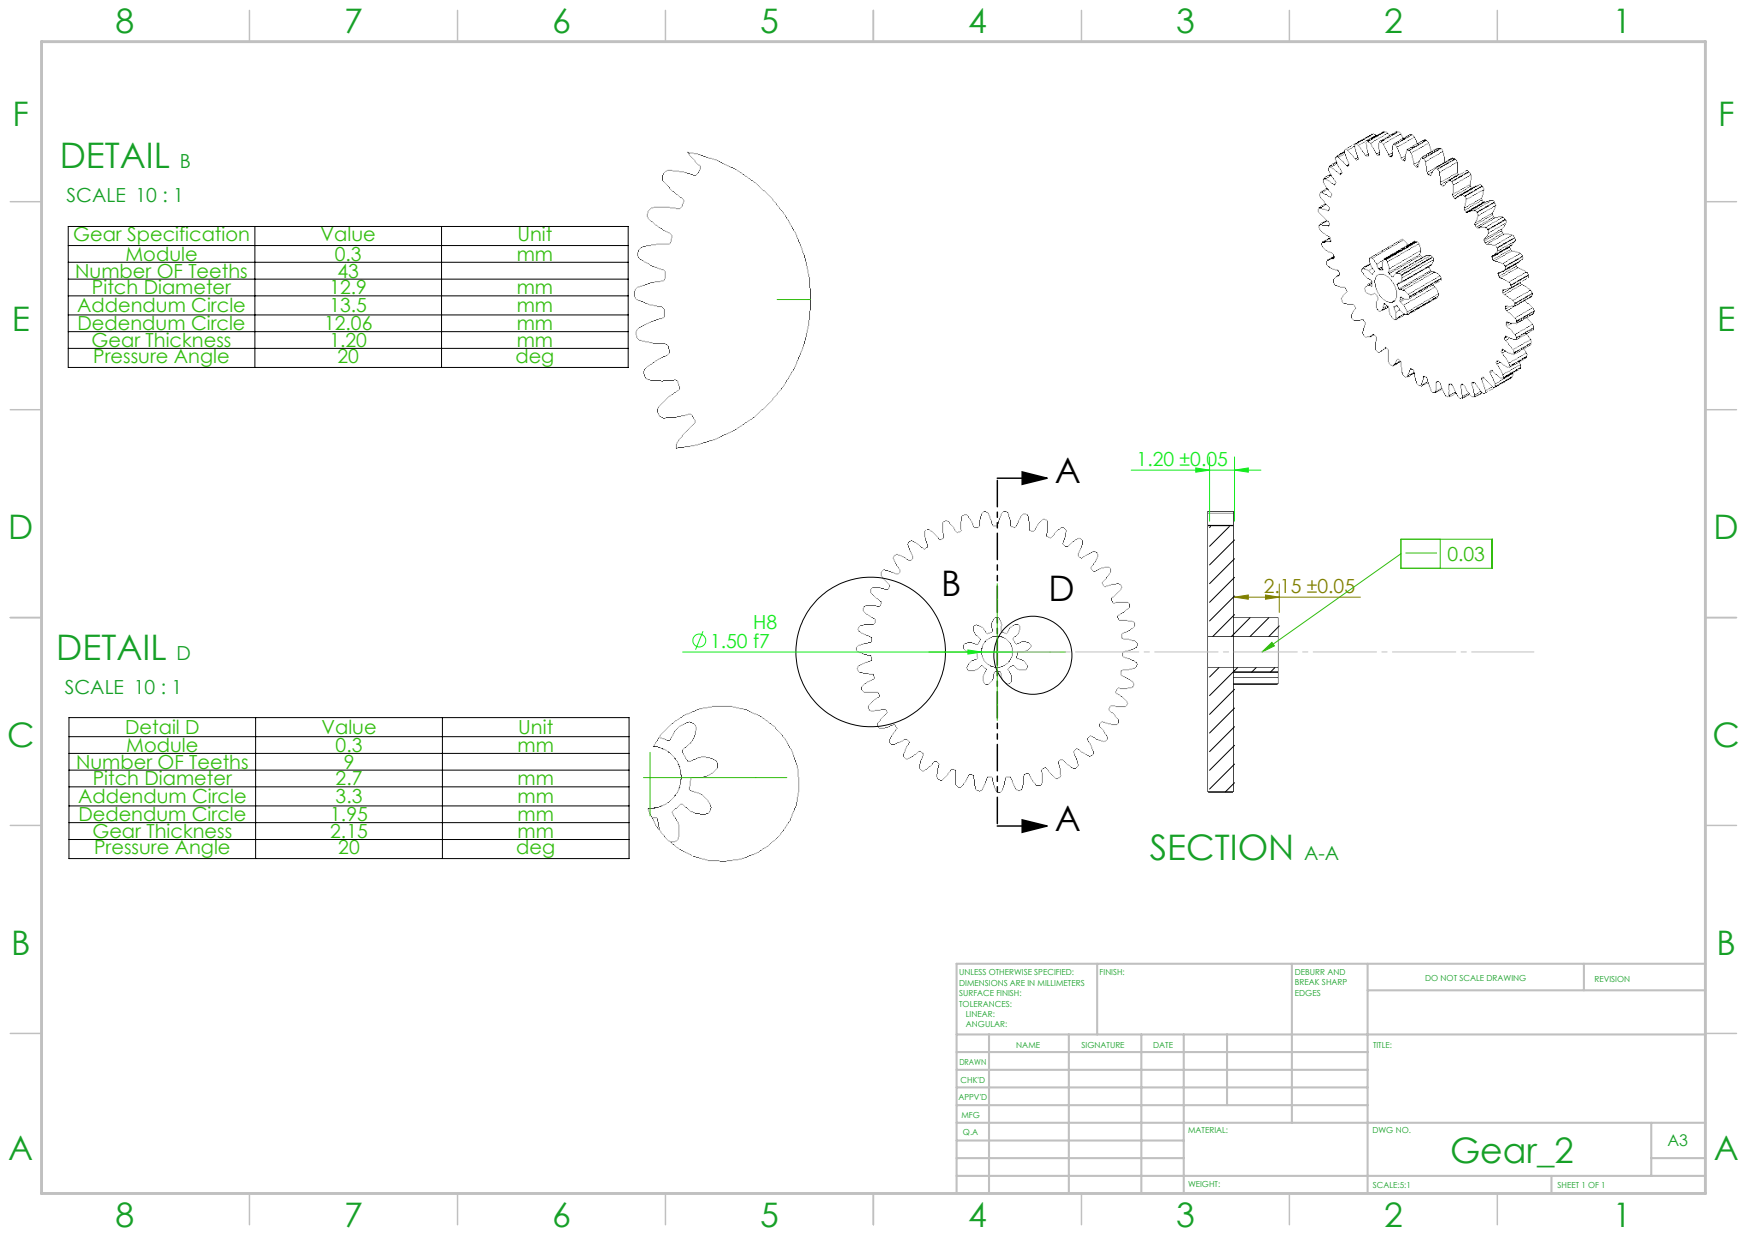
[picture p313: page 1]
SECTION A-A; DETAIL B; SCALE 10 : 1; DETAIL D; FINISH:; DEBURR AND; BREAK SHARP; DO NOT SCALE DRAWING; REVISION; SCALE:5:1; SHEET 1 OF 1

Gear Specification | Value | Unit
Module | 0.3 | mm
Number OF Teeths | 43
Pitch Diameter | 12.9 | mm
Addendum Circle | 13.5 | mm
Dedendum Circle | 12.06 | mm
Gear Thickness | 1.20 | mm
Pressure Angle | 20 | deg

Detail D | Value | Unit
Number OF Teeths | 9
Pitch Diameter | 2.7 | mm
Addendum Circle | 3.3 | mm
Dedendum Circle | 1.95 | mm
Gear Thickness | 2.15 | mm

UNLESS OTHERWISE SPECIFIED:
DIMENSIONS ARE IN MILLIMETERS
SURFACE FINISH:
TOLERANCES:
LINEAR:
ANGULAR:

NAME | SIGNATURE | DATE | | | | TITLE:

DRAWN
CHK'D
APPV'D
MFG
Q.A | | | | MATERIAL: | DWG NO. Gear_2 | A3

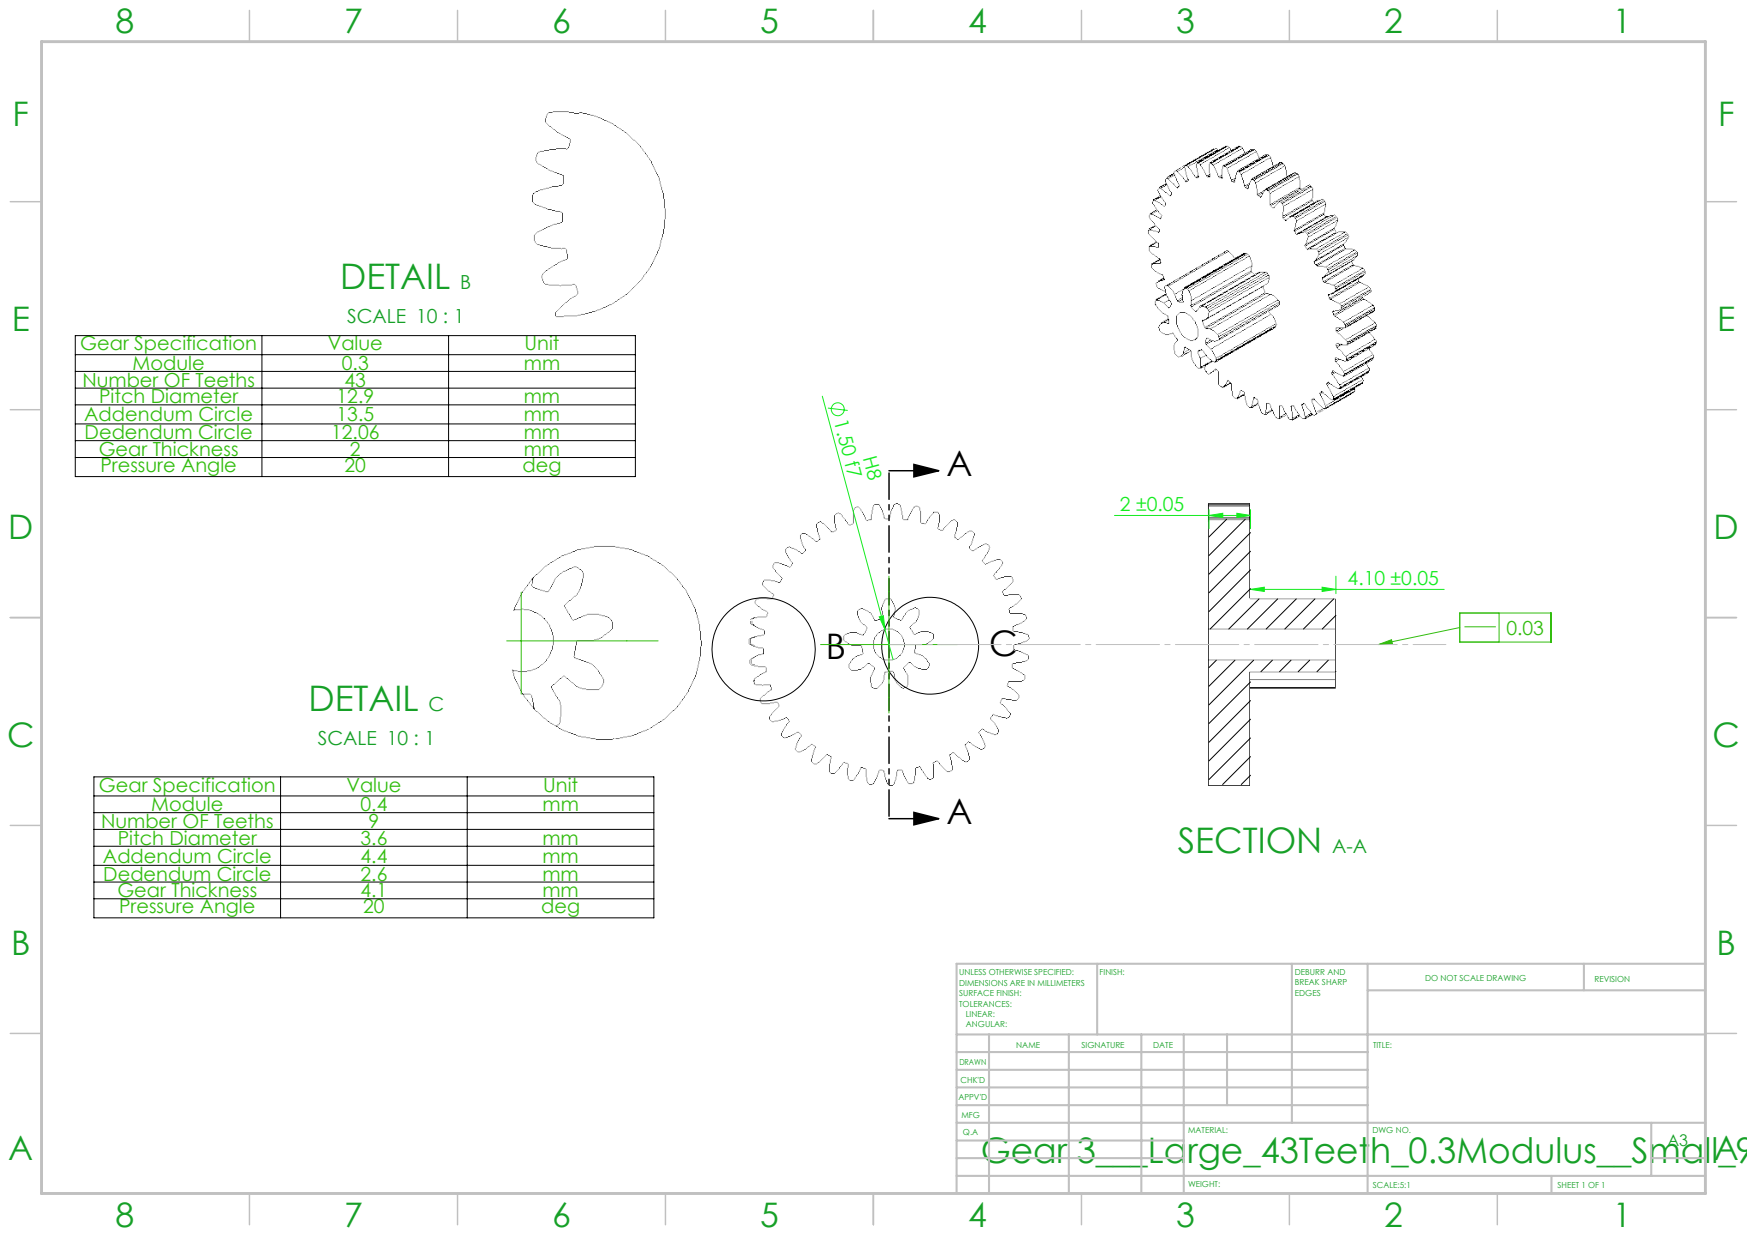
[picture p314: page 2]
SECTION A-A; DETAIL B; SCALE 10 : 1; DETAIL C; FINISH:; DEBURR AND; BREAK SHARP; DO NOT SCALE DRAWING; REVISION; Gear 3___Large_43Teeth_0.3Modulus__Small_9Teeth_0.4Modulus

Gear Specification | Value | Unit
Module | 0.3 | mm
Number OF Teeths | 43
Pitch Diameter | 12.9 | mm
Addendum Circle | 13.5 | mm
Dedendum Circle | 12.06 | mm
Gear Thickness | 2 | mm
Pressure Angle | 20 | deg

Module | 0.4 | mm
Number OF Teeths | 9
Pitch Diameter | 3.6 | mm
Addendum Circle | 4.4 | mm
Dedendum Circle | 2.6 | mm
Gear Thickness | 4.1 | mm

UNLESS OTHERWISE SPECIFIED:
DIMENSIONS ARE IN MILLIMETERS
SURFACE FINISH:
TOLERANCES:
LINEAR:
ANGULAR:

NAME | SIGNATURE | DATE | TITLE:

DRAWN
CHK'D
APPV'D
MFG

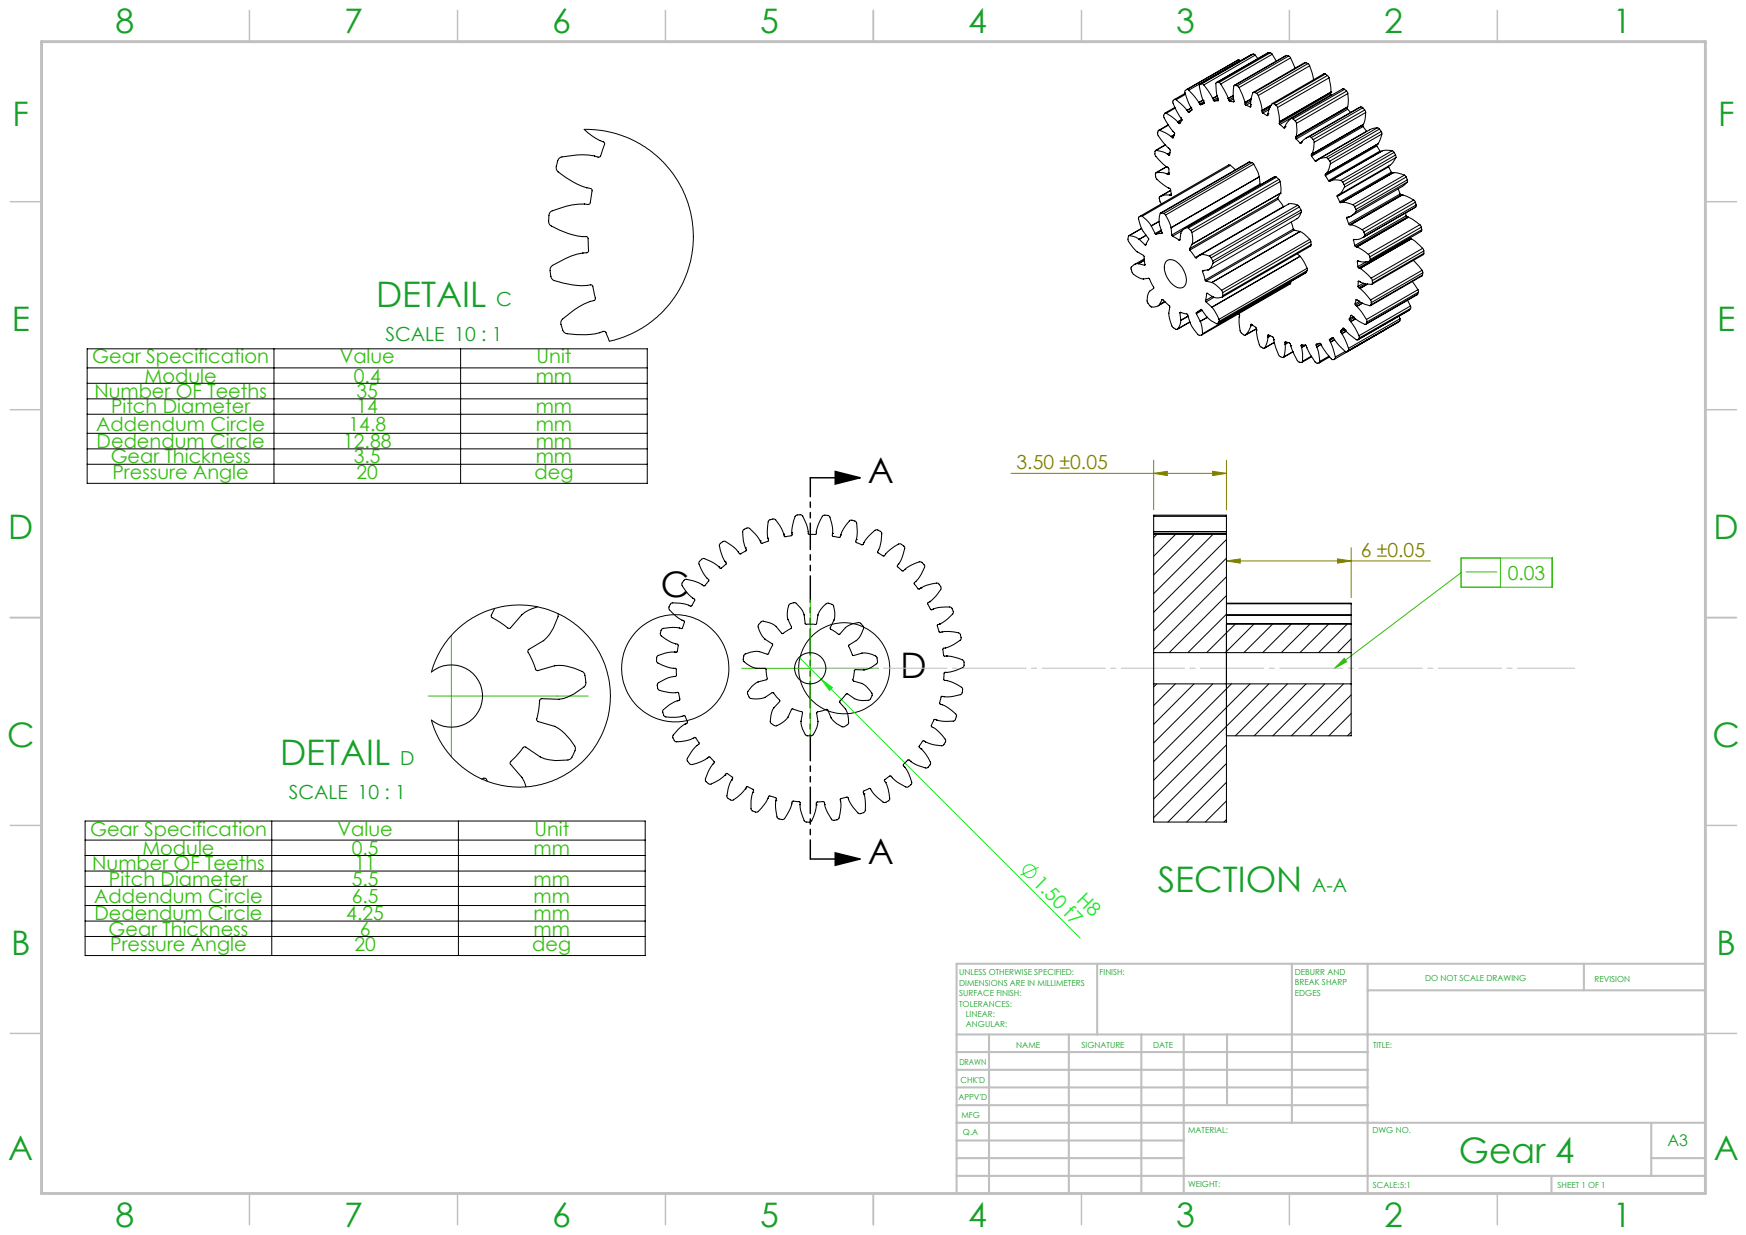
[picture p315: page 3]
SECTION A-A; DETAIL C; SCALE 10 : 1; DETAIL D; FINISH:; DEBURR AND; BREAK SHARP; DO NOT SCALE DRAWING; REVISION

Gear Specification | Value | Unit
Module | 0.4 | mm
Number OF Teeths | 35
Pitch Diameter | 14 | mm
Addendum Circle | 14.8 | mm
Dedendum Circle | 12.88 | mm
Gear Thickness | 3.5 | mm
Pressure Angle | 20 | deg

Module | 0.5 | mm
Number OF Teeths | 11
Pitch Diameter | 5.5 | mm
Addendum Circle | 6.5 | mm
Dedendum Circle | 4.25 | mm
Gear Thickness | 6 | mm

UNLESS OTHERWISE SPECIFIED:
DIMENSIONS ARE IN MILLIMETERS
SURFACE FINISH:
TOLERANCES:
LINEAR:
ANGULAR:

NAME | SIGNATURE | DATE | | TITLE:

DRAWN
CHK'D
APPV'D
MFG

Gear 4

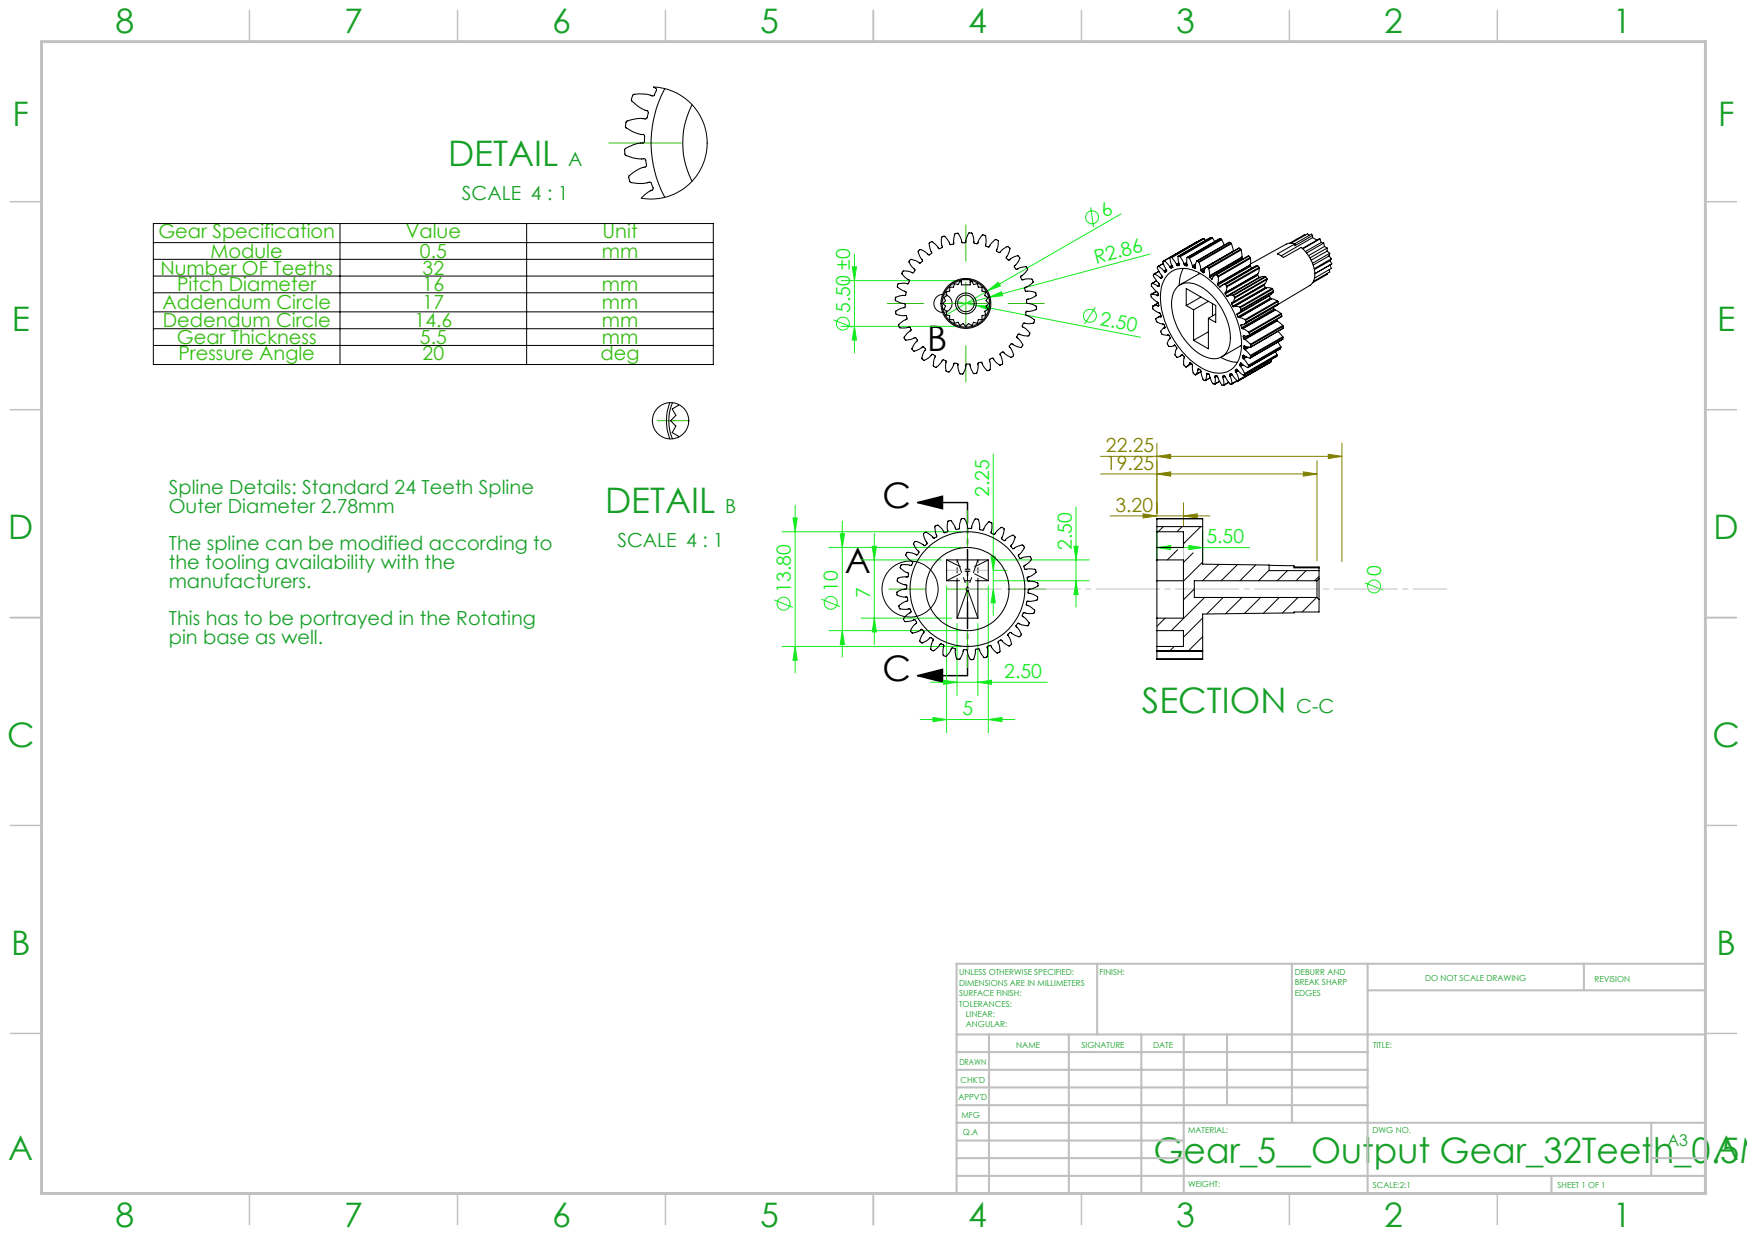
[picture p316: page 4]
DETAIL A; SCALE 4 : 1; DETAIL B; SECTION C-C; FINISH:; DEBURR AND; BREAK SHARP; DO NOT SCALE DRAWING; REVISION; SCALE:2:1; SHEET 1 OF 1; Gear_5__Output Gear_32Teeth_0.5Modulus

Gear Specification | Value | Unit
Module | 0.5 | mm
Number OF Teeths | 32
Pitch Diameter | 16 | mm
Addendum Circle | 17 | mm
Dedendum Circle | 14.6 | mm
Gear Thickness | 5.5 | mm
Pressure Angle | 20 | deg

Spline Details: Standard 24 Teeth Spline
Outer Diameter 2.78mm
The spline can be modified according to
the tooling availability with the
manufacturers.
This has to be portrayed in the Rotating
pin base as well.

UNLESS OTHERWISE SPECIFIED:
DIMENSIONS ARE IN MILLIMETERS
SURFACE FINISH:
TOLERANCES:
LINEAR:
ANGULAR:

NAME | SIGNATURE | DATE | TITLE:

DRAWN
CHK'D
APPV'D
MFG

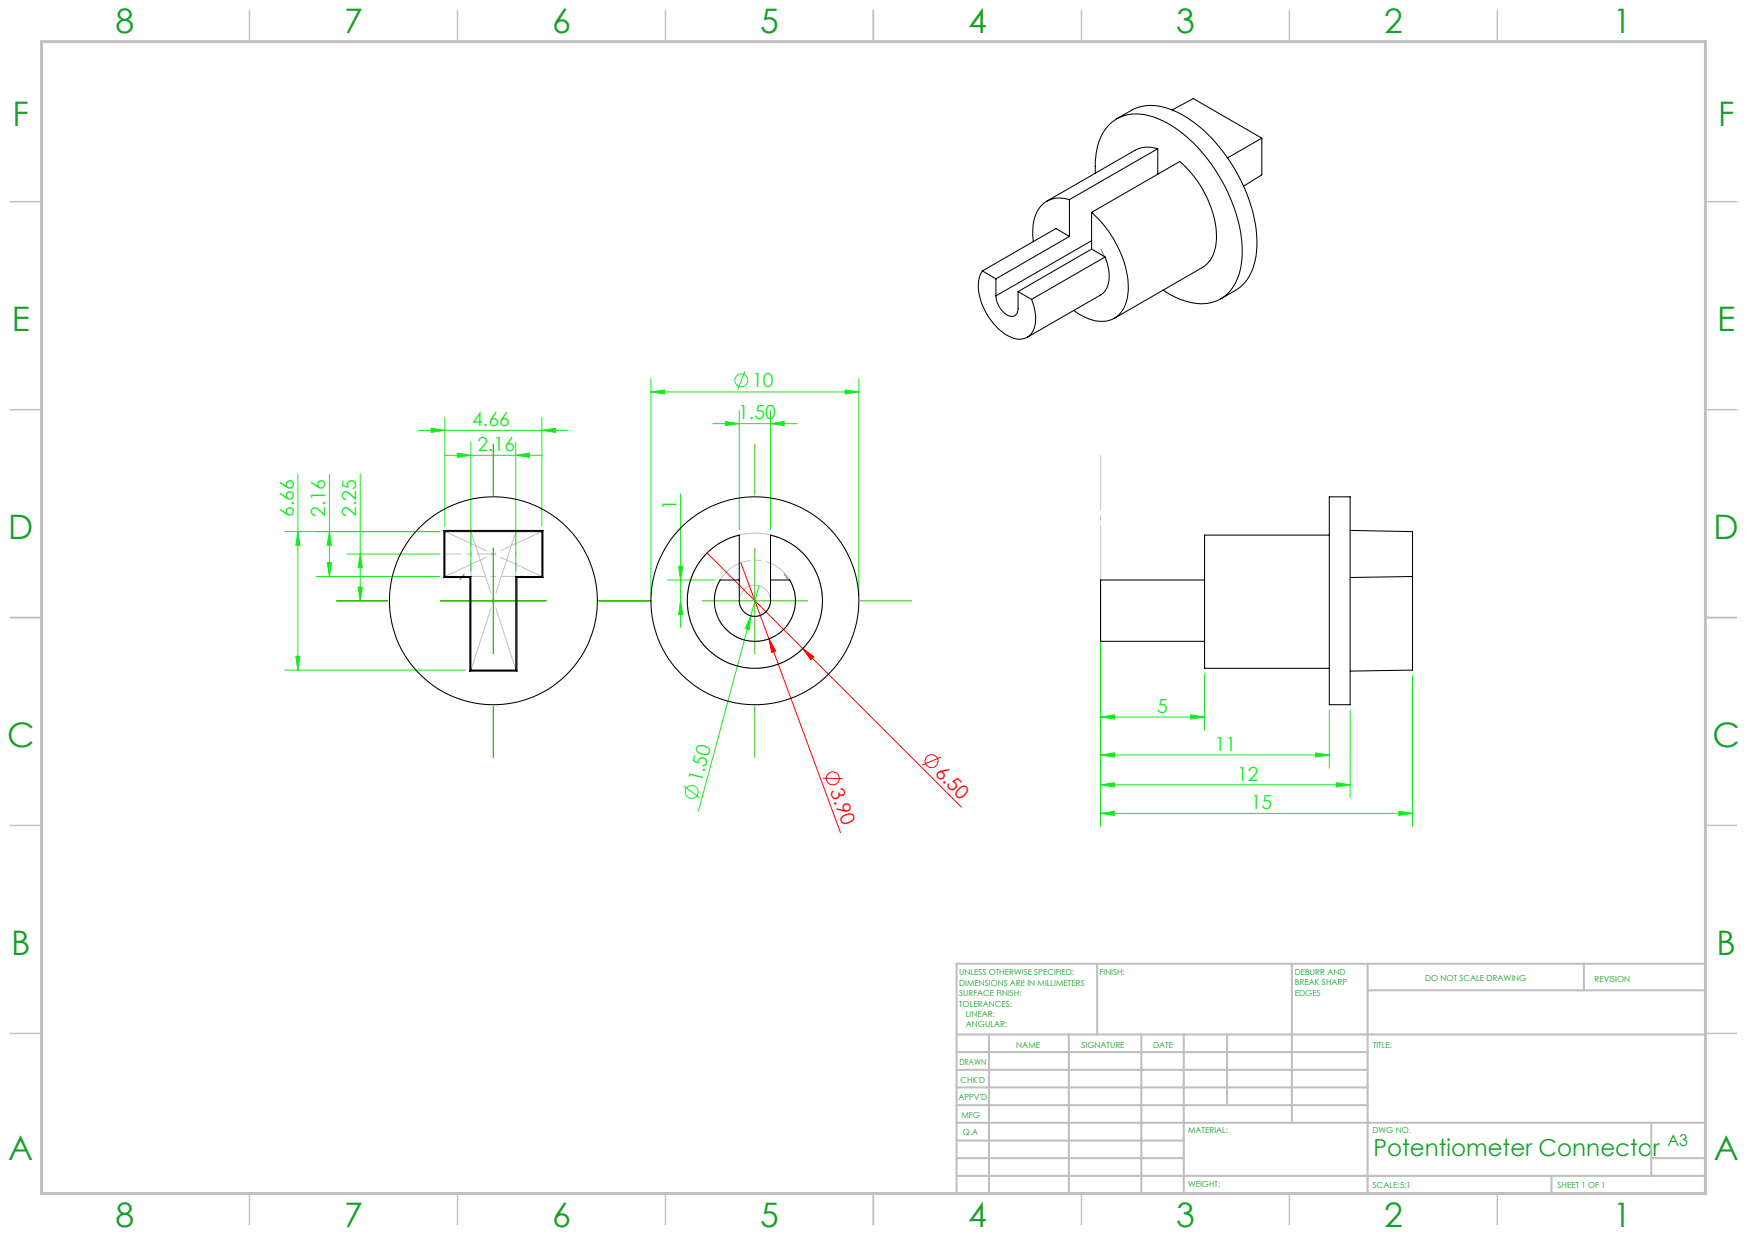
[picture p317: page 5]
FINISH:; DEBURR AND; BREAK SHARP; DO NOT SCALE DRAWING; REVISION

UNLESS OTHERWISE SPECIFIED:
DIMENSIONS ARE IN MILLIMETERS
SURFACE FINISH:
TOLERANCES:
LINEAR:
ANGULAR:

NAME | SIGNATURE | DATE | | TITLE:

DRAWN
CHK'D
APPV'D
MFG

Potentiometer Connector
