ZeroUI/Industrial-Quark/Ziro-master/Mechanical/Ziro 2.0/Module/Quark/Gears/WireEDM/Mold Inserts/Drawings/pdfS/Tanuj_EDM_Inserts.pdf

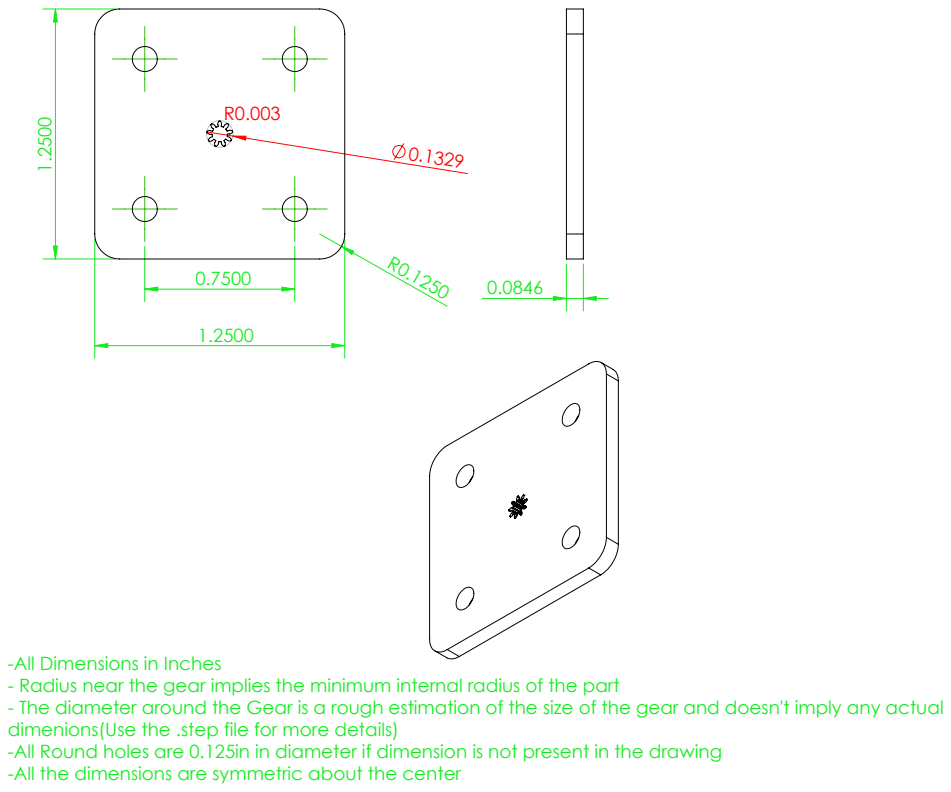
[picture p318: page 1]

-All Dimensions in Inches
- Radius near the gear implies the minimum internal radius of the part
- The diameter around the Gear is a rough estimation of the size of the gear and doesn't imply any actual
dimenions(Use the .step file for more details)
-All Round holes are 0.125in in diameter if dimension is not present in the drawing
-All the dimensions are symmetric about the center

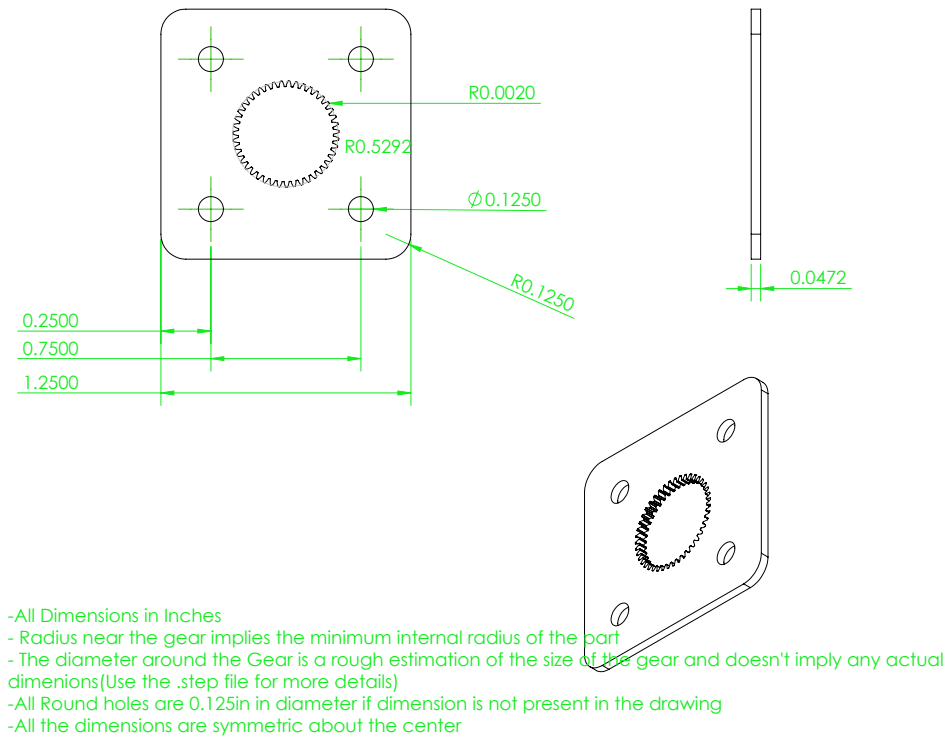
[picture p319: page 2]
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

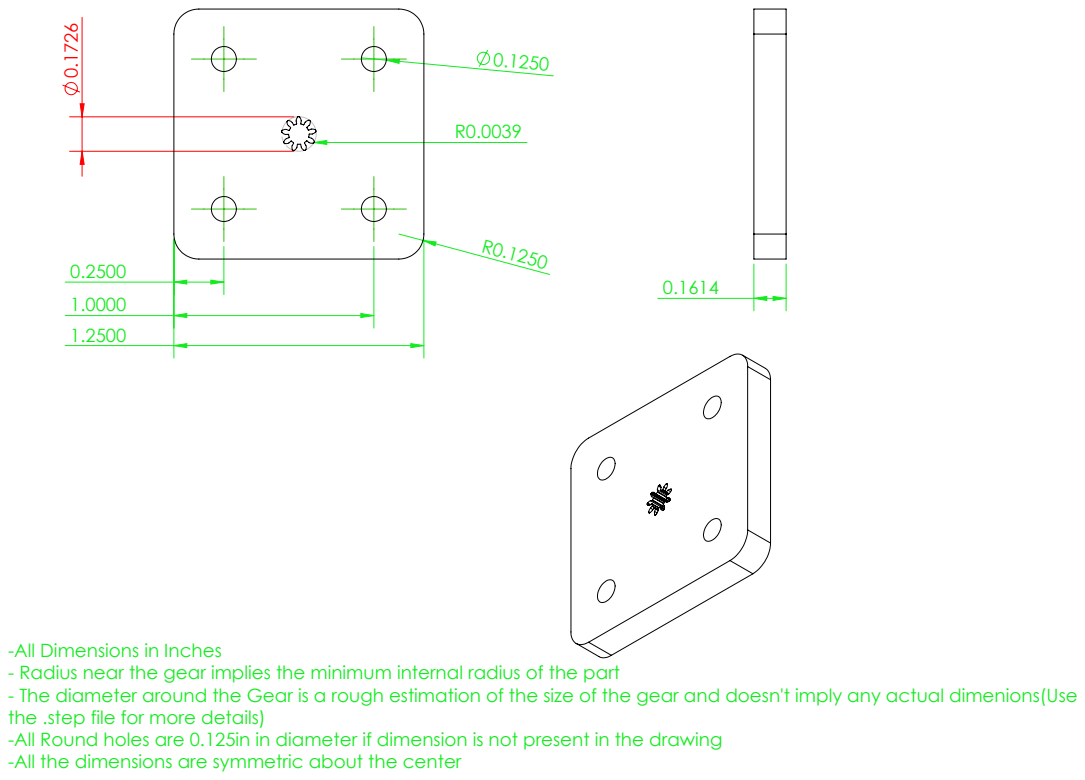
[picture p320: page 3]
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

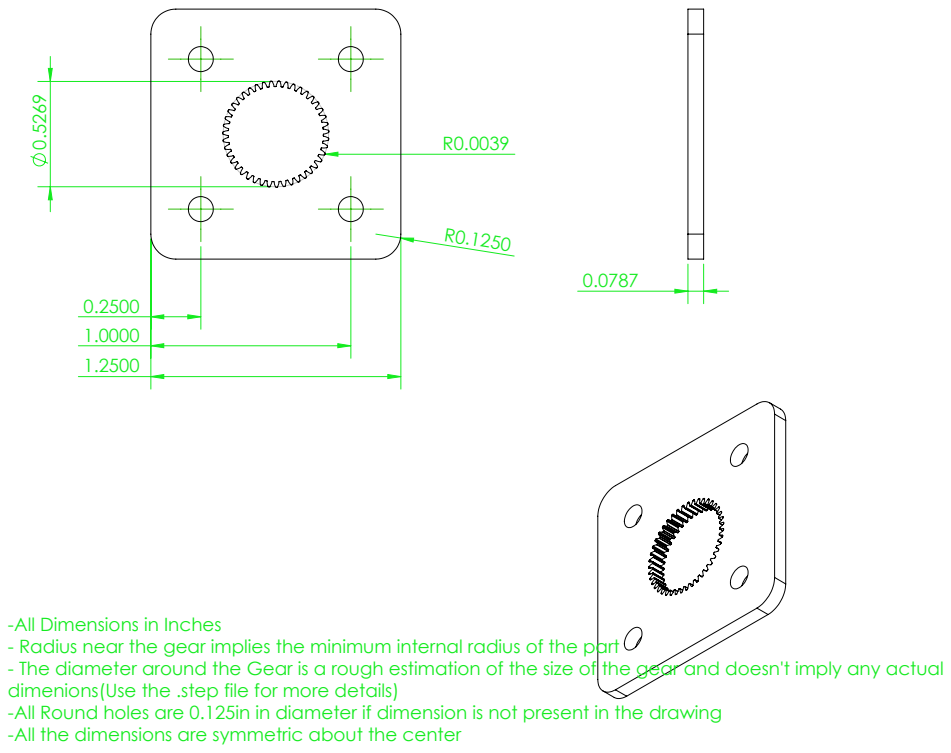
[picture p321: page 4]
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

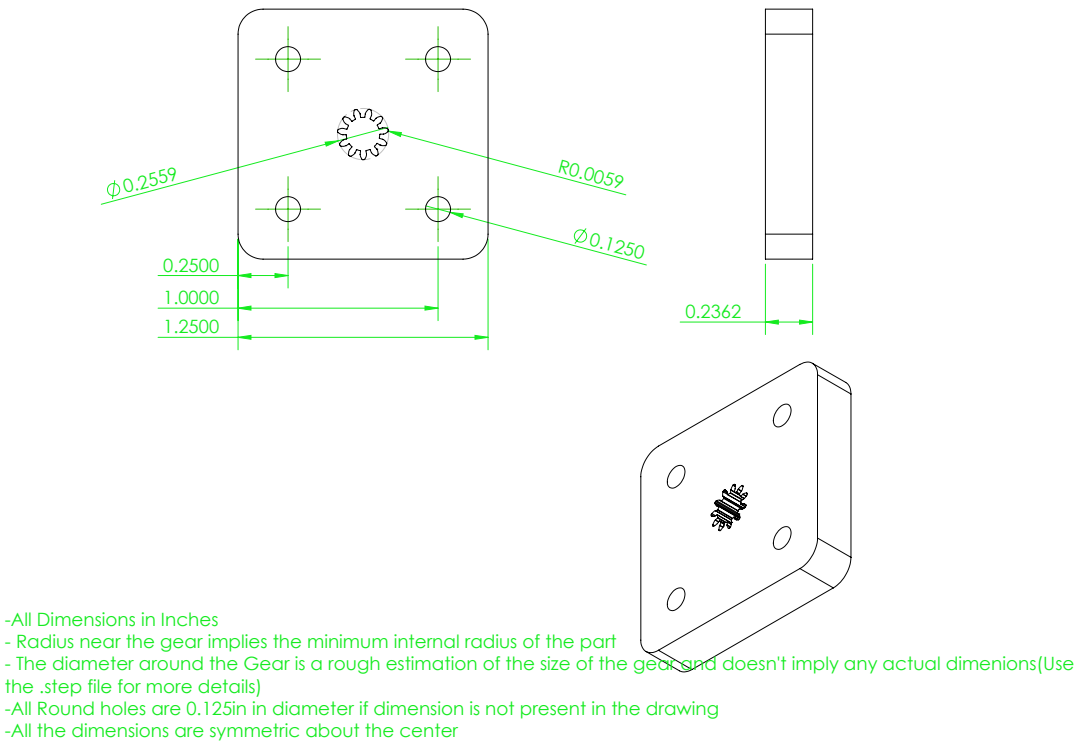
[picture p322: page 5]
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

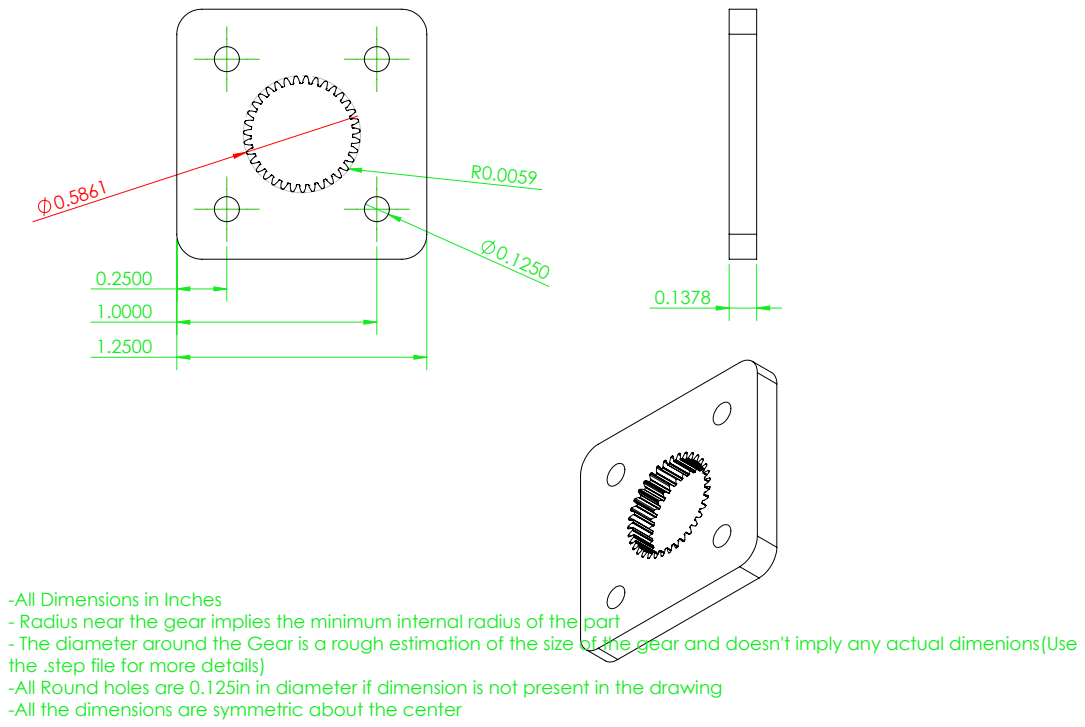
[picture p323: page 6]
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
