ZeroUI/Industrial-Quark/Ziro-master/BoM/Packaging/Box/Box Dimension and Outline.pdf

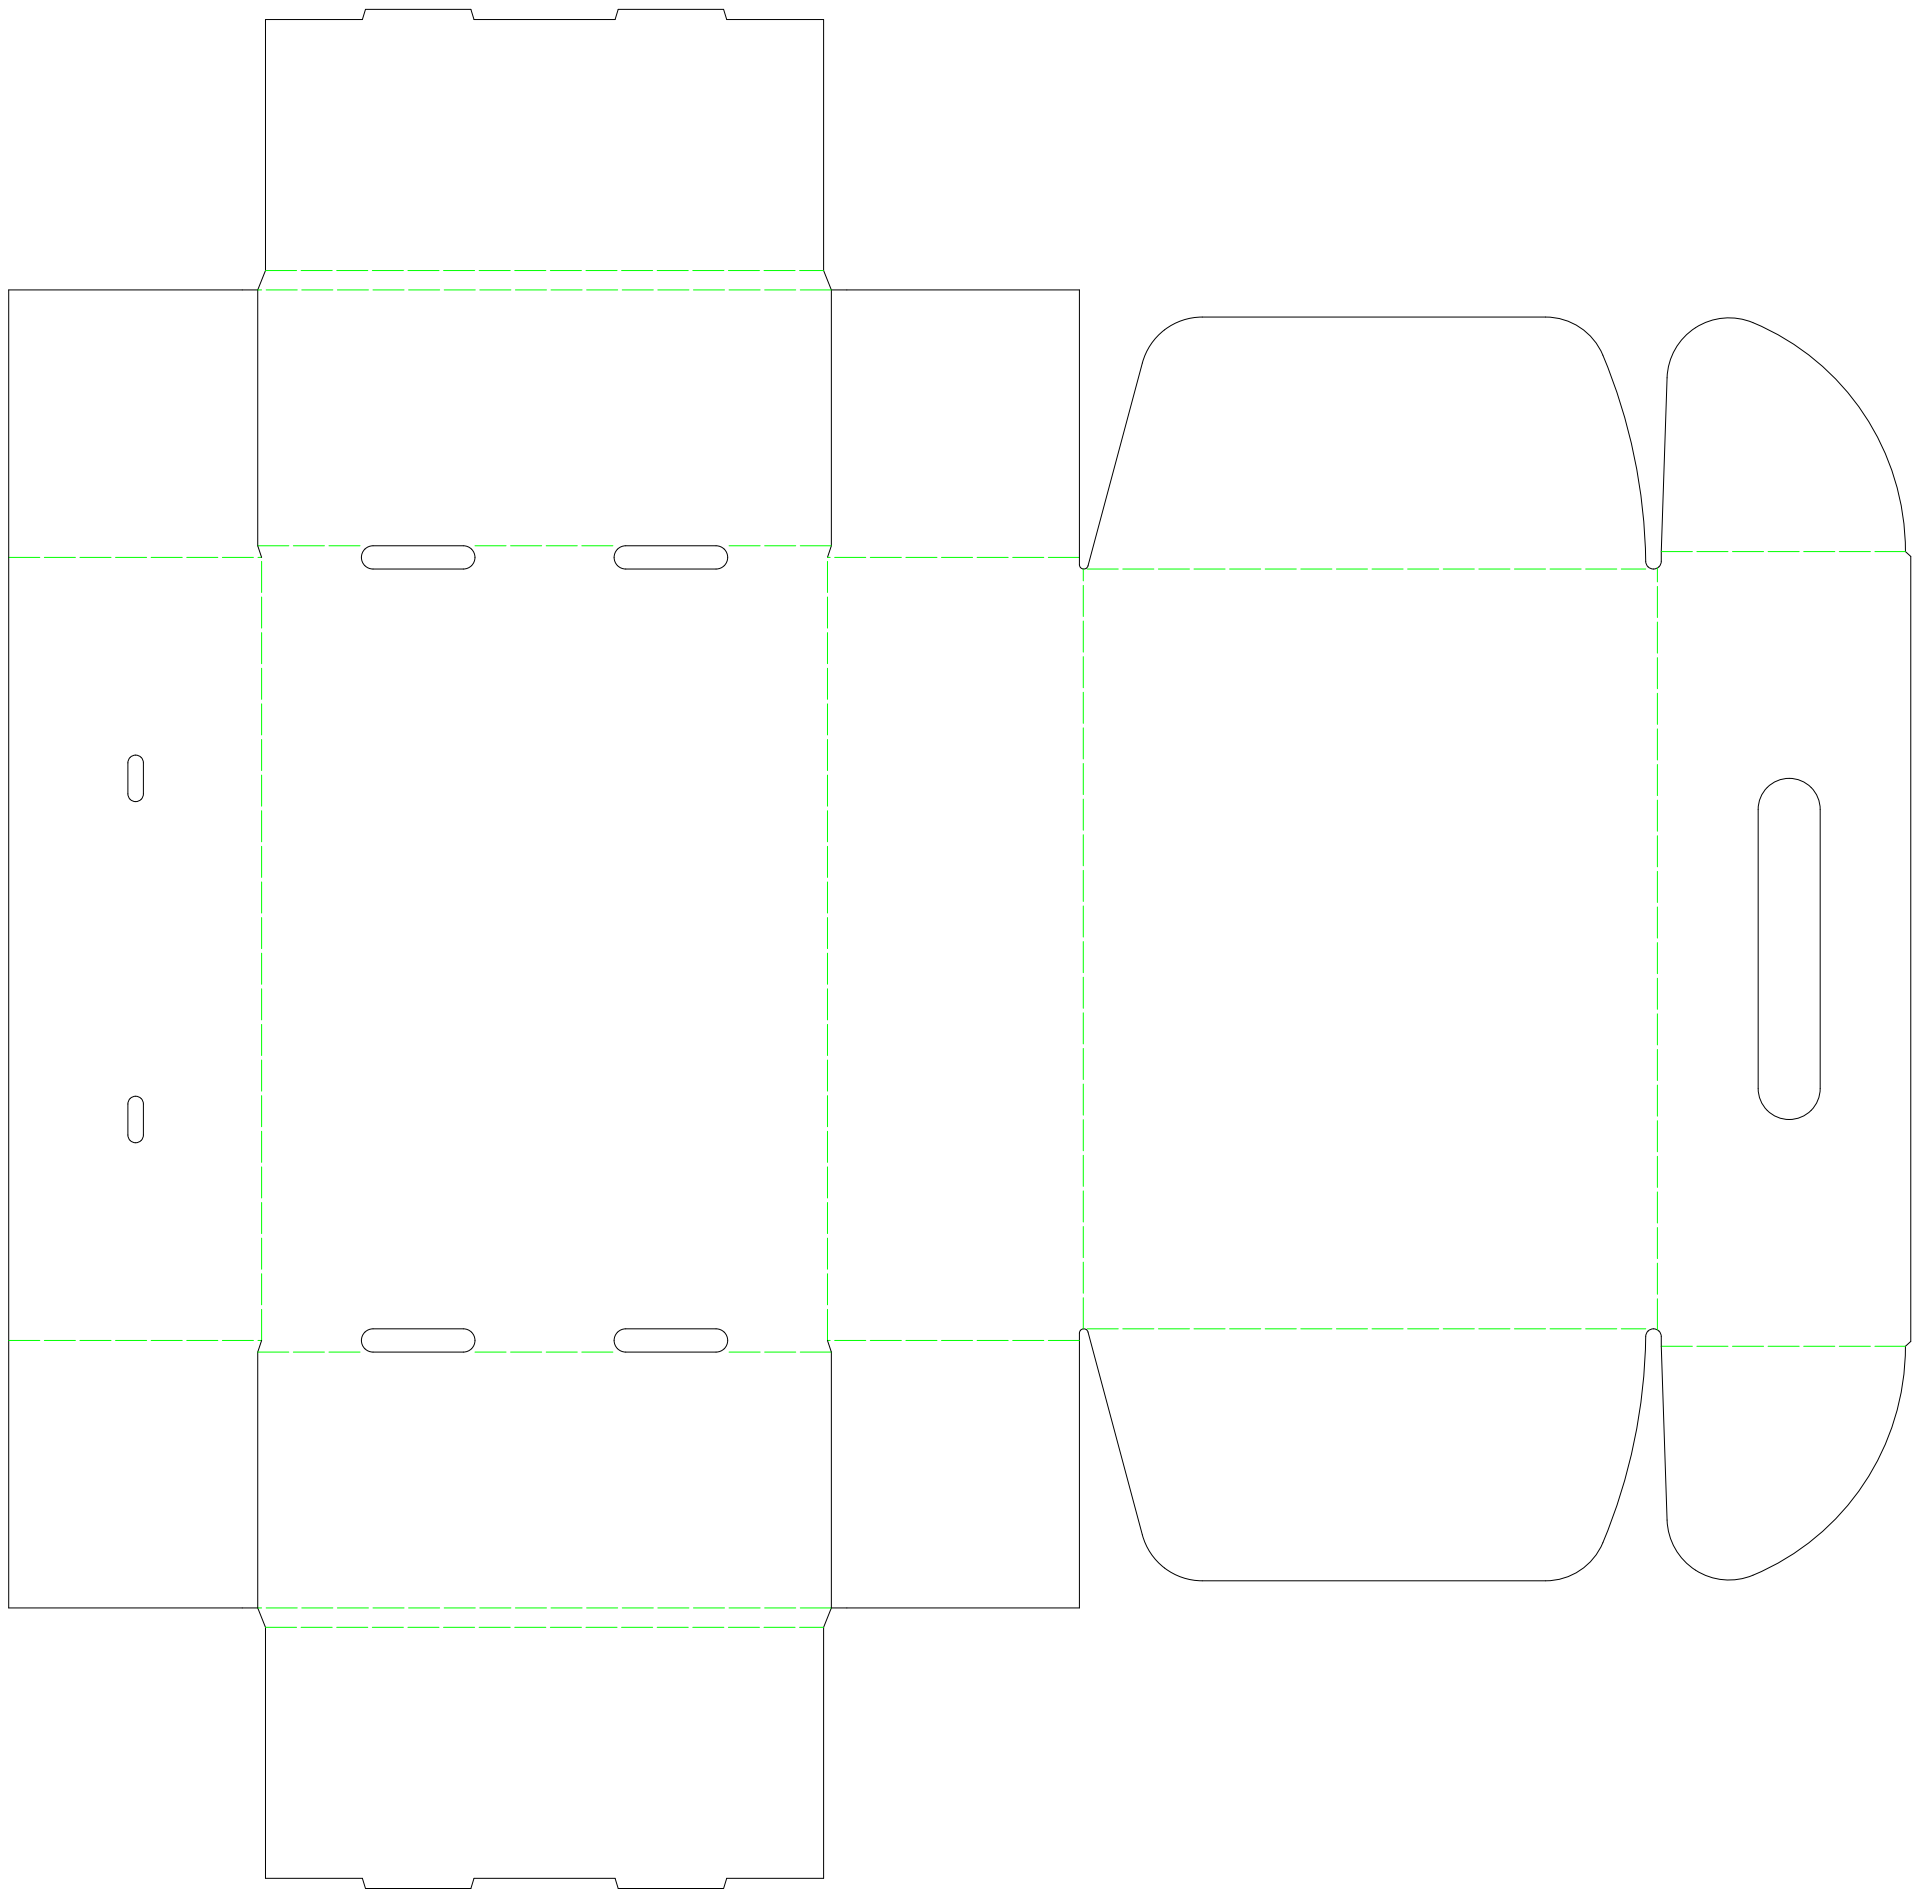
[picture p324: page 1]

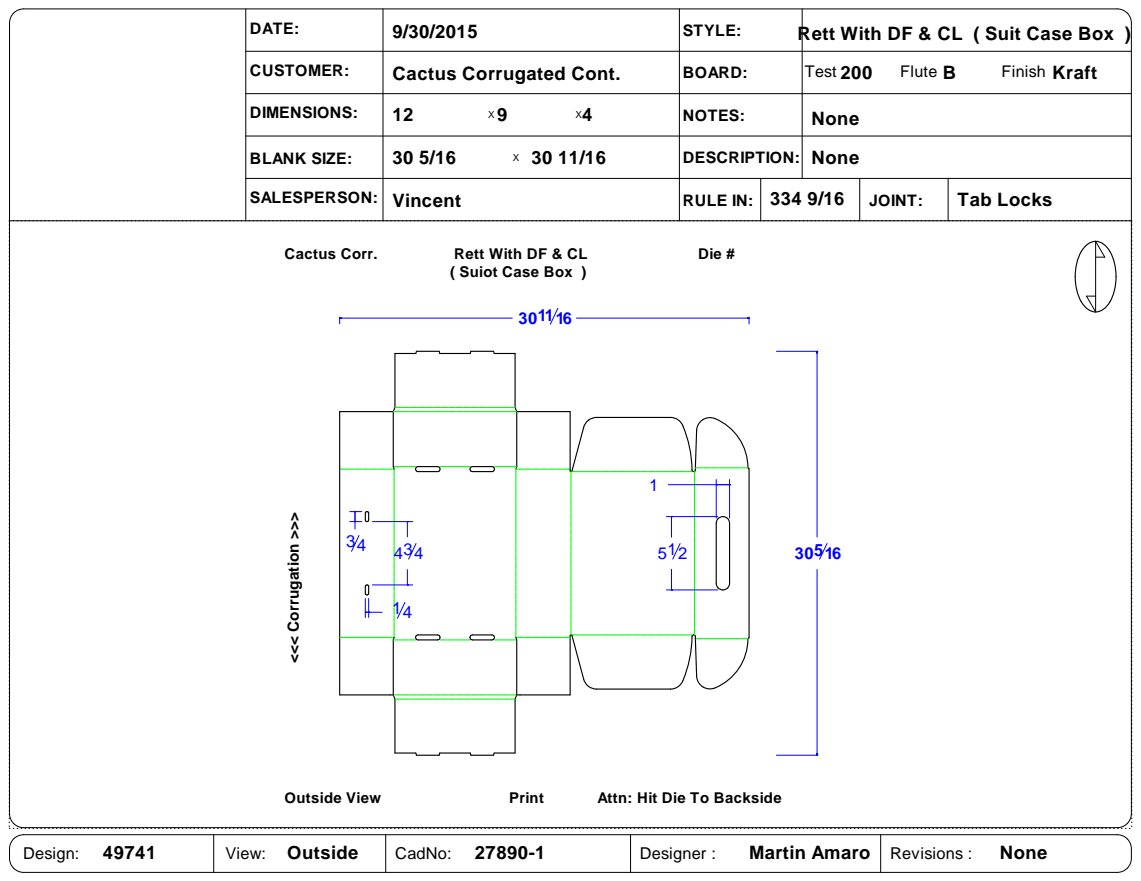
[picture p325: page 2]
OutsideView; Print; Attn:HitDieToBackside; CactusCorr.; orru; atio; RettW ithDF& CL; Die#; (SuiotCaseBox ); Design:; View: Outside; CadNo:; Designer:; MartinAmaro; Revisions:; None; STYLE:; DATE:

RettW ithDF& CL (SuitCaseBox )

CUSTOMER: | CactusCorrugatedCont. | BOARD: | Test 200 B Flute Finish Kraft

DIMENSIONS: | 12 X 9 X 4 | NOTES: | None

BLANK SIZE: | 30 5/16 X 30 11/16 | DESCRIPTION: | None

SALESPERSON: | Vincent | RULE IN: | 334 9/16 | JOINT: | Tab Locks
