ZeroUI/Industrial-Quark/Ziro-master/BoM/Glove Modules/PCB Shell/Glove-E1-PCB/PB03-1010L-16C-20(SUS250).pdf

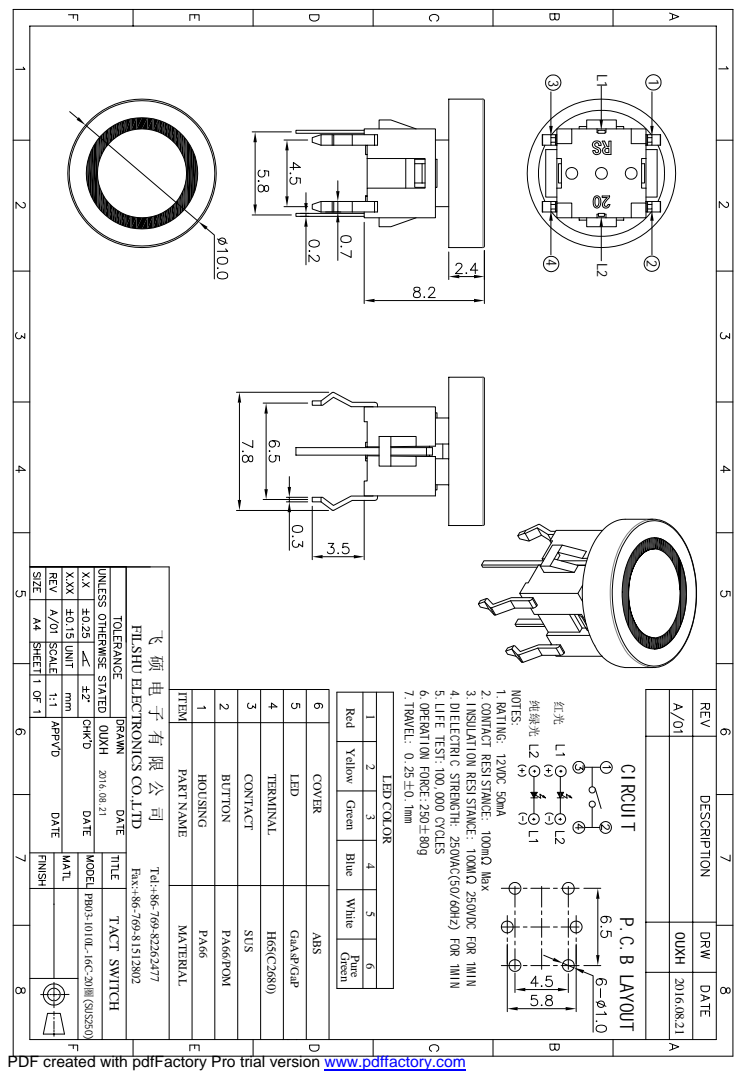
[picture p326: page 1]
CIRCUIT P.C.B LAYOUT; ITEM; P ART NAME; M ATE; RIAL; TERMINAL; B UTTON; CON; T ACT SUS; P A66/POM; HOUSING; NOTES:; 1.RATING: 12VDC 50mA; 3.INS; ULATION; RESISTANCE: 100M 250VDC FOR 1MIN; 4.DIELECT; RIC; ST RENGT; H: 250VAC(50/60Hz) FOR 1MIN; 6.OPERATION FORCE:250; RAVEL: 0.25; FIL SHU EL; ECT; Tel:+86-769-82262477; Fax:+86-769-81512802; OUXH 2016.08.21; T ACT; S WITCH; PB03-1010L-16C-20圈(SUS250); Blue; Red; Yellow; Green; Green Pure; White; L E D C O LOR; LED; GaAsP/GaP; COVER; ABS

5.LIFE TEST:100,000 CYCLES

2.CONTACT RESISTANCE: 100m Max

RONICS CO.,LTD

PDF created with pdfFactory Pro trial version www.pdffactory.com
