ZeroUI/Industrial-Quark/Ziro-master/BoM/Motor Modules/Quark/E1-PCB/Motor-Dong HUI Brushed 3.65-7V.pdf

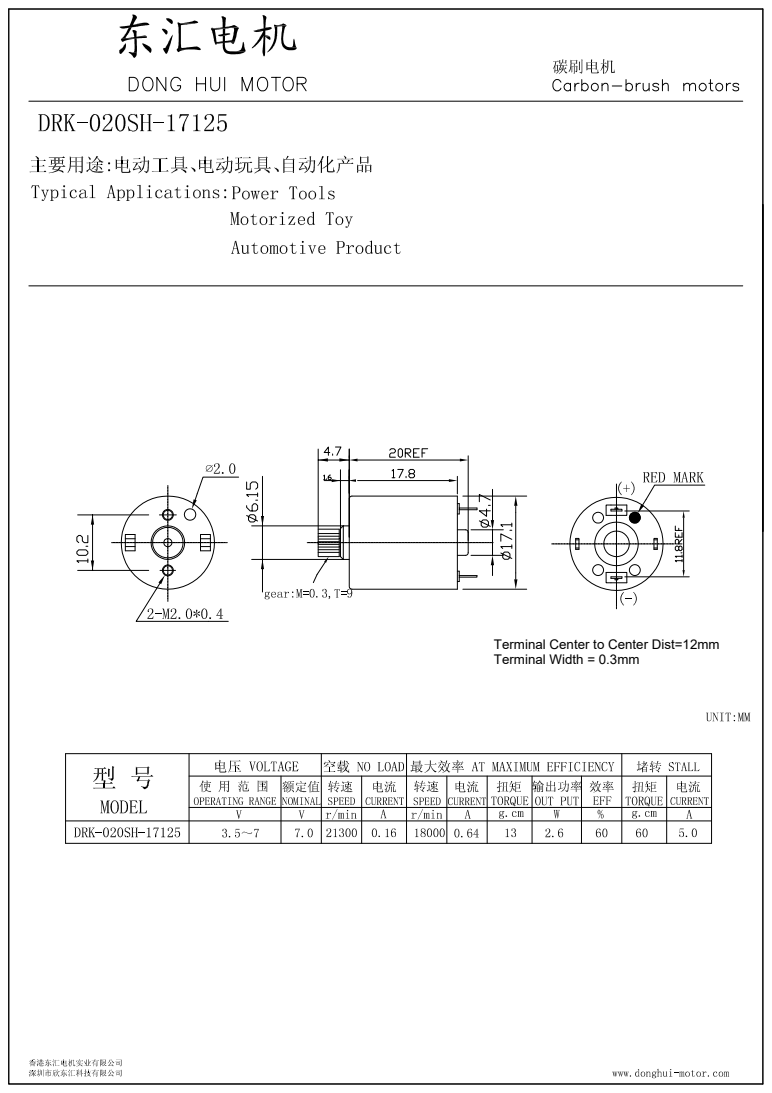
[picture p327: page 1]

Terminal Center to Center Dist=12mm
Terminal Width = 0.3mm
