ZeroUI/Industrial-Quark/Ziro-master/Electronics/V2.0 Wifi/Documentation/Glove Dimension File.pdf

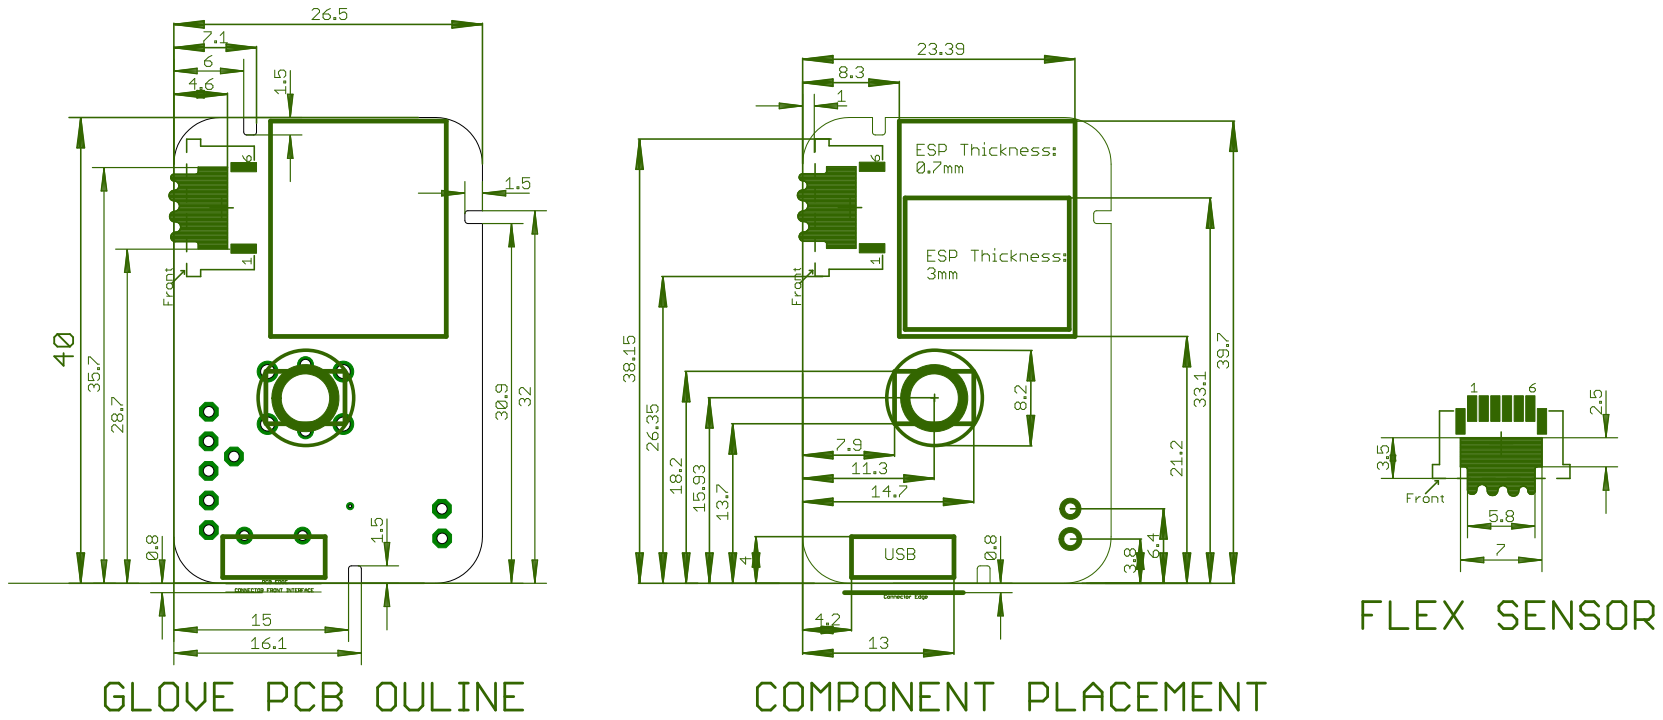
[picture p328: page 1]
