ZeroUI/Industrial-Quark/Ziro-master/Electronics/V1.0 Bluetooth/Hardware/PCB related req engg/Handimate Glove.pdf

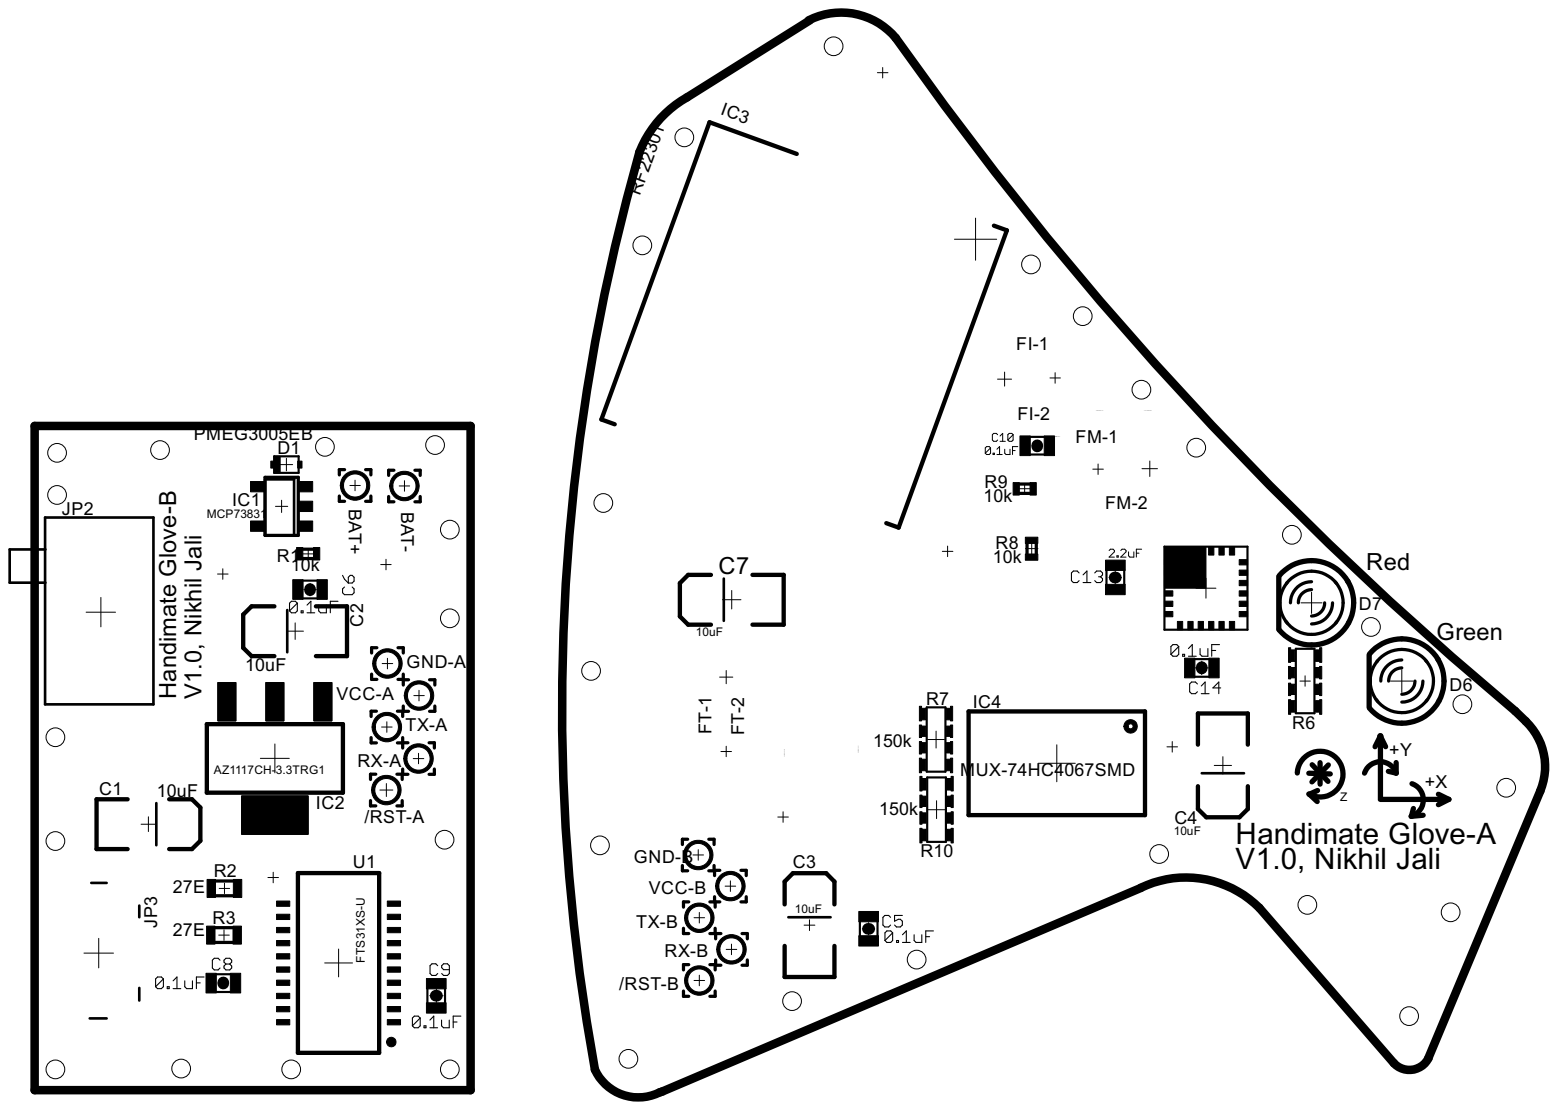
[picture p329: page 1]
