ZeroUI/Industrial-Quark/Ziro-master/Electronics/V1.0 Bluetooth/Hardware/Handimate_Backup/Glove Module/Glove Module PCB v1.pdf

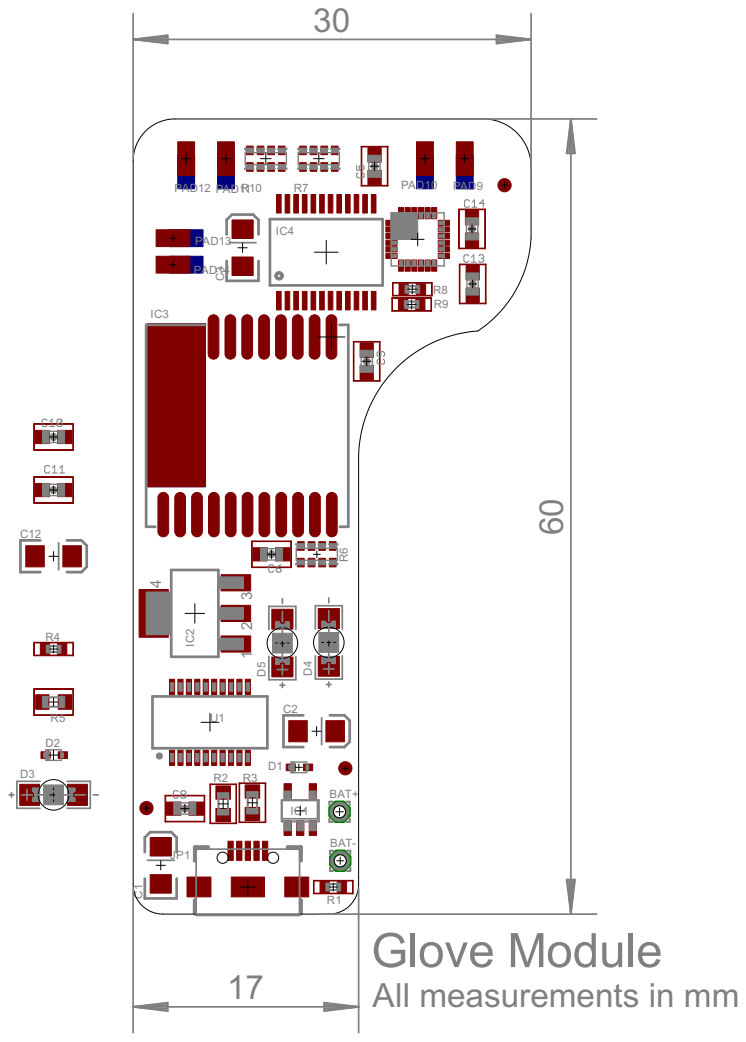
[picture p330: page 1]

Glove Module
All measurements in mm
