ZeroUI/Industrial-Quark/Ziro-master/Electronics/V2.0 Wifi/Hardware/PCB/Charging PCB/Charging v0.1.pdf

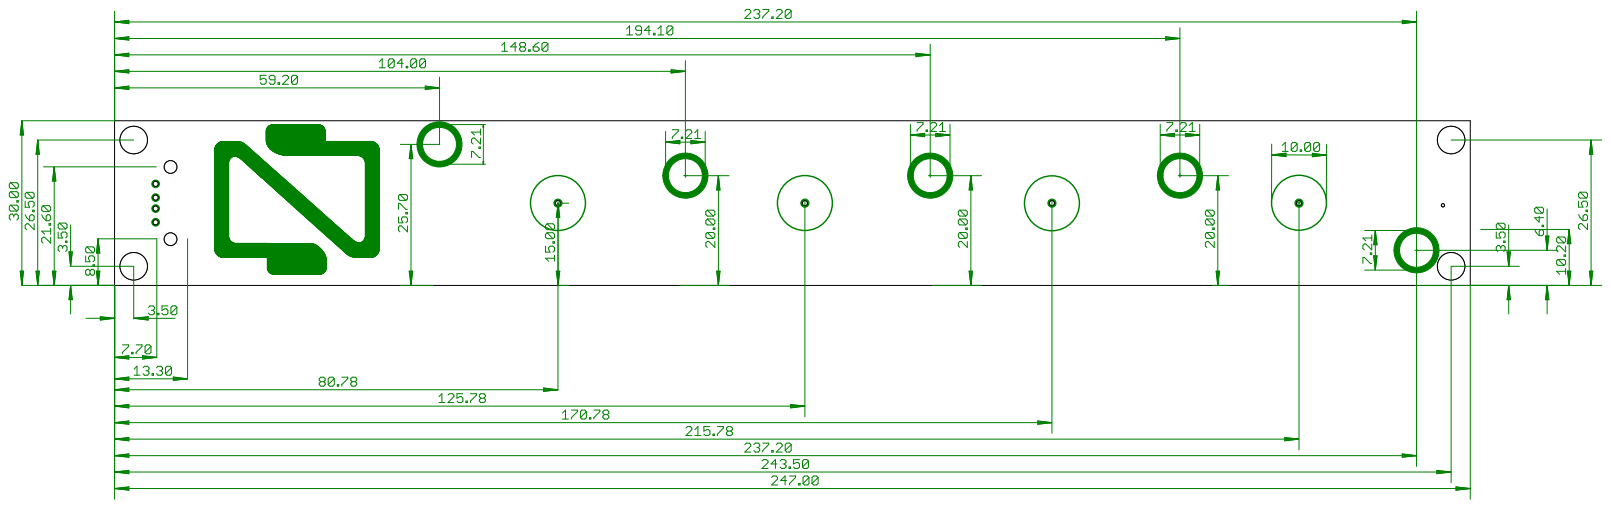
[picture p331: page 1]
