ZeroUI/Industrial-Quark/Ziro-master/Electronics/V2.0 Wifi/Hardware/PCB/Glove/Assm Glove-WiFi-M0-v0.4.pdf

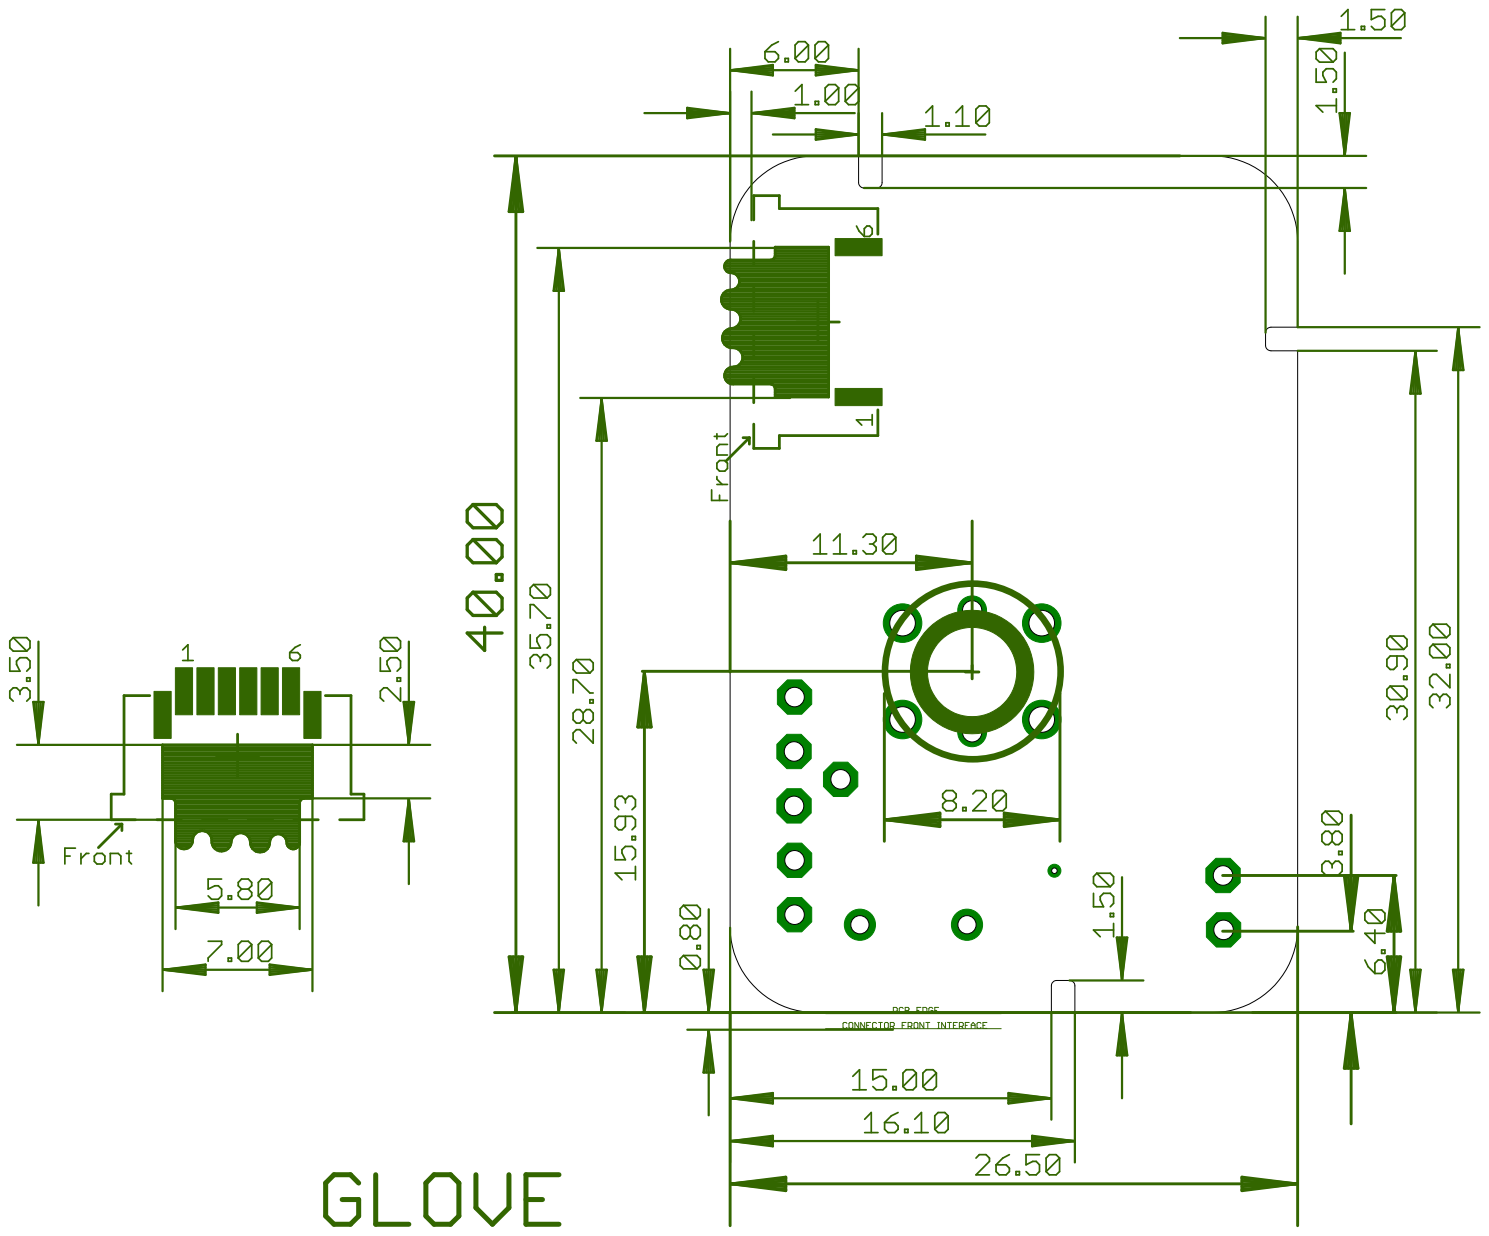
[picture p332: page 1]
