ZeroUI/Industrial-Quark/Ziro-master/Electronics/V2.0 Wifi/Hardware/PCB/Glove/Glove-WiFi-M0-v0.5.pdf

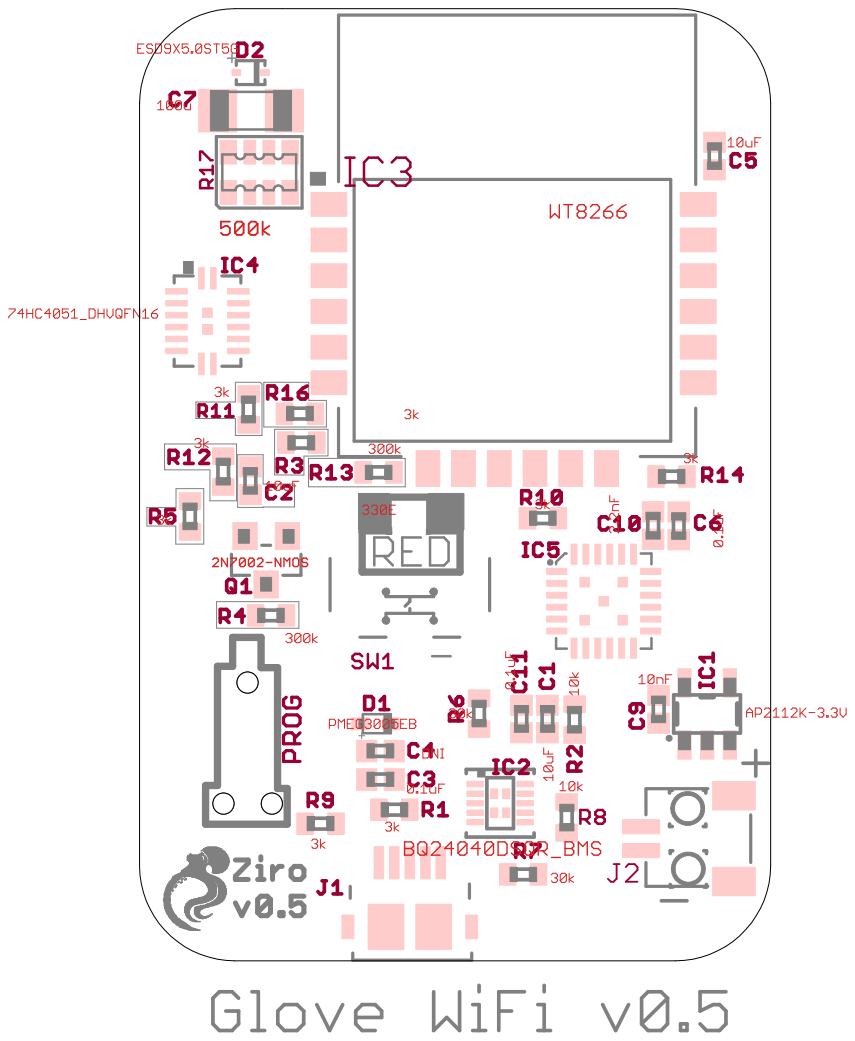
[picture p333: page 1]
