ZeroUI/Industrial-Quark/Ziro-master/Electronics/V2.0 Wifi/Hardware/PCB/Glove/Sche Glove-WiFi-M0-v0.4.pdf

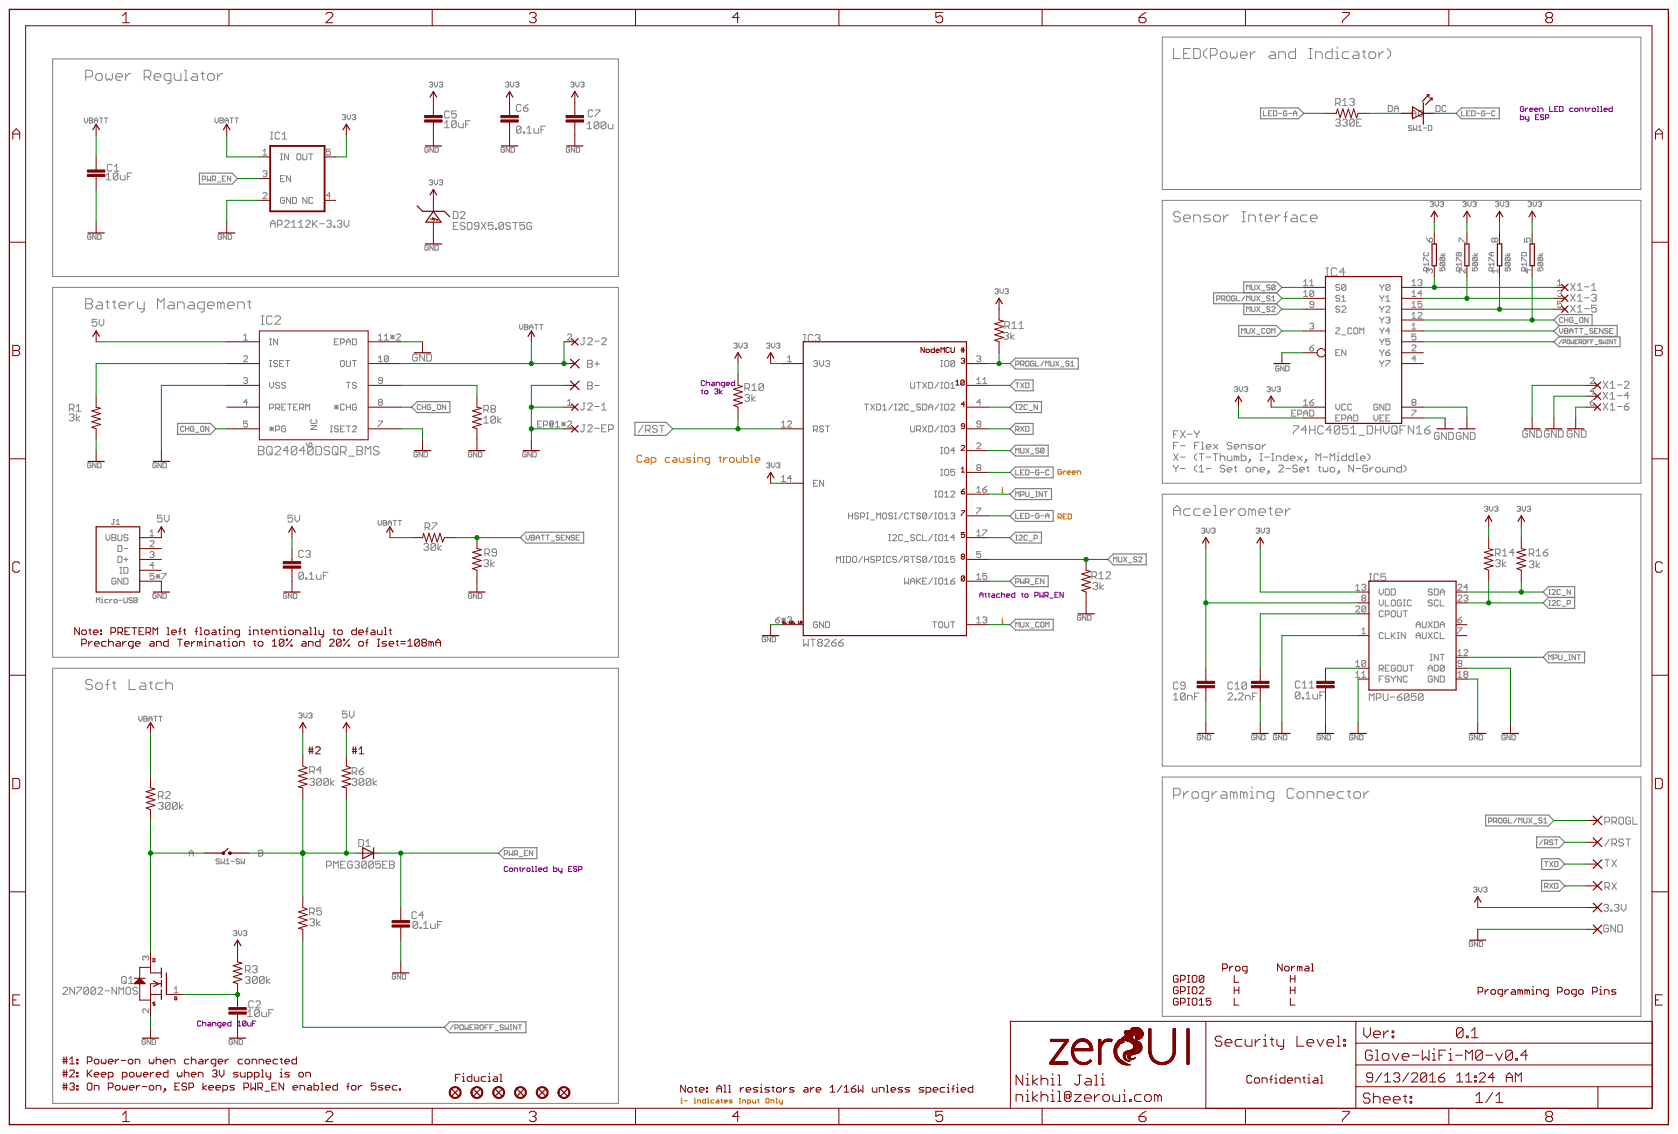
[picture p334: page 1]
