ZeroUI/Industrial-Quark/Ziro-master/Electronics/V2.0 Wifi/Hardware/PCB/Module/Module-WiFi-M0-v0.2.pdf

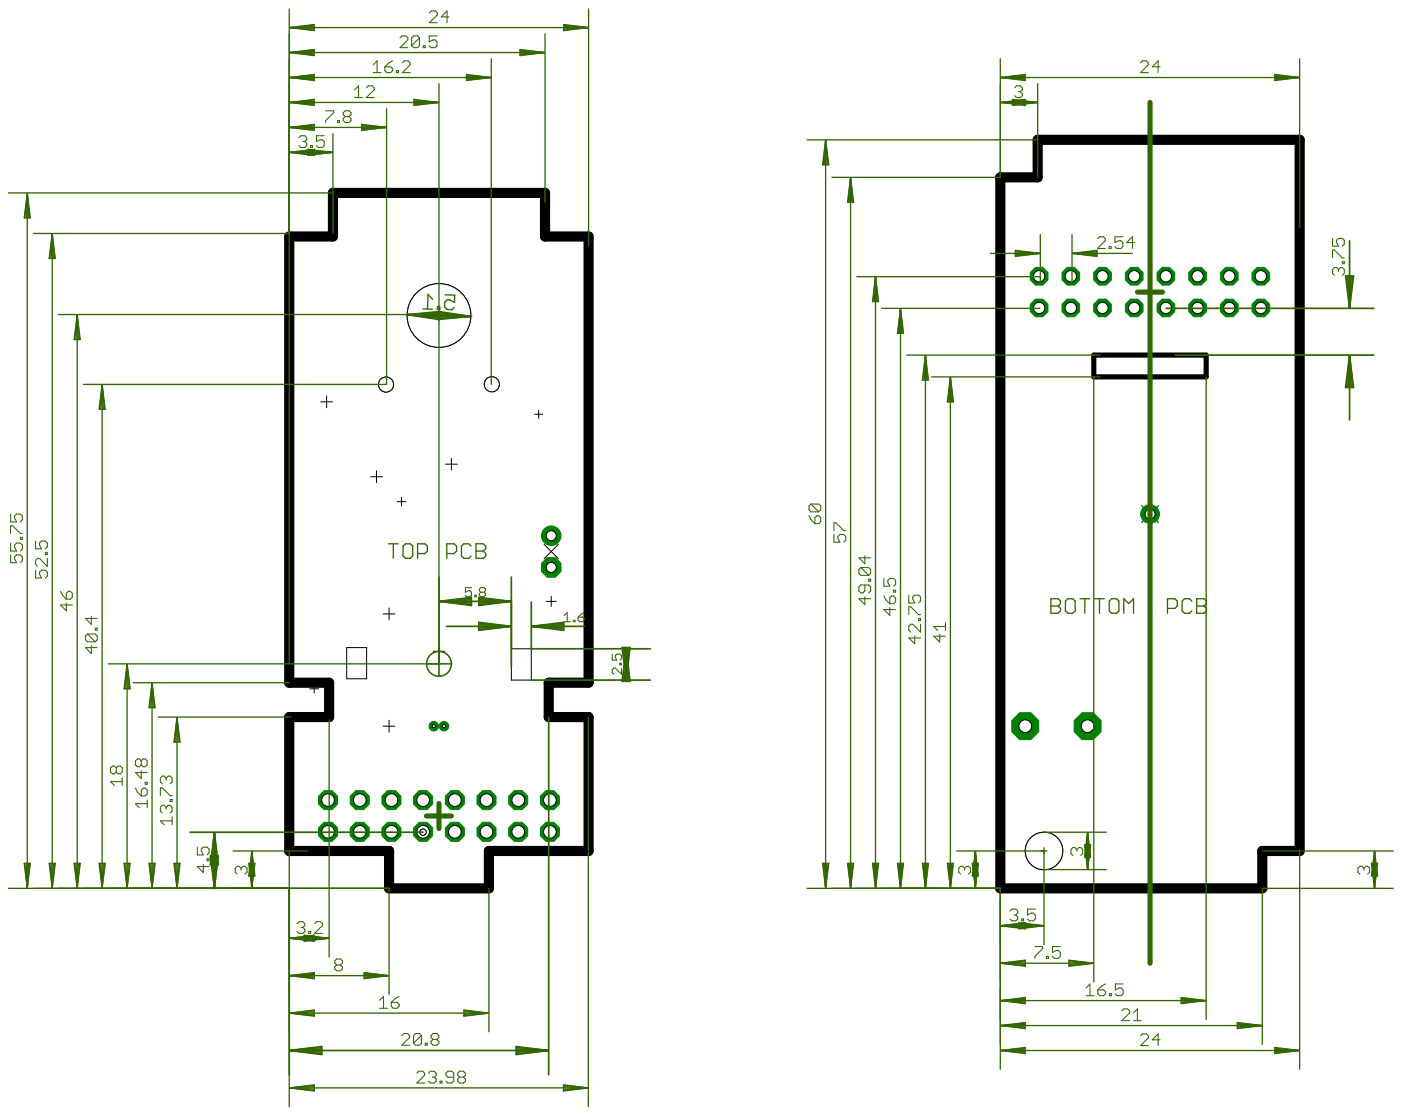
[picture p335: page 1]
