ZeroUI/Industrial-Quark/Ziro-master/Electronics/V2.0 Wifi/Hardware/PCB/Module/Schematics Module-WiFi-M0-v0.4-Board-1.pdf

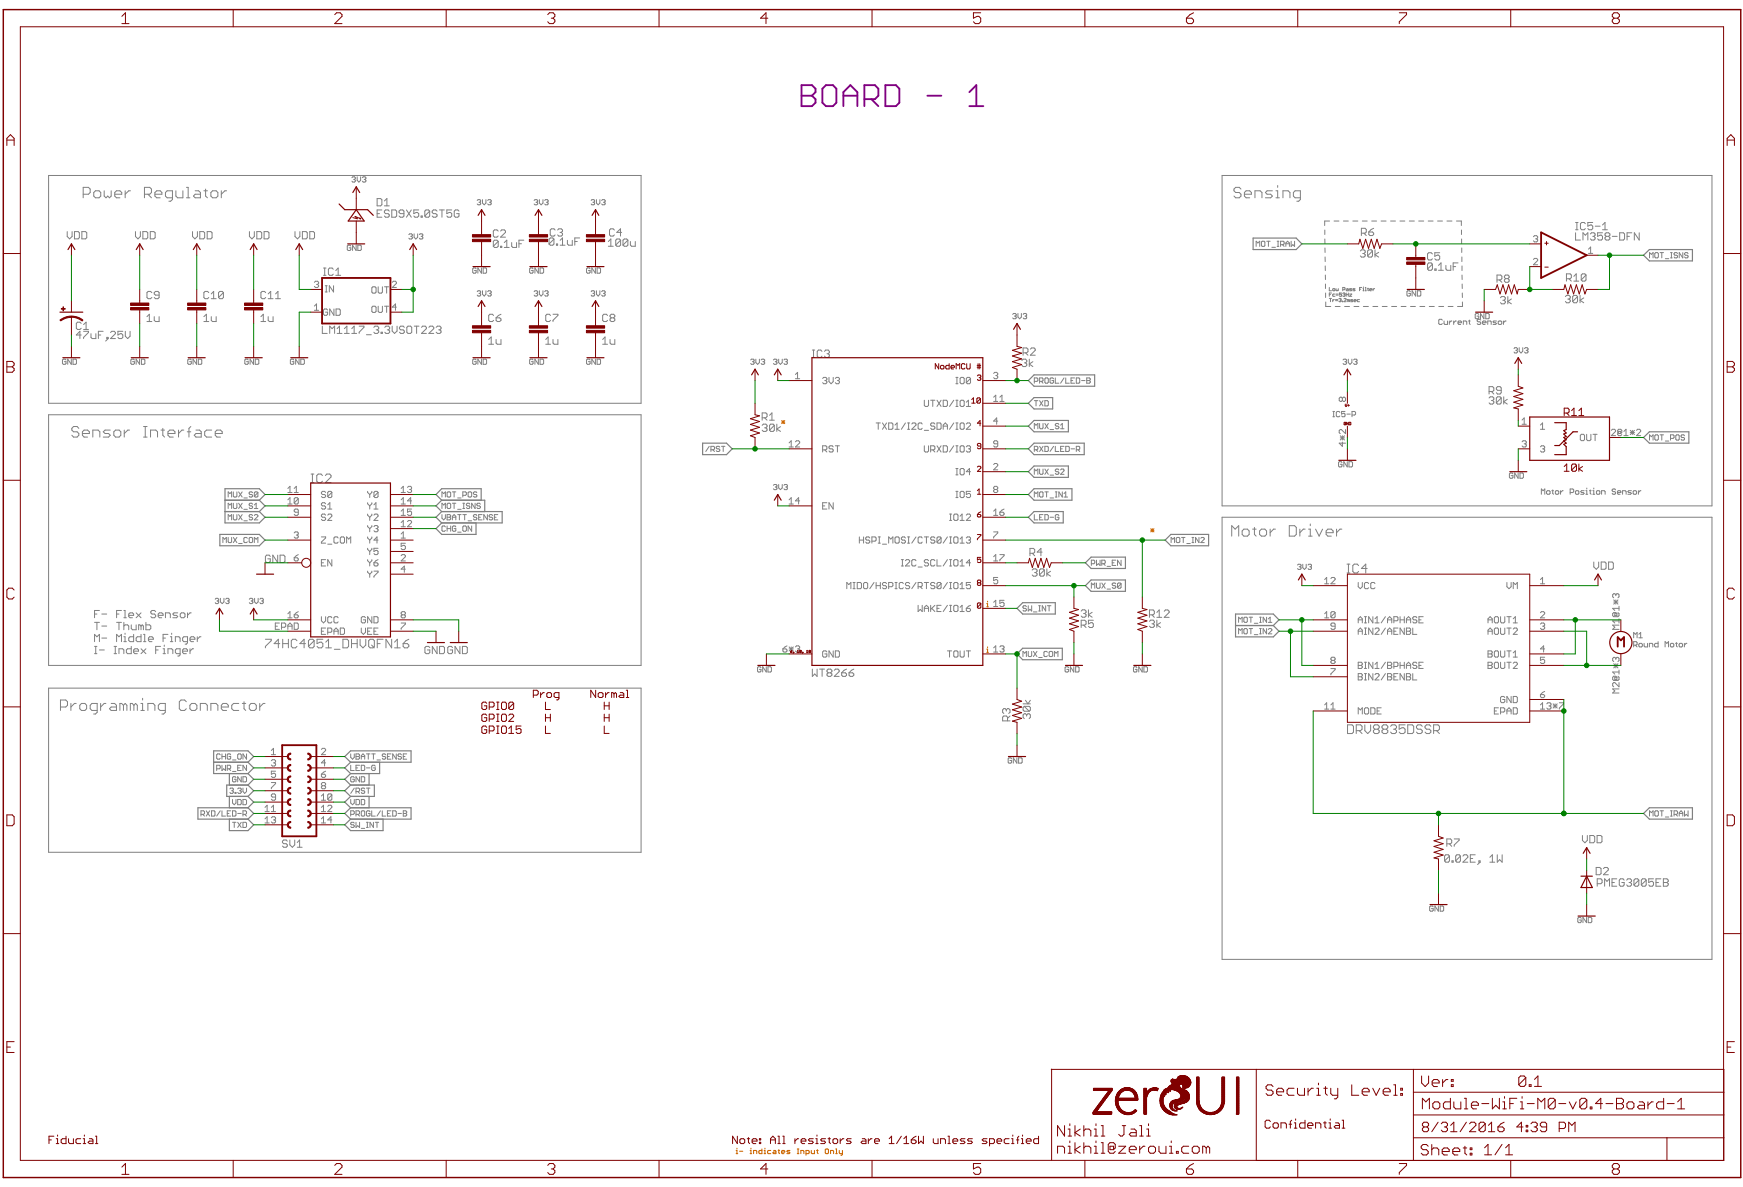
[picture p338: page 1]
