ZeroUI/Industrial-Quark/Ziro-master/Mechanical/Ziro 2.0/Module/Quark/Gears/WireEDM/Mold Inserts/Drawings/pdfS/Gear_2_Small_EDM Inserts.PDF

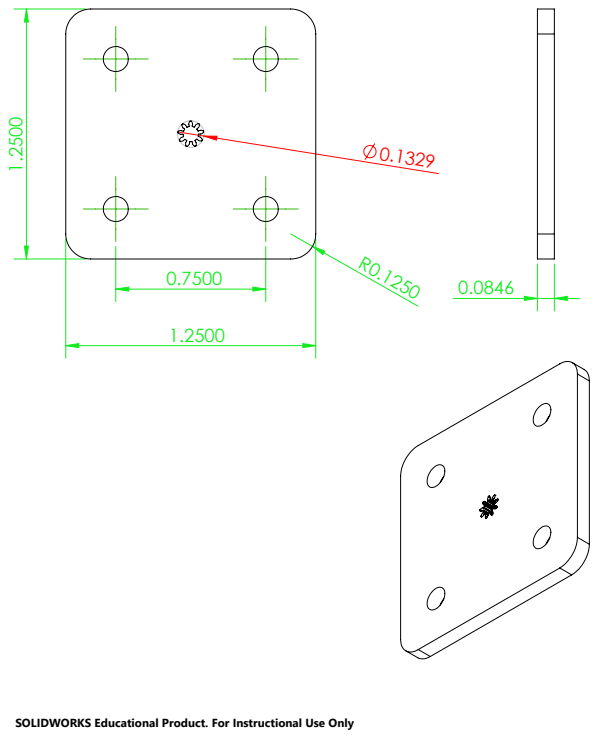
[picture p340: page 1]

SOLIDWORKS Educational Product. For Instructional Use Only
