ZeroUI/Industrial-Quark/Ziro-master/Mechanical/Ziro 2.0/Module/Quark/Gears/WireEDM/Mold Inserts/Drawings/pdfS/Gear_3_Small_EDM_Inserts.PDF

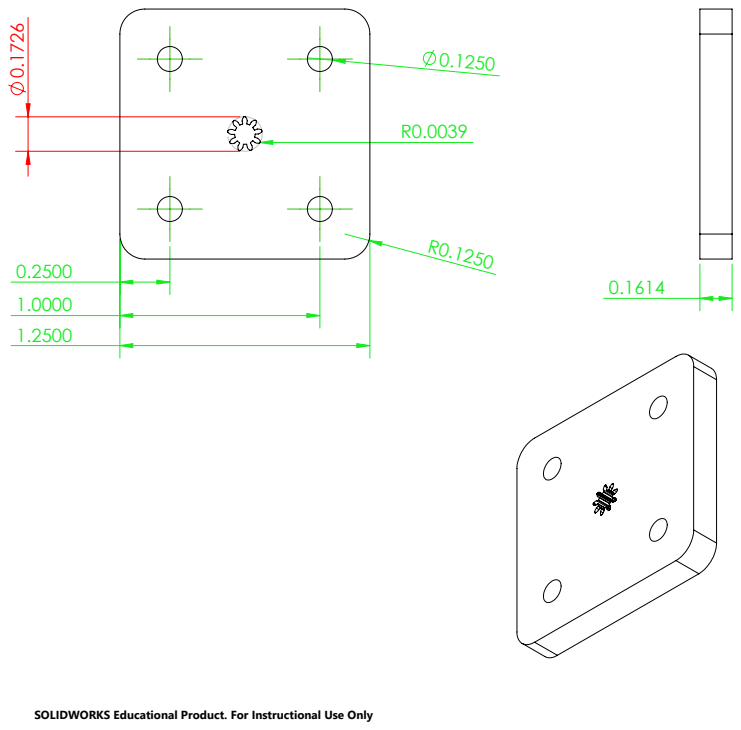
[picture p342: page 1]

SOLIDWORKS Educational Product. For Instructional Use Only
