ZeroUI/Industrial-Quark/Ziro-master/BoM/Packaging/Box/Artwork Layering Draft.pdf

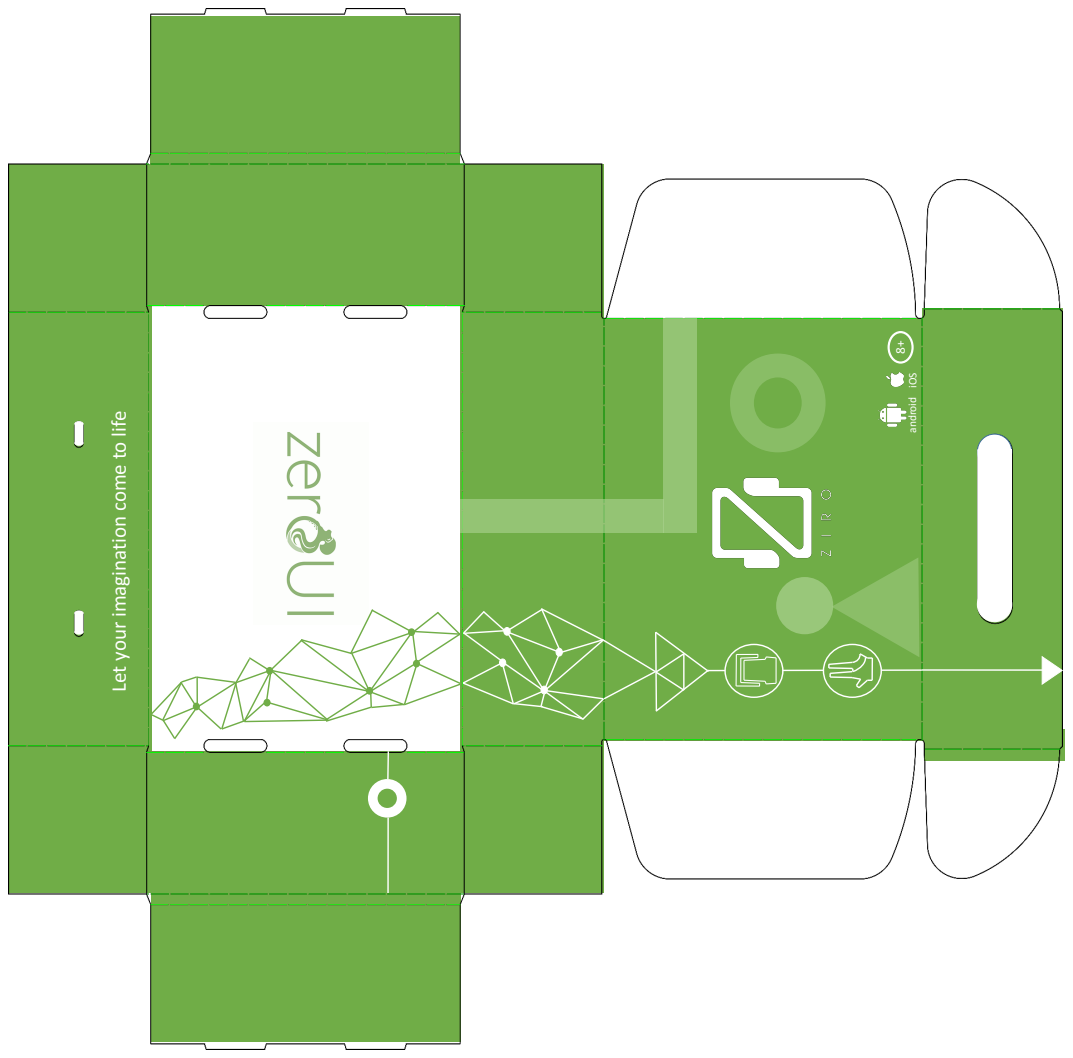
[picture p345: page 1]
iOS android

Let your imagination come to life
