ZeroUI/Industrial-Quark/Ziro-master/BoM/Packaging/E1-PCB/Connector- USB-Vertical.pdf

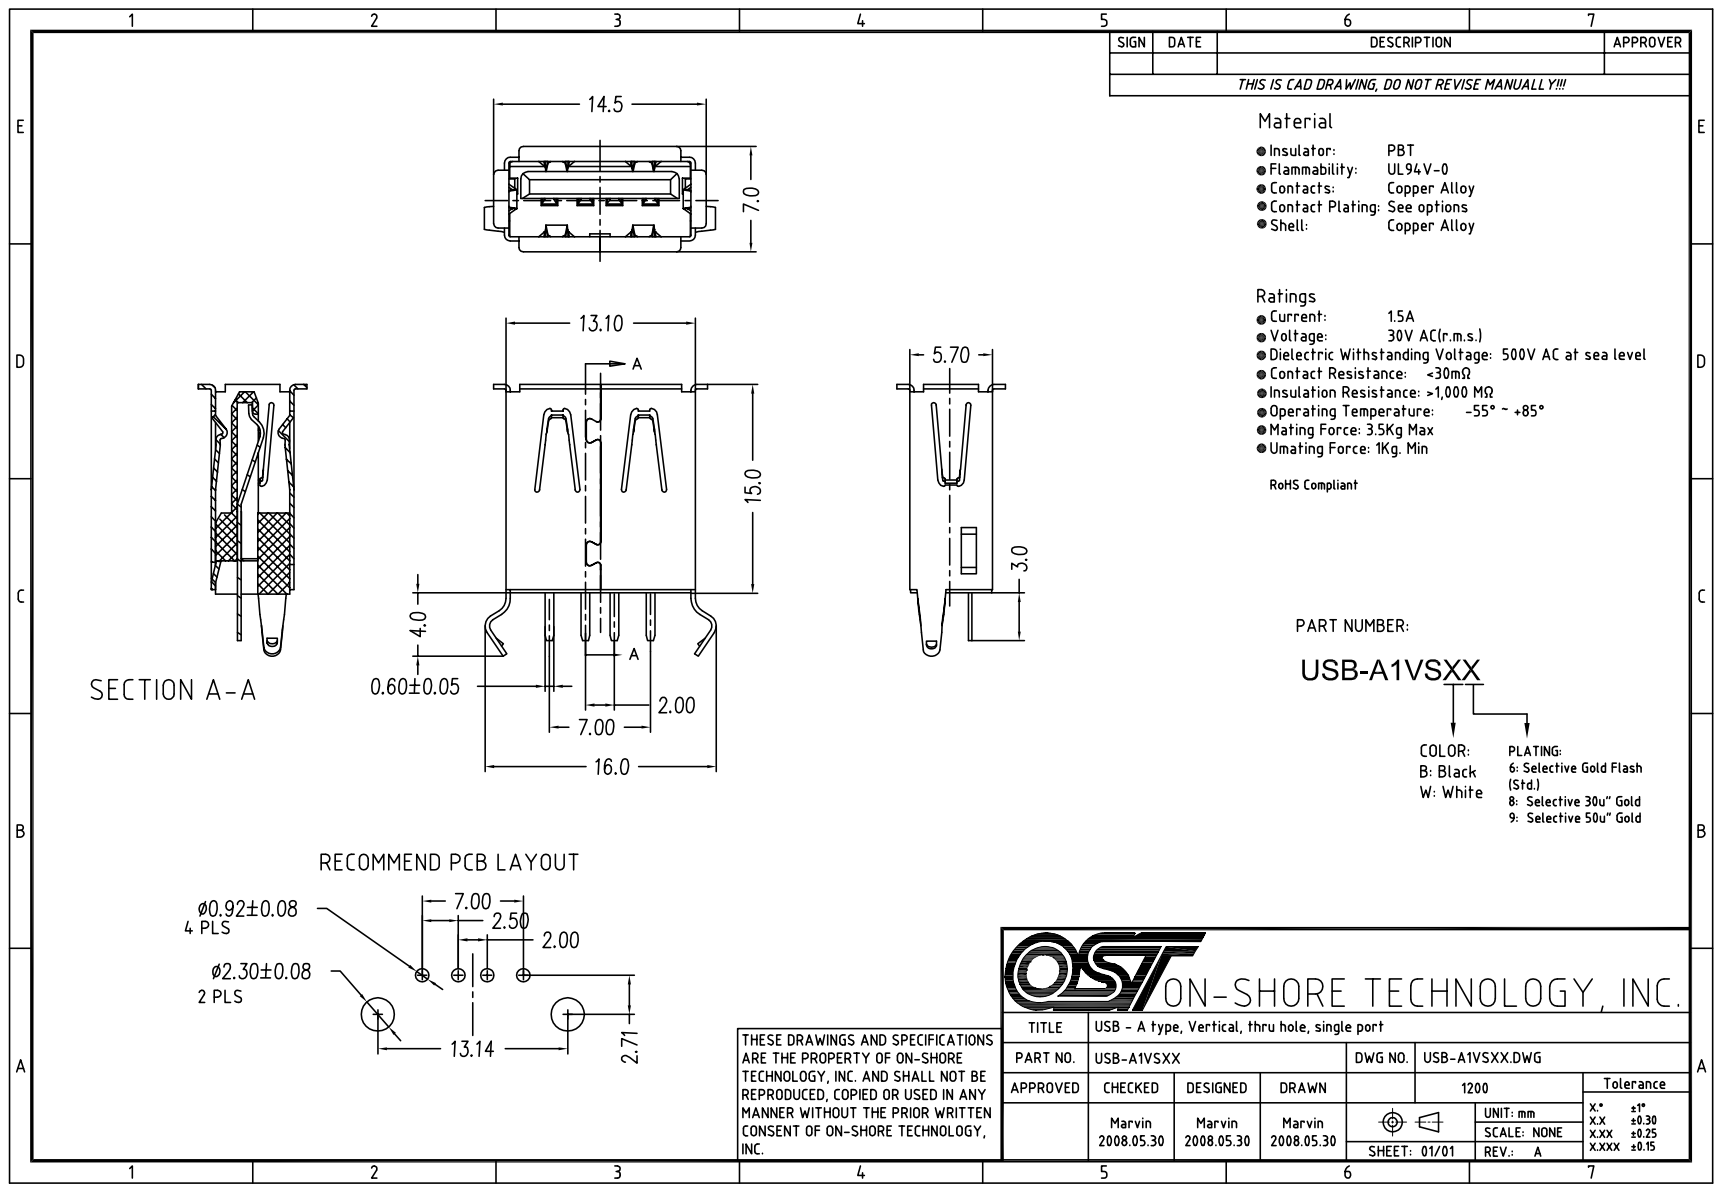
[picture p346: page 1]
